Interstellar-530/PolyTouch-FPGA-Synth/docs/hardware/wiring-20261023-v0.1-assets/user-dock-back.jpg

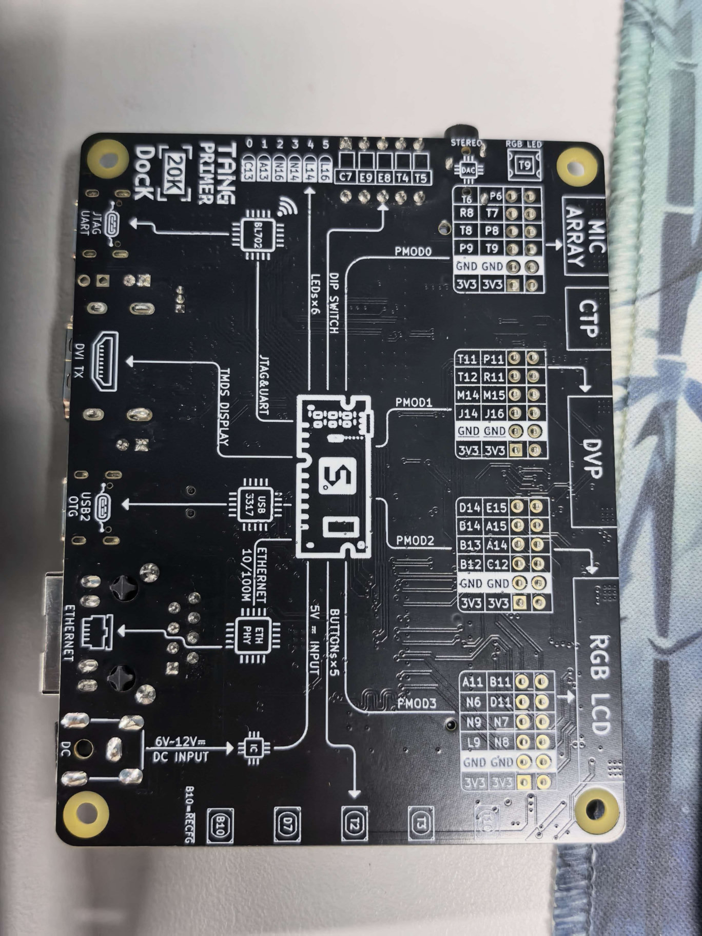
docs/hardware/wiring-20261023-v0.1-assets/user-dock-back.jpg
