Interstellar-530/PolyTouch-FPGA-Synth/docs/references/README.md

# 参考资料

`boards/` 保存原 board_docs 中的板卡规格、原理图和工具指南；`handoff-20261008/` 保留旧交接包附带的原始参考资料；`research/` 保存研究记录。PDF 成品另外放在 `docs/exports/pdf/`。

本轮只归类文件，没有重新解释原理图或核定数值。历史包中的重复原件保留，以免破坏原包可追溯性；各路径及文件校验可在迁移清单中核对。外部资料沿用原版权和许可，不因本仓库归档而改变。
