Interstellar-530/PolyTouch-FPGA-Synth/docs/hardware/FPGA-硬件连接与演奏操作-20261013-v0.1.md

# FPGA 硬件连接与演奏操作（2026-10-13 v0.1）

本方案用于 Tang Primer 20K Dock **3714**，器件 GW2A-LV18PG256C8/I7、版本 C。现在可以用电脑键盘控制四声部和板载 PT8211；外部 GPIO 琴键、MCP3208、PCM5102A 和 12.288 MHz 时钟的输入/输出驱动尚待实现。本文件给出已经核对图纸的连接提案，不能把“按图接好”当作当前固件已支持这些外设。

## 1. 手动模式实际怎样操作

`D0` 进入手动模式并清理演示音符，此时没有输入音符就安静。PuTTY 里要用 `N69` + Enter 按下 A4，用 `O69` + Enter 松开；普通字母原本没有映射。为满足按住电脑键发音、松开释音的操作，本轮增加 `tools/serial_keyboard/open-keyboard.cmd`。先关闭占用 COM13 的 PuTTY，再双击它，窗口会连接 COM13，发送 D0、M1，然后等待琴键。

| 电脑键 | A | W | S | E | D | F | T | G | Y | H | U | J | K |
| --- | --- | --- | --- | --- | --- | --- | --- | --- | --- | --- | --- | --- | --- |
| 音符 | C4 | C♯4 | D4 | D♯4 | E4 | F4 | F♯4 | G4 | G♯4 | A4 | A♯4 | B4 | C5 |
| MIDI 编号 | 60 | 61 | 62 | 63 | 64 | 65 | 66 | 67 | 68 | 69 | 70 | 71 | 72 |

按住 H 发 A4，松开 H 进入 ADSR 释放；同时按 A、D、G 发 C 大三和弦。当前最多四声部，超过四个音会按现有规则窃取声部。窗口按钮控制手动/演示、静音/有声和全松键，空格也可全松键；手动演奏时切走窗口会全松键。全松键后仍按住的键要先松开再重新按下，避免系统自动重复重新起音。电脑端只发送控制事件，声音由 FPGA 生成。此路径尚未测量实际输入延迟，不能代替最终 GPIO 琴键的比赛延迟证据。

用户已确认按下、松开和和弦正常；底层串口测试收到 D0/M1、三音和弦 N/O 和关闭时 X 的全部 OK。新模式目前保存在 SRAM（User Code 0x5633），断电后仍回到 Flash 前版 0xFCF0，需重新加载模式修复固件。

## 2. 本轮采用的最新外设状态

库存以另一采购对话中 2026-10-12 的用户确认“对勾已购，圈未购”为准；主琴键方向以最新对话《检查能否同时用它取代MPR121》中“按照GPIO按键的方案思考”为准。已购不自动等同于已到货、已焊接或已验收。

| 器件或材料 | 当前依据 | 本方案用途 |
| --- | --- | --- |
| P01 MPR121 | 已购 | 触摸版备选，不再为 GPIO 琴键补购 |
| P03 FSR402、P05 MCP3208 | 已购 | 第二维压力控制 |
| P06 PCM5102A、P07 12.288 MHz 有源晶振 | 已购 | 48 kHz 正式 I2S 音频出口 |
| P08 耳放、P09 B10K 电位器 | 已购 | 耳机驱动与第三维连续控制 |
| P10 面包板、P16 音频线、P17 USB 声卡 | 已购 | 原型连线与录音，声卡线路输入规格仍需实物确认 |
| 12 个独立机械按键及固定面板 | 已选 GPIO 路线，未查到购买确认 | 主琴键，每键两个独立触点 |
| P04 电阻、P11 杜邦线、P12 去耦/串阻 | 未查到已备确认 | 先盘点；GPIO 上拉 12 个，FSR 分压 1 个，另预留 CS 上拉和 XSMT 下拉 |
| P02 铜箔/导电布电极 | 前次确认未购 | GPIO 主方案暂不需要，触摸备选才需要 |

还没有具体 DAC 模块、耳放和晶振封装型号。下面按电气端子名称连接，不能按其他店铺照片推断左右排列、VIN 电压或跳线位置。

若全部采用外接电阻且 XSMT 可控，10 kΩ 需至少 15 只：12 只琴键上拉、1 只 FSR 分压、1 只 ADC CS 上拉、1 只 DAC 静音下拉；模块已有的电阻可抵扣。晶振与三根 I2S 线合计预留 4 只约 33 Ω 串阻，两个模拟控制输入各预留 1 kΩ/10 nF。去耦先查模块实物，按缺少的补齐。

## 3. 排针方向和完整信号分配

已用本地 [3714 原理图](../references/Tang_Primer_20K_Dock_3714_Schematics.pdf)的根页、RGB LCD 页、Things 页，以及[核心板引脚/电源图](../references/Tang_Primer_20K_SOM-3961_Schematic.pdf)进行 PNG 视觉复核；官方入口见 [Sipeed 板卡资料](https://wiki.sipeed.com/hardware/zh/tang/tang-primer-20k/primer-20k.html)。J5、J6、J14 均为 2×6 排针：**1/2 为 +3.3 V，3/4 为 GND，5～12 为信号**。这不是可直接套用通用 PMOD 电源脚序的接口。按实物方焊盘或丝印找 1 脚，并在断电时核对地线；不要按 USB 口朝向猜编号。

```text
从确认过的 1 脚开始，每行一对：
1  2    +3.3 V / +3.3 V
3  4    GND    / GND
5  6    信号   / 信号
7  8    信号   / 信号
9 10    信号   / 信号
11 12   信号   / 信号
```

下表与 `FPGA-pinplan-20261013-v0.1.csv` 一致，覆盖 12 键、4 根 ADC SPI、3 根 I2S、1 根 DAC 静音和 1 根外部时钟。全部选择 3.3 V 电压域。Bank 3 固定 3.3 V；Bank 1/7 按核心板默认 R5/R9 配置为 3.3 V。若板卡曾改过电压配置，要先实测恢复到相应电压。

| 用途 / 拟定端口 | 排针脚 | FPGA 脚 | Bank | 方向及对端 |
| --- | --- | --- | --- | --- |
| K0 / key0_n，C4 | J5-5 | L9 | 3 | 输入，按键到 GND |
| K1 / key1_n，C♯4 | J5-6 | N8 | 3 | 输入，按键到 GND |
| K2 / key2_n，D4 | J14-5 | P9 | 3 | 输入，按键到 GND |
| K3 / key3_n，D♯4 | J5-8 | N7 | 3 | 输入，按键到 GND |
| K4 / key4_n，E4 | J6-8 | A14 | 7 | 输入，按键到 GND |
| K5 / key5_n，F4 | J6-9 | B14 | 7 | 输入，按键到 GND |
| K6 / key6_n，F♯4 | J6-10 | A15 | 7 | 输入，按键到 GND |
| K7 / key7_n，G4 | J6-11 | D14 | 1 | 输入，按键到 GND |
| K8 / key8_n，G♯4 | J6-12 | E15 | 1 | 输入，按键到 GND |
| K9 / key9_n，A4 | J14-7 | T8 | 3 | 输入，按键到 GND |
| K10 / key10_n，A♯4 | J14-8 | P8 | 3 | 输入，按键到 GND |
| K11 / key11_n，B4 | J14-9 | R8 | 3 | 输入，按键到 GND |
| adc_cs_n | J5-9 | N6 | 3 | 输出 → MCP3208 CS/SHDN |
| adc_sck | J5-10 | D11 | 7 | 输出 → MCP3208 CLK |
| adc_mosi | J5-11 | A11 | 7 | 输出 → MCP3208 DIN |
| adc_miso | J5-12 | B11 | 7 | 输入 ← MCP3208 DOUT |
| i2s_bck | J6-5 | B12 | 7 | 输出 → PCM5102A BCK/BCLK |
| i2s_lrck | J6-6 | C12 | 7 | 输出 → PCM5102A LRCK/LCK/WS |
| i2s_din | J6-7 | B13 | 7 | 输出 → PCM5102A DIN/DATA |
| dac_xsmt | J14-12 | P6 | 3 | 输出 → PCM5102A XSMT（可引出时） |
| clk_12m288 | J14-10 | T7 | 3 | 输入 ← 3.3 V CMOS 有源晶振 OUT，GCLKT_3 |

上一对话的候选 K2 是 J5-7/N9。核心图把 N9 标为 D0 复用脚，本轮先把 K2 改用 J14-5/P9，避免尚未完成的工具 GPIO 选项确认。J5-7 暂留空。J14-6/T9 与板载 WS2812 数据并联，本方案也不占用。

J5/J6 的信号同时引到 LCD FPC，J14 的信号同时引到麦克风阵列 FPC。因此这些接口使用本方案时，不能再接会驱动同一网络的 LCD 或麦克风阵列。当前 UART M11/T13、板载音频 N15/P16/P15/R16、LED 和 S1/S2/S3 都保留；候选表与现有 CST 无重号。

2026-10-16 更新：标准 I2S 组的候选引脚已经写入工程，成为独立的一档约束：引脚在 `source/constraints/primer20k_i2s.cst`，时钟在 `primer20k_i2s.sdc`（12.288 MHz、81.38 ns），构建脚本为 `build/build_top_i2s_std.tcl`；调试档仍用 `primer20k_dock3714.cst` + `primer20k.sdc` + `build/build_top_integrated.tcl`。两档共用同一份 RTL，各自通过 `build/isolated/` 下的薄封装只引出本档需要的端口，实测两档均为 0 个未约束端口、0 条 setup/hold 违例，报告见 `evidence/2026/10/top-i2s-20261016/`。

按原理图逐脚核对后的完整对应表见 `FPGA-接线与引脚对应表-20261016-v0.1.md`（机器可读版本 `FPGA-接线表-20261016-v0.1.csv`）：J5/J6/J14 二十四根信号脚的网络名、球号、Bank 与用途，以及晶振、PCM5102A、MCP3208、FSR、电位器和 12 路琴键的接法都在那里，本文不再重复。

两点接线提醒。其一，两档点流互斥：标准档把 B12/C12/B13/P6 给了 I2S 与 XSMT，调试档仍用这 4 个脚做折叠观测，插线不能同时接。其二，J5/J6/J14 每个排针只有 8 个信号脚，本方案已用满，只剩 J5-7(N9) 与 J14-11 两个空脚，装不下 4 位折叠观测口，因此标准档不再引出 `clip_fold`，观测改用仿真与 UART 状态。

## 4. 逐件连接

### 4.1 独立 GPIO 琴键

每个 GPIO 用独立约 10 kΩ 电阻上拉到 3.3 V，按键一端接该 GPIO，另一端接公共地；松开为 1，按下为 0。上拉电阻放在开发板/转接板一侧，按键地线回到同一公共地。四脚轻触按键有两对内部相连的脚，要用万用表确认两个不同触点，不能把同一内部触点的两脚当作开关两端。12 根 GPIO 各自独立，可识别多键，不需要矩阵逐键二极管。

```text
3.3 V ── 10 kΩ ──┬── GPIO 输入
                  └── 按键 ── GND
```

后续 RTL 每路先两级同步，再独立消抖；以按下约 1 ms、松开约 3 ms 为可调起点。不能直接复用板载控制键约 38.8 ms 的消抖参数。按键长线靠近晶振时，先分开布线，再按实际干扰加小电容或串阻，避免为了消抖盲目加入很大的 RC 延迟。

### 4.2 FSR、电位器和 MCP3208

MCP3208 的 VDD、VREF 都用 3.3 V，AGND/DGND 共地，模块旁检查 100 nF 和适量 1～10 µF 去耦。裸 16 脚芯片对应 VDD=16、VREF=15、AGND=14、CLK=13、DOUT=12、DIN=11、CS=10、DGND=9、CH0=1、CH1=2；模块按丝印端子连接。CS 加约 10 kΩ 上拉，四根数字线按上一表接，DIN/DOUT 不要反接。[Microchip 数据手册](https://ww1.microchip.com/downloads/en/DeviceDoc/21298e.pdf)

FSR 一端接 3.3 V，另一端为分压节点；节点经 10 kΩ 到 AGND，并接 CH0。按压力增大时 FSR 阻值下降，节点电压上升：`V = 3.3 × 10k / (R_FSR + 10k)`。可在节点到 CH0 间串约 1 kΩ，在 CH0 对 AGND 放约 10 nF 作起点。FSR 无需按正负极接，不追求绝对牛顿值；用无人按压、轻压、重压做相对标定。

B10K 两端接 3.3 V/AGND，中间滑动端接 CH1，也可经 1 kΩ/10 nF 作输入滤波。没有使用的 CH2～CH7 可以接 AGND，不要让扫描到的空通道浮动。只有传感器电压节点进 ADC，不能把 3.3 V 模拟节点当成 FPGA 模拟输入。

SPI 先用 mode 0，SCK 约 250 kHz。10 kΩ 分压的源阻抗会影响 ADC 采样电容建立时间，先降速再考虑 1 MHz。按 24 个 SCK 一次事务估算，每通道约 96 µs；两个通道的数字传输在约 0.2 ms 内，足够安排 1～2 kHz 控制更新。该值是调度预算，需要波形和数值稳定性验收。

### 4.3 晶振、PCM5102A、耳放和录音

有源晶振确认是 **12.288 MHz、3.3 V CMOS 输出**。VCC 接 3.3 V，GND 接公共地，OUT 在源端串约 33 Ω 后短线接 J14-10/T7；电源脚旁保留 100 nF 和约 1 µF。OE/EN 按型号设置，不能把两脚无源晶体按这个方法直接接入。常见四脚封装的脚位也要按所购型号确认。J14-9/R8 虽与 T7 构成时钟引脚对，本方案使用单端 CMOS 时钟，R8 作为普通按键输入，不能启用差分时钟模式。

PCM5102A 数字端：BCK←B12、LRCK←C12、DIN←B13、GND→公共地；BCK/LRCK/DIN 可各在 FPGA/转接板源端串约 22～33 Ω。正式目标为 LRCK 48 kHz、BCK 3.072 MHz、64 位时隙，标准 I2S 在 LRCK 翻转后延迟一个 BCK 才发送 MSB。当前板载 PT8211 是右对齐接口，不能直接把其 DIN 当作标准 I2S 给 PCM5102A。

按本标准档烧录时，板载耳机路径的三根线在 RTL 里恒为低、`pa_en` 也不引出，所以耳机口不会发声；要听板载耳机就烧调试档。实机验收前先看 `evidence/2026/10/top-i2s-20261016/README.md` 里“已知限制与未做”一节：那时钟档目前只有仿真与综合证据，还没有上板。

| PCM5102A 配置端 | 本方案设置 |
| --- | --- |
| FMT | 低电平，标准 I2S |
| DEMP | 低电平，48 kHz 不启用 44.1 kHz 去加重 |
| FLT | 高电平低延迟；普通滤波也可作为对照 |
| SCK | 三线 I2S/内部 PLL 方案按数据手册接地，不另接 SPI 时钟 |
| XSMT | 低静音、高有声；能解除固定绑带时才由 P6 控制 |

如果模块 XSMT 已硬连 3.3 V，必须先按模块说明解除绑带才能接 FPGA，避免输出低电平时短接电源。若暂时无法引出，P6 保留不用，先由 I2S 零样本静音。可控 XSMT 使用约 10 kΩ 下拉，让未配置时保持静音；不能同时保留同阻值上拉造成分压。芯片模拟供电是 3.3 V，模块 VIN 是否可用 5 V 取决于板载稳压；当前没有确切模块型号，不把所有标 VIN 的端子统一接 5 V。[TI 数据手册](https://www.ti.com/lit/ds/symlink/pcm5102a.pdf)

PCM5102A OUTL/OUTR 是线路输出，接耳放 INL/INR，模拟地接耳放输入地，耳机插耳放输出。耳放供电按具体型号，不能因为 Dock 有 12 V 电源插座就把未知耳放接 12 V。若模块实际是 BTL 扬声器功放，也不能把负输出当耳机公共地。录音从 DAC 线路输出接已购声卡的真正 Line In；耳放输出和麦克风输入的电平未确认前不直接相连。电平过高先降低数字增益，必要时再用经过计算的衰减网络。

### 4.4 MPR121 作为备选

若以后做触摸版，可将 GPIO 输入适配器替换为 MPR121 适配器：VCC→3.3 V、GND→公共地，SCL→J5-5/L9、SDA→J5-6/N8、IRQ→J5-8/N7。这三个针位与 GPIO 的 K0/K1/K3 **互斥**，不能同时按两套接法装配。确认模块上拉接到 3.3 V；已经有上拉时不重复叠加。常用 7 位地址 0x5A，但实际以 ADDR 接法为准；电极 ELE0～ELE11 各接独立铜箔，铜箔不接 VCC 或 GND。[MPR121 模块接线说明](https://learn.adafruit.com/adafruit-mpr121-12-key-capacitive-touch-sensor-breakout-tutorial/wiring)

## 5. 接线、软件接入与验收顺序

先断电按 1 脚核对排针，再只接单个 GPIO 按键，确认松开约 3.3 V、按下接近 0 V；完成 GPIO 驱动后再扩成 12 键。第二步接 ADC、FSR 和电位器，用 UART/GAO 检查原始值和滤波值。第三步接晶振，只测频率、电平和连通；正式时钟构建验证后才接 DAC 数字线。第四步核对 DAC 供电和跳线，先输出零样本、后释放静音，再接耳放，最后接录音接口。

地线统一连接，按键/ADC、DAC、耳放分别回到供电公共节点，耳放大电流回路不要沿 ADC 参考或晶振地线绕行。I2S/晶振线短且伴随地线，远离耳放输入和 FSR 节点；面包板电源长条可能中间断开，要测通。当前静音后噪声仍基本不变，后续需对比供电、接地和独立 DAC/耳放链路，不能承诺换算法就消掉模拟底噪。

后续 GPIO 输入适配器应把同时变化的位图保留为待处理掩码，先逐个提交 Note Off 再提交 Note On，并接受下游 ready。不能把连续 GPIO 突发直接接到当前为稀疏 UART 命令设计的脉冲入口：模式切换保留的首事件可能与下一拍事件相撞。需给手动来源增加队列或明确握手，同时定义进入手动时的物理按键状态重建、Panic 后必须松开再按和断线默认参数。

12.288 MHz 正式构建要一起修改 UART 分频、DDS 频率字、曲目时值和 ADSR 步进；建议主音频/控制逻辑用单一音频时钟域。标准 I2S、GPIO 消抖和 ADC 各补自检台；每帧截止时间、队列背压、满声部混音和饱和都要检查。最后以真实按键电信号与 DAC 模拟输出测量端到端延迟，并录制四个独立基频。没有驱动、接线和实测前，不标记外设功能已完成。

本轮交付为可用的电脑演奏窗口与图纸级连接方案。源代码/脚本、图纸和器件引脚视觉证据、串口与用户验收记录归档到 `archive/FPGA-20261013-v0.2/`，正式 FPGA 引脚约束仍待后续接入任务更新。
