Interstellar-530/PolyTouch-FPGA-Synth/docs/hardware/FPGA-硬件采买与搭建准备-20261022-v0.2.md

# PolyTouch FPGA 硬件采买与搭建准备

日期：2026-10-22，版本 v0.2。适用 Tang Primer 20K Dock 3714，GW2A-LV18PG256C8/I7，版本 C。

本版核准 881a11c 的采购记录和路线说明，与[搭建指导 v0.2](FPGA-硬件搭建指导-20261022-v0.2.md)配套。保留原采购信息，主输入统一为 CH9350L USB 键盘；12 机械键和 MPR121 为历史替代。远端订单记录来自另一工作副本 `D:\NanjingUniversity\FPGA\PolyTouch-FPGA-Synth`，本机没有独立复核原始订单、到货和铭牌，不将采购成功写成硬件验收。

## 1. 装配主路线

普通 USB 键盘接 CH9350L 下位机，由 3.3V TTL UART 向 FPGA 发送报告；FSR402 与 10kΩ 线性电位器接 MCP3208 CH0/CH1；FPGA 经标准 I2S 到 PCM5102A，再接有源音箱。先采用 `standard27`：板载 27MHz、8 声部、46.875kHz、BCK 3.000MHz，外部 T7 不接。DAC 实际锁定仍待测量。

两枚新购 12.288MHz 有源晶振保留用于已规划的 48kHz/PLL 后续方向。现有 `standard` 档是 GPIO 输入，不能直接作为 USB 键盘的 48kHz 替代档；32 声部原型也未完成整机板级集成。灯屏为增强，不阻塞基本输入、压力与正式音频链路。

## 2. 已有与待确认物料

| 物料 | 已有记录 | 本次用途/待办 |
|---|---|---|
| Tang Primer 20K＋Dock 3714 | 已有；板载串口和耳机曾用于试听 | 保存已知版本及恢复方式；当前整机外设未验收 |
| 普通有线 USB 键盘 | 优先复用 | 支持 Boot 键盘报告，实测和弦组合；报告只有 6 个普通键槽位 |
| CH9350L 下位机成品板 | 10/20 用户确认已到货 | 确认 Host 口、SEL/S0/S1 配置、TXD 3.3V 与 Host VBUS 5V；单向模式 RXD 接地、N8 留空 |
| FSR402 | 10/20 用户确认已到货 | 压力分压、刚性背板、软垫、尾线应力释放 |
| MCP3208-CI/SL | 已购，10/20 仍待焊接 | SOIC-16 转接板、代焊/焊台及逐脚通断检查 |
| WX112(050) 10kΩ 线性电位器/B10K | 历史已购记录 | 实物盘点是否同一件；滑臂接 CH1，缺件时用等阻分压给中位 |
| CJMCU-5102/PCM5102A | 10/20 用户确认已到货 | 查 LDO、输入输出网络、控制孔和焊桥后决定电源 |
| 有源音箱、P15W 或耳放 | 旧记录型号和输入未定；10/20 用户称有源音箱可用 | 以实际 AUX/LINE IN 与额定电源为准；新 R18T 为候选 |
| 12 个机械键、MPR121 | 旧采购记录 | 收存作替代，不按主路线安装；避免与 USB/灯屏共用脚冲突 |
| 830 孔面包板、音频线、USB 声卡 | 历史记录，数量与接口待盘点 | 电源轨通断、立体声线、实际 Line In 条件分别核对 |

MPR121 是项目原始最低实现的输入方案，当前 USB 替代依据用户明确选择。是否满足比赛具体条文仍需按正式规则核对，不因本采购文档更新而宣称合规验收完成。

## 3. 10/22 远端新增订单记录

以下为原采购文档转录口径，保留金额、数量推断和不确定性。没有重查价格、到货或卖家承诺。

| 物品 | 订单记录 | 用途和到货核对 |
|---|---|---|
| 12.288MHz 有源晶振 | 2 枚，实付 ¥9.60；用户补充额定 3.3V | 后续 48kHz 方向；仍须查完整型号、CMOS 输出、OE、封装和四脚转接方式 |
| 12V/3A 电源适配器 | 1 个，实付 ¥39.98，订单称 3C | Dock/降压输入候选；测极性、电压及带载能力 |
| DC 一分二 | 5.5×2.5mm，一母二公、30cm、0.75mm²，1 根，¥8.80 | 与 J13 实物匹配；图纸型号本身不足以断定 J13 是 5.5×2.1mm |
| DC-DC 降压模块 | 商品含“5A”；用户称 12V→5V、约 3A；实付 ¥23.14，按单价 ¥11.57 推断 2 件 | 数量与持续电流均待实物确认；不能保证 3A 连续输出；先测 5V 再接外设 |
| 漫步者 R18T | 黑色 2.0 音箱，1 套，¥99.00 | 核对准确型号、AUX 输入、原配电源、额定电流和配套线材 |
| 40P 杜邦线 | 2.54mm、10cm，公母/公公/母母各一组；订单实付 ¥33.00 | 商品小计与实付存在差额，按原记录保留，不推断根数或付款原因；盘点实际线材 |
| 16 脚贴片转接板 | SOP16/SSOP16/TSSOP16 类，1 件，¥6.00 | 核对是否适配 MCP3208 SOIC-16 窄体及 1 脚；不是四脚晶振转接板 |

按所记录实付金额合计 ¥219.52，仅对应上述订单，不是全项目历史采购额。原订单文字和规格有歧义时以实物与原始订单核对，不能按金额推断结果直接安排接线。

## 4. 主链路缺口与视觉增强

主链路需要盘点 10kΩ 分压/中位/片选等电阻、100nF 与约 1µF 去耦、可选 33Ω 串阻、接线端子、热缩管、绝缘底板、固定柱和标签。USB 主路线无需为 12 个机械键另备 12 只上拉；机械键备选时才补齐。

最低测量工具是万用表；借用逻辑分析仪检查 UART/SPI/I2S，示波器检查晶振和电源纹波。万用表读数不能证明晶振起振；低采样率逻辑分析仪也不能证明时钟模拟幅度和边沿合格。保留现有软件运行环境，不作为一次性工具清除。

| 增强元件 | 推荐规格 | 记录状态 |
|---|---|---|
| RGB 灯 | 16 颗 WS2812B，5V、RGB、800kHz，已焊线 | 10/20 方案，未确认本轮已购或驱动完成 |
| 电平转换 | SN74AHCT125 成品板或匹配封装 | 3.3V→5V 单向灯带信号；不要换成 74HC125 |
| 彩屏 | ST7735S，1.8 英寸，128×160，四线 SPI，明确 3.3V 逻辑 | 沿用微雪 SKU 13892 接口参考，实际型号和驱动初始化需核对 |
| 配套 | 330Ω、100nF、约 1000µF/≥6.3V、线束与固定件 | 灯带独立回电源，不走小信号排针大电流 |

视觉约 100 元为之前接受的规划额度，不是本轮报价或实购物料证明；早前另一记录中总新增预算约 500 元与此不同口径。未到货或软件未完成时先保留声音和压力主链路，不扩大采购。

## 5. 电源与接入准备

先沿用已工作的 Dock 供电，外设电源单独确认。12V 适配器可作为 J13 和降压模块的输入候选；J13 图纸中心正极、型号 DC-036A-2.5A-2.0，接口尺寸待核。降压输出先确认 5V，带载测量后再接 CH9350L 指定输入、灯带或 DAC 指定 VIN。R18T 优先使用原配供电，不能猜测为 5V 设备。

Dock 3V3 供 ADC、FSR、电位器等小信号；DAC、屏和晶振是否可加入，要核对模块电源与剩余负载。若改用独立 3.3V 稳压支路，只共地，不并联稳压输出。各支路均保留极性标识，12V、5V 不进入 3V3 排针或 FPGA IO。

12V/3A 标称总功率 36W；不能将两个降压模块的标称电流相加当成实际可用功率。按 5V×3A、效率 85% 的假设预算，输入电流约 1.47A，还需计入 Dock 和其他负载；实际效率与电流必须测量。大电流回路与模拟参考地分开布线后在电源处汇接。

收货后依次核对数量、丝印、接口、极性与转接板焊接，记录空载/带载电压；然后逐个接 DAC、键盘、ADC 和传感器。单模块通过后再合成整机，保持同一张 profile/接线表。通电前的具体信号表和操作以搭建指导 v0.2 为准。

## 6. 软件与硬件准备状态

CH9350L 长按策略修复在另一分支 `codex/optimization07-watchdog-20261022`，本次只修正文档，没有合入功能。32 声部有原型时序报告，缺完整板级顶层。灯屏有配件与拟用引脚规划，缺生产驱动/引脚实现。三者不能仅凭更新采购文件就升级为已完成。

装配前应将长按修复定向合流并做对应回归；真正烧录前执行完整 RTL 仿真门禁、确认构建收据和位流 SHA256。实体验收保留按键按下/松开/长按/拔出帧、ADC 原始码、I2S 解码、模拟录音和实际冷启动记录。不安排无关的长时间重复老化。

待确认集中在：MCP3208 焊接、DAC 电源及焊桥、Host VBUS 与模块 TXD、电源接口尺寸、降压持续电流、R18T 铭牌、晶振输出及转接板、视觉元件库存和线束固定。没有这些实物记录，当前状态仍是“具备装配方案”，不是“整机已验收”。
