Interstellar-530/PolyTouch-FPGA-Synth/docs/hardware/FPGA-逐根接线核对单-20261018-v0.1.md

# 逐根接线核对单（2026-10-18，v0.1）

**今天使用 debug 和板载 27MHz/PT8211：只执行标为今天的行。**

后续 standard 行本次不接。方框供现场填写，不表示已经接线或测量通过。

**晶振暂无转接 PCB；DAC 已有正面照片，电源路径及焊桥仍待核对；P15W 暂不用。**

| 已接 | 复核 | 编号 | 线的一端 | 线的另一端 | 备注 |
|---|---|---|---|---|---|
| [ ] | [ ] | W001 | J5-5 / L9 | K0 信号节点 S | 今天 debug；input，Bank3，3.3V |
| [ ] | [ ] | W002 | J5-6 / N8 | K1 信号节点 S | 今天 debug；input，Bank3，3.3V |
| [ ] | [ ] | W003 | J14-5 / P9 | K2 信号节点 S | 今天 debug；input，Bank3，3.3V |
| [ ] | [ ] | W004 | J5-8 / N7 | K3 信号节点 S | 今天 debug；input，Bank3，3.3V |
| [ ] | [ ] | W005 | J6-8 / A14 | K4 信号节点 S | 今天 debug；input，Bank7，3.3V |
| [ ] | [ ] | W006 | J6-9 / B14 | K5 信号节点 S | 今天 debug；input，Bank7，3.3V |
| [ ] | [ ] | W007 | J6-10 / A15 | K6 信号节点 S | 今天 debug；input，Bank7，3.3V |
| [ ] | [ ] | W008 | J6-11 / D14 | K7 信号节点 S | 今天 debug；input，Bank1，3.3V |
| [ ] | [ ] | W009 | J6-12 / E15 | K8 信号节点 S | 今天 debug；input，Bank1，3.3V |
| [ ] | [ ] | W010 | J14-7 / T8 | K9 信号节点 S | 今天 debug；input，Bank3，3.3V |
| [ ] | [ ] | W011 | J14-8 / P8 | K10 信号节点 S | 今天 debug；input，Bank3，3.3V |
| [ ] | [ ] | W012 | J14-9 / R8 | K11 信号节点 S | 今天 debug；input，Bank3，3.3V |
| [ ] | [ ] | W013 | J5-9 / N6 | MCP3208 10/CS | 今天 debug；output，Bank3，3.3V |
| [ ] | [ ] | W014 | J5-10 / D11 | MCP3208 13/CLK | 今天 debug；output，Bank7，3.3V |
| [ ] | [ ] | W015 | J5-11 / A11 | MCP3208 11/DIN | 今天 debug；output，Bank7，3.3V |
| [ ] | [ ] | W016 | J5-12 / B11 | MCP3208 12/DOUT | 今天 debug；input，Bank7，3.3V |
| [ ] | [ ] | W017 | J6-5 / B12 | DAC BCK | 后续 standard，本次不接；output，Bank7，3.3V |
| [ ] | [ ] | W018 | J6-6 / C12 | DAC LCK/LRCK | 后续 standard，本次不接；output，Bank7，3.3V |
| [ ] | [ ] | W019 | J6-7 / B13 | DAC DIN | 后续 standard，本次不接；output，Bank7，3.3V |
| [ ] | [ ] | W020 | J14-12 / P6 | DAC XSMT（先查焊桥） | 后续 standard，本次不接；output，Bank3，3.3V |
| [ ] | [ ] | W021 | J14-10 / T7 | 33Ω 电阻靠板端（另一端接晶振 OUT） | 后续 standard，本次不接；input，Bank3，3.3V |
| [ ] | [ ] | W022 | J5-1 | 面包板 3V3 轨 | 今天 debug；红线 |
| [ ] | [ ] | W023 | J5-3 | 面包板 GND 轨 | 今天 debug；黑线 |
| [ ] | [ ] | W024 | 3V3 轨 | MCP3208 16/VDD | 今天 debug； |
| [ ] | [ ] | W025 | 3V3 轨 | MCP3208 15/VREF | 今天 debug； |
| [ ] | [ ] | W026 | GND 轨 | MCP3208 14/AGND | 今天 debug； |
| [ ] | [ ] | W027 | MCP3208 14/AGND | MCP3208 9/DGND | 今天 debug；就近短接 |
| [ ] | [ ] | W028 | J14-1 | 晶振 VCC | 后续 standard，本次不接；型号和 3.3V 电压确认后接 |
| [ ] | [ ] | W029 | J14-3 | 晶振 GND | 后续 standard，本次不接；确认实物脚序后接 |
| [ ] | [ ] | W030 | 晶振 OUT | 33Ω 电阻源端 | 后续 standard，本次不接；确认输出电平，电阻靠近晶振 |
| [ ] | [ ] | W031 | 晶振 OE/EN | 按完整型号资料使能 | 后续 standard，本次不接；NC 不乱接；尚待确认 |
| [ ] | [ ] | W032 | J6-3 | DAC GND | 后续 standard，本次不接； |
| [ ] | [ ] | W033 | 已核实的模块电源 | DAC 已核实电源输入 | 后续 standard，本次不接；VIN/3V3 不预设、不同时接 |
| [ ] | [ ] | W034 | MCP3208 3/CH2 | ADC AGND | 今天 debug；本次未用通道 |
| [ ] | [ ] | W035 | MCP3208 4/CH3 | ADC AGND | 今天 debug；本次未用通道 |
| [ ] | [ ] | W036 | MCP3208 5/CH4 | ADC AGND | 今天 debug；本次未用通道 |
| [ ] | [ ] | W037 | MCP3208 6/CH5 | ADC AGND | 今天 debug；本次未用通道 |
| [ ] | [ ] | W038 | MCP3208 7/CH6 | ADC AGND | 今天 debug；本次未用通道 |
| [ ] | [ ] | W039 | MCP3208 8/CH7 | ADC AGND | 今天 debug；本次未用通道 |
| [ ] | [ ] | W040 | C1 100nF 一端 | ADC 16/VDD | 今天 debug；电容并在电源与地间 |
| [ ] | [ ] | W041 | C1 100nF 另一端 | ADC 14/AGND | 今天 debug；有极性时该端为负 |
| [ ] | [ ] | W042 | C2 100nF 一端 | ADC 15/VREF | 今天 debug；电容并在电源与地间 |
| [ ] | [ ] | W043 | C2 100nF 另一端 | ADC 14/AGND | 今天 debug；有极性时该端为负 |
| [ ] | [ ] | W044 | C3 约1µF 一端 | ADC 16/VDD | 今天 debug；电容并在电源与地间 |
| [ ] | [ ] | W045 | C3 约1µF 另一端 | ADC 14/AGND | 今天 debug；有极性时该端为负 |
| [ ] | [ ] | W046 | C4 100nF 一端 | 晶振 VCC | 后续 standard，本次不接；电容并在电源与地间 |
| [ ] | [ ] | W047 | C4 100nF 另一端 | 晶振 GND | 后续 standard，本次不接；有极性时该端为负 |
| [ ] | [ ] | W048 | C5 约1µF 一端 | 晶振 VCC | 后续 standard，本次不接；电容并在电源与地间 |
| [ ] | [ ] | W049 | C5 约1µF 另一端 | 晶振 GND | 后续 standard，本次不接；有极性时该端为负 |
| [ ] | [ ] | W050 | 3V3 | FSR-A | 今天 debug； |
| [ ] | [ ] | W051 | FSR-B | 节点 F | 今天 debug； |
| [ ] | [ ] | W052 | 节点 F | ADC 1/CH0 | 今天 debug； |
| [ ] | [ ] | W053 | 节点 F | FSR 10kΩ 一端 | 今天 debug； |
| [ ] | [ ] | W054 | FSR 10kΩ 另一端 | ADC AGND | 今天 debug； |
| [ ] | [ ] | W055 | 电位器固定端 A | 3V3 | 今天 debug；先用万用表识别固定端 |
| [ ] | [ ] | W056 | 电位器固定端 B | ADC AGND | 今天 debug； |
| [ ] | [ ] | W057 | 电位器滑动端 W | ADC 2/CH1 | 今天 debug；先调到 VREF/2 |
| [ ] | [ ] | W058 | K0 开关信号侧 | K0 节点 S | 今天 debug；与本键底板信号相通 |
| [ ] | [ ] | W059 | K0 开关地侧 | GND | 今天 debug；选按下才导通的两组触点 |
| [ ] | [ ] | W060 | K0 节点 S | K0 10kΩ 上拉一端 | 今天 debug；每键独立 |
| [ ] | [ ] | W061 | K0 10kΩ 上拉另一端 | 3V3 | 今天 debug；不能省略 |
| [ ] | [ ] | W062 | K1 开关信号侧 | K1 节点 S | 今天 debug；与本键底板信号相通 |
| [ ] | [ ] | W063 | K1 开关地侧 | GND | 今天 debug；选按下才导通的两组触点 |
| [ ] | [ ] | W064 | K1 节点 S | K1 10kΩ 上拉一端 | 今天 debug；每键独立 |
| [ ] | [ ] | W065 | K1 10kΩ 上拉另一端 | 3V3 | 今天 debug；不能省略 |
| [ ] | [ ] | W066 | K2 开关信号侧 | K2 节点 S | 今天 debug；与本键底板信号相通 |
| [ ] | [ ] | W067 | K2 开关地侧 | GND | 今天 debug；选按下才导通的两组触点 |
| [ ] | [ ] | W068 | K2 节点 S | K2 10kΩ 上拉一端 | 今天 debug；每键独立 |
| [ ] | [ ] | W069 | K2 10kΩ 上拉另一端 | 3V3 | 今天 debug；不能省略 |
| [ ] | [ ] | W070 | K3 开关信号侧 | K3 节点 S | 今天 debug；与本键底板信号相通 |
| [ ] | [ ] | W071 | K3 开关地侧 | GND | 今天 debug；选按下才导通的两组触点 |
| [ ] | [ ] | W072 | K3 节点 S | K3 10kΩ 上拉一端 | 今天 debug；每键独立 |
| [ ] | [ ] | W073 | K3 10kΩ 上拉另一端 | 3V3 | 今天 debug；不能省略 |
| [ ] | [ ] | W074 | K4 开关信号侧 | K4 节点 S | 今天 debug；与本键底板信号相通 |
| [ ] | [ ] | W075 | K4 开关地侧 | GND | 今天 debug；选按下才导通的两组触点 |
| [ ] | [ ] | W076 | K4 节点 S | K4 10kΩ 上拉一端 | 今天 debug；每键独立 |
| [ ] | [ ] | W077 | K4 10kΩ 上拉另一端 | 3V3 | 今天 debug；不能省略 |
| [ ] | [ ] | W078 | K5 开关信号侧 | K5 节点 S | 今天 debug；与本键底板信号相通 |
| [ ] | [ ] | W079 | K5 开关地侧 | GND | 今天 debug；选按下才导通的两组触点 |
| [ ] | [ ] | W080 | K5 节点 S | K5 10kΩ 上拉一端 | 今天 debug；每键独立 |
| [ ] | [ ] | W081 | K5 10kΩ 上拉另一端 | 3V3 | 今天 debug；不能省略 |
| [ ] | [ ] | W082 | K6 开关信号侧 | K6 节点 S | 今天 debug；与本键底板信号相通 |
| [ ] | [ ] | W083 | K6 开关地侧 | GND | 今天 debug；选按下才导通的两组触点 |
| [ ] | [ ] | W084 | K6 节点 S | K6 10kΩ 上拉一端 | 今天 debug；每键独立 |
| [ ] | [ ] | W085 | K6 10kΩ 上拉另一端 | 3V3 | 今天 debug；不能省略 |
| [ ] | [ ] | W086 | K7 开关信号侧 | K7 节点 S | 今天 debug；与本键底板信号相通 |
| [ ] | [ ] | W087 | K7 开关地侧 | GND | 今天 debug；选按下才导通的两组触点 |
| [ ] | [ ] | W088 | K7 节点 S | K7 10kΩ 上拉一端 | 今天 debug；每键独立 |
| [ ] | [ ] | W089 | K7 10kΩ 上拉另一端 | 3V3 | 今天 debug；不能省略 |
| [ ] | [ ] | W090 | K8 开关信号侧 | K8 节点 S | 今天 debug；与本键底板信号相通 |
| [ ] | [ ] | W091 | K8 开关地侧 | GND | 今天 debug；选按下才导通的两组触点 |
| [ ] | [ ] | W092 | K8 节点 S | K8 10kΩ 上拉一端 | 今天 debug；每键独立 |
| [ ] | [ ] | W093 | K8 10kΩ 上拉另一端 | 3V3 | 今天 debug；不能省略 |
| [ ] | [ ] | W094 | K9 开关信号侧 | K9 节点 S | 今天 debug；与本键底板信号相通 |
| [ ] | [ ] | W095 | K9 开关地侧 | GND | 今天 debug；选按下才导通的两组触点 |
| [ ] | [ ] | W096 | K9 节点 S | K9 10kΩ 上拉一端 | 今天 debug；每键独立 |
| [ ] | [ ] | W097 | K9 10kΩ 上拉另一端 | 3V3 | 今天 debug；不能省略 |
| [ ] | [ ] | W098 | K10 开关信号侧 | K10 节点 S | 今天 debug；与本键底板信号相通 |
| [ ] | [ ] | W099 | K10 开关地侧 | GND | 今天 debug；选按下才导通的两组触点 |
| [ ] | [ ] | W100 | K10 节点 S | K10 10kΩ 上拉一端 | 今天 debug；每键独立 |
| [ ] | [ ] | W101 | K10 10kΩ 上拉另一端 | 3V3 | 今天 debug；不能省略 |
| [ ] | [ ] | W102 | K11 开关信号侧 | K11 节点 S | 今天 debug；与本键底板信号相通 |
| [ ] | [ ] | W103 | K11 开关地侧 | GND | 今天 debug；选按下才导通的两组触点 |
| [ ] | [ ] | W104 | K11 节点 S | K11 10kΩ 上拉一端 | 今天 debug；每键独立 |
| [ ] | [ ] | W105 | K11 10kΩ 上拉另一端 | 3V3 | 今天 debug；不能省略 |
| [ ] | [ ] | W106 | DAC SCK/MCLK | DAC GND | 后续 standard，本次不接；先核对模块是否已有正确焊桥；不重复改焊 |
| [ ] | [ ] | W107 | DAC FMT | DAC GND | 后续 standard，本次不接；先核对模块是否已有正确焊桥；不重复改焊 |
| [ ] | [ ] | W108 | DAC DEMP | DAC GND | 后续 standard，本次不接；先核对模块是否已有正确焊桥；不重复改焊 |
| [ ] | [ ] | W109 | DAC FLT | DAC GND | 后续 standard，本次不接；先核对模块是否已有正确焊桥；不重复改焊 |
| [ ] | [ ] | W110 | DAC OUTL | 有源音箱 LINE IN L | 后续 standard，本次不接；或接已确认有线输入功放；P15W 输入待确认 |
| [ ] | [ ] | W111 | DAC OUTR | 有源音箱 LINE IN R | 后续 standard，本次不接；或接已确认有线输入功放；P15W 输入待确认 |
| [ ] | [ ] | W112 | DAC GND | 有源音箱 LINE IN GND | 后续 standard，本次不接；或接已确认有线输入功放；P15W 输入待确认 |

J5-7、J14-6、J14-11 留空；RGB LCD、麦克风 FPC 留空。

功放高压电源和喇叭线不列为本轮已批准上电线束：须先确认有线输入、适配器及负载。

debug 回退时，断电拔下 J6-5/6/7 与 J14-12 的外部 DAC 线，板载耳机口出声；
该档使用板载 27MHz，FSR 不控制音量。正式路线仍选 standard。
