Interstellar-530/PolyTouch-FPGA-Synth/docs/hardware/FPGA-27MHz与器件核查-20261019-v0.1.md

# 27 MHz 单时钟方案与器件核查

日期：2026-10-19，版本 v0.1（对应方案 v0.3 的时钟选择修订：**不使用外部 12.288 MHz，直接用核心板 27 MHz**）。

## 1. 结论

| 项目 | 结论 |
|---|---|
| 27 MHz 来源 | 核心板有源晶振 U10，经 R20 22 Ω 到 **H11（GCLKT_0，Bank 0，3.3 V）**；不是 FPGA 内部 RC 振荡器 |
| 能否得到精确 48 kHz | **不能**。49.152/27 = 2048/1125，rPLL 的 IDIV/FBDIV 只能取 1..64 的整数，1125 不可实现 |
| 采用的音频格式 | **标准 I2S，BCK = 27e6/9 = 3.000 MHz，LRCK = 3.000e6/64 = 46.875 kHz，64 BCK/帧，24 位槽** |
| 为什么不用 48 MHz PLL | 27×16/9 = 48 MHz 可做到，但 48 MHz / 3.072 MHz = 15.625 拍/BCK，BCK 必须抖动；拒绝 |
| 音高是否受影响 | 不受影响。DDS 相位增量、UART 分频、ADC 节拍、曲目时值全部由 `AUDIO_CLK_HZ/AUDIO_FS_HZ` 推导 |
| PCM5102A 是否支持 | 支持。三线模式（SCK 接地）由 BCK 内部 PLL 生成时钟；BCK/LRCK = 64、Fs 46.875 kHz 在 8 k–192 k 范围内 |
| 综合/布局结果 | **Fmax 57.353 MHz**（约束 27 MHz，2.12× 余量），Setup/Hold 违规 **0**，Logic 6668/20736 (33%)，Register 2471 (16%)，BSRAM 37/46 (81%)，MULT18X18 1，**无 PLL** |
| 结论 | 27 MHz 单时钟可以承担完整生产链路；不需要购买 12.288 MHz 成品晶振，T7 留空 |

## 2. 时钟推导

```text
H11 27.000 MHz
  └─ /9  → BCK  3.000 MHz（高 4 拍、低 5 拍）
       └─ /64 → LRCK 46.875 kHz（每帧 576 个 27 MHz 拍）
```

- 27e6 / 9 / 64 = 46875，三步都是整数，无累加器抖动。
- 44.1 kHz 同样不可整除（27e6/44100 = 612.24），不在本轮选择内。
- 24 位数据 + 32 位槽：位置 0 为 0，位置 1..24 为数据，位置 25..31 补零，与现有 `i2s_tx` 一致。
- UART 115200：27e6/115200 = 234.375，取 234 拍/位，实际 115 384 baud，误差 0.16%；CH9350L 的 115200 8N1 可共用该分频。
- 2 kHz 控制节拍：27e6/2000 = 13 500 拍；ADC 组间隔 27 拍（1 µs）。

## 3. 代码落点

| 文件 | 改动 |
|---|---|
| `rtl/top.v` | 新增 `AUDIO_IF=2`：27 MHz + 标准 I2S + 46.875 kHz + 24 位；`AUDIO_CLK_HZ/AUDIO_FS_HZ/SONG_UNIT_SAMPLES/PRESSURE_ENABLE` 改为只在 `AUDIO_IF==1` 时选 48 kHz 档 |
| `build/isolated/top_std27_build.v` | 新构建入口，只引出 27 MHz 档端口 |
| `constraints/primer20k_i2s_27m.cst` | 新引脚约束，`clk_27m` = H11，无 T7 |
| `constraints/primer20k_i2s_27m.sdc` | `create_clock clk_27m -period 37.037` |
| `build/profiles.tsv`、`build/build.ps1` | 新增 `standard27` 档 |
| `sim/tb_top_i2s_27m.v` | 新定向验收：节拍 576、BCK 9 拍（高 4 低 5）、LRCK 576、24 位对齐、A4 相位增量、M0/M1、无 X |
| `rtl/audio/gowin_prom_*.v`、`tools/gen_*.py` | 修 pROM `DO` 32 位/16 位连接告警（门禁在 PowerShell 5.1 下会把该告警当致命错误） |

`AUDIO_IF=0`（板载 PT8211）与 `AUDIO_IF=1`（12.288 MHz/48 kHz）保持原行为；27 MHz 档是新增路径。

构建与烧录：

```powershell
.\source\build\build.ps1 -Profile standard27
.\source\build\program_sram.ps1 -Profile standard27   # 默认先跑完整仿真门禁
```

`program_sram.ps1` 的 `ValidateSet` 已加入 `standard27`；烧录前仍会先跑 `run_simulation.ps1`，任一测试失败即拒绝烧录。

## 4. 定向验证证据（2026-10-19）

| 测试 | 结果 |
|---|---|
| `tb_top_i2s_27m`（AUDIO_IF=2） | PASS：8271 帧解码，8272 个采样节拍；A4 过零周期 105.75 采样；A4 `inc=40315424`，理想 440·2³²/46875 = 40315427，差 3 LSB（0.07 ppm）；M0/M1、PT8211 三线恒低、XSMT 恒高均通过 |
| `tb_top_i2s`（AUDIO_IF=1，48 kHz） | PASS：与改动前同一组期望值（A4 108.54 采样，四音 `inc` 差 6/13/35/35 LSB），证明 12.288 MHz 档未回归 |
| `tb_tick_rate`（AUDIO_IF=0，PT8211） | PASS：186 个周期全部 576 拍 = 46.875 kHz，证明调试档未回归 |
| Gowin `standard27` 全流程 | 成功生成 `instrument.fs`；Fmax 57.353 MHz，Setup/Hold 违规 0 |

同源对照（同一 RTL，仅换时钟档）：

| 档 | Logic | Register | BSRAM | MULT | Fmax / 约束 |
|---|---:|---:|---:|---:|---|
| `standard`（12.288 MHz / 48 kHz） | 6771 | 2459 | 37 | 1 | 44.682 / 12.288 MHz |
| `standard27`（27 MHz / 46.875 kHz） | 6668 | 2471 | 37 | 1 | 57.353 / 27 MHz |

27 MHz 档比 12.288 MHz 档少 103 个 Logic、多 12 个 Register，BSRAM 与乘法器相同；没有因为改用板载晶振而增加存储或 DSP。Fmax 绝对余量从 3.64× 降到 2.12×，但仍远高于 27 MHz 且无违规。

按用户要求，本轮未跑完整 `run_simulation.ps1`（耗时门禁），只跑与改动直接相关的三个测试台。烧录前仍须补跑完整门禁。

## 5. 器件可用性核查

| 器件 | 可用性 | 依据与条件 |
|---|---|---|
| Tang Primer 20K + Dock 3714（GW2A-LV18PG256C8/I7 C） | 可用 | 本轮综合/布局已跑通；27 MHz 在 H11 |
| CH9350L USB Host 成品板 | **可用，且可单模块独立工作** | 只买“下位机/发送端”（SEL=1）即可；把 S1/S0 拨到 **state 2**，串口输出固定帧 `57 AB 01` + 8 字节 Boot 键盘报告（mod、00、k0..k5），无握手、无校验，每次按键重复 3–4 帧，FPGA 按“与上一帧比较”去重。3.3 V TTL、115200 8N1。state 2 还会发 `57 AB 02`（鼠标，5 字节），解析器按命令字跳过长度的表处理即可 |
| MCP3208 成品 ADC 板 | 可用 | 2.7–5.5 V 供电，VREF ≤ VDD；3.3 V 供电/参考时 LSB = 0.806 mV；SPI mode 0,0，250 kHz 远低于上限。裸片需 SOIC-16 转接板，优先买已焊模块 |
| FSR402 + 10 kΩ | 可用 | 3V3 → FSR → 节点 → 10 kΩ → GND，节点进 CH0；轻按源阻抗约 10 kΩ，250 kHz SPI 下建立时间足够，节点加 100 nF 可降噪；需要刚性背板和压力分散垫 |
| CJMCU-5102（PCM5102A） | 可用，但**电源路径必须先测** | 三线 I2S 已由 TI 数据手册确认（SCK 低 16 个 LRCK 周期后内部 PLL 从 BCK 生成时钟）。板上若有一枚 SOT-23-5 LDO，VCC 是 5 V 输入、3.3 V 是 LDO 输出，**只能接一个**；若没有 LDO，则 3.3 V 直供。用万用表测 VCC–3.3V 二极管/电阻判断后再上电 |
| 12.288 MHz 成品晶振 | **本轮取消采购** | 27 MHz 档已覆盖；T7 留空 |
| 12 V 适配器 + DC 一分二 | 可用 | J13 原理图为 `DC-036A-2.5A-2.0`，即 5.5 mm 外径、2.0/2.1 mm 内针、中心正极 +12 V（原理图第 9 页 DC-IN JACK）。买 5.5×2.1 中心正极的 12 V 适配器；Dock 自带 EUP3458 12 V→5 V，不需要外部 5 V 灌入 GPIO |
| P15W 有源音箱 | 仍不可用 | AUX 输入未确认，不能把 DAC 线路输出接扬声器输出端 |

## 6. 淘宝采购入口

淘宝商品 ID 与登录态/地区绑定，无法在本环境核验成固定链接；以下是**按精确规格的淘宝检索入口**，下单时必须核对规格选项与实物图。已核验的规格页另列。

| 目标 | 淘宝检索入口 | 下单规格 |
|---|---|---|
| CH9350L 下位机模块 | https://s.taobao.com/search?q=CH9350L | 下位机/发送端（SEL=1），带 SEL/S1/S0 拨码或排针，3.3 V TTL 排针，USB-A 母座；不要 CH9329、不要 RS232 |
| MCP3208 模块 | https://s.taobao.com/search?q=MCP3208%20%E6%A8%A1%E5%9D%97 | 已焊 SOIC-16 转 DIP/排针，3.3 V 供电，VREF 引出 |
| PCM5102A / CJMCU-5102 | https://s.taobao.com/search?q=CJMCU-5102 | 已焊，I2S 三线 + FMT/DMP/FLT/XSMT 焊盘 |
| FSR402 | https://s.taobao.com/search?q=FSR402 | 原装 FSR402，带尾线 |
| 12 V 适配器 | https://s.taobao.com/search?q=12V%E7%94%B5%E6%BA%90%E9%80%82%E9%85%8D%E5%99%A8%205.5*2.1 | 12 V ≥3 A，5.5×2.1 中心正极 |
| DC 一分二线 | https://s.taobao.com/search?q=DC%E4%B8%80%E5%88%86%E4%BA%8C%E7%BA%BF | 一母转二公，5.5×2.1，中心正极 |
| 12 V→5 V 双 USB 降压 | https://s.taobao.com/search?q=12V%E8%BD%AC5V%20%E5%8F%8CUSB%20%E9%99%8D%E5%8E%8B%E6%A8%A1%E5%9D%97 | DC 母座输入 12 V，固定 5 V，≥2 个 USB-A，连续 ≥3 A |
| 耳机功放 | https://s.taobao.com/search?q=PAM8403%20%E5%8A%9F%E6%94%BE%E6%A8%A1%E5%9D%97 | 3.3/5 V 供电，LINE IN，接普通耳机 |

已核验的规格/器件页（非淘宝，用于核对型号与资料）：

- CH9350L 芯片与资料：https://www.jlc-smt.com/lcsc/detail/C109472.html
- CH9350L 协议实测文档（state 2 固定帧、SEL/S0/S1 定义）：https://github.com/sjmf/kvm-serial/blob/master/docs/CH9350L_PROTO.md
- 立创开源 CH9350L 验证板 C596308：https://oshwhub.com/li-chuang-zhi-neng-ying-jian-bu/c109472_ch9350l-fang-an-yan-zheng
- PCM5102A 产品页：https://www.ti.com/product/PCM5102A ；数据手册（三线模式）：https://www.ti.com/lit/ds/symlink/pcm5102a.pdf
- MCP3208 数据手册：https://ww1.microchip.com/downloads/en/DeviceDoc/21046b.pdf
- 12.288 MHz 有源晶振（本轮不买，留作备选）：https://item.szlcsc.com/44436267.html
- CJMCU-5102 模块资料：https://github.com/dwhinham/mt32-pi/wiki/CJMCU-5102-DAC-module

## 7. 音响选型（CJMCU-5102 LINE OUT）

PCM5102A 是 **2.1 Vrms 线路输出**，只能接有源音箱的 AUX/LINE IN，或接耳机功放后再接耳机；不能直接接被动音箱、耳机、MIC IN、PHONO 或功放的扬声器输出。选型的第一硬条件是 **模拟 AUX/RCA 输入、无蓝牙、无 DSP 重采样**——蓝牙音箱的 100–200 ms 延迟会直接破坏 ≤10 ms 验收。

| 档位 | 推荐 | 参考价 | 接口/供电 | 说明 |
|---|---|---|---|---|
| 首选 | 漫步者 MR4 有源监听 | 约 400–500 元 | RCA 非平衡 + 6.35 mm TRS，AC 供电 | 频响较平、屏蔽较好、无蓝牙；用 3.5 mm 转双 RCA 线接 LINE OUT。体积较大 |
| 经济 | 漫步者 R1000TCN | 约 300–400 元 | RCA，AC 供电 | 经典 2.0，桌面占位小；老款底噪略高，验收时以实测为准 |
| 用现有耳机 | TPA6132A2 耳机放大模块 | 约 15–30 元 | 3.3/5 V，3.5 mm 进/出 | LINE OUT → 耳放 → 耳机；不要用 PAM8403 推耳机（D 类喇叭功放，底噪大） |
| 最低成本 | PAM8403 + 4 Ω 3 W 全频喇叭 | 约 30 元 | 5 V | 能响，但开关噪声/EMI 大，只适合临时调试，不作为音质验收 |

配件：3.5 mm 公对公屏蔽短线（0.5 m）或 3.5 mm 转双 RCA；若音箱与 FPGA 共用 12 V 电源出现嗡嗡声，加一个 **3.5 mm 共地隔离器**（约 20–40 元）。音量优先用音箱旋钮定在舒适位，演奏表情用 FPGA 的 M0/压力 VCA，不要用音箱音量做演奏控制。

淘宝检索入口：[漫步者 MR4](https://s.taobao.com/search?q=%E6%BC%AB%E6%AD%A5%E8%80%85%20MR4)、[漫步者 R1000TCN](https://s.taobao.com/search?q=%E6%BC%AB%E6%AD%A5%E8%80%85%20R1000TCN)、[3.5 mm 转双 RCA](https://s.taobao.com/search?q=3.5mm%E8%BD%AC%E5%8F%8CRCA)、[TPA6132A2 耳放模块](https://s.taobao.com/search?q=TPA6132A2%20%E8%80%B3%E6%9C%BA%E6%94%BE%E5%A4%A7%E6%A8%A1%E5%9D%97)、[3.5 mm 共地隔离器](https://s.taobao.com/search?q=3.5mm%20%E5%85%B1%E5%9C%B0%E9%9A%94%E7%A6%BB%E5%99%A8)、[PAM8403](https://s.taobao.com/search?q=PAM8403%20%E5%8A%9F%E6%94%BE%E6%A8%A1%E5%9D%97)。

CJMCU-5102 接线（照片已确认丝印）：`XMT→3.3V`（解除静音）、`FMT→GND`（标准 I2S）、`DMP→GND`（关闭去加重）、`FLT→GND`（常规滤波；接 3.3V 为低延迟滤波）、`SCL→GND`（三线模式，注意它是 SCK 不是 I2C）、`BCK→B12`、`DIN→B13`、`LCK→C12`、`GND→GND`。电源：若板背有 AMS1117/662K 一类 LDO，`VCC` 接 5 V、`3.3V` 悬空；若没有 LDO，`VCC` 与 `3.3V` 为同一网络，只接 3.3 V。上电前用万用表二极管档测 VCC→3.3V，有 0.6 V 左右压降说明有 LDO，**两个脚不能同时接电源**。

## 8. 仍需确认 / 未执行

1. **P0 选表语义修复未执行**：非钢琴音色（T0–T249）当前仍从 72 张钢琴表取 bank 0..4。按方案应恢复 6 级通用明亮表，代价是 +3 块 BSRAM（37→40/46），并会改变 T0–T249 的音色与 `tb_bandlimit_engine` 的黄金向量。需要确认是否接受该代价与重做基线。
2. **HID 键盘接口未接顶层**：协议已明确（state 2），但 L9/N8 要从 12 路 GPIO 键改为 Host UART，属于公共引脚变更；方案要求先评审接线表。本轮未改。
3. **实物验证未做**：PCM5102A 在 46.875 kHz 三线模式的 PLL 锁定/静音、CJMCU 电源路径、FSR 源阻抗、CH9350L 实际帧重复次数，都需要到货后用逻辑分析仪和万用表确认。
4. 完整仿真门禁按用户要求本轮未跑；烧录前必须补跑。
