Interstellar-530/PolyTouch-FPGA-Synth/evidence/2026/10/s4-s6-integration-20261015/reports/timing_summary_instrument_shared_engine.txt

整合顶层（共享引擎 + 全局混合）时序摘要，2026-10-15
源: impl/pnr/instrument_tr_content.html (Gowin V1.9.11.03 Education, GW2A-18 C)

Created Time
Thu Oct 15 18:55:16 2026
Legal Announcement
Copyright (C)2014-2025 Gowin Semiconductor Corporation. All rights reserved.
Timing Summaries
STA Tool Run Summary:
Setup Delay Model
Slow 0.95V 85C C8/I7
Hold Delay Model
Fast 1.05V 0C C8/I7
Numbers of Paths Analyzed
4187
Numbers of Endpoints Analyzed
4005
Numbers of Falling Endpoints
0
Numbers of Setup Violated Endpoints
0
Numbers of Hold Violated Endpoints
0
Clock Summary:
NO.
Clock Name
Type
Period
Frequency(MHz)
Rise
Fall
Source
Master
Objects
1
clk_27m
Base
37.037
27.000
0.000
18.518
clk_27m
Max Frequency Summary:
NO.
Clock Name
Constraint
Actual Fmax
Logic Level
Entity
1
clk_27m
27.000(MHz)
46.368(MHz)
18
