Interstellar-530/PolyTouch-FPGA-Synth/evidence/2026/10/top-i2s-20261016/reports/timing_summary_top_dbg.txt

debug profile (clk_27m) 时序摘要
源: impl/pnr/instrument_tr_content.html（Gowin V1.9.11.03 Education, GW2A-18 C）

STA Tool Run Summary:
Setup Delay Model
Slow 0.95V 85C C8/I7
Hold Delay Model
Fast 1.05V 0C C8/I7
Numbers of Paths Analyzed
4192
Numbers of Endpoints Analyzed
4010
Numbers of Falling Endpoints
0
Numbers of Setup Violated Endpoints
0
Numbers of Hold Violated Endpoints
0
Clock Summary:
NO.
Clock Name
Type
Period
Frequency(MHz)
Rise
Fall
Source
Master
Objects
1
clk_27m
Base
37.037
27.000
0.000
18.518
clk_27m
Max Frequency Summary:
NO.
Clock Name
Constraint
Actual Fmax
Logic Level
Entity
1
clk_27m
27.000(MHz)
44.633(MHz)
16
TOP
Total Negative Slack Summary:
Clock Name
Analysis Type
Endpoints TNS
Number of Endpoints
clk_27m
Setup
