Interstellar-530/PolyTouch-FPGA-Synth/evidence/2026/10/top-i2s-20261016/reports/timing_summary_top_std.txt

standard I2S profile (clk_12m288) 时序摘要
源: impl/pnr/instrument_tr_content.html（Gowin V1.9.11.03 Education, GW2A-18 C）

STA Tool Run Summary:
Setup Delay Model
Slow 0.95V 85C C8/I7
Hold Delay Model
Fast 1.05V 0C C8/I7
Numbers of Paths Analyzed
4082
Numbers of Endpoints Analyzed
3879
Numbers of Falling Endpoints
0
Numbers of Setup Violated Endpoints
0
Numbers of Hold Violated Endpoints
0
Clock Summary:
NO.
Clock Name
Type
Period
Frequency(MHz)
Rise
Fall
Source
Master
Objects
1
clk_12m288
Base
81.380
12.288
0.000
40.690
clk_12m288
Max Frequency Summary:
NO.
Clock Name
Constraint
Actual Fmax
Logic Level
Entity
1
clk_12m288
12.288(MHz)
45.046(MHz)
20
TOP
Total Negative Slack Summary:
Clock Name
Analysis Type
Endpoints TNS
Number of Endpoints
clk_12m288
Setup
