Interstellar-530/PolyTouch-FPGA-Synth/docs/planning/FPGA-缺件期间仿真与算法任务-20261013-v0.1.md

# 缺件期间可先开展的仿真与算法工程（2026-10-14 v0.2）

原规划审查基线为 8109049。2026-10-14 的生产发布为 `b559237`（v1.01），音频逻辑沿用 v1.0.0。S0、S1 已完成；用户另行授权实施并复核 S2，现已通过十二台 RTL 门禁、PCM/WAV/FFT 回归和 Gowin 综合/PnR，在表中划去。S2 交付位于 `codex/s2-gpio-keyboard`，测试输入由 SHA256 绑定，本地归档为 `archive/FPGA-20261014-v0.4`。[S2 复核记录](../../evidence/2026/10/FPGA-S2-复核-20261014-v0.1.md)。S3 原实现由 DeepSeek 完成，本轮独立复核修正隔离综合位宽未生效、模型停 BCK 复位和测试探针/填充/tick 缺口。十三台正向门禁、六个参数负例、三种检查器故障注入、原音频回归及真实16/24位隔离综合/PnR全部通过。交付分支为 `codex/s3-i2s-tx`，复核归档 `archive/FPGA-20261014-v0.7`。[S3复核记录](../../evidence/2026/10/FPGA-S3-review-20261014-v0.1.md)。S4–S6继续待办，T04实机集成未验收。

已烧录状态仍是四声部、单 512 点正弦表、27 MHz/46.875 kHz PT8211 路径。今天已将原 `0x5633` 位流写入外部 Flash，经 GAO-Bridge 完整校验、从 Flash 重载和用户断电验收，可上电自启动。[Flash 与 S1 记录](../../evidence/2026/10/FPGA-S1-音频验收-20261014-v0.1.md)。S2 工作分支增加了 12 路 GPIO 与手动 FIFO，候选位流没有烧录，实体 GPIO 接线和 Bank 电压仍待实测。

硬件未到齐时，队友可以先交付数字逻辑与模型，由用户在器件到货后逐件接入。10/28 制作 DDL 和 10/29-11/04 材料周继续执行，但到货前的日期任务先按下面的数字交付完成，实机部分保持待验收。模型完成不能把原计划的实体二维输入/标准 I2S/总延迟门槛标为通过。

## 先建立验证链，再增加算法

S0–S3 已完成数字交付，后续从 S4 开始。S3 经本轮独立复核修正，原有标准 I2S 模块验收补足；正式时钟/顶层/DAC 实机集成、SPI 器件模型、压力/弯音与双音色继续安排。工时为原规划估计开发加测试人时，属于原计划 T02-T05/T07 的内部拆分，不与原预算叠加。

| 顺序 | 任务与具体交付 | 无外设时的自检完成标准 | 工时估计 |
| --- | --- | --- | ---: |
| ~~S0~~ 已完成 | ~~仿真环境、九台基线和复现记录~~ | 10/14 烧录前重新编译全部九台并通过；工具路径/版本、提交和日志齐全，退出码 0 | 1-2 h |
| ~~S1~~ 已完成 | ~~真实音频捕获：tb_audio_capture、序列化样本解码、PCM/WAV/FFT 分析~~ | 真实节拍捕获 58880 帧；A4 约 439.999975 Hz，误差 ≤1 Hz；四个不同基频逐个松键消失；全部释放和 M0 输出零；PCM/WAV 格式及数量正确；十台门禁、分析和八个负面样例自检通过 | 4-6 h |
| ~~S2~~ 数字验收完成 | ~~gpio_keyboard、手动来源 FIFO/仲裁、GPIO 和顶层模式测试~~ | 12 路同步/消抖和四/十二键同拍；单键满队列、手动 FIFO 16+4 项背压不丢事件；消抖期间 Panic 不补发起音；无阻塞时响应 27002/27005 拍；十二台门禁与音频回归退出 0，PnR 通过；实物待验收 | 6-8 h |
| ~~S3~~ 数字复核完成 | ~~i2s_tx、独立引脚接收模型、统一时钟/采样率参数~~ | 两档×16/24位四组合通过：标准256拍/帧、BCK高低2/2；调试576拍/帧、4/5；有效位与零填充正确、tick与边界一一对应、帧内不撕裂；三种位置硬复位均恢复双路非零探针，停BCK模型复位通过；十三台正向、六个参数负例、三种故障注入和58,880帧原音频回归通过；真实16/24位综合/PnR setup/hold违例0。未接顶层、未上板 | 5-7 h |
| S4 | mcp3208_spi、器件引脚行为模型、两通道测试 | 独立解析 Start/单端/CH0/CH1/null/12 位数据；0/1/2047/2048/4095 和固定种子随机值无错位串值；CS 中断/复位可恢复；完整事务后才提交，ADC 不阻塞 I2S | 5-7 h |
| S5 | 压力滤波/映射、持续弯音，Python 定点参考与 HDL 对照 | 0-4095、阶跃/斜坡/单点尖峰：逐值对照，无回绕且有界；记录 90% 阶跃响应；压力不改音高，电位器改变持音频率不重起包络；初始 ±2 半音/中位回正；压力关闭仍可演奏 | 5-7 h |
| S6 | 两张 512 点表、Gowin ROM 包装/同步模型、混音和 clip 计数 | 两表各 512 点；同步读延迟、相位环绕/插值与参考一致；切换/混合可控；四路同相正负极值正确饱和不回绕；clip 统计准确；FIR 旁路/启用延迟和频响有记录 | 6-8 h |

S4–S6 保留为**后续待办**。S2 顶层已接入 GPIO 数字逻辑，实体按键尚未验收；S3 的 `i2s_tx` 作为可复用模块单独验收，尚未接入顶层、未改 CST/SDC、未切系统时钟；MCP3208、压力、双音色和运行时弯音仍待后续开发。同一天约定一人集成顶层/CST，避免接口冲突。本次复核止于 S3 数字模块。S3划去不代表T04完成：12.288MHz晶振/Bank/GCLK、唯一tick、DDS/UART/去抖/ADSR/曲目参数迁移、DAC跳线和引脚波形、整机延迟继续待测。10/25停止新增、10/28制作冻结和材料周不变。

## 现有测试边界与新自检要求

tb_mode_uart 使用 `force dut.sample_tick = 1'b1` 加快状态机，它证明模式和事件处理，不证明真实采样 PCM、频谱或数字延迟。新增 S1 必须使用实际时钟和单周期采样使能，不能把这个加速测试输出当音频证据。优先解码序列化输出得到实际发送的数字样本，另对照内部稳定样本寄存器，以覆盖输出路径。

现有 tb_pt8211_tx 只生成 VCD 后 finish，无自检断言，仍只作 GTKWave 环境展示。S1 新增 tb_audio_capture 以真实时钟运行，独立解码 PT8211 引脚，明确断言 sample_tick 高电平一周期、每帧 576 时钟、每声道 16 位及左右/内部稳定样本一致，已作为第十台加入门禁。tb_tick_rate 的真实频率为 27,000,000/576=46,875 Hz，v1.0.0 已修正旧打印公式。新增功能台继续使用超时保护和 `$fatal(1,...)`，本次捕获为确定性命令序列，不使用随机种子。

四音频谱建议用 C4、D#4、F#4、A4 等可区分组合，同时核对独立声部状态和逐个 Note Off 的衰减。C4 与 C5 的基频/谐波可能重叠，四峰图不能单独证明四个独立声部。频率误差验收须记录样本长度、FFT 分辨率和估计方法；短记录的粗频谱不足以支持 1 Hz 精度判断。Python 只用于参考/离线分析，FPGA 实际音频不由 Python 或 CPU 生成。

## 算法实现的边界

压力滤波先评估三点中值和 IIR `y += (x-y) >> 1`，用 2 kHz 控制采样模型测阶跃/尖峰响应、定点取整、边界和初始化，再选择参数。这里是 Python 参考写法；HDL 对有符号差值使用算术右移 `>>>`，保持符号扩展，不让负差值当无符号右移。FSR 是相对表情，不按牛顿精度验收；ADC 读到零或满量程不能单独证明断线。

初始 SPI 可按约 250 kHz、每通道 1-2 kHz 调度，低速事务跨音频帧独立运行；48 kHz 合成只读取已提交控制值。正式时钟迁移同步改 UART CLK_HZ、DDS 频率字、曲目样本数和 ADSR 的时间换算；保留 27 MHz 调试目标时也应明确各自参数，不能混用频率 ROM。

先生成正弦和限制谐波的亮音色单周期表，当前 C4-C5 可从最多 16 次谐波起步；扩展音域时重新核对 Nyquist。离线生成 hex 并校验长度/有符号范围/峰值/校验值；运行硬件用 Gowin BSRAM IP/原语。抽象同步 ROM 可以先验证算法，未接厂商模型时标记“厂商原语验证未完成”，异步数组不能代替真实 BSRAM 延迟验证。单周期函数表是实时合成数据，不存整曲/预录 PCM。

现有 mixer 四路求和后除以二仍可能削波。S6 测试最大同相/反相输入、最小负数、增益边界及饱和反馈；定义 clip 计数的统计点，旁路 FIR 时保留明确帧延迟。FIR 高频衰减、插值误差与模拟静音底噪是不同问题，不能用增加 DSP 算法宣称已解决电源/模拟链路噪声。

## 靠后进行的共享引擎与效果

基础数字链和四声部回归通过后，才安排八/三十二声部共享调度和短延迟。现声部约三只 18×18 乘法器：直接复制八路已达 24 只保守预算，32 路需 96 只，超过器件物理 48 只。46 块 BSRAM、24 只保守乘法器和每帧 256 周期必须同时满足，宏 DSP 与乘法器实例另记。

先用周期模型验证独立相位/包络上下文的保存恢复、同步 ROM/DSP valid、最坏帧截止，再上共享 RTL。四流水线×八上下文、每声部 16 周期，加控制/混音预留约 208/256 是已有预算，不是结果；波表先按八块保守预算，再计状态、频率表与效果缓存。扩声部/效果超过窗口就回退四声部，不挤占 10/29-11/04 材料周。暂不展开 FPGA FFT 显示、复杂混响、蓝牙/App 和另一套 MPR121 主键盘。

## 可复用来源与远程交付

可借鉴 [nishadsuresh/fpga-verilog-synth](https://github.com/nishadsuresh/fpga-verilog-synth) 的串行输入→RTL 样本→PCM/WAV/FFT 组织方式。该仓库的实时顶层与独立四声部混音测试范围不同，不能直接当本机四声部板卡固件。当前为 MIT，依赖 Icarus/GTKWave 和 Python 数值库；若复制源码，固定提交并保留许可。这里只规划验证思路，没有导入代码。

[XLS32](https://github.com/kazunori279/xls32-fpga-synth) 的状态/运算分离和握手可参考，其 Apache-2.0 许可和板级外壳需逐项适配；原 Basys 配置约 768 周期/帧不符合本项目 256 周期。SPI 模型依据 [Microchip MCP3208](https://www.microchip.com/en-us/product/MCP3208)，I2S 接收模型依据 [TI PCM5102A](https://www.ti.com/product/PCM5102A)。外部项目作为参考，不重复部署整套不匹配工具链。

每个数字交付包包含提交 ID、RTL/测试、固定随机种子、全部门禁日志、模型说明、ROM 校验值、构建/复现命令和限制。队友没有 Gowin 时先交 RTL 自检与算法数据；本机具备工具后由用户统一综合/PnR。用户拿到外设后测原始波形和供电/负载，队友据此分析。

仿真能验证事件、协议、定点范围与帧截止；实际电压/接地、晶振品质、ADC 实物噪声、FSR 机械安装、DAC 模拟延迟/底噪和完整物理响应仍须逐件到货验收。仿真 PASS、综合/PnR PASS、实机 PASS 三种状态分别记录。[逐件到货流程](../hardware/FPGA-外设到货接入与验收流程-20261013-v0.1.md)；[队友配置提示词](../handoff/FPGA-队友仿真环境配置提示词-20261013-v0.1.md)
