Interstellar-530/PolyTouch-FPGA-Synth/docs/reviews/FPGA-构建绑定优化效果审核-20261021-v0.1.md

# 第二项优化效果审核

2026-10-21。审核结论：**构建内容绑定与可复现生成的核心效果通过，第二项可以标记为功能完成。** 本轮没有修改被审构建脚本、生成算法、RTL、约束或硬件。

输入身份已从大小和时间戳切换为路径与 SHA256。构建前后、自动选择位流的烧录入口都调用内容比较；位流也有独立 SHA256 校验。现有自检的 11 项输入检查和 16 项构建入口检查覆盖等长且保留时间戳的源码修改、仅更新时间戳、构建期间输入变化，以及失败构建不留下成功凭据。审核对照了这些测试的实现、日志和当前代码，没有重复运行整套检查。

| 效果 | 审核结果 |
|---|---|
| 输入内容绑定 | 当前成功凭据的 222 个输入均与实际文件 SHA256 相同，输入集合与当前构建清单对应 |
| 汇总摘要 | 凭据包含 InputsDigest；整组输入以路径和内容形成摘要，时间戳不参与 |
| 位流与工具来源 | 当前位流 SHA256 匹配；工具版本 V1.9.11.03 Education 与 PnR 报告一致 |
| 同大小、同时间戳改动 | 11/16 项已有检查覆盖源码端检测及构建期间拒绝，代码路径与预期一致 |
| 再制表路径 | 三个生成脚本已改为基于脚本位置或显式 --repo-root、--wav/--samples、--out-dir 定位；生成算法未改 |
| 再制表数据 | 已有重建证据为电钢琴 39/39、吉他采样 39/39 文件逐字节一致；legacy 吉他脚本正常生成 9 个文件 |
| 硬件结果 | 本项不改 RTL/约束/ROM；已有前后 PnR 指标一致，本轮没有重复综合 |

审核中发现的两处说明已直接更正。构建 README 已明确工具版本用于追溯，当前没有工具版本不一致时拒绝烧录的检查。优化说明已区分普通构建与再制表：普通构建使用入库 ROM/HEX，无需重新下载素材；电钢琴与采样吉他重新制表仍需要原 WAV 或 Samples，可以通过新参数指定来源。以上更正不改变实现或本项通过结论。

原始证据之外只尝试补查等长位流修改。该探针在环境准备时因当前子 PowerShell 无法加载 Get-FileHash 停止，没有进入功能路径，未计为通过；按用户避免无效重复测试的要求，不继续追查该审核环境。当前位流的内容哈希匹配则由独立只读核对完成。没有完整 RTL 门禁、额外 PnR 或真实烧录。

审核证据在 `evidence/2026/10/FPGA-优化02审核-20261021-v0.1`；原实现证据在 `evidence/2026/10/FPGA-优化02-构建绑定-20261021`。本轮隔离目录在保留记录后清理，原文件、既有构建和工具依赖保留。可以按优化路线推进第三项 HID 控制仿真。
