Interstellar-530/PolyTouch-FPGA-Synth/docs/planning/FPGA淘宝采购链接-20261012-v0.1.md

# 淘宝采购链接清单（20261012-v0.1）

本清单为 Tang Primer 20K Dock 3714 电子乐器项目的外设采购链接。淘宝商品页在未登录状态下会被反爬拦截，也无法被搜索引擎收录，因此每行给的是按精确关键词生成的淘宝搜索页链接，点开后即为当前在售商品，价格和店铺随行就市。

状态一列中，已购表示你已经在到货的清单上打勾；需补购是当前还缺的；其余按备注处理。

## 1. 当前需要补购

| 编号 | 元件 | 数量 | 关键词 | 链接 |
| --- | --- | --- | --- | --- |
| P02 | 触摸电极与细导线 | 12 套 | 铜箔胶带 导电 自粘 | [淘宝搜索](https://s.taobao.com/search?q=%E9%93%9C%E7%AE%94%E8%83%B6%E5%B8%A6%20%E5%AF%BC%E7%94%B5%20%E8%87%AA%E7%B2%98) |
| P02-2 | 电极引线（细电子线） | 1 套 | 电子线 单芯 0.5mm 多色 导线 | [淘宝搜索](https://s.taobao.com/search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) |
| P02-3 | 导电布电极（可选替代） | 1 卷 | 导电布 胶带 电磁屏蔽 | [淘宝搜索](https://s.taobao.com/search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) |
| P04 | 10kΩ 分压电阻 | 10 个 | 金属膜电阻 10K 1/4W 100只 | [淘宝搜索](https://s.taobao.com/search?q=%E9%87%91%E5%B1%9E%E8%86%9C%E7%94%B5%E9%98%BB%2010K%201%2F4W%20100%E5%8F%AA) |
| P11 | 杜邦线综合套装 | 1 套 | 杜邦线 套装 公对母 母对母 公对公 | [淘宝搜索](https://s.taobao.com/search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) |
| P12 | 去耦电容与串阻套装 | 1 套 | 独石电容包 100nF 1uF 30种 | [淘宝搜索](https://s.taobao.com/search?q=%E7%8B%AC%E7%9F%B3%E7%94%B5%E5%AE%B9%E5%8C%85%20100nF%201uF%2030%E7%A7%8D) |

按清单里的预算单价，这组补购件合计约 74 元：触摸电极 36 元、10kΩ 电阻 3 元、杜邦线 20 元、去耦电容与串阻 15 元。电极引线和导电布按现有库存决定是否加买。

## 2. 全部条目

| 编号 | 类别 | 元件 | 数量 | 状态 | 淘宝关键词 | 链接 | 选型要点 |
| --- | --- | --- | --- | --- | --- | --- | --- |
| P01 | 演奏输入 | MPR121 12路电容触摸模块 | 1 块 | 已购 | MPR121 电容触摸模块 12路 I2C | [搜索](https://s.taobao.com/search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) | 确认模块自带 I2C 上拉、ADDR 跳线位置；3.3V 供电 |
| P02 | 演奏输入 | 触摸电极与细导线 | 12 套 | 需补购 | 铜箔胶带 导电 自粘 | [搜索](https://s.taobao.com/search?q=%E9%93%9C%E7%AE%94%E8%83%B6%E5%B8%A6%20%E5%AF%BC%E7%94%B5%20%E8%87%AA%E7%B2%98) | 12 路电极可用铜箔胶带或导电布；引线越短越好，避开 I2C/SPI 走线 |
| P02-2 | 演奏输入 | 电极引线（细电子线） | 1 套 | 需补购 | 电子线 单芯 0.5mm 多色 导线 | [搜索](https://s.taobao.com/search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) | MPR121 模块只带排针，电极到模块的引线要细、要短，单根不超过 200mm |
| P02-3 | 演奏输入 | 导电布电极（可选替代） | 1 卷 | 需补购 | 导电布 胶带 电磁屏蔽 | [搜索](https://s.taobao.com/search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) | 和铜箔二选一，电极面积大些更灵敏 |
| P03 | 演奏输入 | FSR402 压力传感器 | 1 个 | 已购 | FSR402 压力传感器 薄膜 | [搜索](https://s.taobao.com/search?q=FSR402%20%E5%8E%8B%E5%8A%9B%E4%BC%A0%E6%84%9F%E5%99%A8%20%E8%96%84%E8%86%9C) | 响应非线性，只作相对力度标定 |
| P04 | 演奏输入 | 10kΩ 分压电阻 | 10 个 | 需补购 | 金属膜电阻 10K 1/4W 100只 | [搜索](https://s.taobao.com/search?q=%E9%87%91%E5%B1%9E%E8%86%9C%E7%94%B5%E9%98%BB%2010K%201%2F4W%20100%E5%8F%AA) | 与 FSR 组成分压；也可直接买常用阻值电阻包 |
| P05 | 演奏输入 | MCP3208 12位 SPI ADC | 1 块 | 已购 | MCP3208 ADC 模块 12位 SPI | [搜索](https://s.taobao.com/search?q=MCP3208%20ADC%20%E6%A8%A1%E5%9D%97%2012%E4%BD%8D%20SPI) | VDD/VREF 都接 3.3V；SPI 先跑 1MHz |
| P06 | 正式音频 | PCM5102A I2S DAC 模块 | 1 块 | 已购 | PCM5102A I2S DAC 模块 | [搜索](https://s.taobao.com/search?q=PCM5102A%20I2S%20DAC%20%E6%A8%A1%E5%9D%97) | FMT 跳线选标准 I2S；线路输出接有源音箱或耳放 |
| P07 | 正式音频 | 12.288MHz 有源晶振及转接 | 1 套 | 已购 | 12.288MHz 有源晶振 3.3V 贴片 | [搜索](https://s.taobao.com/search?q=12.288MHz%20%E6%9C%89%E6%BA%90%E6%99%B6%E6%8C%AF%203.3V%20%E8%B4%B4%E7%89%87) | 配套买贴片转 DIP 转接板；输出串 22~100Ω |
| P08 | 正式音频 | 耳机功放模块 | 1 块 | 已购 | 耳机功放模块 3.5mm 立体声 | [搜索](https://s.taobao.com/search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) | PCM5102A 是线路输出，接无源耳机必须经功放 |
| P09 | 第三维控制 | B10K 线性电位器及旋钮 | 1 套 | 已购 | B10K 电位器 单联 线性 旋钮 | [搜索](https://s.taobao.com/search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) | 接 MCP3208 通道 1，做连续控制量 |
| P10 | 连接供电 | 830 孔面包板 | 1 块 | 已购 | 面包板 830孔 免焊 | [搜索](https://s.taobao.com/search?q=%E9%9D%A2%E5%8C%85%E6%9D%BF%20830%E5%AD%94%20%E5%85%8D%E7%84%8A) | 电极引线和 FSR 分压先在面包板上验证 |
| P11 | 连接供电 | 杜邦线综合套装 | 1 套 | 需补购 | 杜邦线 套装 公对母 母对母 公对公 | [搜索](https://s.taobao.com/search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) | 三种接头都要；母对母用于接开发板排针 |
| P12 | 连接供电 | 去耦电容与串阻套装 | 1 套 | 需补购 | 独石电容包 100nF 1uF 30种 | [搜索](https://s.taobao.com/search?q=%E7%8B%AC%E7%9F%B3%E7%94%B5%E5%AE%B9%E5%8C%85%20100nF%201uF%2030%E7%A7%8D) | 另需 22~100Ω 串阻和 4.7kΩ 上拉；可买常用阻值包补齐 |
| P13 | 连接供电 | 5V/2A USB 电源或充电宝 | 1 个 | 自有或借用 | USB充电器 5V 2A | [搜索](https://s.taobao.com/search?q=USB%E5%85%85%E7%94%B5%E5%99%A8%205V%202A) | 断开与电脑共地时用，做底噪对照 |
| P14 | 调试证据 | 数字万用表 | 1 台 | 实验室借用 | 数字万用表 自动量程 | [搜索](https://s.taobao.com/search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) | 确认 3.3V/1.5V 电源域和分压比 |
| P15 | 调试证据 | 8 通道 USB 逻辑分析仪 | 1 台 | 实验室借用 | 逻辑分析仪 8通道 24M USB | [搜索](https://s.taobao.com/search?q=%E9%80%BB%E8%BE%91%E5%88%86%E6%9E%90%E4%BB%AA%208%E9%80%9A%E9%81%93%2024M%20USB) | 抓 I2C/SPI/I2S 波形；板内 GAO 只能看数字状态 |
| P16 | 调试证据 | 3.5mm 立体声音频线 | 1 根 | 已购 | 3.5mm 音频线 双公头 立体声 | [搜索](https://s.taobao.com/search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) | 接电脑声卡输入看频谱 |
| P17 | 调试证据 | USB 声卡（真正线路输入） | 1 个 | 已购 | USB声卡 线路输入 | [搜索](https://s.taobao.com/search?q=USB%E5%A3%B0%E5%8D%A1%20%E7%BA%BF%E8%B7%AF%E8%BE%93%E5%85%A5) | 录音关闭 AGC 再测谐波和底噪 |
| P18 | 调试证据 | 线路输入衰减连接组件 | 1 套 | 条件采购 | 音频衰减器 3.5mm 无源 | [搜索](https://s.taobao.com/search?q=%E9%9F%B3%E9%A2%91%E8%A1%B0%E5%87%8F%E5%99%A8%203.5mm%20%E6%97%A0%E6%BA%90) | 线路输入实测削波时再加 |
| P19 | 调试证据 | ≥50MHz 示波器 | 1 台 | 实验室借用 | 示波器 50MHz 双通道 | [搜索](https://s.taobao.com/search?q=%E7%A4%BA%E6%B3%A2%E5%99%A8%2050MHz%20%E5%8F%8C%E9%80%9A%E9%81%93) | 看模拟噪声、输出边沿和总延迟 |
| P20 | 调试证据 | 焊台与焊接耗材 | 1 套 | 实验室借用 | 焊台 恒温 电烙铁 套装 | [搜索](https://s.taobao.com/search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) | 焊接晶振转接板、排针和固定接线 |
| P21 | 结构固定 | 洞洞板、底板及紧固件 | 1 套 | 后续需要 | 洞洞板 万用板 5x7 | [搜索](https://s.taobao.com/search?q=%E6%B4%9E%E6%B4%9E%E6%9D%BF%20%E4%B8%87%E7%94%A8%E6%9D%BF%205x7) | 另配 M3 铜柱螺丝套装固定电极和压力垫 |
| P22 | 备用件 | 12.288MHz 晶振备用套装 | 1 套 | 暂缓 | 12.288MHz 有源晶振 3.3V 贴片 | [搜索](https://s.taobao.com/search?q=12.288MHz%20%E6%9C%89%E6%BA%90%E6%99%B6%E6%8C%AF%203.3V%20%E8%B4%B4%E7%89%87) | 随 P07 一起决定是否备件 |
| P23 | 可选扩展 | EC11 旋转编码器 | 2 个 | 暂缓 | EC11 旋转编码器 带旋钮 20位 | [搜索](https://s.taobao.com/search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) | 先用板载按键和串口调参 |
| P24 | 可选扩展 | 0.96 寸 SPI OLED | 1 块 | 暂缓 | 0.96寸 OLED SPI 模块 7针 | [搜索](https://s.taobao.com/search?q=0.96%E5%AF%B8%20OLED%20SPI%20%E6%A8%A1%E5%9D%97%207%E9%92%88) | 板载 6 个 LED 加 WS2812B 已够状态反馈 |
| P25 | 可选扩展 | 12 灯 WS2812 灯带 | 1 条 | 暂缓 | WS2812B 灯带 12灯 5V | [搜索](https://s.taobao.com/search?q=WS2812B%20%E7%81%AF%E5%B8%A6%2012%E7%81%AF%205V) | 逐键灯效才需要 |
| P26 | 可选扩展 | 74AHCT 电平转换小板 | 1 块 | 暂缓 | 74AHCT125 电平转换 模块 | [搜索](https://s.taobao.com/search?q=74AHCT125%20%E7%94%B5%E5%B9%B3%E8%BD%AC%E6%8D%A2%20%E6%A8%A1%E5%9D%97) | 仅外接 5V 灯带时评估 |
| P27 | 可选扩展 | DIN MIDI 输入及 6N138 组件 | 1 套 | 暂缓 | MIDI 插座 5针 DIN 180度 | [搜索](https://s.taobao.com/search?q=MIDI%20%E6%8F%92%E5%BA%A7%205%E9%92%88%20DIN%20180%E5%BA%A6) | 另配 6N138 光耦和限流电阻 |
| P28 | 可选扩展 | 第二片 MPR121 模块 | 1 块 | 暂缓 | MPR121 电容触摸模块 12路 I2C | [搜索](https://s.taobao.com/search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) | 扩到 24 键时再买，注意 I2C 地址跳线 |
| P29 | 可选供电 | 12V 直流适配器 | 1 个 | 自有或借用 | 12V 2A 电源适配器 5.5*2.1 | [搜索](https://s.taobao.com/search?q=12V%202A%20%E7%94%B5%E6%BA%90%E9%80%82%E9%85%8D%E5%99%A8%205.5%2A2.1) | 只接底板 J13，插头极性和尺寸实物核对 |
| P30 | 可选声音 | 有源音箱 | 1 套 | 自有或借用 | 有源音箱 3.5mm 桌面 | [搜索](https://s.taobao.com/search?q=%E6%9C%89%E6%BA%90%E9%9F%B3%E7%AE%B1%203.5mm%20%E6%A1%8C%E9%9D%A2) | 可替代 P08 耳机功放，不重复计采购 |

## 3. 采购提示

淘宝搜索页支持按销量排序，模块类商品优先选销量高、带原理图或资料链接的店铺。MPR121 和 PCM5102A 这类模块，下单前向客服确认芯片型号、供电电压和跳线默认状态，到手后再按硬件控制信号文档逐项核对。

关键词里带具体型号的条目，如果搜出来结果太杂，可以把关键词再缩短到型号本身，例如只搜 MPR121 或 PCM5102A。

生成方式：`python tools/make_purchase_links.py --outdir docs/planning`。
