Interstellar-530/PolyTouch-FPGA-Synth/docs/planning/零外设可实施功能与设计-20261010.md

# 零外设条件下的可实施功能与设计

> 2026-10-12 更新：本文保留 10 月 10 日的历史规划。四声部 RTL、COM13 实测和 ADSR 缺陷复查后的当前任务，请以[零外设可执行任务（2026-10-12）](../reviews/FPGA-20261012-v0.1/零外设可执行任务-20261012.md)为准。

日期：2026-10-10

前提：手头只有 Tang Primer 20K 核心板、Dock 3714 底板和一根 3.5 mm 耳机线，没有触摸模块、压力传感器、外接 DAC、外部仪器、面包板和额外按键。

## 结论

Dock 3714 底板上已经集成了完整的回放通路，PT8211 DAC、LPA4809MSF 耳机功放和 3.5 mm 耳机座都是板载的，所以"FPGA 实时算出声音、在耳机里听结果"这条链路不需要任何外接件。合成算法本身的开发和听感验证现在就可以全部开展，不必等外设到货。

真正被物料卡住的只有三块：演奏界面（12 路触摸和 FSR 力度）、赛题正式要求的 I2S 到 PCM5102A 音频出口，以及需要外部仪器的板级测量。前两块对应同目录的《可自行购买外设与耗材清单-20261010.md》，第三块对应《需外部仪器的调试任务清单-20261010.md》。

这里有两个假设需要写明。第一，仍然能够更新码流，也就是电脑可以经 USB 数据线接到底板 USB-JTAG 口做 JTAG 烧录。第二，串口上位机控制在底板 USB-JTAG 口成功枚举到电脑之前不保证可用，所以现阶段的功能都要设计成不依赖串口也能跑起来。

## 一、现在就能听到和看到的

| 功能 | 状态 | 零外设下的验证方式 |
| --- | --- | --- |
| 单声部 DDS 正弦合成，默认 A4 440 Hz | 已实现 | 插耳机直接听 |
| ADSR 包络，起音后停在延音电平持续发声 | 已实现 | 听感，无 0.25 秒通断 |
| 512 点波表线性插值，带内误差低于 -90 dBFS | 已实现 | 听感 + 综合报告 |
| (1,4,6,4,1)/16 平滑滤波与约 -12 dB 数字音量 | 已实现 | 听感 |
| S1 切 C4 261.63 Hz、S2 切 C5 523.25 Hz | 已实现 | 按板载按键 |
| S3 同步复位，按键复位不关功放、不产生爆音 | 已实现 | 按 S3 听 |
| N16 运行指示 LED，1 Hz 闪烁，静音时熄灭 | 已实现 | 目视 |
| 115200 UART 频率控制（`F<数字>`、`M0`/`M1`） | 引脚已更正为 M11/T13 | 需要底板 USB-JTAG 口枚举成功后可用 |
| 设计已写入外部 SPI Flash，掉电与按 S4 重配置后自动加载 | 已实现 | 断电再上电应自动发声 |

上一版遗留的"虫鸣样底噪"已经用 S3 保持复位做过对照实验，确认它不来自 FPGA 产生的数字信号，属于供电、地环路或板级耦合方向，需要外部电源和示波器才能进一步定位。

## 二、零外设即可实施的 RTL 功能

排序原则是先满足评分公式里的"声部数乘采样率"，再做演奏表现，最后才是音色和效果的锦上添花。下面每一项都只用板载资源，改动集中在 `source/rtl/`。

### P0 四声部复音与混音

把当前单声部链路复制为四个独立声部，每个声部保留自己的 32 位相位累加器、插值查表和 ADSR，四路在 48 kHz 采样点上并行求和后做饱和裁剪。这是评分公式里权重最高的一项，也是赛题最低实现的硬门槛（≥4 声部、每声部独立相位与包络）。

实施要点是波表复用：四个声部共用同一块正弦表即可满足最低实现，音色区分放到后面。资源估算约 4 到 8 个 18×18 乘法器、1 到 2 块 BSRAM，远低于 GW2A-18 的 48 个乘法器和 46 块 BSRAM。验收方式是耳机里能同时听到四个音，频谱上能看到四个独立峰。

### P0 内置演示与测试模式

板载只有三个可用按键，不足以手动弹奏和弦，所以需要一段自动测试模式：上电或按键进入后，内部自动产生固定音高的多个声部和弦、琶音或扫频。它的价值有两层：一是答辩要求的现场证据（多频独立峰、实时生成而非回放），二是让没有触摸模块的现在就能演示复音效果。

实现上用一个小的状态机产生音符事件，接到声部分配器，与外部输入共用同一套事件接口，将来接上 MPR121 时不需要重写。

### P1 音色切换，两种以上波表

在 BSRAM 中再放一到两张单周期波表，例如方波、锯齿或三角，用按键或 UART 切换。单张 512 点 16 位表占一块 18 Kbit BSRAM，加到两到三张也在预算内。项目规则明确要求波表走 Gowin BSRAM ROM IP 或原语，不能用大 `case` 写成 LUT ROM。

### P1 每声部独立 ADSR

现在只有一个包络。复音之后每个声部各自持有起音、衰减、延音、释放参数，按键松开走释放段，这是赛题要求的"每声部独立包络"，同时给后面的演奏表现留出接口。

### P2 简单效果器

延迟和合唱用 BSRAM 环形缓冲就能做，性价比最高；混响代价偏大，放在最后。效果量可以用按键或 UART 控制，验收标准是能开能关、听感差异明显。

### P2 UART 控制接口扩展

把现有的 `F<频率>`、`M0`/`M1` 扩展成音符开关、声部数、音色、效果开关等命令。串口不通时这部分不影响主功能，通了就是方便的调试和演示手段。

### P3 TDM 32 声部引擎

32 声部不能按每声部两块 1024 点波表并行实现，那样需要 64 块 BSRAM，超过 GW2A-18 的 46 块上限。正确做法是时分复用：27 MHz 主时钟下，每声部每个采样点有 27 M ÷ 采样率 ÷ 32 个时钟周期可用，一个共享乘法器加一个调度器足够，波表也只放一份用多周期读。这一项在四声部验证通过、架构定型之后再动。

### 板载按键与 LED 当临时演奏界面

在触摸模块到货前，S1、S2、S3 三个按键可以作为临时输入：S1/S2 选音，S3 复位或作为切换键。S4 接的是 B10 的 RECONFIG_N，按下会触发 FPGA 重新配置，任何情况下都不能当普通按键。六个用户 LED（C13、A13、N16、N14、L14、L16）可以作为声部活动指示，让复音在视觉上也能看到。

## 三、实施前的资源预算

每次增加声部、波表或效果之前都要重算 BSRAM 和 18×18 乘法器数量，这张表是决策依据。

| 配置 | 波表 BSRAM | 18×18 乘法器 | 结论 |
| --- | --- | --- | --- |
| 单声部（当前） | 1 | 3 + 1 PADD18 | 实测 1259 LUT、429 寄存器，无时序违规 |
| 4 声部并行、共享一块波表 | 1～2 | 约 4～8 | 推荐的最低实现路径 |
| 8 声部并行 | 2～8 | 约 8～16 | 有余量，可作为中期目标 |
| 32 声部 TDM | 4 | 约 4～6 | 唯一可行的高声部方案 |
| 32 声部并行 | 64 | 远超上限 | 禁止，BSRAM 超过 46 块上限 |

## 四、现在做不了的部分

这些功能都依赖外接硬件，现阶段不安排编码，只做接口预留。

| 功能 | 缺什么 | 对应清单 |
| --- | --- | --- |
| 12 路电容触摸演奏 | MPR121 模块与触摸电极 | 可自购清单 A 组 |
| 力度与持续表情 | FSR 402 与 MCP3208 | 可自购清单 A 组 |
| 标准 I2S 到外接 DAC | PCM5102A 模块与 12.288 MHz 有源晶振 | 可自购清单 A 组 |
| 端到端延迟实测 | 双通道示波器或逻辑分析仪 | 需仪器清单 D-07 |
| 底噪的电源侧定位 | 独立可调电源与示波器 | 需仪器清单 D-01 |
| 引脚级时序与建立保持裕量 | 示波器或高速逻辑分析仪 | 需仪器清单 D-03 |

## 五、建议实施顺序与版本对应

| 顺序 | 内容 | 对应版本 | 零外设可完成 |
| --- | --- | --- | --- |
| 1 | 四声部复音与混音 | v0.5 | 是 |
| 2 | 内置演示与测试模式 | v0.5 附加 | 是 |
| 3 | 多音色切换与每声部 ADSR | v0.8 前半 | 是 |
| 4 | 简单效果器 | v0.8 后半 | 是 |
| 5 | UART 控制接口扩展 | v0.5 起随时 | 是（串口通了更好） |
| 6 | 触摸、力度、标准 I2S | v0.6、v0.7、v0.9 | 否，等外设 |
| 7 | TDM 32 声部引擎 | v1.0 前 | 是 |

顺序上不要把触摸插到复音前面。多声部决定整个架构，触摸只是往架构里送事件；先做触摸再改复音会把触摸逻辑推翻重写。

## 六、零成本的验证手段

没有仪器并不等于不能验证。板内 GAO 是 Gowin IDE 自带的逻辑分析仪，占用 FPGA 内部资源，通过 JTAG 就能抓 `sample_tick`、包络、各声部样本和 PT8211 的 BCK/WS/DIN 等内部信号，足以支撑数字侧的大部分调试，不需要外接逻辑分析仪。

听感验证直接用耳机插 3.5 mm 座。频谱证据可以把耳机输出接到电脑声卡的输入，用免费软件看多音峰，这需要一根 3.5 mm 双公头音频线；如果暂时没有，用手机录音再导入免费频谱 App 也能出图。综合与时序报告用 Gowin 的 `instrument.rpt.txt` 和资源报告，每次构建后归档对应哈希。

## 七、本次规划涉及的文件

三份清单都在 `docs/planning/` 下，文件名分别是本文件、《需外部仪器的调试任务清单-20261010.md》和《可自行购买外设与耗材清单-20261010.md》。已有的采购表格 `外设采购清单-20261010.xlsx` 保留不动，本文件与另外两份 md 是它的文字化补充和排序说明。
