Interstellar-530/PolyTouch-FPGA-Synth/evidence/2026/10/FPGA-S2-GPIO琴键与手动仲裁-20261014-v0.1.md

# FPGA：S2 GPIO 琴键与手动事件仲裁

本文件是 `8d0fa2f` 的首交付记录。随后复核发现 Gowin 源文件清单遗漏、`pop` 声明不兼容以及消抖期间 Panic 的起音边界问题，均已修补；最终状态和新增的满手动 FIFO 验证以 [S2 复核记录](FPGA-S2-复核-20261014-v0.1.md) 为准。以下原始门禁结果对应首交付版本。

2026-10-14 按《缺件期间仿真与算法任务》顺序执行第二项。S0、S1 已完成，本轮做 S2：新增 gpio_keyboard、手动来源 FIFO 与顶层模式仲裁，并补两台自检台。生产代码基线为 `b559237`（v1.01，原生音频验收与 Flash 基线），本轮改动在该提交之上，工作分支 `codex/s2-gpio-keyboard`，尚未合并回 main，也尚未烧录。代码中所有本轮新增段落都带 `[S2-AI]` 标记，便于其他智能体复查、审核和修补。

## 交付内容

新增 `source/rtl/audio/gpio_keyboard.v`：12 路独立输入的同步、消抖与音符事件生成。每路两级同步后独立消抖，默认按下 1 ms、松开 3 ms（27 MHz）；边沿只在消抖后的稳定值真正翻转时产生，因此按住不放不会重复起音。每路带一个 2 深度事件队列，同一个提交轮次内先送 Note Off 再送 Note On；下游未 ready 时事件留在队列里不丢。`flush` 用于 Panic 和模式切换，清空未发送事件并重新武装，已经按住的键必须松开再按才会重新起音。

新增 `source/sim/tb_gpio_keyboard.v` 与 `source/sim/tb_gpio_top.v`，并在 `sim/run_simulation.ps1` 中注册，门禁从十台增至十二台。既有三台顶层台（tb_poly、tb_mode_uart、tb_audio_capture）只补了新增端口 `gpio_key_n` 的连线，断言未改。

顶层把 GPIO 事件接到一个独立的 16 项手动 FIFO（复用既有的 `event_fifo`），再与 UART、演示曲事件汇合到同一仲裁器。仲裁优先级为：清理（Panic / 模式切换）> 首事件暂存 > UART > GPIO 手动 FIFO > 演示 FIFO。弹出条件与优先级一致，清理那一拍不消费事件，所以由 GPIO 触发的那次"退出演示"不会把触发它的事件一起丢掉。

## 验收结果

下表对照任务清单 S2 的自检标准，全部来自本轮门禁输出。

| 验收项 | 结果 |
| --- | --- |
| 12 路同步与消抖，短抖动不触发 | 8 次比按下门限短 2000 拍的抖动共 0 个事件；全部松开 20 万拍无事件 |
| 每次按/松只一事件 | 一次按下 1 个 Note On，按住 20 万拍仍为 1；一次松开 1 个 Note Off，之后不再重复 |
| 12 键同拍不丢事件 | 12 键同时按下得到 12 个 Note On、同时松开得到 12 个 Note Off，逐键核对无遗漏 |
| 背压突发不丢事件 | 下游停 81000 拍期间 4 键松开加 4 键按下全部保留，放行后先 4 个 Off 再 4 个 On；这一原测试没有把队列填满，满队列验收由复核新增测试补充 |
| Panic、模式切换优先 | X 命令按住键时清空全部声部且不重触发；D1 切回演示并清空手动声部；按住键只保持安静不重新起音 |
| 按住键不误重触发 | 手动模式、Panic 后、切回演示后三种情况下按住 10 万拍都没有新增 Note On |
| 数字响应有上界 | 单元台：引脚拉低到事件被接受 27002 拍，上界 27060；顶层台：引脚拉低到声部 gate 打开 27005 拍，上界 29000 |
| 既有功能不回归 | 十二台门禁全部通过，退出码 0；其中 tb_mode_uart 的 UART 优先级/演示重启/Panic/非法命令和 tb_poly 的复位/档位/按键显示断言未改且通过 |

## 接口改动记录

依据：S2 任务要求把 GPIO 琴键接入顶层并做顶层模式测试，硬件接线与引脚表已在 `docs/hardware/FPGA-硬件连接与演奏操作-20261013-v0.1.md` 第 4.1 节和 `docs/hardware/FPGA-pinplan-20261013-v0.1.csv` 中定稿。

影响范围：`top` 增加一个输入端口 `gpio_key_n[11:0]`，三个既有顶层测试台必须同步补连线才能编译；CST 增加 12 条引脚约束。音频数据通路（dds_osc、adsr、poly_voice、mixer、pt8211_tx、uart_ctrl）和曲目播放器没有改动。

设计取舍：顶层原先只有 UART 一个手动来源，靠一拍暂存处理"退出演示的第一个事件"。GPIO 是连续突发来源，直接复用那条单拍通路会撞车，所以改为给手动来源配独立 FIFO 并保留 ready 握手。演示模式下只接收按键（Note On）事件：进入演示时已经清空声部，此时的松键没有可关闭的音符，如果把它排进队列反而会挡住后面真正的按键事件，所以按设计丢弃，并已由顶层回归覆盖。

验证方式：十二台 Icarus Verilog 门禁（`source/sim/run_simulation.ps1`），退出码 0；再加 S1 的离线 PCM/FFT 分析确认音频无回归（见下一节）。

回退方式：本轮改动全部在工作分支上，且没有烧录。`git checkout main` 即可回到 v1.01 基线；CST 中的 12 条约束单独成段，删除该段即可回到不接 GPIO 的引脚状态。

## 未验证事项

仿真通过不等于实物验收。12 路按键的触点上拉、共地、长线串扰和实际去抖时间需要板子到货后按硬件文档实测；CST 新增引脚尚未做 Gowin 综合与布局布线复核，Bank 电压和引脚冲突要等 PnR 报告确认；本轮没有重新统计 BSRAM 与 18×18 乘法器占用，新增的是一个 16×16 事件 FIFO 和 12 路消抖计数器，预计主要落在寄存器和分布式 RAM，具体数字以 PnR 报告为准。弯音、压力、标准 I2S、双音色仍属后续任务，本轮没有触碰。

## 复现

```powershell
cd "E:\Working Space\FPGA\output\handoff_milestone2_20261008\source\sim"
powershell -NoProfile -ExecutionPolicy Bypass -File .\run_simulation.ps1
```

音频回归：

```powershell
cd "E:\Working Space\FPGA"
powershell -NoProfile -ExecutionPolicy Bypass -File .\tools\run_audio_verification.ps1 -OutputDir tmp\s2_audio_verify
```

注意：本机 Codex 的 Windows 沙箱（mxc 后端）会让 Icarus 的编译阶段以 `0xC0000005` 退出；即使留下可运行的 `.vvp`，也不能据此认定编译成功，门禁应继续拒绝非零退出码。相关排查见 `docs/logs/FPGA_DEBUG_LOG_20261014_SANDBOX_IVERILOG.md`，本机门禁在沙箱外执行。
