Interstellar-530/PolyTouch-FPGA-Synth/evidence/2026/10/FPGA-S2-复核-20261014-v0.1.md

# S2 复核记录（2026-10-14）

S2 数字验收通过：最终十二台 RTL 门禁、PCM/WAV/FFT 分析和 Gowin 综合/PnR 均退出 0。首交付基线为 `8d0fa2f`，复核修补在工作分支 `codex/s2-gpio-keyboard` 上，测试记录的 33 个输入文件 SHA256 与最终工作区逐项一致。生产 Flash 仍保持 v1.01；本次没有烧录。

首交付的不足集中在可构建性和 Panic 边界。Gowin 工程没有收录 `gpio_keyboard.v`，且该文件用连续赋值驱动 `reg pop`，综合会拒绝；已补齐新建和已有工程的源文件清单，并把 `pop` 改为 `wire`。各 always 过程的循环变量已分开。消抖完成前收到 flush 时，原代码会在之后持续按住期间补发 Note On；新增断言复现了这一失败，`suppress_on` 修补后通过，键松开再按可重新起音。上述修改保持现有模块端口和事件格式。

满队列验收补了两层：单键的 2 项队列满载后送达 1 个 Off 和 1 个 On，丢弃计数为零；顶层人为延长高优先级 UART 来源的占用，使手动 FIFO 装满 12 个 On 和 4 个 Off，再让 GPIO 暂存另外 4 个 Off。恢复仲裁后，20 个事件逐音高核对全部送达，满队列同拍读写得到覆盖。缓冲容量按键分配，同一键超过 2 个未发送边沿仍会丢弃；不能把合计 24 项容量当成任意事件分布都可使用的共享队列。

| 验收范围 | 已核对的证据 |
| --- | --- |
| 12 路同步、消抖、每次按松一个事件、短抖动过滤 | `tb_gpio_keyboard` 自检；默认 27000/81000 拍门限 |
| 四键和十二键同拍、背压及满队列 | 单元台十二键逐键检查、顶层四声部检查；新增单键满载和顶层 16+4 项测试 |
| Panic、模式切换、按住不重触发 | 原顶层 X/D1 回归，加消抖期间 flush 的失败/修复自检 |
| 数字响应 | 无背压且无高优先级来源阻塞时，单元 27002 拍、顶层 27005 拍；不宣称无限背压条件下仍有此上界 |
| 综合、布局布线 | Gowin V1.9.11.03 Education 退出 0；27 MHz 下 setup/hold 违例端点均为 0，Fmax 42.160 MHz |
| 资源 | BSRAM 4/46，DSP 6/24，MULT18X18 12，Logic 5202/20736，Register 1051/16173 |
| 完整门禁与音频 | 十二台门禁退出 0；真实捕获 58880 帧，PCM/WAV/FFT 分析退出 0；八个负面样例全部被拒绝 |

A4 以 32768 点真实串行样本估计为 439.9999746619 Hz，误差约 0.00002534 Hz。方法为 Hann FFT 主峰定位后对原样本作正弦/余弦/DC 最小二乘细化；原 FFT 频点间隔仍为 1.430511 Hz。四个不同基频在逐个松键后消失，全部释放及 M0 数字样本为零；频谱和释音图已视觉复核，原始捕获 SHA256 与 S2 首交付一致。这是模型中的数字频率验证，不测量实物晶振或模拟输出。

本机沙箱核对仍不通过：相同 `tb_adsr` 在默认沙箱中编译退出 `-1073741819`（`0xC0000005`），沙箱外编译退出 0，两次 `vvp` 自检均退出 0。当前配置为 `prefer_mxc = true`、`windows.sandbox = "elevated"`；[OpenAI 官方配置说明](https://learn.chatgpt.com/docs/config-file/config-basic)将这组设置定义为优先 MXC、保留 legacy elevated 回退。编译留下的文件可以运行并不足以证明异常编译成功，门禁保留非零退出码拒绝规则，本机使用沙箱外执行完成验证。全局配置没有修改。

证据目录为 [FPGA-S2-复核-20261014-v0.1](FPGA-S2-复核-20261014-v0.1/)，其中包括最终完整门禁、分析结果/反例自检、输入哈希、图表、定向顶层日志、沙箱内外对照、Gowin 构建、PnR 与时序报告。引脚表、CST、PnR 的 12 路 GPIO 逐项匹配，渲染 PNG 已视觉复核。暂停记录和主动中断的日志保留为历史检查点，不能用作最终门禁通过证据。

本地完整交付归档为 `archive/FPGA-20261014-v0.4`，包含源文件、复现说明、变更说明、原始捕获/PCM/WAV、未烧录候选位流、MANIFEST 和 SHA256；v0.3 保留首交付快照。源码和便于复查的证据进入 Git，原始捕获及大型候选位流按仓库既有规则保存在本地归档。

复现完整门禁与音频分析：

```powershell
cd "E:\Working Space\FPGA"
powershell -NoProfile -ExecutionPolicy Bypass -File .\tools\run_audio_verification.ps1 -OutputDir tmp\s2_review_reproduce
```

Gowin 构建：

```powershell
powershell -NoProfile -ExecutionPolicy Bypass -File .\output\handoff_milestone2_20261008\source\build\build.ps1 -GwSh "E:\Gowin\Gowin_V1.9.11.03_Education_x64\IDE\bin\gw_sh.exe"
```

软件通过仅覆盖数字逻辑和工具约束。实体按键接线、上拉、共地、长线串扰、实际去抖时间及板上 Bank 电压仍待实测；生成的 S2 位流属于未烧录的候选产物。回退可撤销本轮复核提交，再按需要切回 `main` 的 v1.01 基线。
