Interstellar-530/PolyTouch-FPGA-Synth/docs/README.md

# 文档目录

| 类别 | 内容 |
|---|---|
| [planning](planning/) | 项目规划、赛题和阶段任务 |
| [design/minimum_design](design/minimum_design/) | 最低设计、时钟、信号处理和模块接口 |
| [hardware](hardware/) | 采购、引脚、接线和搭建 |
| [guides](guides/README.md) | 当前构建、仿真、烧录与演奏入口 |
| [references](references/README.md) | 板卡资料、厂商手册和研究参考 |
| [reviews](reviews/) | 审核、资源分析和问题复盘 |
| [history](history/VERSIONS.md) | 日期版本、发布说明、日志与旧路径映射 |
| [exports/pdf](exports/pdf/) | 已导出的 PDF 成品 |

旧文档里的“当前”“本轮”以文档自身日期为准。当前工程与最近交付状态以根目录 README 为入口，验证结果以原始证据为准。
