Interstellar-530/PolyTouch-FPGA-Synth/evidence/README.md

# 验证证据

按年/月归类，目录或文件名保留原日期与主题。仿真、构建、烧录收据、原始日志、指标和关键截图保持原字节；内部旧绝对路径不重写，使用[路径映射](../docs/history/PATHS.md)追溯。

2026-11-01 整理记录位于 [FPGA-20261101-reorganization-v0.1](2026/11/FPGA-20261101-reorganization-v0.1/README.md)。历史失败、未运行和待现场确认的内容沿用原结论。本次分类不新增历史功能验收结果。
