Interstellar-530/PolyTouch-FPGA-Synth/media/README.md

# 媒体与试听

`previews/20261008` 保留旧交接包已入库的试听文件。`previews/undated` 保存原本未入库的过程试听、曲谱截图及捕获数据，文件名中的版本后缀保持不变。未确认产出日期的资料不根据文件修改时间补造日期。

这些素材用于研究、试听和演示，不能替代 RTL 或板级验证证据。曲谱、采样与参考音频沿用原来源及许可；发布或对外分发前仍需核对对应权利。
