Interstellar-530/PolyTouch-FPGA-Synth/evidence/2026/10/FPGA-接线复核-20261018-v0.1/README.md

# 接线复核证据

基线 ff2c7d6；未修改 RTL，未连接仪器，未烧录。标准档21路及调试档16路与当前约束对应。
PDF 12页，17项关键内容检查、文本边界检查通过；已逐页视觉检查。
源图已按项目流程先转换为Markdown，再检查保留的PNG。
用户最终确认有DAC；正面照片确认为PCM5102A、左列十一孔。D-56-05-08属于所述DAC标注。
今天使用板载27MHz与PT8211的debug接线；压力仅验证采样，默认不调音量。
未确认项为晶振完整参数/转接PCB、DAC电源/背面焊桥、P15W模拟输入与实际负载。
所有检查均为图纸、源码、照片和文档检查，不代表物理电压/连通/音频验收。
