Interstellar-530/PolyTouch-FPGA-Synth/evidence/2026/10/teammate-simulation/README.md

# Teammate simulation evidence

Generated 2026-10-13 Asia/Shanghai from GitHub `main@55528a1b7999ee5e0c7a21b04ebd2d3a1fdda62b`.

The original checkout at `D:\NanjingUniversity\FPGA\PolyTouch-FPGA-Synth` was clean and was not overwritten. This simulation copy started from local `fix/m2-build-issues@3a31eb2` and overlaid the remote `output/handoff_milestone2_20261008/source/rtl` and `source/sim` files needed by the gate.

Icarus Verilog was installed from the official MSYS2 UCRT64 package `mingw-w64-ucrt-x86_64-iverilog 1~13.0-2`, with VVP from the same installation. The gate was run by Windows PowerShell 5.1 with explicit `-Iverilog` and `-Vvp` paths.

`baseline-gate-20261013.log` records all nine tests. `baseline-exit-code.txt` records exit code 0. Generated `.vvp` files were removed after the run.
