Interstellar-530/PolyTouch-FPGA-Synth/releases/2026/10/FPGA-20261014-v0.3/README.md

# 20261014 / origin/codex/s3-i2s-tx

来源、范围和校验见 [归档说明](catalog/README.md)。源码快照位于 source/original-tree；原交付包若存在则保存在 original-delivery 中。
