Interstellar-530/PolyTouch-FPGA-Synth/releases/2026/10/FPGA-20261030-v0.1/README.md

# 20261030 / final-20261030

来源、范围和校验见 [归档说明](catalog/README.md)。源码快照位于 source/original-tree；原交付包若存在则保存在 original-delivery 中。
