Interstellar-530/PolyTouch-FPGA-Synth/evidence/2026/10/FPGA-keyboard-pause-20261026-v0.1/README.md

# F8 暂停/播放轻量检查

按用户要求跳过复杂门禁，只运行 tb_top_host_pause，一项通过，17.52 秒。check/gate-result.json 保存输入 SHA256、真实退出码与测试结果；snapshot.json 记录 93072c1 基线和本次六文件覆盖。未运行 Quick/Full，未重建或烧录。

测试使用真实 27MHz/115200、standard27 音频路径；只缩短测试曲节拍，检查暂停进度不变、重复上报不重切、I2S 时钟连续、数字静音和恢复音频，以及 F7/手动模式兼容。模拟输出与实物键盘操作未验收。
