Interstellar-530/PolyTouch-FPGA-Synth/evidence/2026/10/FPGA-standard27-board-20261024-v0.1/README.md

# 2026-10-24：串口演奏、FSR/弯音、外接 PCM5102A

用户确认 CH9350L 尚未到货，保留原电脑串口控制；FSR、电位器与 MCP3208 已按接线方案连接。本次未改 RTL、接口或外设映射，使用当前源码构建 `standard27 / IdleOnly`，只写 SRAM，不改外部 Flash。板载 27MHz，8 声部，24bit I2S、32bit 声道时隙、每帧 64 BCK；目标 BCK 3MHz、LRCK 46.875kHz，尚无仪器实测这些引脚。

## 板上版本与构建

烧录前 JTAG 读到 GW2A-18C，ID `0x0000081B`、User Code `0x00003F62`。该标识与 10/20 `debug8` 构建产物一致，其 SHA256 为 `2F8DB574A2ECABE2E71A8B6A8DA32CDAF2EF993F9198AB120CAA15B35DFC8606`。短 User Code 不是完整位流读回校验。

新位流由 Gowin V1.9.11.03 Education 构建，User Code `0x0000BF87`，SHA256 `8f70f54bb4cb95b68aeb41ca8180283ebaa33b21b282d88165867af2239723af`。资源 Logic 11499/20736、Register 3691/16173、BSRAM 27/46，DSP 为 1×MULT18X18、1×MULT9X9、1×MULTALU36X18。27MHz 约束下 Fmax 36.231MHz，建立/保持违例端点均为零。编译存在既有位宽截断及根作用域声明警告，未宣称零警告。

## 验证与烧录

Quick 12 个正向测试和 6 个非法参数负例共 18 项通过；烧录脚本又独立运行同一 Quick，全部通过后才调用烧录器。曲目时序与背压两个专项通过。首次沙箱内 Icarus 编译失败，保留原始失败证据；沙箱外重跑通过，未使用 SkipSimulation。

2026-10-24 14:48（Asia/Shanghai），`program_sram.ps1 -Profile standard27 -HostTimeoutPolicy IdleOnly` 执行操作 2，烧录器进度 100%、打印 Finished、退出 0。独立 JTAG 再读到 User Code `0x0000BF87`。这是配置标识核对，未执行已知不兼容的操作 4 SRAM Verify。

14:49 经 COM13、115200/8N1 顺序发送 16 条命令，全部回复 OK：`M0 D0 X V50 I0 N60 O60 N64 O64 I1 N67 O67 X I0 D1 M1`。COM13 已关闭释放给原电脑演奏界面。当时状态为 I0 分支、V50、演示 D1、解除静音 M1；这些应答证明协议控制可用，不代表模拟输出已测得。源码中 I0 只选择非吉他分支，采样钢琴还要求 T250..T255；默认 T64 为通用波表混合音色。

## 现场操作与边界

音频出口改为 B12→DAC BCK、C12→LCK、B13→DIN，Dock 板载 PT8211 耳机口不输出本档音频。T7 留空；按接线方案确认模块 XMT 高、FMT/SCL 低及共地。CJMCU 3.5mm 是 LINE OUT，需用线路输入/耳放或高阻仪器验收。

原串口演奏接口保留，无需 CH9350L。MCP3208 CH0 是 FSR，手动演奏时调全局增益；默认参数的最低压力增益约为满增益四分之一，不应当用松开 FSR 代替静音。CH1 是弯音，中心 ADC 码 2048，范围约 ±2 半音。演示曲绕过压力增益，但弯音仍进入音高计算。要检查 FSR，打开原串口演奏界面并持键；若手工发命令，可逐条发 `D0`、`M1`、`V50`、`I0`、`N60`，测试后 `O60`，恢复演示用 `D1`。旋钮中位需实物校准。

默认上电演示采用当前源码的《晚夜微雨问海棠》测试曲；发送 N/O/X 或 D0 转入手动，D1 重启演示。S1 短按切伴奏、长按切音色，S2 切速度，S3 复位演奏逻辑。S3 会恢复默认主音量 100；它不是 SRAM 重配置。断电或按 S4 会恢复旧 Flash 配置，需重新下载本次 SRAM 位流。

尚未实测 DAC 模拟输出、I2S 电气波形、ADC 实际码值、FSR/旋钮的响应与听感；CH9350L 未接。未宣称外设整机验收通过。

## 归档与复现

归档为 `archive/FPGA-20261024-v0.2`，包括精确源码、位流、原始日志、构建收据、报告、复现脚本与 SHA256。独立核对了归档的 192 个构建输入与本次收据一致。证据入口为 `docs/evidence/FPGA-standard27-board-20261024-v0.1`。`reproduce.ps1` 默认只仿真和构建，加 `-Program` 才写 SRAM；`verify_uart.ps1` 会发送控制命令并最终恢复 V50/D1/M1。

本次仿真临时目录与复制进归档的 Python 缓存按明确路径清理，目标记录在证据中的 `cleanup-targets.txt`。当前成功生产构建目录保留，因为构建收据直接引用其中位流与生成包装器；Gowin、Icarus 和项目工具环境属于运行时依赖，保留。

## 14:52 后续：用户仍只听到低频电噪声

用户反馈无音频，仍用耳机直接接 CJMCU LINE OUT。用户说明 VCC 未接、3.3V 及其他控制线已按方案连接，未处理背面焊桥，没有可用测量仪器或线路输入音箱/耳放。供电网络和模式脚的实际电压仍未核实，不能直接判定硬件损坏或把 VCC 改接 5V。

再次 JTAG 读到 `0x0000BF87`。14:52 经 COM13 发送 `M0 D0 X I0 T0 V50 N69 M1`，8 条命令全部 OK。**这覆盖此前的最终演示状态：现在是手动持续正弦单音，主音量 50，目标音符 A4；实际音高受电位器弯音影响，实际增益受 FSR 影响。** 关闭串口后命令状态保留；O69 或 X 松键，D1 恢复演示，I0 加 T250 可恢复采样钢琴设置。未再次烧录。

新增独立自检台 `archive/FPGA-20261024-v0.2/validation/tb_standard27_serial_audio.v`，生产 RTL 未改。直接实例化实际 `top_std27_build`，CH9350L 输入固定空闲高电平，以真实 115200 串口时序和 MCP3208 器件模型，重新解码 I2S 引脚。2346 帧通过：BCK 每 9 主时钟、LRCK 每 576 主时钟、左右声道一致、无 X、XSMT 高；V50 单音的 24bit 峰值为 185472，压力低时为 39110；旋钮弯音和 M0 精确静音/M1 恢复断言通过。峰值取不同时间窗且带包络变化，只说明该模型下存在非零数据与压力响应，不是实物电压或固定增益比测量。

下一步需要用户提供当前模块正反面清晰照片及排针连接，辨认稳压器型号、3.3V/VCC 网络和控制脚焊桥；尚未定位实物无声原因。后续确认电源与模式脚后，应使用线路输入负载或仪器继续验收。单凭目前的耳机电噪声不能分辨负载、供电、接触、DAC 模式与实际 I2S 电气信号问题。
