Interstellar-530/PolyTouch-FPGA-Synth/evidence/2026/10/FPGA-优化01审核-20261021-v0.1/README.md

# 力度边界优化审核证据

本轮确认效果后即停止扩测。没有修改生产代码、原测试、约束、配置或硬件。结论见 `docs/reviews/FPGA-力度边界优化效果审核-20261021-v0.1.md`。

`review_results.json` 记录审阅引擎 SHA256、命令退出码、旧版预期失败、已知旧失败以及构建内容匹配。`independent_equivalence.log` 是独立新旧引擎对照：768 帧、2304 组有符号分量和，检查四/八声部、不同精度和乘法器配置、音色模式及帧内输入变化。`source/` 保存该测试及由基线原样改模块名得到的参考引擎；参考引擎输入使用已知合法力度，不由待测输出反推结果。

`before_bounds.log` 的退出码 1 是旧缺陷的预期复现。三个旧测试的 before/after 退出码 1 同样只用于确认失败在本次修改之前已存在，不应解读为完整回归通过。有效正向结果来自边界台、键控增益台、帧力度台和独立对照台。

`commands/review_velocity.py` 是本轮可复现脚本，Icarus 位于 `C:\iverilog\bin`；需要完整项目和 Git 基线 `2d3db6c`，只使用 Python 标准库。Windows 当前沙箱会使 Icarus 编译崩溃，本轮在已授权的沙箱外执行。完整门禁和硬件验证均未运行，PnR 数字来自本地已完成且输入内容匹配的构建，未重复构建。
