Interstellar-530/PolyTouch-FPGA-Synth/releases/2026/10/FPGA-20261010-v0.7/catalog/README.md

# 20261010 / v0.5.5-20261010

归档编号：FPGA-20261010-v0.7。原版本名：`v0.5.5-20261010`。

来源提交：`b9a52e44c48c8e1445c25ec928798f5c8adce21e`；提交时间：2026-10-10T17:56:13+08:00（按北京时间归类）。

`source/original-tree/` 为标签提交中原生产源码的逐字节快照，保持原目录内部结构。既有交付文件保留原字节；旧绝对路径通过仓库路径映射追溯。

本次只验证保存完整性，不新增历史仿真、构建或硬件通过结论。
