Interstellar-530/PolyTouch-FPGA-Synth/releases/2026/10/FPGA-20261010-v0.7/evidence/README.md

# 验证依据

见 [证据说明](../catalog/evidence.md)。本次保存检查不代表重新验证该历史版本。原交付包的原始证据位于 original-delivery 内（若存在）。
