Interstellar-530/PolyTouch-FPGA-Synth/releases/2026/10/FPGA-20261013-v0.1/target/README.md

# 目标产物

原位流保存在本目录或 original-delivery，来源与校验以原交付清单为准。
