Interstellar-530/PolyTouch-FPGA-Synth/releases/2026/10/FPGA-20261014-v0.3/catalog/README.md

# 20261014 / 阶段快照

来源 `origin/codex/s3-i2s-tx`，提交 `17aff2da4a0b9d912bb24dccea8e4b98efe3fb09`，时间 2026-10-14T20:45:00+08:00。此阶段已在最终基线的历史中，按日期独立保存供查阅，不表示新增正式发布或硬件验收。
