Interstellar-530/PolyTouch-FPGA-Synth/releases/2026/10/FPGA-20261016-v0.1/catalog/README.md

# 20261016 / 阶段快照

来源 `origin/codex/s4-s6-integration`，提交 `40ef0128dadffdcbae221b79e7ee1bac11cf9ef0`，时间 2026-10-16T00:29:54+08:00。此阶段已在最终基线的历史中，按日期独立保存供查阅，不表示新增正式发布或硬件验收。
