Interstellar-530/PolyTouch-FPGA-Synth/releases/2026/10/FPGA-20261021-v0.3/catalog/README.md

# 20261021 / 阶段快照

来源 `origin/codex/v2-gate-fix-20261021`，提交 `f7052fbe951e56d9839e179d14682c28ce714b05`，时间 2026-10-21T20:31:29+08:00。此阶段已在最终基线的历史中，按日期独立保存供查阅，不表示新增正式发布或硬件验收。
