Interstellar-530/PolyTouch-FPGA-Synth/releases/2026/10/FPGA-20261027-v0.1/catalog/README.md

# 20261027 / 阶段快照

来源 `origin/codex/hdmi-dashboard-20261025`，提交 `a234c70c9a809f3d12cd00fc9cfb6b304224df33`，时间 2026-10-27T23:08:10+08:00。此阶段已在最终基线的历史中，按日期独立保存供查阅，不表示新增正式发布或硬件验收。
