Interstellar-530/PolyTouch-FPGA-Synth/releases/2026/10/FPGA-20261029-v0.1/catalog/README.md

# 20261029 / v1.0-final-20261029

归档编号：FPGA-20261029-v0.1。原版本名：`v1.0-final-20261029`。

来源提交：`e8450a5b4db3095fec2a6ee0a5cb739e4ce0c43a`；提交时间：2026-10-29T20:21:10+08:00（按北京时间归类）。

`source/original-tree/` 为标签提交中原生产源码的逐字节快照，保持原目录内部结构。既有交付文件保留原字节；旧绝对路径通过仓库路径映射追溯。

本次只验证保存完整性，不新增历史仿真、构建或硬件通过结论。
