Interstellar-530/PolyTouch-FPGA-Synth/releases/2026/10/FPGA-20261030-v0.1/catalog/README.md

# 20261030 / final-20261030

归档编号：FPGA-20261030-v0.1。原版本名：`final-20261030`。

来源提交：`efd76ea14bab93521604819756410898eb0bc8af`；提交时间：2026-10-30T17:35:39+08:00（按北京时间归类）。

`source/original-tree/` 为标签提交中原生产源码的逐字节快照，保持原目录内部结构。既有交付文件保留原字节；旧绝对路径通过仓库路径映射追溯。

本次只验证保存完整性，不新增历史仿真、构建或硬件通过结论。
