Interstellar-530/PolyTouch-FPGA-Synth/docs/design/minimum_design/02_信号生成与处理.md

# 信号生成与处理

## 1. 模块目标

在 48 kHz 采样率下实现 4 个独立声部的实时波表合成，每个声部包含独立 32 位相位累加器、12 位半音频率控制、16 位 ADSR 包络和 16×16 幅度乘法。支持两种单周期音色切换，支持实时变调和按键触发，不播放任何预录 PCM。

## 2. 算法逻辑

音高使用 DDS 相位累加器：`phase[n+1] = phase[n] + phase_inc`，`phase_inc = round(f_note × 2^32 / 48000)`。A4 = 440 Hz 时约为 39,370,533。音名到频率字不建立 128 项大表，而是保存 12 个半音的 32 位频率字，再根据八度选择左移或右移，减少 LUT 和 BSRAM 消耗。

波表采用每个声部一个 1K×18 BSRAM 块，里面装两个 512×16 单周期表：表 A 为正弦/长笛类，表 B 为风琴/弦乐类。相位高 9 位选择 512 点地址，最高位选择音色。一个块刚好容纳两张表，4 个声部占用 4 块 BSRAM。波形必须是数学生成的单周期数据，不能用歌曲、采样或整段录音。

ADSR 用 16 位幅度寄存器和 IDLE、ATTACK、DECAY、SUSTAIN、RELEASE 五态机。每个 48 kHz 样本更新一次包络，攻击、衰减、释放步进从 8～16 个预设值中选择，实时路径不做除法。最低实现建议默认值为 Attack 10 ms、Decay 120 ms、Sustain 70%、Release 250 ms；NOTE_ON 时压力值决定包络峰值，持续压力通过总增益或音色混合影响表情。

4 个声部的 16 位波形乘以 16 位 Q0.16 增益，得到 32 位有符号乘积。4 路相加使用 34 位累加器，按活跃声部数做 2 的幂归一化：1 声部不移，2 声部右移 1 位，4 声部右移 2 位，再加上 Q0.16 的 16 位小数移位，最后做饱和裁剪。测试模式绕过传感器，自动开启 4 个固定频率声部，用于频谱和 RTL 验证。

## 3. 例程参考

Sipeed 官方 `PT8211/src/top.v` 给出单声部 DDS、ROM 查表和 DAC 驱动的完整参考；`rom_wave_sine.v` 可作为 ROM 初始化和查表接口的起点；`pt8211_drive.v` 可作为逐样本串行输出和 `req` 请求信号的参考。高云 SUG284 说明 IP Core Generator 中 ROM 的生成方式，UG285 说明 BSRAM 的 18 Kbit 块和读写模式，SUG949 说明 HDL 编码风格。PCM5102A 数据手册用于确认 16/24/32 位数据和采样率范围。

## 4. 函数解释

建议综合函数包括：`note_phase_inc(semitone, octave)` 返回 32 位频率字；`sat16(x)` 把 32 位有符号结果裁到 16 位；`mix_add(a,b)` 做扩展位宽相加；`env_next(env, step, up, sustain)` 做包络饱和步进；`mix_shift(active_voices)` 返回 0～2 的归一化移位数；`i2s_slot(sample24)` 生成 32 位 I2S 槽数据。模块上建议分为 `voice`、`wavetable_rom`、`adsr`、`mixer`、`master_gain` 和 `i2s_tx`。波表 ROM 用 Gowin IP Core Generator 生成，提交生成的 `.v`、`.ipc` 和 `.mi`，不要用 Verilog `case` 写成大 LUT。

## 5. 后续优化方向

把 `VOICE_COUNT` 从 4 改成 8 只需要增加 4 个波表块和 4 个乘法器，是最自然的第一步升级。32 声部版本必须限制为每声部一个 BSRAM 块、一个 18×18 乘法器、两个 512 点表，不做线性插值和逐声部滤波；否则 32 个 1024 点双音色表需要 64 块 BSRAM，超过 GW2A-18 的 46 块。更进一步可以改成 4 个共享 BSRAM bank 的 TDM 波表读取，把 32 声部的波表块压到 4 块，用 4～8 个乘法器分时完成幅度运算。双操作 FM 可以作为另一条扩展路线，16 声部 × 2 操作 = 32 个振荡器，正好用满约 32 个乘法器。共享延迟/合唱放在混音总线后，1～4 块 BSRAM、1～2 个乘法器；逐声部混响和并行 FFT 不进入最低实现。

## 6. 最小验收

测试模式下 4 个不同频率同时发声，频谱能观察到 4 个独立基频峰；A4 实测误差在 ±1 Hz 内；ADSR 起音和释音可听；最大 4 声部满幅时无回绕失真；RTL 中每个声部都有独立相位累加器、频率寄存器和包络状态，可以从代码层面证明没有播放预录 PCM。

## 7. 合规性与资源预算

波表只保存一个周期的数学采样值，例如 `sin(2πn/512)` 或有限谐波叠加；ROM 中不存歌曲、整段录音或长时间 PCM。音高完全由每个声部的相位步进实时决定，起音、释音、混音和 I2S 输出都是逐样本计算。现场测试模式同时开启 4 个固定频率声部，频谱出现 4 个独立基频峰，即可作为“多振荡器并发”的证据。

4 声部最低实现中，频率表 12×32 bit = 384 bit，ADSR 速率表 16×16 bit = 256 bit，这两张表用 LUT/分布式 RAM 即可，不占 BSRAM。4 个波表块使用 1K×18 模式，每块装两个 512×16 表；若 Gowin IP 生成器要求每个 512 点表单独占一块，则 4 声部用 8 块，仍然远低于 46 块上限。4 个声部乘法器加 1 个总增益乘法器共 5 个，剩余 43 个乘法器留作后续效果器和 32 声部扩展。
