Interstellar-530/PolyTouch-FPGA-Synth/docs/design/minimum_design/05_第二轮复查与补充.md

# 第二轮复查与补充

## 1. 复查方法

第一轮文档完成后，按“项目负责人 + FPGA 实现者 + 硬件联调者”三种角色重新审阅，重点检查四件事：最低实现是否真的满足赛题硬指标；每个模块是否都包含算法逻辑、例程参考、函数解释和后续优化；所有算法是否能在 GW2A-18 的 LUT、FF、BSRAM、DSP、GCLK 和 I/O Bank 约束下落板；3714 版本的引脚和电源是否有未确认项。

## 2. 发现的遗漏

| 遗漏项 | 风险 | 补充位置 |
| --- | --- | --- |
| 4 声部没有明确的 LUT/FF/BSRAM/DSP 预算表 | 无法判断最低实现是否有余量 | `00_总览与最小实现边界.md` 第 7 节 |
| 没有逐环节端到端延迟表 | 无法证明 ≤10 ms | `00_总览与最小实现边界.md` 第 7 节 |
| 3714 PMOD 是否引出 GCLK 脚没有落地核查步骤 | 外部 12.288 MHz 可能接不进 FPGA | `01_时钟配置.md` 第 7 节 |
| 没有说明 Gowin IP 生成器可能按每表一块 BSRAM 处理 | 4 声部资源估算可能偏乐观 | `02_信号生成与处理.md` 第 7 节 |
| 没有说明 12×32 频率表和 16×16 包络表不占 BSRAM | 资源估算不完整 | `02_信号生成与处理.md` 第 7 节 |
| 没有给出禁止预录 PCM 的证明方式 | 现场验证可能被质疑 | `02_信号生成与处理.md` 第 7 节 |
| 没有列出最少 testbench 清单 | 初学者容易直接上板硬调 | `03_模块间信息传递.md` 第 7 节 |
| 没有给出 IRQ 到 I2S 的实测方法 | 延迟只能停留在估算 | `03_模块间信息传递.md` 第 7 节 |
| PCM5102A 模块 FMT/FLT/DEMP/XSMT 和电源没有配置说明 | 可能不发声或上电爆音 | `04_硬件控制信号.md` 第 7 节 |
| 12.288 MHz 晶振的串联电阻和去耦没有说明 | 时钟过冲或抖动 | `04_硬件控制信号.md` 第 7 节 |
| 没有明确 RTL、PC 脚本、Gowin、BL702 的边界 | 容易把 MCU 放进音频路径 | `00_总览与最小实现边界.md` 第 6 节 |

## 3. 算法逻辑复查结论

最低实现的算法链已经收敛为 4 声部 DDS 波表 + 16 位 ADSR + 4 路饱和混音 + 标准 I2S。4 个声部用 4 个 1K×18 BSRAM 块，每块装两个 512×16 单周期表；如果 IP 生成器按每表一块，则用 8 块，仍然只占 GW2A-18 的 46 块中的一小部分。4 个声部乘法器加 1 个总增益乘法器共 5 个，远低于 48 个上限。逐声部滤波、逐声部插值、逐声部混响和并行 FFT 全部排除在最低实现之外，避免出现“代码结构漂亮但资源超限”的方案。

## 4. 例程参考复查结论

主参考仍是 Sipeed `TangPrimer-20K-example` 的 `PT8211`、`UART`、`Lite-bottom_test_project` 和 Dock 引脚约束；高云官方文档覆盖时钟、BSRAM、IP 生成、CST、SDC、HDL 风格和云源软件；器件资料覆盖 PCM5102A、PT8211、MPR121 和 MCP3208。Dock 3714 的原理图页面和 3714 版本说明作为板级依据；3709 点位图只作为参考，不能替代 3714 实物核对。

## 5. 函数解释复查结论

所有建议函数都保持纯组合、无浮点、无除法、无大循环：`sat16/sat24` 做饱和，`mix_add` 做扩展位宽相加，`note_phase_inc` 用 12 个半音频率字加八度移位，`env_next` 做包络饱和步进，`iir_update` 做压力平滑，`clk_ce` 做采样使能，`sync2/edge_det` 做异步输入同步和边沿检测，`voice_alloc` 做声部选择，`i2s_slot` 做 24 位槽数据。波表 ROM 必须用 Gowin IP Core Generator 或 BSRAM 原语生成，不能用大 `case` 写成 LUT ROM。

## 6. 后续优化复查结论

优化顺序固定为：4 声部最低实现 → 8 声部 → 共享 4 bank 的 32 声部 TDM → 共享延迟/合唱 → 双操作 FM/MIDI/可视化。32 声部如果按每声部两个 1024 点波表并行实现，需要 64 块 BSRAM，超过 46 块上限；32 声部必须使用每声部一个 1K×18 块装两个 512 点表，或改用共享 BSRAM 的 TDM。逐声部效果器和并行 FFT 在 32 声部配置下不进入优化路线，除非显著降低声部数或引入 DDR3 控制器。

## 7. 仍未闭合的板级事项

第一，必须用 3714 实物加原理图确认 4 个 PMOD 是否引出空闲的 3.3 V GCLK 脚；这决定外部 12.288 MHz 能否直接进入 FPGA。第二，必须确认 MPR121 模块是否已经带 I2C 上拉，避免重复上拉。第三，必须确认 PCM5102A 模块的 FMT/FLT/DEMP/XSMT 跳线和逻辑电平。第四，必须确认板卡 1 号拨码使能状态和 3714 的 SW0/KEY4 交换不会影响上电模式。上述四项在实物到手后按 `04_硬件控制信号.md` 的验收清单逐项打勾，第二版设计即作为完整产物冻结。

第二版包含第一轮全部内容以及本文件列出的补充，后续如无新的板级实测数据，不再改动最低实现边界；8 声部和 32 声部只作为参数化升级路线保留。
