Interstellar-530/PolyTouch-FPGA-Synth/docs/handoff/FPGA-无硬件优化-A音频线提示词-20261024-v0.1.md

# A 音频线执行提示词

你负责本项目无硬件优化的 A 线。先阅读 `docs/planning/FPGA-无硬件双人并行优化清单-20261024-v0.1.md` 和适用 AGENTS。当前只能使用电脑，没有电表、示波器或实体音频/显示验证条件。不要安排烧录、立体声或可视化作为验收前置。

先确认共同基线包含 2026-10-23 v0.8 核心修复。当前 HEAD 67a9aaf 本身不包含全部未提交修复，禁止忽略 dirty 内容直接开旧基线开发。与队友先冻结现有 cfg 接口、bank 编码、时钟和控制语义，然后执行 A1 定点与混音、A2 波表与高音质量、A3 去爆音。完整计划中的 A4 由你收口。

你拥有 `instrument_ram_wavetable_engine.v`、`instrument_ram_audio_compute.v`、`instrument_rom_banks.v`、`wide_master.v`、波表 HEX、厂商 ROM 初始化、元数据及生成器。队友拥有 `voice_sched32.v`、`ram32_control_front.v`、`pressure_bend.v`、`bend_ratio_pipeline.v` 和新增 control_ext 模块；这些文件对你只读。用稳定的配置事务驱动器开发，不等待队友新版本。新增测试与脚本分别放 `S/sim/opt_a/`、`tools/offline_opt/a/`，证据放 `evidence/2026/10/offline-opt/A/`，临时内容放 `tmp/offline-opt-a/`。

修改前说明依据、范围、验证和回退。先分析现有算术，不重复已完成的流水优化；等价改动逐样本一致，有意改变数值先定义误差界。A2 保持 12/30 物理表的当前 bank 编号，表值、HEX、厂商初始化和元数据同时交付。禁止未经协商改变公共接口/布局。无硬件时不宣称 FSR 标定、模拟音质或整机延迟通过。

沿用 73.728MHz/48kHz、1536 拍/帧和 32 声部。不增加声部、DDR3 音频或软核。新增资源先计算 BSRAM/18×18 等效乘法器，再以 Gowin 映射复核。基线已有帧尾617、BSRAM26/46和Fmax75.564MHz的归档证据，当前工作须为新组合另留记录。

交付每项代码、独立参考、带 `$fatal` 的短自检、一个复现命令和真实结果。你独占顶层、build、constraints、公共测试注册表的修改权；合入队友模块后统一登记，再执行 Quick、Ram32 和变化专项。暂不实施立体声/显示。结尾说明完成内容、证据、清理和待验证项，按项目规则归档及生成 SHA256。
