Interstellar-530/PolyTouch-FPGA-Synth/docs/planning/FPGA-S3-标准I2S与统一时钟参数方案-20261014-v0.2.md

# S3 实施任务书：标准 I2S、独立接收模型与时钟参数

2026-10-14，评审修订 v0.2。评审角色：FPGA 音频接口与验证工程师。结论是方案可实施，按本文修订后的边界编码，预计 5–7 人时。本文完成了资料、参数和实施边界复核，尚未实现 S3 RTL，也没有 S3 仿真、综合或实机通过结论。桌面原文件名中的 v0.1 保留，正文以本版 v0.2 为准。

核实的工作基线为 `codex/s2-gpio-keyboard`、提交 `dd43257`；生产发布基线为 `b559237`（v1.01）。S2 归档为 `archive/FPGA-20261014-v0.4`。本次方案评审归档为 `archive/FPGA-20261014-v0.5`，这个目录已经用于文档评审，后续 S3 实现应选当日下一个未占用版本，不覆盖它。原文中的“待确认”是旧方案状态；本文件是可交给 DeepSeek 的编码任务书，不表示当前评审已经执行其中的代码、烧录或系统迁移任务。

## 1. 目标、排期与交付边界

本轮交付可复用的 `i2s_tx`、仅从外部引脚解码的接收模型、两档时钟参数、16/24 位自检和门禁接入。保持现有 PT8211 顶层音频路径。正式接入 12.288 MHz、修改顶层/CST/SDC、迁移合成链采样率与上板验收，属于后续 T04 集成工作，需要单独授权。

排期采用 `docs/planning/FPGA-缺件期间仿真与算法任务-20261013-v0.1.md` 和 `docs/reviews/FPGA-20261013-v0.6/FPGA-竞赛差距与执行计划-20261013-v0.2.md`，优先于主规划的早期周表。建议在 10/15 前交 S3 数字模块与日志，10/17 前具备组装所需候选和回退包，10/18 共同组装；10/25 停止新增功能，10/28 制作验收与冻结，10/29–11/04 留给材料。S3 的 5–7 人时计入 T04 的 12 人时预算，余量用于正式时钟迁移、引脚核对与 DAC 联调，不另加一份开发预算。缺件时先完成数字交付，实机项保持待测。[官方竞赛页](https://www.gowinsemi.com.cn/university/match2026)当前给出的提交截止为 2026-11-04 18:00。

赛题要求 I2S 至 DAC、纯 HDL 逐样本合成、至少四声部和总延迟 ≤10 ms；48 kHz 与最终 24 位有效数据是本项目的设计目标，不能写成赛题额外规定。S3 模块通过只证明数字接口正确，不能替代实体输入、四声部频谱或控制到模拟输出的整机验收。本轮默认输入仍为 16 位，同时验证 24 位序列化能力；16 位输入补零扩成 24 位不会增加音频有效精度。

| 项目 | 本轮约定 |
| --- | --- |
| 实际源码根 | `source/`，下文 `rtl/`、`sim/`、`build/` 均相对该目录 |
| RTL | 新增 `rtl/audio/clk_params.vh`、`rtl/audio/i2s_tx.v` |
| 仿真 | 新增 `sim/i2s_rx_model.v`、`sim/tb_i2s_tx.v`，必要的参数负例驱动与运行脚本 |
| 现有文件修改 | 门禁脚本、Gowin 源文件登记和 `rtl/README.md`；不改既有 RTL 行为 |
| 本轮不执行 | 系统时钟切换、顶层接线、CST/生产 SDC、声部/波表/效果扩展、SRAM/Flash 烧录 |
| 放行证据 | 十二台原门禁全部通过，加 S3 正向自检、预期失败的负例、独立综合记录；硬件待测单独列出 |

## 2. 资料复核与原方案修正

依据 [TI PCM5102A 官方手册 SLAS859C](https://www.ti.com/lit/ds/symlink/pcm5102a.pdf) §9.3.2 和图 14，DIN 在 BCK 上升沿采样，FMT 低选择标准 I2S，LRCK 低为左、高为右，新声道 MSB 比 LRCK 切换晚一个 BCK。16/24 位数据均可使用 64 BCK/帧。三线模式见 §9.3.5.3、表 11：48 kHz 对应 3.072 MHz BCK，SCK 应保持低电平，启动检测要求连续 16 个 LRCK 周期；不能把“不提供 MCLK”写成 SCK 任意悬空。实物芯片是否带 A 后缀仍须核对，具体跳线以模块实物为准。

本次已阅读先前转换的 Markdown，并视觉复核手册第 15、16、25 页。图 14 的 32 位波形明确显示上一声道 LSB 跨到 LRCK 切换后的第一个采样位置。因此“32 槽容不下 32 位加一位延迟”不是标准 I2S 的限制。本轮只支持 16/24 位，是缩小实现范围的选择；以后支持 32 位，需要修改边界处理和模型，不能只放宽位宽检查。不要把 SCK 的 50 MHz 限制当作单独给出的 BCK 建立/保持时间指标。

`docs/design/minimum_design/01_时钟配置.md` 当前原文是“每 2 个系统时钟翻转 BCK”，旧方案转述为“三个”有误。当前生产 `pt8211_tx.rst` 接 `por`；模块在复位时将时钟置零，正常运行中的软复位只将样本置零。旧方案同时写“同步复位清所有状态”和“复位期间 BCK/LRCK 持续翻转”，应按第 4 节统一。

已重新检索相似开源实现。[Sipeed 官方示例](https://github.com/sipeed/TangPrimer-20K-example)包含 PT8211 示例，现有本地模块已参考其右对齐通路，不能直接当标准 I2S 发送器。[ultraembedded/core_audio](https://github.com/ultraembedded/core_audio)提供 I2S，但其接口是 AXI4-Lite，并含 2048 项缓冲，采用 GPL-2.0；旧文的“APB”不准确。当前范围不引入这些源码或运行依赖，按器件时序实现小模块更便于适配现有门禁。没有证据支持“所有开源项目都无法复用”的绝对结论，也不按星标数量判断时序可靠性。以后复制外部代码须另行固定提交、保留对应许可并说明依赖和适配。

## 3. 两档参数与分频实现

这两个档案都能使用整数长度的 BCK 周期，采用一个 BCK 周期计数器和一个 64 槽计数器即可。省去原方案的运行时相位累加器，也不需要独立自由运行的帧计数器。BCK、LRCK、DIN 均由 `posedge clk` 中的寄存器更新，内部用使能判断发送时刻；RTL 不用 `posedge bck`、`negedge bck` 或 `lrck` 建立新时钟域。

固定两声道、每声道 32 槽。编译期派生 `FRAME_CYC = CLK_HZ / SAMPLE_RATE_HZ`、`BCK_CYC = FRAME_CYC / 64`、`BCK_HIGH_CYC = BCK_CYC / 2`、`BCK_LOW_CYC = BCK_CYC - BCK_HIGH_CYC`。每次 BCK 下降沿推进一个槽，连续 32 槽后切换声道，连续 64 槽形成一帧。奇数分频时固定高电平短一拍、低电平长一拍，完整 BCK 周期仍恒定。

| 档案 | `CLK_HZ` | `SAMPLE_RATE_HZ` | 帧 / 半帧系统拍 | BCK 周期 / 高 / 低系统拍 | BCK 频率 | 使用范围 |
| --- | ---: | ---: | ---: | ---: | ---: | --- |
| 标准 | 12,288,000 | 48,000 | 256 / 128 | 4 / 2 / 2 | 3.072 MHz | S3 正式数字验收目标 |
| 调试 | 27,000,000 | 46,875 | 576 / 288 | 9 / 4 / 5 | 3.000 MHz | 参数化仿真对照，不作为 48 kHz 证据 |

标准档一个 LRCK 完整周期是 256 拍，LRCK 每次跳变相隔 128 拍；调试档分别为 576 和 288 拍。两档每半帧均有 32 个 BCK 上升沿、每完整帧 64 个。原方案调试档“BCK 周期平均 4.5 拍、4/5 交替”少算一倍；4/5 是两个半周期，完整周期为 9 拍。修订后的调试档没有逐周期长度抖动，存在 4:5 的占空比。是否被实物 DAC 接受，仍需实机证据。

`clk_params.vh` 使用包含保护和项目专用宏名前缀，例如 `FPGA_AUDIO_STD_CLK_HZ`、`FPGA_AUDIO_STD_FS_HZ`、`FPGA_AUDIO_DBG_CLK_HZ`、`FPGA_AUDIO_DBG_FS_HZ`。模块参数保留 `CLK_HZ`、`SAMPLE_RATE_HZ`、`DATA_BITS`，默认标准档、16 位。档案由实例参数或构建时选择，不做运行时切钟。头文件只接入本轮新模块与测试，不将既有顶层的默认 27 MHz/46,875 Hz 改成 48 kHz。

合法条件为 `CLK_HZ > 0`、`SAMPLE_RATE_HZ > 0`、时钟可整除采样率、`FRAME_CYC` 可整除 64、`BCK_CYC >= 2`、`DATA_BITS` 为 16 或 24。各计数器位宽至少为 1，防止 `$clog2(1)` 形成零宽寄存器。非法参数须在仿真中 `$fatal(1, ...)`，输出明确的 `S3_PARAM_INVALID` 及原因。涉及除法的 localparam 用安全占位值保护零分母，使非法配置能进入诊断而非直接产生无法辨识的展开错误。

若检查放在 `` `ifdef SIMULATION `` 下，门禁编译必须实际加入 `-DSIMULATION`。目前脚本只有 `-g2012 -I .`，没有这个宏；不能只新增保护块后声称参数检查已执行。综合时排除仿真系统任务，并记录同一参数的综合配置。协议常量 2、32、64 可以明确命名，频率与时长不散落为裸常数。

## 4. 发送接口、复位与样本时序

| 端口 | 方向 | 唯一语义 |
| --- | --- | --- |
| `clk` | in | 单一系统时钟；采样率正确性依赖参数与真实输入时钟一致 |
| `rst` | in | 高有效同步硬复位，清分频/槽状态、样本保持寄存器和 tick，输出三线为 0 |
| `sample_l`、`sample_r` | in | 同域、有符号二进制补码，宽度 `DATA_BITS`；左右同时锁存 |
| `bck`、`lrck`、`din` | out | 寄存器输出，标准 I2S；稳态 DIN/LRCK 只在 BCK 下降沿改变 |
| `sample_tick` | out | LRCK 从高到低的帧边界产生、恰好一个 `clk` 周期的寄存器脉冲 |

硬复位期间允许时钟停止，DAC 可能重新锁定；这是明确的启动/恢复行为。未来顶层把 `rst` 接上电复位，演奏软复位/Panic/数字静音通过将左右输入样本置零实现，不拉高串行器 `rst`。软静音必须保持 BCK、LRCK 和 tick 连续，不用组合逻辑把 DIN 强行改零。静音生效遵守帧锁存：命令后下一个锁存边界接受零样本，当前已发出的完整帧保留原数据。

以下“无 X”从至少一个有效同步复位上升沿之后检查；不承诺同步复位尚未采样时的 t=0 输出。硬复位可在任意槽发生，允许中断正在发送的帧；接收模型丢弃不完整帧并重新对齐，不能把残帧当作错误完整帧比较。

将复位释放后第一次真实的 LRCK 高→低且 BCK 下降沿定义为 `E0`。启动残段只发零，`E0` 后的第一个完整左右帧仍强制为零，即使输入预先非零；`E0` 发第一个 tick。`E1` 为下一次同类边界，从 `E1` 起正常同时锁存左右输入。`E0` 应在释放后不超过 `FRAME_CYC + BCK_CYC` 拍出现。此后 `En` 的间隔严格为 `FRAME_CYC`，不能用无限跳过首帧掩盖启动错误。

对每个正常边界 `E[n]`，发送器锁存的是该边沿之前稳定的 `sample_l/sample_r`，两路用于紧随其后的完整左右帧。`sample_tick` 在该边界后经非阻塞赋值变高；上游同步模块在一个系统时钟后才看到它，并开始下一样本的计算。该次计算结果在下一帧边界 `E[n+1]` 锁存，必须在边界前稳定。旧混音链有 DDS、包络和 FIR 的额外延迟，本轮不推定整机只延迟一帧；后续集成须测完整流水线。

每声道以 LRCK 切换后的第一个 BCK 上升沿为位置 0：位置 0 是本轮约定的零延迟位；位置 1 是当前声道 MSB，位置 `DATA_BITS` 是 LSB，其后到位置 31 都发 0。下降沿先设置这些位，随后上升沿采样。16 位时布局为“0、16 位数据、15 位零”，24 位为“0、24 位数据、7 位零”。零填充放在有效数据之后，不在 MSB 前额外添零，不对填充位置做符号扩展。这是本轮 16/24 位发送格式，不推广为所有 I2S 字宽的边界规则。

同一帧左右样本只锁存一次；右声道开始时不得重新读取输入。测试在左声道中途、左右边界、右声道中途改变输入，均应保持当前左右帧一致，下一正常帧等于锁存边界前最后稳定的两路值。测试输入在 `negedge clk` 改变，避免与 DUT 的锁存边沿竞争。

## 5. 独立接收模型与自检

`i2s_rx_model.v` 是仅供仿真的行为模型，输入为 `rst/bck/lrck/din`，输出为解码左右字和完整帧有效指示。它在 BCK 上升沿采样，从实际 LRCK 变化恢复声道与 32 槽位置，丢弃位置 0，接收位置 1 到 `DATA_BITS`。先得到完整左槽组，再得到完整右槽组后报告一对左右字；`frame_valid` 最多一个 BCK 周期。复位或尚未对齐时丢弃残段。模型不模拟模拟 DAC、PLL 锁定、XSMT 斜坡或滤波延迟。

模型和测试不得读取 DUT 的内部位计数器、相位或保持寄存器，也不导入 DUT 的串行移位函数。期望队列由测试激励在实际帧边界之前的稳定输入建立，不能从解码结果反过来产生期望值。先用测试台人工构造的已知 I2S 位串检查接收模型，再用该模型检查发送器；参考位串至少包含零、最小负数、左右不同值。时序监视器另行测系统拍、引脚边沿与填充位，避免只凭“发送器和接收器相互一致”放行。

一个 `tb_i2s_tx` 可以分阶段或分实例运行下表四种组合，分别统计，不需要扩展成四套重复测试代码。标准/调试时钟在测试台中各自生成，报告按整数系统拍计数；时间精度设为 1 ps，并记录模拟时钟周期的取整误差，不以小数显示值严格等于 48,000.000000 Hz 为断言。每种组合至少覆盖 256 个正常完整帧，并配置有界超时。

| 配置 | 帧周期 / LRCK 跳变间隔 | BCK 周期 / 高 / 低 | 数据检查 |
| --- | --- | --- | --- |
| 标准、16 位 | 256 / 128 拍 | 4 / 2 / 2 拍 | 16 位原始字逐位相等 |
| 标准、24 位 | 256 / 128 拍 | 4 / 2 / 2 拍 | 24 位原始字逐位相等 |
| 调试、16 位 | 576 / 288 拍 | 9 / 4 / 5 拍 | 16 位原始字逐位相等 |
| 调试、24 位 | 576 / 288 拍 | 9 / 4 / 5 拍 | 24 位原始字逐位相等 |

16 位定向向量为 `0000/0001/7FFF/8000/FFFF/5555/AAAA/8001`，24 位为 `000000/000001/7FFFFF/800000/FFFFFF/555555/AAAAAA/800001`。左右采用独立、不相等的序列；可含左正右负，但不要全部依赖 `R = -L`，因为最小负数取反会超出同宽有符号范围。伪随机序列固定种子 `32'h53A32026`，记录生成方法和实际向量数量。

| 断言 | 必须检查的行为 |
| --- | --- |
| 时钟与帧 | 完整周期、高低脉宽、LRCK 半帧/整帧、32/64 个 BCK 上升沿；LRCK 只在 BCK 下降沿切换 |
| I2S 格式 | 左低右高、位置 0 为零、下一位置为 MSB、所有有效位/填充位正确；稳态 DIN 只在下降沿改变 |
| 样本使能 | 每帧仅一个 tick，脉宽一系统拍，边界同拍；帧中无多余 tick |
| 锁存关系 | 左/右半帧中改变输入，本帧不撕裂，下帧符合边界前稳定值；tick 后更新的样本不得被提前发送 |
| 复位 | 先满足同步复位条件再查无 X；输入预置非零时首个完整帧仍为零；在左数据、右数据和填充槽中途复位后均恢复 |
| 数字静音 | 正常运行时两路输入改零，按锁存边界进入全零完整帧；保持至少 8 帧，时钟/tick 连续，随后恢复非零 |
| 检查器能力 | 对已知位串正确解码；错误位偏移、声道互换或单比特翻转会产生预期不一致 |

边沿测量要处理 Verilog 非阻塞赋值更新顺序：引脚事件监视器读实际引脚变化；系统拍监视器在寄存器更新后采样，例如延迟一个仿真精度单位。不要同一 `posedge clk` 未经调度处理就把新 tick 当旧 tick，也不要用 `force sample_tick` 生成 S3 的时序证据。复位豁免仅覆盖复位/残帧，不能关闭稳态断言。

负面控制保留两层。协议层将捕获的 32 槽按左对齐、右对齐错误偏移重解码，要求在指定非对称向量上至少各出现一次不一致；零向量等允许偶然相等。另对参考位串做左右互换和有效位翻转，确认比较器检测到差异。PCM5102A 的 FMT 高只代表左对齐，右对齐是验证用错误假设，不是该引脚的另一个硬件模式。无需把接收模型扩成三种完整协议实现。

参数层单独启动非法配置仿真，至少覆盖零采样率、`27 MHz/48 kHz` 不整除、`12.336 MHz/48 kHz` 得到 257 拍而不能整除 64、`3.072 MHz/48 kHz` 的 BCK 周期只有一拍，以及 `DATA_BITS=32`。负例的预期结果是非零退出且包含匹配原因的 `S3_PARAM_INVALID`；不能把语法错误、工具崩溃或任意非零都算通过。缺少失败或原因不匹配则整体门禁失败。所有普通断言和 watchdog 用 `$fatal(1,...)`，正向运行只有全部自检通过才 `$finish`。

## 6. 门禁、综合、资源与统一参数清单

把 S3 正向台登记到 `sim/run_simulation.ps1`，编译源包含发送器和接收模型，实际启用参数检查宏；参数负例由脚本顺序执行并区分预期失败。保留十二台原门禁，增加一个主台后正向台数应为十三；“十三台”本身不是验收证据，还须核对四组合、负例和各台退出码。门禁全局使用超时或各新台 watchdog，编译失败不可继续运行旧 `.vvp`。

已有 `docs/history/logs/2026/10/FPGA_DEBUG_LOG_20261014_SANDBOX_IVERILOG.md` 记录 Icarus 在当时默认沙箱中编译返回 `0xC0000005`、相同源码在外部执行正常。本次评审未重现此问题，不把它写成当前环境必然故障。若编码时复现，记录完整命令和退出码，通过环境允许的方式在外部运行同一门禁；不要更改全局 Codex 配置，不删除退出码检查，不把留下的 `.vvp` 当成编译成功。跨会话审批是否仍有效由实际环境决定。

门禁通过后跑一次既有 `tools/run_audio_verification.ps1` 回归，确认原 PT8211 音频证据没有变化，并绑定同一源码提交和 SHA256。S3 不需要重做整机 FFT 或新增长时间模拟音频捕获，只保留足以检查 I2S 位流的紧凑日志与失败波形。

Gowin 生产构建脚本应在新建工程和打开旧工程两条路径中幂等登记 `i2s_tx.v`，包含路径沿用从源码根运行的方式。未被顶层实例化的模块会被优化掉，不能用现有 `top` 综合通过证明新模块可综合。新增可复现的隔离综合入口，以 `i2s_tx` 或简单包装模块为综合顶层，器件固定 GW2A-LV18PG256C8/I7、版本 C，至少验证标准档默认 16 位，有条件同时验证 24 位。构建目录放到明确的工作区 `tmp/` 子目录，源脚本和报告保留。

本机能运行 Gowin 时完成独立综合，记录工具版本、配置、警告和资源；无法运行则交可复现脚本，并将综合状态列为待验证。独立 PnR/引脚时序测量可以留给后续集成，不能凭低频或模块短小直接宣称时序收敛。标准档系统周期约 81.380208 ns，下降到上升沿的名义窗口约 162.760417 ns，属于设计计算，实际引脚建立/保持和板级偏斜要实测。当前结构不需要 ROM、BSRAM 或 18×18 乘法器，目标增量均为 0，最终以独立综合报告核对，不提前填写虚构 LUT/FF 数字。

“统一参数”在 S3 的验收含义是新发送器、测试、指标使用同一档案；既有合成链迁移形成下表待办。后续修改系统时钟时逐项清点实际代码和脚本常数，不能只改头文件。

| 迁移项 | 后续集成时必须复核的内容 |
| --- | --- |
| 顶层、POR、同步和去抖 | 唯一采样 tick 来源；复位/消抖计数从 27 MHz 改按实际时钟推导；GPIO 既有 27002/27005 拍响应记录重测 |
| UART 与串口控制 | `uart_ctrl.CLK_HZ`、波特率、串口命令到帧样本的延迟 |
| DDS / 音符频率字 | `note_phase_inc.v` 当前 46,875 Hz 常数改按 48,000 Hz 重生成；在线 Hz 转频率字的主机脚本同步检查 |
| 曲目、ADSR、FIR | 每拍样本数、包络时间、控制平滑和 FIR 频响/延迟；明确哪些按采样更新、哪些按系统拍更新 |
| PT8211 调试口 | 旧 18 拍 BCK 分频在 12.288 MHz 下不能原样保留；若与正式输出同时运行，确定两接口共享采样相位 |
| SDC / CST / 时钟输入 | 12.288 MHz 约束与 GCLK 路由、IO Bank 电压；本轮不应用已有候选引脚 |
| 全部测试与音频分析 | `tb_tick_rate`、S1 捕获、`analyze_audio_capture.py`、复现 JSON/WAV 采样率和相关主机工具；不得混用旧频率 ROM |

集成时只允许一个权威 `sample_tick` 驱动合成链，不能并联两个发送器的 tick，也不能直接把 27 MHz 样本跨域接到 12.288 MHz。按主规划采用单一音频域时统一迁移；如果选择双域，CDC/FIFO 属于架构变更，先重新确认。

## 7. 实施顺序、交付和回退

| 顺序 | 实施与验收 | 预算人时 |
| --- | --- | ---: |
| 1 | 核对 Git 基线/本地改动、端口约定、参数头和发送器 | 1.5–2 |
| 2 | 人工参考位串、接收模型、四组合自检、复位/静音与负例 | 2.5–3 |
| 3 | 门禁接入，原十二台加 S3、参数负例及一次原音频回归 | 0.5–0.75 |
| 4 | 独立综合、源码登记、指标、文档与归档清理 | 0.5–1.25 |
| **合计** | **数字交付，包含测试与记录** | **5–7** |

先按边界写参数和接口，再实现发送器与独立模型，新增台自检通过后接入总门禁，最后综合和留证。前两步跑针对性自检，完整门禁在模块集成后与最终源码冻结后按实际变化运行，不要求没有新改动时反复全量测试。若接收模型、框架或工具问题导致超预算，先保持核心时序与全部强制断言，省去可选 PnR 和大波形导出；不能删复位、帧不撕裂、负例来凑 PASS。

交付源码、接收模型、测试、负例驱动、门禁与独立综合脚本，关键新增逻辑写 `[S3-AI]` 标记和必要中文注释。证据目录至少包含源提交/工作区差异、输入校验值、工具路径/版本、逐台日志、四组合测量 JSON、向量种子/数量、参数负例的预期与实际退出码、独立综合报告和硬件待测项。JSON 至少区分 `simulation`、`synthesis`、`hardware` 状态，记录真实档案采样率；本轮 `hardware` 为 `not_tested`。只有全部相应检查实际通过才写 PASS，文件存在不等于功能完成。

归档 `archive/FPGA-日期-下一个未占用版本/`，包含 source、目标产物/报告、REPRODUCE、CHANGES、MANIFEST 和 `checksums.sha256`。方案评审包 v0.5 中的参数核算脚本只验证本文算术，不是发送器 RTL。后续编码证据须另建，不能沿用方案包的计算结果冒充 RTL 测量值。

常规新增和门禁改动在这份任务范围内实施；顶层/公共接口/时钟架构/生产引脚及烧录保持另行确认。回退按本轮明确变更清单撤销文件和脚本差异，或恢复编码前留存的文件副本；不要用 `git reset --hard dd43257`、宽泛 `git clean` 或覆盖未提交文件。基线若已变化，先核对差异，不能无条件把工作区退回旧提交。

清理先列出本轮生成的明确路径，再验证绝对路径位于工作区 `tmp/` 或指定构建目录后删除。保留可复现源码/脚本、原始关键日志、失败后用于解释问题的最小波形、报告和校验记录；一次性 `.vvp`、临时探测和多余 VCD 清理。不要清理他人遗留内容，也不要删除 `tools/.venv-docconvert`、工具源码、OCR 数据等运行依赖。将使用的手册/复核 PNG 从 `tmp/` 复制到证据归档后再引用，避免证据链继续依赖临时路径。

后续上板依据 `docs/hardware/FPGA-外设到货接入与验收流程-20261013-v0.1.md`：先确认 DAC 丝印、FMT/SCK/XSMT 跳线、晶振额定电压和频率，再确认 GCLK/Bank 电压与 PnR，然后仿真门禁、SRAM 候选、波形/发声和整机延迟。7050 是封装名，不能据此推定所购晶振电压。候选 I2S 引脚表是待落地提案，本轮不据其更新 CST。只有这一步完成才可写“标准 I2S 实机通过”。

## 8. 可直接复制给 DeepSeek 的指令

```text
请在 E:\Working Space\FPGA 实现 S3，依据本任务书 v0.2，按 FPGA 音频 RTL/验证工程师的职责完成编码和自检。先读取项目 AGENTS.md、最新 S3 任务书、缺件期间 S0–S6 计划、现有发送器/门禁/构建脚本；核对当前 Git 提交与未提交文件，保留用户改动。源码根是 source，不要另建一套平行生产工程。

本次只授权可复用 i2s_tx、clk_params.vh、独立 i2s_rx_model、tb_i2s_tx、参数负例、门禁与独立综合脚本、必要源文件登记和交付说明。保持现有顶层/PT8211 行为，不切系统时钟，不改生产 CST/SDC，不烧录，不加声部或效果。

按文档实现整数 BCK 周期：12.288 MHz/48 kHz 为 256 拍每帧、4 拍每 BCK；27 MHz/46,875 Hz 为 576 拍每帧、9 拍每 BCK，高4/低5。两档均为64 BCK/帧。RTL只用系统clk与时钟使能，在BCK下降沿更新DIN/LRCK，下一上升沿采样；不要引入相位累加分频或派生内部时钟域。

支持16/24位并分别自检。遵守首个完整帧为零、同步硬复位、软静音只置样本零、左右同帧锁存、tick单周期和文档给出的逐拍关系。接收模型只观察外部引脚，先用人工参考位串校验；再覆盖四组合、符号/极值/随机、帧内变化、复位恢复、静音及错误对齐/声道/位的负面控制。普通失败必须$fatal，非法参数必须有明确原因且非零退出；门禁实际启用SIMULATION宏。

运行全部原十二台加S3自检、参数负例和一次原PT8211音频回归。若本机有Gowin，至少以新模块为顶层独立综合标准16位，保存报告；未实例化的新模块不能用旧top的综合结果代替。工具不可用或检查失败如实记录，不能跳过退出码或宣称通过。无权更改全局工具/沙箱配置；需要用户处理的阻塞给出具体日志，其余授权工作继续完成。

交付可复现代码、日志、四组合指标JSON、源提交与SHA256、综合状态、硬件待测清单及归档。本次评审已占用archive/FPGA-20261014-v0.5，编码交付选择下一个未占用版本。清理仅限本轮明确临时路径，不删除用户文件和运行依赖。结束时说明完成内容、验证证据、已清理内容、风险/后续实机步骤；不把仿真和综合通过写成DAC实机验收。
```

## 9. 本次评审证据

本次归档 `archive/FPGA-20261014-v0.5/` 保留原桌面 v0.1、修订目标 v0.2、可重跑的参数核算脚本 `source/check_clock_plan.py`、核算 JSON、资料复核记录、TI 手册及已复核页、来源文件哈希、变更说明和校验表。复核覆盖项目排期、S3 验收条目、十二台门禁配置、Git 基线、现有 PT8211/POR/tick 约定及新分频算术。未编写或运行 S3 RTL，未做独立综合，也未连接硬件。

主要本地依据为最新 S0–S6 计划、竞赛差距计划 v0.2、主规划第 4.7 节、最低设计时钟说明、竞赛要求摘要、`source/rtl/audio/pt8211_tx.v`、`source/rtl/top.v`、`source/rtl/audio/mixer.v`、`source/sim/run_simulation.ps1` 和 `source/build/build_instrument.tcl`。外部依据及核查日期在归档 `evidence/REVIEW.md`。本轮发现的旧资料错误只在本任务书中说明，未批量改写历史规划。
