Interstellar-530/PolyTouch-FPGA-Synth/docs/planning/FPGA-持续优化进度.md

# FPGA 持续优化进度

用户已授权逐项修复、持续推进并及时同步 GitHub。每项完成后报告，不再等待“继续”才能执行下一项；新架构及公共接口仍按项目规则确认。工作区为 `E:/Working Space/FPGA`，分支 `codex/s4-s6-pressure`，远端同名分支，用户历史未提交文档保持原样。

**2026-10-17 晚间最新指令：用户取消定时需求，并明确“取消额度限制，我会自己观察”。后续不再创建自动续接、不再因15%阈值暂停，也不再反复询问额度；由用户自行观察。下文上午的额度保护与自动化故障仅为历史记录，不再构成当前任务阻塞。**

用户已于 2026-10-17 明确批准后续 32/64 声部采用内部 PLL、两条共享计算通路（预算 2–4 个乘法器、最多 16 块 BSRAM），并提高内部及 I2S 有效精度；不增加外部硬件，逐阶段验证。此批准在后续续接中持续有效，不要重复询问同一架构授权。

## 当前续接点

**最新收尾指令：用户要求立刻总结和推送，本阶段停止新增实现。PLL64音测试封装已完成厂商原语组合606帧及真实布局布线，49.152MHz目标下setup/hold违反端点均0，最差setup余量5.980ns、Fmax69.611MHz，2733Logic/1364FF/10BSRAM/4MULT/1PLL。精确CDC约束保留总线setup，16相位桥测试通过。生产仍为四声部；64路事件、ADSR/过渡及弯音缓存未实现。详见`docs/reviews/FPGA-阶段优化量化总结-20261017-v0.1.md`。后续需用户继续指令再推进。**

2026-10-17：第一项压力采样与滤波已完成并推送至 `e672dfa`：每个 2 kHz 控制周期连续完成 CH1/CH0，整组完成后只推进一次滤波，片选间保留至少1微秒。证据见 `evidence/2026/10/FPGA-新采样滤波-20261017-v0.1`，单笔毛刺峰值0，两种配置8相位内部VCA响应均低于2.9 ms；最终六项自检通过，标准综合4348 Logic/1744FF/2BSRAM/1MULT18X18。

帧力度一致性也已修复并推送至 `029073df3aff3f3bfdca0e5f192438a9ab8aff16`：sample_tick快照四路力度，避免混用两个事件版本。修复前探针退出1，修复后76个事件偏移/152帧通过，四项数值回归及真实顶层音色测试通过；证据在 `evidence/2026/10/FPGA-帧力度一致性-20261017-v0.1`。最终标准综合4348 Logic/1772FF/2BSRAM/1MULT18X18。各项生产修改均经验证后单独提交推送，远端引用已经核对。

晚间已完成静音过渡并推送 `074a1a2`：复用原VCA，最大128帧到零，受控阶跃5–20kHz能量降低40.73dB；标准综合4402Logic/1772FF/2BSRAM/1MULT18X18。

重按/窃声过渡已验证并推送 `aae3862`：新 `voice_transition` 保留旧渲染音高及力度，在最多64帧内将旧包络淡出，再原子提交新参数与相位重启。独立状态测试、真实UART第五键窃声/取消测试、16条件16384帧音频捕获，以及五项顶层回归和13项工程检查通过。受控音频高频能量合计降低32.02dB，单组16.65–36.56dB；标准综合4999Logic/1997FF/2BSRAM/1MULT18X18，仍81拍。证据在 `evidence/2026/10/FPGA-声部过渡-20261017-v0.1`。

UART与GPIO同音来源也已修复并接入生产：独立 `note_ownership` 通过2060事件参考检查，真实顶层五种混合输入/Panic情形、声部过渡整机回归、模式回归及两个工程展开通过。事件格式保持16位，只有最后一个来源松开才转发NoteOff；清理随panic/模式切换进行。标准综合5226Logic/2137FF/2BSRAM/1MULT18X18，资源报告和证据在 `evidence/2026/10/FPGA-同音来源-20261017-v0.1`。

高音带限已完成：16/8/4/2/1五级512点波表，原16谐波表逐值不变，其余表保持相同基波；按实际弯音增量连续混合，生产启用，独立模块默认兼容。42370帧独立数值对照、2560地址、五项旧数值回归及顶层113拍/42乘积验证通过，高音三组残余降低70.89/78.79/85.73dB（数字RTL受控测试）。标准综合5558Logic/2200FF/4BSRAM/1MULT18X18。证据与报告在20261017高音带限目录。前三项晚间修复已归档archive/FPGA-20261017-v0.4，截止9d8260c；后续带限应另行归档。

宽精度阶段完成：生产内部保留两位小数，新路径包络/力度/主增益就近舍入，VCA直接量化至24位输出，旧默认公式逐值兼容。65536帧八种低电平条件中，含DC/增益误差的满幅时域SNR从76.66升至92.39dB；弱压力/尾音提升至多30.08dB。42370帧引擎整数模型、8192组全范围主混合、8721串行I2S帧、压力/声部过渡及旧数值回归通过。最终综合5809Logic/2242FF/4BSRAM/1MULT18X18，113拍/42乘积。详见宽精度报告与resources-rounded，before-rounding仅为中间方案证据。

弯音系数三段流水已通过10195次独立参考输出，保持所有比例数值和0.032741193音分误差界。标准综合5748Logic/2320FF/4BSRAM/1MULT18X18；同一默认约束的最差综合到达由22.028降至19.958ns，瓶颈转移到全局音色混合权重，仍未PnR。证据见弯音流水目录。

主混合输入流水也已通过8192组全范围整数与帧中参数反转检查、真实压力/I2S及音色114拍/42乘积回归。最终5796Logic/2363FF/4BSRAM/1MULT18X18，综合最差到达19.295ns，新瓶颈为过渡包络到频率快照。该路径应在后续状态RAM调度中分拍，当前未PnR或接PLL。

宽乘法基础单元已验证：split_audio_multiplier支持19–35位×18位精确拆积，24/33/35三种宽度各32768事件在便携和Gowin厂商模型下通过。显式MULT18X18确定每路两个物理乘法器；推断版本意外占一个MULT18加一个MULTADDALU、等效3个18乘法位置，已放弃并留证。孤立综合两种宽度均2MULT/0BSRAM，尚未接生产音频链，生产资源仍为5796Logic/2363FF/4BSRAM/1MULT。

状态RAM基础单元已通过便携与厂商模型：512×32、8192随机周期、6166次读结果、两次512拍完整清空。实际孤立综合56Logic/11FF/1BSRAM/0DSP。注意SDP32写地址低4位是字节写使能，必须1111，不能补0。初始化ready之前忽略外部写，同址读写由后续调度仲裁。尚未接生产音频。

RAM波表原型已验证：8路216/256拍，32及双路64为864/1024拍；8/32各512帧、64共8768帧独立24位参考逐值通过，厂商ROM/RAM/DSP组合64帧通过。64路8192点频谱中64个独立频点幅度正确，非预期总功率-98.5496dB。双路核心孤立综合1994Logic/1053FF/10BSRAM/4MULT18X18；不含事件、ADSR/过渡、主混合、PLL/I2S，生产仍四声部。

空声部门控完成：包络或力度为0时关闭DSP和波表ROM使能，并保持乘法器输入；相位RAM继续推进。8/32/64各512帧、厂商64帧及每帧活动统计通过，512帧随机序列乘法请求减少31.59/32.71/39.39%。最终64核心2109Logic/1053FF/10BSRAM/4MULT。不是实测瓦数，满载公式保持57bfdb1数值。

宽主混合与I2S原型已验证：wide_master复用第0路双乘法器，8/32/64各719帧主混合和24位串行字正确，64路厂商原语组合也通过；全32位主混合8192帧便携/厂商模型含ready停顿与饱和均正确。8路222/256拍，32/64为870/1024拍，64孤立综合2602Logic/1353FF/10BSRAM/4MULT，含主混合/I2S，不含事件/ADSR/PLL。辅助DSP接口只在核心IDLE/CFG状态授权，保持4DSP上限。仿真门禁改显式-s根，避免库原型误作附加顶层；已定向复核，无完整门禁运行。

下一步先PLL和真实49.152MHz时序约束，再接RAM事件/ADSR/过渡控制与背景弯音缓存，不把当前外部配置包络原型当作完整乐器。每路状态1块、每路双银行频率缓存1块，总预算波表8+状态2+缓存2=12BSRAM，余4块可用于端口/事件调度。DP真双口最大16位，SDP简单双口支持32位。生产四声部基线保持可回退。

上午历史检查点：2026-10-17 11:07左右曾按额度保护保存至 `archive/FPGA-20261017-v0.3`。晚间用户已取消额度及定时限制并要求继续，因此不再按该历史检查点暂停。不要重跑已经通过的整套测试。

待处理顺序：压力新样本调度；重按/窃声与静音过渡；帧参数快照及多来源同音；高音区带限；宽精度；参数化及 8/32/64 声部方案。详细问题和自定验收目标见 `docs/reviews/FPGA-整体潜力审查-20261017-v0.1.md`。不要把计划写成已实现；完成某项需保存源码、原始日志、复现命令和独立提交，推送 GitHub 后核对远端引用。

## 额度与自动续接

任一可用额度窗口剩余低于 15%，或明显不足以安全收尾下一步时，先保存工作、测试状态、待执行命令和额度重置时间，再停止高耗时工作。最近本机会话日志显示五小时窗口重置时间为 **2026-10-17 15:30:53 +08:00**；每次恢复必须重读额度，不能沿用旧值。周窗口也可能成为限制。

额度工具 `get_usage_limits` 当前返回 Invalid app tool request，可从当前会话 JSONL 中最近的 `event_msg/token_count.rate_limits` 读取时间戳、used_percent 和 resets_at。此会话日志路径为 `C:/Users/ROG/.codex/sessions/2026/10/16/rollout-2026-10-16T18-24-06-01a1443d-8bf8-70e2-89cf-4d92d0445142.jsonl`。新会话应找到自己的最新日志。

自动续接尚未建立：`automation_update` 的 heartbeat create、suggested_create以及显式targetThreadId创建均返回 MCP -32602 Invalid app tool request，`~/.codex/automations` 没有已建立的任务。不能据此承诺届时会自动唤醒；不自行创建操作系统定时任务或手写自动化配置。工具恢复后，优先建立当前聊天的 heartbeat，在额度重置前保持安静，重置后检查额度并续接；全部验收结束后停用。可审阅任务内容已保存在 `docs/planning/FPGA-自动续接提示词.md`。若应用工具未恢复，必须由用户从应用端启用定时续接或在重置后恢复本聊天；这是一项未完成的外部依赖。

本轮不运行完整门禁、不烧录、不推送未验证的生产改动；正式烧录之前仍须完整 RTL 门禁。临时目录只删除明确属于本轮的路径，先列出、解析工作区边界，再删除。运行依赖及已有 source/impl 保留。
