Interstellar-530/PolyTouch-FPGA-Synth/docs/reviews/FPGA-RAM波表核心验证-20261017-v0.1.md

# RAM波表计算核心原型

新增 `ram_wavetable_engine`，把每声部相位、增量和外部包络/力度参数放入单块512×32状态RAM，以共享控制器顺序处理8或32个振荡器，两路32组成64。每路固定4块波表BSRAM、1块状态BSRAM、2个18×18乘法器。状态读四拍，替代原来四拍的逐帧弯音拆积；增量由配置接口直接提供，后续再接背景弯音缓存。

单声部输出为24位，16位波表经9位相位分数插值后保留8个小数位；包络、力度及带间混合用宽乘法器精确拆积并就近舍入，分量累计32位。保留上一项五级连续带限。配置握手在引擎空闲窗口原子写入参数和增量，重触发标志只消费一次，相位每帧写回RAM。帧末留出配置事务窗口，实际采样tick必须遵守FRAME_CYCLES。

| 原型 | 拍数/帧 | 帧预算 | Logic | FF | BSRAM | 物理18×18 |
|---|---:|---:|---:|---:|---:|---:|
| 单路8 | 216 | 256 | 972 | 525 | 5 | 2 |
| 单路32 | 864 | 1024 | 969 | 527 | 5 | 2 |
| 双路64 | 864 | 1024 | 1994 | 1053 | 10 | 4 |

这组综合只包括计算核心及配置/结果外壳，尚未加入事件分配、ADSR、去爆音控制、压力主混合、PLL及实际I2S，不能作为整机资源。8路和32路各512帧与独立Python整数模型逐值相同；双路64路8768帧同样逐值相同，包含逐声部不同频率、随机包络/力度、增量变化及重触发。高云厂商pROM、SDP、DSP模型组合的双路64路64帧也通过。两个生产工程建立/展开通过，当前生产仍是原四声部版本。

双路64路另捕获8192帧正弦分量。各声部配置不同相干频率，FFT中64个预期频点全部具有正确幅度，偏差范围-0.000127至+0.000019dB；按64归一化后，非预期频点功率相对64个基波总功率为-98.5496dB。这证明计算原型输出含64个同时非零独立频率，不能当作真实DAC听感或已经通过竞赛整机指标。测试台时钟按48kHz与指定帧预算产生，尚未使用FPGA PLL。

综合最差到达估计约11.6ns，仍为布线前、默认10ns关系；实际49.152MHz时序将在接PLL和真实引脚后检查。下一项降低空声部DSP/ROM活动，再接共享主混合、内部时钟和完整状态控制。当前固定864拍中空声部仍执行乘法，尚有功耗优化空间。没有完整门禁、PnR或烧录。

```powershell
python tools/verify_ram_engine.py --generate-smoke
python tools/verify_ram_engine.py --voices 8
python tools/verify_ram_engine.py --voices 32
python tools/verify_ram_engine.py --voices 64 --spectrum
python tools/verify_ram_engine.py --voices 64 --smoke --vendor
python tools/measure_ram_engine.py
```

证据在 `evidence/2026/10/FPGA-RAM波表核心-20261017-v0.1`。本项未改变生产顶层接线，可独立移除。宽乘法与状态RAM各自的厂商模型验证见前两项报告。
