Interstellar-530/PolyTouch-FPGA-Synth/docs/reviews/FPGA-发布前集成补审-20261021-v0.1.md

# 发布前新增集成补审（2026-10-21）

补审完成，修正后可随 v2.1.0 发布。新增内容是在独立 32 声部原型接入现有钢琴 12 表、吉他 30 表，并支持音色/钢琴力度档控制。生产顶层仍是 8 声部；本次没有烧录。实际计算时钟由后续到位的晶振提供，不以晶振未到位阻止本次源码发布。

发现并修复了四项已审核调度修正被覆盖的问题：扫描读取排队音符、窃声年龄回绕、配置背压/负载竞态和力度 128 截为静音。四个旧错误均先复现失败，修正后通过。新增 ROM 封装在 CE=0 时错误切回通用表，已改为保持已选 ROM；全部 24576 个地址与 240 次停读保持检查通过。

音色选择改为按音符划分频段，避免 48kHz 下套用 46.875kHz 相位增量阈值而误分 C4 等边界。恢复吉他低音段中低力度使用 variant2 的原规则，钢琴高音组从 MIDI78 开始；切换钢琴档位时对阶段做钳位，避免下溢。bank、weight、包络、力度和相位增量统一快照并保持到接收，音色变更在帧边界锁存。新用例覆盖低音力度、C4、高音组和档位切换下溢。

新增配置字段及八字状态布局隔离到 `rtl/prototypes/instrument_ram_*`，原 `rtl/audio/ram_*` 端口和布局恢复。旧音频路径数值/静音/24 位 I2S 回归通过，解码 721 帧，699 帧低八位非零。生产少表构建的全部 192 个输入及位流 SHA256 仍匹配第五项审核凭据。

32 声部完整路径通过分配、独立音高、窃声、重按、释放、音色选表及 I2S 检查，解码 151 帧。实测最后活动第 992/1024 拍，最多每帧完成 32 个配置。配置采用轮询选择，避免 32 路优先编码器与音高查表串成过长路径；稀疏更新在一轮可用扫描槽内访问，满刷新仍维持每四拍一笔。对应测试等待界限按 32 路扫描更新，未放宽音频帧预算。

第一次实现暴露 Fmax 47.533MHz、setup −0.693ns；修改选择路径后重新实现，Logic 5262、Register 2341、BSRAM 26/46、2×MULT18X18（1 DSP），Fmax 49.302MHz。在 49.152MHz 约束下 setup +0.062ns、hold +0.216ns，负裕量端点为零。21 个输入与原型位流绑定。内部时序余量较小，今后增加功能需重新核算；本次不再追加反复实现。首次未通过报告保存在 `timing_before/`。

没有修改已接受的少表音频数据，第五项音质审核结论继续适用：吉他复用逐位相同，钢琴小幅近似；这不等于完成了 32 声部实机盲听。原型没有板级引脚约束，晶振和实物音频验收留待外设到位后完成。正式烧录前仍执行完整仿真门禁。本轮仅做必要定向验证，未宣称完整门禁通过。

证据见 [补审目录](../../evidence/2026/10/FPGA-发布前补审-20261021-v0.1/README.md)。回退依据为 `before/` 和 `audit_changes.patch`，或恢复 v2.0.0 后重新仿真与构建。
