Interstellar-530/PolyTouch-FPGA-Synth/docs/reviews/FPGA-宽主混合验证-20261017-v0.1.md

#24位共享主混合与串行I2S原型

新增 `wide_master`，对32位分量和做全局音色混合、固定声部余量、压力VCA、24位舍入/饱和及削波统计。主混合通过第0路RAM引擎的辅助请求接口复用已有双18×18乘法器，不增加物理DSP。辅助端口只在引擎空闲/配置写入状态授予，音频计算期间不允许抢占。两路32个声部完成时必须同拍，随后进行两次主混合乘积；I2S直接输出完整24位结果。

音色仍按每采样一步变化，压力/静音按Q12每帧32步变化，保持四声部生产版的控制口径。固定余量取声部数的log2：8路除8、32路除32、64路除64；声音在宽24位路径中归一化，不在16位整数样本上提前截断。输入由外部配置的包络、力度和实际弯音增量提供，事件分配、ADSR/去爆音状态、背景弯音缓存及PLL仍待接入；当前不是整机64声部乐器。

主混合单元在便携和高云厂商双乘法器模型下，各通过8192帧全32位正负输入参考，包含后端ready随机停顿、帧中输入反转、压力/静音/音色步进及3589次预期饱和。所有数值与独立64位整数计算相同，每帧恰好握手两次乘积。

| 计算/主混合/I2S原型 | 计算拍数 | 帧预算 | Logic | FF | BSRAM | 18×18 |
|---|---:|---:|---:|---:|---:|---:|
| 8路 | 222 | 256 | 1580 | 821 | 5 | 2 |
| 32路 | 870 | 1024 | 1575 | 827 | 5 | 2 |
| 64路 | 870 | 1024 | 2602 | 1353 | 10 | 4 |

实际串行I2S测试由三根引脚独立解码。8、32、64路分别完成719帧独立主混合计算核对，解码721/719/719个帧，检查左右一致、24位逐字正确、低位非零、固定计算期限、压力/音色扫动、静音归零和恢复，无削波。64路再以高云pROM/SDP/DSP厂商模型组合运行同一测试通过。时钟由测试台提供相应12.288/49.152MHz，Fs名义48kHz，尚未接硬件PLL或测量模拟DAC。

资源来自真实孤立综合，包含核心、主混合及I2S，不含后续事件/ADSR/PLL。64路仍只有4MULT18X18、无额外DSP算术宏，帧余量154拍。最差综合到达估计11.809ns，尚未布局布线。标准/调试生产工程建立/展开通过，原生产四声部顶层未替换。

未来完整门禁的新原型测试已登记。门禁编译改为按测试文件显式指定顶层，避免把库中未实例化原型当作附加仿真根、意外要求无关原语模型；两个纯模块测试按新根选择定向复核通过。本轮没有执行完整门禁或烧录。

```powershell
python tools/verify_wide_datapath.py --master --out evidence/2026/10/FPGA-宽主混合-20261017-v0.1/unit
python tools/verify_ram_audio.py
python tools/verify_ram_audio.py --voices 64 --vendor --out evidence/2026/10/FPGA-宽主混合-20261017-v0.1/vendor-audio
python tools/measure_ram_engine.py --audio --out evidence/2026/10/FPGA-宽主混合-20261017-v0.1/resources
python tools/verify_build_profiles.py --setup-only --out evidence/2026/10/FPGA-宽主混合-20261017-v0.1/build
```

原始证据在 `evidence/2026/10/FPGA-宽主混合-20261017-v0.1`。回退可独立移除wide_master、ram_audio_datapath及RAM引擎辅助接口；上一提交a7070af保留纯计算核心。下一阶段先验证PLL和实际49.152MHz约束，再接RAM声部控制、事件和弯音缓存。
