Interstellar-530/PolyTouch-FPGA-Synth/docs/reviews/FPGA-帧力度一致性修复-20261017-v0.1.md

# 帧力度一致性修复

基线为 `e672dfa`。共享引擎此前在帧开始快照音高、弯音和重触发信息，却在计算各声部时读取实时力度。帧内收到事件时，旧帧会混用新力度。定向自检在偏移0复现失败：参考分量2707/23624，实际2278/20207，进程退出1。

当前在sample_tick同时快照四路力度，整个计算帧使用同一版本。接口、数值公式和引擎调度不变；ADSR仍在采样边界更新，未直接快照旧包络，避免推迟包络重触发。新增32位状态寄存器，无新的算术或波表运算。

验证覆盖帧内76个事件偏移，共152帧：当前帧保持旧力度，下一帧使用新力度。另有2048帧普通引擎等价、2048帧共享弯音等价、4096个ADC码和全局交叉混合回归。真实顶层音色测试通过，仍为81拍、34次乘法请求，核对1184个音频帧。未执行完整门禁或烧录。

证据分别保存在 `evidence/2026/10/FPGA-帧力度一致性-20261017-v0.1/before`、`after`、`top`，修复前失败属于预期缺陷重现，修复后六项相关自检均通过。

实际标准配置综合仍为4348 Logic、2块BSRAM和1个MULT18X18；FF从1744变为1772，增加28个。声明的32位快照经工具优化后不必恰好对应32个新增物理寄存器。资源证据在同目录resources中。

```powershell
python tools/verify_architecture.py --out evidence/2026/10/FPGA-帧力度一致性-20261017-v0.1/after
python tools/verify_timbre.py --out evidence/2026/10/FPGA-帧力度一致性-20261017-v0.1/top tb_timbre_top
```

本项可独立撤销。接下来的重点为重按/窃声和静音过渡；新的32/64声部及精度架构已经获得用户批准，后续不重复征询同一授权。
