Interstellar-530/PolyTouch-FPGA-Synth/docs/reviews/FPGA-空声部门控优化-20261017-v0.1.md

# 空声部计算活动优化

RAM共享引擎在包络为0或力度为0时关闭本声部的DSP使能及波表ROM读取，并保持乘法器操作数寄存器，避免只关输出寄存器却继续切换乘法输入。最终分量显式累加0。相位RAM仍正常读写、相位继续自由推进，重新增大包络/力度且不重触发时与原连续相位一致。固定帧调度和最坏864拍期限不变。

独立整数参考新增频繁包络/力度归零及恢复。8、32和双路64各512帧数值逐值通过；每帧检查乘法请求数为8×有效声部数、波表读取使能数为9×有效声部数，并检查空声部乘法输入保持。双路64的厂商pROM/SDP/DSP组合模型64帧也通过。全空闲帧两类使能均为0；状态RAM和时钟树仍工作，不能据此宣称整芯片零动态功耗。

| 512帧测试配置 | 实际乘法请求 | 避免的请求 | 减少比例 |
|---|---:|---:|---:|
| 8路 | 22416 | 10352 | 31.59% |
| 32路 | 88192 | 42880 | 32.71% |
| 64路 | 158880 | 103264 | 39.39% |

这些是相同参考序列中的数字活动统计，不是板上功率测量。每个逻辑乘积使用两个18×18，未发声声部的两块DSP同时关闭使能。满载64个声部时门控条件恒为真，计算公式与上一提交57bfdb1相同，因此不重复捕获上一项8192帧满载频谱；本项重点验证静音期间及恢复后的数值和活动。

最终孤立综合8路1029Logic/525FF/5BSRAM/2MULT，32路1018Logic/527FF/5BSRAM/2MULT，双路64为2109Logic/1053FF/10BSRAM/4MULT。64路相对前项增加115Logic，FF、DSP、BSRAM不增加。最终证据以operand-hold、resources-held为准，其余目录保存首次仅CE门控的中间检查。生产顶层仍四声部；没有完整门禁、PnR或烧录。

```powershell
python tools/verify_ram_engine.py --generate-smoke
python tools/verify_ram_engine.py --voices 8 --out evidence/2026/10/FPGA-空声部门控-20261017-v0.1/operand-hold
python tools/verify_ram_engine.py --voices 32 --out evidence/2026/10/FPGA-空声部门控-20261017-v0.1/operand-hold
python tools/verify_ram_engine.py --voices 64 --out evidence/2026/10/FPGA-空声部门控-20261017-v0.1/operand-hold
python tools/verify_ram_engine.py --voices 64 --smoke --vendor --out evidence/2026/10/FPGA-空声部门控-20261017-v0.1/operand-hold
python tools/measure_ram_engine.py --out evidence/2026/10/FPGA-空声部门控-20261017-v0.1/resources-held
```

原始证据在 `evidence/2026/10/FPGA-空声部门控-20261017-v0.1`。回退可独立撤销本项提交。下一项让主混合复用第0路现有双乘法器，保持64路总共四个物理乘法器。
