Interstellar-530/PolyTouch-FPGA-Synth/docs/reviews/FPGA-队友版本合流评审-20261022-v0.1.md

# 队友版本与 v2.1.0 合流评审

2026-10-22。已获取 GitHub 全部分支与标签。队友最新分支为 `codex/v2-gate-fix-20261021`，提交 `f7052fbe951e56d9839e179d14682c28ce714b05`；我们的发布为 v2.1.0，提交 `6751f6dc65c5a301af3aab8187ec3d4aaeb7d219`。共同祖先是 v2.0.0 的 `2d3db6c1700e6628341965af5bdee70d8134c526`，双方各有一个独立提交。队友提交时间为 10/21 20:31，晚于我们的 20:20，但其内容从 v2.0.0 分出，尚未包含 v2.1.0 的六项优化。GitHub main 仍指向 v2.1.0。

队友修改四个测试台，共 23 行新增、20 行删除，没有生产 RTL、波表、约束或位流变更。合流以 v2.1.0 为功能基线，吸收队友测试修正；本地分支为 `codex/v2.1.1-integration-20261022`，作为 v2.1.1 后续开发基础。本轮不推送或打正式版本标签。

| 内容 | 双方关系与最终选择 |
|---|---|
| 生产功能及音质 | 保留 v2.1.0 的六项优化、钢琴 12 表/吉他 30 表、24 位音频、构建绑定、HID 修正和 32 声部原型；队友没有改动这些实现 |
| 钢琴/包络定向输入 | 吸收队友将 guitar_enable/guitar_mode 显式接 0 的修正，避免悬空输入影响钢琴测试 |
| 通用明亮表比较 | 吸收队友释放持续 retrigger、推进相位的修正，避免两个音色都只读相位零；保留 ROM 选择与非零/差异断言 |
| 计算预算 | 采用实际 120 拍/44 次乘积：旧 108/40 加当前每声部 3 拍键控增益、一次乘积，四声部得到 120/44；仍严格相等检查，没有移除截止时间断言 |
| 力度覆盖 | 音色对比测试使用标准力度 127；继续运行已有 0..255 边界回归，确保 128..255 饱和行为没有失去覆盖 |
| 钢琴表编号冲突 | 队友 36 表布局中的 18/22 不适用当前 12 表，保留本方 C4 body=0、hammer=4；观察限定在复位结束、声部 0 实际读取阶段，避免初始 bank=0 假通过 |

两个冲突文件是 `tb_piano_engine.v`、`tb_piano_morph.v`，均按上表处理；另外两个文件正常合入。新增内容只改变测试及说明，生产硬件结构、公开接口与波表数据保持 v2.1.0 原样，资源数继续引用已有实现报告，无需重做 PnR。

合流前原样运行四个测试：`tb_generic_bright` 失败，实测 120/44 而断言 108/40；`tb_piano_envelope` 失败，held piano 未按预期衰减到零。其余两个钢琴台通过。合流后这四个台全部通过，另外 `tb_velocity_bounds` 全量边界回归通过。通用/钢琴输出分别为 191404、204992，没有 ROM mux mismatch。生产 192 个构建输入及发布位流 SHA256、原型 21 个输入全部保持匹配。

证据及可复现脚本见 [合流证据](../../evidence/2026/10/FPGA-版本合流-20261022-v0.1/README.md)。本轮没有完整长门禁、综合、烧录或实机听感验收；保留项目烧录前完整仿真的原规则。后续沿此合流分支开发，优先处理无需外设的功能和内部时序余量；晶振与板级音频在硬件到位后集成。回退可使用 v2.1.0；合流保留双方父提交，不改写历史。
