Interstellar-530/PolyTouch-FPGA-Synth/docs/reviews/FPGA-高音带限优化-20261017-v0.1.md

# 高音区多带波表优化

原bright波表固定包含16次谐波，在48kHz下从MIDI91起出现越过Nyquist的谐波；正向两半音弯音会把风险提前到MIDI89。生产引擎现按弯音后的实际相位增量选择16/8/4/2/1次谐波的五级512点波表，并在相邻级间连续混合。每一级的丰富波表在其最高谐波到达Nyquist之前逐步退出，切换边界相邻两侧收敛到同一张表。相位、包络、力度和外部接口不变。

原16谐波表逐值保留，其余表从原表DFT截去高次频率后重建，保持同一基波幅度，不逐表归一化。生成脚本为 `tools/gen_bandlimited_prom.py`，没有导入第三方代码。三个1024×16 Gowin pROM装入五张bright表，另用一块sine ROM，综合确认为4BSRAM、1MULT18X18；当前5558 Logic、2200FF，相比上版增加332 Logic、63FF及2BSRAM。单路4BSRAM，未来双路波表8BSRAM，仍需为状态存储单独核算。五级峰值分别32767、31187、28456、24204、18632。

共享乘法器增加每声部一次第二波表插值和一次带间混合。四声部引擎108拍/40次乘积，加全局混合后113拍/42次乘积，48kHz配置每帧256拍，余量143拍。整机1183个I2S帧、四键音色扫动及1047次相位连续检查通过。两个真实工程建立/展开、五项旧数值兼容回归、声部重按/窃声与混合输入整机回归通过。独立模块默认关闭带限，旧数值接口继续逐值一致。

波表原语通过2560个交错地址读取、CE保持及同步复位检查。两个引擎配置分别使用本地和外部共享乘法器，42370帧均与独立Python整数模型逐值相同，覆盖随机参数、频带边界、127个MIDI音高及负/零/正弯音。

以下频谱来自真实RTL输出，8192点相干采样，以应保留谐波之外的FFT功率相对基波计量。它包含表量化及插值镜像等残余，不能当作模拟DAC的THD+N或硬件实测。

| MIDI附近音高 | 测试频率Hz | 原残余dBc | 带限后dBc | 降低dB |
|---|---:|---:|---:|---:|
| 60 | 263.671875 | -72.976 | -72.976 | 0；逐值不变 |
| 84 | 1048.828125 | -72.976 | -76.296 | 3.321 |
| 96 | 2091.796875 | -12.462 | -83.355 | 70.893 |
| 108 | 4183.593750 | -7.947 | -86.738 | 78.791 |
| 127 | 12544.921875 | -2.336 | -88.069 | 85.733 |

方法参考HISE官方多带波表说明：https://docs.hise.audio/hise-modules/sound-generators/list/wavetablesynth.html 。这里只复用方法，全部硬件实现与生成脚本保留在本项目。低音区相位增量小于2^26时逐值保留原bright，进入较高频带后音色会按设计减少高次谐波。未进行完整门禁、PnR或烧录。

```powershell
python tools/gen_bandlimited_prom.py
python tools/verify_bandlimit.py --generate-smoke
python tools/verify_bandlimit.py --out evidence/2026/10/FPGA-高音带限-20261017-v0.1/full
python tools/verify_timbre.py --out evidence/2026/10/FPGA-高音带限-20261017-v0.1/top tb_timbre_top
python tools/verify_transients.py --out evidence/2026/10/FPGA-高音带限-20261017-v0.1/integration tb_voice_transition_top tb_note_ownership_top
python tools/verify_architecture.py --out evidence/2026/10/FPGA-高音带限-20261017-v0.1/compatibility
python tools/verify_build_profiles.py --setup-only --out evidence/2026/10/FPGA-高音带限-20261017-v0.1/build
python tools/measure_architecture.py --out evidence/2026/10/FPGA-高音带限-20261017-v0.1/resources --baseline-ref 9d8260c
```

证据目录 `evidence/2026/10/FPGA-高音带限-20261017-v0.1`。回退可独立撤销本项提交，生产顶层关闭BANDLIMIT_ENABLE即可恢复旧波表路径。下一步提升低电平有效精度，再推进已批准的PLL/双通路多声部。
