Interstellar-530/PolyTouch-FPGA-Synth/docs/planning/FPGA-极致低延迟优化方案-20261026-v0.1.md

# 极致低延迟优化方案

建议采用两条输入路径：保留完整 USB 键盘作为通用演奏输入，优先优化 CH9350L 串口及 DAC；另设直接接入 FPGA 的光电或霍尔演奏键，用于追求更低且可控的延迟。当前 32 声部计算已经足够快，主要优化收益在输入和转换环节。本文件是方案，没有修改 RTL、拨码、DAC 跳线或烧录。

## 已测基线与验收口径

现有 32 声部原型在 12.288 MHz 参考、73.728 MHz 计算、48 kHz 输出下，音符请求至首个非零 I2S 样本为 67.668..83.293 µs；包含 115200 UART 键盘帧接收为 1020.710 µs。617/1536 个计算周期是本次观测的最大帧尾。它支持继续做 32 声部集成，不代表尚未实现的 27→54 MHz 板级版本已经通过。原始结果见 ../reviews/FPGA-32声部延迟仿真-20261026-v0.1.md。

整机应分别测物理动作至首个数字非零样本、物理动作至模拟输出相对固定参考响度门限的起音，以及包络达到 10%/90% 的时刻。数字非零不等于人耳可闻，包络 90% 也不能替代起音延迟。对按键输入记录最大值和分布，并覆盖满 32 声部、反复重按、事件突发、不同事件相位；不只给平均值。

目标是完整键盘路径整机低于 3 ms、直接演奏键路径约 0.5..1.2 ms。这些是待验证的工程目标。现有仿真没有测到键盘扫描、USB 轮询、CH9350L 内部排队、DAC 模拟及听音阈值。普通键盘若自身耗时数毫秒，FPGA 合成优化无法补回这部分。

## 优先修改：利用现有硬件

首先评估 CH9350L 300000 波特率。已核对 WCH V2.3 手册第 6 页表 7-2，BAUD0、BAUD1 均为低电平时为 300000，默认均高为 115200。项目旧手册将双低配置标为不推荐，因此先确认实物版本及实测稳定性，不能直接假定现有模块支持。支持后需同时修改 FPGA 的接收配置；当前 host_kbd_input 有 BAUD 参数，但 top 没有把可选择的键盘波特率贯通到生产构建入口，需要补参数传递。27 MHz / 300000 恰为 90；12.288 MHz 原型用整数分频会有小量误差，需要检查允许的双方时钟误差。

11 字节、8N1 报告的理论时间从 110/115200=0.954861 ms 缩为 110/300000=0.366667 ms，单份节省 0.588194 ms。重复报告还可能占据串口带宽，连续换键时应实测积压；不能据单份帧计算宣称整个键盘延迟固定。现有报告去重应保留，不能等待几份重复报告再确认，也不提前使用未收完的报告推测松键。

其次核对 PCM5102A 的 FLT。TI SLAS859C 第 4、5 页明确：FLT 为低选择正常滤波，为高选择低延迟滤波；48 kHz 下典型数字滤波延迟从 20/Fs=0.416667 ms 降为 3.5/Fs=0.072917 ms，节省 0.343750 ms。46.875 kHz 下对应 0.426667、0.074667 ms，节省 0.352000 ms。这是数字滤波段的典型值，不能当作整个 DAC 模拟输出总延迟。模块 FLT 的焊盘、上拉和现状尚未核对；如果已经为高，则没有这项额外收益。修改前核对模块电路，不能给已硬接地的焊盘直接接高电平。

正常演奏期间持续输出 BCK/LRCK，并保持 DAC 已初始化、解除硬静音。不要在每次 Note On 时才启用时钟、启动 PLL 或重新拉动 XSMT；断流唤醒和软静音恢复会引入额外等待。压力静音、暂停和尾音依然在样本域使用已有平滑控制。

串口提速和正常滤波改为低延迟滤波两项理论合计节省约 0.932 ms（48 kHz）；前提是实物均支持且当前确实没有采用这些配置。不能将它从 1.021 ms 仿真结果中直接全部扣除，因为原仿真未包含 DAC 延迟。
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
