Interstellar-530/PolyTouch-FPGA-Synth/docs/references/handoff-20261008/board_docs/dock3714_key_silkscreen.png

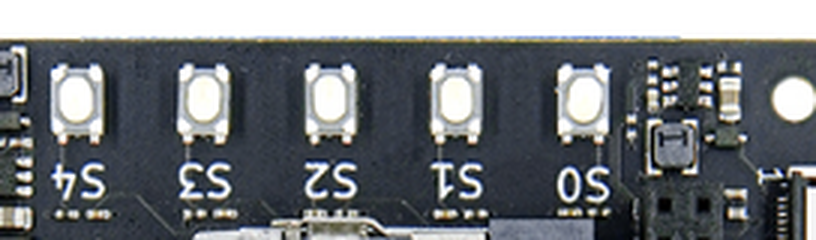
docs/references/handoff-20261008/board_docs/dock3714_key_silkscreen.png
