Interstellar-530/PolyTouch-FPGA-Synth/docs/references/handoff-20261008/board_docs/dock3714_usb_ports.png

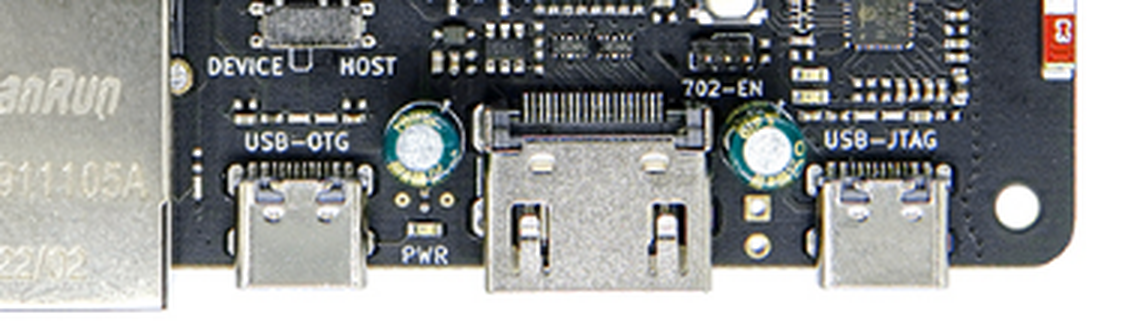
docs/references/handoff-20261008/board_docs/dock3714_usb_ports.png
