Interstellar-530/PolyTouch-FPGA-Synth/evidence/2026/10/FPGA-ch9350-port-label-20261028-v0.1/front-connector-shell.png

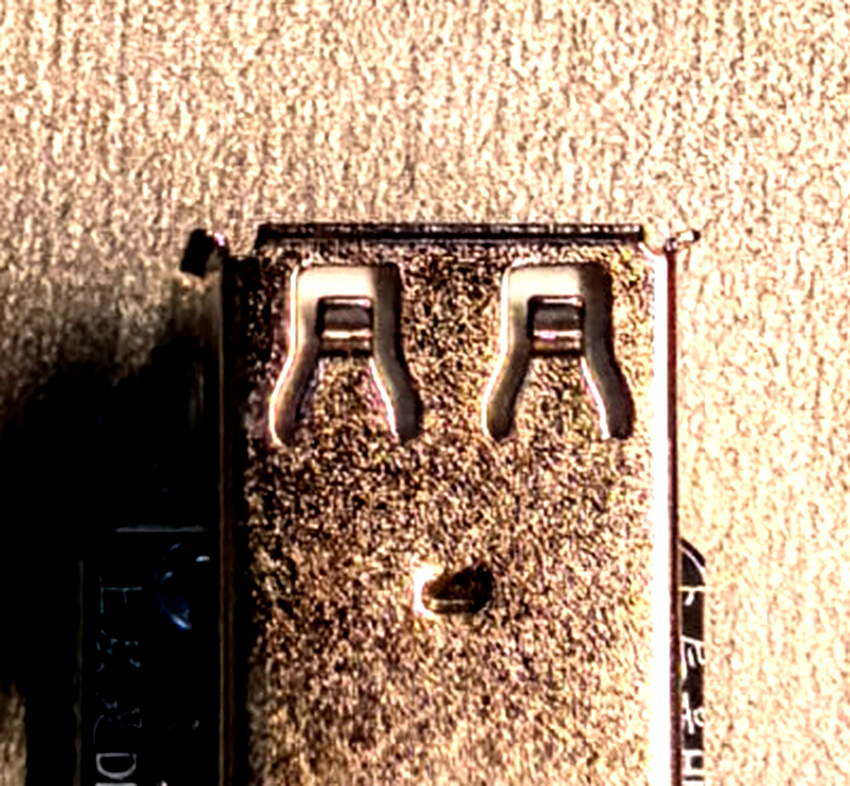
evidence/2026/10/FPGA-ch9350-port-label-20261028-v0.1/front-connector-shell.png
