Interstellar-530/PolyTouch-FPGA-Synth/evidence/2026/10/FPGA-S2-复核-20261014-v0.1/release_tail.png

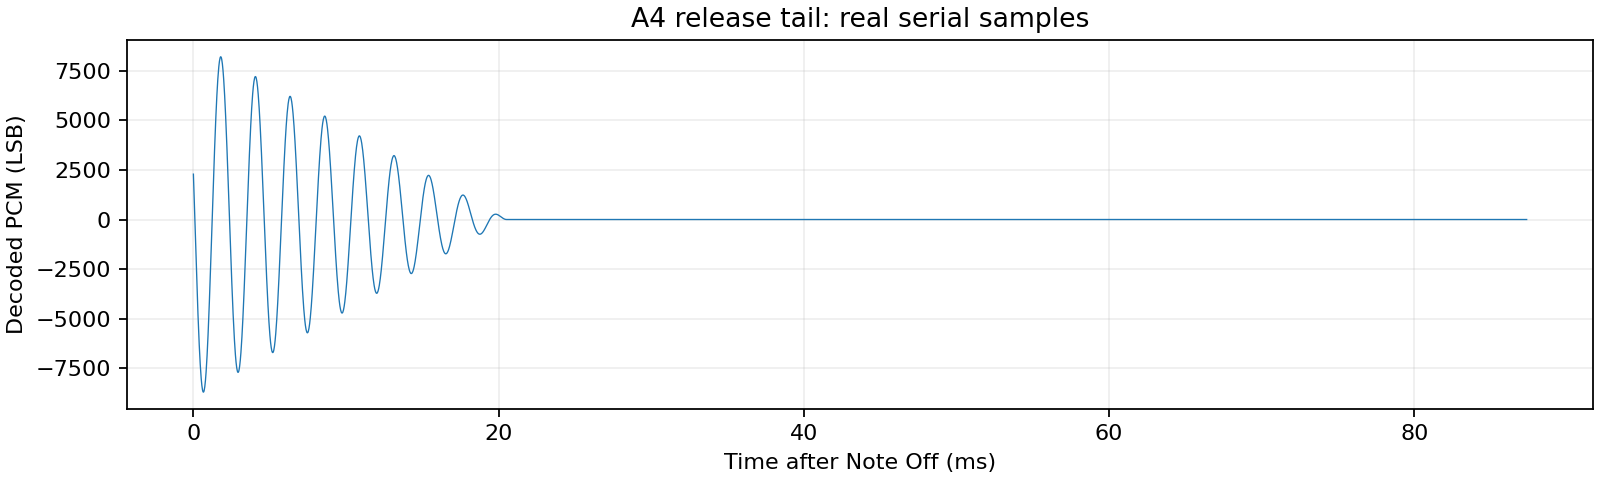
evidence/2026/10/FPGA-S2-复核-20261014-v0.1/release_tail.png
