Interstellar-530/PolyTouch-FPGA-Synth/evidence/2026/10/FPGA-S3-i2s-tx-20261014-v0.1/reference/pcm5102a-page15-左对齐.png

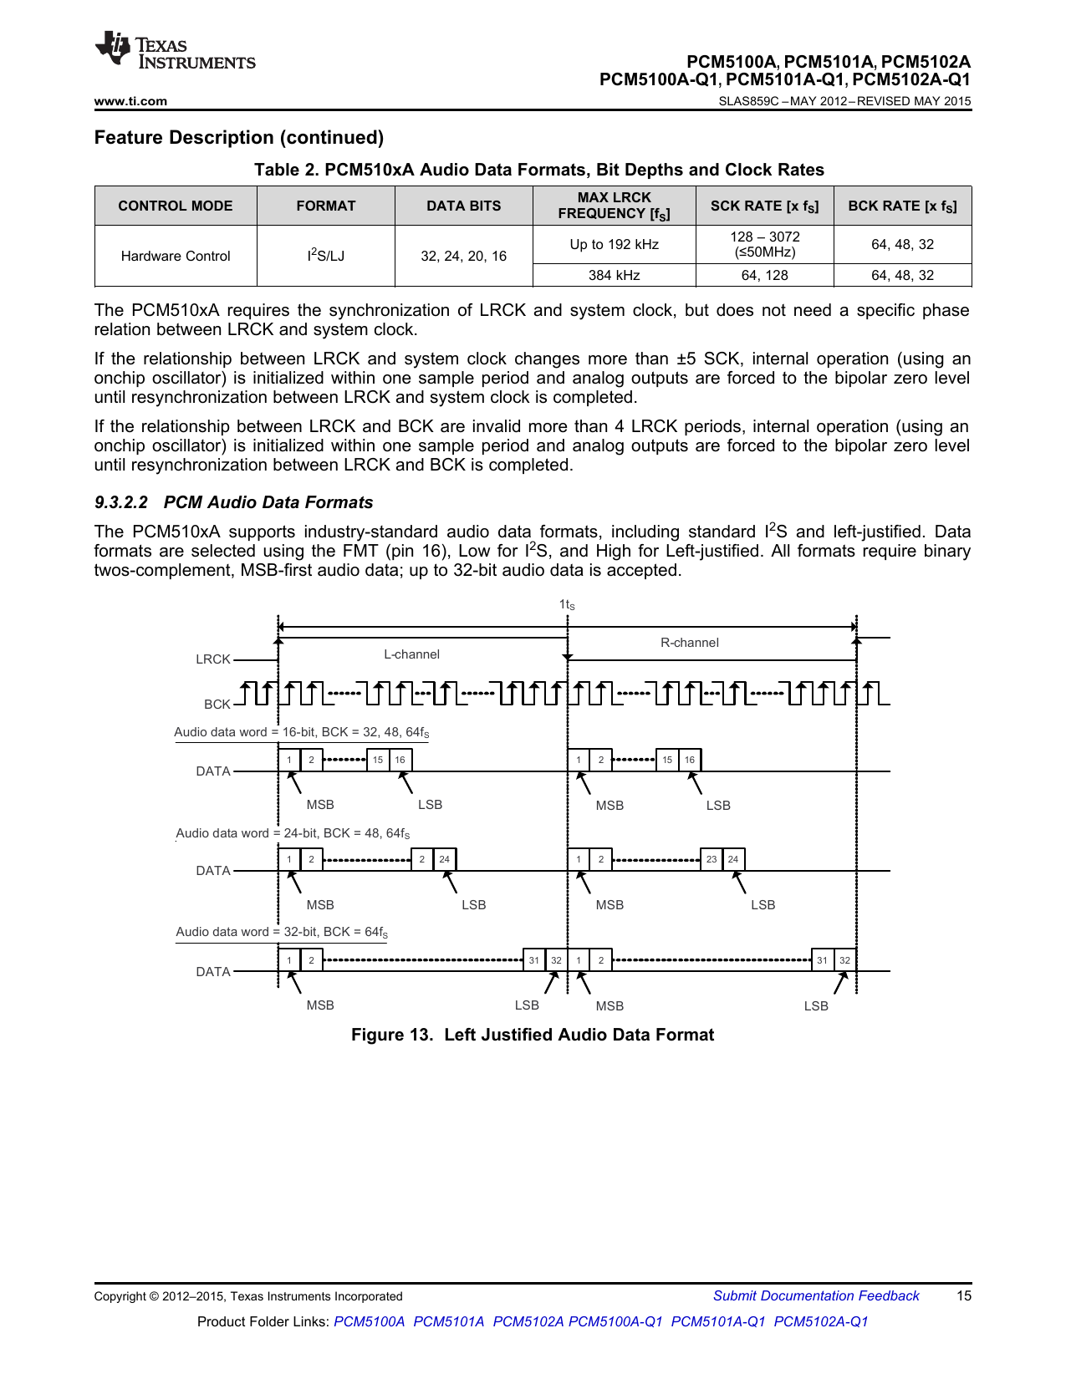
evidence/2026/10/FPGA-S3-i2s-tx-20261014-v0.1/reference/pcm5102a-page15-左对齐.png
