Interstellar-530/PolyTouch-FPGA-Synth/evidence/2026/10/FPGA-吉他音色预览-20261020-v0.1/guitar_timbre_comparison.png

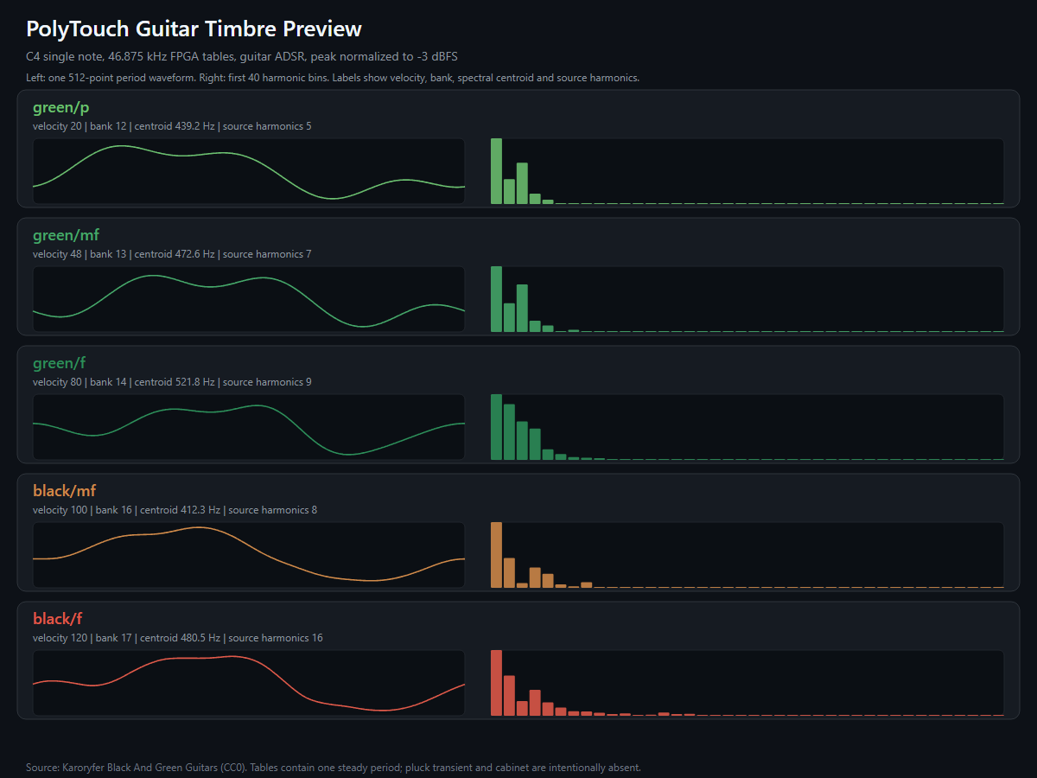
evidence/2026/10/FPGA-吉他音色预览-20261020-v0.1/guitar_timbre_comparison.png
