Interstellar-530/PolyTouch-FPGA-Synth/evidence/2026/10/FPGA-接线复核-20261018-v0.1/dock-p4.png

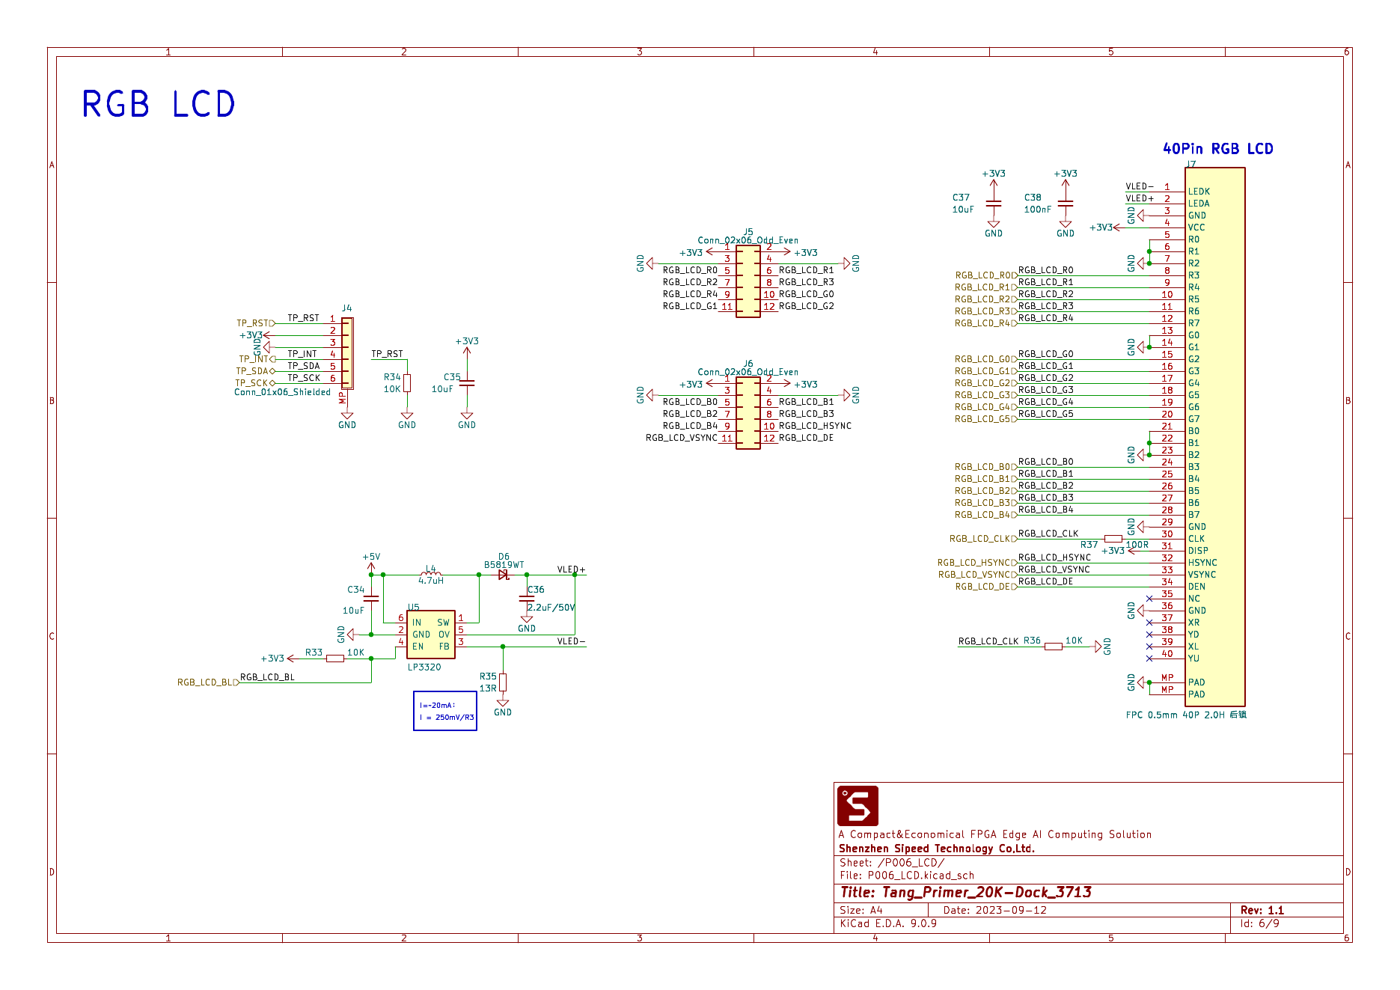
evidence/2026/10/FPGA-接线复核-20261018-v0.1/dock-p4.png
