Interstellar-530/PolyTouch-FPGA-Synth/evidence/2026/10/FPGA-钢琴音色-20261018-v0.1/keyboard-piano.png

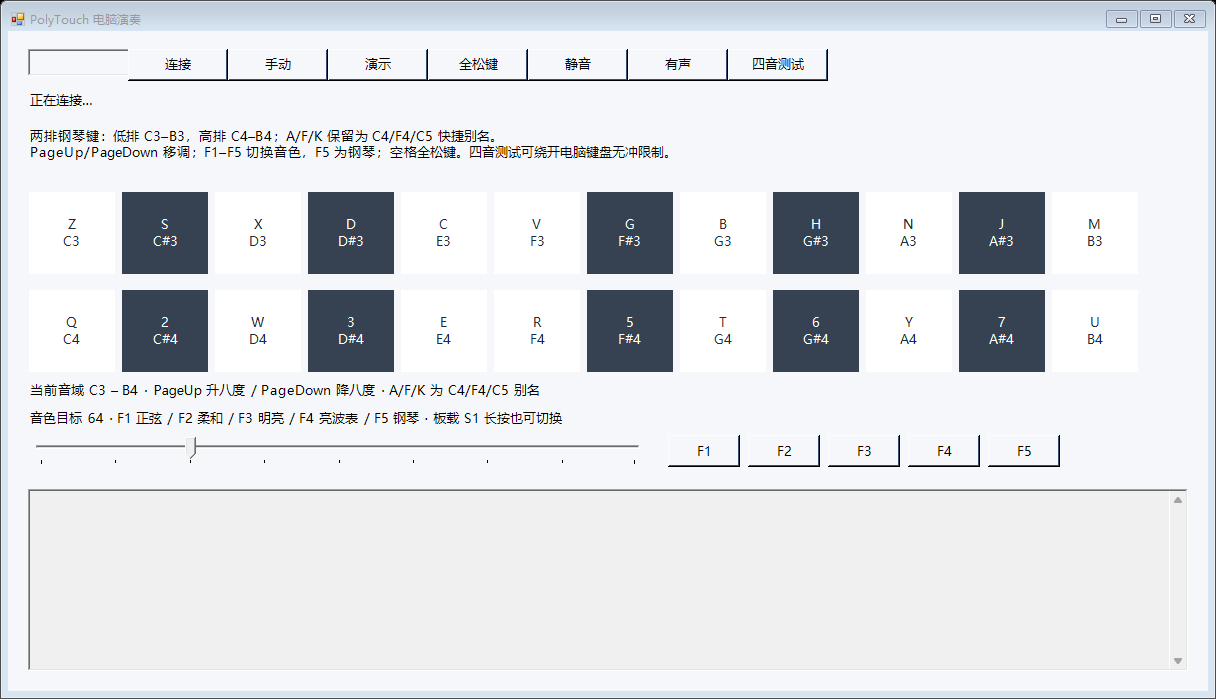
evidence/2026/10/FPGA-钢琴音色-20261018-v0.1/keyboard-piano.png
