Interstellar-530/PolyTouch-FPGA-Synth/evidence/2026/10/FPGA-音色控制-20261016-v0.1/keyboard-preview.png

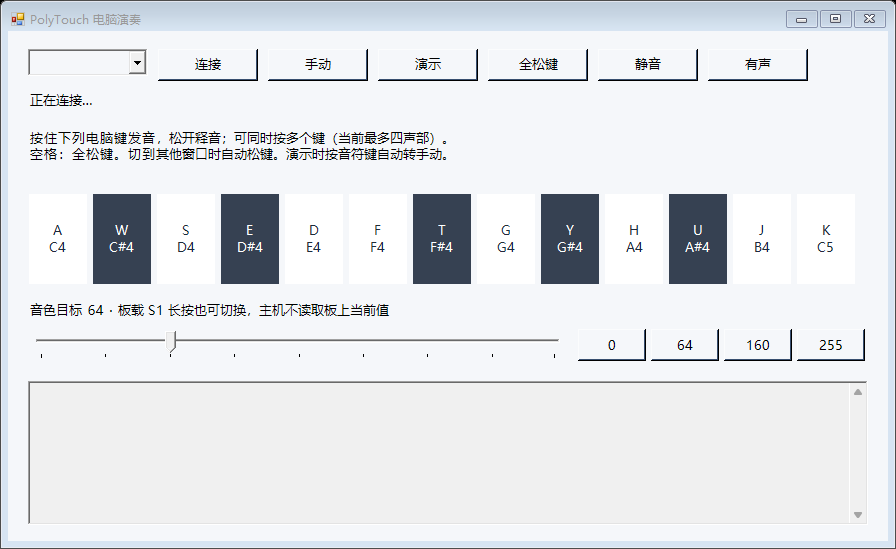
evidence/2026/10/FPGA-音色控制-20261016-v0.1/keyboard-preview.png
