Interstellar-530/PolyTouch-FPGA-Synth/evidence/2026/10/s4-review-20261015/mcp3208-frame-20261015.png

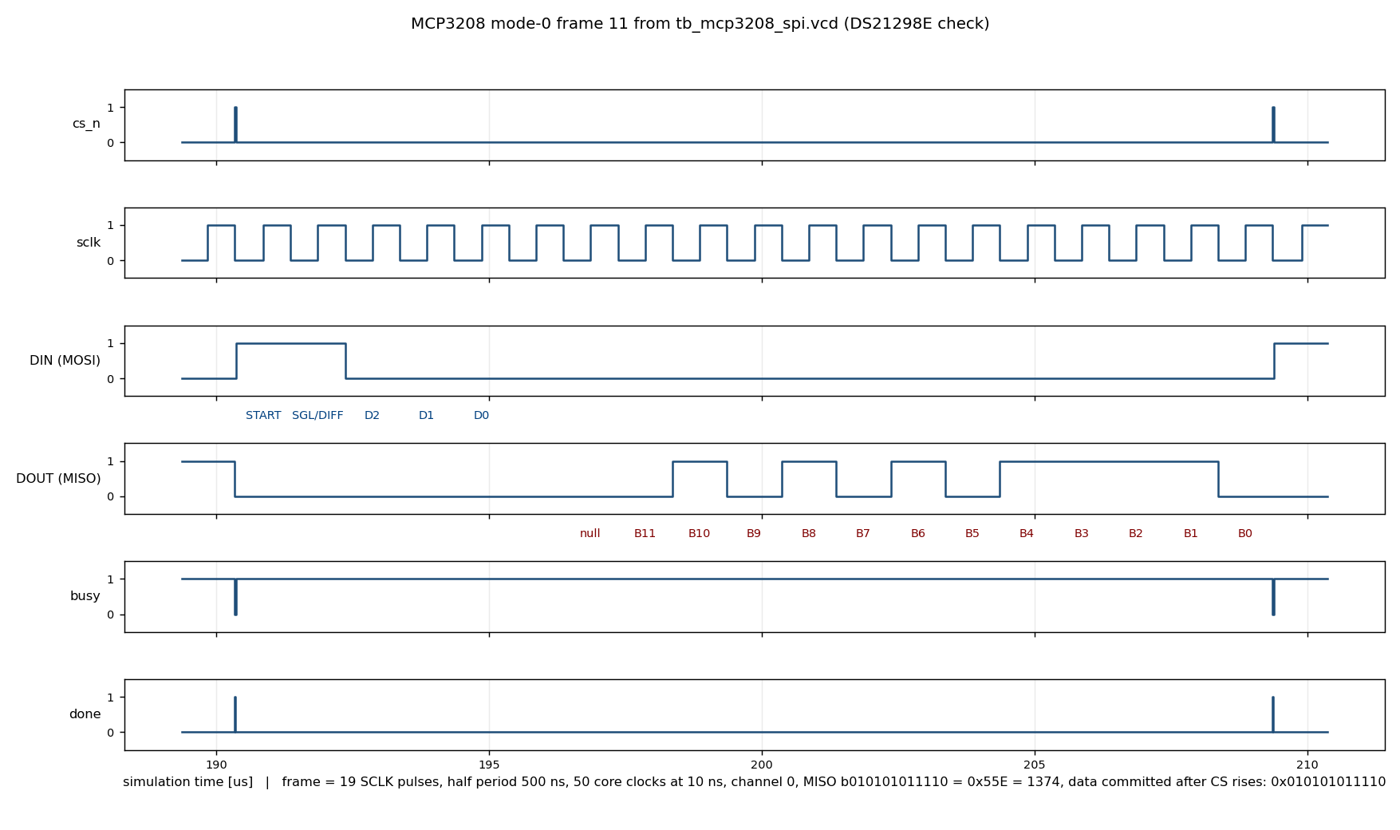
evidence/2026/10/s4-review-20261015/mcp3208-frame-20261015.png
