Interstellar-530/PolyTouch-FPGA-Synth/releases/2026/10/FPGA-20261030-v0.1/original-delivery/target/01-overview-light.png

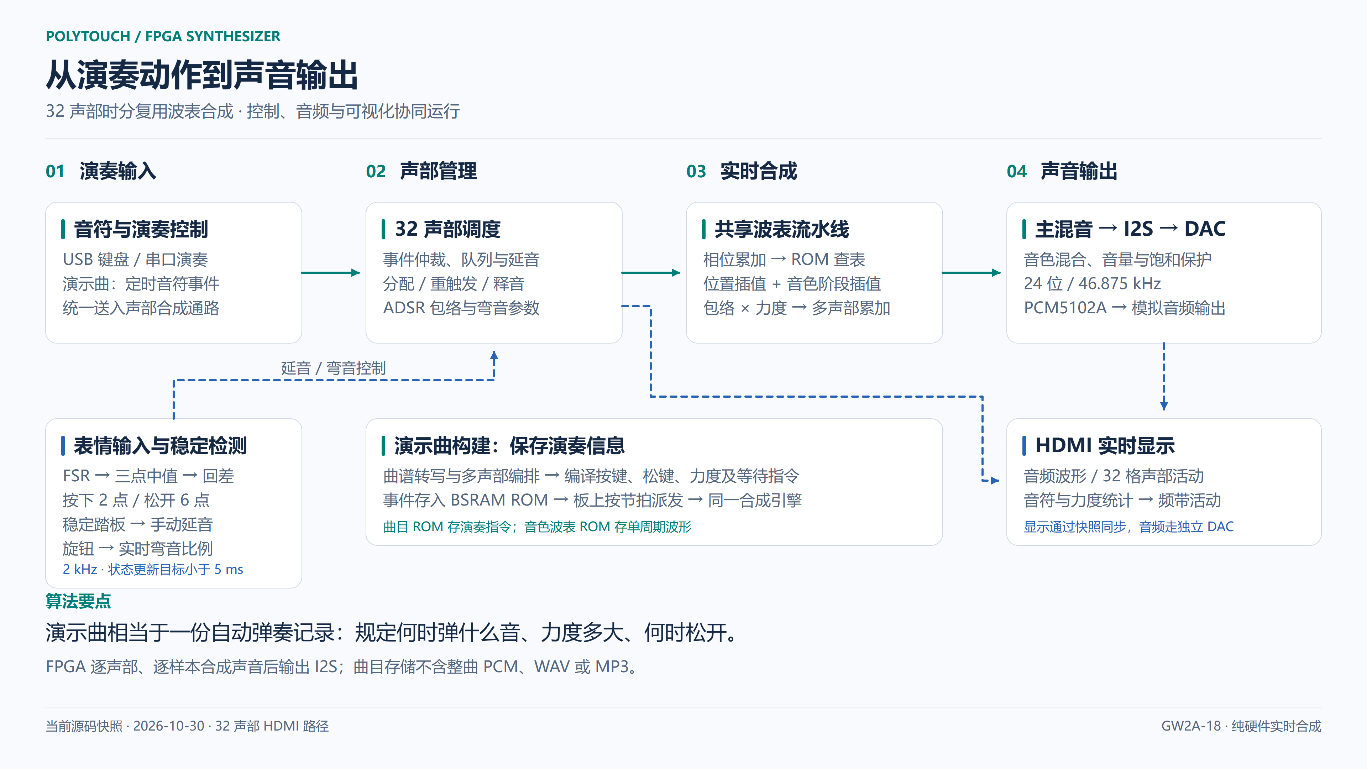
releases/2026/10/FPGA-20261030-v0.1/original-delivery/target/01-overview-light.png
