Interstellar-530/PolyTouch-FPGA-Synth/releases/2026/10/FPGA-20261030-v0.1/original-delivery/target/02-signal-flow-detail.png

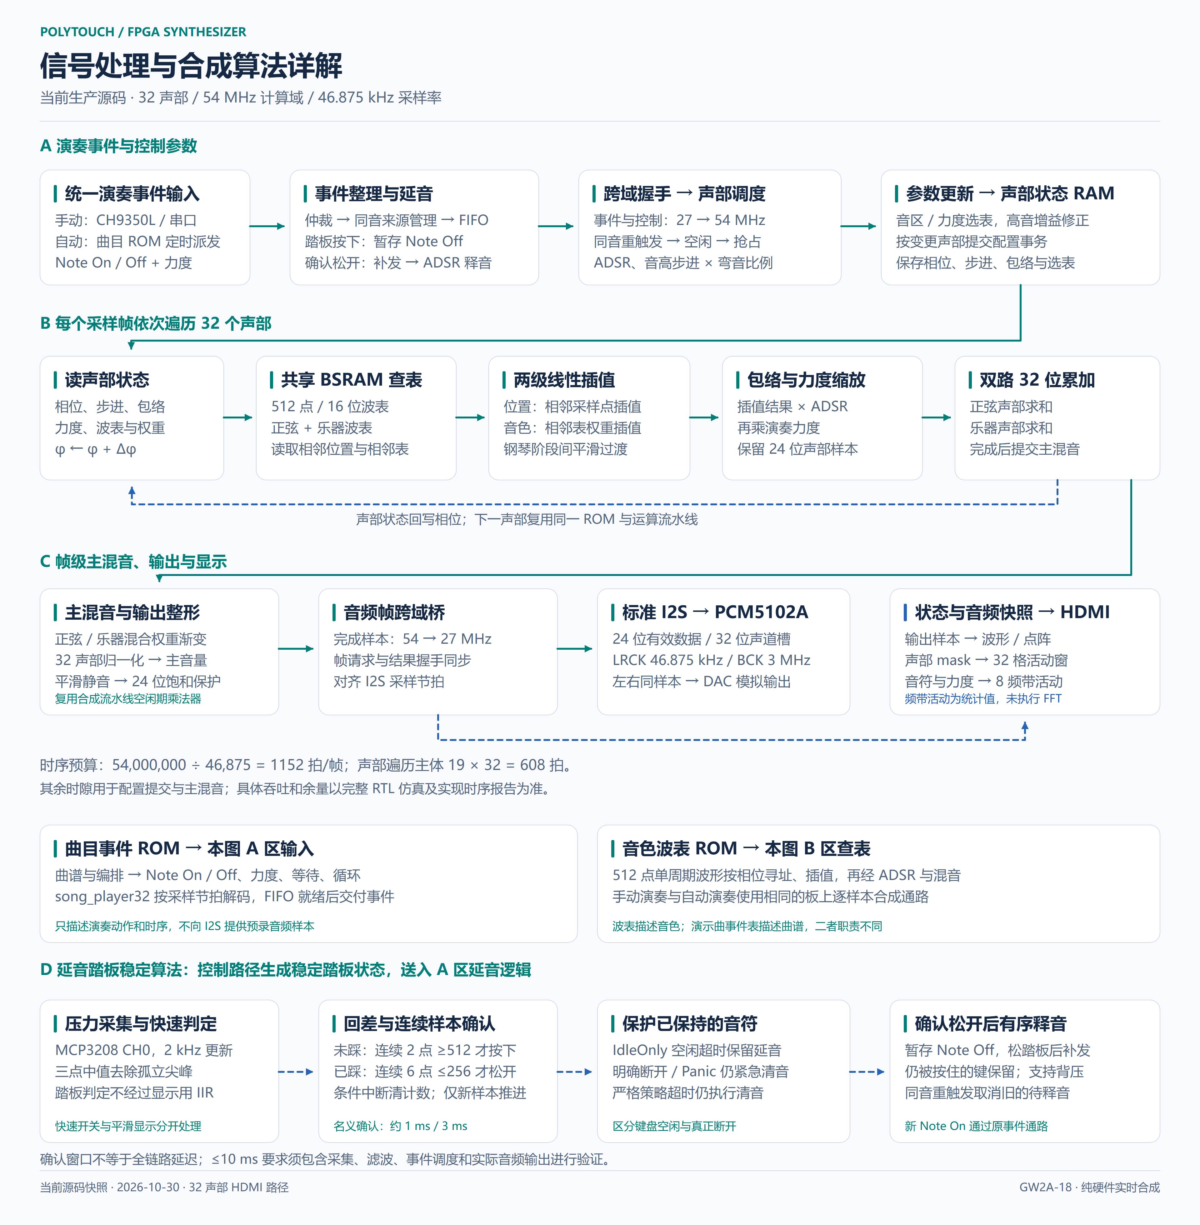
releases/2026/10/FPGA-20261030-v0.1/original-delivery/target/02-signal-flow-detail.png
