Interstellar-530/PolyTouch-FPGA-Synth/releases/2026/10/FPGA-20261030-v0.1/original-delivery/target/04-sustain-stability.png

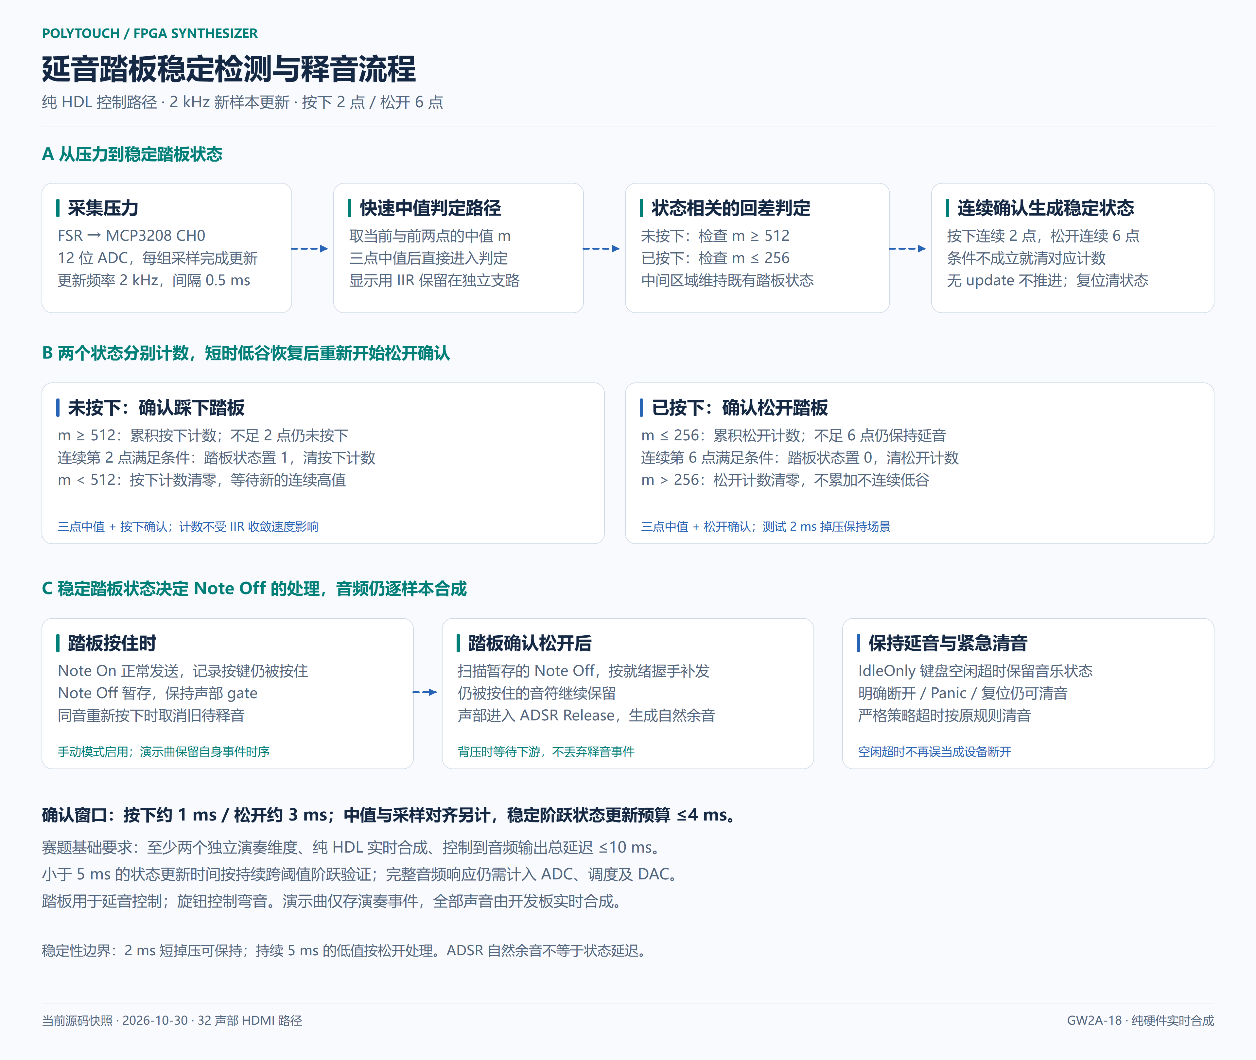
releases/2026/10/FPGA-20261030-v0.1/original-delivery/target/04-sustain-stability.png
