Interstellar-530/PolyTouch-FPGA-Synth/docs/planning/可自行购买外设与耗材清单-20261010.md

# 可自行购买外设与耗材清单

日期：2026-10-10

说明：本清单列需要外设但可以自己采购的部分，按"最低实现必需、连接与供电、可自购的调试仪表、增强项、备用件"分组。价格为 2026 年国内电商的大致量级，仅供估算。已有表格 `外设采购清单-20261010.xlsx` 列出了更细的型号与单价，这里补充的是分组、优先级和采购注意点。

## A 组 赛题最低实现必需

| 物品 | 数量 | 用途 | 参考价格 | 优先级 | 采购注意 |
| --- | --- | --- | --- | --- | --- |
| MPR121 电容触摸模块 | 1 | 12 路触摸键，第一演奏维度 | 15～30 元 | 最高 | I2C 3.3 V，模块通常自带 4.7 kΩ 上拉，买前确认，避免和板端重复上拉 |
| 触摸电极与引线 | 12 套 | 接 MPR121 的 12 个通道 | 20～50 元 | 最高 | 铜箔胶带、导电布或弹簧片都行，电极面积越大越灵敏 |
| MCP3208 ADC 模块 | 1 | 读 FSR 压力，第二演奏维度 | 10～20 元 | 高 | SPI mode 0，12 位，8 通道，只用到通道 0 |
| FSR 402 压力传感器 | 1～2 | 力度或持续音量 | 15～40 元 | 高 | 需要配一个 10 kΩ 分压电阻，响应非线性，要标定 |
| PCM5102A I2S DAC 模块 | 1 | 赛题要求的正式音频出口 | 25～60 元 | 高 | FMT 跳线选标准 I2S，模块最好自带 3.3 V 稳压 |
| 12.288 MHz 有源晶振 | 1 | 产生标准 48 kHz 采样率和 I2S 时钟 | 5～15 元 | 高 | 3.3 V CMOS 输出，表贴款要配转接板 |

## B 组 连接、供电与基础耗材

| 物品 | 数量 | 用途 | 参考价格 | 采购注意 |
| --- | --- | --- | --- | --- |
| 面包板 | 1～2 块 | 搭外设电路 | 10～30 元 | 830 孔规格够用，时钟线尽量短 |
| 杜邦线、跳线 | 各一包 | 连线 | 15～30 元 | 公对母、母对母、公对公各一包 |
| PMOD 转接板 | 1 | 把 Dock 的扩展口引到面包板并分配 3.3 V 与地 | 10～25 元 | Dock 是 2.54 mm 排针，成品 PMOD 转杜邦也可 |
| 3.5 mm 双公头音频线 | 1 | 把耳机口接进电脑声卡做频谱 | 10～20 元 | 没有它也可用手机录音替代 |
| 5 V/2 A 独立电源或充电宝 | 1 | 断开与电脑的地环路，做底噪对照 | 30～80 元 | 对照实验的关键件，优先买 |
| 12 V DC 电源适配器 | 1 | 用底板 DC-IN 座 J13 供电 | 20～40 元 | 插头 5.5×2.1 mm、中心正极，与板上 J13 匹配 |
| 电阻电容包 | 各一套 | 时钟串阻、电源去耦、分压 | 20～40 元 | 需要 22～100 Ω、10 kΩ、100 nF、1 µF |
| 数字万用表 | 1 | 确认 Bank 电压、共地、分压电阻 | 30～80 元 | 最基础的测量工具 |
| 焊接工具（电烙铁、焊锡、助焊剂） | 1 套 | 焊接排针、晶振转接板 | 50～150 元 | 若实验室已有可跳过 |

## C 组 可自购的调试仪表

这一组用来替代实验室里的大设备，覆盖数字总线解码和音频输入，成本低但很实用。

| 物品 | 数量 | 用途 | 参考价格 | 覆盖的仪器任务 |
| --- | --- | --- | --- | --- |
| 24 MHz 八通道 USB 逻辑分析仪 | 1 | 抓 I2C、SPI、I2S、UART，验证触摸和 ADC 是否真的通了 | 30～60 元 | D-03、D-04、D-05、D-06 |
| USB 声卡或声卡输入线 | 1 | 把耳机口接进电脑，用免费软件看频谱和失真 | 30～100 元 | D-08 |

## D 组 增强项

有余力再买，不影响最低实现。

| 物品 | 用途 | 参考价格 |
| --- | --- | --- |
| 第二块 MPR121 | 扩到 24 键或双排键盘 | 15～30 元 |
| 旋转编码器 | 调总音量、音色、效果量，比按键顺手 | 5～15 元 |
| SPI OLED 或 0.96 寸 LCD | 显示当前音高、声部数、延迟 | 15～40 元 |
| WS2812 灯带 | 硬件可视化反馈，对应赛题扩展项 | 15～40 元 |
| MIDI DIN 插座或 USB-MIDI 模块 | 用标准 MIDI 键盘当输入，答辩观感好 | 20～60 元 |

## E 组 备用件

12.288 MHz 有源晶振和它的转接板建议各多备一份，焊接失败时可以直接替换，避免整块板子等件。MPR121 触摸电极的耗材也建议多备，铜箔胶带和导电布容易在调试中损耗。

## 采购顺序建议

先买 A 组和 B 组，把演奏界面和正式音频出口搭起来，这是赛题最低实现的最后两块拼图。C 组在需要验证总线时再买，逻辑分析仪越早到手越好，因为它能覆盖四项仪器任务。D 组和 E 组按进度和预算灵活处理。A 组到货前，可以先按《零外设可实施功能与设计-20261010.md》把四声部复音、测试模式、多音色和效果器做完，等外设到货只需接线和调试。
