Interstellar-530/PolyTouch-FPGA-Synth/docs/reviews/FPGA-20261012-v0.1/FPGA外设复查清单-20261012-v0.1.xlsx

Sheet: 采购清单
PolyTouch FPGA Synth 外设复查清单
2026-10-12｜预算沿用10月10日清单；新增件为占位价，未实时询价。库存与借用待确认。
 | 自行购买预算（含P2） |  |  |  |  | ¥508.00 | 空单价表示未询价，借用及自有项不计采购总额。
 | 其中P0预算 |  |  |  |  | ¥241.00 | 先落实P0，再做P1；P2按验收进度取舍。
编号 | 分组 | 物料 | 建议数量 | 单位 | 预算单价(元) | 预算小计(元) | 优先级 | 库存状态 | 获取计划 | 接口与采购核对 | 依据
P01 | 演奏输入 | MPR121 12路触摸模块 | 1 | 块 | 12.00 | 12.00 | P0 | 待核对 | 自行购买 | 3.3V I2C；确认上拉及芯片型号 | S1/S3
P02 | 演奏输入 | 触摸电极与细导线 | 12 | 套 | 3.00 | 36.00 | P0 | 待核对 | 自行购买 | 铜箔或导电布；按最终面板标定 | S1
P03 | 演奏输入 | FSR402压力传感器 | 1 | 个 | 20.00 | 20.00 | P0 | 待核对 | 自行购买 | 与电阻分压；只作相对力度标定 | S1
P04 | 演奏输入 | 10kΩ分压电阻 | 10 | 个 | 0.30 | 3.00 | P0 | 待核对 | 自行购买 | FSR分压；阻值按有效范围调整 | S1
P05 | 演奏输入 | MCP3208 12位SPI ADC | 1 | 块 | 20.00 | 20.00 | P0 | 待核对 | 自行购买 | VDD/VREF=3.3V；先用≤1MHz SPI | S1/S4
P06 | 正式音频 | PCM5102A I2S DAC模块 | 1 | 块 | 35.00 | 35.00 | P0 | 待核对 | 自行购买 | FMT低选I2S；线电平输出需负载适配 | S1/S5
P07 | 正式音频 | 12.288MHz有源晶振及转接 | 1 | 套 | 15.00 | 15.00 | P0 | 待核对 | 自行购买 | 3.3V CMOS；J14-10/T7候选，需实测 | S1/S2
P08 | 正式音频 | 耳机功放模块 | 1 | 块 | 25.00 | 25.00 | P0 | 待核对 | 自行购买 | 配合现有耳机；有源音箱可替代 | S5/S7
P09 | 第三维控制 | B10k线性电位器及旋钮 | 1 | 套 | 5.00 | 5.00 | P1 | 待核对 | 自行购买 | 接ADC CH1；连续弯音，独立于力度 | S7
P10 | 连接供电 | 830孔面包板 | 2 | 块 | 20.00 | 40.00 | P0 | 待核对 | 自行购买 | 联调使用；最终时钟线短且固定 | S1
P11 | 连接供电 | 杜邦线综合套装 | 1 | 套 | 20.00 | 20.00 | P0 | 待核对 | 自行购买 | 含公母、公公、母母；固定并标线 | S1
P12 | 连接供电 | 去耦电容与串阻套装 | 1 | 套 | 15.00 | 15.00 | P0 | 待核对 | 自行购买 | 100nF/1µF、22–100Ω、4.7kΩ | S1
P13 | 连接供电 | 5V/2A USB电源或充电宝 | 1 | 个 |  |  | P0 | 待核对 | 自有或借用 | USB供电；与PC接线时仍可能共地 | S2/S6
P14 | 调试证据 | 数字万用表 | 1 | 台 |  |  | P0 | 待核对 | 实验室借用 | 确认3.3V/1.5V电源域及分压 | S1/S2
P15 | 调试证据 | 8通道USB逻辑分析仪 | 1 | 台 | 50.00 | 50.00 | P1 | 待核对 | 自行购买 | ≥24MS/s；抓I2C/SPI/I2S/UART | S1
P16 | 调试证据 | 3.5mm立体声音频线 | 1 | 根 | 10.00 | 10.00 | P1 | 待核对 | 自行购买 | 匹配DAC、功放与声卡接口 | S1
P17 | 调试证据 | USB声卡（真正线路输入） | 1 | 个 | 80.00 | 80.00 | P1 | 待核对 | 自行购买 | ≥48kHz录音；关闭AGC；确认输入幅度 | S6/S7
P18 | 调试证据 | 线路输入衰减连接组件 | 1 | 套 | 10.00 | 10.00 | P1 | 待核对 | 自行购买 | 按声卡满量程配衰减，避免录音削波 | S5/S7
P19 | 调试证据 | ≥50MHz示波器 | 1 | 台 |  |  | P1 | 待核对 | 实验室借用 | 模拟噪声、总延迟及输出边沿 | S1
P20 | 调试证据 | 焊台与焊接耗材 | 1 | 套 |  |  | P1 | 待核对 | 实验室借用 | 焊接晶振、排针及固定接线 | S1
P21 | 结构固定 | 洞洞板、底板及紧固件 | 1 | 套 | 30.00 | 30.00 | P1 | 待核对 | 自行购买 | 冻结前固定电极、压力垫与地线 | S7
P22 | 备用件 | 12.288MHz晶振备用套装 | 1 | 套 | 15.00 | 15.00 | P1 | 待核对 | 自行购买 | 型号及供电与主件一致 | S1
P23 | 可选扩展 | EC11旋转编码器 | 2 | 个 | 5.00 | 10.00 | P2 | 待核对 | 自行购买 | 菜单与参数控制；演奏第三维用电位器 | S1
P24 | 可选扩展 | 0.96寸SPI OLED | 1 | 块 | 15.00 | 15.00 | P2 | 待核对 | 自行购买 | 确认是真SPI及驱动型号，3.3V逻辑 | S1
P25 | 可选扩展 | 12灯WS2812灯带 | 1 | 条 | 15.00 | 15.00 | P2 | 待核对 | 自行购买 | 先用板载灯；外接灯考虑电平转换 | S1/S2
P26 | 可选扩展 | 74AHCT电平转换小板 | 1 | 块 | 5.00 | 5.00 | P2 | 待核对 | 自行购买 | 外部5V灯带数据电平适配 | S7
P27 | 可选扩展 | DIN MIDI输入及6N138组件 | 1 | 套 | 10.00 | 10.00 | P2 | 待核对 | 自行购买 | 光耦输入；FPGA侧上拉到3.3V | S1
P28 | 可选扩展 | 第二片MPR121模块 | 1 | 块 | 12.00 | 12.00 | P2 | 待核对 | 自行购买 | 扩24键需不同地址；增加总线与延迟预算 | S1/S3
P29 | 可选供电 | 12V直流适配器 | 1 | 个 |  |  | P2 | 待核对 | 自有或借用 | 只接J13；插头尺寸和极性实物核对 | S2
P30 | 可选声音 | 有源音箱 | 1 | 套 |  |  | P2 | 待核对 | 自有或借用 | 可替代P08耳机功放；不重复计采购 | S5/S7
可替代件：有源音箱可替代P08；板载RGB灯可先替代P25/P26。P2全部为可选。详细复查与来源见第二页。

Sheet: 板载资源与复查
板载资源与采购复查
项目 | 数量与规格 | 当前状态或用途 | 复查结论 | 依据
主控 | GW2A-LV18PG256C8/I7，版本C | 已有核心板 | 使用Gowin V1.9.11.03 Education | S2/S8
逻辑与寄存器 | 20736 LUT4；15552逻辑FF | 重建：4573逻辑单元、789总寄存器 | 资源报告总寄存器口径含621个I/O寄存器 | S2/S8
BSRAM | 46块，每块18Kbit | 重建：4块pROM | 可为共享波表、效果缓冲继续分配 | S2/S8
乘法资源 | 48个18×18；24个DSP宏块 | 重建：12个MULT18X18、6个DSP | 不能把24个DSP写成24个18×18乘法器 | S2/S8
DDR3 | 1Gbit，128MiB | 板载H5TQ1G63系列，64Meg×16 | 旧清单64MB应修正；不用于逐样本波表 | S2
配置存储 | 32Mbit SPI NOR Flash | 板载，已有可发声测试程序 | 本次没有改写Flash或SRAM | S2/S8
时钟 | 27MHz板载；4个PLL | 当前46.875kHz调试采样率 | 27MHz整数分频无法得到精确48kHz | S2/S8
外部音频时钟入口 | J14第10脚→MIC_DAT3→T7/GCLKT_3 | 图纸已核对，Bank3默认3.3V | 未接麦克风时可作为候选，先实测连通及电压 | S2
PT8211与耳机口 | PT8211-S及LPA4809功放 | 已有，当前可听到声音 | 右对齐调试接口；正式方案用标准I2S | S2/S8
调试USB | Dock USB-JTAG Type-C | COM13，115200 8N1，收到ERR | 当前串口往返正常；不用另购USB-UART | S2/S8
UART引脚 | TX=M11，RX=T13，Bank2 3.3V | 与当前CST及3714原理图一致 | 旧文档N6/N7是LCD引脚，不能照接 | S2/S8
用户LED | 6个橙色LED及1个RGB灯 | 已有；先用于状态与节奏指引 | 不必为基础可视化额外购买灯带 | S2
按键与拨码 | 5用户键、5位拨码、BL702升级键 | 3714的SW0与KEY4引脚互换 | SW0为C7用户输入；KEY4为B10重配置 | S2
BL702设置 | SW1为升级Boot键；J16关断跳线 | 正常调试不按Boot键、不短J16的2–3 | 这些设置会影响桥接；当前串口正常 | S2
I/O电压 | Bank2=3.3V；按键域含1.5V | 扩展口先按具体引脚核对 | 外部3.3V传感器不接T2/T3/D7等1.5V域 | S2/S8
扩展排针 | 4个2.54mm PMOD口 | 已有，无需另买PMOD转接板 | 直连可用；机械固定适配板为可选 | S2
以太网 | RTL8201F，10/100Mbps | 已有，目前未使用 | 旧清单千兆以太网应修正 | S2/S9
显示与摄像接口 | RGB LCD、DVP、麦克风阵列、TP | 已有连接器，未确认有配套模块 | 连接器不代表屏幕或传感器已随板提供 | S2
PCM5102A输出 | 约2.1Vrms线路输出，支持三线I2S | 需新模块及适配负载 | 耳机需功放；FMT低、XSMT及供电核对 | S5
触摸供货 | NXP MPR121官方页面标记Archived | 现货模块仍需核对真实型号 | 本任务未查询实时库存，不保证供货 | S3
预算口径 | 旧预算及新增规划占位价 | 借用、自有项空价不计采购总额 | 不是实时报价；借不到设备须另计费用 | S1/S6/S7
来源编号 | 来源 | 口径 | 定位或链接
S1 | 2026-10-10原外设Excel | 历史预算；P08/P09/P18/P21/P26为新增规划占位价 | 外设采购清单-20261010.xlsx
S2 | Sipeed原理图与规格书 | Dock3714、SOM3961及规格书已转Markdown并视觉核对 | https://wiki.sipeed.com/hardware/en/tang/tang-primer-20k/primer-20k.html
S3 | NXP MPR121 | 芯片资料、滤波及Archived状态 | https://www.nxp.com/products/MPR121
S4 | Microchip MCP3208 | 12位ADC，供电和SPI速度须按电压降额 | https://www.microchip.com/en-us/product/mcp3208
S5 | TI PCM5102A | I2S、内部PLL及线路输出负载 | https://www.ti.com/product/PCM5102A
S6 | 2026-10-10外设与耗材Markdown | 声卡、电源和耗材范围为历史估计 | 可自行购买外设与耗材清单-20261010.md
S7 | 2026-10-12审查建议 | 新增器件的单价只是可编辑预算占位，需自行询价 | FPGA项目进展与月底方案-20261012-v0.1.md
S8 | 2026-10-12本机复验 | GitHub主分支、RTL、综合时序与串口往返证据 | https://github.com/Interstellar-530/PolyTouch-FPGA-Synth
S9 | Sipeed官方接口说明 | Dock RTL8201F为10/100Mbps以太网 | https://github.com/sipeed/TangPrimer-20K-example
