Interstellar-530/PolyTouch-FPGA-Synth/docs/planning/FPGA-无硬件双人并行优化清单-20261024-v0.1.md

# 无硬件条件下的双人并行优化清单

日期：2026-10-24，v0.1。适用于两人目前只能使用电脑、不能核验实体立体声和可视化、没有测量设备的阶段。本轮交付为规划、分工提示词和依据记录，不实施 RTL 修改。

建议你负责音频数据通路、波表和最终集成，队友负责事件调度、表情控制和演奏事件功能。双方沿现有配置接口开发，用各自的测试台代替另一侧，最后合入同一个版本。立体声、彩屏、硬件 FFT、灯光驱动移出本阶段主线，评测使用 Icarus 自检和 Python 数值对照即可。

## 1. 起点与交付目标

正式源码根目录记为 S：`E:/Working Space/FPGA/source`。当前分支是 `codex/v2.1.1-integration-20261022`，HEAD 为 `67a9aaf7a98a51e991be760badc0b3177f40fd7f`。工作区存在未提交修改，**不能只从这个 HEAD 创建两份开发副本，就假定已经包含最新修复**。先完成 G0 的共同基线，再分工。

2026-10-23 的 `archive/FPGA-20261023-v0.8` 保存了后续核心修复。本轮核对了三组门禁记录各自的 328 个归档输入哈希，并抽查九个当前关键文件与归档一致；没有重新运行 RTL 仿真或 PnR。以下性能属于该归档的既有证据，完整结果见本任务归档的 `evidence/baseline-audit.json`。

| 已有结果 | 证据与使用边界 |
|---|---|
| 完整 32 声部核心、压力/弯音/音量与整束控制跨域 | 已实现，不重新分配为开发任务；正式输入链的整合仍有工作 |
| 73.728MHz 计算、48kHz/24bit I2S | 每帧 1536 拍；不再使用旧路线中的 49.152MHz/1024 拍作为当前基线 |
| 最大已测帧尾 617/1536 拍 | 来自 2135 帧完整引擎测试；不代表所有尚未实现功能的最坏情况 |
| BSRAM 26/46，Fmax 75.564MHz | 既有核心 PnR，setup +0.330ns、hold +0.337ns，违例均为零；完整新组合须重测 |
| 3×MULT18X18、1×MULTALU36X18 | 厂商报告另记 DSP 2.5/24；与 18×18 等效数量分栏记录 |
| Ram32 5 项、Quick 18 项、兼容专项 4 项通过 | 归档记录通过，Full 未执行；本轮仅核对证据及输入指纹 |

主目标固定为 32 个完整独立声部，48kHz/24bit 输出，两类音色和可解释的音色细节，可靠的压力/弯音/力度控制，以及一套纯 HDL 的自动演奏测试模式。扩展第三维表情、单声道延迟和琶音器时，先保证主目标合流，不增加声部数量。

[高云官方赛题](https://www.gowinsemi.com.cn/university/match2026)要求基础复音至少 4、纯 HDL 实时合成、实时变调/ADSR/混音、至少二维交互、I2S 和总延迟不超过 10ms；拓展方向包括 32 复音、三维表情、多音色、效果器、低延迟和视觉反馈。吞吐量按同时可闻独立振荡器数乘实际输出采样率计算。32×48000=1,536,000 振荡器样本/秒是本阶段配置目标，须证明每个声部独立参与输出。

这些软件工作能覆盖和加强其中的数字部分。真实传感器交互、模拟音质、上电稳定性及物理动作到声音的总延迟，当前都保留待验证状态。

## 2. 先冻结边界，保证两人互不阻塞

G0 由你牵头，两人约用 1—2 小时完成：核对现有未提交内容的归属，保存本轮需要的源码和证据，以一次明确的基线提交或双方一致的带 SHA256 源码包分发。不要直接提交整个 dirty 工作区，也不要覆盖其他任务文件。建议分支名为 `codex/offline-audio-20261024`、`codex/offline-control-20261024`；本轮只建议名称，未创建分支。

| 所有权 | 可修改的范围，路径相对 S | 另一人的使用方式 |
|---|---|---|
| 你：A 音频线 | `rtl/prototypes/instrument_ram_wavetable_engine.v`、`instrument_ram_audio_compute.v`、`instrument_rom_banks.v`；`rtl/audio/wide_master.v`、波表 HEX、Gowin ROM 包装和元数据；相关波表生成器 | 队友将这些文件视为只读，用带背压的配置接收模型开发 |
| 队友：B 控制线 | `rtl/prototypes/voice_sched32.v`、`ram32_control_front.v`；`rtl/audio/pressure_bend.v`、`bend_ratio_pipeline.v`；新增 `rtl/control_ext/` | 你将这些文件视为只读，用固定配置事务驱动音频核心 |
| 你：集成职责 | `rtl/top.v`、`rtl/prototypes/ram32_clocked_top.v`、`ram32_clocked_wrap.v`、新增 `rtl/integration32/`；全部 `build/`、`constraints/`、`sim/run_simulation.ps1`、根 README 与发布路标 | 队友提供需接入的文件清单和测试命令，不修改这些公共入口 |
| 双方各自的验证 | 你新增 `sim/opt_a/`、`tools/offline_opt/a/`；队友新增 `sim/opt_b/`、`tools/offline_opt/b/` | 原有共享测试台先只读；发现需修改时，交由你统一处理 |
| 各自的证据和输出 | `evidence/2026/10/offline-opt/A/` 与 `B/`；临时文件分属 `tmp/offline-opt-a/` 与 `b/` | 禁止共用同一个构建、捕获或指标输出目录 |

工作量不均时，可以把一项完整任务及其全部文件移交给另一人；不要两人同时修改同一个文件。

启动实现前，把下面的约定写入双方共同基线。本文件是待采用的实现约定，没有实际改变公共接口或数据格式。

| 边界 | 本阶段约定 |
|---|---|
| 事件输入 | 沿用 `ev_valid/ev_ready/ev_on/ev_note[6:0]/ev_vel[7:0]`。接受条件为同拍 valid 且 ready；等待时整包保持稳定。8 位事件力度到 7 位引擎力度的换算沿用当前口径并记录 |
| 调度器到引擎 | 保留现有 `cfg_valid/cfg_ready`、`cfg_voice[5:0]`、32 位增量、16 位包络、7 位力度、retrigger、24 位 param、3 位 mask 的宽度和语义。底层单 lane 的 5 位索引属于现有内部截取，不能误当全链接口 |
| param/波表布局 | 冻结当前 bank 与 weight 编码、bank 编号和 ROM 同步读延迟。A 可优化表值，B 不重新解释表编号；扩 bank、改布局或新增字段须先协商，再一起修订边界 |
| 时钟与采样 | 参考域 12.288MHz，计算域 73.728MHz，48kHz、1536 拍/帧，24 位有符号样本；采样使能必须恰为单拍 |
| 控制更新 | 保留整束快照跨域；持续弯音/压力不得重触发 ADSR。现有全局音色变更作用于持音的行为先保留，改成起音锁存属于另一个行为变更 |
| 延迟与完成 | 引擎每帧只提交一次样本；测试按 valid 和帧号核对，不把内部当前 19 拍/声部写成不可改变的接口要求 |
| 向后兼容 | 默认选项先保留既有行为；优化或新增模式应能单独关闭。不能靠删旧断言、缩窄支持音域、降低实际采样率使结果变好 |

## 3. 可直接领取的优化清单

P0 是本阶段必须合并的内容，P1 在 P0 稳定后选择，P2 暂缓。工时是开发与验证的人时估计，不是两人的日历承诺。

| 任务 | 负责人/优先级 | 具体优化与交付 | 无硬件验收 | 估计 |
|---|---|---|---|---|
| A1 定点与混音整理 | 你/P0 | 各级位宽、符号、舍入和饱和表；消除确有证据的冗余截位/组合长路径；保留共享流水 | 独立 64 位参考核对极值、负数、低力度和满 32 声部；零输入、零力度、静音精确零；饱和不回绕 | 6—10h |
| A2 波表与高音质量 | 你/P0 | 对现有 12 张钢琴、30 张吉他物理表做带限、相位和音量一致性优化；生成器、HEX、ROM 初始化和元数据同包 | 表长/范围/相位环绕/校验正确；固定音域和弯音上界下的谐波分析；相同响度的模型对照与短 RTL 对照 | 8—12h |
| A3 去爆音与过渡 | 你/P0 | 用现有 weight/增益路径处理表阶段与控制过渡，减少不必要的阶跃；不为每声部复制双套引擎 | 重按、换表、压力/音量阶跃和静音的短片段参考；关闭优化可对照；正常波形高频斜率不算爆音 | 6—10h |
| B1 调度和事件确定性 | 队友/P0 | 满声部窃声规则、重按/释放顺序、配置背压、脏参数更新；先修正确性，再减少无变化配置写入 | 32 起音、32 释放、重按、同拍控制、持续背压与复位；声部无卡死、无事件丢失；持音包络持续推进 | 8—12h |
| B2 表情控制数值优化 | 队友/P0 | 压力滤波、弯音映射、死区/迟滞及斜坡参数化；如需滑音/颤音，优先在现有相位增量配置路径实现 | ADC 0—4095 全范围及阶跃/尖峰/斜坡模型；单调有界、中心回正；持音变调不重起包络；报告响应样本数 | 6—10h |
| B3 脱机事件演奏与测试模式 | 队友/P0 | 新增纯 HDL 事件发生器：4 音/32 音测试、逐声部释放、两类音色对照和自动清音；输出既有事件接口 | 固定种子的事件序列和自检；产生独立声部并实际改变合成结果；只存音符/控制事件，不存整段音频 | 5—8h |
| B4 一键数字核查 | 队友/P0，贯穿开发 | 复用现有仿真与分析脚本，输出 `metrics.json`、简短报告和可选 WAV；A 的预期值由独立参考算法计算 | 主动注入错符号、丢样、双拍 tick、错 ROM 四种缺陷，检查器必须拒绝；不需要接串口或音频设备 | 4—6h |
| A4 合流与完整数字路径 | 你/P0，收口时 | 将 B 的交付接回完整 32 声部候选；用行为模型注入 UART/ADC，再经真实 I2S 序列化与独立接收模型解码 | Quick、Ram32、变更专项与一个完整演奏场景；新组合资源/PnR 报告；单一配置输出所有指标 | 6—10h |
| X1 第三维表情与单声道效果 | 一次只选一人/P1 | 独立亮度控制或一个短延迟；先在 Python 模型选择方案，再做独立 RTL 模块 | 亮度与压力/弯音可分别操控；延迟用冲激响应核对延时、反馈和衰减，全部可软件测量 | 另估 5—10h |
| X2 琶音器/事件循环 | 队友/P1 | 用分数节拍累加器实现 30—240BPM，支持暂停清音、变速和确定性回放 | 长时累计拍数用数学对照，短 RTL 验证边界；不等待实体 LED 或屏幕 | 另估 5—8h |

A0/G0 之后双方即可同时工作：A1—A3 用配置事务驱动器，B1—B3 用引擎接收模型与固定 ROM 元数据。B4 的框架也可以先对基线运行；A4 接入时才需要另一人的最终模块。核心工作约 A 26—42 人时、B 23—36 人时，另留共同基线和合流余量；不要求一天内完成全部项目。

### A 线的算法要求

A1 先建立算术约定，再决定是否改运算。例如 16 位有符号表的两个极值相减需要 17 位；32 路 24 位有符号样本求和至少需要 29 位，现有 32 位累加器应先证明有余量。乘法保留足够中间位宽，明确每次右移的舍入和负数行为。把可证明等价的窄加法/寄存拆分作为首选，不默认用更高阶插值、更宽数据或额外乘法器换取难以测出的收益。

A2 的频率约束按实际最大频率计算，包括弯音和新增调制的上界。512 点周期表的谐波数不超过 255；采用保守带限时可用 `H <= min(255, floor(0.45*Fs/f_max))` 作为生成上限，明确这是本项目的设计余量。先优化已有音区对应的表，保留 bank 编号。若确实需要增加音区/表数，单独提交存储预算和接口变更方案。仅在输出后加低通，不能证明已经消除查表产生的混叠。

先保留两类乐器，并精调四个确实不同的配置，再考虑八预设。当前 `start_stage=(tone>=3)?4:3` 只有两种起始阶段行为，不能把五个键位直接写成五种已验证音色。预设差异要落在实际包络、阶段或表混合参数上，保持既有全局换音色语义；持音是否切换不偷偷改变。

A3 分开检查换表、增益突变和重按，不给所有相邻样本统一设一个“越小越好”的差值阈值。高音正常波形本来就可能有大斜率。用连续参考及切换瞬间的额外残差比较过渡噪声，保护起音瞬态；如果更长的淡入只是把响应拖慢，就不应视为优化成功。A3 只修改数据通路的过渡处理；包络和表阶段定时仍由 B 维护，需要调整配置序列时交给 B，避免两侧重复平滑。

### B 线的算法要求

B1 在满声部时按明确的确定性顺序选择声部，例如空闲优先、释放中较弱者优先，再按固定优先级窃声；实际策略以基线约定为准。优化配置流量时，不能漏掉包络推进、表阶段变化和整帧弯音刷新。ready 拉低时，已提交事务保持稳定，更新保留在待处理状态；不要覆盖等待中的 Note Off。队列深度先根据最坏突发计算，再决定是否扩容。

B2 已有三点中值加一阶 IIR，不从零重写。用输入序列比较响应速度、静止抖动、中心偏置和低位舍入停滞，再决定是否增加内部小数位、迟滞或调整更新频率。全部 ADC 码可以在 Python 中扫完，RTL 只取边界和关键序列。无真实 FSR 数据时把阈值、ADC 中心和滤波参数做成可调项，不把人造噪声模型的最佳参数当成实物标定值。

弯音应比较“目标音分→频率比例→实际 DDS 增量”的误差，滑音与颤音复用配置路径，控制更新与逐样本发声分层。三维表情是 P1 的扩展目标：当前压力、弯音和独立新增亮度可以在模型中分别测试；一个压力值同时改变三个参数只能算一个输入维度，自动 LFO 也不能代替第三个独立演奏输入。物理第三维映射留待硬件阶段。

B3 同时解决现场展示的可重复输入问题。CH9350L 当前键盘帧只有六个普通键码槽，不能用“实体键盘同时按 32 键”作为 32 复音的验收前提。测试模式应直接通过既有事件握手产生 32 个独立音符，让各声部拥有自己的相位、频率和包络；再逐个 Note Off 检查对应贡献消失。这证明数字能力，最终还需实机演示。

## 4. 没有设备时，怎样判断做得对

不需要电表、示波器、声卡或外部音箱。最低环境为已有 `C:/iverilog/bin/iverilog.exe`、`vvp.exe` 和 Python；数值分析需要 NumPy，已有脚本使用的依赖沿用现有环境。Gowin 只由你在本机做资源与静态时序实现。队友没有 Gowin 也能独立交 RTL、自检和数值结果。电脑试听 WAV 是可选补充。

| 检查项 | 在电脑上的做法 | 可以得出的结论 |
|---|---|---|
| 音高 | 根据实际 `phase_increment*Fs/2^32` 计算，再与目标频率比较音分；短 RTL 核对增量和相位推进 | DDS 数字音高正确；无需靠短 FFT 猜 1Hz 精度 |
| 包络与控制 | Python 独立参考和 RTL 逐值/逐帧比对 | 攻击/衰减/释放时长、范围和更新逻辑符合约定 |
| 波表质量 | 对周期表做频域分析；相同频率、相同响度渲染定点参考；关键片段与 RTL 对照 | 带限、量化和指定音色变化有依据；没有证明模拟底噪或真实听感 |
| 32 声部 | 独立状态与参考求和，逐个静音/释放检查结果；需要时追加一次较长 I2S 数字捕获 | 每声部独立参与数字输出；频谱图片本身不能替代声部状态与因果检查 |
| I2S/丢样 | 接收模型从 BCK/LRCK/DIN 独立解码，核对位序、位数、帧号与内部提交值 | 标准数字协议、每帧提交与输出一致 |
| 数字延迟 | 测试台对“接受事件→配置完成→样本完成→对应 I2S 样本”分别计时 | 指定数字接口之间的响应；没有测到 USB 扫描、物理动作或 DAC 模拟延迟 |
| 资源与速度 | 在完整候选配置上做一次 Gowin 综合/PnR，核对报告而非只看退出码 | 资源和约束下静态时序；没有证明晶振、接线或供电稳定 |

每个任务只保留三类最小证据：一条可复现命令、一份自检/指标结果、一个能说明变化的数值或样本片段。无需先搭复杂评测平台。B4 复用 `S/tools/pressure_bend_ref.py`，以及仓库根目录下 `tools/s6_reference.py`、`tools/analyze_audio_capture.py`、`tools/verify_audio_quality.py`、`tools/verify_ram_audio.py` 中适合的部分；先核对脚本支持的输入格式，不能把模型 WAV 当成 RTL 捕获。

建议在 `metrics.json` 记录提交/输入哈希、参考算法版本、随机种子、测试名、退出码、实际 Fs、采样数、最大数值误差、帧尾、数字延迟与覆盖边界。Python 长渲染用于音色比较，RTL 主要跑短片段与极值。长 FFT、长音符和完整历史回归按变更需要执行，避免每次改动都等待长仿真。

### 建议验收线

| 指标 | P0 验收线 | 进一步优化目标 |
|---|---|---|
| 独立复音与采样 | 32 路独立相位/增量/包络，实际输出 48kHz，每帧恰提交一次 | 固定声部规模，提升控制与音质 |
| 等价优化 | 与位精确参考逐样本一致 | 实际减少周期、资源或组合路径之一 |
| 有意改变数值的优化 | 改前约定误差界和比较方法；简单增益路径可从 ≤1 LSB/级评估 | 有听感意义的路径同时给模型指标与 RTL 片段；不把全链误差一律设为 1 LSB |
| 音高 | 支持音域内静态 DDS 误差目标 ≤1 音分；报告弯音全范围最差误差 | 弯音映射误差目标 ≤2 音分；若基线已满足则保持 |
| 音质 | 无新增回绕、直流异常、周期缝与切换额外阶跃；既有音色无未说明退化 | 对事先选定的高音案例，混叠残差较基线改善 ≥6dB；匹配响度并记录分析方法，未达标如实说明 |
| 事件 | 不丢事件、不粘音、背压期间数据稳定；32 事件突发全部处理 | 核心接受到对应 I2S 样本目标 ≤4 帧，突发全部响应 ≤1ms；快速起音参数单独注明 |
| 完整数字输入 | 独立记录 UART 首位/末位、ADC 事务完成、事件接受与 I2S 输出时间 | 在明确输入假设下争取 ≤5ms；不得写成实物总延迟已通过 |
| 总帧预算 | 所有 P0 同时启用、最坏已定义突发下帧尾 ≤1152/1536，至少留 25% | 与同功能基线比较，干声争取保持 ≤800 拍；旧基线 617 拍不是全功能承诺 |
| 静态时序 | 73.728MHz 与相关真实约束下 setup/hold 违例均为 0 | 最差 setup 争取 ≥0.5ns；Fmax 本身不单独算音频收益 |

默认 Attack=140/帧，完整上升约需 `ceil(65535/140)/48000=9.77ms`。因此测数字调度延迟用快速起音，测正常演奏响应则单独报告预设与输出检测阈值；不把两种数据混用。当前 CH9350L 11 字节键盘帧在 115200、8N1 下的线缆传输约 0.955ms，也要与模块内部延迟分开。USB 上游时延仍未知。

## 5. 资源使用与合并顺序

本阶段先不争取更高 Fmax、64 声部、96kHz 或内部过采样。已有 617/1536 拍的记录说明可以先完成有价值的算法和控制，不必为追求更短代码重新设计整套流水。代码的清晰度体现在明确算术、固定边界、一次锁存、有限状态和可复现结果。

| 资源 | 主线分配建议 | 约束 |
|---|---|---|
| BSRAM | 基线 26；A/B 各预留最多 2 块增量；合流保守上界 30/46 | 小状态先计算是否适合寄存器；不要为了用 RAM 而搬运所有状态 |
| P1 单声道延迟 | 例如 4096×16 按 1024×18 组织约 4 块，48kHz 下约 85.33ms | 端口模式、反馈位宽和初始化另算；必须用厂商映射确认，不只做 bit 数相除 |
| 乘法器 | 基线保守按约 5 个 18×18 等效记账；A/B 各建议增量不超过 4 个 | 规划上界约 13 个等效；最终同时记录原语与厂商 DSP 宏口径，不把 24 宏当作 24 个 18×18 |
| 帧周期 | A 音频/主处理预留 800 拍，B 调度配置预留 288 拍，提交交接 64 拍，共 1152 | 这是保守预约，不把现有重叠计算重复当收益；最终测完整配置的最坏路径 |

每次增加表、状态、效果或队列前更新块数和周期预算。BSRAM ROM 继续使用 Gowin IP/原语；不改成大 case，不用 DDR3 做逐样本查表，也不引入软核 CPU 或 BL702 执行音频算法。

合并按 G0→A1/B1→A2/B2→A3/B3→A4 顺序分小批推进，B4 贯穿全程。每项提交同时包含 RTL、自己的测试台、参考变化和证据，避免把全部工作压成一个难以拆分的提交。ROM 表值、厂商初始化、元数据与生成脚本必须同批合入。

由你先合并 B 的独立模块和测试，再统一登记构建源与测试列表；不能只拷贝 `.v` 而漏掉 HEX、头文件或参数。原有 `run_simulation.ps1 -Tests` 只认识已登记名称，新增测试在登记前用各自目录内的独立 runner，未知名称应继续失败。两人不并行改公共测试注册表。

可立即使用的现有检查命令如下，均从仓库根运行，不接硬件：

```powershell
$gate = (Resolve-Path -LiteralPath '.\source\sim\run_simulation.ps1').Path
& $gate -Suite Quick
& $gate -Suite Ram32
& $gate -Tests @('tb_voice_sched32_review','tb_ram32_controls')
& $gate -Tests @('tb_wide_master_pair','tb_instrument_rom_banks')
# 完整历史回归先列清单，再按改动范围决定是否运行：
& $gate -Suite Full -ListTests
```

日常执行改动专项，合流执行 Quick、Ram32 和对应的音频/控制专项；不把 Quick 称为完整回归。新增断言失败必须 `$fatal`，编译失败、超时、空测试或缺失输入都不能通过。任何后续 Verilog 烧录都必须先通过规定仿真门禁，本阶段不烧录。

若采用时间安排，可按 10/24—25 做 G0、A1/B1，10/26—27 做 A2/B2，10/28—29 做 A3/B3 与合流。先完成 P0 再选择 P1；预计超出容量时取消 P1，不压缩合流验证。官网目前给出的提交截止为 11/4 18:00，建议 11/2 冻结提交候选，为报告、复现和之后可能恢复的硬件验证留时间。硬件迟迟不可用时，材料中如实保留未验项。

回退按任务提交逐项撤回，先保留优化关闭的基线模式。共享 dirty 工作区禁止整树恢复或清空；回退只作用于该任务所有的文件。归档到 `archive/FPGA-日期-版本/`，保留源码、日志、数值结果、复现命令、限制、MANIFEST 和 SHA256。临时目录先列出解析后的绝对路径，确认位于各自 tmp 子目录，再删除；不得清理对方任务或运行环境。

## 6. 开源复用与当前交付边界

已先检索同类开源实现。本项目已具备可用的 32 声部核心，直接更换完整引擎会引入板级与控制适配工作，当前优先复用现有工程和外部验证方法。

| 来源 | 许可、依赖与本机使用建议 |
|---|---|
| [fpga-verilog-synth](https://github.com/nishadsuresh/fpga-verilog-synth) | MIT；Icarus/GTKWave/Python。可借鉴 HDL→数字音频→WAV 的验证组织，沿用本机 Icarus；其顶层与独立多声部测试范围有区别，不当作本项目完整固件 |
| [XLS32](https://github.com/kazunori279/xls32-fpga-synth) | Apache-2.0；XLS/DSLX 与其他板级工具链。可参考状态/运算分离和预设组织，本阶段不引入新的 HLS 构建链 |
| [Noaidi](https://github.com/Thorwegian/noaidi-fpga-synth) | CERN-OHL-S-2.0；其 ESP32 固件与控制处理器方案不符合本项目当前音频路径约束。仅作为同类架构参考，不直接部署其系统 |

外部源码如确需复制，先固定提交、核对所用文件许可证、保留归属，并说明依赖和 Gowin 适配。本轮没有导入外部实现或安装新环境。

本清单的直接交付是两条可以同时启动的工作线、冻结的边界建议、逐项无硬件验收和合流顺序。依据来自当前源码、归档报告、输入哈希与官方赛题，不是新的性能测试。立体声、可视化、模拟电气和实体延迟均不设为本阶段完成条件；能够证明的数字结果先做扎实，恢复硬件条件后再补实物证据。
