Interstellar-530/PolyTouch-FPGA-Synth/source/build/README.md

# 构建与 SRAM 烧录

## standard27 键盘超时策略

`standard27` 与 `debug8usb` 现在由构建入口显式选择 CH9350L 长按超时策略。默认 `IdleOnly` 只在接收状态机空闲时恢复卡死链路，适合正常演奏；`Strict` 保留旧的全状态超时行为，供兼容性复核。两种策略分别写入 `receipts/standard27.json` 和 `receipts/standard27.strict.json`，不会互相覆盖。构建脚本会生成本次专用顶层包装器并记录其 SHA256，烧录脚本同时核对策略、包装器、全部输入和位流哈希。

```powershell
.\build.ps1 -Profile standard27 -HostTimeoutPolicy IdleOnly
.\build.ps1 -Profile standard27 -HostTimeoutPolicy Strict

.\program_sram.ps1 -Profile standard27 -HostTimeoutPolicy IdleOnly
# 只有需要旧行为时才选 Strict：
.\program_sram.ps1 -Profile standard27 -HostTimeoutPolicy Strict
```

顶层参数属于包装模块，不能用 `-Ptop.HOST_KBD_TIMEOUT_POLICY=...` 改写子实例。仿真可对实际根模块使用 `-Ptop_std27_build.HOST_KBD_TIMEOUT_POLICY=...`；生产构建应使用上面的 PowerShell 参数。烧录仍默认先执行 Quick 门禁，完整回归显式使用 `-SimulationSuite Full`。

## 通用入口

在本目录运行脚本。各档由 profiles.tsv 绑定封装、约束与输出目录，共用 sources.list。当前板载入口为 `debug8`/`debug8usb`，实体外设入口为 27MHz 的 `standard27`；旧 `debug`/`standard` 名称仅用于历史版本。

```powershell
.\build.ps1 -Profile debug8
.\build.ps1 -Profile debug8usb
.\build.ps1 -Profile standard27
```

工具自动从 C/D/E 盘顶层 Gowin 目录查找，也可指定 -GwSh、-Programmer 或设置 GOWIN_GW_SH、GOWIN_PROGRAMMER。

每次构建新建工程，避免旧 GPRJ 漏掉源文件。两档输出分别为 gowin_top_integrated/runs/<本次编号>/instrument/impl/pnr/instrument.fs 和 gowin_top_i2s_std/runs/<本次编号>/instrument/impl/pnr/instrument.fs。报告也保留在本次工程目录。成功后写入 receipts/debug.json 或 receipts/standard.json，按内容绑定本次构建：位流路径与 SHA256、Gowin 工具版本（取自 PnR 报告的 `<Tool Version>`）、每个输入文件的 SHA256、以及整组输入的汇总摘要 InputsDigest。失败会清除该档的成功记录。工程目录属于保留的构建产物，不会自动删除。

硬件接线核查后，构建和烧录必须选择相同档位：

```powershell
.\program_sram.ps1 -Profile standard
# 板载 PT8211 调试使用：
.\program_sram.ps1 -Profile debug
```

烧录默认先执行 Quick 短门禁（12 项正向检查和 6 个参数负例），完整回归用 -SimulationSuite Full。专项选择、日志和覆盖边界见 ../sim/README.md。通过后，只读取所选档位的成功记录；输入文件的 SHA256 或位流 SHA256 对不上时要求重建，大小和时间不再作为判定依据。工具版本记录用于追溯本次构建，当前不把工具版本变化作为烧录拒绝条件。不会自动选旧 source/impl/pnr/instrument.fs 或交接包 artifacts/instrument.fs。等长且保留时间戳的源码改动同样会被识别为不同输入，构建期间输入被改动则本次构建直接作废、不写成功记录。

需要有意使用历史版本时，显式传入 -FsFile，并核对其接线档位；该用法仍执行仿真门禁：

```powershell
.\scan_jtag.ps1
.\program_sram.ps1 -FsFile '<明确选择的位流路径>' -Cable '<当前扫描的线缆名称>'
```

器件默认 GW2A-18C，操作码 2 表示 SRAM Program，断电失效。-SkipSimulation 只用于仿真器不可用的极端情况，并须在调试日志说明原因。

旧 Tcl 入口 build_instrument.tcl、build_top_integrated.tcl、build_top_i2s_std.tcl 已转发到共用逻辑。直接调用 Tcl 不生成 PowerShell 成功记录；自动选择位流时请使用 build.ps1。

本项验证在仓库根目录运行 tools/verify_build_profiles.py。它实际调用 Gowin 创建工程、加入源文件并设置封装，只替换 run 以停止在综合前，再用 Icarus 编译两档。构建与烧录选择测试使用隔离目录和模拟工具，不接触 JTAG；其中包含“等长且保留时间戳的改动必须被拒绝”“只改时间戳不能作废构建”“构建期间输入变更必须中止”三项。证据见 evidence/2026/10/FPGA-构建入口-20261016-v0.1 与 evidence/2026/10/FPGA-优化02-构建绑定-20261021。

输入指纹本身可在本目录单独自检，不调用 Gowin、不接触硬件：

```powershell
.\test_build_inputs.ps1
```

旧格式凭据（只记录大小和修改时间、没有 SHA256）不再能通过内容校验，按“输入不一致”处理，需要重建一次；这是有意的收紧，不做兼容回退。

2026-10-16 实际综合修正：Gowin 将 impl 输出写到当前工作目录。公共 Tcl 现在先进入本次工程目录，并复制所需的 Verilog 头文件，再执行构建。已通过真实综合确认输出落在本次工程的 impl/gwsynthesis 下；本轮未执行 PnR。该修正包含在第三项音色控制提交中。
