Interstellar-530/PolyTouch-FPGA-Synth/evidence/2026/10/FPGA-S4-S6-本机审查-20261016-v0.1/wiring-layout.tex

\usepackage{needspace}
\usepackage{fancyhdr}
\usepackage{etoolbox}
\usepackage{xcolor}
\definecolor{wireblue}{HTML}{244660}
\setlength{\emergencystretch}{3em}
\setlength{\tabcolsep}{4pt}
\renewcommand{\arraystretch}{1.08}
\AtBeginEnvironment{longtable}{\small}
\pretocmd{\section}{\Needspace{5\baselineskip}}{}{}
\pretocmd{\subsection}{\Needspace{4\baselineskip}}{}{}
\setlength{\headheight}{15pt}
\pagestyle{fancy}
\fancyhf{}
\fancyhead[L]{\small\color{wireblue} PolyTouch FPGA / 完整接线方案}
\fancyhead[R]{\small 2026-10-16 / v0.1}
\fancyfoot[C]{\small\thepage}
\renewcommand{\headrulewidth}{0.3pt}
