Interstellar-530/PolyTouch-FPGA-Synth/docs/hardware/wiring-20261023-v0.1-assets/07-sensors.pdf

FSR 压力 → CH0 | 10kΩ 电位器 → CH1

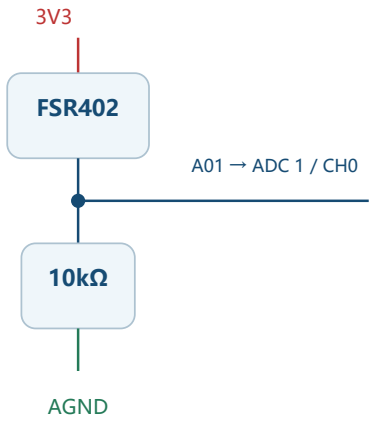
[picture p56: figure]
FSR402; A01 → ADC 1 / CH0; AGND

| 3V3

10kΩ

固定端
到固定端

AGND

滑臂

A02 → ADC 2

CH1
