Interstellar-530/PolyTouch-FPGA-Synth/docs/hardware/wiring-20261023-v0.1-assets/08-dac.pdf

### CJMCU-5102 正面

LINE OUT插座在上方

LINE OUT ¹ | VCC | 供电入口待核
2 | 3.3V | 可能为稳压输出
3 | GND | P03 / PMOD2 GND
4 | FLT | 固定低
5 | DMP | 固定低
6 | SCL | 固定低：不是BCK
7 | BCK | W07 / PMOD2 B12
8 | DIN | W09 / PMOD2 B13
9 | LCK | W08 / PMOD2 C12
10 | FMT | 固定低：I2S
11 | XMT | 固定3.3V；P6留空

左侧1至11仅为本图孔位序号，不能当作PCM5102A芯片脚号。
