Interstellar-530/PolyTouch-FPGA-Synth/docs/hardware/wiring-20261023-v0.1-assets/11-oscillator.pdf

底视图：引脚朝向眼睛

顶视图：定位圆点在左下

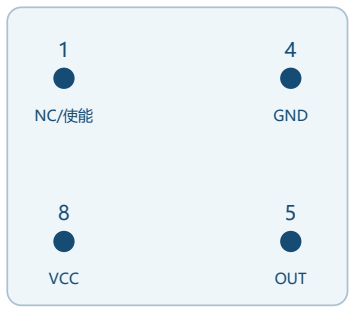
[picture p57: figure]
GND; VCC; OUT
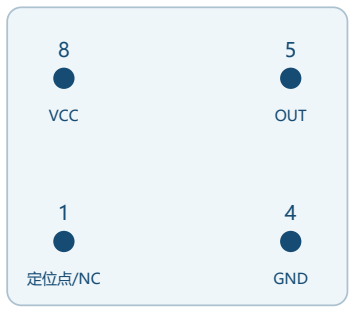
[picture p58: figure]
VCC; OUT; 定位点/NC; GND

8脚 → 3.3V
4脚 → GND
5脚 → 独立测频/幅度
1脚 → NC或使能待核
8-4脚并100nF

standard27：T7不接

后续确认12.288MHz与匹配板级档：5脚OUT → 约33Ω → PMOD0 / T7

翻面按定位点重新认脚；不能将四根脚重编号为1、2、3、4。
