Interstellar-530/PolyTouch-FPGA-Synth/docs/hardware/wiring-20261023-v0.1-assets/source-pcm-pins.pdf

PW 20-Pin Package
(Top View)

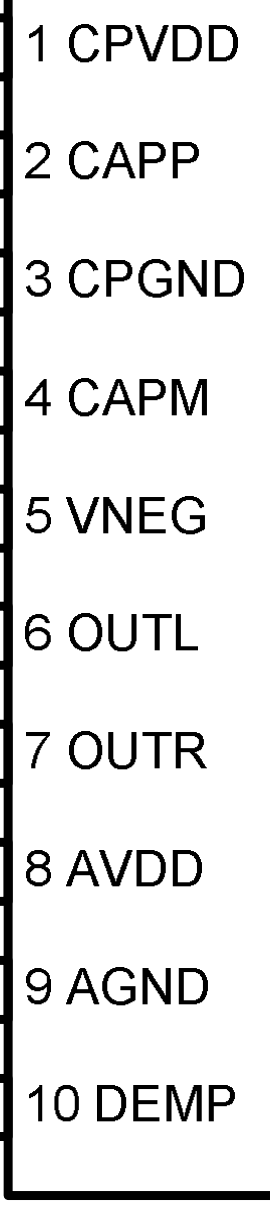
[picture p59: figure]
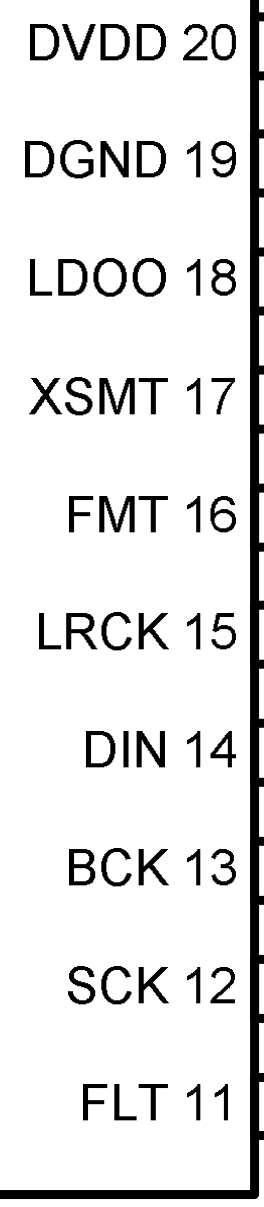
[picture p60: figure]

Pin Functions
