Interstellar-530/PolyTouch-FPGA-Synth/experiments/2026/10/FPGA-20261008-m2-build-issues-v0.1/README.md

# 20261008 / m2-build-issues

来源 `origin/fix/m2-build-issues`，提交 `3a31eb288ae400830a18fdcde96350ac03c1bb07`。相对最终基线有 1 个独有提交；属于历史分支候选，未按日期机械合入当前工程。

完整版本可运行 `git worktree add --detach <独立目录> 3a31eb288ae400830a18fdcde96350ac03c1bb07`。`source.zip` 保留该提交的源码快照（含原路径）。`changes.patch` 仅展示独有提交相对最终基线的共同祖先以来差异。
