Interstellar-530/PolyTouch-FPGA-Synth/evidence/2026/10/FPGA-优化01-力度边界-20261021/build_reports/instrument_tr_content.html

# Timing Messages

Report Title | Timing Analysis Report
Design File | E:\Working Space\FPGA\output\handoff_milestone2_20261008\source\build\gowin_top_dbg8usb\runs\20261021T104438218-e4287137\instrument\impl\gwsynthesis\instrument.vg
Physical Constraints File | E:\Working Space\FPGA\output\handoff_milestone2_20261008\source\constraints\primer20k_dock3714_usb.cst
Timing Constraint File | E:\Working Space\FPGA\output\handoff_milestone2_20261008\source\constraints\primer20k.sdc
Tool Version | V1.9.11.03 Education
Part Number | GW2A-LV18PG256C8/I7
Device | GW2A-18
Device Version | C
Created Time | Wed Oct 21 10:46:28 2026
Legal Announcement | Copyright (C)2014-2025 Gowin Semiconductor Corporation. All rights reserved.

# Timing Summaries

## STA Tool Run Summary:

Setup Delay Model | Slow 0.95V 85C C8/I7
Hold Delay Model | Fast 1.05V 0C C8/I7
Numbers of Paths Analyzed | 11484
Numbers of Endpoints Analyzed | 11123
Numbers of Falling Endpoints | 0
Numbers of Setup Violated Endpoints | 0
Numbers of Hold Violated Endpoints | 0

## Clock Summary:

NO. | Clock Name | Type | Period | Frequency(MHz) | Rise | Fall | Source | Master | Objects
1 | clk_27m | Base | 37.037 | 27.000 | 0.000 | 18.518 | | | clk_27m

## Max Frequency Summary:

NO. | Clock Name | Constraint | Actual Fmax | Logic Level | Entity
1 | clk_27m | 27.000(MHz) | 31.039(MHz) | 21 | TOP

## Total Negative Slack Summary:

Clock Name | Analysis Type | Endpoints TNS | Number of Endpoints
clk_27m | Setup | 0.000 | 0
clk_27m | Hold | 0.000 | 0

# Timing Details

## Path Slacks Table:

### Setup Paths Table

#### Report Command:report_timing -setup -max_paths 25 -max_common_paths 1

Path Number | Path Slack | From Node | To Node | From Clock | To Clock | Relation | Clock Skew | Data Delay
1 | 4.820 | u_top/u_manual/rd_ptr_0_s0/Q | u_top/u_alloc/v_note_0_s0/CE | clk_27m:[R] | clk_27m:[R] | 37.037 | 0.000 | 32.182
2 | 4.820 | u_top/u_manual/rd_ptr_0_s0/Q | u_top/u_alloc/v_note_1_s0/CE | clk_27m:[R] | clk_27m:[R] | 37.037 | 0.000 | 32.182
3 | 4.820 | u_top/u_manual/rd_ptr_0_s0/Q | u_top/u_alloc/v_note_2_s0/CE | clk_27m:[R] | clk_27m:[R] | 37.037 | 0.000 | 32.182
4 | 4.820 | u_top/u_manual/rd_ptr_0_s0/Q | u_top/u_alloc/v_note_3_s0/CE | clk_27m:[R] | clk_27m:[R] | 37.037 | 0.000 | 32.182
5 | 5.199 | u_top/u_manual/rd_ptr_0_s0/Q | u_top/u_alloc/v_note_6_s0/CE | clk_27m:[R] | clk_27m:[R] | 37.037 | 0.000 | 31.803
6 | 5.313 | u_top/u_manual/rd_ptr_0_s0/Q | u_top/u_alloc/v_note_28_s0/CE | clk_27m:[R] | clk_27m:[R] | 37.037 | 0.000 | 31.689
7 | 5.313 | u_top/u_manual/rd_ptr_0_s0/Q | u_top/u_alloc/v_note_30_s0/CE | clk_27m:[R] | clk_27m:[R] | 37.037 | 0.000 | 31.689
8 | 5.313 | u_top/u_manual/rd_ptr_0_s0/Q | u_top/u_alloc/v_note_31_s0/CE | clk_27m:[R] | clk_27m:[R] | 37.037 | 0.000 | 31.689
9 | 5.313 | u_top/u_manual/rd_ptr_0_s0/Q | u_top/u_alloc/v_note_32_s0/CE | clk_27m:[R] | clk_27m:[R] | 37.037 | 0.000 | 31.689
10 | 5.313 | u_top/u_manual/rd_ptr_0_s0/Q | u_top/u_alloc/v_note_33_s0/CE | clk_27m:[R] | clk_27m:[R] | 37.037 | 0.000 | 31.689
11 | 5.313 | u_top/u_manual/rd_ptr_0_s0/Q | u_top/u_alloc/v_note_34_s0/CE | clk_27m:[R] | clk_27m:[R] | 37.037 | 0.000 | 31.689
12 | 5.376 | u_top/u_manual/rd_ptr_0_s0/Q | u_top/u_alloc/v_note_4_s0/CE | clk_27m:[R] | clk_27m:[R] | 37.037 | 0.000 | 31.626
13 | 5.376 | u_top/u_manual/rd_ptr_0_s0/Q | u_top/u_alloc/v_note_5_s0/CE | clk_27m:[R] | clk_27m:[R] | 37.037 | 0.000 | 31.626
14 | 5.532 | u_top/u_manual/rd_ptr_0_s0/Q | u_top/u_alloc/v_note_29_s0/CE | clk_27m:[R] | clk_27m:[R] | 37.037 | 0.000 | 31.470
15 | 5.613 | u_top/u_manual/rd_ptr_0_s0/Q | u_top/u_alloc/v_note_12_s0/CE | clk_27m:[R] | clk_27m:[R] | 37.037 | 0.000 | 31.389
16 | 5.613 | u_top/u_manual/rd_ptr_0_s0/Q | u_top/u_alloc/v_note_13_s0/CE | clk_27m:[R] | clk_27m:[R] | 37.037 | 0.000 | 31.389
17 | 5.620 | u_top/u_manual/rd_ptr_0_s0/Q | u_top/u_alloc/v_note_7_s0/CE | clk_27m:[R] | clk_27m:[R] | 37.037 | 0.000 | 31.382
18 | 5.620 | u_top/u_manual/rd_ptr_0_s0/Q | u_top/u_alloc/v_note_8_s0/CE | clk_27m:[R] | clk_27m:[R] | 37.037 | 0.000 | 31.382
19 | 5.641 | u_top/u_manual/rd_ptr_0_s0/Q | u_top/u_alloc/v_note_18_s0/CE | clk_27m:[R] | clk_27m:[R] | 37.037 | 0.000 | 31.361
20 | 5.797 | u_top/u_manual/rd_ptr_0_s0/Q | u_top/u_alloc/v_note_9_s0/CE | clk_27m:[R] | clk_27m:[R] | 37.037 | 0.000 | 31.205
21 | 5.797 | u_top/u_manual/rd_ptr_0_s0/Q | u_top/u_alloc/v_note_10_s0/CE | clk_27m:[R] | clk_27m:[R] | 37.037 | 0.000 | 31.205
22 | 5.797 | u_top/u_manual/rd_ptr_0_s0/Q | u_top/u_alloc/v_note_11_s0/CE | clk_27m:[R] | clk_27m:[R] | 37.037 | 0.000 | 31.205
23 | 5.819 | u_top/u_manual/rd_ptr_0_s0/Q | u_top/u_alloc/v_note_14_s0/CE | clk_27m:[R] | clk_27m:[R] | 37.037 | 0.000 | 31.183
24 | 5.819 | u_top/u_manual/rd_ptr_0_s0/Q | u_top/u_alloc/v_note_15_s0/CE | clk_27m:[R] | clk_27m:[R] | 37.037 | 0.000 | 31.183
25 | 5.819 | u_top/u_manual/rd_ptr_0_s0/Q | u_top/u_alloc/v_note_16_s0/CE | clk_27m:[R] | clk_27m:[R] | 37.037 | 0.000 | 31.183

### Hold Paths Table

#### Report Command:report_timing -hold -max_paths 25 -max_common_paths 1

Path Number | Path Slack | From Node | To Node | From Clock | To Clock | Relation | Clock Skew | Data Delay
1 | 0.214 | u_top/u_engine/rom_addr_1_s0/Q | u_top/u_engine/g_banked.g_generic.g_guitar.u_guitar_rom/gg4/AD[5] | clk_27m:[R] | clk_27m:[R] | 0.000 | 0.000 | 0.332
2 | 0.319 | u_top/u_engine/vsel_0_s0/Q | u_top/u_engine/phase_v[0]_phase_v[0]_0_2_s/AD[0] | clk_27m:[R] | clk_27m:[R] | 0.000 | 0.000 | 0.329
3 | 0.327 | u_top/u_engine/sums_valid_s0/Q | u_top/u_xf/saved_bright_14_s0/CE | clk_27m:[R] | clk_27m:[R] | 0.000 | 0.000 | 0.338
4 | 0.327 | u_top/u_engine/sums_valid_s0/Q | u_top/u_xf/saved_sine_16_s0/CE | clk_27m:[R] | clk_27m:[R] | 0.000 | 0.000 | 0.338
5 | 0.327 | u_top/u_engine/sums_valid_s0/Q | u_top/u_xf/saved_sine_17_s0/CE | clk_27m:[R] | clk_27m:[R] | 0.000 | 0.000 | 0.338
6 | 0.332 | u_top/u_engine/rom_addr_6_s0/Q | u_top/u_engine/g_banked.g_generic.u_bright_rom/u_bank0/AD[10] | clk_27m:[R] | clk_27m:[R] | 0.000 | 0.000 | 0.450
7 | 0.347 | u_top/u_engine/rom_addr_0_s0/Q | u_top/u_engine/g_banked.g_generic.g_guitar.u_guitar_rom/gg4/AD[4] | clk_27m:[R] | clk_27m:[R] | 0.000 | 0.000 | 0.465
8 | 0.347 | u_top/u_engine/rom_addr_3_s0/Q | u_top/u_engine/g_banked.g_generic.u_bright_rom/u_bank0/AD[7] | clk_27m:[R] | clk_27m:[R] | 0.000 | 0.000 | 0.465
9 | 0.348 | u_top/u_engine/rom_addr_4_s0/Q | u_top/u_engine/g_banked.g_generic.u_bright_rom/u_bank0/AD[8] | clk_27m:[R] | clk_27m:[R] | 0.000 | 0.000 | 0.466
10 | 0.349 | u_top/u_engine/rom_addr_2_s0/Q | u_top/u_engine/g_banked.g_generic.u_bright_rom/u_bank0/AD[6] | clk_27m:[R] | clk_27m:[R] | 0.000 | 0.000 | 0.467
11 | 0.350 | u_top/u_engine/rom_addr_5_s0/Q | u_top/u_engine/g_banked.g_generic.u_bright_rom/u_bank0/AD[9] | clk_27m:[R] | clk_27m:[R] | 0.000 | 0.000 | 0.468
12 | 0.352 | u_top/u_engine/rom_bank_0_s0/Q | u_top/u_engine/g_banked.g_generic.g_guitar.u_guitar_rom/gg8/AD[13] | clk_27m:[R] | clk_27m:[R] | 0.000 | 0.000 | 0.470
13 | 0.353 | u_top/u_engine/rom_addr_7_s0/Q | u_top/u_engine/g_banked.g_generic.u_bright_rom/u_bank0/AD[11] | clk_27m:[R] | clk_27m:[R] | 0.000 | 0.000 | 0.471
14 | 0.353 | u_top/u_engine/rom_addr_8_s0/Q | u_top/u_engine/g_banked.g_generic.g_guitar.u_guitar_rom/gg4/AD[12] | clk_27m:[R] | clk_27m:[R] | 0.000 | 0.000 | 0.471
15 | 0.358 | u_top/u_engine/rom_addr_8_s0/Q | u_top/u_engine/g_banked.g_generic.u_bright_rom/u_bank2/AD[12] | clk_27m:[R] | clk_27m:[R] | 0.000 | 0.000 | 0.476
16 | 0.425 | u_top/g_pt8211.u_pt8211/div_cnt_0_s0/Q | u_top/g_pt8211.u_pt8211/div_cnt_0_s0/D | clk_27m:[R] | clk_27m:[R] | 0.000 | 0.000 | 0.436
17 | 0.425 | u_top/u_xf/clip_count_0_s0/Q | u_top/u_xf/clip_count_0_s0/D | clk_27m:[R] | clk_27m:[R] | 0.000 | 0.000 | 0.436
18 | 0.425 | u_top/u_xf/clip_count_2_s0/Q | u_top/u_xf/clip_count_2_s0/D | clk_27m:[R] | clk_27m:[R] | 0.000 | 0.000 | 0.436
19 | 0.425 | u_top/u_xf/clip_count_6_s0/Q | u_top/u_xf/clip_count_6_s0/D | clk_27m:[R] | clk_27m:[R] | 0.000 | 0.000 | 0.436
20 | 0.425 | u_top/u_xf/clip_count_12_s0/Q | u_top/u_xf/clip_count_12_s0/D | clk_27m:[R] | clk_27m:[R] | 0.000 | 0.000 | 0.436
21 | 0.425 | u_top/u_xf/clip_count_18_s0/Q | u_top/u_xf/clip_count_18_s0/D | clk_27m:[R] | clk_27m:[R] | 0.000 | 0.000 | 0.436
22 | 0.425 | u_top/u_xf/clip_count_24_s0/Q | u_top/u_xf/clip_count_24_s0/D | clk_27m:[R] | clk_27m:[R] | 0.000 | 0.000 | 0.436
23 | 0.425 | u_top/u_xf/clip_count_26_s0/Q | u_top/u_xf/clip_count_26_s0/D | clk_27m:[R] | clk_27m:[R] | 0.000 | 0.000 | 0.436
24 | 0.425 | u_top/u_xf/clip_count_30_s0/Q | u_top/u_xf/clip_count_30_s0/D | clk_27m:[R] | clk_27m:[R] | 0.000 | 0.000 | 0.436
25 | 0.425 | u_top/u_engine/stage_q_stage_q_RAMREG_6_G[2]_s0/Q | u_top/u_engine/stage_q_stage_q_RAMREG_6_G[2]_s0/D | clk_27m:[R] | clk_27m:[R] | 0.000 | 0.000 | 0.436

### Recovery Paths Table

#### Report Command:report_timing -recovery -max_paths 25 -max_common_paths 1

#### Nothing to report!

### Removal Paths Table

#### Report Command:report_timing -removal -max_paths 25 -max_common_paths 1

#### Nothing to report!

## Minimum Pulse Width Table:

Number | Slack | Actual Width | Required Width | Type | Clock | Objects

#### Report Command:report_min_pulse_width -nworst 10 -detail

1 | 15.833 | 16.833 | 1.000 | Low Pulse Width | clk_27m | u_top/reset_cnt_14_s0
2 | 15.833 | 16.833 | 1.000 | Low Pulse Width | clk_27m | u_top/reset_cnt_12_s0
3 | 15.833 | 16.833 | 1.000 | Low Pulse Width | clk_27m | u_top/reset_cnt_8_s0
4 | 15.833 | 16.833 | 1.000 | Low Pulse Width | clk_27m | u_top/reset_cnt_0_s0
5 | 15.833 | 16.833 | 1.000 | Low Pulse Width | clk_27m | u_top/pending_word_6_s0
6 | 15.833 | 16.833 | 1.000 | Low Pulse Width | clk_27m | u_top/ctrl_div_1_s0
7 | 15.833 | 16.833 | 1.000 | Low Pulse Width | clk_27m | u_top/mix_lp_y_15_s0
8 | 15.833 | 16.833 | 1.000 | Low Pulse Width | clk_27m | u_top/g_host_kbd.u_host_kbd/u_uart/cnt_11_s1
9 | 15.833 | 16.833 | 1.000 | Low Pulse Width | clk_27m | u_top/g_host_kbd.u_host_kbd/u_map/cur_key_cur_key_RAMREG_0_G[7]_s0
10 | 15.833 | 16.833 | 1.000 | Low Pulse Width | clk_27m | u_top/u_uart/tx_cnt_9_s3

## Timing Report By Analysis Type:

### Setup Analysis Report

#### Report Command:report_timing -setup -max_paths 25 -max_common_paths 1

### Path1

Path Summary:

Slack | 4.820
Data Arrival Time | 36.542
Data Required Time | 41.361
From | u_top/u_manual/rd_ptr_0_s0
To | u_top/u_alloc/v_note_0_s0
Launch Clk | clk_27m:[R]
Latch Clk | clk_27m:[R]

Data Arrival Path:

AT | DELAY | TYPE | RF | FANOUT | LOC | NODE
0.000 | 0.000 | | | | | active clock edge time
0.000 | 0.000 | | | | | clk_27m
0.000 | 0.000 | tCL | RR | 1 | IOT27[A] | clk_27m_ibuf/I
2.088 | 2.088 | tINS | RR | 3747 | IOT27[A] | clk_27m_ibuf/O
4.359 | 2.271 | tNET | RR | 1 | R16C49[0][A] | u_top/u_manual/rd_ptr_0_s0/CLK
4.591 | 0.232 | tC2Q | RF | 7 | R16C49[0][A] | u_top/u_manual/rd_ptr_0_s0/Q
6.030 | 1.439 | tNET | FF | 2 | R13C47[0][A] | u_top/u_manual/n4_s0/I1
6.600 | 0.570 | tINS | FR | 1 | R13C47[0][A] | u_top/u_manual/n4_s0/COUT
6.600 | 0.000 | tNET | RR | 2 | R13C47[0][B] | u_top/u_manual/n5_s0/CIN
6.635 | 0.035 | tINS | RF | 1 | R13C47[0][B] | u_top/u_manual/n5_s0/COUT
6.635 | 0.000 | tNET | FF | 2 | R13C47[1][A] | u_top/u_manual/n6_s0/CIN
6.670 | 0.035 | tINS | FF | 1 | R13C47[1][A] | u_top/u_manual/n6_s0/COUT
6.670 | 0.000 | tNET | FF | 2 | R13C47[1][B] | u_top/u_manual/n7_s0/CIN
6.706 | 0.035 | tINS | FF | 1 | R13C47[1][B] | u_top/u_manual/n7_s0/COUT
6.706 | 0.000 | tNET | FF | 2 | R13C47[2][A] | u_top/u_manual/n8_s0/CIN
6.741 | 0.035 | tINS | FF | 17 | R13C47[2][A] | u_top/u_manual/n8_s0/COUT
7.811 | 1.070 | tNET | FF | 1 | R14C48[3][B] | u_top/ev_word_13_s2/I2
8.366 | 0.555 | tINS | FF | 1 | R14C48[3][B] | u_top/ev_word_13_s2/F
9.277 | 0.911 | tNET | FF | 1 | R12C38[3][A] | u_top/ev_word_13_s1/I1
9.648 | 0.371 | tINS | FF | 3 | R12C38[3][A] | u_top/ev_word_13_s1/F
10.070 | 0.422 | tNET | FF | 1 | R9C38[3][A] | u_top/ev_word_13_s0/I0
10.523 | 0.453 | tINS | FF | 55 | R9C38[3][A] | u_top/ev_word_13_s0/F
14.971 | 4.448 | tNET | FF | 2 | R39C20[2][B] | u_top/u_alloc/n80_s0/I1
15.541 | 0.570 | tINS | FR | 1 | R39C20[2][B] | u_top/u_alloc/n80_s0/COUT
15.541 | 0.000 | tNET | RR | 2 | R39C21[0][A] | u_top/u_alloc/n81_s0/CIN
15.576 | 0.035 | tINS | RF | 2 | R39C21[0][A] | u_top/u_alloc/n81_s0/COUT
16.692 | 1.115 | tNET | FF | 1 | R43C21[2][A] | u_top/u_alloc/v_gate_3_s3/I0
17.209 | 0.517 | tINS | FF | 3 | R43C21[2][A] | u_top/u_alloc/v_gate_3_s3/F
17.879 | 0.671 | tNET | FF | 1 | R45C20[1][B] | u_top/u_alloc/pick_2_s146/I2
18.396 | 0.517 | tINS | FF | 3 | R45C20[1][B] | u_top/u_alloc/pick_2_s146/F
18.896 | 0.500 | tNET | FF | 1 | R47C18[0][A] | u_top/u_alloc/pick_0_s9/I2
19.451 | 0.555 | tINS | FF | 5 | R47C18[0][A] | u_top/u_alloc/pick_0_s9/F
20.195 | 0.744 | tNET | FF | 1 | R44C19[1][A] | u_top/u_alloc/pick_0_s3/I1
20.750 | 0.555 | tINS | FF | 8 | R44C19[1][A] | u_top/u_alloc/pick_0_s3/F
21.579 | 0.828 | tNET | FF | 1 | R42C17[3][A] | u_top/u_alloc/pick_2_s64/I0
21.950 | 0.371 | tINS | FF | 3 | R42C17[3][A] | u_top/u_alloc/pick_2_s64/F
23.469 | 1.519 | tNET | FF | 1 | R47C14[3][B] | u_top/u_alloc/pick_2_s52/I1
23.840 | 0.371 | tINS | FF | 1 | R47C14[3][B] | u_top/u_alloc/pick_2_s52/F
23.844 | 0.004 | tNET | FF | 1 | R47C14[3][A] | u_top/u_alloc/pick_2_s21/I3
24.361 | 0.517 | tINS | FF | 2 | R47C14[3][A] | u_top/u_alloc/pick_2_s21/F
25.051 | 0.690 | tNET | FF | 1 | R45C18[0][B] | u_top/u_alloc/pick_2_s6/I3
25.422 | 0.371 | tINS | FF | 4 | R45C18[0][B] | u_top/u_alloc/pick_2_s6/F
25.435 | 0.013 | tNET | FF | 1 | R45C18[2][B] | u_top/u_alloc/pick_2_s1/I1
25.990 | 0.555 | tINS | FF | 4 | R45C18[2][B] | u_top/u_alloc/pick_2_s1/F
27.213 | 1.222 | tNET | FF | 1 | R47C15[3][B] | u_top/u_alloc/pick_0_s2/I1
27.768 | 0.555 | tINS | FF | 9 | R47C15[3][B] | u_top/u_alloc/pick_0_s2/F
28.461 | 0.693 | tNET | FF | 1 | R42C16[3][B] | u_top/u_alloc/pick_0_s49/I3
28.978 | 0.517 | tINS | FF | 26 | R42C16[3][B] | u_top/u_alloc/pick_0_s49/F
30.318 | 1.340 | tNET | FF | 18 | DSP_R37[2][A] | u_top/u_alloc/n453_s1/B[0]
33.958 | 3.640 | tINS | FF | 8 | DSP_R37[2][A] | u_top/u_alloc/n453_s1/DOUT[6]
35.264 | 1.306 | tNET | FF | 1 | R38C16[3][A] | u_top/u_alloc/n3490_s2/I0
35.834 | 0.570 | tINS | FR | 7 | R38C16[3][A] | u_top/u_alloc/n3490_s2/F
36.542 | 0.708 | tNET | RR | 1 | R35C17[0][A] | u_top/u_alloc/v_note_0_s0/CE

Data Required Path:

AT | DELAY | TYPE | RF | FANOUT | LOC | NODE
37.037 | 37.037 | | | | | active clock edge time
37.037 | 0.000 | | | | | clk_27m
37.037 | 0.000 | tCL | RR | 1 | IOT27[A] | clk_27m_ibuf/I
39.125 | 2.088 | tINS | RR | 3747 | IOT27[A] | clk_27m_ibuf/O
41.396 | 2.271 | tNET | RR | 1 | R35C17[0][A] | u_top/u_alloc/v_note_0_s0/CLK
41.361 | -0.035 | tSu | | 1 | R35C17[0][A] | u_top/u_alloc/v_note_0_s0

Path Statistics:

Clock Skew | 0.000
Setup Relationship | 37.037
Logic Level | 21
Arrival Clock Path Delay | cell: 2.088, 47.897%; route: 2.271, 52.103%
Arrival Data Path Delay | cell: 12.306, 38.238%; route: 19.644, 61.041%; tC2Q: 0.232, 0.721%
Required Clock Path Delay | cell: 2.088, 47.897%; route: 2.271, 52.103%

### Path2

Path Summary:

Slack | 4.820
Data Arrival Time | 36.542
Data Required Time | 41.361
From | u_top/u_manual/rd_ptr_0_s0
To | u_top/u_alloc/v_note_1_s0
Launch Clk | clk_27m:[R]
Latch Clk | clk_27m:[R]

Data Arrival Path:

AT | DELAY | TYPE | RF | FANOUT | LOC | NODE
0.000 | 0.000 | | | | | active clock edge time
0.000 | 0.000 | | | | | clk_27m
0.000 | 0.000 | tCL | RR | 1 | IOT27[A] | clk_27m_ibuf/I
2.088 | 2.088 | tINS | RR | 3747 | IOT27[A] | clk_27m_ibuf/O
4.359 | 2.271 | tNET | RR | 1 | R16C49[0][A] | u_top/u_manual/rd_ptr_0_s0/CLK
4.591 | 0.232 | tC2Q | RF | 7 | R16C49[0][A] | u_top/u_manual/rd_ptr_0_s0/Q
6.030 | 1.439 | tNET | FF | 2 | R13C47[0][A] | u_top/u_manual/n4_s0/I1
6.600 | 0.570 | tINS | FR | 1 | R13C47[0][A] | u_top/u_manual/n4_s0/COUT
6.600 | 0.000 | tNET | RR | 2 | R13C47[0][B] | u_top/u_manual/n5_s0/CIN
6.635 | 0.035 | tINS | RF | 1 | R13C47[0][B] | u_top/u_manual/n5_s0/COUT
6.635 | 0.000 | tNET | FF | 2 | R13C47[1][A] | u_top/u_manual/n6_s0/CIN
6.670 | 0.035 | tINS | FF | 1 | R13C47[1][A] | u_top/u_manual/n6_s0/COUT
6.670 | 0.000 | tNET | FF | 2 | R13C47[1][B] | u_top/u_manual/n7_s0/CIN
6.706 | 0.035 | tINS | FF | 1 | R13C47[1][B] | u_top/u_manual/n7_s0/COUT
6.706 | 0.000 | tNET | FF | 2 | R13C47[2][A] | u_top/u_manual/n8_s0/CIN
6.741 | 0.035 | tINS | FF | 17 | R13C47[2][A] | u_top/u_manual/n8_s0/COUT
7.811 | 1.070 | tNET | FF | 1 | R14C48[3][B] | u_top/ev_word_13_s2/I2
8.366 | 0.555 | tINS | FF | 1 | R14C48[3][B] | u_top/ev_word_13_s2/F
9.277 | 0.911 | tNET | FF | 1 | R12C38[3][A] | u_top/ev_word_13_s1/I1
9.648 | 0.371 | tINS | FF | 3 | R12C38[3][A] | u_top/ev_word_13_s1/F
10.070 | 0.422 | tNET | FF | 1 | R9C38[3][A] | u_top/ev_word_13_s0/I0
10.523 | 0.453 | tINS | FF | 55 | R9C38[3][A] | u_top/ev_word_13_s0/F
14.971 | 4.448 | tNET | FF | 2 | R39C20[2][B] | u_top/u_alloc/n80_s0/I1
15.541 | 0.570 | tINS | FR | 1 | R39C20[2][B] | u_top/u_alloc/n80_s0/COUT
15.541 | 0.000 | tNET | RR | 2 | R39C21[0][A] | u_top/u_alloc/n81_s0/CIN
15.576 | 0.035 | tINS | RF | 2 | R39C21[0][A] | u_top/u_alloc/n81_s0/COUT
16.692 | 1.115 | tNET | FF | 1 | R43C21[2][A] | u_top/u_alloc/v_gate_3_s3/I0
17.209 | 0.517 | tINS | FF | 3 | R43C21[2][A] | u_top/u_alloc/v_gate_3_s3/F
17.879 | 0.671 | tNET | FF | 1 | R45C20[1][B] | u_top/u_alloc/pick_2_s146/I2
18.396 | 0.517 | tINS | FF | 3 | R45C20[1][B] | u_top/u_alloc/pick_2_s146/F
18.896 | 0.500 | tNET | FF | 1 | R47C18[0][A] | u_top/u_alloc/pick_0_s9/I2
19.451 | 0.555 | tINS | FF | 5 | R47C18[0][A] | u_top/u_alloc/pick_0_s9/F
20.195 | 0.744 | tNET | FF | 1 | R44C19[1][A] | u_top/u_alloc/pick_0_s3/I1
20.750 | 0.555 | tINS | FF | 8 | R44C19[1][A] | u_top/u_alloc/pick_0_s3/F
21.579 | 0.828 | tNET | FF | 1 | R42C17[3][A] | u_top/u_alloc/pick_2_s64/I0
21.950 | 0.371 | tINS | FF | 3 | R42C17[3][A] | u_top/u_alloc/pick_2_s64/F
23.469 | 1.519 | tNET | FF | 1 | R47C14[3][B] | u_top/u_alloc/pick_2_s52/I1
23.840 | 0.371 | tINS | FF | 1 | R47C14[3][B] | u_top/u_alloc/pick_2_s52/F
23.844 | 0.004 | tNET | FF | 1 | R47C14[3][A] | u_top/u_alloc/pick_2_s21/I3
24.361 | 0.517 | tINS | FF | 2 | R47C14[3][A] | u_top/u_alloc/pick_2_s21/F
25.051 | 0.690 | tNET | FF | 1 | R45C18[0][B] | u_top/u_alloc/pick_2_s6/I3
25.422 | 0.371 | tINS | FF | 4 | R45C18[0][B] | u_top/u_alloc/pick_2_s6/F
25.435 | 0.013 | tNET | FF | 1 | R45C18[2][B] | u_top/u_alloc/pick_2_s1/I1
25.990 | 0.555 | tINS | FF | 4 | R45C18[2][B] | u_top/u_alloc/pick_2_s1/F
27.213 | 1.222 | tNET | FF | 1 | R47C15[3][B] | u_top/u_alloc/pick_0_s2/I1
27.768 | 0.555 | tINS | FF | 9 | R47C15[3][B] | u_top/u_alloc/pick_0_s2/F
28.461 | 0.693 | tNET | FF | 1 | R42C16[3][B] | u_top/u_alloc/pick_0_s49/I3
28.978 | 0.517 | tINS | FF | 26 | R42C16[3][B] | u_top/u_alloc/pick_0_s49/F
30.318 | 1.340 | tNET | FF | 18 | DSP_R37[2][A] | u_top/u_alloc/n453_s1/B[0]
33.958 | 3.640 | tINS | FF | 8 | DSP_R37[2][A] | u_top/u_alloc/n453_s1/DOUT[6]
35.264 | 1.306 | tNET | FF | 1 | R38C16[3][A] | u_top/u_alloc/n3490_s2/I0
35.834 | 0.570 | tINS | FR | 7 | R38C16[3][A] | u_top/u_alloc/n3490_s2/F
36.542 | 0.708 | tNET | RR | 1 | R35C17[1][A] | u_top/u_alloc/v_note_1_s0/CE

Data Required Path:

AT | DELAY | TYPE | RF | FANOUT | LOC | NODE
37.037 | 37.037 | | | | | active clock edge time
37.037 | 0.000 | | | | | clk_27m
37.037 | 0.000 | tCL | RR | 1 | IOT27[A] | clk_27m_ibuf/I
39.125 | 2.088 | tINS | RR | 3747 | IOT27[A] | clk_27m_ibuf/O
41.396 | 2.271 | tNET | RR | 1 | R35C17[1][A] | u_top/u_alloc/v_note_1_s0/CLK
41.361 | -0.035 | tSu | | 1 | R35C17[1][A] | u_top/u_alloc/v_note_1_s0

Path Statistics:

Clock Skew | 0.000
Setup Relationship | 37.037
Logic Level | 21
Arrival Clock Path Delay | cell: 2.088, 47.897%; route: 2.271, 52.103%
Arrival Data Path Delay | cell: 12.306, 38.238%; route: 19.644, 61.041%; tC2Q: 0.232, 0.721%
Required Clock Path Delay | cell: 2.088, 47.897%; route: 2.271, 52.103%

### Path3

Path Summary:

Slack | 4.820
Data Arrival Time | 36.542
Data Required Time | 41.361
From | u_top/u_manual/rd_ptr_0_s0
To | u_top/u_alloc/v_note_2_s0
Launch Clk | clk_27m:[R]
Latch Clk | clk_27m:[R]

Data Arrival Path:

AT | DELAY | TYPE | RF | FANOUT | LOC | NODE
0.000 | 0.000 | | | | | active clock edge time
0.000 | 0.000 | | | | | clk_27m
0.000 | 0.000 | tCL | RR | 1 | IOT27[A] | clk_27m_ibuf/I
2.088 | 2.088 | tINS | RR | 3747 | IOT27[A] | clk_27m_ibuf/O
4.359 | 2.271 | tNET | RR | 1 | R16C49[0][A] | u_top/u_manual/rd_ptr_0_s0/CLK
4.591 | 0.232 | tC2Q | RF | 7 | R16C49[0][A] | u_top/u_manual/rd_ptr_0_s0/Q
6.030 | 1.439 | tNET | FF | 2 | R13C47[0][A] | u_top/u_manual/n4_s0/I1
6.600 | 0.570 | tINS | FR | 1 | R13C47[0][A] | u_top/u_manual/n4_s0/COUT
6.600 | 0.000 | tNET | RR | 2 | R13C47[0][B] | u_top/u_manual/n5_s0/CIN
6.635 | 0.035 | tINS | RF | 1 | R13C47[0][B] | u_top/u_manual/n5_s0/COUT
6.635 | 0.000 | tNET | FF | 2 | R13C47[1][A] | u_top/u_manual/n6_s0/CIN
6.670 | 0.035 | tINS | FF | 1 | R13C47[1][A] | u_top/u_manual/n6_s0/COUT
6.670 | 0.000 | tNET | FF | 2 | R13C47[1][B] | u_top/u_manual/n7_s0/CIN
6.706 | 0.035 | tINS | FF | 1 | R13C47[1][B] | u_top/u_manual/n7_s0/COUT
6.706 | 0.000 | tNET | FF | 2 | R13C47[2][A] | u_top/u_manual/n8_s0/CIN
6.741 | 0.035 | tINS | FF | 17 | R13C47[2][A] | u_top/u_manual/n8_s0/COUT
7.811 | 1.070 | tNET | FF | 1 | R14C48[3][B] | u_top/ev_word_13_s2/I2
8.366 | 0.555 | tINS | FF | 1 | R14C48[3][B] | u_top/ev_word_13_s2/F
9.277 | 0.911 | tNET | FF | 1 | R12C38[3][A] | u_top/ev_word_13_s1/I1
9.648 | 0.371 | tINS | FF | 3 | R12C38[3][A] | u_top/ev_word_13_s1/F
10.070 | 0.422 | tNET | FF | 1 | R9C38[3][A] | u_top/ev_word_13_s0/I0
10.523 | 0.453 | tINS | FF | 55 | R9C38[3][A] | u_top/ev_word_13_s0/F
14.971 | 4.448 | tNET | FF | 2 | R39C20[2][B] | u_top/u_alloc/n80_s0/I1
15.541 | 0.570 | tINS | FR | 1 | R39C20[2][B] | u_top/u_alloc/n80_s0/COUT
15.541 | 0.000 | tNET | RR | 2 | R39C21[0][A] | u_top/u_alloc/n81_s0/CIN
15.576 | 0.035 | tINS | RF | 2 | R39C21[0][A] | u_top/u_alloc/n81_s0/COUT
16.692 | 1.115 | tNET | FF | 1 | R43C21[2][A] | u_top/u_alloc/v_gate_3_s3/I0
17.209 | 0.517 | tINS | FF | 3 | R43C21[2][A] | u_top/u_alloc/v_gate_3_s3/F
17.879 | 0.671 | tNET | FF | 1 | R45C20[1][B] | u_top/u_alloc/pick_2_s146/I2
18.396 | 0.517 | tINS | FF | 3 | R45C20[1][B] | u_top/u_alloc/pick_2_s146/F
18.896 | 0.500 | tNET | FF | 1 | R47C18[0][A] | u_top/u_alloc/pick_0_s9/I2
19.451 | 0.555 | tINS | FF | 5 | R47C18[0][A] | u_top/u_alloc/pick_0_s9/F
20.195 | 0.744 | tNET | FF | 1 | R44C19[1][A] | u_top/u_alloc/pick_0_s3/I1
20.750 | 0.555 | tINS | FF | 8 | R44C19[1][A] | u_top/u_alloc/pick_0_s3/F
21.579 | 0.828 | tNET | FF | 1 | R42C17[3][A] | u_top/u_alloc/pick_2_s64/I0
21.950 | 0.371 | tINS | FF | 3 | R42C17[3][A] | u_top/u_alloc/pick_2_s64/F
23.469 | 1.519 | tNET | FF | 1 | R47C14[3][B] | u_top/u_alloc/pick_2_s52/I1
23.840 | 0.371 | tINS | FF | 1 | R47C14[3][B] | u_top/u_alloc/pick_2_s52/F
23.844 | 0.004 | tNET | FF | 1 | R47C14[3][A] | u_top/u_alloc/pick_2_s21/I3
24.361 | 0.517 | tINS | FF | 2 | R47C14[3][A] | u_top/u_alloc/pick_2_s21/F
25.051 | 0.690 | tNET | FF | 1 | R45C18[0][B] | u_top/u_alloc/pick_2_s6/I3
25.422 | 0.371 | tINS | FF | 4 | R45C18[0][B] | u_top/u_alloc/pick_2_s6/F
25.435 | 0.013 | tNET | FF | 1 | R45C18[2][B] | u_top/u_alloc/pick_2_s1/I1
25.990 | 0.555 | tINS | FF | 4 | R45C18[2][B] | u_top/u_alloc/pick_2_s1/F
27.213 | 1.222 | tNET | FF | 1 | R47C15[3][B] | u_top/u_alloc/pick_0_s2/I1
27.768 | 0.555 | tINS | FF | 9 | R47C15[3][B] | u_top/u_alloc/pick_0_s2/F
28.461 | 0.693 | tNET | FF | 1 | R42C16[3][B] | u_top/u_alloc/pick_0_s49/I3
28.978 | 0.517 | tINS | FF | 26 | R42C16[3][B] | u_top/u_alloc/pick_0_s49/F
30.318 | 1.340 | tNET | FF | 18 | DSP_R37[2][A] | u_top/u_alloc/n453_s1/B[0]
33.958 | 3.640 | tINS | FF | 8 | DSP_R37[2][A] | u_top/u_alloc/n453_s1/DOUT[6]
35.264 | 1.306 | tNET | FF | 1 | R38C16[3][A] | u_top/u_alloc/n3490_s2/I0
35.834 | 0.570 | tINS | FR | 7 | R38C16[3][A] | u_top/u_alloc/n3490_s2/F
36.542 | 0.708 | tNET | RR | 1 | R35C17[2][A] | u_top/u_alloc/v_note_2_s0/CE

Data Required Path:

AT | DELAY | TYPE | RF | FANOUT | LOC | NODE
37.037 | 37.037 | | | | | active clock edge time
37.037 | 0.000 | | | | | clk_27m
37.037 | 0.000 | tCL | RR | 1 | IOT27[A] | clk_27m_ibuf/I
39.125 | 2.088 | tINS | RR | 3747 | IOT27[A] | clk_27m_ibuf/O
41.396 | 2.271 | tNET | RR | 1 | R35C17[2][A] | u_top/u_alloc/v_note_2_s0/CLK
41.361 | -0.035 | tSu | | 1 | R35C17[2][A] | u_top/u_alloc/v_note_2_s0

Path Statistics:

Clock Skew | 0.000
Setup Relationship | 37.037
Logic Level | 21
Arrival Clock Path Delay | cell: 2.088, 47.897%; route: 2.271, 52.103%
Arrival Data Path Delay | cell: 12.306, 38.238%; route: 19.644, 61.041%; tC2Q: 0.232, 0.721%
Required Clock Path Delay | cell: 2.088, 47.897%; route: 2.271, 52.103%

### Path4

Path Summary:

Slack | 4.820
Data Arrival Time | 36.542
Data Required Time | 41.361
From | u_top/u_manual/rd_ptr_0_s0
To | u_top/u_alloc/v_note_3_s0
Launch Clk | clk_27m:[R]
Latch Clk | clk_27m:[R]

Data Arrival Path:

AT | DELAY | TYPE | RF | FANOUT | LOC | NODE
0.000 | 0.000 | | | | | active clock edge time
0.000 | 0.000 | | | | | clk_27m
0.000 | 0.000 | tCL | RR | 1 | IOT27[A] | clk_27m_ibuf/I
2.088 | 2.088 | tINS | RR | 3747 | IOT27[A] | clk_27m_ibuf/O
4.359 | 2.271 | tNET | RR | 1 | R16C49[0][A] | u_top/u_manual/rd_ptr_0_s0/CLK
4.591 | 0.232 | tC2Q | RF | 7 | R16C49[0][A] | u_top/u_manual/rd_ptr_0_s0/Q
6.030 | 1.439 | tNET | FF | 2 | R13C47[0][A] | u_top/u_manual/n4_s0/I1
6.600 | 0.570 | tINS | FR | 1 | R13C47[0][A] | u_top/u_manual/n4_s0/COUT
6.600 | 0.000 | tNET | RR | 2 | R13C47[0][B] | u_top/u_manual/n5_s0/CIN
6.635 | 0.035 | tINS | RF | 1 | R13C47[0][B] | u_top/u_manual/n5_s0/COUT
6.635 | 0.000 | tNET | FF | 2 | R13C47[1][A] | u_top/u_manual/n6_s0/CIN
6.670 | 0.035 | tINS | FF | 1 | R13C47[1][A] | u_top/u_manual/n6_s0/COUT
6.670 | 0.000 | tNET | FF | 2 | R13C47[1][B] | u_top/u_manual/n7_s0/CIN
6.706 | 0.035 | tINS | FF | 1 | R13C47[1][B] | u_top/u_manual/n7_s0/COUT
6.706 | 0.000 | tNET | FF | 2 | R13C47[2][A] | u_top/u_manual/n8_s0/CIN
6.741 | 0.035 | tINS | FF | 17 | R13C47[2][A] | u_top/u_manual/n8_s0/COUT
7.811 | 1.070 | tNET | FF | 1 | R14C48[3][B] | u_top/ev_word_13_s2/I2
8.366 | 0.555 | tINS | FF | 1 | R14C48[3][B] | u_top/ev_word_13_s2/F
9.277 | 0.911 | tNET | FF | 1 | R12C38[3][A] | u_top/ev_word_13_s1/I1
9.648 | 0.371 | tINS | FF | 3 | R12C38[3][A] | u_top/ev_word_13_s1/F
10.070 | 0.422 | tNET | FF | 1 | R9C38[3][A] | u_top/ev_word_13_s0/I0
10.523 | 0.453 | tINS | FF | 55 | R9C38[3][A] | u_top/ev_word_13_s0/F
14.971 | 4.448 | tNET | FF | 2 | R39C20[2][B] | u_top/u_alloc/n80_s0/I1
15.541 | 0.570 | tINS | FR | 1 | R39C20[2][B] | u_top/u_alloc/n80_s0/COUT
15.541 | 0.000 | tNET | RR | 2 | R39C21[0][A] | u_top/u_alloc/n81_s0/CIN
15.576 | 0.035 | tINS | RF | 2 | R39C21[0][A] | u_top/u_alloc/n81_s0/COUT
16.692 | 1.115 | tNET | FF | 1 | R43C21[2][A] | u_top/u_alloc/v_gate_3_s3/I0
17.209 | 0.517 | tINS | FF | 3 | R43C21[2][A] | u_top/u_alloc/v_gate_3_s3/F
17.879 | 0.671 | tNET | FF | 1 | R45C20[1][B] | u_top/u_alloc/pick_2_s146/I2
18.396 | 0.517 | tINS | FF | 3 | R45C20[1][B] | u_top/u_alloc/pick_2_s146/F
18.896 | 0.500 | tNET | FF | 1 | R47C18[0][A] | u_top/u_alloc/pick_0_s9/I2
19.451 | 0.555 | tINS | FF | 5 | R47C18[0][A] | u_top/u_alloc/pick_0_s9/F
20.195 | 0.744 | tNET | FF | 1 | R44C19[1][A] | u_top/u_alloc/pick_0_s3/I1
20.750 | 0.555 | tINS | FF | 8 | R44C19[1][A] | u_top/u_alloc/pick_0_s3/F
21.579 | 0.828 | tNET | FF | 1 | R42C17[3][A] | u_top/u_alloc/pick_2_s64/I0
21.950 | 0.371 | tINS | FF | 3 | R42C17[3][A] | u_top/u_alloc/pick_2_s64/F
23.469 | 1.519 | tNET | FF | 1 | R47C14[3][B] | u_top/u_alloc/pick_2_s52/I1
23.840 | 0.371 | tINS | FF | 1 | R47C14[3][B] | u_top/u_alloc/pick_2_s52/F
23.844 | 0.004 | tNET | FF | 1 | R47C14[3][A] | u_top/u_alloc/pick_2_s21/I3
24.361 | 0.517 | tINS | FF | 2 | R47C14[3][A] | u_top/u_alloc/pick_2_s21/F
25.051 | 0.690 | tNET | FF | 1 | R45C18[0][B] | u_top/u_alloc/pick_2_s6/I3
25.422 | 0.371 | tINS | FF | 4 | R45C18[0][B] | u_top/u_alloc/pick_2_s6/F
25.435 | 0.013 | tNET | FF | 1 | R45C18[2][B] | u_top/u_alloc/pick_2_s1/I1
25.990 | 0.555 | tINS | FF | 4 | R45C18[2][B] | u_top/u_alloc/pick_2_s1/F
27.213 | 1.222 | tNET | FF | 1 | R47C15[3][B] | u_top/u_alloc/pick_0_s2/I1
27.768 | 0.555 | tINS | FF | 9 | R47C15[3][B] | u_top/u_alloc/pick_0_s2/F
28.461 | 0.693 | tNET | FF | 1 | R42C16[3][B] | u_top/u_alloc/pick_0_s49/I3
28.978 | 0.517 | tINS | FF | 26 | R42C16[3][B] | u_top/u_alloc/pick_0_s49/F
30.318 | 1.340 | tNET | FF | 18 | DSP_R37[2][A] | u_top/u_alloc/n453_s1/B[0]
33.958 | 3.640 | tINS | FF | 8 | DSP_R37[2][A] | u_top/u_alloc/n453_s1/DOUT[6]
35.264 | 1.306 | tNET | FF | 1 | R38C16[3][A] | u_top/u_alloc/n3490_s2/I0
35.834 | 0.570 | tINS | FR | 7 | R38C16[3][A] | u_top/u_alloc/n3490_s2/F
36.542 | 0.708 | tNET | RR | 1 | R35C17[0][B] | u_top/u_alloc/v_note_3_s0/CE

Data Required Path:

AT | DELAY | TYPE | RF | FANOUT | LOC | NODE
37.037 | 37.037 | | | | | active clock edge time
37.037 | 0.000 | | | | | clk_27m
37.037 | 0.000 | tCL | RR | 1 | IOT27[A] | clk_27m_ibuf/I
39.125 | 2.088 | tINS | RR | 3747 | IOT27[A] | clk_27m_ibuf/O
41.396 | 2.271 | tNET | RR | 1 | R35C17[0][B] | u_top/u_alloc/v_note_3_s0/CLK
41.361 | -0.035 | tSu | | 1 | R35C17[0][B] | u_top/u_alloc/v_note_3_s0

Path Statistics:

Clock Skew | 0.000
Setup Relationship | 37.037
Logic Level | 21
Arrival Clock Path Delay | cell: 2.088, 47.897%; route: 2.271, 52.103%
Arrival Data Path Delay | cell: 12.306, 38.238%; route: 19.644, 61.041%; tC2Q: 0.232, 0.721%
Required Clock Path Delay | cell: 2.088, 47.897%; route: 2.271, 52.103%

### Path5

Path Summary:

Slack | 5.199
Data Arrival Time | 36.163
Data Required Time | 41.361
From | u_top/u_manual/rd_ptr_0_s0
To | u_top/u_alloc/v_note_6_s0
Launch Clk | clk_27m:[R]
Latch Clk | clk_27m:[R]

Data Arrival Path:

AT | DELAY | TYPE | RF | FANOUT | LOC | NODE
0.000 | 0.000 | | | | | active clock edge time
0.000 | 0.000 | | | | | clk_27m
0.000 | 0.000 | tCL | RR | 1 | IOT27[A] | clk_27m_ibuf/I
2.088 | 2.088 | tINS | RR | 3747 | IOT27[A] | clk_27m_ibuf/O
4.359 | 2.271 | tNET | RR | 1 | R16C49[0][A] | u_top/u_manual/rd_ptr_0_s0/CLK
4.591 | 0.232 | tC2Q | RF | 7 | R16C49[0][A] | u_top/u_manual/rd_ptr_0_s0/Q
6.030 | 1.439 | tNET | FF | 2 | R13C47[0][A] | u_top/u_manual/n4_s0/I1
6.600 | 0.570 | tINS | FR | 1 | R13C47[0][A] | u_top/u_manual/n4_s0/COUT
6.600 | 0.000 | tNET | RR | 2 | R13C47[0][B] | u_top/u_manual/n5_s0/CIN
6.635 | 0.035 | tINS | RF | 1 | R13C47[0][B] | u_top/u_manual/n5_s0/COUT
6.635 | 0.000 | tNET | FF | 2 | R13C47[1][A] | u_top/u_manual/n6_s0/CIN
6.670 | 0.035 | tINS | FF | 1 | R13C47[1][A] | u_top/u_manual/n6_s0/COUT
6.670 | 0.000 | tNET | FF | 2 | R13C47[1][B] | u_top/u_manual/n7_s0/CIN
6.706 | 0.035 | tINS | FF | 1 | R13C47[1][B] | u_top/u_manual/n7_s0/COUT
6.706 | 0.000 | tNET | FF | 2 | R13C47[2][A] | u_top/u_manual/n8_s0/CIN
6.741 | 0.035 | tINS | FF | 17 | R13C47[2][A] | u_top/u_manual/n8_s0/COUT
7.811 | 1.070 | tNET | FF | 1 | R14C48[3][B] | u_top/ev_word_13_s2/I2
8.366 | 0.555 | tINS | FF | 1 | R14C48[3][B] | u_top/ev_word_13_s2/F
9.277 | 0.911 | tNET | FF | 1 | R12C38[3][A] | u_top/ev_word_13_s1/I1
9.648 | 0.371 | tINS | FF | 3 | R12C38[3][A] | u_top/ev_word_13_s1/F
10.070 | 0.422 | tNET | FF | 1 | R9C38[3][A] | u_top/ev_word_13_s0/I0
10.523 | 0.453 | tINS | FF | 55 | R9C38[3][A] | u_top/ev_word_13_s0/F
14.971 | 4.448 | tNET | FF | 2 | R39C20[2][B] | u_top/u_alloc/n80_s0/I1
15.541 | 0.570 | tINS | FR | 1 | R39C20[2][B] | u_top/u_alloc/n80_s0/COUT
15.541 | 0.000 | tNET | RR | 2 | R39C21[0][A] | u_top/u_alloc/n81_s0/CIN
15.576 | 0.035 | tINS | RF | 2 | R39C21[0][A] | u_top/u_alloc/n81_s0/COUT
16.692 | 1.115 | tNET | FF | 1 | R43C21[2][A] | u_top/u_alloc/v_gate_3_s3/I0
17.209 | 0.517 | tINS | FF | 3 | R43C21[2][A] | u_top/u_alloc/v_gate_3_s3/F
17.879 | 0.671 | tNET | FF | 1 | R45C20[1][B] | u_top/u_alloc/pick_2_s146/I2
18.396 | 0.517 | tINS | FF | 3 | R45C20[1][B] | u_top/u_alloc/pick_2_s146/F
18.896 | 0.500 | tNET | FF | 1 | R47C18[0][A] | u_top/u_alloc/pick_0_s9/I2
19.451 | 0.555 | tINS | FF | 5 | R47C18[0][A] | u_top/u_alloc/pick_0_s9/F
20.195 | 0.744 | tNET | FF | 1 | R44C19[1][A] | u_top/u_alloc/pick_0_s3/I1
20.750 | 0.555 | tINS | FF | 8 | R44C19[1][A] | u_top/u_alloc/pick_0_s3/F
21.579 | 0.828 | tNET | FF | 1 | R42C17[3][A] | u_top/u_alloc/pick_2_s64/I0
21.950 | 0.371 | tINS | FF | 3 | R42C17[3][A] | u_top/u_alloc/pick_2_s64/F
23.469 | 1.519 | tNET | FF | 1 | R47C14[3][B] | u_top/u_alloc/pick_2_s52/I1
23.840 | 0.371 | tINS | FF | 1 | R47C14[3][B] | u_top/u_alloc/pick_2_s52/F
23.844 | 0.004 | tNET | FF | 1 | R47C14[3][A] | u_top/u_alloc/pick_2_s21/I3
24.361 | 0.517 | tINS | FF | 2 | R47C14[3][A] | u_top/u_alloc/pick_2_s21/F
25.051 | 0.690 | tNET | FF | 1 | R45C18[0][B] | u_top/u_alloc/pick_2_s6/I3
25.422 | 0.371 | tINS | FF | 4 | R45C18[0][B] | u_top/u_alloc/pick_2_s6/F
25.435 | 0.013 | tNET | FF | 1 | R45C18[2][B] | u_top/u_alloc/pick_2_s1/I1
25.990 | 0.555 | tINS | FF | 4 | R45C18[2][B] | u_top/u_alloc/pick_2_s1/F
27.213 | 1.222 | tNET | FF | 1 | R47C15[3][B] | u_top/u_alloc/pick_0_s2/I1
27.768 | 0.555 | tINS | FF | 9 | R47C15[3][B] | u_top/u_alloc/pick_0_s2/F
28.461 | 0.693 | tNET | FF | 1 | R42C16[3][B] | u_top/u_alloc/pick_0_s49/I3
28.978 | 0.517 | tINS | FF | 26 | R42C16[3][B] | u_top/u_alloc/pick_0_s49/F
30.318 | 1.340 | tNET | FF | 18 | DSP_R37[2][A] | u_top/u_alloc/n453_s1/B[0]
33.958 | 3.640 | tINS | FF | 8 | DSP_R37[2][A] | u_top/u_alloc/n453_s1/DOUT[6]
35.264 | 1.306 | tNET | FF | 1 | R38C16[3][A] | u_top/u_alloc/n3490_s2/I0
35.834 | 0.570 | tINS | FR | 7 | R38C16[3][A] | u_top/u_alloc/n3490_s2/F
36.163 | 0.329 | tNET | RR | 1 | R38C18[1][A] | u_top/u_alloc/v_note_6_s0/CE

Data Required Path:

AT | DELAY | TYPE | RF | FANOUT | LOC | NODE
37.037 | 37.037 | | | | | active clock edge time
37.037 | 0.000 | | | | | clk_27m
37.037 | 0.000 | tCL | RR | 1 | IOT27[A] | clk_27m_ibuf/I
39.125 | 2.088 | tINS | RR | 3747 | IOT27[A] | clk_27m_ibuf/O
41.396 | 2.271 | tNET | RR | 1 | R38C18[1][A] | u_top/u_alloc/v_note_6_s0/CLK
41.361 | -0.035 | tSu | | 1 | R38C18[1][A] | u_top/u_alloc/v_note_6_s0

Path Statistics:

Clock Skew | 0.000
Setup Relationship | 37.037
Logic Level | 21
Arrival Clock Path Delay | cell: 2.088, 47.897%; route: 2.271, 52.103%
Arrival Data Path Delay | cell: 12.306, 38.694%; route: 19.265, 60.577%; tC2Q: 0.232, 0.729%
Required Clock Path Delay | cell: 2.088, 47.897%; route: 2.271, 52.103%

### Path6

Path Summary:

Slack | 5.313
Data Arrival Time | 36.048
Data Required Time | 41.361
From | u_top/u_manual/rd_ptr_0_s0
To | u_top/u_alloc/v_note_28_s0
Launch Clk | clk_27m:[R]
Latch Clk | clk_27m:[R]

Data Arrival Path:

AT | DELAY | TYPE | RF | FANOUT | LOC | NODE
0.000 | 0.000 | | | | | active clock edge time
0.000 | 0.000 | | | | | clk_27m
0.000 | 0.000 | tCL | RR | 1 | IOT27[A] | clk_27m_ibuf/I
2.088 | 2.088 | tINS | RR | 3747 | IOT27[A] | clk_27m_ibuf/O
4.359 | 2.271 | tNET | RR | 1 | R16C49[0][A] | u_top/u_manual/rd_ptr_0_s0/CLK
4.591 | 0.232 | tC2Q | RF | 7 | R16C49[0][A] | u_top/u_manual/rd_ptr_0_s0/Q
6.030 | 1.439 | tNET | FF | 2 | R13C47[0][A] | u_top/u_manual/n4_s0/I1
6.600 | 0.570 | tINS | FR | 1 | R13C47[0][A] | u_top/u_manual/n4_s0/COUT
6.600 | 0.000 | tNET | RR | 2 | R13C47[0][B] | u_top/u_manual/n5_s0/CIN
6.635 | 0.035 | tINS | RF | 1 | R13C47[0][B] | u_top/u_manual/n5_s0/COUT
6.635 | 0.000 | tNET | FF | 2 | R13C47[1][A] | u_top/u_manual/n6_s0/CIN
6.670 | 0.035 | tINS | FF | 1 | R13C47[1][A] | u_top/u_manual/n6_s0/COUT
6.670 | 0.000 | tNET | FF | 2 | R13C47[1][B] | u_top/u_manual/n7_s0/CIN
6.706 | 0.035 | tINS | FF | 1 | R13C47[1][B] | u_top/u_manual/n7_s0/COUT
6.706 | 0.000 | tNET | FF | 2 | R13C47[2][A] | u_top/u_manual/n8_s0/CIN
6.741 | 0.035 | tINS | FF | 17 | R13C47[2][A] | u_top/u_manual/n8_s0/COUT
7.811 | 1.070 | tNET | FF | 1 | R14C48[3][B] | u_top/ev_word_13_s2/I2
8.366 | 0.555 | tINS | FF | 1 | R14C48[3][B] | u_top/ev_word_13_s2/F
9.277 | 0.911 | tNET | FF | 1 | R12C38[3][A] | u_top/ev_word_13_s1/I1
9.648 | 0.371 | tINS | FF | 3 | R12C38[3][A] | u_top/ev_word_13_s1/F
10.070 | 0.422 | tNET | FF | 1 | R9C38[3][A] | u_top/ev_word_13_s0/I0
10.523 | 0.453 | tINS | FF | 55 | R9C38[3][A] | u_top/ev_word_13_s0/F
14.971 | 4.448 | tNET | FF | 2 | R39C20[2][B] | u_top/u_alloc/n80_s0/I1
15.541 | 0.570 | tINS | FR | 1 | R39C20[2][B] | u_top/u_alloc/n80_s0/COUT
15.541 | 0.000 | tNET | RR | 2 | R39C21[0][A] | u_top/u_alloc/n81_s0/CIN
15.576 | 0.035 | tINS | RF | 2 | R39C21[0][A] | u_top/u_alloc/n81_s0/COUT
16.692 | 1.115 | tNET | FF | 1 | R43C21[2][A] | u_top/u_alloc/v_gate_3_s3/I0
17.209 | 0.517 | tINS | FF | 3 | R43C21[2][A] | u_top/u_alloc/v_gate_3_s3/F
17.879 | 0.671 | tNET | FF | 1 | R45C20[1][B] | u_top/u_alloc/pick_2_s146/I2
18.396 | 0.517 | tINS | FF | 3 | R45C20[1][B] | u_top/u_alloc/pick_2_s146/F
18.896 | 0.500 | tNET | FF | 1 | R47C18[0][A] | u_top/u_alloc/pick_0_s9/I2
19.451 | 0.555 | tINS | FF | 5 | R47C18[0][A] | u_top/u_alloc/pick_0_s9/F
20.195 | 0.744 | tNET | FF | 1 | R44C19[1][A] | u_top/u_alloc/pick_0_s3/I1
20.750 | 0.555 | tINS | FF | 8 | R44C19[1][A] | u_top/u_alloc/pick_0_s3/F
21.579 | 0.828 | tNET | FF | 1 | R42C17[3][A] | u_top/u_alloc/pick_2_s64/I0
21.950 | 0.371 | tINS | FF | 3 | R42C17[3][A] | u_top/u_alloc/pick_2_s64/F
23.469 | 1.519 | tNET | FF | 1 | R47C14[3][B] | u_top/u_alloc/pick_2_s52/I1
23.840 | 0.371 | tINS | FF | 1 | R47C14[3][B] | u_top/u_alloc/pick_2_s52/F
23.844 | 0.004 | tNET | FF | 1 | R47C14[3][A] | u_top/u_alloc/pick_2_s21/I3
24.361 | 0.517 | tINS | FF | 2 | R47C14[3][A] | u_top/u_alloc/pick_2_s21/F
25.051 | 0.690 | tNET | FF | 1 | R45C18[0][B] | u_top/u_alloc/pick_2_s6/I3
25.422 | 0.371 | tINS | FF | 4 | R45C18[0][B] | u_top/u_alloc/pick_2_s6/F
25.435 | 0.013 | tNET | FF | 1 | R45C18[2][B] | u_top/u_alloc/pick_2_s1/I1
25.990 | 0.555 | tINS | FF | 4 | R45C18[2][B] | u_top/u_alloc/pick_2_s1/F
27.213 | 1.222 | tNET | FF | 1 | R47C15[3][B] | u_top/u_alloc/pick_0_s2/I1
27.768 | 0.555 | tINS | FF | 9 | R47C15[3][B] | u_top/u_alloc/pick_0_s2/F
28.461 | 0.693 | tNET | FF | 1 | R42C16[3][B] | u_top/u_alloc/pick_0_s49/I3
28.978 | 0.517 | tINS | FF | 26 | R42C16[3][B] | u_top/u_alloc/pick_0_s49/F
30.318 | 1.340 | tNET | FF | 18 | DSP_R37[2][A] | u_top/u_alloc/n453_s1/B[0]
33.958 | 3.640 | tINS | FF | 8 | DSP_R37[2][A] | u_top/u_alloc/n453_s1/DOUT[6]
35.114 | 1.156 | tNET | FF | 1 | R40C17[2][B] | u_top/u_alloc/n3434_s1/I0
35.684 | 0.570 | tINS | FR | 7 | R40C17[2][B] | u_top/u_alloc/n3434_s1/F
36.048 | 0.365 | tNET | RR | 1 | R40C18[0][A] | u_top/u_alloc/v_note_28_s0/CE

Data Required Path:

AT | DELAY | TYPE | RF | FANOUT | LOC | NODE
37.037 | 37.037 | | | | | active clock edge time
37.037 | 0.000 | | | | | clk_27m
37.037 | 0.000 | tCL | RR | 1 | IOT27[A] | clk_27m_ibuf/I
39.125 | 2.088 | tINS | RR | 3747 | IOT27[A] | clk_27m_ibuf/O
41.396 | 2.271 | tNET | RR | 1 | R40C18[0][A] | u_top/u_alloc/v_note_28_s0/CLK
41.361 | -0.035 | tSu | | 1 | R40C18[0][A] | u_top/u_alloc/v_note_28_s0

Path Statistics:

Clock Skew | 0.000
Setup Relationship | 37.037
Logic Level | 21
Arrival Clock Path Delay | cell: 2.088, 47.897%; route: 2.271, 52.103%
Arrival Data Path Delay | cell: 12.306, 38.833%; route: 19.151, 60.434%; tC2Q: 0.232, 0.732%
Required Clock Path Delay | cell: 2.088, 47.897%; route: 2.271, 52.103%

### Path7

Path Summary:

Slack | 5.313
Data Arrival Time | 36.048
Data Required Time | 41.361
From | u_top/u_manual/rd_ptr_0_s0
To | u_top/u_alloc/v_note_30_s0
Launch Clk | clk_27m:[R]
Latch Clk | clk_27m:[R]

Data Arrival Path:

AT | DELAY | TYPE | RF | FANOUT | LOC | NODE
0.000 | 0.000 | | | | | active clock edge time
0.000 | 0.000 | | | | | clk_27m
0.000 | 0.000 | tCL | RR | 1 | IOT27[A] | clk_27m_ibuf/I
2.088 | 2.088 | tINS | RR | 3747 | IOT27[A] | clk_27m_ibuf/O
4.359 | 2.271 | tNET | RR | 1 | R16C49[0][A] | u_top/u_manual/rd_ptr_0_s0/CLK
4.591 | 0.232 | tC2Q | RF | 7 | R16C49[0][A] | u_top/u_manual/rd_ptr_0_s0/Q
6.030 | 1.439 | tNET | FF | 2 | R13C47[0][A] | u_top/u_manual/n4_s0/I1
6.600 | 0.570 | tINS | FR | 1 | R13C47[0][A] | u_top/u_manual/n4_s0/COUT
6.600 | 0.000 | tNET | RR | 2 | R13C47[0][B] | u_top/u_manual/n5_s0/CIN
6.635 | 0.035 | tINS | RF | 1 | R13C47[0][B] | u_top/u_manual/n5_s0/COUT
6.635 | 0.000 | tNET | FF | 2 | R13C47[1][A] | u_top/u_manual/n6_s0/CIN
6.670 | 0.035 | tINS | FF | 1 | R13C47[1][A] | u_top/u_manual/n6_s0/COUT
6.670 | 0.000 | tNET | FF | 2 | R13C47[1][B] | u_top/u_manual/n7_s0/CIN
6.706 | 0.035 | tINS | FF | 1 | R13C47[1][B] | u_top/u_manual/n7_s0/COUT
6.706 | 0.000 | tNET | FF | 2 | R13C47[2][A] | u_top/u_manual/n8_s0/CIN
6.741 | 0.035 | tINS | FF | 17 | R13C47[2][A] | u_top/u_manual/n8_s0/COUT
7.811 | 1.070 | tNET | FF | 1 | R14C48[3][B] | u_top/ev_word_13_s2/I2
8.366 | 0.555 | tINS | FF | 1 | R14C48[3][B] | u_top/ev_word_13_s2/F
9.277 | 0.911 | tNET | FF | 1 | R12C38[3][A] | u_top/ev_word_13_s1/I1
9.648 | 0.371 | tINS | FF | 3 | R12C38[3][A] | u_top/ev_word_13_s1/F
10.070 | 0.422 | tNET | FF | 1 | R9C38[3][A] | u_top/ev_word_13_s0/I0
10.523 | 0.453 | tINS | FF | 55 | R9C38[3][A] | u_top/ev_word_13_s0/F
14.971 | 4.448 | tNET | FF | 2 | R39C20[2][B] | u_top/u_alloc/n80_s0/I1
15.541 | 0.570 | tINS | FR | 1 | R39C20[2][B] | u_top/u_alloc/n80_s0/COUT
15.541 | 0.000 | tNET | RR | 2 | R39C21[0][A] | u_top/u_alloc/n81_s0/CIN
15.576 | 0.035 | tINS | RF | 2 | R39C21[0][A] | u_top/u_alloc/n81_s0/COUT
16.692 | 1.115 | tNET | FF | 1 | R43C21[2][A] | u_top/u_alloc/v_gate_3_s3/I0
17.209 | 0.517 | tINS | FF | 3 | R43C21[2][A] | u_top/u_alloc/v_gate_3_s3/F
17.879 | 0.671 | tNET | FF | 1 | R45C20[1][B] | u_top/u_alloc/pick_2_s146/I2
18.396 | 0.517 | tINS | FF | 3 | R45C20[1][B] | u_top/u_alloc/pick_2_s146/F
18.896 | 0.500 | tNET | FF | 1 | R47C18[0][A] | u_top/u_alloc/pick_0_s9/I2
19.451 | 0.555 | tINS | FF | 5 | R47C18[0][A] | u_top/u_alloc/pick_0_s9/F
20.195 | 0.744 | tNET | FF | 1 | R44C19[1][A] | u_top/u_alloc/pick_0_s3/I1
20.750 | 0.555 | tINS | FF | 8 | R44C19[1][A] | u_top/u_alloc/pick_0_s3/F
21.579 | 0.828 | tNET | FF | 1 | R42C17[3][A] | u_top/u_alloc/pick_2_s64/I0
21.950 | 0.371 | tINS | FF | 3 | R42C17[3][A] | u_top/u_alloc/pick_2_s64/F
23.469 | 1.519 | tNET | FF | 1 | R47C14[3][B] | u_top/u_alloc/pick_2_s52/I1
23.840 | 0.371 | tINS | FF | 1 | R47C14[3][B] | u_top/u_alloc/pick_2_s52/F
23.844 | 0.004 | tNET | FF | 1 | R47C14[3][A] | u_top/u_alloc/pick_2_s21/I3
24.361 | 0.517 | tINS | FF | 2 | R47C14[3][A] | u_top/u_alloc/pick_2_s21/F
25.051 | 0.690 | tNET | FF | 1 | R45C18[0][B] | u_top/u_alloc/pick_2_s6/I3
25.422 | 0.371 | tINS | FF | 4 | R45C18[0][B] | u_top/u_alloc/pick_2_s6/F
25.435 | 0.013 | tNET | FF | 1 | R45C18[2][B] | u_top/u_alloc/pick_2_s1/I1
25.990 | 0.555 | tINS | FF | 4 | R45C18[2][B] | u_top/u_alloc/pick_2_s1/F
27.213 | 1.222 | tNET | FF | 1 | R47C15[3][B] | u_top/u_alloc/pick_0_s2/I1
27.768 | 0.555 | tINS | FF | 9 | R47C15[3][B] | u_top/u_alloc/pick_0_s2/F
28.461 | 0.693 | tNET | FF | 1 | R42C16[3][B] | u_top/u_alloc/pick_0_s49/I3
28.978 | 0.517 | tINS | FF | 26 | R42C16[3][B] | u_top/u_alloc/pick_0_s49/F
30.318 | 1.340 | tNET | FF | 18 | DSP_R37[2][A] | u_top/u_alloc/n453_s1/B[0]
33.958 | 3.640 | tINS | FF | 8 | DSP_R37[2][A] | u_top/u_alloc/n453_s1/DOUT[6]
35.114 | 1.156 | tNET | FF | 1 | R40C17[2][B] | u_top/u_alloc/n3434_s1/I0
35.684 | 0.570 | tINS | FR | 7 | R40C17[2][B] | u_top/u_alloc/n3434_s1/F
36.048 | 0.365 | tNET | RR | 1 | R40C18[1][A] | u_top/u_alloc/v_note_30_s0/CE

Data Required Path:

AT | DELAY | TYPE | RF | FANOUT | LOC | NODE
37.037 | 37.037 | | | | | active clock edge time
37.037 | 0.000 | | | | | clk_27m
37.037 | 0.000 | tCL | RR | 1 | IOT27[A] | clk_27m_ibuf/I
39.125 | 2.088 | tINS | RR | 3747 | IOT27[A] | clk_27m_ibuf/O
41.396 | 2.271 | tNET | RR | 1 | R40C18[1][A] | u_top/u_alloc/v_note_30_s0/CLK
41.361 | -0.035 | tSu | | 1 | R40C18[1][A] | u_top/u_alloc/v_note_30_s0

Path Statistics:

Clock Skew | 0.000
Setup Relationship | 37.037
Logic Level | 21
Arrival Clock Path Delay | cell: 2.088, 47.897%; route: 2.271, 52.103%
Arrival Data Path Delay | cell: 12.306, 38.833%; route: 19.151, 60.434%; tC2Q: 0.232, 0.732%
Required Clock Path Delay | cell: 2.088, 47.897%; route: 2.271, 52.103%

### Path8

Path Summary:

Slack | 5.313
Data Arrival Time | 36.048
Data Required Time | 41.361
From | u_top/u_manual/rd_ptr_0_s0
To | u_top/u_alloc/v_note_31_s0
Launch Clk | clk_27m:[R]
Latch Clk | clk_27m:[R]

Data Arrival Path:

AT | DELAY | TYPE | RF | FANOUT | LOC | NODE
0.000 | 0.000 | | | | | active clock edge time
0.000 | 0.000 | | | | | clk_27m
0.000 | 0.000 | tCL | RR | 1 | IOT27[A] | clk_27m_ibuf/I
2.088 | 2.088 | tINS | RR | 3747 | IOT27[A] | clk_27m_ibuf/O
4.359 | 2.271 | tNET | RR | 1 | R16C49[0][A] | u_top/u_manual/rd_ptr_0_s0/CLK
4.591 | 0.232 | tC2Q | RF | 7 | R16C49[0][A] | u_top/u_manual/rd_ptr_0_s0/Q
6.030 | 1.439 | tNET | FF | 2 | R13C47[0][A] | u_top/u_manual/n4_s0/I1
6.600 | 0.570 | tINS | FR | 1 | R13C47[0][A] | u_top/u_manual/n4_s0/COUT
6.600 | 0.000 | tNET | RR | 2 | R13C47[0][B] | u_top/u_manual/n5_s0/CIN
6.635 | 0.035 | tINS | RF | 1 | R13C47[0][B] | u_top/u_manual/n5_s0/COUT
6.635 | 0.000 | tNET | FF | 2 | R13C47[1][A] | u_top/u_manual/n6_s0/CIN
6.670 | 0.035 | tINS | FF | 1 | R13C47[1][A] | u_top/u_manual/n6_s0/COUT
6.670 | 0.000 | tNET | FF | 2 | R13C47[1][B] | u_top/u_manual/n7_s0/CIN
6.706 | 0.035 | tINS | FF | 1 | R13C47[1][B] | u_top/u_manual/n7_s0/COUT
6.706 | 0.000 | tNET | FF | 2 | R13C47[2][A] | u_top/u_manual/n8_s0/CIN
6.741 | 0.035 | tINS | FF | 17 | R13C47[2][A] | u_top/u_manual/n8_s0/COUT
7.811 | 1.070 | tNET | FF | 1 | R14C48[3][B] | u_top/ev_word_13_s2/I2
8.366 | 0.555 | tINS | FF | 1 | R14C48[3][B] | u_top/ev_word_13_s2/F
9.277 | 0.911 | tNET | FF | 1 | R12C38[3][A] | u_top/ev_word_13_s1/I1
9.648 | 0.371 | tINS | FF | 3 | R12C38[3][A] | u_top/ev_word_13_s1/F
10.070 | 0.422 | tNET | FF | 1 | R9C38[3][A] | u_top/ev_word_13_s0/I0
10.523 | 0.453 | tINS | FF | 55 | R9C38[3][A] | u_top/ev_word_13_s0/F
14.971 | 4.448 | tNET | FF | 2 | R39C20[2][B] | u_top/u_alloc/n80_s0/I1
15.541 | 0.570 | tINS | FR | 1 | R39C20[2][B] | u_top/u_alloc/n80_s0/COUT
15.541 | 0.000 | tNET | RR | 2 | R39C21[0][A] | u_top/u_alloc/n81_s0/CIN
15.576 | 0.035 | tINS | RF | 2 | R39C21[0][A] | u_top/u_alloc/n81_s0/COUT
16.692 | 1.115 | tNET | FF | 1 | R43C21[2][A] | u_top/u_alloc/v_gate_3_s3/I0
17.209 | 0.517 | tINS | FF | 3 | R43C21[2][A] | u_top/u_alloc/v_gate_3_s3/F
17.879 | 0.671 | tNET | FF | 1 | R45C20[1][B] | u_top/u_alloc/pick_2_s146/I2
18.396 | 0.517 | tINS | FF | 3 | R45C20[1][B] | u_top/u_alloc/pick_2_s146/F
18.896 | 0.500 | tNET | FF | 1 | R47C18[0][A] | u_top/u_alloc/pick_0_s9/I2
19.451 | 0.555 | tINS | FF | 5 | R47C18[0][A] | u_top/u_alloc/pick_0_s9/F
20.195 | 0.744 | tNET | FF | 1 | R44C19[1][A] | u_top/u_alloc/pick_0_s3/I1
20.750 | 0.555 | tINS | FF | 8 | R44C19[1][A] | u_top/u_alloc/pick_0_s3/F
21.579 | 0.828 | tNET | FF | 1 | R42C17[3][A] | u_top/u_alloc/pick_2_s64/I0
21.950 | 0.371 | tINS | FF | 3 | R42C17[3][A] | u_top/u_alloc/pick_2_s64/F
23.469 | 1.519 | tNET | FF | 1 | R47C14[3][B] | u_top/u_alloc/pick_2_s52/I1
23.840 | 0.371 | tINS | FF | 1 | R47C14[3][B] | u_top/u_alloc/pick_2_s52/F
23.844 | 0.004 | tNET | FF | 1 | R47C14[3][A] | u_top/u_alloc/pick_2_s21/I3
24.361 | 0.517 | tINS | FF | 2 | R47C14[3][A] | u_top/u_alloc/pick_2_s21/F
25.051 | 0.690 | tNET | FF | 1 | R45C18[0][B] | u_top/u_alloc/pick_2_s6/I3
25.422 | 0.371 | tINS | FF | 4 | R45C18[0][B] | u_top/u_alloc/pick_2_s6/F
25.435 | 0.013 | tNET | FF | 1 | R45C18[2][B] | u_top/u_alloc/pick_2_s1/I1
25.990 | 0.555 | tINS | FF | 4 | R45C18[2][B] | u_top/u_alloc/pick_2_s1/F
27.213 | 1.222 | tNET | FF | 1 | R47C15[3][B] | u_top/u_alloc/pick_0_s2/I1
27.768 | 0.555 | tINS | FF | 9 | R47C15[3][B] | u_top/u_alloc/pick_0_s2/F
28.461 | 0.693 | tNET | FF | 1 | R42C16[3][B] | u_top/u_alloc/pick_0_s49/I3
28.978 | 0.517 | tINS | FF | 26 | R42C16[3][B] | u_top/u_alloc/pick_0_s49/F
30.318 | 1.340 | tNET | FF | 18 | DSP_R37[2][A] | u_top/u_alloc/n453_s1/B[0]
33.958 | 3.640 | tINS | FF | 8 | DSP_R37[2][A] | u_top/u_alloc/n453_s1/DOUT[6]
35.114 | 1.156 | tNET | FF | 1 | R40C17[2][B] | u_top/u_alloc/n3434_s1/I0
35.684 | 0.570 | tINS | FR | 7 | R40C17[2][B] | u_top/u_alloc/n3434_s1/F
36.048 | 0.365 | tNET | RR | 1 | R40C18[1][B] | u_top/u_alloc/v_note_31_s0/CE

Data Required Path:

AT | DELAY | TYPE | RF | FANOUT | LOC | NODE
37.037 | 37.037 | | | | | active clock edge time
37.037 | 0.000 | | | | | clk_27m
37.037 | 0.000 | tCL | RR | 1 | IOT27[A] | clk_27m_ibuf/I
39.125 | 2.088 | tINS | RR | 3747 | IOT27[A] | clk_27m_ibuf/O
41.396 | 2.271 | tNET | RR | 1 | R40C18[1][B] | u_top/u_alloc/v_note_31_s0/CLK
41.361 | -0.035 | tSu | | 1 | R40C18[1][B] | u_top/u_alloc/v_note_31_s0

Path Statistics:

Clock Skew | 0.000
Setup Relationship | 37.037
Logic Level | 21
Arrival Clock Path Delay | cell: 2.088, 47.897%; route: 2.271, 52.103%
Arrival Data Path Delay | cell: 12.306, 38.833%; route: 19.151, 60.434%; tC2Q: 0.232, 0.732%
Required Clock Path Delay | cell: 2.088, 47.897%; route: 2.271, 52.103%

### Path9

Path Summary:

Slack | 5.313
Data Arrival Time | 36.048
Data Required Time | 41.361
From | u_top/u_manual/rd_ptr_0_s0
To | u_top/u_alloc/v_note_32_s0
Launch Clk | clk_27m:[R]
Latch Clk | clk_27m:[R]

Data Arrival Path:

AT | DELAY | TYPE | RF | FANOUT | LOC | NODE
0.000 | 0.000 | | | | | active clock edge time
0.000 | 0.000 | | | | | clk_27m
0.000 | 0.000 | tCL | RR | 1 | IOT27[A] | clk_27m_ibuf/I
2.088 | 2.088 | tINS | RR | 3747 | IOT27[A] | clk_27m_ibuf/O
4.359 | 2.271 | tNET | RR | 1 | R16C49[0][A] | u_top/u_manual/rd_ptr_0_s0/CLK
4.591 | 0.232 | tC2Q | RF | 7 | R16C49[0][A] | u_top/u_manual/rd_ptr_0_s0/Q
6.030 | 1.439 | tNET | FF | 2 | R13C47[0][A] | u_top/u_manual/n4_s0/I1
6.600 | 0.570 | tINS | FR | 1 | R13C47[0][A] | u_top/u_manual/n4_s0/COUT
6.600 | 0.000 | tNET | RR | 2 | R13C47[0][B] | u_top/u_manual/n5_s0/CIN
6.635 | 0.035 | tINS | RF | 1 | R13C47[0][B] | u_top/u_manual/n5_s0/COUT
6.635 | 0.000 | tNET | FF | 2 | R13C47[1][A] | u_top/u_manual/n6_s0/CIN
6.670 | 0.035 | tINS | FF | 1 | R13C47[1][A] | u_top/u_manual/n6_s0/COUT
6.670 | 0.000 | tNET | FF | 2 | R13C47[1][B] | u_top/u_manual/n7_s0/CIN
6.706 | 0.035 | tINS | FF | 1 | R13C47[1][B] | u_top/u_manual/n7_s0/COUT
6.706 | 0.000 | tNET | FF | 2 | R13C47[2][A] | u_top/u_manual/n8_s0/CIN
6.741 | 0.035 | tINS | FF | 17 | R13C47[2][A] | u_top/u_manual/n8_s0/COUT
7.811 | 1.070 | tNET | FF | 1 | R14C48[3][B] | u_top/ev_word_13_s2/I2
8.366 | 0.555 | tINS | FF | 1 | R14C48[3][B] | u_top/ev_word_13_s2/F
9.277 | 0.911 | tNET | FF | 1 | R12C38[3][A] | u_top/ev_word_13_s1/I1
9.648 | 0.371 | tINS | FF | 3 | R12C38[3][A] | u_top/ev_word_13_s1/F
10.070 | 0.422 | tNET | FF | 1 | R9C38[3][A] | u_top/ev_word_13_s0/I0
10.523 | 0.453 | tINS | FF | 55 | R9C38[3][A] | u_top/ev_word_13_s0/F
14.971 | 4.448 | tNET | FF | 2 | R39C20[2][B] | u_top/u_alloc/n80_s0/I1
15.541 | 0.570 | tINS | FR | 1 | R39C20[2][B] | u_top/u_alloc/n80_s0/COUT
15.541 | 0.000 | tNET | RR | 2 | R39C21[0][A] | u_top/u_alloc/n81_s0/CIN
15.576 | 0.035 | tINS | RF | 2 | R39C21[0][A] | u_top/u_alloc/n81_s0/COUT
16.692 | 1.115 | tNET | FF | 1 | R43C21[2][A] | u_top/u_alloc/v_gate_3_s3/I0
17.209 | 0.517 | tINS | FF | 3 | R43C21[2][A] | u_top/u_alloc/v_gate_3_s3/F
17.879 | 0.671 | tNET | FF | 1 | R45C20[1][B] | u_top/u_alloc/pick_2_s146/I2
18.396 | 0.517 | tINS | FF | 3 | R45C20[1][B] | u_top/u_alloc/pick_2_s146/F
18.896 | 0.500 | tNET | FF | 1 | R47C18[0][A] | u_top/u_alloc/pick_0_s9/I2
19.451 | 0.555 | tINS | FF | 5 | R47C18[0][A] | u_top/u_alloc/pick_0_s9/F
20.195 | 0.744 | tNET | FF | 1 | R44C19[1][A] | u_top/u_alloc/pick_0_s3/I1
20.750 | 0.555 | tINS | FF | 8 | R44C19[1][A] | u_top/u_alloc/pick_0_s3/F
21.579 | 0.828 | tNET | FF | 1 | R42C17[3][A] | u_top/u_alloc/pick_2_s64/I0
21.950 | 0.371 | tINS | FF | 3 | R42C17[3][A] | u_top/u_alloc/pick_2_s64/F
23.469 | 1.519 | tNET | FF | 1 | R47C14[3][B] | u_top/u_alloc/pick_2_s52/I1
23.840 | 0.371 | tINS | FF | 1 | R47C14[3][B] | u_top/u_alloc/pick_2_s52/F
23.844 | 0.004 | tNET | FF | 1 | R47C14[3][A] | u_top/u_alloc/pick_2_s21/I3
24.361 | 0.517 | tINS | FF | 2 | R47C14[3][A] | u_top/u_alloc/pick_2_s21/F
25.051 | 0.690 | tNET | FF | 1 | R45C18[0][B] | u_top/u_alloc/pick_2_s6/I3
25.422 | 0.371 | tINS | FF | 4 | R45C18[0][B] | u_top/u_alloc/pick_2_s6/F
25.435 | 0.013 | tNET | FF | 1 | R45C18[2][B] | u_top/u_alloc/pick_2_s1/I1
25.990 | 0.555 | tINS | FF | 4 | R45C18[2][B] | u_top/u_alloc/pick_2_s1/F
27.213 | 1.222 | tNET | FF | 1 | R47C15[3][B] | u_top/u_alloc/pick_0_s2/I1
27.768 | 0.555 | tINS | FF | 9 | R47C15[3][B] | u_top/u_alloc/pick_0_s2/F
28.461 | 0.693 | tNET | FF | 1 | R42C16[3][B] | u_top/u_alloc/pick_0_s49/I3
28.978 | 0.517 | tINS | FF | 26 | R42C16[3][B] | u_top/u_alloc/pick_0_s49/F
30.318 | 1.340 | tNET | FF | 18 | DSP_R37[2][A] | u_top/u_alloc/n453_s1/B[0]
33.958 | 3.640 | tINS | FF | 8 | DSP_R37[2][A] | u_top/u_alloc/n453_s1/DOUT[6]
35.114 | 1.156 | tNET | FF | 1 | R40C17[2][B] | u_top/u_alloc/n3434_s1/I0
35.684 | 0.570 | tINS | FR | 7 | R40C17[2][B] | u_top/u_alloc/n3434_s1/F
36.048 | 0.365 | tNET | RR | 1 | R40C18[2][A] | u_top/u_alloc/v_note_32_s0/CE

Data Required Path:

AT | DELAY | TYPE | RF | FANOUT | LOC | NODE
37.037 | 37.037 | | | | | active clock edge time
37.037 | 0.000 | | | | | clk_27m
37.037 | 0.000 | tCL | RR | 1 | IOT27[A] | clk_27m_ibuf/I
39.125 | 2.088 | tINS | RR | 3747 | IOT27[A] | clk_27m_ibuf/O
41.396 | 2.271 | tNET | RR | 1 | R40C18[2][A] | u_top/u_alloc/v_note_32_s0/CLK
41.361 | -0.035 | tSu | | 1 | R40C18[2][A] | u_top/u_alloc/v_note_32_s0

Path Statistics:

Clock Skew | 0.000
Setup Relationship | 37.037
Logic Level | 21
Arrival Clock Path Delay | cell: 2.088, 47.897%; route: 2.271, 52.103%
Arrival Data Path Delay | cell: 12.306, 38.833%; route: 19.151, 60.434%; tC2Q: 0.232, 0.732%
Required Clock Path Delay | cell: 2.088, 47.897%; route: 2.271, 52.103%

### Path10

Path Summary:

Slack | 5.313
Data Arrival Time | 36.048
Data Required Time | 41.361
From | u_top/u_manual/rd_ptr_0_s0
To | u_top/u_alloc/v_note_33_s0
Launch Clk | clk_27m:[R]
Latch Clk | clk_27m:[R]

Data Arrival Path:

AT | DELAY | TYPE | RF | FANOUT | LOC | NODE
0.000 | 0.000 | | | | | active clock edge time
0.000 | 0.000 | | | | | clk_27m
0.000 | 0.000 | tCL | RR | 1 | IOT27[A] | clk_27m_ibuf/I
2.088 | 2.088 | tINS | RR | 3747 | IOT27[A] | clk_27m_ibuf/O
4.359 | 2.271 | tNET | RR | 1 | R16C49[0][A] | u_top/u_manual/rd_ptr_0_s0/CLK
4.591 | 0.232 | tC2Q | RF | 7 | R16C49[0][A] | u_top/u_manual/rd_ptr_0_s0/Q
6.030 | 1.439 | tNET | FF | 2 | R13C47[0][A] | u_top/u_manual/n4_s0/I1
6.600 | 0.570 | tINS | FR | 1 | R13C47[0][A] | u_top/u_manual/n4_s0/COUT
6.600 | 0.000 | tNET | RR | 2 | R13C47[0][B] | u_top/u_manual/n5_s0/CIN
6.635 | 0.035 | tINS | RF | 1 | R13C47[0][B] | u_top/u_manual/n5_s0/COUT
6.635 | 0.000 | tNET | FF | 2 | R13C47[1][A] | u_top/u_manual/n6_s0/CIN
6.670 | 0.035 | tINS | FF | 1 | R13C47[1][A] | u_top/u_manual/n6_s0/COUT
6.670 | 0.000 | tNET | FF | 2 | R13C47[1][B] | u_top/u_manual/n7_s0/CIN
6.706 | 0.035 | tINS | FF | 1 | R13C47[1][B] | u_top/u_manual/n7_s0/COUT
6.706 | 0.000 | tNET | FF | 2 | R13C47[2][A] | u_top/u_manual/n8_s0/CIN
6.741 | 0.035 | tINS | FF | 17 | R13C47[2][A] | u_top/u_manual/n8_s0/COUT
7.811 | 1.070 | tNET | FF | 1 | R14C48[3][B] | u_top/ev_word_13_s2/I2
8.366 | 0.555 | tINS | FF | 1 | R14C48[3][B] | u_top/ev_word_13_s2/F
9.277 | 0.911 | tNET | FF | 1 | R12C38[3][A] | u_top/ev_word_13_s1/I1
9.648 | 0.371 | tINS | FF | 3 | R12C38[3][A] | u_top/ev_word_13_s1/F
10.070 | 0.422 | tNET | FF | 1 | R9C38[3][A] | u_top/ev_word_13_s0/I0
10.523 | 0.453 | tINS | FF | 55 | R9C38[3][A] | u_top/ev_word_13_s0/F
14.971 | 4.448 | tNET | FF | 2 | R39C20[2][B] | u_top/u_alloc/n80_s0/I1
15.541 | 0.570 | tINS | FR | 1 | R39C20[2][B] | u_top/u_alloc/n80_s0/COUT
15.541 | 0.000 | tNET | RR | 2 | R39C21[0][A] | u_top/u_alloc/n81_s0/CIN
15.576 | 0.035 | tINS | RF | 2 | R39C21[0][A] | u_top/u_alloc/n81_s0/COUT
16.692 | 1.115 | tNET | FF | 1 | R43C21[2][A] | u_top/u_alloc/v_gate_3_s3/I0
17.209 | 0.517 | tINS | FF | 3 | R43C21[2][A] | u_top/u_alloc/v_gate_3_s3/F
17.879 | 0.671 | tNET | FF | 1 | R45C20[1][B] | u_top/u_alloc/pick_2_s146/I2
18.396 | 0.517 | tINS | FF | 3 | R45C20[1][B] | u_top/u_alloc/pick_2_s146/F
18.896 | 0.500 | tNET | FF | 1 | R47C18[0][A] | u_top/u_alloc/pick_0_s9/I2
19.451 | 0.555 | tINS | FF | 5 | R47C18[0][A] | u_top/u_alloc/pick_0_s9/F
20.195 | 0.744 | tNET | FF | 1 | R44C19[1][A] | u_top/u_alloc/pick_0_s3/I1
20.750 | 0.555 | tINS | FF | 8 | R44C19[1][A] | u_top/u_alloc/pick_0_s3/F
21.579 | 0.828 | tNET | FF | 1 | R42C17[3][A] | u_top/u_alloc/pick_2_s64/I0
21.950 | 0.371 | tINS | FF | 3 | R42C17[3][A] | u_top/u_alloc/pick_2_s64/F
23.469 | 1.519 | tNET | FF | 1 | R47C14[3][B] | u_top/u_alloc/pick_2_s52/I1
23.840 | 0.371 | tINS | FF | 1 | R47C14[3][B] | u_top/u_alloc/pick_2_s52/F
23.844 | 0.004 | tNET | FF | 1 | R47C14[3][A] | u_top/u_alloc/pick_2_s21/I3
24.361 | 0.517 | tINS | FF | 2 | R47C14[3][A] | u_top/u_alloc/pick_2_s21/F
25.051 | 0.690 | tNET | FF | 1 | R45C18[0][B] | u_top/u_alloc/pick_2_s6/I3
25.422 | 0.371 | tINS | FF | 4 | R45C18[0][B] | u_top/u_alloc/pick_2_s6/F
25.435 | 0.013 | tNET | FF | 1 | R45C18[2][B] | u_top/u_alloc/pick_2_s1/I1
25.990 | 0.555 | tINS | FF | 4 | R45C18[2][B] | u_top/u_alloc/pick_2_s1/F
27.213 | 1.222 | tNET | FF | 1 | R47C15[3][B] | u_top/u_alloc/pick_0_s2/I1
27.768 | 0.555 | tINS | FF | 9 | R47C15[3][B] | u_top/u_alloc/pick_0_s2/F
28.461 | 0.693 | tNET | FF | 1 | R42C16[3][B] | u_top/u_alloc/pick_0_s49/I3
28.978 | 0.517 | tINS | FF | 26 | R42C16[3][B] | u_top/u_alloc/pick_0_s49/F
30.318 | 1.340 | tNET | FF | 18 | DSP_R37[2][A] | u_top/u_alloc/n453_s1/B[0]
33.958 | 3.640 | tINS | FF | 8 | DSP_R37[2][A] | u_top/u_alloc/n453_s1/DOUT[6]
35.114 | 1.156 | tNET | FF | 1 | R40C17[2][B] | u_top/u_alloc/n3434_s1/I0
35.684 | 0.570 | tINS | FR | 7 | R40C17[2][B] | u_top/u_alloc/n3434_s1/F
36.048 | 0.365 | tNET | RR | 1 | R40C18[2][B] | u_top/u_alloc/v_note_33_s0/CE

Data Required Path:

AT | DELAY | TYPE | RF | FANOUT | LOC | NODE
37.037 | 37.037 | | | | | active clock edge time
37.037 | 0.000 | | | | | clk_27m
37.037 | 0.000 | tCL | RR | 1 | IOT27[A] | clk_27m_ibuf/I
39.125 | 2.088 | tINS | RR | 3747 | IOT27[A] | clk_27m_ibuf/O
41.396 | 2.271 | tNET | RR | 1 | R40C18[2][B] | u_top/u_alloc/v_note_33_s0/CLK
41.361 | -0.035 | tSu | | 1 | R40C18[2][B] | u_top/u_alloc/v_note_33_s0

Path Statistics:

Clock Skew | 0.000
Setup Relationship | 37.037
Logic Level | 21
Arrival Clock Path Delay | cell: 2.088, 47.897%; route: 2.271, 52.103%
Arrival Data Path Delay | cell: 12.306, 38.833%; route: 19.151, 60.434%; tC2Q: 0.232, 0.732%
Required Clock Path Delay | cell: 2.088, 47.897%; route: 2.271, 52.103%

### Path11

Path Summary:

Slack | 5.313
Data Arrival Time | 36.048
Data Required Time | 41.361
From | u_top/u_manual/rd_ptr_0_s0
To | u_top/u_alloc/v_note_34_s0
Launch Clk | clk_27m:[R]
Latch Clk | clk_27m:[R]

Data Arrival Path:

AT | DELAY | TYPE | RF | FANOUT | LOC | NODE
0.000 | 0.000 | | | | | active clock edge time
0.000 | 0.000 | | | | | clk_27m
0.000 | 0.000 | tCL | RR | 1 | IOT27[A] | clk_27m_ibuf/I
2.088 | 2.088 | tINS | RR | 3747 | IOT27[A] | clk_27m_ibuf/O
4.359 | 2.271 | tNET | RR | 1 | R16C49[0][A] | u_top/u_manual/rd_ptr_0_s0/CLK
4.591 | 0.232 | tC2Q | RF | 7 | R16C49[0][A] | u_top/u_manual/rd_ptr_0_s0/Q
6.030 | 1.439 | tNET | FF | 2 | R13C47[0][A] | u_top/u_manual/n4_s0/I1
6.600 | 0.570 | tINS | FR | 1 | R13C47[0][A] | u_top/u_manual/n4_s0/COUT
6.600 | 0.000 | tNET | RR | 2 | R13C47[0][B] | u_top/u_manual/n5_s0/CIN
6.635 | 0.035 | tINS | RF | 1 | R13C47[0][B] | u_top/u_manual/n5_s0/COUT
6.635 | 0.000 | tNET | FF | 2 | R13C47[1][A] | u_top/u_manual/n6_s0/CIN
6.670 | 0.035 | tINS | FF | 1 | R13C47[1][A] | u_top/u_manual/n6_s0/COUT
6.670 | 0.000 | tNET | FF | 2 | R13C47[1][B] | u_top/u_manual/n7_s0/CIN
6.706 | 0.035 | tINS | FF | 1 | R13C47[1][B] | u_top/u_manual/n7_s0/COUT
6.706 | 0.000 | tNET | FF | 2 | R13C47[2][A] | u_top/u_manual/n8_s0/CIN
6.741 | 0.035 | tINS | FF | 17 | R13C47[2][A] | u_top/u_manual/n8_s0/COUT
7.811 | 1.070 | tNET | FF | 1 | R14C48[3][B] | u_top/ev_word_13_s2/I2
8.366 | 0.555 | tINS | FF | 1 | R14C48[3][B] | u_top/ev_word_13_s2/F
9.277 | 0.911 | tNET | FF | 1 | R12C38[3][A] | u_top/ev_word_13_s1/I1
9.648 | 0.371 | tINS | FF | 3 | R12C38[3][A] | u_top/ev_word_13_s1/F
10.070 | 0.422 | tNET | FF | 1 | R9C38[3][A] | u_top/ev_word_13_s0/I0
10.523 | 0.453 | tINS | FF | 55 | R9C38[3][A] | u_top/ev_word_13_s0/F
14.971 | 4.448 | tNET | FF | 2 | R39C20[2][B] | u_top/u_alloc/n80_s0/I1
15.541 | 0.570 | tINS | FR | 1 | R39C20[2][B] | u_top/u_alloc/n80_s0/COUT
15.541 | 0.000 | tNET | RR | 2 | R39C21[0][A] | u_top/u_alloc/n81_s0/CIN
15.576 | 0.035 | tINS | RF | 2 | R39C21[0][A] | u_top/u_alloc/n81_s0/COUT
16.692 | 1.115 | tNET | FF | 1 | R43C21[2][A] | u_top/u_alloc/v_gate_3_s3/I0
17.209 | 0.517 | tINS | FF | 3 | R43C21[2][A] | u_top/u_alloc/v_gate_3_s3/F
17.879 | 0.671 | tNET | FF | 1 | R45C20[1][B] | u_top/u_alloc/pick_2_s146/I2
18.396 | 0.517 | tINS | FF | 3 | R45C20[1][B] | u_top/u_alloc/pick_2_s146/F
18.896 | 0.500 | tNET | FF | 1 | R47C18[0][A] | u_top/u_alloc/pick_0_s9/I2
19.451 | 0.555 | tINS | FF | 5 | R47C18[0][A] | u_top/u_alloc/pick_0_s9/F
20.195 | 0.744 | tNET | FF | 1 | R44C19[1][A] | u_top/u_alloc/pick_0_s3/I1
20.750 | 0.555 | tINS | FF | 8 | R44C19[1][A] | u_top/u_alloc/pick_0_s3/F
21.579 | 0.828 | tNET | FF | 1 | R42C17[3][A] | u_top/u_alloc/pick_2_s64/I0
21.950 | 0.371 | tINS | FF | 3 | R42C17[3][A] | u_top/u_alloc/pick_2_s64/F
23.469 | 1.519 | tNET | FF | 1 | R47C14[3][B] | u_top/u_alloc/pick_2_s52/I1
23.840 | 0.371 | tINS | FF | 1 | R47C14[3][B] | u_top/u_alloc/pick_2_s52/F
23.844 | 0.004 | tNET | FF | 1 | R47C14[3][A] | u_top/u_alloc/pick_2_s21/I3
24.361 | 0.517 | tINS | FF | 2 | R47C14[3][A] | u_top/u_alloc/pick_2_s21/F
25.051 | 0.690 | tNET | FF | 1 | R45C18[0][B] | u_top/u_alloc/pick_2_s6/I3
25.422 | 0.371 | tINS | FF | 4 | R45C18[0][B] | u_top/u_alloc/pick_2_s6/F
25.435 | 0.013 | tNET | FF | 1 | R45C18[2][B] | u_top/u_alloc/pick_2_s1/I1
25.990 | 0.555 | tINS | FF | 4 | R45C18[2][B] | u_top/u_alloc/pick_2_s1/F
27.213 | 1.222 | tNET | FF | 1 | R47C15[3][B] | u_top/u_alloc/pick_0_s2/I1
27.768 | 0.555 | tINS | FF | 9 | R47C15[3][B] | u_top/u_alloc/pick_0_s2/F
28.461 | 0.693 | tNET | FF | 1 | R42C16[3][B] | u_top/u_alloc/pick_0_s49/I3
28.978 | 0.517 | tINS | FF | 26 | R42C16[3][B] | u_top/u_alloc/pick_0_s49/F
30.318 | 1.340 | tNET | FF | 18 | DSP_R37[2][A] | u_top/u_alloc/n453_s1/B[0]
33.958 | 3.640 | tINS | FF | 8 | DSP_R37[2][A] | u_top/u_alloc/n453_s1/DOUT[6]
35.114 | 1.156 | tNET | FF | 1 | R40C17[2][B] | u_top/u_alloc/n3434_s1/I0
35.684 | 0.570 | tINS | FR | 7 | R40C17[2][B] | u_top/u_alloc/n3434_s1/F
36.048 | 0.365 | tNET | RR | 1 | R40C18[0][B] | u_top/u_alloc/v_note_34_s0/CE

Data Required Path:

AT | DELAY | TYPE | RF | FANOUT | LOC | NODE
37.037 | 37.037 | | | | | active clock edge time
37.037 | 0.000 | | | | | clk_27m
37.037 | 0.000 | tCL | RR | 1 | IOT27[A] | clk_27m_ibuf/I
39.125 | 2.088 | tINS | RR | 3747 | IOT27[A] | clk_27m_ibuf/O
41.396 | 2.271 | tNET | RR | 1 | R40C18[0][B] | u_top/u_alloc/v_note_34_s0/CLK
41.361 | -0.035 | tSu | | 1 | R40C18[0][B] | u_top/u_alloc/v_note_34_s0

Path Statistics:

Clock Skew | 0.000
Setup Relationship | 37.037
Logic Level | 21
Arrival Clock Path Delay | cell: 2.088, 47.897%; route: 2.271, 52.103%
Arrival Data Path Delay | cell: 12.306, 38.833%; route: 19.151, 60.434%; tC2Q: 0.232, 0.732%
Required Clock Path Delay | cell: 2.088, 47.897%; route: 2.271, 52.103%

### Path12

Path Summary:

Slack | 5.376
Data Arrival Time | 35.985
Data Required Time | 41.361
From | u_top/u_manual/rd_ptr_0_s0
To | u_top/u_alloc/v_note_4_s0
Launch Clk | clk_27m:[R]
Latch Clk | clk_27m:[R]

Data Arrival Path:

AT | DELAY | TYPE | RF | FANOUT | LOC | NODE
0.000 | 0.000 | | | | | active clock edge time
0.000 | 0.000 | | | | | clk_27m
0.000 | 0.000 | tCL | RR | 1 | IOT27[A] | clk_27m_ibuf/I
2.088 | 2.088 | tINS | RR | 3747 | IOT27[A] | clk_27m_ibuf/O
4.359 | 2.271 | tNET | RR | 1 | R16C49[0][A] | u_top/u_manual/rd_ptr_0_s0/CLK
4.591 | 0.232 | tC2Q | RF | 7 | R16C49[0][A] | u_top/u_manual/rd_ptr_0_s0/Q
6.030 | 1.439 | tNET | FF | 2 | R13C47[0][A] | u_top/u_manual/n4_s0/I1
6.600 | 0.570 | tINS | FR | 1 | R13C47[0][A] | u_top/u_manual/n4_s0/COUT
6.600 | 0.000 | tNET | RR | 2 | R13C47[0][B] | u_top/u_manual/n5_s0/CIN
6.635 | 0.035 | tINS | RF | 1 | R13C47[0][B] | u_top/u_manual/n5_s0/COUT
6.635 | 0.000 | tNET | FF | 2 | R13C47[1][A] | u_top/u_manual/n6_s0/CIN
6.670 | 0.035 | tINS | FF | 1 | R13C47[1][A] | u_top/u_manual/n6_s0/COUT
6.670 | 0.000 | tNET | FF | 2 | R13C47[1][B] | u_top/u_manual/n7_s0/CIN
6.706 | 0.035 | tINS | FF | 1 | R13C47[1][B] | u_top/u_manual/n7_s0/COUT
6.706 | 0.000 | tNET | FF | 2 | R13C47[2][A] | u_top/u_manual/n8_s0/CIN
6.741 | 0.035 | tINS | FF | 17 | R13C47[2][A] | u_top/u_manual/n8_s0/COUT
7.811 | 1.070 | tNET | FF | 1 | R14C48[3][B] | u_top/ev_word_13_s2/I2
8.366 | 0.555 | tINS | FF | 1 | R14C48[3][B] | u_top/ev_word_13_s2/F
9.277 | 0.911 | tNET | FF | 1 | R12C38[3][A] | u_top/ev_word_13_s1/I1
9.648 | 0.371 | tINS | FF | 3 | R12C38[3][A] | u_top/ev_word_13_s1/F
10.070 | 0.422 | tNET | FF | 1 | R9C38[3][A] | u_top/ev_word_13_s0/I0
10.523 | 0.453 | tINS | FF | 55 | R9C38[3][A] | u_top/ev_word_13_s0/F
14.971 | 4.448 | tNET | FF | 2 | R39C20[2][B] | u_top/u_alloc/n80_s0/I1
15.541 | 0.570 | tINS | FR | 1 | R39C20[2][B] | u_top/u_alloc/n80_s0/COUT
15.541 | 0.000 | tNET | RR | 2 | R39C21[0][A] | u_top/u_alloc/n81_s0/CIN
15.576 | 0.035 | tINS | RF | 2 | R39C21[0][A] | u_top/u_alloc/n81_s0/COUT
16.692 | 1.115 | tNET | FF | 1 | R43C21[2][A] | u_top/u_alloc/v_gate_3_s3/I0
17.209 | 0.517 | tINS | FF | 3 | R43C21[2][A] | u_top/u_alloc/v_gate_3_s3/F
17.879 | 0.671 | tNET | FF | 1 | R45C20[1][B] | u_top/u_alloc/pick_2_s146/I2
18.396 | 0.517 | tINS | FF | 3 | R45C20[1][B] | u_top/u_alloc/pick_2_s146/F
18.896 | 0.500 | tNET | FF | 1 | R47C18[0][A] | u_top/u_alloc/pick_0_s9/I2
19.451 | 0.555 | tINS | FF | 5 | R47C18[0][A] | u_top/u_alloc/pick_0_s9/F
20.195 | 0.744 | tNET | FF | 1 | R44C19[1][A] | u_top/u_alloc/pick_0_s3/I1
20.750 | 0.555 | tINS | FF | 8 | R44C19[1][A] | u_top/u_alloc/pick_0_s3/F
21.579 | 0.828 | tNET | FF | 1 | R42C17[3][A] | u_top/u_alloc/pick_2_s64/I0
21.950 | 0.371 | tINS | FF | 3 | R42C17[3][A] | u_top/u_alloc/pick_2_s64/F
23.469 | 1.519 | tNET | FF | 1 | R47C14[3][B] | u_top/u_alloc/pick_2_s52/I1
23.840 | 0.371 | tINS | FF | 1 | R47C14[3][B] | u_top/u_alloc/pick_2_s52/F
23.844 | 0.004 | tNET | FF | 1 | R47C14[3][A] | u_top/u_alloc/pick_2_s21/I3
24.361 | 0.517 | tINS | FF | 2 | R47C14[3][A] | u_top/u_alloc/pick_2_s21/F
25.051 | 0.690 | tNET | FF | 1 | R45C18[0][B] | u_top/u_alloc/pick_2_s6/I3
25.422 | 0.371 | tINS | FF | 4 | R45C18[0][B] | u_top/u_alloc/pick_2_s6/F
25.435 | 0.013 | tNET | FF | 1 | R45C18[2][B] | u_top/u_alloc/pick_2_s1/I1
25.990 | 0.555 | tINS | FF | 4 | R45C18[2][B] | u_top/u_alloc/pick_2_s1/F
27.213 | 1.222 | tNET | FF | 1 | R47C15[3][B] | u_top/u_alloc/pick_0_s2/I1
27.768 | 0.555 | tINS | FF | 9 | R47C15[3][B] | u_top/u_alloc/pick_0_s2/F
28.461 | 0.693 | tNET | FF | 1 | R42C16[3][B] | u_top/u_alloc/pick_0_s49/I3
28.978 | 0.517 | tINS | FF | 26 | R42C16[3][B] | u_top/u_alloc/pick_0_s49/F
30.318 | 1.340 | tNET | FF | 18 | DSP_R37[2][A] | u_top/u_alloc/n453_s1/B[0]
33.958 | 3.640 | tINS | FF | 8 | DSP_R37[2][A] | u_top/u_alloc/n453_s1/DOUT[6]
35.264 | 1.306 | tNET | FF | 1 | R38C16[3][A] | u_top/u_alloc/n3490_s2/I0
35.834 | 0.570 | tINS | FR | 7 | R38C16[3][A] | u_top/u_alloc/n3490_s2/F
35.985 | 0.151 | tNET | RR | 1 | R38C16[1][A] | u_top/u_alloc/v_note_4_s0/CE

Data Required Path:

AT | DELAY | TYPE | RF | FANOUT | LOC | NODE
37.037 | 37.037 | | | | | active clock edge time
37.037 | 0.000 | | | | | clk_27m
37.037 | 0.000 | tCL | RR | 1 | IOT27[A] | clk_27m_ibuf/I
39.125 | 2.088 | tINS | RR | 3747 | IOT27[A] | clk_27m_ibuf/O
41.396 | 2.271 | tNET | RR | 1 | R38C16[1][A] | u_top/u_alloc/v_note_4_s0/CLK
41.361 | -0.035 | tSu | | 1 | R38C16[1][A] | u_top/u_alloc/v_note_4_s0

Path Statistics:

Clock Skew | 0.000
Setup Relationship | 37.037
Logic Level | 21
Arrival Clock Path Delay | cell: 2.088, 47.897%; route: 2.271, 52.103%
Arrival Data Path Delay | cell: 12.306, 38.912%; route: 19.088, 60.355%; tC2Q: 0.232, 0.734%
Required Clock Path Delay | cell: 2.088, 47.897%; route: 2.271, 52.103%

### Path13

Path Summary:

Slack | 5.376
Data Arrival Time | 35.985
Data Required Time | 41.361
From | u_top/u_manual/rd_ptr_0_s0
To | u_top/u_alloc/v_note_5_s0
Launch Clk | clk_27m:[R]
Latch Clk | clk_27m:[R]

Data Arrival Path:

AT | DELAY | TYPE | RF | FANOUT | LOC | NODE
0.000 | 0.000 | | | | | active clock edge time
0.000 | 0.000 | | | | | clk_27m
0.000 | 0.000 | tCL | RR | 1 | IOT27[A] | clk_27m_ibuf/I
2.088 | 2.088 | tINS | RR | 3747 | IOT27[A] | clk_27m_ibuf/O
4.359 | 2.271 | tNET | RR | 1 | R16C49[0][A] | u_top/u_manual/rd_ptr_0_s0/CLK
4.591 | 0.232 | tC2Q | RF | 7 | R16C49[0][A] | u_top/u_manual/rd_ptr_0_s0/Q
6.030 | 1.439 | tNET | FF | 2 | R13C47[0][A] | u_top/u_manual/n4_s0/I1
6.600 | 0.570 | tINS | FR | 1 | R13C47[0][A] | u_top/u_manual/n4_s0/COUT
6.600 | 0.000 | tNET | RR | 2 | R13C47[0][B] | u_top/u_manual/n5_s0/CIN
6.635 | 0.035 | tINS | RF | 1 | R13C47[0][B] | u_top/u_manual/n5_s0/COUT
6.635 | 0.000 | tNET | FF | 2 | R13C47[1][A] | u_top/u_manual/n6_s0/CIN
6.670 | 0.035 | tINS | FF | 1 | R13C47[1][A] | u_top/u_manual/n6_s0/COUT
6.670 | 0.000 | tNET | FF | 2 | R13C47[1][B] | u_top/u_manual/n7_s0/CIN
6.706 | 0.035 | tINS | FF | 1 | R13C47[1][B] | u_top/u_manual/n7_s0/COUT
6.706 | 0.000 | tNET | FF | 2 | R13C47[2][A] | u_top/u_manual/n8_s0/CIN
6.741 | 0.035 | tINS | FF | 17 | R13C47[2][A] | u_top/u_manual/n8_s0/COUT
7.811 | 1.070 | tNET | FF | 1 | R14C48[3][B] | u_top/ev_word_13_s2/I2
8.366 | 0.555 | tINS | FF | 1 | R14C48[3][B] | u_top/ev_word_13_s2/F
9.277 | 0.911 | tNET | FF | 1 | R12C38[3][A] | u_top/ev_word_13_s1/I1
9.648 | 0.371 | tINS | FF | 3 | R12C38[3][A] | u_top/ev_word_13_s1/F
10.070 | 0.422 | tNET | FF | 1 | R9C38[3][A] | u_top/ev_word_13_s0/I0
10.523 | 0.453 | tINS | FF | 55 | R9C38[3][A] | u_top/ev_word_13_s0/F
14.971 | 4.448 | tNET | FF | 2 | R39C20[2][B] | u_top/u_alloc/n80_s0/I1
15.541 | 0.570 | tINS | FR | 1 | R39C20[2][B] | u_top/u_alloc/n80_s0/COUT
15.541 | 0.000 | tNET | RR | 2 | R39C21[0][A] | u_top/u_alloc/n81_s0/CIN
15.576 | 0.035 | tINS | RF | 2 | R39C21[0][A] | u_top/u_alloc/n81_s0/COUT
16.692 | 1.115 | tNET | FF | 1 | R43C21[2][A] | u_top/u_alloc/v_gate_3_s3/I0
17.209 | 0.517 | tINS | FF | 3 | R43C21[2][A] | u_top/u_alloc/v_gate_3_s3/F
17.879 | 0.671 | tNET | FF | 1 | R45C20[1][B] | u_top/u_alloc/pick_2_s146/I2
18.396 | 0.517 | tINS | FF | 3 | R45C20[1][B] | u_top/u_alloc/pick_2_s146/F
18.896 | 0.500 | tNET | FF | 1 | R47C18[0][A] | u_top/u_alloc/pick_0_s9/I2
19.451 | 0.555 | tINS | FF | 5 | R47C18[0][A] | u_top/u_alloc/pick_0_s9/F
20.195 | 0.744 | tNET | FF | 1 | R44C19[1][A] | u_top/u_alloc/pick_0_s3/I1
20.750 | 0.555 | tINS | FF | 8 | R44C19[1][A] | u_top/u_alloc/pick_0_s3/F
21.579 | 0.828 | tNET | FF | 1 | R42C17[3][A] | u_top/u_alloc/pick_2_s64/I0
21.950 | 0.371 | tINS | FF | 3 | R42C17[3][A] | u_top/u_alloc/pick_2_s64/F
23.469 | 1.519 | tNET | FF | 1 | R47C14[3][B] | u_top/u_alloc/pick_2_s52/I1
23.840 | 0.371 | tINS | FF | 1 | R47C14[3][B] | u_top/u_alloc/pick_2_s52/F
23.844 | 0.004 | tNET | FF | 1 | R47C14[3][A] | u_top/u_alloc/pick_2_s21/I3
24.361 | 0.517 | tINS | FF | 2 | R47C14[3][A] | u_top/u_alloc/pick_2_s21/F
25.051 | 0.690 | tNET | FF | 1 | R45C18[0][B] | u_top/u_alloc/pick_2_s6/I3
25.422 | 0.371 | tINS | FF | 4 | R45C18[0][B] | u_top/u_alloc/pick_2_s6/F
25.435 | 0.013 | tNET | FF | 1 | R45C18[2][B] | u_top/u_alloc/pick_2_s1/I1
25.990 | 0.555 | tINS | FF | 4 | R45C18[2][B] | u_top/u_alloc/pick_2_s1/F
27.213 | 1.222 | tNET | FF | 1 | R47C15[3][B] | u_top/u_alloc/pick_0_s2/I1
27.768 | 0.555 | tINS | FF | 9 | R47C15[3][B] | u_top/u_alloc/pick_0_s2/F
28.461 | 0.693 | tNET | FF | 1 | R42C16[3][B] | u_top/u_alloc/pick_0_s49/I3
28.978 | 0.517 | tINS | FF | 26 | R42C16[3][B] | u_top/u_alloc/pick_0_s49/F
30.318 | 1.340 | tNET | FF | 18 | DSP_R37[2][A] | u_top/u_alloc/n453_s1/B[0]
33.958 | 3.640 | tINS | FF | 8 | DSP_R37[2][A] | u_top/u_alloc/n453_s1/DOUT[6]
35.264 | 1.306 | tNET | FF | 1 | R38C16[3][A] | u_top/u_alloc/n3490_s2/I0
35.834 | 0.570 | tINS | FR | 7 | R38C16[3][A] | u_top/u_alloc/n3490_s2/F
35.985 | 0.151 | tNET | RR | 1 | R38C16[0][B] | u_top/u_alloc/v_note_5_s0/CE

Data Required Path:

AT | DELAY | TYPE | RF | FANOUT | LOC | NODE
37.037 | 37.037 | | | | | active clock edge time
37.037 | 0.000 | | | | | clk_27m
37.037 | 0.000 | tCL | RR | 1 | IOT27[A] | clk_27m_ibuf/I
39.125 | 2.088 | tINS | RR | 3747 | IOT27[A] | clk_27m_ibuf/O
41.396 | 2.271 | tNET | RR | 1 | R38C16[0][B] | u_top/u_alloc/v_note_5_s0/CLK
41.361 | -0.035 | tSu | | 1 | R38C16[0][B] | u_top/u_alloc/v_note_5_s0

Path Statistics:

Clock Skew | 0.000
Setup Relationship | 37.037
Logic Level | 21
Arrival Clock Path Delay | cell: 2.088, 47.897%; route: 2.271, 52.103%
Arrival Data Path Delay | cell: 12.306, 38.912%; route: 19.088, 60.355%; tC2Q: 0.232, 0.734%
Required Clock Path Delay | cell: 2.088, 47.897%; route: 2.271, 52.103%

### Path14

Path Summary:

Slack | 5.532
Data Arrival Time | 35.829
Data Required Time | 41.361
From | u_top/u_manual/rd_ptr_0_s0
To | u_top/u_alloc/v_note_29_s0
Launch Clk | clk_27m:[R]
Latch Clk | clk_27m:[R]

Data Arrival Path:

AT | DELAY | TYPE | RF | FANOUT | LOC | NODE
0.000 | 0.000 | | | | | active clock edge time
0.000 | 0.000 | | | | | clk_27m
0.000 | 0.000 | tCL | RR | 1 | IOT27[A] | clk_27m_ibuf/I
2.088 | 2.088 | tINS | RR | 3747 | IOT27[A] | clk_27m_ibuf/O
4.359 | 2.271 | tNET | RR | 1 | R16C49[0][A] | u_top/u_manual/rd_ptr_0_s0/CLK
4.591 | 0.232 | tC2Q | RF | 7 | R16C49[0][A] | u_top/u_manual/rd_ptr_0_s0/Q
6.030 | 1.439 | tNET | FF | 2 | R13C47[0][A] | u_top/u_manual/n4_s0/I1
6.600 | 0.570 | tINS | FR | 1 | R13C47[0][A] | u_top/u_manual/n4_s0/COUT
6.600 | 0.000 | tNET | RR | 2 | R13C47[0][B] | u_top/u_manual/n5_s0/CIN
6.635 | 0.035 | tINS | RF | 1 | R13C47[0][B] | u_top/u_manual/n5_s0/COUT
6.635 | 0.000 | tNET | FF | 2 | R13C47[1][A] | u_top/u_manual/n6_s0/CIN
6.670 | 0.035 | tINS | FF | 1 | R13C47[1][A] | u_top/u_manual/n6_s0/COUT
6.670 | 0.000 | tNET | FF | 2 | R13C47[1][B] | u_top/u_manual/n7_s0/CIN
6.706 | 0.035 | tINS | FF | 1 | R13C47[1][B] | u_top/u_manual/n7_s0/COUT
6.706 | 0.000 | tNET | FF | 2 | R13C47[2][A] | u_top/u_manual/n8_s0/CIN
6.741 | 0.035 | tINS | FF | 17 | R13C47[2][A] | u_top/u_manual/n8_s0/COUT
7.811 | 1.070 | tNET | FF | 1 | R14C48[3][B] | u_top/ev_word_13_s2/I2
8.366 | 0.555 | tINS | FF | 1 | R14C48[3][B] | u_top/ev_word_13_s2/F
9.277 | 0.911 | tNET | FF | 1 | R12C38[3][A] | u_top/ev_word_13_s1/I1
9.648 | 0.371 | tINS | FF | 3 | R12C38[3][A] | u_top/ev_word_13_s1/F
10.070 | 0.422 | tNET | FF | 1 | R9C38[3][A] | u_top/ev_word_13_s0/I0
10.523 | 0.453 | tINS | FF | 55 | R9C38[3][A] | u_top/ev_word_13_s0/F
14.971 | 4.448 | tNET | FF | 2 | R39C20[2][B] | u_top/u_alloc/n80_s0/I1
15.541 | 0.570 | tINS | FR | 1 | R39C20[2][B] | u_top/u_alloc/n80_s0/COUT
15.541 | 0.000 | tNET | RR | 2 | R39C21[0][A] | u_top/u_alloc/n81_s0/CIN
15.576 | 0.035 | tINS | RF | 2 | R39C21[0][A] | u_top/u_alloc/n81_s0/COUT
16.692 | 1.115 | tNET | FF | 1 | R43C21[2][A] | u_top/u_alloc/v_gate_3_s3/I0
17.209 | 0.517 | tINS | FF | 3 | R43C21[2][A] | u_top/u_alloc/v_gate_3_s3/F
17.879 | 0.671 | tNET | FF | 1 | R45C20[1][B] | u_top/u_alloc/pick_2_s146/I2
18.396 | 0.517 | tINS | FF | 3 | R45C20[1][B] | u_top/u_alloc/pick_2_s146/F
18.896 | 0.500 | tNET | FF | 1 | R47C18[0][A] | u_top/u_alloc/pick_0_s9/I2
19.451 | 0.555 | tINS | FF | 5 | R47C18[0][A] | u_top/u_alloc/pick_0_s9/F
20.195 | 0.744 | tNET | FF | 1 | R44C19[1][A] | u_top/u_alloc/pick_0_s3/I1
20.750 | 0.555 | tINS | FF | 8 | R44C19[1][A] | u_top/u_alloc/pick_0_s3/F
21.579 | 0.828 | tNET | FF | 1 | R42C17[3][A] | u_top/u_alloc/pick_2_s64/I0
21.950 | 0.371 | tINS | FF | 3 | R42C17[3][A] | u_top/u_alloc/pick_2_s64/F
23.469 | 1.519 | tNET | FF | 1 | R47C14[3][B] | u_top/u_alloc/pick_2_s52/I1
23.840 | 0.371 | tINS | FF | 1 | R47C14[3][B] | u_top/u_alloc/pick_2_s52/F
23.844 | 0.004 | tNET | FF | 1 | R47C14[3][A] | u_top/u_alloc/pick_2_s21/I3
24.361 | 0.517 | tINS | FF | 2 | R47C14[3][A] | u_top/u_alloc/pick_2_s21/F
25.051 | 0.690 | tNET | FF | 1 | R45C18[0][B] | u_top/u_alloc/pick_2_s6/I3
25.422 | 0.371 | tINS | FF | 4 | R45C18[0][B] | u_top/u_alloc/pick_2_s6/F
25.435 | 0.013 | tNET | FF | 1 | R45C18[2][B] | u_top/u_alloc/pick_2_s1/I1
25.990 | 0.555 | tINS | FF | 4 | R45C18[2][B] | u_top/u_alloc/pick_2_s1/F
27.213 | 1.222 | tNET | FF | 1 | R47C15[3][B] | u_top/u_alloc/pick_0_s2/I1
27.768 | 0.555 | tINS | FF | 9 | R47C15[3][B] | u_top/u_alloc/pick_0_s2/F
28.461 | 0.693 | tNET | FF | 1 | R42C16[3][B] | u_top/u_alloc/pick_0_s49/I3
28.978 | 0.517 | tINS | FF | 26 | R42C16[3][B] | u_top/u_alloc/pick_0_s49/F
30.318 | 1.340 | tNET | FF | 18 | DSP_R37[2][A] | u_top/u_alloc/n453_s1/B[0]
33.958 | 3.640 | tINS | FF | 8 | DSP_R37[2][A] | u_top/u_alloc/n453_s1/DOUT[6]
35.114 | 1.156 | tNET | FF | 1 | R40C17[2][B] | u_top/u_alloc/n3434_s1/I0
35.684 | 0.570 | tINS | FR | 7 | R40C17[2][B] | u_top/u_alloc/n3434_s1/F
35.829 | 0.146 | tNET | RR | 1 | R40C17[0][A] | u_top/u_alloc/v_note_29_s0/CE

Data Required Path:

AT | DELAY | TYPE | RF | FANOUT | LOC | NODE
37.037 | 37.037 | | | | | active clock edge time
37.037 | 0.000 | | | | | clk_27m
37.037 | 0.000 | tCL | RR | 1 | IOT27[A] | clk_27m_ibuf/I
39.125 | 2.088 | tINS | RR | 3747 | IOT27[A] | clk_27m_ibuf/O
41.396 | 2.271 | tNET | RR | 1 | R40C17[0][A] | u_top/u_alloc/v_note_29_s0/CLK
41.361 | -0.035 | tSu | | 1 | R40C17[0][A] | u_top/u_alloc/v_note_29_s0

Path Statistics:

Clock Skew | 0.000
Setup Relationship | 37.037
Logic Level | 21
Arrival Clock Path Delay | cell: 2.088, 47.897%; route: 2.271, 52.103%
Arrival Data Path Delay | cell: 12.306, 39.104%; route: 18.932, 60.159%; tC2Q: 0.232, 0.737%
Required Clock Path Delay | cell: 2.088, 47.897%; route: 2.271, 52.103%

### Path15

Path Summary:

Slack | 5.613
Data Arrival Time | 35.748
Data Required Time | 41.361
From | u_top/u_manual/rd_ptr_0_s0
To | u_top/u_alloc/v_note_12_s0
Launch Clk | clk_27m:[R]
Latch Clk | clk_27m:[R]

Data Arrival Path:

AT | DELAY | TYPE | RF | FANOUT | LOC | NODE
0.000 | 0.000 | | | | | active clock edge time
0.000 | 0.000 | | | | | clk_27m
0.000 | 0.000 | tCL | RR | 1 | IOT27[A] | clk_27m_ibuf/I
2.088 | 2.088 | tINS | RR | 3747 | IOT27[A] | clk_27m_ibuf/O
4.359 | 2.271 | tNET | RR | 1 | R16C49[0][A] | u_top/u_manual/rd_ptr_0_s0/CLK
4.591 | 0.232 | tC2Q | RF | 7 | R16C49[0][A] | u_top/u_manual/rd_ptr_0_s0/Q
6.030 | 1.439 | tNET | FF | 2 | R13C47[0][A] | u_top/u_manual/n4_s0/I1
6.600 | 0.570 | tINS | FR | 1 | R13C47[0][A] | u_top/u_manual/n4_s0/COUT
6.600 | 0.000 | tNET | RR | 2 | R13C47[0][B] | u_top/u_manual/n5_s0/CIN
6.635 | 0.035 | tINS | RF | 1 | R13C47[0][B] | u_top/u_manual/n5_s0/COUT
6.635 | 0.000 | tNET | FF | 2 | R13C47[1][A] | u_top/u_manual/n6_s0/CIN
6.670 | 0.035 | tINS | FF | 1 | R13C47[1][A] | u_top/u_manual/n6_s0/COUT
6.670 | 0.000 | tNET | FF | 2 | R13C47[1][B] | u_top/u_manual/n7_s0/CIN
6.706 | 0.035 | tINS | FF | 1 | R13C47[1][B] | u_top/u_manual/n7_s0/COUT
6.706 | 0.000 | tNET | FF | 2 | R13C47[2][A] | u_top/u_manual/n8_s0/CIN
6.741 | 0.035 | tINS | FF | 17 | R13C47[2][A] | u_top/u_manual/n8_s0/COUT
7.811 | 1.070 | tNET | FF | 1 | R14C48[3][B] | u_top/ev_word_13_s2/I2
8.366 | 0.555 | tINS | FF | 1 | R14C48[3][B] | u_top/ev_word_13_s2/F
9.277 | 0.911 | tNET | FF | 1 | R12C38[3][A] | u_top/ev_word_13_s1/I1
9.648 | 0.371 | tINS | FF | 3 | R12C38[3][A] | u_top/ev_word_13_s1/F
10.070 | 0.422 | tNET | FF | 1 | R9C38[3][A] | u_top/ev_word_13_s0/I0
10.523 | 0.453 | tINS | FF | 55 | R9C38[3][A] | u_top/ev_word_13_s0/F
14.971 | 4.448 | tNET | FF | 2 | R39C20[2][B] | u_top/u_alloc/n80_s0/I1
15.541 | 0.570 | tINS | FR | 1 | R39C20[2][B] | u_top/u_alloc/n80_s0/COUT
15.541 | 0.000 | tNET | RR | 2 | R39C21[0][A] | u_top/u_alloc/n81_s0/CIN
15.576 | 0.035 | tINS | RF | 2 | R39C21[0][A] | u_top/u_alloc/n81_s0/COUT
16.692 | 1.115 | tNET | FF | 1 | R43C21[2][A] | u_top/u_alloc/v_gate_3_s3/I0
17.209 | 0.517 | tINS | FF | 3 | R43C21[2][A] | u_top/u_alloc/v_gate_3_s3/F
17.879 | 0.671 | tNET | FF | 1 | R45C20[1][B] | u_top/u_alloc/pick_2_s146/I2
18.396 | 0.517 | tINS | FF | 3 | R45C20[1][B] | u_top/u_alloc/pick_2_s146/F
18.896 | 0.500 | tNET | FF | 1 | R47C18[0][A] | u_top/u_alloc/pick_0_s9/I2
19.451 | 0.555 | tINS | FF | 5 | R47C18[0][A] | u_top/u_alloc/pick_0_s9/F
20.195 | 0.744 | tNET | FF | 1 | R44C19[1][A] | u_top/u_alloc/pick_0_s3/I1
20.750 | 0.555 | tINS | FF | 8 | R44C19[1][A] | u_top/u_alloc/pick_0_s3/F
21.579 | 0.828 | tNET | FF | 1 | R42C17[3][A] | u_top/u_alloc/pick_2_s64/I0
21.950 | 0.371 | tINS | FF | 3 | R42C17[3][A] | u_top/u_alloc/pick_2_s64/F
23.469 | 1.519 | tNET | FF | 1 | R47C14[3][B] | u_top/u_alloc/pick_2_s52/I1
23.840 | 0.371 | tINS | FF | 1 | R47C14[3][B] | u_top/u_alloc/pick_2_s52/F
23.844 | 0.004 | tNET | FF | 1 | R47C14[3][A] | u_top/u_alloc/pick_2_s21/I3
24.361 | 0.517 | tINS | FF | 2 | R47C14[3][A] | u_top/u_alloc/pick_2_s21/F
25.051 | 0.690 | tNET | FF | 1 | R45C18[0][B] | u_top/u_alloc/pick_2_s6/I3
25.422 | 0.371 | tINS | FF | 4 | R45C18[0][B] | u_top/u_alloc/pick_2_s6/F
25.435 | 0.013 | tNET | FF | 1 | R45C18[2][B] | u_top/u_alloc/pick_2_s1/I1
25.990 | 0.555 | tINS | FF | 4 | R45C18[2][B] | u_top/u_alloc/pick_2_s1/F
27.213 | 1.222 | tNET | FF | 1 | R47C15[3][B] | u_top/u_alloc/pick_0_s2/I1
27.768 | 0.555 | tINS | FF | 9 | R47C15[3][B] | u_top/u_alloc/pick_0_s2/F
28.461 | 0.693 | tNET | FF | 1 | R42C16[3][B] | u_top/u_alloc/pick_0_s49/I3
28.978 | 0.517 | tINS | FF | 26 | R42C16[3][B] | u_top/u_alloc/pick_0_s49/F
30.318 | 1.340 | tNET | FF | 18 | DSP_R37[2][A] | u_top/u_alloc/n453_s1/B[0]
33.958 | 3.640 | tINS | FF | 8 | DSP_R37[2][A] | u_top/u_alloc/n453_s1/DOUT[6]
34.871 | 0.913 | tNET | FF | 1 | R36C17[3][A] | u_top/u_alloc/n3476_s2/I0
35.198 | 0.327 | tINS | FR | 7 | R36C17[3][A] | u_top/u_alloc/n3476_s2/F
35.748 | 0.550 | tNET | RR | 1 | R34C19[1][B] | u_top/u_alloc/v_note_12_s0/CE

Data Required Path:

AT | DELAY | TYPE | RF | FANOUT | LOC | NODE
37.037 | 37.037 | | | | | active clock edge time
37.037 | 0.000 | | | | | clk_27m
37.037 | 0.000 | tCL | RR | 1 | IOT27[A] | clk_27m_ibuf/I
39.125 | 2.088 | tINS | RR | 3747 | IOT27[A] | clk_27m_ibuf/O
41.396 | 2.271 | tNET | RR | 1 | R34C19[1][B] | u_top/u_alloc/v_note_12_s0/CLK
41.361 | -0.035 | tSu | | 1 | R34C19[1][B] | u_top/u_alloc/v_note_12_s0

Path Statistics:

Clock Skew | 0.000
Setup Relationship | 37.037
Logic Level | 21
Arrival Clock Path Delay | cell: 2.088, 47.897%; route: 2.271, 52.103%
Arrival Data Path Delay | cell: 12.063, 38.431%; route: 19.094, 60.830%; tC2Q: 0.232, 0.739%
Required Clock Path Delay | cell: 2.088, 47.897%; route: 2.271, 52.103%

### Path16

Path Summary:

Slack | 5.613
Data Arrival Time | 35.748
Data Required Time | 41.361
From | u_top/u_manual/rd_ptr_0_s0
To | u_top/u_alloc/v_note_13_s0
Launch Clk | clk_27m:[R]
Latch Clk | clk_27m:[R]

Data Arrival Path:

AT | DELAY | TYPE | RF | FANOUT | LOC | NODE
0.000 | 0.000 | | | | | active clock edge time
0.000 | 0.000 | | | | | clk_27m
0.000 | 0.000 | tCL | RR | 1 | IOT27[A] | clk_27m_ibuf/I
2.088 | 2.088 | tINS | RR | 3747 | IOT27[A] | clk_27m_ibuf/O
4.359 | 2.271 | tNET | RR | 1 | R16C49[0][A] | u_top/u_manual/rd_ptr_0_s0/CLK
4.591 | 0.232 | tC2Q | RF | 7 | R16C49[0][A] | u_top/u_manual/rd_ptr_0_s0/Q
6.030 | 1.439 | tNET | FF | 2 | R13C47[0][A] | u_top/u_manual/n4_s0/I1
6.600 | 0.570 | tINS | FR | 1 | R13C47[0][A] | u_top/u_manual/n4_s0/COUT
6.600 | 0.000 | tNET | RR | 2 | R13C47[0][B] | u_top/u_manual/n5_s0/CIN
6.635 | 0.035 | tINS | RF | 1 | R13C47[0][B] | u_top/u_manual/n5_s0/COUT
6.635 | 0.000 | tNET | FF | 2 | R13C47[1][A] | u_top/u_manual/n6_s0/CIN
6.670 | 0.035 | tINS | FF | 1 | R13C47[1][A] | u_top/u_manual/n6_s0/COUT
6.670 | 0.000 | tNET | FF | 2 | R13C47[1][B] | u_top/u_manual/n7_s0/CIN
6.706 | 0.035 | tINS | FF | 1 | R13C47[1][B] | u_top/u_manual/n7_s0/COUT
6.706 | 0.000 | tNET | FF | 2 | R13C47[2][A] | u_top/u_manual/n8_s0/CIN
6.741 | 0.035 | tINS | FF | 17 | R13C47[2][A] | u_top/u_manual/n8_s0/COUT
7.811 | 1.070 | tNET | FF | 1 | R14C48[3][B] | u_top/ev_word_13_s2/I2
8.366 | 0.555 | tINS | FF | 1 | R14C48[3][B] | u_top/ev_word_13_s2/F
9.277 | 0.911 | tNET | FF | 1 | R12C38[3][A] | u_top/ev_word_13_s1/I1
9.648 | 0.371 | tINS | FF | 3 | R12C38[3][A] | u_top/ev_word_13_s1/F
10.070 | 0.422 | tNET | FF | 1 | R9C38[3][A] | u_top/ev_word_13_s0/I0
10.523 | 0.453 | tINS | FF | 55 | R9C38[3][A] | u_top/ev_word_13_s0/F
14.971 | 4.448 | tNET | FF | 2 | R39C20[2][B] | u_top/u_alloc/n80_s0/I1
15.541 | 0.570 | tINS | FR | 1 | R39C20[2][B] | u_top/u_alloc/n80_s0/COUT
15.541 | 0.000 | tNET | RR | 2 | R39C21[0][A] | u_top/u_alloc/n81_s0/CIN
15.576 | 0.035 | tINS | RF | 2 | R39C21[0][A] | u_top/u_alloc/n81_s0/COUT
16.692 | 1.115 | tNET | FF | 1 | R43C21[2][A] | u_top/u_alloc/v_gate_3_s3/I0
17.209 | 0.517 | tINS | FF | 3 | R43C21[2][A] | u_top/u_alloc/v_gate_3_s3/F
17.879 | 0.671 | tNET | FF | 1 | R45C20[1][B] | u_top/u_alloc/pick_2_s146/I2
18.396 | 0.517 | tINS | FF | 3 | R45C20[1][B] | u_top/u_alloc/pick_2_s146/F
18.896 | 0.500 | tNET | FF | 1 | R47C18[0][A] | u_top/u_alloc/pick_0_s9/I2
19.451 | 0.555 | tINS | FF | 5 | R47C18[0][A] | u_top/u_alloc/pick_0_s9/F
20.195 | 0.744 | tNET | FF | 1 | R44C19[1][A] | u_top/u_alloc/pick_0_s3/I1
20.750 | 0.555 | tINS | FF | 8 | R44C19[1][A] | u_top/u_alloc/pick_0_s3/F
21.579 | 0.828 | tNET | FF | 1 | R42C17[3][A] | u_top/u_alloc/pick_2_s64/I0
21.950 | 0.371 | tINS | FF | 3 | R42C17[3][A] | u_top/u_alloc/pick_2_s64/F
23.469 | 1.519 | tNET | FF | 1 | R47C14[3][B] | u_top/u_alloc/pick_2_s52/I1
23.840 | 0.371 | tINS | FF | 1 | R47C14[3][B] | u_top/u_alloc/pick_2_s52/F
23.844 | 0.004 | tNET | FF | 1 | R47C14[3][A] | u_top/u_alloc/pick_2_s21/I3
24.361 | 0.517 | tINS | FF | 2 | R47C14[3][A] | u_top/u_alloc/pick_2_s21/F
25.051 | 0.690 | tNET | FF | 1 | R45C18[0][B] | u_top/u_alloc/pick_2_s6/I3
25.422 | 0.371 | tINS | FF | 4 | R45C18[0][B] | u_top/u_alloc/pick_2_s6/F
25.435 | 0.013 | tNET | FF | 1 | R45C18[2][B] | u_top/u_alloc/pick_2_s1/I1
25.990 | 0.555 | tINS | FF | 4 | R45C18[2][B] | u_top/u_alloc/pick_2_s1/F
27.213 | 1.222 | tNET | FF | 1 | R47C15[3][B] | u_top/u_alloc/pick_0_s2/I1
27.768 | 0.555 | tINS | FF | 9 | R47C15[3][B] | u_top/u_alloc/pick_0_s2/F
28.461 | 0.693 | tNET | FF | 1 | R42C16[3][B] | u_top/u_alloc/pick_0_s49/I3
28.978 | 0.517 | tINS | FF | 26 | R42C16[3][B] | u_top/u_alloc/pick_0_s49/F
30.318 | 1.340 | tNET | FF | 18 | DSP_R37[2][A] | u_top/u_alloc/n453_s1/B[0]
33.958 | 3.640 | tINS | FF | 8 | DSP_R37[2][A] | u_top/u_alloc/n453_s1/DOUT[6]
34.871 | 0.913 | tNET | FF | 1 | R36C17[3][A] | u_top/u_alloc/n3476_s2/I0
35.198 | 0.327 | tINS | FR | 7 | R36C17[3][A] | u_top/u_alloc/n3476_s2/F
35.748 | 0.550 | tNET | RR | 1 | R34C19[1][A] | u_top/u_alloc/v_note_13_s0/CE

Data Required Path:

AT | DELAY | TYPE | RF | FANOUT | LOC | NODE
37.037 | 37.037 | | | | | active clock edge time
37.037 | 0.000 | | | | | clk_27m
37.037 | 0.000 | tCL | RR | 1 | IOT27[A] | clk_27m_ibuf/I
39.125 | 2.088 | tINS | RR | 3747 | IOT27[A] | clk_27m_ibuf/O
41.396 | 2.271 | tNET | RR | 1 | R34C19[1][A] | u_top/u_alloc/v_note_13_s0/CLK
41.361 | -0.035 | tSu | | 1 | R34C19[1][A] | u_top/u_alloc/v_note_13_s0

Path Statistics:

Clock Skew | 0.000
Setup Relationship | 37.037
Logic Level | 21
Arrival Clock Path Delay | cell: 2.088, 47.897%; route: 2.271, 52.103%
Arrival Data Path Delay | cell: 12.063, 38.431%; route: 19.094, 60.830%; tC2Q: 0.232, 0.739%
Required Clock Path Delay | cell: 2.088, 47.897%; route: 2.271, 52.103%

### Path17

Path Summary:

Slack | 5.620
Data Arrival Time | 35.741
Data Required Time | 41.361
From | u_top/u_manual/rd_ptr_0_s0
To | u_top/u_alloc/v_note_7_s0
Launch Clk | clk_27m:[R]
Latch Clk | clk_27m:[R]

Data Arrival Path:

AT | DELAY | TYPE | RF | FANOUT | LOC | NODE
0.000 | 0.000 | | | | | active clock edge time
0.000 | 0.000 | | | | | clk_27m
0.000 | 0.000 | tCL | RR | 1 | IOT27[A] | clk_27m_ibuf/I
2.088 | 2.088 | tINS | RR | 3747 | IOT27[A] | clk_27m_ibuf/O
4.359 | 2.271 | tNET | RR | 1 | R16C49[0][A] | u_top/u_manual/rd_ptr_0_s0/CLK
4.591 | 0.232 | tC2Q | RF | 7 | R16C49[0][A] | u_top/u_manual/rd_ptr_0_s0/Q
6.030 | 1.439 | tNET | FF | 2 | R13C47[0][A] | u_top/u_manual/n4_s0/I1
6.600 | 0.570 | tINS | FR | 1 | R13C47[0][A] | u_top/u_manual/n4_s0/COUT
6.600 | 0.000 | tNET | RR | 2 | R13C47[0][B] | u_top/u_manual/n5_s0/CIN
6.635 | 0.035 | tINS | RF | 1 | R13C47[0][B] | u_top/u_manual/n5_s0/COUT
6.635 | 0.000 | tNET | FF | 2 | R13C47[1][A] | u_top/u_manual/n6_s0/CIN
6.670 | 0.035 | tINS | FF | 1 | R13C47[1][A] | u_top/u_manual/n6_s0/COUT
6.670 | 0.000 | tNET | FF | 2 | R13C47[1][B] | u_top/u_manual/n7_s0/CIN
6.706 | 0.035 | tINS | FF | 1 | R13C47[1][B] | u_top/u_manual/n7_s0/COUT
6.706 | 0.000 | tNET | FF | 2 | R13C47[2][A] | u_top/u_manual/n8_s0/CIN
6.741 | 0.035 | tINS | FF | 17 | R13C47[2][A] | u_top/u_manual/n8_s0/COUT
7.811 | 1.070 | tNET | FF | 1 | R14C48[3][B] | u_top/ev_word_13_s2/I2
8.366 | 0.555 | tINS | FF | 1 | R14C48[3][B] | u_top/ev_word_13_s2/F
9.277 | 0.911 | tNET | FF | 1 | R12C38[3][A] | u_top/ev_word_13_s1/I1
9.648 | 0.371 | tINS | FF | 3 | R12C38[3][A] | u_top/ev_word_13_s1/F
10.070 | 0.422 | tNET | FF | 1 | R9C38[3][A] | u_top/ev_word_13_s0/I0
10.523 | 0.453 | tINS | FF | 55 | R9C38[3][A] | u_top/ev_word_13_s0/F
14.971 | 4.448 | tNET | FF | 2 | R39C20[2][B] | u_top/u_alloc/n80_s0/I1
15.541 | 0.570 | tINS | FR | 1 | R39C20[2][B] | u_top/u_alloc/n80_s0/COUT
15.541 | 0.000 | tNET | RR | 2 | R39C21[0][A] | u_top/u_alloc/n81_s0/CIN
15.576 | 0.035 | tINS | RF | 2 | R39C21[0][A] | u_top/u_alloc/n81_s0/COUT
16.692 | 1.115 | tNET | FF | 1 | R43C21[2][A] | u_top/u_alloc/v_gate_3_s3/I0
17.209 | 0.517 | tINS | FF | 3 | R43C21[2][A] | u_top/u_alloc/v_gate_3_s3/F
17.879 | 0.671 | tNET | FF | 1 | R45C20[1][B] | u_top/u_alloc/pick_2_s146/I2
18.396 | 0.517 | tINS | FF | 3 | R45C20[1][B] | u_top/u_alloc/pick_2_s146/F
18.896 | 0.500 | tNET | FF | 1 | R47C18[0][A] | u_top/u_alloc/pick_0_s9/I2
19.451 | 0.555 | tINS | FF | 5 | R47C18[0][A] | u_top/u_alloc/pick_0_s9/F
20.195 | 0.744 | tNET | FF | 1 | R44C19[1][A] | u_top/u_alloc/pick_0_s3/I1
20.750 | 0.555 | tINS | FF | 8 | R44C19[1][A] | u_top/u_alloc/pick_0_s3/F
21.579 | 0.828 | tNET | FF | 1 | R42C17[3][A] | u_top/u_alloc/pick_2_s64/I0
21.950 | 0.371 | tINS | FF | 3 | R42C17[3][A] | u_top/u_alloc/pick_2_s64/F
23.469 | 1.519 | tNET | FF | 1 | R47C14[3][B] | u_top/u_alloc/pick_2_s52/I1
23.840 | 0.371 | tINS | FF | 1 | R47C14[3][B] | u_top/u_alloc/pick_2_s52/F
23.844 | 0.004 | tNET | FF | 1 | R47C14[3][A] | u_top/u_alloc/pick_2_s21/I3
24.361 | 0.517 | tINS | FF | 2 | R47C14[3][A] | u_top/u_alloc/pick_2_s21/F
25.051 | 0.690 | tNET | FF | 1 | R45C18[0][B] | u_top/u_alloc/pick_2_s6/I3
25.422 | 0.371 | tINS | FF | 4 | R45C18[0][B] | u_top/u_alloc/pick_2_s6/F
25.435 | 0.013 | tNET | FF | 1 | R45C18[2][B] | u_top/u_alloc/pick_2_s1/I1
25.990 | 0.555 | tINS | FF | 4 | R45C18[2][B] | u_top/u_alloc/pick_2_s1/F
27.213 | 1.222 | tNET | FF | 1 | R47C15[3][B] | u_top/u_alloc/pick_0_s2/I1
27.768 | 0.555 | tINS | FF | 9 | R47C15[3][B] | u_top/u_alloc/pick_0_s2/F
28.461 | 0.693 | tNET | FF | 1 | R42C16[3][B] | u_top/u_alloc/pick_0_s49/I3
28.978 | 0.517 | tINS | FF | 26 | R42C16[3][B] | u_top/u_alloc/pick_0_s49/F
30.318 | 1.340 | tNET | FF | 18 | DSP_R37[2][A] | u_top/u_alloc/n453_s1/B[0]
33.958 | 3.640 | tINS | FF | 8 | DSP_R37[2][A] | u_top/u_alloc/n453_s1/DOUT[6]
34.871 | 0.913 | tNET | FF | 1 | R36C17[3][A] | u_top/u_alloc/n3476_s2/I0
35.198 | 0.327 | tINS | FR | 7 | R36C17[3][A] | u_top/u_alloc/n3476_s2/F
35.741 | 0.543 | tNET | RR | 1 | R32C17[0][B] | u_top/u_alloc/v_note_7_s0/CE

Data Required Path:

AT | DELAY | TYPE | RF | FANOUT | LOC | NODE
37.037 | 37.037 | | | | | active clock edge time
37.037 | 0.000 | | | | | clk_27m
37.037 | 0.000 | tCL | RR | 1 | IOT27[A] | clk_27m_ibuf/I
39.125 | 2.088 | tINS | RR | 3747 | IOT27[A] | clk_27m_ibuf/O
41.396 | 2.271 | tNET | RR | 1 | R32C17[0][B] | u_top/u_alloc/v_note_7_s0/CLK
41.361 | -0.035 | tSu | | 1 | R32C17[0][B] | u_top/u_alloc/v_note_7_s0

Path Statistics:

Clock Skew | 0.000
Setup Relationship | 37.037
Logic Level | 21
Arrival Clock Path Delay | cell: 2.088, 47.897%; route: 2.271, 52.103%
Arrival Data Path Delay | cell: 12.063, 38.440%; route: 19.087, 60.821%; tC2Q: 0.232, 0.739%
Required Clock Path Delay | cell: 2.088, 47.897%; route: 2.271, 52.103%

### Path18

Path Summary:

Slack | 5.620
Data Arrival Time | 35.741
Data Required Time | 41.361
From | u_top/u_manual/rd_ptr_0_s0
To | u_top/u_alloc/v_note_8_s0
Launch Clk | clk_27m:[R]
Latch Clk | clk_27m:[R]

Data Arrival Path:

AT | DELAY | TYPE | RF | FANOUT | LOC | NODE
0.000 | 0.000 | | | | | active clock edge time
0.000 | 0.000 | | | | | clk_27m
0.000 | 0.000 | tCL | RR | 1 | IOT27[A] | clk_27m_ibuf/I
2.088 | 2.088 | tINS | RR | 3747 | IOT27[A] | clk_27m_ibuf/O
4.359 | 2.271 | tNET | RR | 1 | R16C49[0][A] | u_top/u_manual/rd_ptr_0_s0/CLK
4.591 | 0.232 | tC2Q | RF | 7 | R16C49[0][A] | u_top/u_manual/rd_ptr_0_s0/Q
6.030 | 1.439 | tNET | FF | 2 | R13C47[0][A] | u_top/u_manual/n4_s0/I1
6.600 | 0.570 | tINS | FR | 1 | R13C47[0][A] | u_top/u_manual/n4_s0/COUT
6.600 | 0.000 | tNET | RR | 2 | R13C47[0][B] | u_top/u_manual/n5_s0/CIN
6.635 | 0.035 | tINS | RF | 1 | R13C47[0][B] | u_top/u_manual/n5_s0/COUT
6.635 | 0.000 | tNET | FF | 2 | R13C47[1][A] | u_top/u_manual/n6_s0/CIN
6.670 | 0.035 | tINS | FF | 1 | R13C47[1][A] | u_top/u_manual/n6_s0/COUT
6.670 | 0.000 | tNET | FF | 2 | R13C47[1][B] | u_top/u_manual/n7_s0/CIN
6.706 | 0.035 | tINS | FF | 1 | R13C47[1][B] | u_top/u_manual/n7_s0/COUT
6.706 | 0.000 | tNET | FF | 2 | R13C47[2][A] | u_top/u_manual/n8_s0/CIN
6.741 | 0.035 | tINS | FF | 17 | R13C47[2][A] | u_top/u_manual/n8_s0/COUT
7.811 | 1.070 | tNET | FF | 1 | R14C48[3][B] | u_top/ev_word_13_s2/I2
8.366 | 0.555 | tINS | FF | 1 | R14C48[3][B] | u_top/ev_word_13_s2/F
9.277 | 0.911 | tNET | FF | 1 | R12C38[3][A] | u_top/ev_word_13_s1/I1
9.648 | 0.371 | tINS | FF | 3 | R12C38[3][A] | u_top/ev_word_13_s1/F
10.070 | 0.422 | tNET | FF | 1 | R9C38[3][A] | u_top/ev_word_13_s0/I0
10.523 | 0.453 | tINS | FF | 55 | R9C38[3][A] | u_top/ev_word_13_s0/F
14.971 | 4.448 | tNET | FF | 2 | R39C20[2][B] | u_top/u_alloc/n80_s0/I1
15.541 | 0.570 | tINS | FR | 1 | R39C20[2][B] | u_top/u_alloc/n80_s0/COUT
15.541 | 0.000 | tNET | RR | 2 | R39C21[0][A] | u_top/u_alloc/n81_s0/CIN
15.576 | 0.035 | tINS | RF | 2 | R39C21[0][A] | u_top/u_alloc/n81_s0/COUT
16.692 | 1.115 | tNET | FF | 1 | R43C21[2][A] | u_top/u_alloc/v_gate_3_s3/I0
17.209 | 0.517 | tINS | FF | 3 | R43C21[2][A] | u_top/u_alloc/v_gate_3_s3/F
17.879 | 0.671 | tNET | FF | 1 | R45C20[1][B] | u_top/u_alloc/pick_2_s146/I2
18.396 | 0.517 | tINS | FF | 3 | R45C20[1][B] | u_top/u_alloc/pick_2_s146/F
18.896 | 0.500 | tNET | FF | 1 | R47C18[0][A] | u_top/u_alloc/pick_0_s9/I2
19.451 | 0.555 | tINS | FF | 5 | R47C18[0][A] | u_top/u_alloc/pick_0_s9/F
20.195 | 0.744 | tNET | FF | 1 | R44C19[1][A] | u_top/u_alloc/pick_0_s3/I1
20.750 | 0.555 | tINS | FF | 8 | R44C19[1][A] | u_top/u_alloc/pick_0_s3/F
21.579 | 0.828 | tNET | FF | 1 | R42C17[3][A] | u_top/u_alloc/pick_2_s64/I0
21.950 | 0.371 | tINS | FF | 3 | R42C17[3][A] | u_top/u_alloc/pick_2_s64/F
23.469 | 1.519 | tNET | FF | 1 | R47C14[3][B] | u_top/u_alloc/pick_2_s52/I1
23.840 | 0.371 | tINS | FF | 1 | R47C14[3][B] | u_top/u_alloc/pick_2_s52/F
23.844 | 0.004 | tNET | FF | 1 | R47C14[3][A] | u_top/u_alloc/pick_2_s21/I3
24.361 | 0.517 | tINS | FF | 2 | R47C14[3][A] | u_top/u_alloc/pick_2_s21/F
25.051 | 0.690 | tNET | FF | 1 | R45C18[0][B] | u_top/u_alloc/pick_2_s6/I3
25.422 | 0.371 | tINS | FF | 4 | R45C18[0][B] | u_top/u_alloc/pick_2_s6/F
25.435 | 0.013 | tNET | FF | 1 | R45C18[2][B] | u_top/u_alloc/pick_2_s1/I1
25.990 | 0.555 | tINS | FF | 4 | R45C18[2][B] | u_top/u_alloc/pick_2_s1/F
27.213 | 1.222 | tNET | FF | 1 | R47C15[3][B] | u_top/u_alloc/pick_0_s2/I1
27.768 | 0.555 | tINS | FF | 9 | R47C15[3][B] | u_top/u_alloc/pick_0_s2/F
28.461 | 0.693 | tNET | FF | 1 | R42C16[3][B] | u_top/u_alloc/pick_0_s49/I3
28.978 | 0.517 | tINS | FF | 26 | R42C16[3][B] | u_top/u_alloc/pick_0_s49/F
30.318 | 1.340 | tNET | FF | 18 | DSP_R37[2][A] | u_top/u_alloc/n453_s1/B[0]
33.958 | 3.640 | tINS | FF | 8 | DSP_R37[2][A] | u_top/u_alloc/n453_s1/DOUT[6]
34.871 | 0.913 | tNET | FF | 1 | R36C17[3][A] | u_top/u_alloc/n3476_s2/I0
35.198 | 0.327 | tINS | FR | 7 | R36C17[3][A] | u_top/u_alloc/n3476_s2/F
35.741 | 0.543 | tNET | RR | 1 | R32C17[0][A] | u_top/u_alloc/v_note_8_s0/CE

Data Required Path:

AT | DELAY | TYPE | RF | FANOUT | LOC | NODE
37.037 | 37.037 | | | | | active clock edge time
37.037 | 0.000 | | | | | clk_27m
37.037 | 0.000 | tCL | RR | 1 | IOT27[A] | clk_27m_ibuf/I
39.125 | 2.088 | tINS | RR | 3747 | IOT27[A] | clk_27m_ibuf/O
41.396 | 2.271 | tNET | RR | 1 | R32C17[0][A] | u_top/u_alloc/v_note_8_s0/CLK
41.361 | -0.035 | tSu | | 1 | R32C17[0][A] | u_top/u_alloc/v_note_8_s0

Path Statistics:

Clock Skew | 0.000
Setup Relationship | 37.037
Logic Level | 21
Arrival Clock Path Delay | cell: 2.088, 47.897%; route: 2.271, 52.103%
Arrival Data Path Delay | cell: 12.063, 38.440%; route: 19.087, 60.821%; tC2Q: 0.232, 0.739%
Required Clock Path Delay | cell: 2.088, 47.897%; route: 2.271, 52.103%

### Path19

Path Summary:

Slack | 5.641
Data Arrival Time | 35.720
Data Required Time | 41.361
From | u_top/u_manual/rd_ptr_0_s0
To | u_top/u_alloc/v_note_18_s0
Launch Clk | clk_27m:[R]
Latch Clk | clk_27m:[R]

Data Arrival Path:

AT | DELAY | TYPE | RF | FANOUT | LOC | NODE
0.000 | 0.000 | | | | | active clock edge time
0.000 | 0.000 | | | | | clk_27m
0.000 | 0.000 | tCL | RR | 1 | IOT27[A] | clk_27m_ibuf/I
2.088 | 2.088 | tINS | RR | 3747 | IOT27[A] | clk_27m_ibuf/O
4.359 | 2.271 | tNET | RR | 1 | R16C49[0][A] | u_top/u_manual/rd_ptr_0_s0/CLK
4.591 | 0.232 | tC2Q | RF | 7 | R16C49[0][A] | u_top/u_manual/rd_ptr_0_s0/Q
6.030 | 1.439 | tNET | FF | 2 | R13C47[0][A] | u_top/u_manual/n4_s0/I1
6.600 | 0.570 | tINS | FR | 1 | R13C47[0][A] | u_top/u_manual/n4_s0/COUT
6.600 | 0.000 | tNET | RR | 2 | R13C47[0][B] | u_top/u_manual/n5_s0/CIN
6.635 | 0.035 | tINS | RF | 1 | R13C47[0][B] | u_top/u_manual/n5_s0/COUT
6.635 | 0.000 | tNET | FF | 2 | R13C47[1][A] | u_top/u_manual/n6_s0/CIN
6.670 | 0.035 | tINS | FF | 1 | R13C47[1][A] | u_top/u_manual/n6_s0/COUT
6.670 | 0.000 | tNET | FF | 2 | R13C47[1][B] | u_top/u_manual/n7_s0/CIN
6.706 | 0.035 | tINS | FF | 1 | R13C47[1][B] | u_top/u_manual/n7_s0/COUT
6.706 | 0.000 | tNET | FF | 2 | R13C47[2][A] | u_top/u_manual/n8_s0/CIN
6.741 | 0.035 | tINS | FF | 17 | R13C47[2][A] | u_top/u_manual/n8_s0/COUT
7.811 | 1.070 | tNET | FF | 1 | R14C48[3][B] | u_top/ev_word_13_s2/I2
8.366 | 0.555 | tINS | FF | 1 | R14C48[3][B] | u_top/ev_word_13_s2/F
9.277 | 0.911 | tNET | FF | 1 | R12C38[3][A] | u_top/ev_word_13_s1/I1
9.648 | 0.371 | tINS | FF | 3 | R12C38[3][A] | u_top/ev_word_13_s1/F
10.070 | 0.422 | tNET | FF | 1 | R9C38[3][A] | u_top/ev_word_13_s0/I0
10.523 | 0.453 | tINS | FF | 55 | R9C38[3][A] | u_top/ev_word_13_s0/F
14.971 | 4.448 | tNET | FF | 2 | R39C20[2][B] | u_top/u_alloc/n80_s0/I1
15.541 | 0.570 | tINS | FR | 1 | R39C20[2][B] | u_top/u_alloc/n80_s0/COUT
15.541 | 0.000 | tNET | RR | 2 | R39C21[0][A] | u_top/u_alloc/n81_s0/CIN
15.576 | 0.035 | tINS | RF | 2 | R39C21[0][A] | u_top/u_alloc/n81_s0/COUT
16.692 | 1.115 | tNET | FF | 1 | R43C21[2][A] | u_top/u_alloc/v_gate_3_s3/I0
17.209 | 0.517 | tINS | FF | 3 | R43C21[2][A] | u_top/u_alloc/v_gate_3_s3/F
17.879 | 0.671 | tNET | FF | 1 | R45C20[1][B] | u_top/u_alloc/pick_2_s146/I2
18.396 | 0.517 | tINS | FF | 3 | R45C20[1][B] | u_top/u_alloc/pick_2_s146/F
18.896 | 0.500 | tNET | FF | 1 | R47C18[0][A] | u_top/u_alloc/pick_0_s9/I2
19.451 | 0.555 | tINS | FF | 5 | R47C18[0][A] | u_top/u_alloc/pick_0_s9/F
20.195 | 0.744 | tNET | FF | 1 | R44C19[1][A] | u_top/u_alloc/pick_0_s3/I1
20.750 | 0.555 | tINS | FF | 8 | R44C19[1][A] | u_top/u_alloc/pick_0_s3/F
21.579 | 0.828 | tNET | FF | 1 | R42C17[3][A] | u_top/u_alloc/pick_2_s64/I0
21.950 | 0.371 | tINS | FF | 3 | R42C17[3][A] | u_top/u_alloc/pick_2_s64/F
23.469 | 1.519 | tNET | FF | 1 | R47C14[3][B] | u_top/u_alloc/pick_2_s52/I1
23.840 | 0.371 | tINS | FF | 1 | R47C14[3][B] | u_top/u_alloc/pick_2_s52/F
23.844 | 0.004 | tNET | FF | 1 | R47C14[3][A] | u_top/u_alloc/pick_2_s21/I3
24.361 | 0.517 | tINS | FF | 2 | R47C14[3][A] | u_top/u_alloc/pick_2_s21/F
25.051 | 0.690 | tNET | FF | 1 | R45C18[0][B] | u_top/u_alloc/pick_2_s6/I3
25.422 | 0.371 | tINS | FF | 4 | R45C18[0][B] | u_top/u_alloc/pick_2_s6/F
25.435 | 0.013 | tNET | FF | 1 | R45C18[2][B] | u_top/u_alloc/pick_2_s1/I1
25.990 | 0.555 | tINS | FF | 4 | R45C18[2][B] | u_top/u_alloc/pick_2_s1/F
27.213 | 1.222 | tNET | FF | 1 | R47C15[3][B] | u_top/u_alloc/pick_0_s2/I1
27.768 | 0.555 | tINS | FF | 9 | R47C15[3][B] | u_top/u_alloc/pick_0_s2/F
28.461 | 0.693 | tNET | FF | 1 | R42C16[3][B] | u_top/u_alloc/pick_0_s49/I3
28.978 | 0.517 | tINS | FF | 26 | R42C16[3][B] | u_top/u_alloc/pick_0_s49/F
30.318 | 1.340 | tNET | FF | 18 | DSP_R37[2][A] | u_top/u_alloc/n453_s1/B[0]
33.958 | 3.640 | tINS | FF | 8 | DSP_R37[2][A] | u_top/u_alloc/n453_s1/DOUT[6]
34.877 | 0.919 | tNET | FF | 1 | R41C21[3][A] | u_top/u_alloc/n3462_s2/I0
35.204 | 0.327 | tINS | FR | 7 | R41C21[3][A] | u_top/u_alloc/n3462_s2/F
35.720 | 0.517 | tNET | RR | 1 | R40C22[1][A] | u_top/u_alloc/v_note_18_s0/CE

Data Required Path:

AT | DELAY | TYPE | RF | FANOUT | LOC | NODE
37.037 | 37.037 | | | | | active clock edge time
37.037 | 0.000 | | | | | clk_27m
37.037 | 0.000 | tCL | RR | 1 | IOT27[A] | clk_27m_ibuf/I
39.125 | 2.088 | tINS | RR | 3747 | IOT27[A] | clk_27m_ibuf/O
41.396 | 2.271 | tNET | RR | 1 | R40C22[1][A] | u_top/u_alloc/v_note_18_s0/CLK
41.361 | -0.035 | tSu | | 1 | R40C22[1][A] | u_top/u_alloc/v_note_18_s0

Path Statistics:

Clock Skew | 0.000
Setup Relationship | 37.037
Logic Level | 21
Arrival Clock Path Delay | cell: 2.088, 47.897%; route: 2.271, 52.103%
Arrival Data Path Delay | cell: 12.063, 38.465%; route: 19.066, 60.795%; tC2Q: 0.232, 0.740%
Required Clock Path Delay | cell: 2.088, 47.897%; route: 2.271, 52.103%

### Path20

Path Summary:

Slack | 5.797
Data Arrival Time | 35.565
Data Required Time | 41.361
From | u_top/u_manual/rd_ptr_0_s0
To | u_top/u_alloc/v_note_9_s0
Launch Clk | clk_27m:[R]
Latch Clk | clk_27m:[R]

Data Arrival Path:

AT | DELAY | TYPE | RF | FANOUT | LOC | NODE
0.000 | 0.000 | | | | | active clock edge time
0.000 | 0.000 | | | | | clk_27m
0.000 | 0.000 | tCL | RR | 1 | IOT27[A] | clk_27m_ibuf/I
2.088 | 2.088 | tINS | RR | 3747 | IOT27[A] | clk_27m_ibuf/O
4.359 | 2.271 | tNET | RR | 1 | R16C49[0][A] | u_top/u_manual/rd_ptr_0_s0/CLK
4.591 | 0.232 | tC2Q | RF | 7 | R16C49[0][A] | u_top/u_manual/rd_ptr_0_s0/Q
6.030 | 1.439 | tNET | FF | 2 | R13C47[0][A] | u_top/u_manual/n4_s0/I1
6.600 | 0.570 | tINS | FR | 1 | R13C47[0][A] | u_top/u_manual/n4_s0/COUT
6.600 | 0.000 | tNET | RR | 2 | R13C47[0][B] | u_top/u_manual/n5_s0/CIN
6.635 | 0.035 | tINS | RF | 1 | R13C47[0][B] | u_top/u_manual/n5_s0/COUT
6.635 | 0.000 | tNET | FF | 2 | R13C47[1][A] | u_top/u_manual/n6_s0/CIN
6.670 | 0.035 | tINS | FF | 1 | R13C47[1][A] | u_top/u_manual/n6_s0/COUT
6.670 | 0.000 | tNET | FF | 2 | R13C47[1][B] | u_top/u_manual/n7_s0/CIN
6.706 | 0.035 | tINS | FF | 1 | R13C47[1][B] | u_top/u_manual/n7_s0/COUT
6.706 | 0.000 | tNET | FF | 2 | R13C47[2][A] | u_top/u_manual/n8_s0/CIN
6.741 | 0.035 | tINS | FF | 17 | R13C47[2][A] | u_top/u_manual/n8_s0/COUT
7.811 | 1.070 | tNET | FF | 1 | R14C48[3][B] | u_top/ev_word_13_s2/I2
8.366 | 0.555 | tINS | FF | 1 | R14C48[3][B] | u_top/ev_word_13_s2/F
9.277 | 0.911 | tNET | FF | 1 | R12C38[3][A] | u_top/ev_word_13_s1/I1
9.648 | 0.371 | tINS | FF | 3 | R12C38[3][A] | u_top/ev_word_13_s1/F
10.070 | 0.422 | tNET | FF | 1 | R9C38[3][A] | u_top/ev_word_13_s0/I0
10.523 | 0.453 | tINS | FF | 55 | R9C38[3][A] | u_top/ev_word_13_s0/F
14.971 | 4.448 | tNET | FF | 2 | R39C20[2][B] | u_top/u_alloc/n80_s0/I1
15.541 | 0.570 | tINS | FR | 1 | R39C20[2][B] | u_top/u_alloc/n80_s0/COUT
15.541 | 0.000 | tNET | RR | 2 | R39C21[0][A] | u_top/u_alloc/n81_s0/CIN
15.576 | 0.035 | tINS | RF | 2 | R39C21[0][A] | u_top/u_alloc/n81_s0/COUT
16.692 | 1.115 | tNET | FF | 1 | R43C21[2][A] | u_top/u_alloc/v_gate_3_s3/I0
17.209 | 0.517 | tINS | FF | 3 | R43C21[2][A] | u_top/u_alloc/v_gate_3_s3/F
17.879 | 0.671 | tNET | FF | 1 | R45C20[1][B] | u_top/u_alloc/pick_2_s146/I2
18.396 | 0.517 | tINS | FF | 3 | R45C20[1][B] | u_top/u_alloc/pick_2_s146/F
18.896 | 0.500 | tNET | FF | 1 | R47C18[0][A] | u_top/u_alloc/pick_0_s9/I2
19.451 | 0.555 | tINS | FF | 5 | R47C18[0][A] | u_top/u_alloc/pick_0_s9/F
20.195 | 0.744 | tNET | FF | 1 | R44C19[1][A] | u_top/u_alloc/pick_0_s3/I1
20.750 | 0.555 | tINS | FF | 8 | R44C19[1][A] | u_top/u_alloc/pick_0_s3/F
21.579 | 0.828 | tNET | FF | 1 | R42C17[3][A] | u_top/u_alloc/pick_2_s64/I0
21.950 | 0.371 | tINS | FF | 3 | R42C17[3][A] | u_top/u_alloc/pick_2_s64/F
23.469 | 1.519 | tNET | FF | 1 | R47C14[3][B] | u_top/u_alloc/pick_2_s52/I1
23.840 | 0.371 | tINS | FF | 1 | R47C14[3][B] | u_top/u_alloc/pick_2_s52/F
23.844 | 0.004 | tNET | FF | 1 | R47C14[3][A] | u_top/u_alloc/pick_2_s21/I3
24.361 | 0.517 | tINS | FF | 2 | R47C14[3][A] | u_top/u_alloc/pick_2_s21/F
25.051 | 0.690 | tNET | FF | 1 | R45C18[0][B] | u_top/u_alloc/pick_2_s6/I3
25.422 | 0.371 | tINS | FF | 4 | R45C18[0][B] | u_top/u_alloc/pick_2_s6/F
25.435 | 0.013 | tNET | FF | 1 | R45C18[2][B] | u_top/u_alloc/pick_2_s1/I1
25.990 | 0.555 | tINS | FF | 4 | R45C18[2][B] | u_top/u_alloc/pick_2_s1/F
27.213 | 1.222 | tNET | FF | 1 | R47C15[3][B] | u_top/u_alloc/pick_0_s2/I1
27.768 | 0.555 | tINS | FF | 9 | R47C15[3][B] | u_top/u_alloc/pick_0_s2/F
28.461 | 0.693 | tNET | FF | 1 | R42C16[3][B] | u_top/u_alloc/pick_0_s49/I3
28.978 | 0.517 | tINS | FF | 26 | R42C16[3][B] | u_top/u_alloc/pick_0_s49/F
30.318 | 1.340 | tNET | FF | 18 | DSP_R37[2][A] | u_top/u_alloc/n453_s1/B[0]
33.958 | 3.640 | tINS | FF | 8 | DSP_R37[2][A] | u_top/u_alloc/n453_s1/DOUT[6]
34.871 | 0.913 | tNET | FF | 1 | R36C17[3][A] | u_top/u_alloc/n3476_s2/I0
35.198 | 0.327 | tINS | FR | 7 | R36C17[3][A] | u_top/u_alloc/n3476_s2/F
35.565 | 0.367 | tNET | RR | 1 | R35C19[0][A] | u_top/u_alloc/v_note_9_s0/CE

Data Required Path:

AT | DELAY | TYPE | RF | FANOUT | LOC | NODE
37.037 | 37.037 | | | | | active clock edge time
37.037 | 0.000 | | | | | clk_27m
37.037 | 0.000 | tCL | RR | 1 | IOT27[A] | clk_27m_ibuf/I
39.125 | 2.088 | tINS | RR | 3747 | IOT27[A] | clk_27m_ibuf/O
41.396 | 2.271 | tNET | RR | 1 | R35C19[0][A] | u_top/u_alloc/v_note_9_s0/CLK
41.361 | -0.035 | tSu | | 1 | R35C19[0][A] | u_top/u_alloc/v_note_9_s0

Path Statistics:

Clock Skew | 0.000
Setup Relationship | 37.037
Logic Level | 21
Arrival Clock Path Delay | cell: 2.088, 47.897%; route: 2.271, 52.103%
Arrival Data Path Delay | cell: 12.063, 38.657%; route: 18.910, 60.600%; tC2Q: 0.232, 0.743%
Required Clock Path Delay | cell: 2.088, 47.897%; route: 2.271, 52.103%

### Path21

Path Summary:

Slack | 5.797
Data Arrival Time | 35.565
Data Required Time | 41.361
From | u_top/u_manual/rd_ptr_0_s0
To | u_top/u_alloc/v_note_10_s0
Launch Clk | clk_27m:[R]
Latch Clk | clk_27m:[R]

Data Arrival Path:

AT | DELAY | TYPE | RF | FANOUT | LOC | NODE
0.000 | 0.000 | | | | | active clock edge time
0.000 | 0.000 | | | | | clk_27m
0.000 | 0.000 | tCL | RR | 1 | IOT27[A] | clk_27m_ibuf/I
2.088 | 2.088 | tINS | RR | 3747 | IOT27[A] | clk_27m_ibuf/O
4.359 | 2.271 | tNET | RR | 1 | R16C49[0][A] | u_top/u_manual/rd_ptr_0_s0/CLK
4.591 | 0.232 | tC2Q | RF | 7 | R16C49[0][A] | u_top/u_manual/rd_ptr_0_s0/Q
6.030 | 1.439 | tNET | FF | 2 | R13C47[0][A] | u_top/u_manual/n4_s0/I1
6.600 | 0.570 | tINS | FR | 1 | R13C47[0][A] | u_top/u_manual/n4_s0/COUT
6.600 | 0.000 | tNET | RR | 2 | R13C47[0][B] | u_top/u_manual/n5_s0/CIN
6.635 | 0.035 | tINS | RF | 1 | R13C47[0][B] | u_top/u_manual/n5_s0/COUT
6.635 | 0.000 | tNET | FF | 2 | R13C47[1][A] | u_top/u_manual/n6_s0/CIN
6.670 | 0.035 | tINS | FF | 1 | R13C47[1][A] | u_top/u_manual/n6_s0/COUT
6.670 | 0.000 | tNET | FF | 2 | R13C47[1][B] | u_top/u_manual/n7_s0/CIN
6.706 | 0.035 | tINS | FF | 1 | R13C47[1][B] | u_top/u_manual/n7_s0/COUT
6.706 | 0.000 | tNET | FF | 2 | R13C47[2][A] | u_top/u_manual/n8_s0/CIN
6.741 | 0.035 | tINS | FF | 17 | R13C47[2][A] | u_top/u_manual/n8_s0/COUT
7.811 | 1.070 | tNET | FF | 1 | R14C48[3][B] | u_top/ev_word_13_s2/I2
8.366 | 0.555 | tINS | FF | 1 | R14C48[3][B] | u_top/ev_word_13_s2/F
9.277 | 0.911 | tNET | FF | 1 | R12C38[3][A] | u_top/ev_word_13_s1/I1
9.648 | 0.371 | tINS | FF | 3 | R12C38[3][A] | u_top/ev_word_13_s1/F
10.070 | 0.422 | tNET | FF | 1 | R9C38[3][A] | u_top/ev_word_13_s0/I0
10.523 | 0.453 | tINS | FF | 55 | R9C38[3][A] | u_top/ev_word_13_s0/F
14.971 | 4.448 | tNET | FF | 2 | R39C20[2][B] | u_top/u_alloc/n80_s0/I1
15.541 | 0.570 | tINS | FR | 1 | R39C20[2][B] | u_top/u_alloc/n80_s0/COUT
15.541 | 0.000 | tNET | RR | 2 | R39C21[0][A] | u_top/u_alloc/n81_s0/CIN
15.576 | 0.035 | tINS | RF | 2 | R39C21[0][A] | u_top/u_alloc/n81_s0/COUT
16.692 | 1.115 | tNET | FF | 1 | R43C21[2][A] | u_top/u_alloc/v_gate_3_s3/I0
17.209 | 0.517 | tINS | FF | 3 | R43C21[2][A] | u_top/u_alloc/v_gate_3_s3/F
17.879 | 0.671 | tNET | FF | 1 | R45C20[1][B] | u_top/u_alloc/pick_2_s146/I2
18.396 | 0.517 | tINS | FF | 3 | R45C20[1][B] | u_top/u_alloc/pick_2_s146/F
18.896 | 0.500 | tNET | FF | 1 | R47C18[0][A] | u_top/u_alloc/pick_0_s9/I2
19.451 | 0.555 | tINS | FF | 5 | R47C18[0][A] | u_top/u_alloc/pick_0_s9/F
20.195 | 0.744 | tNET | FF | 1 | R44C19[1][A] | u_top/u_alloc/pick_0_s3/I1
20.750 | 0.555 | tINS | FF | 8 | R44C19[1][A] | u_top/u_alloc/pick_0_s3/F
21.579 | 0.828 | tNET | FF | 1 | R42C17[3][A] | u_top/u_alloc/pick_2_s64/I0
21.950 | 0.371 | tINS | FF | 3 | R42C17[3][A] | u_top/u_alloc/pick_2_s64/F
23.469 | 1.519 | tNET | FF | 1 | R47C14[3][B] | u_top/u_alloc/pick_2_s52/I1
23.840 | 0.371 | tINS | FF | 1 | R47C14[3][B] | u_top/u_alloc/pick_2_s52/F
23.844 | 0.004 | tNET | FF | 1 | R47C14[3][A] | u_top/u_alloc/pick_2_s21/I3
24.361 | 0.517 | tINS | FF | 2 | R47C14[3][A] | u_top/u_alloc/pick_2_s21/F
25.051 | 0.690 | tNET | FF | 1 | R45C18[0][B] | u_top/u_alloc/pick_2_s6/I3
25.422 | 0.371 | tINS | FF | 4 | R45C18[0][B] | u_top/u_alloc/pick_2_s6/F
25.435 | 0.013 | tNET | FF | 1 | R45C18[2][B] | u_top/u_alloc/pick_2_s1/I1
25.990 | 0.555 | tINS | FF | 4 | R45C18[2][B] | u_top/u_alloc/pick_2_s1/F
27.213 | 1.222 | tNET | FF | 1 | R47C15[3][B] | u_top/u_alloc/pick_0_s2/I1
27.768 | 0.555 | tINS | FF | 9 | R47C15[3][B] | u_top/u_alloc/pick_0_s2/F
28.461 | 0.693 | tNET | FF | 1 | R42C16[3][B] | u_top/u_alloc/pick_0_s49/I3
28.978 | 0.517 | tINS | FF | 26 | R42C16[3][B] | u_top/u_alloc/pick_0_s49/F
30.318 | 1.340 | tNET | FF | 18 | DSP_R37[2][A] | u_top/u_alloc/n453_s1/B[0]
33.958 | 3.640 | tINS | FF | 8 | DSP_R37[2][A] | u_top/u_alloc/n453_s1/DOUT[6]
34.871 | 0.913 | tNET | FF | 1 | R36C17[3][A] | u_top/u_alloc/n3476_s2/I0
35.198 | 0.327 | tINS | FR | 7 | R36C17[3][A] | u_top/u_alloc/n3476_s2/F
35.565 | 0.367 | tNET | RR | 1 | R35C19[2][A] | u_top/u_alloc/v_note_10_s0/CE

Data Required Path:

AT | DELAY | TYPE | RF | FANOUT | LOC | NODE
37.037 | 37.037 | | | | | active clock edge time
37.037 | 0.000 | | | | | clk_27m
37.037 | 0.000 | tCL | RR | 1 | IOT27[A] | clk_27m_ibuf/I
39.125 | 2.088 | tINS | RR | 3747 | IOT27[A] | clk_27m_ibuf/O
41.396 | 2.271 | tNET | RR | 1 | R35C19[2][A] | u_top/u_alloc/v_note_10_s0/CLK
41.361 | -0.035 | tSu | | 1 | R35C19[2][A] | u_top/u_alloc/v_note_10_s0

Path Statistics:

Clock Skew | 0.000
Setup Relationship | 37.037
Logic Level | 21
Arrival Clock Path Delay | cell: 2.088, 47.897%; route: 2.271, 52.103%
Arrival Data Path Delay | cell: 12.063, 38.657%; route: 18.910, 60.600%; tC2Q: 0.232, 0.743%
Required Clock Path Delay | cell: 2.088, 47.897%; route: 2.271, 52.103%

### Path22

Path Summary:

Slack | 5.797
Data Arrival Time | 35.565
Data Required Time | 41.361
From | u_top/u_manual/rd_ptr_0_s0
To | u_top/u_alloc/v_note_11_s0
Launch Clk | clk_27m:[R]
Latch Clk | clk_27m:[R]

Data Arrival Path:

AT | DELAY | TYPE | RF | FANOUT | LOC | NODE
0.000 | 0.000 | | | | | active clock edge time
0.000 | 0.000 | | | | | clk_27m
0.000 | 0.000 | tCL | RR | 1 | IOT27[A] | clk_27m_ibuf/I
2.088 | 2.088 | tINS | RR | 3747 | IOT27[A] | clk_27m_ibuf/O
4.359 | 2.271 | tNET | RR | 1 | R16C49[0][A] | u_top/u_manual/rd_ptr_0_s0/CLK
4.591 | 0.232 | tC2Q | RF | 7 | R16C49[0][A] | u_top/u_manual/rd_ptr_0_s0/Q
6.030 | 1.439 | tNET | FF | 2 | R13C47[0][A] | u_top/u_manual/n4_s0/I1
6.600 | 0.570 | tINS | FR | 1 | R13C47[0][A] | u_top/u_manual/n4_s0/COUT
6.600 | 0.000 | tNET | RR | 2 | R13C47[0][B] | u_top/u_manual/n5_s0/CIN
6.635 | 0.035 | tINS | RF | 1 | R13C47[0][B] | u_top/u_manual/n5_s0/COUT
6.635 | 0.000 | tNET | FF | 2 | R13C47[1][A] | u_top/u_manual/n6_s0/CIN
6.670 | 0.035 | tINS | FF | 1 | R13C47[1][A] | u_top/u_manual/n6_s0/COUT
6.670 | 0.000 | tNET | FF | 2 | R13C47[1][B] | u_top/u_manual/n7_s0/CIN
6.706 | 0.035 | tINS | FF | 1 | R13C47[1][B] | u_top/u_manual/n7_s0/COUT
6.706 | 0.000 | tNET | FF | 2 | R13C47[2][A] | u_top/u_manual/n8_s0/CIN
6.741 | 0.035 | tINS | FF | 17 | R13C47[2][A] | u_top/u_manual/n8_s0/COUT
7.811 | 1.070 | tNET | FF | 1 | R14C48[3][B] | u_top/ev_word_13_s2/I2
8.366 | 0.555 | tINS | FF | 1 | R14C48[3][B] | u_top/ev_word_13_s2/F
9.277 | 0.911 | tNET | FF | 1 | R12C38[3][A] | u_top/ev_word_13_s1/I1
9.648 | 0.371 | tINS | FF | 3 | R12C38[3][A] | u_top/ev_word_13_s1/F
10.070 | 0.422 | tNET | FF | 1 | R9C38[3][A] | u_top/ev_word_13_s0/I0
10.523 | 0.453 | tINS | FF | 55 | R9C38[3][A] | u_top/ev_word_13_s0/F
14.971 | 4.448 | tNET | FF | 2 | R39C20[2][B] | u_top/u_alloc/n80_s0/I1
15.541 | 0.570 | tINS | FR | 1 | R39C20[2][B] | u_top/u_alloc/n80_s0/COUT
15.541 | 0.000 | tNET | RR | 2 | R39C21[0][A] | u_top/u_alloc/n81_s0/CIN
15.576 | 0.035 | tINS | RF | 2 | R39C21[0][A] | u_top/u_alloc/n81_s0/COUT
16.692 | 1.115 | tNET | FF | 1 | R43C21[2][A] | u_top/u_alloc/v_gate_3_s3/I0
17.209 | 0.517 | tINS | FF | 3 | R43C21[2][A] | u_top/u_alloc/v_gate_3_s3/F
17.879 | 0.671 | tNET | FF | 1 | R45C20[1][B] | u_top/u_alloc/pick_2_s146/I2
18.396 | 0.517 | tINS | FF | 3 | R45C20[1][B] | u_top/u_alloc/pick_2_s146/F
18.896 | 0.500 | tNET | FF | 1 | R47C18[0][A] | u_top/u_alloc/pick_0_s9/I2
19.451 | 0.555 | tINS | FF | 5 | R47C18[0][A] | u_top/u_alloc/pick_0_s9/F
20.195 | 0.744 | tNET | FF | 1 | R44C19[1][A] | u_top/u_alloc/pick_0_s3/I1
20.750 | 0.555 | tINS | FF | 8 | R44C19[1][A] | u_top/u_alloc/pick_0_s3/F
21.579 | 0.828 | tNET | FF | 1 | R42C17[3][A] | u_top/u_alloc/pick_2_s64/I0
21.950 | 0.371 | tINS | FF | 3 | R42C17[3][A] | u_top/u_alloc/pick_2_s64/F
23.469 | 1.519 | tNET | FF | 1 | R47C14[3][B] | u_top/u_alloc/pick_2_s52/I1
23.840 | 0.371 | tINS | FF | 1 | R47C14[3][B] | u_top/u_alloc/pick_2_s52/F
23.844 | 0.004 | tNET | FF | 1 | R47C14[3][A] | u_top/u_alloc/pick_2_s21/I3
24.361 | 0.517 | tINS | FF | 2 | R47C14[3][A] | u_top/u_alloc/pick_2_s21/F
25.051 | 0.690 | tNET | FF | 1 | R45C18[0][B] | u_top/u_alloc/pick_2_s6/I3
25.422 | 0.371 | tINS | FF | 4 | R45C18[0][B] | u_top/u_alloc/pick_2_s6/F
25.435 | 0.013 | tNET | FF | 1 | R45C18[2][B] | u_top/u_alloc/pick_2_s1/I1
25.990 | 0.555 | tINS | FF | 4 | R45C18[2][B] | u_top/u_alloc/pick_2_s1/F
27.213 | 1.222 | tNET | FF | 1 | R47C15[3][B] | u_top/u_alloc/pick_0_s2/I1
27.768 | 0.555 | tINS | FF | 9 | R47C15[3][B] | u_top/u_alloc/pick_0_s2/F
28.461 | 0.693 | tNET | FF | 1 | R42C16[3][B] | u_top/u_alloc/pick_0_s49/I3
28.978 | 0.517 | tINS | FF | 26 | R42C16[3][B] | u_top/u_alloc/pick_0_s49/F
30.318 | 1.340 | tNET | FF | 18 | DSP_R37[2][A] | u_top/u_alloc/n453_s1/B[0]
33.958 | 3.640 | tINS | FF | 8 | DSP_R37[2][A] | u_top/u_alloc/n453_s1/DOUT[6]
34.871 | 0.913 | tNET | FF | 1 | R36C17[3][A] | u_top/u_alloc/n3476_s2/I0
35.198 | 0.327 | tINS | FR | 7 | R36C17[3][A] | u_top/u_alloc/n3476_s2/F
35.565 | 0.367 | tNET | RR | 1 | R35C19[0][B] | u_top/u_alloc/v_note_11_s0/CE

Data Required Path:

AT | DELAY | TYPE | RF | FANOUT | LOC | NODE
37.037 | 37.037 | | | | | active clock edge time
37.037 | 0.000 | | | | | clk_27m
37.037 | 0.000 | tCL | RR | 1 | IOT27[A] | clk_27m_ibuf/I
39.125 | 2.088 | tINS | RR | 3747 | IOT27[A] | clk_27m_ibuf/O
41.396 | 2.271 | tNET | RR | 1 | R35C19[0][B] | u_top/u_alloc/v_note_11_s0/CLK
41.361 | -0.035 | tSu | | 1 | R35C19[0][B] | u_top/u_alloc/v_note_11_s0

Path Statistics:

Clock Skew | 0.000
Setup Relationship | 37.037
Logic Level | 21
Arrival Clock Path Delay | cell: 2.088, 47.897%; route: 2.271, 52.103%
Arrival Data Path Delay | cell: 12.063, 38.657%; route: 18.910, 60.600%; tC2Q: 0.232, 0.743%
Required Clock Path Delay | cell: 2.088, 47.897%; route: 2.271, 52.103%

### Path23

Path Summary:

Slack | 5.819
Data Arrival Time | 35.542
Data Required Time | 41.361
From | u_top/u_manual/rd_ptr_0_s0
To | u_top/u_alloc/v_note_14_s0
Launch Clk | clk_27m:[R]
Latch Clk | clk_27m:[R]

Data Arrival Path:

AT | DELAY | TYPE | RF | FANOUT | LOC | NODE
0.000 | 0.000 | | | | | active clock edge time
0.000 | 0.000 | | | | | clk_27m
0.000 | 0.000 | tCL | RR | 1 | IOT27[A] | clk_27m_ibuf/I
2.088 | 2.088 | tINS | RR | 3747 | IOT27[A] | clk_27m_ibuf/O
4.359 | 2.271 | tNET | RR | 1 | R16C49[0][A] | u_top/u_manual/rd_ptr_0_s0/CLK
4.591 | 0.232 | tC2Q | RF | 7 | R16C49[0][A] | u_top/u_manual/rd_ptr_0_s0/Q
6.030 | 1.439 | tNET | FF | 2 | R13C47[0][A] | u_top/u_manual/n4_s0/I1
6.600 | 0.570 | tINS | FR | 1 | R13C47[0][A] | u_top/u_manual/n4_s0/COUT
6.600 | 0.000 | tNET | RR | 2 | R13C47[0][B] | u_top/u_manual/n5_s0/CIN
6.635 | 0.035 | tINS | RF | 1 | R13C47[0][B] | u_top/u_manual/n5_s0/COUT
6.635 | 0.000 | tNET | FF | 2 | R13C47[1][A] | u_top/u_manual/n6_s0/CIN
6.670 | 0.035 | tINS | FF | 1 | R13C47[1][A] | u_top/u_manual/n6_s0/COUT
6.670 | 0.000 | tNET | FF | 2 | R13C47[1][B] | u_top/u_manual/n7_s0/CIN
6.706 | 0.035 | tINS | FF | 1 | R13C47[1][B] | u_top/u_manual/n7_s0/COUT
6.706 | 0.000 | tNET | FF | 2 | R13C47[2][A] | u_top/u_manual/n8_s0/CIN
6.741 | 0.035 | tINS | FF | 17 | R13C47[2][A] | u_top/u_manual/n8_s0/COUT
7.811 | 1.070 | tNET | FF | 1 | R14C48[3][B] | u_top/ev_word_13_s2/I2
8.366 | 0.555 | tINS | FF | 1 | R14C48[3][B] | u_top/ev_word_13_s2/F
9.277 | 0.911 | tNET | FF | 1 | R12C38[3][A] | u_top/ev_word_13_s1/I1
9.648 | 0.371 | tINS | FF | 3 | R12C38[3][A] | u_top/ev_word_13_s1/F
10.070 | 0.422 | tNET | FF | 1 | R9C38[3][A] | u_top/ev_word_13_s0/I0
10.523 | 0.453 | tINS | FF | 55 | R9C38[3][A] | u_top/ev_word_13_s0/F
14.971 | 4.448 | tNET | FF | 2 | R39C20[2][B] | u_top/u_alloc/n80_s0/I1
15.541 | 0.570 | tINS | FR | 1 | R39C20[2][B] | u_top/u_alloc/n80_s0/COUT
15.541 | 0.000 | tNET | RR | 2 | R39C21[0][A] | u_top/u_alloc/n81_s0/CIN
15.576 | 0.035 | tINS | RF | 2 | R39C21[0][A] | u_top/u_alloc/n81_s0/COUT
16.692 | 1.115 | tNET | FF | 1 | R43C21[2][A] | u_top/u_alloc/v_gate_3_s3/I0
17.209 | 0.517 | tINS | FF | 3 | R43C21[2][A] | u_top/u_alloc/v_gate_3_s3/F
17.879 | 0.671 | tNET | FF | 1 | R45C20[1][B] | u_top/u_alloc/pick_2_s146/I2
18.396 | 0.517 | tINS | FF | 3 | R45C20[1][B] | u_top/u_alloc/pick_2_s146/F
18.896 | 0.500 | tNET | FF | 1 | R47C18[0][A] | u_top/u_alloc/pick_0_s9/I2
19.451 | 0.555 | tINS | FF | 5 | R47C18[0][A] | u_top/u_alloc/pick_0_s9/F
20.195 | 0.744 | tNET | FF | 1 | R44C19[1][A] | u_top/u_alloc/pick_0_s3/I1
20.750 | 0.555 | tINS | FF | 8 | R44C19[1][A] | u_top/u_alloc/pick_0_s3/F
21.579 | 0.828 | tNET | FF | 1 | R42C17[3][A] | u_top/u_alloc/pick_2_s64/I0
21.950 | 0.371 | tINS | FF | 3 | R42C17[3][A] | u_top/u_alloc/pick_2_s64/F
23.469 | 1.519 | tNET | FF | 1 | R47C14[3][B] | u_top/u_alloc/pick_2_s52/I1
23.840 | 0.371 | tINS | FF | 1 | R47C14[3][B] | u_top/u_alloc/pick_2_s52/F
23.844 | 0.004 | tNET | FF | 1 | R47C14[3][A] | u_top/u_alloc/pick_2_s21/I3
24.361 | 0.517 | tINS | FF | 2 | R47C14[3][A] | u_top/u_alloc/pick_2_s21/F
25.051 | 0.690 | tNET | FF | 1 | R45C18[0][B] | u_top/u_alloc/pick_2_s6/I3
25.422 | 0.371 | tINS | FF | 4 | R45C18[0][B] | u_top/u_alloc/pick_2_s6/F
25.435 | 0.013 | tNET | FF | 1 | R45C18[2][B] | u_top/u_alloc/pick_2_s1/I1
25.990 | 0.555 | tINS | FF | 4 | R45C18[2][B] | u_top/u_alloc/pick_2_s1/F
27.213 | 1.222 | tNET | FF | 1 | R47C15[3][B] | u_top/u_alloc/pick_0_s2/I1
27.768 | 0.555 | tINS | FF | 9 | R47C15[3][B] | u_top/u_alloc/pick_0_s2/F
28.461 | 0.693 | tNET | FF | 1 | R42C16[3][B] | u_top/u_alloc/pick_0_s49/I3
28.978 | 0.517 | tINS | FF | 26 | R42C16[3][B] | u_top/u_alloc/pick_0_s49/F
30.318 | 1.340 | tNET | FF | 18 | DSP_R37[2][A] | u_top/u_alloc/n453_s1/B[0]
33.958 | 3.640 | tINS | FF | 8 | DSP_R37[2][A] | u_top/u_alloc/n453_s1/DOUT[6]
34.877 | 0.919 | tNET | FF | 1 | R41C21[3][A] | u_top/u_alloc/n3462_s2/I0
35.204 | 0.327 | tINS | FR | 7 | R41C21[3][A] | u_top/u_alloc/n3462_s2/F
35.542 | 0.339 | tNET | RR | 1 | R41C22[0][B] | u_top/u_alloc/v_note_14_s0/CE

Data Required Path:

AT | DELAY | TYPE | RF | FANOUT | LOC | NODE
37.037 | 37.037 | | | | | active clock edge time
37.037 | 0.000 | | | | | clk_27m
37.037 | 0.000 | tCL | RR | 1 | IOT27[A] | clk_27m_ibuf/I
39.125 | 2.088 | tINS | RR | 3747 | IOT27[A] | clk_27m_ibuf/O
41.396 | 2.271 | tNET | RR | 1 | R41C22[0][B] | u_top/u_alloc/v_note_14_s0/CLK
41.361 | -0.035 | tSu | | 1 | R41C22[0][B] | u_top/u_alloc/v_note_14_s0

Path Statistics:

Clock Skew | 0.000
Setup Relationship | 37.037
Logic Level | 21
Arrival Clock Path Delay | cell: 2.088, 47.897%; route: 2.271, 52.103%
Arrival Data Path Delay | cell: 12.063, 38.684%; route: 18.888, 60.572%; tC2Q: 0.232, 0.744%
Required Clock Path Delay | cell: 2.088, 47.897%; route: 2.271, 52.103%

### Path24

Path Summary:

Slack | 5.819
Data Arrival Time | 35.542
Data Required Time | 41.361
From | u_top/u_manual/rd_ptr_0_s0
To | u_top/u_alloc/v_note_15_s0
Launch Clk | clk_27m:[R]
Latch Clk | clk_27m:[R]

Data Arrival Path:

AT | DELAY | TYPE | RF | FANOUT | LOC | NODE
0.000 | 0.000 | | | | | active clock edge time
0.000 | 0.000 | | | | | clk_27m
0.000 | 0.000 | tCL | RR | 1 | IOT27[A] | clk_27m_ibuf/I
2.088 | 2.088 | tINS | RR | 3747 | IOT27[A] | clk_27m_ibuf/O
4.359 | 2.271 | tNET | RR | 1 | R16C49[0][A] | u_top/u_manual/rd_ptr_0_s0/CLK
4.591 | 0.232 | tC2Q | RF | 7 | R16C49[0][A] | u_top/u_manual/rd_ptr_0_s0/Q
6.030 | 1.439 | tNET | FF | 2 | R13C47[0][A] | u_top/u_manual/n4_s0/I1
6.600 | 0.570 | tINS | FR | 1 | R13C47[0][A] | u_top/u_manual/n4_s0/COUT
6.600 | 0.000 | tNET | RR | 2 | R13C47[0][B] | u_top/u_manual/n5_s0/CIN
6.635 | 0.035 | tINS | RF | 1 | R13C47[0][B] | u_top/u_manual/n5_s0/COUT
6.635 | 0.000 | tNET | FF | 2 | R13C47[1][A] | u_top/u_manual/n6_s0/CIN
6.670 | 0.035 | tINS | FF | 1 | R13C47[1][A] | u_top/u_manual/n6_s0/COUT
6.670 | 0.000 | tNET | FF | 2 | R13C47[1][B] | u_top/u_manual/n7_s0/CIN
6.706 | 0.035 | tINS | FF | 1 | R13C47[1][B] | u_top/u_manual/n7_s0/COUT
6.706 | 0.000 | tNET | FF | 2 | R13C47[2][A] | u_top/u_manual/n8_s0/CIN
6.741 | 0.035 | tINS | FF | 17 | R13C47[2][A] | u_top/u_manual/n8_s0/COUT
7.811 | 1.070 | tNET | FF | 1 | R14C48[3][B] | u_top/ev_word_13_s2/I2
8.366 | 0.555 | tINS | FF | 1 | R14C48[3][B] | u_top/ev_word_13_s2/F
9.277 | 0.911 | tNET | FF | 1 | R12C38[3][A] | u_top/ev_word_13_s1/I1
9.648 | 0.371 | tINS | FF | 3 | R12C38[3][A] | u_top/ev_word_13_s1/F
10.070 | 0.422 | tNET | FF | 1 | R9C38[3][A] | u_top/ev_word_13_s0/I0
10.523 | 0.453 | tINS | FF | 55 | R9C38[3][A] | u_top/ev_word_13_s0/F
14.971 | 4.448 | tNET | FF | 2 | R39C20[2][B] | u_top/u_alloc/n80_s0/I1
15.541 | 0.570 | tINS | FR | 1 | R39C20[2][B] | u_top/u_alloc/n80_s0/COUT
15.541 | 0.000 | tNET | RR | 2 | R39C21[0][A] | u_top/u_alloc/n81_s0/CIN
15.576 | 0.035 | tINS | RF | 2 | R39C21[0][A] | u_top/u_alloc/n81_s0/COUT
16.692 | 1.115 | tNET | FF | 1 | R43C21[2][A] | u_top/u_alloc/v_gate_3_s3/I0
17.209 | 0.517 | tINS | FF | 3 | R43C21[2][A] | u_top/u_alloc/v_gate_3_s3/F
17.879 | 0.671 | tNET | FF | 1 | R45C20[1][B] | u_top/u_alloc/pick_2_s146/I2
18.396 | 0.517 | tINS | FF | 3 | R45C20[1][B] | u_top/u_alloc/pick_2_s146/F
18.896 | 0.500 | tNET | FF | 1 | R47C18[0][A] | u_top/u_alloc/pick_0_s9/I2
19.451 | 0.555 | tINS | FF | 5 | R47C18[0][A] | u_top/u_alloc/pick_0_s9/F
20.195 | 0.744 | tNET | FF | 1 | R44C19[1][A] | u_top/u_alloc/pick_0_s3/I1
20.750 | 0.555 | tINS | FF | 8 | R44C19[1][A] | u_top/u_alloc/pick_0_s3/F
21.579 | 0.828 | tNET | FF | 1 | R42C17[3][A] | u_top/u_alloc/pick_2_s64/I0
21.950 | 0.371 | tINS | FF | 3 | R42C17[3][A] | u_top/u_alloc/pick_2_s64/F
23.469 | 1.519 | tNET | FF | 1 | R47C14[3][B] | u_top/u_alloc/pick_2_s52/I1
23.840 | 0.371 | tINS | FF | 1 | R47C14[3][B] | u_top/u_alloc/pick_2_s52/F
23.844 | 0.004 | tNET | FF | 1 | R47C14[3][A] | u_top/u_alloc/pick_2_s21/I3
24.361 | 0.517 | tINS | FF | 2 | R47C14[3][A] | u_top/u_alloc/pick_2_s21/F
25.051 | 0.690 | tNET | FF | 1 | R45C18[0][B] | u_top/u_alloc/pick_2_s6/I3
25.422 | 0.371 | tINS | FF | 4 | R45C18[0][B] | u_top/u_alloc/pick_2_s6/F
25.435 | 0.013 | tNET | FF | 1 | R45C18[2][B] | u_top/u_alloc/pick_2_s1/I1
25.990 | 0.555 | tINS | FF | 4 | R45C18[2][B] | u_top/u_alloc/pick_2_s1/F
27.213 | 1.222 | tNET | FF | 1 | R47C15[3][B] | u_top/u_alloc/pick_0_s2/I1
27.768 | 0.555 | tINS | FF | 9 | R47C15[3][B] | u_top/u_alloc/pick_0_s2/F
28.461 | 0.693 | tNET | FF | 1 | R42C16[3][B] | u_top/u_alloc/pick_0_s49/I3
28.978 | 0.517 | tINS | FF | 26 | R42C16[3][B] | u_top/u_alloc/pick_0_s49/F
30.318 | 1.340 | tNET | FF | 18 | DSP_R37[2][A] | u_top/u_alloc/n453_s1/B[0]
33.958 | 3.640 | tINS | FF | 8 | DSP_R37[2][A] | u_top/u_alloc/n453_s1/DOUT[6]
34.877 | 0.919 | tNET | FF | 1 | R41C21[3][A] | u_top/u_alloc/n3462_s2/I0
35.204 | 0.327 | tINS | FR | 7 | R41C21[3][A] | u_top/u_alloc/n3462_s2/F
35.542 | 0.339 | tNET | RR | 1 | R41C22[1][A] | u_top/u_alloc/v_note_15_s0/CE

Data Required Path:

AT | DELAY | TYPE | RF | FANOUT | LOC | NODE
37.037 | 37.037 | | | | | active clock edge time
37.037 | 0.000 | | | | | clk_27m
37.037 | 0.000 | tCL | RR | 1 | IOT27[A] | clk_27m_ibuf/I
39.125 | 2.088 | tINS | RR | 3747 | IOT27[A] | clk_27m_ibuf/O
41.396 | 2.271 | tNET | RR | 1 | R41C22[1][A] | u_top/u_alloc/v_note_15_s0/CLK
41.361 | -0.035 | tSu | | 1 | R41C22[1][A] | u_top/u_alloc/v_note_15_s0

Path Statistics:

Clock Skew | 0.000
Setup Relationship | 37.037
Logic Level | 21
Arrival Clock Path Delay | cell: 2.088, 47.897%; route: 2.271, 52.103%
Arrival Data Path Delay | cell: 12.063, 38.684%; route: 18.888, 60.572%; tC2Q: 0.232, 0.744%
Required Clock Path Delay | cell: 2.088, 47.897%; route: 2.271, 52.103%

### Path25

Path Summary:

Slack | 5.819
Data Arrival Time | 35.542
Data Required Time | 41.361
From | u_top/u_manual/rd_ptr_0_s0
To | u_top/u_alloc/v_note_16_s0
Launch Clk | clk_27m:[R]
Latch Clk | clk_27m:[R]

Data Arrival Path:

AT | DELAY | TYPE | RF | FANOUT | LOC | NODE
0.000 | 0.000 | | | | | active clock edge time
0.000 | 0.000 | | | | | clk_27m
0.000 | 0.000 | tCL | RR | 1 | IOT27[A] | clk_27m_ibuf/I
2.088 | 2.088 | tINS | RR | 3747 | IOT27[A] | clk_27m_ibuf/O
4.359 | 2.271 | tNET | RR | 1 | R16C49[0][A] | u_top/u_manual/rd_ptr_0_s0/CLK
4.591 | 0.232 | tC2Q | RF | 7 | R16C49[0][A] | u_top/u_manual/rd_ptr_0_s0/Q
6.030 | 1.439 | tNET | FF | 2 | R13C47[0][A] | u_top/u_manual/n4_s0/I1
6.600 | 0.570 | tINS | FR | 1 | R13C47[0][A] | u_top/u_manual/n4_s0/COUT
6.600 | 0.000 | tNET | RR | 2 | R13C47[0][B] | u_top/u_manual/n5_s0/CIN
6.635 | 0.035 | tINS | RF | 1 | R13C47[0][B] | u_top/u_manual/n5_s0/COUT
6.635 | 0.000 | tNET | FF | 2 | R13C47[1][A] | u_top/u_manual/n6_s0/CIN
6.670 | 0.035 | tINS | FF | 1 | R13C47[1][A] | u_top/u_manual/n6_s0/COUT
6.670 | 0.000 | tNET | FF | 2 | R13C47[1][B] | u_top/u_manual/n7_s0/CIN
6.706 | 0.035 | tINS | FF | 1 | R13C47[1][B] | u_top/u_manual/n7_s0/COUT
6.706 | 0.000 | tNET | FF | 2 | R13C47[2][A] | u_top/u_manual/n8_s0/CIN
6.741 | 0.035 | tINS | FF | 17 | R13C47[2][A] | u_top/u_manual/n8_s0/COUT
7.811 | 1.070 | tNET | FF | 1 | R14C48[3][B] | u_top/ev_word_13_s2/I2
8.366 | 0.555 | tINS | FF | 1 | R14C48[3][B] | u_top/ev_word_13_s2/F
9.277 | 0.911 | tNET | FF | 1 | R12C38[3][A] | u_top/ev_word_13_s1/I1
9.648 | 0.371 | tINS | FF | 3 | R12C38[3][A] | u_top/ev_word_13_s1/F
10.070 | 0.422 | tNET | FF | 1 | R9C38[3][A] | u_top/ev_word_13_s0/I0
10.523 | 0.453 | tINS | FF | 55 | R9C38[3][A] | u_top/ev_word_13_s0/F
14.971 | 4.448 | tNET | FF | 2 | R39C20[2][B] | u_top/u_alloc/n80_s0/I1
15.541 | 0.570 | tINS | FR | 1 | R39C20[2][B] | u_top/u_alloc/n80_s0/COUT
15.541 | 0.000 | tNET | RR | 2 | R39C21[0][A] | u_top/u_alloc/n81_s0/CIN
15.576 | 0.035 | tINS | RF | 2 | R39C21[0][A] | u_top/u_alloc/n81_s0/COUT
16.692 | 1.115 | tNET | FF | 1 | R43C21[2][A] | u_top/u_alloc/v_gate_3_s3/I0
17.209 | 0.517 | tINS | FF | 3 | R43C21[2][A] | u_top/u_alloc/v_gate_3_s3/F
17.879 | 0.671 | tNET | FF | 1 | R45C20[1][B] | u_top/u_alloc/pick_2_s146/I2
18.396 | 0.517 | tINS | FF | 3 | R45C20[1][B] | u_top/u_alloc/pick_2_s146/F
18.896 | 0.500 | tNET | FF | 1 | R47C18[0][A] | u_top/u_alloc/pick_0_s9/I2
19.451 | 0.555 | tINS | FF | 5 | R47C18[0][A] | u_top/u_alloc/pick_0_s9/F
20.195 | 0.744 | tNET | FF | 1 | R44C19[1][A] | u_top/u_alloc/pick_0_s3/I1
20.750 | 0.555 | tINS | FF | 8 | R44C19[1][A] | u_top/u_alloc/pick_0_s3/F
21.579 | 0.828 | tNET | FF | 1 | R42C17[3][A] | u_top/u_alloc/pick_2_s64/I0
21.950 | 0.371 | tINS | FF | 3 | R42C17[3][A] | u_top/u_alloc/pick_2_s64/F
23.469 | 1.519 | tNET | FF | 1 | R47C14[3][B] | u_top/u_alloc/pick_2_s52/I1
23.840 | 0.371 | tINS | FF | 1 | R47C14[3][B] | u_top/u_alloc/pick_2_s52/F
23.844 | 0.004 | tNET | FF | 1 | R47C14[3][A] | u_top/u_alloc/pick_2_s21/I3
24.361 | 0.517 | tINS | FF | 2 | R47C14[3][A] | u_top/u_alloc/pick_2_s21/F
25.051 | 0.690 | tNET | FF | 1 | R45C18[0][B] | u_top/u_alloc/pick_2_s6/I3
25.422 | 0.371 | tINS | FF | 4 | R45C18[0][B] | u_top/u_alloc/pick_2_s6/F
25.435 | 0.013 | tNET | FF | 1 | R45C18[2][B] | u_top/u_alloc/pick_2_s1/I1
25.990 | 0.555 | tINS | FF | 4 | R45C18[2][B] | u_top/u_alloc/pick_2_s1/F
27.213 | 1.222 | tNET | FF | 1 | R47C15[3][B] | u_top/u_alloc/pick_0_s2/I1
27.768 | 0.555 | tINS | FF | 9 | R47C15[3][B] | u_top/u_alloc/pick_0_s2/F
28.461 | 0.693 | tNET | FF | 1 | R42C16[3][B] | u_top/u_alloc/pick_0_s49/I3
28.978 | 0.517 | tINS | FF | 26 | R42C16[3][B] | u_top/u_alloc/pick_0_s49/F
30.318 | 1.340 | tNET | FF | 18 | DSP_R37[2][A] | u_top/u_alloc/n453_s1/B[0]
33.958 | 3.640 | tINS | FF | 8 | DSP_R37[2][A] | u_top/u_alloc/n453_s1/DOUT[6]
34.877 | 0.919 | tNET | FF | 1 | R41C21[3][A] | u_top/u_alloc/n3462_s2/I0
35.204 | 0.327 | tINS | FR | 7 | R41C21[3][A] | u_top/u_alloc/n3462_s2/F
35.542 | 0.339 | tNET | RR | 1 | R41C22[0][A] | u_top/u_alloc/v_note_16_s0/CE

Data Required Path:

AT | DELAY | TYPE | RF | FANOUT | LOC | NODE
37.037 | 37.037 | | | | | active clock edge time
37.037 | 0.000 | | | | | clk_27m
37.037 | 0.000 | tCL | RR | 1 | IOT27[A] | clk_27m_ibuf/I
39.125 | 2.088 | tINS | RR | 3747 | IOT27[A] | clk_27m_ibuf/O
41.396 | 2.271 | tNET | RR | 1 | R41C22[0][A] | u_top/u_alloc/v_note_16_s0/CLK
41.361 | -0.035 | tSu | | 1 | R41C22[0][A] | u_top/u_alloc/v_note_16_s0

Path Statistics:

Clock Skew | 0.000
Setup Relationship | 37.037
Logic Level | 21
Arrival Clock Path Delay | cell: 2.088, 47.897%; route: 2.271, 52.103%
Arrival Data Path Delay | cell: 12.063, 38.684%; route: 18.888, 60.572%; tC2Q: 0.232, 0.744%
Required Clock Path Delay | cell: 2.088, 47.897%; route: 2.271, 52.103%

### Hold Analysis Report

#### Report Command:report_timing -hold -max_paths 25 -max_common_paths 1

### Path1

Path Summary:

Slack | 0.214
Data Arrival Time | 3.235
Data Required Time | 3.021
From | u_top/u_engine/rom_addr_1_s0
To | u_top/u_engine/g_banked.g_generic.g_guitar.u_guitar_rom/gg4
Launch Clk | clk_27m:[R]
Latch Clk | clk_27m:[R]

Data Arrival Path:

AT | DELAY | TYPE | RF | FANOUT | LOC | NODE
0.000 | 0.000 | | | | | active clock edge time
0.000 | 0.000 | | | | | clk_27m
0.000 | 0.000 | tCL | RR | 1 | IOT27[A] | clk_27m_ibuf/I
1.392 | 1.392 | tINS | RR | 3747 | IOT27[A] | clk_27m_ibuf/O
2.903 | 1.511 | tNET | RR | 1 | R29C12[0][B] | u_top/u_engine/rom_addr_1_s0/CLK
3.104 | 0.201 | tC2Q | RF | 40 | R29C12[0][B] | u_top/u_engine/rom_addr_1_s0/Q
3.235 | 0.131 | tNET | FF | 1 | BSRAM_R28[3] | u_top/u_engine/g_banked.g_generic.g_guitar.u_guitar_rom/gg4/AD[5]

Data Required Path:

AT | DELAY | TYPE | RF | FANOUT | LOC | NODE
0.000 | 0.000 | | | | | active clock edge time
0.000 | 0.000 | | | | | clk_27m
0.000 | 0.000 | tCL | RR | 1 | IOT27[A] | clk_27m_ibuf/I
1.392 | 1.392 | tINS | RR | 3747 | IOT27[A] | clk_27m_ibuf/O
2.903 | 1.511 | tNET | RR | 1 | BSRAM_R28[3] | u_top/u_engine/g_banked.g_generic.g_guitar.u_guitar_rom/gg4/CLK
3.021 | 0.118 | tHld | | 1 | BSRAM_R28[3] | u_top/u_engine/g_banked.g_generic.g_guitar.u_guitar_rom/gg4

Path Statistics:

Clock Skew | 0.000
Hold Relationship | 0.000
Logic Level | 1
Arrival Clock Path Delay | cell: 1.392, 47.946%; route: 1.511, 52.054%
Arrival Data Path Delay | cell: 0.000, 0.000%; route: 0.131, 39.420%; tC2Q: 0.201, 60.580%
Required Clock Path Delay | cell: 1.392, 47.946%; route: 1.511, 52.054%

### Path2

Path Summary:

Slack | 0.319
Data Arrival Time | 3.233
Data Required Time | 2.913
From | u_top/u_engine/vsel_0_s0
To | u_top/u_engine/phase_v[0]_phase_v[0]_0_2_s
Launch Clk | clk_27m:[R]
Latch Clk | clk_27m:[R]

Data Arrival Path:

AT | DELAY | TYPE | RF | FANOUT | LOC | NODE
0.000 | 0.000 | | | | | active clock edge time
0.000 | 0.000 | | | | | clk_27m
0.000 | 0.000 | tCL | RR | 1 | IOT27[A] | clk_27m_ibuf/I
1.392 | 1.392 | tINS | RR | 3747 | IOT27[A] | clk_27m_ibuf/O
2.903 | 1.511 | tNET | RR | 1 | R34C10[1][B] | u_top/u_engine/vsel_0_s0/CLK
3.104 | 0.201 | tC2Q | RF | 222 | R34C10[1][B] | u_top/u_engine/vsel_0_s0/Q
3.233 | 0.128 | tNET | FF | 1 | R33C10 | u_top/u_engine/phase_v[0]_phase_v[0]_0_2_s/AD[0]

Data Required Path:

AT | DELAY | TYPE | RF | FANOUT | LOC | NODE
0.000 | 0.000 | | | | | active clock edge time
0.000 | 0.000 | | | | | clk_27m
0.000 | 0.000 | tCL | RR | 1 | IOT27[A] | clk_27m_ibuf/I
1.392 | 1.392 | tINS | RR | 3747 | IOT27[A] | clk_27m_ibuf/O
2.903 | 1.511 | tNET | RR | 1 | R33C10 | u_top/u_engine/phase_v[0]_phase_v[0]_0_2_s/CLK
2.913 | 0.010 | tHld | | 1 | R33C10 | u_top/u_engine/phase_v[0]_phase_v[0]_0_2_s

Path Statistics:

Clock Skew | 0.000
Hold Relationship | 0.000
Logic Level | 1
Arrival Clock Path Delay | cell: 1.392, 47.946%; route: 1.511, 52.054%
Arrival Data Path Delay | cell: 0.000, 0.000%; route: 0.128, 38.990%; tC2Q: 0.201, 61.010%
Required Clock Path Delay | cell: 1.392, 47.946%; route: 1.511, 52.054%

### Path3

Path Summary:

Slack | 0.327
Data Arrival Time | 3.241
Data Required Time | 2.914
From | u_top/u_engine/sums_valid_s0
To | u_top/u_xf/saved_bright_14_s0
Launch Clk | clk_27m:[R]
Latch Clk | clk_27m:[R]

Data Arrival Path:

AT | DELAY | TYPE | RF | FANOUT | LOC | NODE
0.000 | 0.000 | | | | | active clock edge time
0.000 | 0.000 | | | | | clk_27m
0.000 | 0.000 | tCL | RR | 1 | IOT27[A] | clk_27m_ibuf/I
1.392 | 1.392 | tINS | RR | 3747 | IOT27[A] | clk_27m_ibuf/O
2.903 | 1.511 | tNET | RR | 1 | R8C21[1][A] | u_top/u_engine/sums_valid_s0/CLK
3.105 | 0.202 | tC2Q | RR | 59 | R8C21[1][A] | u_top/u_engine/sums_valid_s0/Q
3.241 | 0.136 | tNET | RR | 1 | R8C21[2][B] | u_top/u_xf/saved_bright_14_s0/CE

Data Required Path:

AT | DELAY | TYPE | RF | FANOUT | LOC | NODE
0.000 | 0.000 | | | | | active clock edge time
0.000 | 0.000 | | | | | clk_27m
0.000 | 0.000 | tCL | RR | 1 | IOT27[A] | clk_27m_ibuf/I
1.392 | 1.392 | tINS | RR | 3747 | IOT27[A] | clk_27m_ibuf/O
2.903 | 1.511 | tNET | RR | 1 | R8C21[2][B] | u_top/u_xf/saved_bright_14_s0/CLK
2.914 | 0.011 | tHld | | 1 | R8C21[2][B] | u_top/u_xf/saved_bright_14_s0

Path Statistics:

Clock Skew | 0.000
Hold Relationship | 0.000
Logic Level | 1
Arrival Clock Path Delay | cell: 1.392, 47.946%; route: 1.511, 52.054%
Arrival Data Path Delay | cell: 0.000, 0.000%; route: 0.136, 40.206%; tC2Q: 0.202, 59.794%
Required Clock Path Delay | cell: 1.392, 47.946%; route: 1.511, 52.054%

### Path4

Path Summary:

Slack | 0.327
Data Arrival Time | 3.241
Data Required Time | 2.914
From | u_top/u_engine/sums_valid_s0
To | u_top/u_xf/saved_sine_16_s0
Launch Clk | clk_27m:[R]
Latch Clk | clk_27m:[R]

Data Arrival Path:

AT | DELAY | TYPE | RF | FANOUT | LOC | NODE
0.000 | 0.000 | | | | | active clock edge time
0.000 | 0.000 | | | | | clk_27m
0.000 | 0.000 | tCL | RR | 1 | IOT27[A] | clk_27m_ibuf/I
1.392 | 1.392 | tINS | RR | 3747 | IOT27[A] | clk_27m_ibuf/O
2.903 | 1.511 | tNET | RR | 1 | R8C21[1][A] | u_top/u_engine/sums_valid_s0/CLK
3.105 | 0.202 | tC2Q | RR | 59 | R8C21[1][A] | u_top/u_engine/sums_valid_s0/Q
3.241 | 0.136 | tNET | RR | 1 | R8C21[0][A] | u_top/u_xf/saved_sine_16_s0/CE

Data Required Path:

AT | DELAY | TYPE | RF | FANOUT | LOC | NODE
0.000 | 0.000 | | | | | active clock edge time
0.000 | 0.000 | | | | | clk_27m
0.000 | 0.000 | tCL | RR | 1 | IOT27[A] | clk_27m_ibuf/I
1.392 | 1.392 | tINS | RR | 3747 | IOT27[A] | clk_27m_ibuf/O
2.903 | 1.511 | tNET | RR | 1 | R8C21[0][A] | u_top/u_xf/saved_sine_16_s0/CLK
2.914 | 0.011 | tHld | | 1 | R8C21[0][A] | u_top/u_xf/saved_sine_16_s0

Path Statistics:

Clock Skew | 0.000
Hold Relationship | 0.000
Logic Level | 1
Arrival Clock Path Delay | cell: 1.392, 47.946%; route: 1.511, 52.054%
Arrival Data Path Delay | cell: 0.000, 0.000%; route: 0.136, 40.206%; tC2Q: 0.202, 59.794%
Required Clock Path Delay | cell: 1.392, 47.946%; route: 1.511, 52.054%

### Path5

Path Summary:

Slack | 0.327
Data Arrival Time | 3.241
Data Required Time | 2.914
From | u_top/u_engine/sums_valid_s0
To | u_top/u_xf/saved_sine_17_s0
Launch Clk | clk_27m:[R]
Latch Clk | clk_27m:[R]

Data Arrival Path:

AT | DELAY | TYPE | RF | FANOUT | LOC | NODE
0.000 | 0.000 | | | | | active clock edge time
0.000 | 0.000 | | | | | clk_27m
0.000 | 0.000 | tCL | RR | 1 | IOT27[A] | clk_27m_ibuf/I
1.392 | 1.392 | tINS | RR | 3747 | IOT27[A] | clk_27m_ibuf/O
2.903 | 1.511 | tNET | RR | 1 | R8C21[1][A] | u_top/u_engine/sums_valid_s0/CLK
3.105 | 0.202 | tC2Q | RR | 59 | R8C21[1][A] | u_top/u_engine/sums_valid_s0/Q
3.241 | 0.136 | tNET | RR | 1 | R8C21[0][B] | u_top/u_xf/saved_sine_17_s0/CE

Data Required Path:

AT | DELAY | TYPE | RF | FANOUT | LOC | NODE
0.000 | 0.000 | | | | | active clock edge time
0.000 | 0.000 | | | | | clk_27m
0.000 | 0.000 | tCL | RR | 1 | IOT27[A] | clk_27m_ibuf/I
1.392 | 1.392 | tINS | RR | 3747 | IOT27[A] | clk_27m_ibuf/O
2.903 | 1.511 | tNET | RR | 1 | R8C21[0][B] | u_top/u_xf/saved_sine_17_s0/CLK
2.914 | 0.011 | tHld | | 1 | R8C21[0][B] | u_top/u_xf/saved_sine_17_s0

Path Statistics:

Clock Skew | 0.000
Hold Relationship | 0.000
Logic Level | 1
Arrival Clock Path Delay | cell: 1.392, 47.946%; route: 1.511, 52.054%
Arrival Data Path Delay | cell: 0.000, 0.000%; route: 0.136, 40.206%; tC2Q: 0.202, 59.794%
Required Clock Path Delay | cell: 1.392, 47.946%; route: 1.511, 52.054%

### Path6

Path Summary:

Slack | 0.332
Data Arrival Time | 3.353
Data Required Time | 3.021
From | u_top/u_engine/rom_addr_6_s0
To | u_top/u_engine/g_banked.g_generic.u_bright_rom/u_bank0
Launch Clk | clk_27m:[R]
Latch Clk | clk_27m:[R]

Data Arrival Path:

AT | DELAY | TYPE | RF | FANOUT | LOC | NODE
0.000 | 0.000 | | | | | active clock edge time
0.000 | 0.000 | | | | | clk_27m
0.000 | 0.000 | tCL | RR | 1 | IOT27[A] | clk_27m_ibuf/I
1.392 | 1.392 | tINS | RR | 3747 | IOT27[A] | clk_27m_ibuf/O
2.903 | 1.511 | tNET | RR | 1 | R29C13[1][B] | u_top/u_engine/rom_addr_6_s0/CLK
3.105 | 0.202 | tC2Q | RR | 40 | R29C13[1][B] | u_top/u_engine/rom_addr_6_s0/Q
3.353 | 0.248 | tNET | RR | 1 | BSRAM_R28[4] | u_top/u_engine/g_banked.g_generic.u_bright_rom/u_bank0/AD[10]

Data Required Path:

AT | DELAY | TYPE | RF | FANOUT | LOC | NODE
0.000 | 0.000 | | | | | active clock edge time
0.000 | 0.000 | | | | | clk_27m
0.000 | 0.000 | tCL | RR | 1 | IOT27[A] | clk_27m_ibuf/I
1.392 | 1.392 | tINS | RR | 3747 | IOT27[A] | clk_27m_ibuf/O
2.903 | 1.511 | tNET | RR | 1 | BSRAM_R28[4] | u_top/u_engine/g_banked.g_generic.u_bright_rom/u_bank0/CLK
3.021 | 0.118 | tHld | | 1 | BSRAM_R28[4] | u_top/u_engine/g_banked.g_generic.u_bright_rom/u_bank0

Path Statistics:

Clock Skew | 0.000
Hold Relationship | 0.000
Logic Level | 1
Arrival Clock Path Delay | cell: 1.392, 47.946%; route: 1.511, 52.054%
Arrival Data Path Delay | cell: 0.000, 0.000%; route: 0.248, 55.133%; tC2Q: 0.202, 44.867%
Required Clock Path Delay | cell: 1.392, 47.946%; route: 1.511, 52.054%

### Path7

Path Summary:

Slack | 0.347
Data Arrival Time | 3.368
Data Required Time | 3.021
From | u_top/u_engine/rom_addr_0_s0
To | u_top/u_engine/g_banked.g_generic.g_guitar.u_guitar_rom/gg4
Launch Clk | clk_27m:[R]
Latch Clk | clk_27m:[R]

Data Arrival Path:

AT | DELAY | TYPE | RF | FANOUT | LOC | NODE
0.000 | 0.000 | | | | | active clock edge time
0.000 | 0.000 | | | | | clk_27m
0.000 | 0.000 | tCL | RR | 1 | IOT27[A] | clk_27m_ibuf/I
1.392 | 1.392 | tINS | RR | 3747 | IOT27[A] | clk_27m_ibuf/O
2.903 | 1.511 | tNET | RR | 1 | R27C13[0][B] | u_top/u_engine/rom_addr_0_s0/CLK
3.105 | 0.202 | tC2Q | RR | 40 | R27C13[0][B] | u_top/u_engine/rom_addr_0_s0/Q
3.368 | 0.263 | tNET | RR | 1 | BSRAM_R28[3] | u_top/u_engine/g_banked.g_generic.g_guitar.u_guitar_rom/gg4/AD[4]

Data Required Path:

AT | DELAY | TYPE | RF | FANOUT | LOC | NODE
0.000 | 0.000 | | | | | active clock edge time
0.000 | 0.000 | | | | | clk_27m
0.000 | 0.000 | tCL | RR | 1 | IOT27[A] | clk_27m_ibuf/I
1.392 | 1.392 | tINS | RR | 3747 | IOT27[A] | clk_27m_ibuf/O
2.903 | 1.511 | tNET | RR | 1 | BSRAM_R28[3] | u_top/u_engine/g_banked.g_generic.g_guitar.u_guitar_rom/gg4/CLK
3.021 | 0.118 | tHld | | 1 | BSRAM_R28[3] | u_top/u_engine/g_banked.g_generic.g_guitar.u_guitar_rom/gg4

Path Statistics:

Clock Skew | 0.000
Hold Relationship | 0.000
Logic Level | 1
Arrival Clock Path Delay | cell: 1.392, 47.946%; route: 1.511, 52.054%
Arrival Data Path Delay | cell: 0.000, 0.000%; route: 0.263, 56.538%; tC2Q: 0.202, 43.462%
Required Clock Path Delay | cell: 1.392, 47.946%; route: 1.511, 52.054%

### Path8

Path Summary:

Slack | 0.347
Data Arrival Time | 3.369
Data Required Time | 3.021
From | u_top/u_engine/rom_addr_3_s0
To | u_top/u_engine/g_banked.g_generic.u_bright_rom/u_bank0
Launch Clk | clk_27m:[R]
Latch Clk | clk_27m:[R]

Data Arrival Path:

AT | DELAY | TYPE | RF | FANOUT | LOC | NODE
0.000 | 0.000 | | | | | active clock edge time
0.000 | 0.000 | | | | | clk_27m
0.000 | 0.000 | tCL | RR | 1 | IOT27[A] | clk_27m_ibuf/I
1.392 | 1.392 | tINS | RR | 3747 | IOT27[A] | clk_27m_ibuf/O
2.903 | 1.511 | tNET | RR | 1 | R29C13[0][B] | u_top/u_engine/rom_addr_3_s0/CLK
3.105 | 0.202 | tC2Q | RR | 40 | R29C13[0][B] | u_top/u_engine/rom_addr_3_s0/Q
3.369 | 0.263 | tNET | RR | 1 | BSRAM_R28[4] | u_top/u_engine/g_banked.g_generic.u_bright_rom/u_bank0/AD[7]

Data Required Path:

AT | DELAY | TYPE | RF | FANOUT | LOC | NODE
0.000 | 0.000 | | | | | active clock edge time
0.000 | 0.000 | | | | | clk_27m
0.000 | 0.000 | tCL | RR | 1 | IOT27[A] | clk_27m_ibuf/I
1.392 | 1.392 | tINS | RR | 3747 | IOT27[A] | clk_27m_ibuf/O
2.903 | 1.511 | tNET | RR | 1 | BSRAM_R28[4] | u_top/u_engine/g_banked.g_generic.u_bright_rom/u_bank0/CLK
3.021 | 0.118 | tHld | | 1 | BSRAM_R28[4] | u_top/u_engine/g_banked.g_generic.u_bright_rom/u_bank0

Path Statistics:

Clock Skew | 0.000
Hold Relationship | 0.000
Logic Level | 1
Arrival Clock Path Delay | cell: 1.392, 47.946%; route: 1.511, 52.054%
Arrival Data Path Delay | cell: 0.000, 0.000%; route: 0.263, 56.595%; tC2Q: 0.202, 43.405%
Required Clock Path Delay | cell: 1.392, 47.946%; route: 1.511, 52.054%

### Path9

Path Summary:

Slack | 0.348
Data Arrival Time | 3.369
Data Required Time | 3.021
From | u_top/u_engine/rom_addr_4_s0
To | u_top/u_engine/g_banked.g_generic.u_bright_rom/u_bank0
Launch Clk | clk_27m:[R]
Latch Clk | clk_27m:[R]

Data Arrival Path:

AT | DELAY | TYPE | RF | FANOUT | LOC | NODE
0.000 | 0.000 | | | | | active clock edge time
0.000 | 0.000 | | | | | clk_27m
0.000 | 0.000 | tCL | RR | 1 | IOT27[A] | clk_27m_ibuf/I
1.392 | 1.392 | tINS | RR | 3747 | IOT27[A] | clk_27m_ibuf/O
2.903 | 1.511 | tNET | RR | 1 | R29C13[0][A] | u_top/u_engine/rom_addr_4_s0/CLK
3.105 | 0.202 | tC2Q | RR | 40 | R29C13[0][A] | u_top/u_engine/rom_addr_4_s0/Q
3.369 | 0.264 | tNET | RR | 1 | BSRAM_R28[4] | u_top/u_engine/g_banked.g_generic.u_bright_rom/u_bank0/AD[8]

Data Required Path:

AT | DELAY | TYPE | RF | FANOUT | LOC | NODE
0.000 | 0.000 | | | | | active clock edge time
0.000 | 0.000 | | | | | clk_27m
0.000 | 0.000 | tCL | RR | 1 | IOT27[A] | clk_27m_ibuf/I
1.392 | 1.392 | tINS | RR | 3747 | IOT27[A] | clk_27m_ibuf/O
2.903 | 1.511 | tNET | RR | 1 | BSRAM_R28[4] | u_top/u_engine/g_banked.g_generic.u_bright_rom/u_bank0/CLK
3.021 | 0.118 | tHld | | 1 | BSRAM_R28[4] | u_top/u_engine/g_banked.g_generic.u_bright_rom/u_bank0

Path Statistics:

Clock Skew | 0.000
Hold Relationship | 0.000
Logic Level | 1
Arrival Clock Path Delay | cell: 1.392, 47.946%; route: 1.511, 52.054%
Arrival Data Path Delay | cell: 0.000, 0.000%; route: 0.264, 56.647%; tC2Q: 0.202, 43.353%
Required Clock Path Delay | cell: 1.392, 47.946%; route: 1.511, 52.054%

### Path10

Path Summary:

Slack | 0.349
Data Arrival Time | 3.370
Data Required Time | 3.021
From | u_top/u_engine/rom_addr_2_s0
To | u_top/u_engine/g_banked.g_generic.u_bright_rom/u_bank0
Launch Clk | clk_27m:[R]
Latch Clk | clk_27m:[R]

Data Arrival Path:

AT | DELAY | TYPE | RF | FANOUT | LOC | NODE
0.000 | 0.000 | | | | | active clock edge time
0.000 | 0.000 | | | | | clk_27m
0.000 | 0.000 | tCL | RR | 1 | IOT27[A] | clk_27m_ibuf/I
1.392 | 1.392 | tINS | RR | 3747 | IOT27[A] | clk_27m_ibuf/O
2.903 | 1.511 | tNET | RR | 1 | R29C13[1][A] | u_top/u_engine/rom_addr_2_s0/CLK
3.105 | 0.202 | tC2Q | RR | 40 | R29C13[1][A] | u_top/u_engine/rom_addr_2_s0/Q
3.370 | 0.265 | tNET | RR | 1 | BSRAM_R28[4] | u_top/u_engine/g_banked.g_generic.u_bright_rom/u_bank0/AD[6]

Data Required Path:

AT | DELAY | TYPE | RF | FANOUT | LOC | NODE
0.000 | 0.000 | | | | | active clock edge time
0.000 | 0.000 | | | | | clk_27m
0.000 | 0.000 | tCL | RR | 1 | IOT27[A] | clk_27m_ibuf/I
1.392 | 1.392 | tINS | RR | 3747 | IOT27[A] | clk_27m_ibuf/O
2.903 | 1.511 | tNET | RR | 1 | BSRAM_R28[4] | u_top/u_engine/g_banked.g_generic.u_bright_rom/u_bank0/CLK
3.021 | 0.118 | tHld | | 1 | BSRAM_R28[4] | u_top/u_engine/g_banked.g_generic.u_bright_rom/u_bank0

Path Statistics:

Clock Skew | 0.000
Hold Relationship | 0.000
Logic Level | 1
Arrival Clock Path Delay | cell: 1.392, 47.946%; route: 1.511, 52.054%
Arrival Data Path Delay | cell: 0.000, 0.000%; route: 0.265, 56.704%; tC2Q: 0.202, 43.296%
Required Clock Path Delay | cell: 1.392, 47.946%; route: 1.511, 52.054%

### Path11

Path Summary:

Slack | 0.350
Data Arrival Time | 3.371
Data Required Time | 3.021
From | u_top/u_engine/rom_addr_5_s0
To | u_top/u_engine/g_banked.g_generic.u_bright_rom/u_bank0
Launch Clk | clk_27m:[R]
Latch Clk | clk_27m:[R]

Data Arrival Path:

AT | DELAY | TYPE | RF | FANOUT | LOC | NODE
0.000 | 0.000 | | | | | active clock edge time
0.000 | 0.000 | | | | | clk_27m
0.000 | 0.000 | tCL | RR | 1 | IOT27[A] | clk_27m_ibuf/I
1.392 | 1.392 | tINS | RR | 3747 | IOT27[A] | clk_27m_ibuf/O
2.903 | 1.511 | tNET | RR | 1 | R30C13[0][B] | u_top/u_engine/rom_addr_5_s0/CLK
3.105 | 0.202 | tC2Q | RR | 40 | R30C13[0][B] | u_top/u_engine/rom_addr_5_s0/Q
3.371 | 0.266 | tNET | RR | 1 | BSRAM_R28[4] | u_top/u_engine/g_banked.g_generic.u_bright_rom/u_bank0/AD[9]

Data Required Path:

AT | DELAY | TYPE | RF | FANOUT | LOC | NODE
0.000 | 0.000 | | | | | active clock edge time
0.000 | 0.000 | | | | | clk_27m
0.000 | 0.000 | tCL | RR | 1 | IOT27[A] | clk_27m_ibuf/I
1.392 | 1.392 | tINS | RR | 3747 | IOT27[A] | clk_27m_ibuf/O
2.903 | 1.511 | tNET | RR | 1 | BSRAM_R28[4] | u_top/u_engine/g_banked.g_generic.u_bright_rom/u_bank0/CLK
3.021 | 0.118 | tHld | | 1 | BSRAM_R28[4] | u_top/u_engine/g_banked.g_generic.u_bright_rom/u_bank0

Path Statistics:

Clock Skew | 0.000
Hold Relationship | 0.000
Logic Level | 1
Arrival Clock Path Delay | cell: 1.392, 47.946%; route: 1.511, 52.054%
Arrival Data Path Delay | cell: 0.000, 0.000%; route: 0.266, 56.817%; tC2Q: 0.202, 43.183%
Required Clock Path Delay | cell: 1.392, 47.946%; route: 1.511, 52.054%

### Path12

Path Summary:

Slack | 0.352
Data Arrival Time | 3.373
Data Required Time | 3.021
From | u_top/u_engine/rom_bank_0_s0
To | u_top/u_engine/g_banked.g_generic.g_guitar.u_guitar_rom/gg8
Launch Clk | clk_27m:[R]
Latch Clk | clk_27m:[R]

Data Arrival Path:

AT | DELAY | TYPE | RF | FANOUT | LOC | NODE
0.000 | 0.000 | | | | | active clock edge time
0.000 | 0.000 | | | | | clk_27m
0.000 | 0.000 | tCL | RR | 1 | IOT27[A] | clk_27m_ibuf/I
1.392 | 1.392 | tINS | RR | 3747 | IOT27[A] | clk_27m_ibuf/O
2.903 | 1.511 | tNET | RR | 1 | R13C18[0][A] | u_top/u_engine/rom_bank_0_s0/CLK
3.105 | 0.202 | tC2Q | RR | 39 | R13C18[0][A] | u_top/u_engine/rom_bank_0_s0/Q
3.373 | 0.268 | tNET | RR | 1 | BSRAM_R10[4] | u_top/u_engine/g_banked.g_generic.g_guitar.u_guitar_rom/gg8/AD[13]

Data Required Path:

AT | DELAY | TYPE | RF | FANOUT | LOC | NODE
0.000 | 0.000 | | | | | active clock edge time
0.000 | 0.000 | | | | | clk_27m
0.000 | 0.000 | tCL | RR | 1 | IOT27[A] | clk_27m_ibuf/I
1.392 | 1.392 | tINS | RR | 3747 | IOT27[A] | clk_27m_ibuf/O
2.903 | 1.511 | tNET | RR | 1 | BSRAM_R10[4] | u_top/u_engine/g_banked.g_generic.g_guitar.u_guitar_rom/gg8/CLK
3.021 | 0.118 | tHld | | 1 | BSRAM_R10[4] | u_top/u_engine/g_banked.g_generic.g_guitar.u_guitar_rom/gg8

Path Statistics:

Clock Skew | 0.000
Hold Relationship | 0.000
Logic Level | 1
Arrival Clock Path Delay | cell: 1.392, 47.946%; route: 1.511, 52.054%
Arrival Data Path Delay | cell: 0.000, 0.000%; route: 0.268, 56.981%; tC2Q: 0.202, 43.019%
Required Clock Path Delay | cell: 1.392, 47.946%; route: 1.511, 52.054%

### Path13

Path Summary:

Slack | 0.353
Data Arrival Time | 3.374
Data Required Time | 3.021
From | u_top/u_engine/rom_addr_7_s0
To | u_top/u_engine/g_banked.g_generic.u_bright_rom/u_bank0
Launch Clk | clk_27m:[R]
Latch Clk | clk_27m:[R]

Data Arrival Path:

AT | DELAY | TYPE | RF | FANOUT | LOC | NODE
0.000 | 0.000 | | | | | active clock edge time
0.000 | 0.000 | | | | | clk_27m
0.000 | 0.000 | tCL | RR | 1 | IOT27[A] | clk_27m_ibuf/I
1.392 | 1.392 | tINS | RR | 3747 | IOT27[A] | clk_27m_ibuf/O
2.903 | 1.511 | tNET | RR | 1 | R30C13[0][A] | u_top/u_engine/rom_addr_7_s0/CLK
3.105 | 0.202 | tC2Q | RR | 40 | R30C13[0][A] | u_top/u_engine/rom_addr_7_s0/Q
3.374 | 0.269 | tNET | RR | 1 | BSRAM_R28[4] | u_top/u_engine/g_banked.g_generic.u_bright_rom/u_bank0/AD[11]

Data Required Path:

AT | DELAY | TYPE | RF | FANOUT | LOC | NODE
0.000 | 0.000 | | | | | active clock edge time
0.000 | 0.000 | | | | | clk_27m
0.000 | 0.000 | tCL | RR | 1 | IOT27[A] | clk_27m_ibuf/I
1.392 | 1.392 | tINS | RR | 3747 | IOT27[A] | clk_27m_ibuf/O
2.903 | 1.511 | tNET | RR | 1 | BSRAM_R28[4] | u_top/u_engine/g_banked.g_generic.u_bright_rom/u_bank0/CLK
3.021 | 0.118 | tHld | | 1 | BSRAM_R28[4] | u_top/u_engine/g_banked.g_generic.u_bright_rom/u_bank0

Path Statistics:

Clock Skew | 0.000
Hold Relationship | 0.000
Logic Level | 1
Arrival Clock Path Delay | cell: 1.392, 47.946%; route: 1.511, 52.054%
Arrival Data Path Delay | cell: 0.000, 0.000%; route: 0.269, 57.087%; tC2Q: 0.202, 42.913%
Required Clock Path Delay | cell: 1.392, 47.946%; route: 1.511, 52.054%

### Path14

Path Summary:

Slack | 0.353
Data Arrival Time | 3.374
Data Required Time | 3.021
From | u_top/u_engine/rom_addr_8_s0
To | u_top/u_engine/g_banked.g_generic.g_guitar.u_guitar_rom/gg4
Launch Clk | clk_27m:[R]
Latch Clk | clk_27m:[R]

Data Arrival Path:

AT | DELAY | TYPE | RF | FANOUT | LOC | NODE
0.000 | 0.000 | | | | | active clock edge time
0.000 | 0.000 | | | | | clk_27m
0.000 | 0.000 | tCL | RR | 1 | IOT27[A] | clk_27m_ibuf/I
1.392 | 1.392 | tINS | RR | 3747 | IOT27[A] | clk_27m_ibuf/O
2.903 | 1.511 | tNET | RR | 1 | R30C13[2][A] | u_top/u_engine/rom_addr_8_s0/CLK
3.105 | 0.202 | tC2Q | RR | 40 | R30C13[2][A] | u_top/u_engine/rom_addr_8_s0/Q
3.374 | 0.269 | tNET | RR | 1 | BSRAM_R28[3] | u_top/u_engine/g_banked.g_generic.g_guitar.u_guitar_rom/gg4/AD[12]

Data Required Path:

AT | DELAY | TYPE | RF | FANOUT | LOC | NODE
0.000 | 0.000 | | | | | active clock edge time
0.000 | 0.000 | | | | | clk_27m
0.000 | 0.000 | tCL | RR | 1 | IOT27[A] | clk_27m_ibuf/I
1.392 | 1.392 | tINS | RR | 3747 | IOT27[A] | clk_27m_ibuf/O
2.903 | 1.511 | tNET | RR | 1 | BSRAM_R28[3] | u_top/u_engine/g_banked.g_generic.g_guitar.u_guitar_rom/gg4/CLK
3.021 | 0.118 | tHld | | 1 | BSRAM_R28[3] | u_top/u_engine/g_banked.g_generic.g_guitar.u_guitar_rom/gg4

Path Statistics:

Clock Skew | 0.000
Hold Relationship | 0.000
Logic Level | 1
Arrival Clock Path Delay | cell: 1.392, 47.946%; route: 1.511, 52.054%
Arrival Data Path Delay | cell: 0.000, 0.000%; route: 0.269, 57.092%; tC2Q: 0.202, 42.908%
Required Clock Path Delay | cell: 1.392, 47.946%; route: 1.511, 52.054%

### Path15

Path Summary:

Slack | 0.358
Data Arrival Time | 3.379
Data Required Time | 3.021
From | u_top/u_engine/rom_addr_8_s0
To | u_top/u_engine/g_banked.g_generic.u_bright_rom/u_bank2
Launch Clk | clk_27m:[R]
Latch Clk | clk_27m:[R]

Data Arrival Path:

AT | DELAY | TYPE | RF | FANOUT | LOC | NODE
0.000 | 0.000 | | | | | active clock edge time
0.000 | 0.000 | | | | | clk_27m
0.000 | 0.000 | tCL | RR | 1 | IOT27[A] | clk_27m_ibuf/I
1.392 | 1.392 | tINS | RR | 3747 | IOT27[A] | clk_27m_ibuf/O
2.903 | 1.511 | tNET | RR | 1 | R30C13[2][A] | u_top/u_engine/rom_addr_8_s0/CLK
3.105 | 0.202 | tC2Q | RR | 40 | R30C13[2][A] | u_top/u_engine/rom_addr_8_s0/Q
3.379 | 0.274 | tNET | RR | 1 | BSRAM_R28[6] | u_top/u_engine/g_banked.g_generic.u_bright_rom/u_bank2/AD[12]

Data Required Path:

AT | DELAY | TYPE | RF | FANOUT | LOC | NODE
0.000 | 0.000 | | | | | active clock edge time
0.000 | 0.000 | | | | | clk_27m
0.000 | 0.000 | tCL | RR | 1 | IOT27[A] | clk_27m_ibuf/I
1.392 | 1.392 | tINS | RR | 3747 | IOT27[A] | clk_27m_ibuf/O
2.903 | 1.511 | tNET | RR | 1 | BSRAM_R28[6] | u_top/u_engine/g_banked.g_generic.u_bright_rom/u_bank2/CLK
3.021 | 0.118 | tHld | | 1 | BSRAM_R28[6] | u_top/u_engine/g_banked.g_generic.u_bright_rom/u_bank2

Path Statistics:

Clock Skew | 0.000
Hold Relationship | 0.000
Logic Level | 1
Arrival Clock Path Delay | cell: 1.392, 47.946%; route: 1.511, 52.054%
Arrival Data Path Delay | cell: 0.000, 0.000%; route: 0.274, 57.536%; tC2Q: 0.202, 42.464%
Required Clock Path Delay | cell: 1.392, 47.946%; route: 1.511, 52.054%

### Path16

Path Summary:

Slack | 0.425
Data Arrival Time | 3.340
Data Required Time | 2.914
From | u_top/g_pt8211.u_pt8211/div_cnt_0_s0
To | u_top/g_pt8211.u_pt8211/div_cnt_0_s0
Launch Clk | clk_27m:[R]
Latch Clk | clk_27m:[R]

Data Arrival Path:

AT | DELAY | TYPE | RF | FANOUT | LOC | NODE
0.000 | 0.000 | | | | | active clock edge time
0.000 | 0.000 | | | | | clk_27m
0.000 | 0.000 | tCL | RR | 1 | IOT27[A] | clk_27m_ibuf/I
1.392 | 1.392 | tINS | RR | 3747 | IOT27[A] | clk_27m_ibuf/O
2.903 | 1.511 | tNET | RR | 1 | R14C51[0][A] | u_top/g_pt8211.u_pt8211/div_cnt_0_s0/CLK
3.105 | 0.202 | tC2Q | RR | 5 | R14C51[0][A] | u_top/g_pt8211.u_pt8211/div_cnt_0_s0/Q
3.108 | 0.002 | tNET | RR | 1 | R14C51[0][A] | u_top/g_pt8211.u_pt8211/n15_s2/I0
3.340 | 0.232 | tINS | RF | 1 | R14C51[0][A] | u_top/g_pt8211.u_pt8211/n15_s2/F
3.340 | 0.000 | tNET | FF | 1 | R14C51[0][A] | u_top/g_pt8211.u_pt8211/div_cnt_0_s0/D

Data Required Path:

AT | DELAY | TYPE | RF | FANOUT | LOC | NODE
0.000 | 0.000 | | | | | active clock edge time
0.000 | 0.000 | | | | | clk_27m
0.000 | 0.000 | tCL | RR | 1 | IOT27[A] | clk_27m_ibuf/I
1.392 | 1.392 | tINS | RR | 3747 | IOT27[A] | clk_27m_ibuf/O
2.903 | 1.511 | tNET | RR | 1 | R14C51[0][A] | u_top/g_pt8211.u_pt8211/div_cnt_0_s0/CLK
2.914 | 0.011 | tHld | | 1 | R14C51[0][A] | u_top/g_pt8211.u_pt8211/div_cnt_0_s0

Path Statistics:

Clock Skew | 0.000
Hold Relationship | 0.000
Logic Level | 2
Arrival Clock Path Delay | cell: 1.392, 47.946%; route: 1.511, 52.054%
Arrival Data Path Delay | cell: 0.232, 53.157%; route: 0.002, 0.560%; tC2Q: 0.202, 46.283%
Required Clock Path Delay | cell: 1.392, 47.946%; route: 1.511, 52.054%

### Path17

Path Summary:

Slack | 0.425
Data Arrival Time | 3.340
Data Required Time | 2.914
From | u_top/u_xf/clip_count_0_s0
To | u_top/u_xf/clip_count_0_s0
Launch Clk | clk_27m:[R]
Latch Clk | clk_27m:[R]

Data Arrival Path:

AT | DELAY | TYPE | RF | FANOUT | LOC | NODE
0.000 | 0.000 | | | | | active clock edge time
0.000 | 0.000 | | | | | clk_27m
0.000 | 0.000 | tCL | RR | 1 | IOT27[A] | clk_27m_ibuf/I
1.392 | 1.392 | tINS | RR | 3747 | IOT27[A] | clk_27m_ibuf/O
2.903 | 1.511 | tNET | RR | 1 | R2C9[0][A] | u_top/u_xf/clip_count_0_s0/CLK
3.105 | 0.202 | tC2Q | RR | 4 | R2C9[0][A] | u_top/u_xf/clip_count_0_s0/Q
3.108 | 0.002 | tNET | RR | 1 | R2C9[0][A] | u_top/u_xf/n2903_s2/I0
3.340 | 0.232 | tINS | RF | 1 | R2C9[0][A] | u_top/u_xf/n2903_s2/F
3.340 | 0.000 | tNET | FF | 1 | R2C9[0][A] | u_top/u_xf/clip_count_0_s0/D

Data Required Path:

AT | DELAY | TYPE | RF | FANOUT | LOC | NODE
0.000 | 0.000 | | | | | active clock edge time
0.000 | 0.000 | | | | | clk_27m
0.000 | 0.000 | tCL | RR | 1 | IOT27[A] | clk_27m_ibuf/I
1.392 | 1.392 | tINS | RR | 3747 | IOT27[A] | clk_27m_ibuf/O
2.903 | 1.511 | tNET | RR | 1 | R2C9[0][A] | u_top/u_xf/clip_count_0_s0/CLK
2.914 | 0.011 | tHld | | 1 | R2C9[0][A] | u_top/u_xf/clip_count_0_s0

Path Statistics:

Clock Skew | 0.000
Hold Relationship | 0.000
Logic Level | 2
Arrival Clock Path Delay | cell: 1.392, 47.946%; route: 1.511, 52.054%
Arrival Data Path Delay | cell: 0.232, 53.157%; route: 0.002, 0.560%; tC2Q: 0.202, 46.283%
Required Clock Path Delay | cell: 1.392, 47.946%; route: 1.511, 52.054%

### Path18

Path Summary:

Slack | 0.425
Data Arrival Time | 3.340
Data Required Time | 2.914
From | u_top/u_xf/clip_count_2_s0
To | u_top/u_xf/clip_count_2_s0
Launch Clk | clk_27m:[R]
Latch Clk | clk_27m:[R]

Data Arrival Path:

AT | DELAY | TYPE | RF | FANOUT | LOC | NODE
0.000 | 0.000 | | | | | active clock edge time
0.000 | 0.000 | | | | | clk_27m
0.000 | 0.000 | tCL | RR | 1 | IOT27[A] | clk_27m_ibuf/I
1.392 | 1.392 | tINS | RR | 3747 | IOT27[A] | clk_27m_ibuf/O
2.903 | 1.511 | tNET | RR | 1 | R2C10[1][A] | u_top/u_xf/clip_count_2_s0/CLK
3.105 | 0.202 | tC2Q | RR | 3 | R2C10[1][A] | u_top/u_xf/clip_count_2_s0/Q
3.108 | 0.002 | tNET | RR | 2 | R2C10[1][A] | u_top/u_xf/n2901_s/I1
3.340 | 0.232 | tINS | RF | 1 | R2C10[1][A] | u_top/u_xf/n2901_s/SUM
3.340 | 0.000 | tNET | FF | 1 | R2C10[1][A] | u_top/u_xf/clip_count_2_s0/D

Data Required Path:

AT | DELAY | TYPE | RF | FANOUT | LOC | NODE
0.000 | 0.000 | | | | | active clock edge time
0.000 | 0.000 | | | | | clk_27m
0.000 | 0.000 | tCL | RR | 1 | IOT27[A] | clk_27m_ibuf/I
1.392 | 1.392 | tINS | RR | 3747 | IOT27[A] | clk_27m_ibuf/O
2.903 | 1.511 | tNET | RR | 1 | R2C10[1][A] | u_top/u_xf/clip_count_2_s0/CLK
2.914 | 0.011 | tHld | | 1 | R2C10[1][A] | u_top/u_xf/clip_count_2_s0

Path Statistics:

Clock Skew | 0.000
Hold Relationship | 0.000
Logic Level | 2
Arrival Clock Path Delay | cell: 1.392, 47.946%; route: 1.511, 52.054%
Arrival Data Path Delay | cell: 0.232, 53.157%; route: 0.002, 0.560%; tC2Q: 0.202, 46.283%
Required Clock Path Delay | cell: 1.392, 47.946%; route: 1.511, 52.054%

### Path19

Path Summary:

Slack | 0.425
Data Arrival Time | 3.340
Data Required Time | 2.914
From | u_top/u_xf/clip_count_6_s0
To | u_top/u_xf/clip_count_6_s0
Launch Clk | clk_27m:[R]
Latch Clk | clk_27m:[R]

Data Arrival Path:

AT | DELAY | TYPE | RF | FANOUT | LOC | NODE
0.000 | 0.000 | | | | | active clock edge time
0.000 | 0.000 | | | | | clk_27m
0.000 | 0.000 | tCL | RR | 1 | IOT27[A] | clk_27m_ibuf/I
1.392 | 1.392 | tINS | RR | 3747 | IOT27[A] | clk_27m_ibuf/O
2.903 | 1.511 | tNET | RR | 1 | R2C11[0][A] | u_top/u_xf/clip_count_6_s0/CLK
3.105 | 0.202 | tC2Q | RR | 3 | R2C11[0][A] | u_top/u_xf/clip_count_6_s0/Q
3.108 | 0.002 | tNET | RR | 2 | R2C11[0][A] | u_top/u_xf/n2897_s/I1
3.340 | 0.232 | tINS | RF | 1 | R2C11[0][A] | u_top/u_xf/n2897_s/SUM
3.340 | 0.000 | tNET | FF | 1 | R2C11[0][A] | u_top/u_xf/clip_count_6_s0/D

Data Required Path:

AT | DELAY | TYPE | RF | FANOUT | LOC | NODE
0.000 | 0.000 | | | | | active clock edge time
0.000 | 0.000 | | | | | clk_27m
0.000 | 0.000 | tCL | RR | 1 | IOT27[A] | clk_27m_ibuf/I
1.392 | 1.392 | tINS | RR | 3747 | IOT27[A] | clk_27m_ibuf/O
2.903 | 1.511 | tNET | RR | 1 | R2C11[0][A] | u_top/u_xf/clip_count_6_s0/CLK
2.914 | 0.011 | tHld | | 1 | R2C11[0][A] | u_top/u_xf/clip_count_6_s0

Path Statistics:

Clock Skew | 0.000
Hold Relationship | 0.000
Logic Level | 2
Arrival Clock Path Delay | cell: 1.392, 47.946%; route: 1.511, 52.054%
Arrival Data Path Delay | cell: 0.232, 53.157%; route: 0.002, 0.560%; tC2Q: 0.202, 46.283%
Required Clock Path Delay | cell: 1.392, 47.946%; route: 1.511, 52.054%

### Path20

Path Summary:

Slack | 0.425
Data Arrival Time | 3.340
Data Required Time | 2.914
From | u_top/u_xf/clip_count_12_s0
To | u_top/u_xf/clip_count_12_s0
Launch Clk | clk_27m:[R]
Latch Clk | clk_27m:[R]

Data Arrival Path:

AT | DELAY | TYPE | RF | FANOUT | LOC | NODE
0.000 | 0.000 | | | | | active clock edge time
0.000 | 0.000 | | | | | clk_27m
0.000 | 0.000 | tCL | RR | 1 | IOT27[A] | clk_27m_ibuf/I
1.392 | 1.392 | tINS | RR | 3747 | IOT27[A] | clk_27m_ibuf/O
2.903 | 1.511 | tNET | RR | 1 | R2C12[0][A] | u_top/u_xf/clip_count_12_s0/CLK
3.105 | 0.202 | tC2Q | RR | 3 | R2C12[0][A] | u_top/u_xf/clip_count_12_s0/Q
3.108 | 0.002 | tNET | RR | 2 | R2C12[0][A] | u_top/u_xf/n2891_s/I1
3.340 | 0.232 | tINS | RF | 1 | R2C12[0][A] | u_top/u_xf/n2891_s/SUM
3.340 | 0.000 | tNET | FF | 1 | R2C12[0][A] | u_top/u_xf/clip_count_12_s0/D

Data Required Path:

AT | DELAY | TYPE | RF | FANOUT | LOC | NODE
0.000 | 0.000 | | | | | active clock edge time
0.000 | 0.000 | | | | | clk_27m
0.000 | 0.000 | tCL | RR | 1 | IOT27[A] | clk_27m_ibuf/I
1.392 | 1.392 | tINS | RR | 3747 | IOT27[A] | clk_27m_ibuf/O
2.903 | 1.511 | tNET | RR | 1 | R2C12[0][A] | u_top/u_xf/clip_count_12_s0/CLK
2.914 | 0.011 | tHld | | 1 | R2C12[0][A] | u_top/u_xf/clip_count_12_s0

Path Statistics:

Clock Skew | 0.000
Hold Relationship | 0.000
Logic Level | 2
Arrival Clock Path Delay | cell: 1.392, 47.946%; route: 1.511, 52.054%
Arrival Data Path Delay | cell: 0.232, 53.157%; route: 0.002, 0.560%; tC2Q: 0.202, 46.283%
Required Clock Path Delay | cell: 1.392, 47.946%; route: 1.511, 52.054%

### Path21

Path Summary:

Slack | 0.425
Data Arrival Time | 3.340
Data Required Time | 2.914
From | u_top/u_xf/clip_count_18_s0
To | u_top/u_xf/clip_count_18_s0
Launch Clk | clk_27m:[R]
Latch Clk | clk_27m:[R]

Data Arrival Path:

AT | DELAY | TYPE | RF | FANOUT | LOC | NODE
0.000 | 0.000 | | | | | active clock edge time
0.000 | 0.000 | | | | | clk_27m
0.000 | 0.000 | tCL | RR | 1 | IOT27[A] | clk_27m_ibuf/I
1.392 | 1.392 | tINS | RR | 3747 | IOT27[A] | clk_27m_ibuf/O
2.903 | 1.511 | tNET | RR | 1 | R2C13[0][A] | u_top/u_xf/clip_count_18_s0/CLK
3.105 | 0.202 | tC2Q | RR | 3 | R2C13[0][A] | u_top/u_xf/clip_count_18_s0/Q
3.108 | 0.002 | tNET | RR | 2 | R2C13[0][A] | u_top/u_xf/n2885_s/I1
3.340 | 0.232 | tINS | RF | 1 | R2C13[0][A] | u_top/u_xf/n2885_s/SUM
3.340 | 0.000 | tNET | FF | 1 | R2C13[0][A] | u_top/u_xf/clip_count_18_s0/D

Data Required Path:

AT | DELAY | TYPE | RF | FANOUT | LOC | NODE
0.000 | 0.000 | | | | | active clock edge time
0.000 | 0.000 | | | | | clk_27m
0.000 | 0.000 | tCL | RR | 1 | IOT27[A] | clk_27m_ibuf/I
1.392 | 1.392 | tINS | RR | 3747 | IOT27[A] | clk_27m_ibuf/O
2.903 | 1.511 | tNET | RR | 1 | R2C13[0][A] | u_top/u_xf/clip_count_18_s0/CLK
2.914 | 0.011 | tHld | | 1 | R2C13[0][A] | u_top/u_xf/clip_count_18_s0

Path Statistics:

Clock Skew | 0.000
Hold Relationship | 0.000
Logic Level | 2
Arrival Clock Path Delay | cell: 1.392, 47.946%; route: 1.511, 52.054%
Arrival Data Path Delay | cell: 0.232, 53.157%; route: 0.002, 0.560%; tC2Q: 0.202, 46.283%
Required Clock Path Delay | cell: 1.392, 47.946%; route: 1.511, 52.054%

### Path22

Path Summary:

Slack | 0.425
Data Arrival Time | 3.340
Data Required Time | 2.914
From | u_top/u_xf/clip_count_24_s0
To | u_top/u_xf/clip_count_24_s0
Launch Clk | clk_27m:[R]
Latch Clk | clk_27m:[R]

Data Arrival Path:

AT | DELAY | TYPE | RF | FANOUT | LOC | NODE
0.000 | 0.000 | | | | | active clock edge time
0.000 | 0.000 | | | | | clk_27m
0.000 | 0.000 | tCL | RR | 1 | IOT27[A] | clk_27m_ibuf/I
1.392 | 1.392 | tINS | RR | 3747 | IOT27[A] | clk_27m_ibuf/O
2.903 | 1.511 | tNET | RR | 1 | R2C14[0][A] | u_top/u_xf/clip_count_24_s0/CLK
3.105 | 0.202 | tC2Q | RR | 3 | R2C14[0][A] | u_top/u_xf/clip_count_24_s0/Q
3.108 | 0.002 | tNET | RR | 2 | R2C14[0][A] | u_top/u_xf/n2879_s/I1
3.340 | 0.232 | tINS | RF | 1 | R2C14[0][A] | u_top/u_xf/n2879_s/SUM
3.340 | 0.000 | tNET | FF | 1 | R2C14[0][A] | u_top/u_xf/clip_count_24_s0/D

Data Required Path:

AT | DELAY | TYPE | RF | FANOUT | LOC | NODE
0.000 | 0.000 | | | | | active clock edge time
0.000 | 0.000 | | | | | clk_27m
0.000 | 0.000 | tCL | RR | 1 | IOT27[A] | clk_27m_ibuf/I
1.392 | 1.392 | tINS | RR | 3747 | IOT27[A] | clk_27m_ibuf/O
2.903 | 1.511 | tNET | RR | 1 | R2C14[0][A] | u_top/u_xf/clip_count_24_s0/CLK
2.914 | 0.011 | tHld | | 1 | R2C14[0][A] | u_top/u_xf/clip_count_24_s0

Path Statistics:

Clock Skew | 0.000
Hold Relationship | 0.000
Logic Level | 2
Arrival Clock Path Delay | cell: 1.392, 47.946%; route: 1.511, 52.054%
Arrival Data Path Delay | cell: 0.232, 53.157%; route: 0.002, 0.560%; tC2Q: 0.202, 46.283%
Required Clock Path Delay | cell: 1.392, 47.946%; route: 1.511, 52.054%

### Path23

Path Summary:

Slack | 0.425
Data Arrival Time | 3.340
Data Required Time | 2.914
From | u_top/u_xf/clip_count_26_s0
To | u_top/u_xf/clip_count_26_s0
Launch Clk | clk_27m:[R]
Latch Clk | clk_27m:[R]

Data Arrival Path:

AT | DELAY | TYPE | RF | FANOUT | LOC | NODE
0.000 | 0.000 | | | | | active clock edge time
0.000 | 0.000 | | | | | clk_27m
0.000 | 0.000 | tCL | RR | 1 | IOT27[A] | clk_27m_ibuf/I
1.392 | 1.392 | tINS | RR | 3747 | IOT27[A] | clk_27m_ibuf/O
2.903 | 1.511 | tNET | RR | 1 | R2C14[1][A] | u_top/u_xf/clip_count_26_s0/CLK
3.105 | 0.202 | tC2Q | RR | 3 | R2C14[1][A] | u_top/u_xf/clip_count_26_s0/Q
3.108 | 0.002 | tNET | RR | 2 | R2C14[1][A] | u_top/u_xf/n2877_s/I1
3.340 | 0.232 | tINS | RF | 1 | R2C14[1][A] | u_top/u_xf/n2877_s/SUM
3.340 | 0.000 | tNET | FF | 1 | R2C14[1][A] | u_top/u_xf/clip_count_26_s0/D

Data Required Path:

AT | DELAY | TYPE | RF | FANOUT | LOC | NODE
0.000 | 0.000 | | | | | active clock edge time
0.000 | 0.000 | | | | | clk_27m
0.000 | 0.000 | tCL | RR | 1 | IOT27[A] | clk_27m_ibuf/I
1.392 | 1.392 | tINS | RR | 3747 | IOT27[A] | clk_27m_ibuf/O
2.903 | 1.511 | tNET | RR | 1 | R2C14[1][A] | u_top/u_xf/clip_count_26_s0/CLK
2.914 | 0.011 | tHld | | 1 | R2C14[1][A] | u_top/u_xf/clip_count_26_s0

Path Statistics:

Clock Skew | 0.000
Hold Relationship | 0.000
Logic Level | 2
Arrival Clock Path Delay | cell: 1.392, 47.946%; route: 1.511, 52.054%
Arrival Data Path Delay | cell: 0.232, 53.157%; route: 0.002, 0.560%; tC2Q: 0.202, 46.283%
Required Clock Path Delay | cell: 1.392, 47.946%; route: 1.511, 52.054%

### Path24

Path Summary:

Slack | 0.425
Data Arrival Time | 3.340
Data Required Time | 2.914
From | u_top/u_xf/clip_count_30_s0
To | u_top/u_xf/clip_count_30_s0
Launch Clk | clk_27m:[R]
Latch Clk | clk_27m:[R]

Data Arrival Path:

AT | DELAY | TYPE | RF | FANOUT | LOC | NODE
0.000 | 0.000 | | | | | active clock edge time
0.000 | 0.000 | | | | | clk_27m
0.000 | 0.000 | tCL | RR | 1 | IOT27[A] | clk_27m_ibuf/I
1.392 | 1.392 | tINS | RR | 3747 | IOT27[A] | clk_27m_ibuf/O
2.903 | 1.511 | tNET | RR | 1 | R2C15[0][A] | u_top/u_xf/clip_count_30_s0/CLK
3.105 | 0.202 | tC2Q | RR | 3 | R2C15[0][A] | u_top/u_xf/clip_count_30_s0/Q
3.108 | 0.002 | tNET | RR | 2 | R2C15[0][A] | u_top/u_xf/n2873_s/I1
3.340 | 0.232 | tINS | RF | 1 | R2C15[0][A] | u_top/u_xf/n2873_s/SUM
3.340 | 0.000 | tNET | FF | 1 | R2C15[0][A] | u_top/u_xf/clip_count_30_s0/D

Data Required Path:

AT | DELAY | TYPE | RF | FANOUT | LOC | NODE
0.000 | 0.000 | | | | | active clock edge time
0.000 | 0.000 | | | | | clk_27m
0.000 | 0.000 | tCL | RR | 1 | IOT27[A] | clk_27m_ibuf/I
1.392 | 1.392 | tINS | RR | 3747 | IOT27[A] | clk_27m_ibuf/O
2.903 | 1.511 | tNET | RR | 1 | R2C15[0][A] | u_top/u_xf/clip_count_30_s0/CLK
2.914 | 0.011 | tHld | | 1 | R2C15[0][A] | u_top/u_xf/clip_count_30_s0

Path Statistics:

Clock Skew | 0.000
Hold Relationship | 0.000
Logic Level | 2
Arrival Clock Path Delay | cell: 1.392, 47.946%; route: 1.511, 52.054%
Arrival Data Path Delay | cell: 0.232, 53.157%; route: 0.002, 0.560%; tC2Q: 0.202, 46.283%
Required Clock Path Delay | cell: 1.392, 47.946%; route: 1.511, 52.054%

### Path25

Path Summary:

Slack | 0.425
Data Arrival Time | 3.340
Data Required Time | 2.914
From | u_top/u_engine/stage_q_stage_q_RAMREG_6_G[2]_s0
To | u_top/u_engine/stage_q_stage_q_RAMREG_6_G[2]_s0
Launch Clk | clk_27m:[R]
Latch Clk | clk_27m:[R]

Data Arrival Path:

AT | DELAY | TYPE | RF | FANOUT | LOC | NODE
0.000 | 0.000 | | | | | active clock edge time
0.000 | 0.000 | | | | | clk_27m
0.000 | 0.000 | tCL | RR | 1 | IOT27[A] | clk_27m_ibuf/I
1.392 | 1.392 | tINS | RR | 3747 | IOT27[A] | clk_27m_ibuf/O
2.903 | 1.511 | tNET | RR | 1 | R24C26[0][A] | u_top/u_engine/stage_q_stage_q_RAMREG_6_G[2]_s0/CLK
3.105 | 0.202 | tC2Q | RR | 3 | R24C26[0][A] | u_top/u_engine/stage_q_stage_q_RAMREG_6_G[2]_s0/Q
3.108 | 0.002 | tNET | RR | 1 | R24C26[0][A] | u_top/u_engine/n1628_s3/I2
3.340 | 0.232 | tINS | RF | 1 | R24C26[0][A] | u_top/u_engine/n1628_s3/F
3.340 | 0.000 | tNET | FF | 1 | R24C26[0][A] | u_top/u_engine/stage_q_stage_q_RAMREG_6_G[2]_s0/D

Data Required Path:

AT | DELAY | TYPE | RF | FANOUT | LOC | NODE
0.000 | 0.000 | | | | | active clock edge time
0.000 | 0.000 | | | | | clk_27m
0.000 | 0.000 | tCL | RR | 1 | IOT27[A] | clk_27m_ibuf/I
1.392 | 1.392 | tINS | RR | 3747 | IOT27[A] | clk_27m_ibuf/O
2.903 | 1.511 | tNET | RR | 1 | R24C26[0][A] | u_top/u_engine/stage_q_stage_q_RAMREG_6_G[2]_s0/CLK
2.914 | 0.011 | tHld | | 1 | R24C26[0][A] | u_top/u_engine/stage_q_stage_q_RAMREG_6_G[2]_s0

Path Statistics:

Clock Skew | 0.000
Hold Relationship | 0.000
Logic Level | 2
Arrival Clock Path Delay | cell: 1.392, 47.946%; route: 1.511, 52.054%
Arrival Data Path Delay | cell: 0.232, 53.157%; route: 0.002, 0.560%; tC2Q: 0.202, 46.283%
Required Clock Path Delay | cell: 1.392, 47.946%; route: 1.511, 52.054%

### Recovery Analysis Report

#### Report Command:report_timing -recovery -max_paths 25 -max_common_paths 1

#### No recovery paths to report!

### Removal Analysis Report

#### Report Command:report_timing -removal -max_paths 25 -max_common_paths 1

#### No removal paths to report!

## Minimum Pulse Width Report:

#### Report Command:report_min_pulse_width -nworst 10 -detail

### MPW1

MPW Summary:

Slack: | 15.833
Actual Width: | 16.833
Required Width: | 1.000
Type: | Low Pulse Width
Clock: | clk_27m
Objects: | u_top/reset_cnt_14_s0

Late clock Path:

AT | DELAY | TYPE | RF | NODE
18.518 | 0.000 | | | active clock edge time
18.518 | 0.000 | | | clk_27m
18.518 | 0.000 | tCL | FF | clk_27m_ibuf/I
20.832 | 2.314 | tINS | FF | clk_27m_ibuf/O
23.107 | 2.274 | tNET | FF | u_top/reset_cnt_14_s0/CLK

Early clock Path:

AT | DELAY | TYPE | RF | NODE
37.037 | 0.000 | | | active clock edge time
37.037 | 0.000 | | | clk_27m
37.037 | 0.000 | tCL | RR | clk_27m_ibuf/I
38.429 | 1.392 | tINS | RR | clk_27m_ibuf/O
39.940 | 1.511 | tNET | RR | u_top/reset_cnt_14_s0/CLK

### MPW2

MPW Summary:

Slack: | 15.833
Actual Width: | 16.833
Required Width: | 1.000
Type: | Low Pulse Width
Clock: | clk_27m
Objects: | u_top/reset_cnt_12_s0

Late clock Path:

AT | DELAY | TYPE | RF | NODE
18.518 | 0.000 | | | active clock edge time
18.518 | 0.000 | | | clk_27m
18.518 | 0.000 | tCL | FF | clk_27m_ibuf/I
20.832 | 2.314 | tINS | FF | clk_27m_ibuf/O
23.107 | 2.274 | tNET | FF | u_top/reset_cnt_12_s0/CLK

Early clock Path:

AT | DELAY | TYPE | RF | NODE
37.037 | 0.000 | | | active clock edge time
37.037 | 0.000 | | | clk_27m
37.037 | 0.000 | tCL | RR | clk_27m_ibuf/I
38.429 | 1.392 | tINS | RR | clk_27m_ibuf/O
39.940 | 1.511 | tNET | RR | u_top/reset_cnt_12_s0/CLK

### MPW3

MPW Summary:

Slack: | 15.833
Actual Width: | 16.833
Required Width: | 1.000
Type: | Low Pulse Width
Clock: | clk_27m
Objects: | u_top/reset_cnt_8_s0

Late clock Path:

AT | DELAY | TYPE | RF | NODE
18.518 | 0.000 | | | active clock edge time
18.518 | 0.000 | | | clk_27m
18.518 | 0.000 | tCL | FF | clk_27m_ibuf/I
20.832 | 2.314 | tINS | FF | clk_27m_ibuf/O
23.107 | 2.274 | tNET | FF | u_top/reset_cnt_8_s0/CLK

Early clock Path:

AT | DELAY | TYPE | RF | NODE
37.037 | 0.000 | | | active clock edge time
37.037 | 0.000 | | | clk_27m
37.037 | 0.000 | tCL | RR | clk_27m_ibuf/I
38.429 | 1.392 | tINS | RR | clk_27m_ibuf/O
39.940 | 1.511 | tNET | RR | u_top/reset_cnt_8_s0/CLK

### MPW4

MPW Summary:

Slack: | 15.833
Actual Width: | 16.833
Required Width: | 1.000
Type: | Low Pulse Width
Clock: | clk_27m
Objects: | u_top/reset_cnt_0_s0

Late clock Path:

AT | DELAY | TYPE | RF | NODE
18.518 | 0.000 | | | active clock edge time
18.518 | 0.000 | | | clk_27m
18.518 | 0.000 | tCL | FF | clk_27m_ibuf/I
20.832 | 2.314 | tINS | FF | clk_27m_ibuf/O
23.107 | 2.274 | tNET | FF | u_top/reset_cnt_0_s0/CLK

Early clock Path:

AT | DELAY | TYPE | RF | NODE
37.037 | 0.000 | | | active clock edge time
37.037 | 0.000 | | | clk_27m
37.037 | 0.000 | tCL | RR | clk_27m_ibuf/I
38.429 | 1.392 | tINS | RR | clk_27m_ibuf/O
39.940 | 1.511 | tNET | RR | u_top/reset_cnt_0_s0/CLK

### MPW5

MPW Summary:

Slack: | 15.833
Actual Width: | 16.833
Required Width: | 1.000
Type: | Low Pulse Width
Clock: | clk_27m
Objects: | u_top/pending_word_6_s0

Late clock Path:

AT | DELAY | TYPE | RF | NODE
18.518 | 0.000 | | | active clock edge time
18.518 | 0.000 | | | clk_27m
18.518 | 0.000 | tCL | FF | clk_27m_ibuf/I
20.832 | 2.314 | tINS | FF | clk_27m_ibuf/O
23.107 | 2.274 | tNET | FF | u_top/pending_word_6_s0/CLK

Early clock Path:

AT | DELAY | TYPE | RF | NODE
37.037 | 0.000 | | | active clock edge time
37.037 | 0.000 | | | clk_27m
37.037 | 0.000 | tCL | RR | clk_27m_ibuf/I
38.429 | 1.392 | tINS | RR | clk_27m_ibuf/O
39.940 | 1.511 | tNET | RR | u_top/pending_word_6_s0/CLK

### MPW6

MPW Summary:

Slack: | 15.833
Actual Width: | 16.833
Required Width: | 1.000
Type: | Low Pulse Width
Clock: | clk_27m
Objects: | u_top/ctrl_div_1_s0

Late clock Path:

AT | DELAY | TYPE | RF | NODE
18.518 | 0.000 | | | active clock edge time
18.518 | 0.000 | | | clk_27m
18.518 | 0.000 | tCL | FF | clk_27m_ibuf/I
20.832 | 2.314 | tINS | FF | clk_27m_ibuf/O
23.107 | 2.274 | tNET | FF | u_top/ctrl_div_1_s0/CLK

Early clock Path:

AT | DELAY | TYPE | RF | NODE
37.037 | 0.000 | | | active clock edge time
37.037 | 0.000 | | | clk_27m
37.037 | 0.000 | tCL | RR | clk_27m_ibuf/I
38.429 | 1.392 | tINS | RR | clk_27m_ibuf/O
39.940 | 1.511 | tNET | RR | u_top/ctrl_div_1_s0/CLK

### MPW7

MPW Summary:

Slack: | 15.833
Actual Width: | 16.833
Required Width: | 1.000
Type: | Low Pulse Width
Clock: | clk_27m
Objects: | u_top/mix_lp_y_15_s0

Late clock Path:

AT | DELAY | TYPE | RF | NODE
18.518 | 0.000 | | | active clock edge time
18.518 | 0.000 | | | clk_27m
18.518 | 0.000 | tCL | FF | clk_27m_ibuf/I
20.832 | 2.314 | tINS | FF | clk_27m_ibuf/O
23.107 | 2.274 | tNET | FF | u_top/mix_lp_y_15_s0/CLK

Early clock Path:

AT | DELAY | TYPE | RF | NODE
37.037 | 0.000 | | | active clock edge time
37.037 | 0.000 | | | clk_27m
37.037 | 0.000 | tCL | RR | clk_27m_ibuf/I
38.429 | 1.392 | tINS | RR | clk_27m_ibuf/O
39.940 | 1.511 | tNET | RR | u_top/mix_lp_y_15_s0/CLK

### MPW8

MPW Summary:

Slack: | 15.833
Actual Width: | 16.833
Required Width: | 1.000
Type: | Low Pulse Width
Clock: | clk_27m
Objects: | u_top/g_host_kbd.u_host_kbd/u_uart/cnt_11_s1

Late clock Path:

AT | DELAY | TYPE | RF | NODE
18.518 | 0.000 | | | active clock edge time
18.518 | 0.000 | | | clk_27m
18.518 | 0.000 | tCL | FF | clk_27m_ibuf/I
20.832 | 2.314 | tINS | FF | clk_27m_ibuf/O
23.107 | 2.274 | tNET | FF | u_top/g_host_kbd.u_host_kbd/u_uart/cnt_11_s1/CLK

Early clock Path:

AT | DELAY | TYPE | RF | NODE
37.037 | 0.000 | | | active clock edge time
37.037 | 0.000 | | | clk_27m
37.037 | 0.000 | tCL | RR | clk_27m_ibuf/I
38.429 | 1.392 | tINS | RR | clk_27m_ibuf/O
39.940 | 1.511 | tNET | RR | u_top/g_host_kbd.u_host_kbd/u_uart/cnt_11_s1/CLK

### MPW9

MPW Summary:

Slack: | 15.833
Actual Width: | 16.833
Required Width: | 1.000
Type: | Low Pulse Width
Clock: | clk_27m
Objects: | u_top/g_host_kbd.u_host_kbd/u_map/cur_key_cur_key_RAMREG_0_G[7]_s0

Late clock Path:

AT | DELAY | TYPE | RF | NODE
18.518 | 0.000 | | | active clock edge time
18.518 | 0.000 | | | clk_27m
18.518 | 0.000 | tCL | FF | clk_27m_ibuf/I
20.832 | 2.314 | tINS | FF | clk_27m_ibuf/O
23.107 | 2.274 | tNET | FF | u_top/g_host_kbd.u_host_kbd/u_map/cur_key_cur_key_RAMREG_0_G[7]_s0/CLK

Early clock Path:

AT | DELAY | TYPE | RF | NODE
37.037 | 0.000 | | | active clock edge time
37.037 | 0.000 | | | clk_27m
37.037 | 0.000 | tCL | RR | clk_27m_ibuf/I
38.429 | 1.392 | tINS | RR | clk_27m_ibuf/O
39.940 | 1.511 | tNET | RR | u_top/g_host_kbd.u_host_kbd/u_map/cur_key_cur_key_RAMREG_0_G[7]_s0/CLK

### MPW10

MPW Summary:

Slack: | 15.833
Actual Width: | 16.833
Required Width: | 1.000
Type: | Low Pulse Width
Clock: | clk_27m
Objects: | u_top/u_uart/tx_cnt_9_s3

Late clock Path:

AT | DELAY | TYPE | RF | NODE
18.518 | 0.000 | | | active clock edge time
18.518 | 0.000 | | | clk_27m
18.518 | 0.000 | tCL | FF | clk_27m_ibuf/I
20.832 | 2.314 | tINS | FF | clk_27m_ibuf/O
23.107 | 2.274 | tNET | FF | u_top/u_uart/tx_cnt_9_s3/CLK

Early clock Path:

AT | DELAY | TYPE | RF | NODE
37.037 | 0.000 | | | active clock edge time
37.037 | 0.000 | | | clk_27m
37.037 | 0.000 | tCL | RR | clk_27m_ibuf/I
38.429 | 1.392 | tINS | RR | clk_27m_ibuf/O
39.940 | 1.511 | tNET | RR | u_top/u_uart/tx_cnt_9_s3/CLK

## High Fanout Nets Report:

#### Report Command:report_high_fanout_nets -max_nets 10

FANOUT | NET NAME | WORST SLACK | MAX DELAY
3747 | clk_27m_d | 4.820 | 2.274
2174 | u_top/rst | 27.485 | 2.120
385 | u_top/u_engine/n5449_13 | 31.112 | 2.036
304 | u_top/u_engine/selected[0] | 24.465 | 3.535
222 | u_top/u_engine/vsel[0] | 22.959 | 2.670
190 | u_top/u_engine/vsel[1] | 23.066 | 3.033
181 | u_top/state_23[1] | 29.126 | 3.301
178 | u_top/u_engine/vsel[2] | 24.259 | 4.399
161 | u_top/state_23[0] | 28.433 | 2.905
158 | u_top/n557_6 | 29.657 | 1.628

## Route Congestions Report:

#### Report Command:report_route_congestion -max_grids 10

GRID LOC | ROUTE CONGESTIONS
R2C7 | 100.00%
R2C8 | 100.00%
R2C9 | 100.00%
R2C38 | 100.00%
R2C40 | 100.00%
R3C49 | 100.00%
R3C50 | 100.00%
R38C47 | 100.00%
R20C2 | 100.00%
R20C4 | 100.00%

## Timing Exceptions Report:

### Setup Analysis Report

#### Report Command:report_exceptions -setup -max_paths 5 -max_common_paths 1

#### No timing exceptions to report!

### Hold Analysis Report

#### Report Command:report_exceptions -hold -max_paths 5 -max_common_paths 1

#### No timing exceptions to report!

### Recovery Analysis Report

#### Report Command:report_exceptions -recovery -max_paths 5 -max_common_paths 1

#### No timing exceptions to report!

### Removal Analysis Report

#### Report Command:report_exceptions -removal -max_paths 5 -max_common_paths 1

#### No timing exceptions to report!

## Timing Constraints Report:

SDC Command Type | State | Detail Command
TC_CLOCK | Actived | create_clock -name clk_27m -period 37.037 [get_ports {clk_27m}]
