Interstellar-530/PolyTouch-FPGA-Synth/evidence/2026/10/FPGA-优化03-HID控制-20261021/build_reports/instrument_tr_content.html

# Timing Messages

Report Title | Timing Analysis Report
Design File | E:\Working Space\FPGA\output\handoff_milestone2_20261008\source\build\gowin_top_dbg8usb\runs\20261021T120204819-54d860e1\instrument\impl\gwsynthesis\instrument.vg
Physical Constraints File | E:\Working Space\FPGA\output\handoff_milestone2_20261008\source\constraints\primer20k_dock3714_usb.cst
Timing Constraint File | E:\Working Space\FPGA\output\handoff_milestone2_20261008\source\constraints\primer20k.sdc
Tool Version | V1.9.11.03 Education
Part Number | GW2A-LV18PG256C8/I7
Device | GW2A-18
Device Version | C
Created Time | Wed Oct 21 12:03:55 2026
Legal Announcement | Copyright (C)2014-2025 Gowin Semiconductor Corporation. All rights reserved.

# Timing Summaries

## STA Tool Run Summary:

Setup Delay Model | Slow 0.95V 85C C8/I7
Hold Delay Model | Fast 1.05V 0C C8/I7
Numbers of Paths Analyzed | 11484
Numbers of Endpoints Analyzed | 11123
Numbers of Falling Endpoints | 0
Numbers of Setup Violated Endpoints | 0
Numbers of Hold Violated Endpoints | 0

## Clock Summary:

NO. | Clock Name | Type | Period | Frequency(MHz) | Rise | Fall | Source | Master | Objects
1 | clk_27m | Base | 37.037 | 27.000 | 0.000 | 18.518 | | | clk_27m

## Max Frequency Summary:

NO. | Clock Name | Constraint | Actual Fmax | Logic Level | Entity
1 | clk_27m | 27.000(MHz) | 30.076(MHz) | 24 | TOP

## Total Negative Slack Summary:

Clock Name | Analysis Type | Endpoints TNS | Number of Endpoints
clk_27m | Setup | 0.000 | 0
clk_27m | Hold | 0.000 | 0

# Timing Details

## Path Slacks Table:

### Setup Paths Table

#### Report Command:report_timing -setup -max_paths 25 -max_common_paths 1

Path Number | Path Slack | From Node | To Node | From Clock | To Clock | Relation | Clock Skew | Data Delay
1 | 3.788 | u_top/u_manual/wr_ptr_0_s0/Q | u_top/u_alloc/v_note_29_s0/CE | clk_27m:[R] | clk_27m:[R] | 37.037 | 0.000 | 33.214
2 | 3.788 | u_top/u_manual/wr_ptr_0_s0/Q | u_top/u_alloc/v_note_30_s0/CE | clk_27m:[R] | clk_27m:[R] | 37.037 | 0.000 | 33.214
3 | 3.788 | u_top/u_manual/wr_ptr_0_s0/Q | u_top/u_alloc/v_note_31_s0/CE | clk_27m:[R] | clk_27m:[R] | 37.037 | 0.000 | 33.214
4 | 3.788 | u_top/u_manual/wr_ptr_0_s0/Q | u_top/u_alloc/v_note_32_s0/CE | clk_27m:[R] | clk_27m:[R] | 37.037 | 0.000 | 33.214
5 | 4.167 | u_top/u_manual/wr_ptr_0_s0/Q | u_top/u_alloc/v_note_33_s0/CE | clk_27m:[R] | clk_27m:[R] | 37.037 | 0.000 | 32.835
6 | 4.167 | u_top/u_manual/wr_ptr_0_s0/Q | u_top/u_alloc/v_note_34_s0/CE | clk_27m:[R] | clk_27m:[R] | 37.037 | 0.000 | 32.835
7 | 4.180 | u_top/u_manual/wr_ptr_0_s0/Q | u_top/u_alloc/v_note_49_s0/CE | clk_27m:[R] | clk_27m:[R] | 37.037 | 0.000 | 32.822
8 | 4.180 | u_top/u_manual/wr_ptr_0_s0/Q | u_top/u_alloc/v_note_50_s0/CE | clk_27m:[R] | clk_27m:[R] | 37.037 | 0.000 | 32.822
9 | 4.180 | u_top/u_manual/wr_ptr_0_s0/Q | u_top/u_alloc/v_note_52_s0/CE | clk_27m:[R] | clk_27m:[R] | 37.037 | 0.000 | 32.822
10 | 4.180 | u_top/u_manual/wr_ptr_0_s0/Q | u_top/u_alloc/v_note_53_s0/CE | clk_27m:[R] | clk_27m:[R] | 37.037 | 0.000 | 32.822
11 | 4.180 | u_top/u_manual/wr_ptr_0_s0/Q | u_top/u_alloc/v_note_54_s0/CE | clk_27m:[R] | clk_27m:[R] | 37.037 | 0.000 | 32.822
12 | 4.180 | u_top/u_manual/wr_ptr_0_s0/Q | u_top/u_alloc/v_note_55_s0/CE | clk_27m:[R] | clk_27m:[R] | 37.037 | 0.000 | 32.822
13 | 4.354 | u_top/u_manual/wr_ptr_0_s0/Q | u_top/u_alloc/v_note_28_s0/CE | clk_27m:[R] | clk_27m:[R] | 37.037 | 0.000 | 32.648
14 | 4.375 | u_top/u_manual/wr_ptr_0_s0/Q | u_top/u_alloc/v_note_51_s0/CE | clk_27m:[R] | clk_27m:[R] | 37.037 | 0.000 | 32.627
15 | 4.439 | u_top/u_manual/wr_ptr_0_s0/Q | u_top/u_alloc/v_note_41_s0/CE | clk_27m:[R] | clk_27m:[R] | 37.037 | 0.000 | 32.563
16 | 4.623 | u_top/u_manual/wr_ptr_0_s0/Q | u_top/u_alloc/v_note_35_s0/CE | clk_27m:[R] | clk_27m:[R] | 37.037 | 0.000 | 32.379
17 | 4.623 | u_top/u_manual/wr_ptr_0_s0/Q | u_top/u_alloc/v_note_36_s0/CE | clk_27m:[R] | clk_27m:[R] | 37.037 | 0.000 | 32.379
18 | 4.623 | u_top/u_manual/wr_ptr_0_s0/Q | u_top/u_alloc/v_note_38_s0/CE | clk_27m:[R] | clk_27m:[R] | 37.037 | 0.000 | 32.379
19 | 4.623 | u_top/u_manual/wr_ptr_0_s0/Q | u_top/u_alloc/v_note_39_s0/CE | clk_27m:[R] | clk_27m:[R] | 37.037 | 0.000 | 32.379
20 | 4.623 | u_top/u_manual/wr_ptr_0_s0/Q | u_top/u_alloc/v_note_40_s0/CE | clk_27m:[R] | clk_27m:[R] | 37.037 | 0.000 | 32.379
21 | 4.846 | u_top/u_manual/wr_ptr_0_s0/Q | u_top/u_alloc/v_note_37_s0/CE | clk_27m:[R] | clk_27m:[R] | 37.037 | 0.000 | 32.156
22 | 4.849 | u_top/u_manual/wr_ptr_0_s0/Q | u_top/u_alloc/v_note_43_s0/CE | clk_27m:[R] | clk_27m:[R] | 37.037 | 0.000 | 32.153
23 | 4.849 | u_top/u_manual/wr_ptr_0_s0/Q | u_top/u_alloc/v_note_44_s0/CE | clk_27m:[R] | clk_27m:[R] | 37.037 | 0.000 | 32.153
24 | 4.849 | u_top/u_manual/wr_ptr_0_s0/Q | u_top/u_alloc/v_note_45_s0/CE | clk_27m:[R] | clk_27m:[R] | 37.037 | 0.000 | 32.153
25 | 4.849 | u_top/u_manual/wr_ptr_0_s0/Q | u_top/u_alloc/v_note_46_s0/CE | clk_27m:[R] | clk_27m:[R] | 37.037 | 0.000 | 32.153

### Hold Paths Table

#### Report Command:report_timing -hold -max_paths 25 -max_common_paths 1

Path Number | Path Slack | From Node | To Node | From Clock | To Clock | Relation | Clock Skew | Data Delay
1 | 0.216 | u_top/u_engine/rom_addr_7_s0/Q | u_top/u_engine/g_banked.u_piano_rom/gp4/AD[11] | clk_27m:[R] | clk_27m:[R] | 0.000 | 0.000 | 0.334
2 | 0.318 | u_top/u_uart/reply_wr_ptr_2_s0/Q | u_top/u_uart/reply_queue_reply_queue_0_0_s/WAD[2] | clk_27m:[R] | clk_27m:[R] | 0.000 | 0.000 | 0.328
3 | 0.318 | u_top/u_uart/reply_wr_ptr_1_s0/Q | u_top/u_uart/reply_queue_reply_queue_0_0_s/WAD[1] | clk_27m:[R] | clk_27m:[R] | 0.000 | 0.000 | 0.328
4 | 0.323 | u_top/u_fifo/wr_ptr_1_s0/Q | u_top/u_fifo/mem_mem_0_1_s/WAD[1] | clk_27m:[R] | clk_27m:[R] | 0.000 | 0.000 | 0.333
5 | 0.328 | u_top/u_fifo/wr_ptr_2_s0/Q | u_top/u_fifo/mem_mem_0_1_s/WAD[2] | clk_27m:[R] | clk_27m:[R] | 0.000 | 0.000 | 0.338
6 | 0.334 | u_top/u_fifo/wr_ptr_3_s0/Q | u_top/u_fifo/mem_mem_0_1_s/WAD[3] | clk_27m:[R] | clk_27m:[R] | 0.000 | 0.000 | 0.344
7 | 0.334 | u_top/u_engine/rom_addr_3_s0/Q | u_top/u_engine/g_banked.u_piano_rom/gp4/AD[7] | clk_27m:[R] | clk_27m:[R] | 0.000 | 0.000 | 0.452
8 | 0.335 | u_top/u_engine/rom_addr_5_s0/Q | u_top/u_engine/g_banked.u_piano_rom/gp2/AD[9] | clk_27m:[R] | clk_27m:[R] | 0.000 | 0.000 | 0.453
9 | 0.336 | u_top/u_engine/rom_addr_6_s0/Q | u_top/u_engine/g_banked.u_piano_rom/gp4/AD[10] | clk_27m:[R] | clk_27m:[R] | 0.000 | 0.000 | 0.454
10 | 0.342 | u_top/u_engine/rom_addr_2_s0/Q | u_top/u_engine/g_banked.u_piano_rom/gp4/AD[6] | clk_27m:[R] | clk_27m:[R] | 0.000 | 0.000 | 0.460
11 | 0.346 | u_top/u_engine/rom_addr_8_s0/Q | u_top/u_engine/g_banked.u_piano_rom/gp2/AD[12] | clk_27m:[R] | clk_27m:[R] | 0.000 | 0.000 | 0.464
12 | 0.347 | u_top/u_engine/rom_addr_0_s0/Q | u_top/u_engine/g_banked.u_piano_rom/gp4/AD[4] | clk_27m:[R] | clk_27m:[R] | 0.000 | 0.000 | 0.465
13 | 0.347 | u_top/u_engine/rom_addr_0_s0/Q | u_top/u_engine/g_banked.u_piano_rom/gp2/AD[4] | clk_27m:[R] | clk_27m:[R] | 0.000 | 0.000 | 0.465
14 | 0.347 | u_top/u_engine/rom_addr_4_s0/Q | u_top/u_engine/g_banked.u_piano_rom/gp4/AD[8] | clk_27m:[R] | clk_27m:[R] | 0.000 | 0.000 | 0.465
15 | 0.349 | u_top/u_engine/rom_addr_1_s0/Q | u_top/u_engine/g_banked.u_piano_rom/gp4/AD[5] | clk_27m:[R] | clk_27m:[R] | 0.000 | 0.000 | 0.467
16 | 0.349 | u_top/u_engine/rom_addr_1_s0/Q | u_top/u_engine/g_banked.u_piano_rom/gp2/AD[5] | clk_27m:[R] | clk_27m:[R] | 0.000 | 0.000 | 0.467
17 | 0.350 | u_top/u_engine/rom_addr_8_s0/Q | u_top/u_engine/g_banked.u_piano_rom/gp4/AD[12] | clk_27m:[R] | clk_27m:[R] | 0.000 | 0.000 | 0.468
18 | 0.350 | u_top/u_engine/rom_addr_5_s0/Q | u_top/u_engine/g_banked.u_piano_rom/gp4/AD[9] | clk_27m:[R] | clk_27m:[R] | 0.000 | 0.000 | 0.468
19 | 0.359 | u_top/u_engine/rom_addr_5_s0/Q | u_top/u_engine/g_banked.u_piano_rom/gp6/AD[9] | clk_27m:[R] | clk_27m:[R] | 0.000 | 0.000 | 0.477
20 | 0.425 | u_top/g_pt8211.u_pt8211/b_cnt_0_s1/Q | u_top/g_pt8211.u_pt8211/b_cnt_0_s1/D | clk_27m:[R] | clk_27m:[R] | 0.000 | 0.000 | 0.436
21 | 0.425 | u_top/g_pt8211.u_pt8211/b_cnt_3_s0/Q | u_top/g_pt8211.u_pt8211/b_cnt_3_s0/D | clk_27m:[R] | clk_27m:[R] | 0.000 | 0.000 | 0.436
22 | 0.425 | u_top/g_pt8211.u_pt8211/div_cnt_0_s0/Q | u_top/g_pt8211.u_pt8211/div_cnt_0_s0/D | clk_27m:[R] | clk_27m:[R] | 0.000 | 0.000 | 0.436
23 | 0.425 | u_top/u_xf/clip_count_0_s0/Q | u_top/u_xf/clip_count_0_s0/D | clk_27m:[R] | clk_27m:[R] | 0.000 | 0.000 | 0.436
24 | 0.425 | u_top/u_xf/clip_count_2_s0/Q | u_top/u_xf/clip_count_2_s0/D | clk_27m:[R] | clk_27m:[R] | 0.000 | 0.000 | 0.436
25 | 0.425 | u_top/u_xf/clip_count_6_s0/Q | u_top/u_xf/clip_count_6_s0/D | clk_27m:[R] | clk_27m:[R] | 0.000 | 0.000 | 0.436

### Recovery Paths Table

#### Report Command:report_timing -recovery -max_paths 25 -max_common_paths 1

#### Nothing to report!

### Removal Paths Table

#### Report Command:report_timing -removal -max_paths 25 -max_common_paths 1

#### Nothing to report!

## Minimum Pulse Width Table:

Number | Slack | Actual Width | Required Width | Type | Clock | Objects

#### Report Command:report_min_pulse_width -nworst 10 -detail

1 | 15.833 | 16.833 | 1.000 | Low Pulse Width | clk_27m | u_top/reset_cnt_14_s0
2 | 15.833 | 16.833 | 1.000 | Low Pulse Width | clk_27m | u_top/reset_cnt_12_s0
3 | 15.833 | 16.833 | 1.000 | Low Pulse Width | clk_27m | u_top/reset_cnt_8_s0
4 | 15.833 | 16.833 | 1.000 | Low Pulse Width | clk_27m | u_top/reset_cnt_0_s0
5 | 15.833 | 16.833 | 1.000 | Low Pulse Width | clk_27m | u_top/mel_idx_d_5_s0
6 | 15.833 | 16.833 | 1.000 | Low Pulse Width | clk_27m | u_top/adc_start_s0
7 | 15.833 | 16.833 | 1.000 | Low Pulse Width | clk_27m | u_top/mix_lp_y_4_s0
8 | 15.833 | 16.833 | 1.000 | Low Pulse Width | clk_27m | u_top/g_host_kbd.u_host_kbd/u_uart/cnt_11_s1
9 | 15.833 | 16.833 | 1.000 | Low Pulse Width | clk_27m | u_top/g_host_kbd.u_host_kbd/u_map/cur_key_cur_key_RAMREG_0_G[2]_s0
10 | 15.833 | 16.833 | 1.000 | Low Pulse Width | clk_27m | u_top/u_uart/reply_count_1_s1

## Timing Report By Analysis Type:

### Setup Analysis Report

#### Report Command:report_timing -setup -max_paths 25 -max_common_paths 1

### Path1

Path Summary:

Slack | 3.788
Data Arrival Time | 37.573
Data Required Time | 41.361
From | u_top/u_manual/wr_ptr_0_s0
To | u_top/u_alloc/v_note_29_s0
Launch Clk | clk_27m:[R]
Latch Clk | clk_27m:[R]

Data Arrival Path:

AT | DELAY | TYPE | RF | FANOUT | LOC | NODE
0.000 | 0.000 | | | | | active clock edge time
0.000 | 0.000 | | | | | clk_27m
0.000 | 0.000 | tCL | RR | 1 | IOT27[A] | clk_27m_ibuf/I
2.088 | 2.088 | tINS | RR | 3750 | IOT27[A] | clk_27m_ibuf/O
4.359 | 2.271 | tNET | RR | 1 | R42C49[1][A] | u_top/u_manual/wr_ptr_0_s0/CLK
4.591 | 0.232 | tC2Q | RF | 7 | R42C49[1][A] | u_top/u_manual/wr_ptr_0_s0/Q
5.021 | 0.430 | tNET | FF | 2 | R42C46[0][B] | u_top/u_manual/n4_s0/I0
5.570 | 0.549 | tINS | FR | 1 | R42C46[0][B] | u_top/u_manual/n4_s0/COUT
5.570 | 0.000 | tNET | RR | 2 | R42C46[1][A] | u_top/u_manual/n5_s0/CIN
5.606 | 0.035 | tINS | RF | 1 | R42C46[1][A] | u_top/u_manual/n5_s0/COUT
5.606 | 0.000 | tNET | FF | 2 | R42C46[1][B] | u_top/u_manual/n6_s0/CIN
5.641 | 0.035 | tINS | FF | 1 | R42C46[1][B] | u_top/u_manual/n6_s0/COUT
5.641 | 0.000 | tNET | FF | 2 | R42C46[2][A] | u_top/u_manual/n7_s0/CIN
5.676 | 0.035 | tINS | FF | 1 | R42C46[2][A] | u_top/u_manual/n7_s0/COUT
5.676 | 0.000 | tNET | FF | 2 | R42C46[2][B] | u_top/u_manual/n8_s0/CIN
5.711 | 0.035 | tINS | FF | 17 | R42C46[2][B] | u_top/u_manual/n8_s0/COUT
7.859 | 2.148 | tNET | FF | 1 | R36C44[1][A] | u_top/ev_word_11_s2/I2
8.376 | 0.517 | tINS | FF | 1 | R36C44[1][A] | u_top/ev_word_11_s2/F
9.032 | 0.656 | tNET | FF | 1 | R36C41[3][A] | u_top/ev_word_11_s1/I1
9.494 | 0.462 | tINS | FR | 1 | R36C41[3][A] | u_top/ev_word_11_s1/F
9.495 | 0.001 | tNET | RR | 1 | R36C41[1][B] | u_top/ev_word_11_s0/I0
9.948 | 0.453 | tINS | RF | 40 | R36C41[1][B] | u_top/ev_word_11_s0/F
15.910 | 5.961 | tNET | FF | 2 | R8C23[1][B] | u_top/u_alloc/n51_s0/I1
16.480 | 0.570 | tINS | FR | 1 | R8C23[1][B] | u_top/u_alloc/n51_s0/COUT
16.480 | 0.000 | tNET | RR | 2 | R8C23[2][A] | u_top/u_alloc/n52_s0/CIN
16.515 | 0.035 | tINS | RF | 1 | R8C23[2][A] | u_top/u_alloc/n52_s0/COUT
16.515 | 0.000 | tNET | FF | 2 | R8C23[2][B] | u_top/u_alloc/n53_s0/CIN
16.550 | 0.035 | tINS | FF | 1 | R8C23[2][B] | u_top/u_alloc/n53_s0/COUT
16.550 | 0.000 | tNET | FF | 2 | R8C24[0][A] | u_top/u_alloc/n54_s0/CIN
16.585 | 0.035 | tINS | FF | 3 | R8C24[0][A] | u_top/u_alloc/n54_s0/COUT
17.555 | 0.970 | tNET | FF | 1 | R12C24[1][B] | u_top/u_alloc/pick_2_s60/I0
18.008 | 0.453 | tINS | FF | 3 | R12C24[1][B] | u_top/u_alloc/pick_2_s60/F
18.197 | 0.189 | tNET | FF | 1 | R12C23[3][A] | u_top/u_alloc/pick_0_s61/I1
18.746 | 0.549 | tINS | FR | 3 | R12C23[3][A] | u_top/u_alloc/pick_0_s61/F
18.750 | 0.004 | tNET | RR | 1 | R12C23[2][A] | u_top/u_alloc/pick_2_s101/I2
19.212 | 0.462 | tINS | RR | 1 | R12C23[2][A] | u_top/u_alloc/pick_2_s101/F
19.384 | 0.172 | tNET | RR | 1 | R12C24[3][B] | u_top/u_alloc/pick_2_s85/I0
19.837 | 0.453 | tINS | RF | 4 | R12C24[3][B] | u_top/u_alloc/pick_2_s85/F
20.764 | 0.927 | tNET | FF | 1 | R13C19[3][A] | u_top/u_alloc/pick_2_s62/I3
21.313 | 0.549 | tINS | FR | 3 | R13C19[3][A] | u_top/u_alloc/pick_2_s62/F
21.317 | 0.004 | tNET | RR | 1 | R13C19[0][B] | u_top/u_alloc/pick_2_s84/I1
21.770 | 0.453 | tINS | RF | 1 | R13C19[0][B] | u_top/u_alloc/pick_2_s84/F
22.183 | 0.413 | tNET | FF | 1 | R14C18[0][A] | u_top/u_alloc/pick_2_s58/I2
22.732 | 0.549 | tINS | FR | 1 | R14C18[0][A] | u_top/u_alloc/pick_2_s58/F
22.905 | 0.172 | tNET | RR | 1 | R14C17[2][A] | u_top/u_alloc/pick_2_s118/I3
23.276 | 0.371 | tINS | RF | 2 | R14C17[2][A] | u_top/u_alloc/pick_2_s118/F
23.689 | 0.413 | tNET | FF | 1 | R13C16[3][A] | u_top/u_alloc/pick_2_s8/I3
24.244 | 0.555 | tINS | FF | 7 | R13C16[3][A] | u_top/u_alloc/pick_2_s8/F
25.319 | 1.075 | tNET | FF | 1 | R12C21[2][B] | u_top/u_alloc/pick_1_s12/I1
25.889 | 0.570 | tINS | FR | 1 | R12C21[2][B] | u_top/u_alloc/pick_1_s12/F
25.890 | 0.001 | tNET | RR | 1 | R12C21[3][A] | u_top/u_alloc/pick_1_s6/I3
26.439 | 0.549 | tINS | RR | 1 | R12C21[3][A] | u_top/u_alloc/pick_1_s6/F
26.611 | 0.172 | tNET | RR | 1 | R12C20[1][B] | u_top/u_alloc/pick_1_s2/I1
27.166 | 0.555 | tINS | RF | 9 | R12C20[1][B] | u_top/u_alloc/pick_1_s2/F
28.325 | 1.159 | tNET | FF | 1 | R7C20[0][A] | u_top/u_alloc/pick_1_s43/I3
28.842 | 0.517 | tINS | FF | 12 | R7C20[0][A] | u_top/u_alloc/pick_1_s43/F
30.057 | 1.215 | tNET | FF | 18 | DSP_R19[1][A] | u_top/u_alloc/n453_s1/B[1]
33.697 | 3.640 | tINS | FF | 8 | DSP_R19[1][A] | u_top/u_alloc/n453_s1/DOUT[6]
36.291 | 2.595 | tNET | FF | 1 | R9C27[1][B] | u_top/u_alloc/n3434_s1/I0
36.861 | 0.570 | tINS | FR | 7 | R9C27[1][B] | u_top/u_alloc/n3434_s1/F
37.573 | 0.712 | tNET | RR | 1 | R8C30[0][B] | u_top/u_alloc/v_note_29_s0/CE

Data Required Path:

AT | DELAY | TYPE | RF | FANOUT | LOC | NODE
37.037 | 37.037 | | | | | active clock edge time
37.037 | 0.000 | | | | | clk_27m
37.037 | 0.000 | tCL | RR | 1 | IOT27[A] | clk_27m_ibuf/I
39.125 | 2.088 | tINS | RR | 3750 | IOT27[A] | clk_27m_ibuf/O
41.396 | 2.271 | tNET | RR | 1 | R8C30[0][B] | u_top/u_alloc/v_note_29_s0/CLK
41.361 | -0.035 | tSu | | 1 | R8C30[0][B] | u_top/u_alloc/v_note_29_s0

Path Statistics:

Clock Skew | 0.000
Setup Relationship | 37.037
Logic Level | 24
Arrival Clock Path Delay | cell: 2.088, 47.897%; route: 2.271, 52.103%
Arrival Data Path Delay | cell: 13.592, 40.924%; route: 19.390, 58.378%; tC2Q: 0.232, 0.699%
Required Clock Path Delay | cell: 2.088, 47.897%; route: 2.271, 52.103%

### Path2

Path Summary:

Slack | 3.788
Data Arrival Time | 37.573
Data Required Time | 41.361
From | u_top/u_manual/wr_ptr_0_s0
To | u_top/u_alloc/v_note_30_s0
Launch Clk | clk_27m:[R]
Latch Clk | clk_27m:[R]

Data Arrival Path:

AT | DELAY | TYPE | RF | FANOUT | LOC | NODE
0.000 | 0.000 | | | | | active clock edge time
0.000 | 0.000 | | | | | clk_27m
0.000 | 0.000 | tCL | RR | 1 | IOT27[A] | clk_27m_ibuf/I
2.088 | 2.088 | tINS | RR | 3750 | IOT27[A] | clk_27m_ibuf/O
4.359 | 2.271 | tNET | RR | 1 | R42C49[1][A] | u_top/u_manual/wr_ptr_0_s0/CLK
4.591 | 0.232 | tC2Q | RF | 7 | R42C49[1][A] | u_top/u_manual/wr_ptr_0_s0/Q
5.021 | 0.430 | tNET | FF | 2 | R42C46[0][B] | u_top/u_manual/n4_s0/I0
5.570 | 0.549 | tINS | FR | 1 | R42C46[0][B] | u_top/u_manual/n4_s0/COUT
5.570 | 0.000 | tNET | RR | 2 | R42C46[1][A] | u_top/u_manual/n5_s0/CIN
5.606 | 0.035 | tINS | RF | 1 | R42C46[1][A] | u_top/u_manual/n5_s0/COUT
5.606 | 0.000 | tNET | FF | 2 | R42C46[1][B] | u_top/u_manual/n6_s0/CIN
5.641 | 0.035 | tINS | FF | 1 | R42C46[1][B] | u_top/u_manual/n6_s0/COUT
5.641 | 0.000 | tNET | FF | 2 | R42C46[2][A] | u_top/u_manual/n7_s0/CIN
5.676 | 0.035 | tINS | FF | 1 | R42C46[2][A] | u_top/u_manual/n7_s0/COUT
5.676 | 0.000 | tNET | FF | 2 | R42C46[2][B] | u_top/u_manual/n8_s0/CIN
5.711 | 0.035 | tINS | FF | 17 | R42C46[2][B] | u_top/u_manual/n8_s0/COUT
7.859 | 2.148 | tNET | FF | 1 | R36C44[1][A] | u_top/ev_word_11_s2/I2
8.376 | 0.517 | tINS | FF | 1 | R36C44[1][A] | u_top/ev_word_11_s2/F
9.032 | 0.656 | tNET | FF | 1 | R36C41[3][A] | u_top/ev_word_11_s1/I1
9.494 | 0.462 | tINS | FR | 1 | R36C41[3][A] | u_top/ev_word_11_s1/F
9.495 | 0.001 | tNET | RR | 1 | R36C41[1][B] | u_top/ev_word_11_s0/I0
9.948 | 0.453 | tINS | RF | 40 | R36C41[1][B] | u_top/ev_word_11_s0/F
15.910 | 5.961 | tNET | FF | 2 | R8C23[1][B] | u_top/u_alloc/n51_s0/I1
16.480 | 0.570 | tINS | FR | 1 | R8C23[1][B] | u_top/u_alloc/n51_s0/COUT
16.480 | 0.000 | tNET | RR | 2 | R8C23[2][A] | u_top/u_alloc/n52_s0/CIN
16.515 | 0.035 | tINS | RF | 1 | R8C23[2][A] | u_top/u_alloc/n52_s0/COUT
16.515 | 0.000 | tNET | FF | 2 | R8C23[2][B] | u_top/u_alloc/n53_s0/CIN
16.550 | 0.035 | tINS | FF | 1 | R8C23[2][B] | u_top/u_alloc/n53_s0/COUT
16.550 | 0.000 | tNET | FF | 2 | R8C24[0][A] | u_top/u_alloc/n54_s0/CIN
16.585 | 0.035 | tINS | FF | 3 | R8C24[0][A] | u_top/u_alloc/n54_s0/COUT
17.555 | 0.970 | tNET | FF | 1 | R12C24[1][B] | u_top/u_alloc/pick_2_s60/I0
18.008 | 0.453 | tINS | FF | 3 | R12C24[1][B] | u_top/u_alloc/pick_2_s60/F
18.197 | 0.189 | tNET | FF | 1 | R12C23[3][A] | u_top/u_alloc/pick_0_s61/I1
18.746 | 0.549 | tINS | FR | 3 | R12C23[3][A] | u_top/u_alloc/pick_0_s61/F
18.750 | 0.004 | tNET | RR | 1 | R12C23[2][A] | u_top/u_alloc/pick_2_s101/I2
19.212 | 0.462 | tINS | RR | 1 | R12C23[2][A] | u_top/u_alloc/pick_2_s101/F
19.384 | 0.172 | tNET | RR | 1 | R12C24[3][B] | u_top/u_alloc/pick_2_s85/I0
19.837 | 0.453 | tINS | RF | 4 | R12C24[3][B] | u_top/u_alloc/pick_2_s85/F
20.764 | 0.927 | tNET | FF | 1 | R13C19[3][A] | u_top/u_alloc/pick_2_s62/I3
21.313 | 0.549 | tINS | FR | 3 | R13C19[3][A] | u_top/u_alloc/pick_2_s62/F
21.317 | 0.004 | tNET | RR | 1 | R13C19[0][B] | u_top/u_alloc/pick_2_s84/I1
21.770 | 0.453 | tINS | RF | 1 | R13C19[0][B] | u_top/u_alloc/pick_2_s84/F
22.183 | 0.413 | tNET | FF | 1 | R14C18[0][A] | u_top/u_alloc/pick_2_s58/I2
22.732 | 0.549 | tINS | FR | 1 | R14C18[0][A] | u_top/u_alloc/pick_2_s58/F
22.905 | 0.172 | tNET | RR | 1 | R14C17[2][A] | u_top/u_alloc/pick_2_s118/I3
23.276 | 0.371 | tINS | RF | 2 | R14C17[2][A] | u_top/u_alloc/pick_2_s118/F
23.689 | 0.413 | tNET | FF | 1 | R13C16[3][A] | u_top/u_alloc/pick_2_s8/I3
24.244 | 0.555 | tINS | FF | 7 | R13C16[3][A] | u_top/u_alloc/pick_2_s8/F
25.319 | 1.075 | tNET | FF | 1 | R12C21[2][B] | u_top/u_alloc/pick_1_s12/I1
25.889 | 0.570 | tINS | FR | 1 | R12C21[2][B] | u_top/u_alloc/pick_1_s12/F
25.890 | 0.001 | tNET | RR | 1 | R12C21[3][A] | u_top/u_alloc/pick_1_s6/I3
26.439 | 0.549 | tINS | RR | 1 | R12C21[3][A] | u_top/u_alloc/pick_1_s6/F
26.611 | 0.172 | tNET | RR | 1 | R12C20[1][B] | u_top/u_alloc/pick_1_s2/I1
27.166 | 0.555 | tINS | RF | 9 | R12C20[1][B] | u_top/u_alloc/pick_1_s2/F
28.325 | 1.159 | tNET | FF | 1 | R7C20[0][A] | u_top/u_alloc/pick_1_s43/I3
28.842 | 0.517 | tINS | FF | 12 | R7C20[0][A] | u_top/u_alloc/pick_1_s43/F
30.057 | 1.215 | tNET | FF | 18 | DSP_R19[1][A] | u_top/u_alloc/n453_s1/B[1]
33.697 | 3.640 | tINS | FF | 8 | DSP_R19[1][A] | u_top/u_alloc/n453_s1/DOUT[6]
36.291 | 2.595 | tNET | FF | 1 | R9C27[1][B] | u_top/u_alloc/n3434_s1/I0
36.861 | 0.570 | tINS | FR | 7 | R9C27[1][B] | u_top/u_alloc/n3434_s1/F
37.573 | 0.712 | tNET | RR | 1 | R8C30[1][A] | u_top/u_alloc/v_note_30_s0/CE

Data Required Path:

AT | DELAY | TYPE | RF | FANOUT | LOC | NODE
37.037 | 37.037 | | | | | active clock edge time
37.037 | 0.000 | | | | | clk_27m
37.037 | 0.000 | tCL | RR | 1 | IOT27[A] | clk_27m_ibuf/I
39.125 | 2.088 | tINS | RR | 3750 | IOT27[A] | clk_27m_ibuf/O
41.396 | 2.271 | tNET | RR | 1 | R8C30[1][A] | u_top/u_alloc/v_note_30_s0/CLK
41.361 | -0.035 | tSu | | 1 | R8C30[1][A] | u_top/u_alloc/v_note_30_s0

Path Statistics:

Clock Skew | 0.000
Setup Relationship | 37.037
Logic Level | 24
Arrival Clock Path Delay | cell: 2.088, 47.897%; route: 2.271, 52.103%
Arrival Data Path Delay | cell: 13.592, 40.924%; route: 19.390, 58.378%; tC2Q: 0.232, 0.699%
Required Clock Path Delay | cell: 2.088, 47.897%; route: 2.271, 52.103%

### Path3

Path Summary:

Slack | 3.788
Data Arrival Time | 37.573
Data Required Time | 41.361
From | u_top/u_manual/wr_ptr_0_s0
To | u_top/u_alloc/v_note_31_s0
Launch Clk | clk_27m:[R]
Latch Clk | clk_27m:[R]

Data Arrival Path:

AT | DELAY | TYPE | RF | FANOUT | LOC | NODE
0.000 | 0.000 | | | | | active clock edge time
0.000 | 0.000 | | | | | clk_27m
0.000 | 0.000 | tCL | RR | 1 | IOT27[A] | clk_27m_ibuf/I
2.088 | 2.088 | tINS | RR | 3750 | IOT27[A] | clk_27m_ibuf/O
4.359 | 2.271 | tNET | RR | 1 | R42C49[1][A] | u_top/u_manual/wr_ptr_0_s0/CLK
4.591 | 0.232 | tC2Q | RF | 7 | R42C49[1][A] | u_top/u_manual/wr_ptr_0_s0/Q
5.021 | 0.430 | tNET | FF | 2 | R42C46[0][B] | u_top/u_manual/n4_s0/I0
5.570 | 0.549 | tINS | FR | 1 | R42C46[0][B] | u_top/u_manual/n4_s0/COUT
5.570 | 0.000 | tNET | RR | 2 | R42C46[1][A] | u_top/u_manual/n5_s0/CIN
5.606 | 0.035 | tINS | RF | 1 | R42C46[1][A] | u_top/u_manual/n5_s0/COUT
5.606 | 0.000 | tNET | FF | 2 | R42C46[1][B] | u_top/u_manual/n6_s0/CIN
5.641 | 0.035 | tINS | FF | 1 | R42C46[1][B] | u_top/u_manual/n6_s0/COUT
5.641 | 0.000 | tNET | FF | 2 | R42C46[2][A] | u_top/u_manual/n7_s0/CIN
5.676 | 0.035 | tINS | FF | 1 | R42C46[2][A] | u_top/u_manual/n7_s0/COUT
5.676 | 0.000 | tNET | FF | 2 | R42C46[2][B] | u_top/u_manual/n8_s0/CIN
5.711 | 0.035 | tINS | FF | 17 | R42C46[2][B] | u_top/u_manual/n8_s0/COUT
7.859 | 2.148 | tNET | FF | 1 | R36C44[1][A] | u_top/ev_word_11_s2/I2
8.376 | 0.517 | tINS | FF | 1 | R36C44[1][A] | u_top/ev_word_11_s2/F
9.032 | 0.656 | tNET | FF | 1 | R36C41[3][A] | u_top/ev_word_11_s1/I1
9.494 | 0.462 | tINS | FR | 1 | R36C41[3][A] | u_top/ev_word_11_s1/F
9.495 | 0.001 | tNET | RR | 1 | R36C41[1][B] | u_top/ev_word_11_s0/I0
9.948 | 0.453 | tINS | RF | 40 | R36C41[1][B] | u_top/ev_word_11_s0/F
15.910 | 5.961 | tNET | FF | 2 | R8C23[1][B] | u_top/u_alloc/n51_s0/I1
16.480 | 0.570 | tINS | FR | 1 | R8C23[1][B] | u_top/u_alloc/n51_s0/COUT
16.480 | 0.000 | tNET | RR | 2 | R8C23[2][A] | u_top/u_alloc/n52_s0/CIN
16.515 | 0.035 | tINS | RF | 1 | R8C23[2][A] | u_top/u_alloc/n52_s0/COUT
16.515 | 0.000 | tNET | FF | 2 | R8C23[2][B] | u_top/u_alloc/n53_s0/CIN
16.550 | 0.035 | tINS | FF | 1 | R8C23[2][B] | u_top/u_alloc/n53_s0/COUT
16.550 | 0.000 | tNET | FF | 2 | R8C24[0][A] | u_top/u_alloc/n54_s0/CIN
16.585 | 0.035 | tINS | FF | 3 | R8C24[0][A] | u_top/u_alloc/n54_s0/COUT
17.555 | 0.970 | tNET | FF | 1 | R12C24[1][B] | u_top/u_alloc/pick_2_s60/I0
18.008 | 0.453 | tINS | FF | 3 | R12C24[1][B] | u_top/u_alloc/pick_2_s60/F
18.197 | 0.189 | tNET | FF | 1 | R12C23[3][A] | u_top/u_alloc/pick_0_s61/I1
18.746 | 0.549 | tINS | FR | 3 | R12C23[3][A] | u_top/u_alloc/pick_0_s61/F
18.750 | 0.004 | tNET | RR | 1 | R12C23[2][A] | u_top/u_alloc/pick_2_s101/I2
19.212 | 0.462 | tINS | RR | 1 | R12C23[2][A] | u_top/u_alloc/pick_2_s101/F
19.384 | 0.172 | tNET | RR | 1 | R12C24[3][B] | u_top/u_alloc/pick_2_s85/I0
19.837 | 0.453 | tINS | RF | 4 | R12C24[3][B] | u_top/u_alloc/pick_2_s85/F
20.764 | 0.927 | tNET | FF | 1 | R13C19[3][A] | u_top/u_alloc/pick_2_s62/I3
21.313 | 0.549 | tINS | FR | 3 | R13C19[3][A] | u_top/u_alloc/pick_2_s62/F
21.317 | 0.004 | tNET | RR | 1 | R13C19[0][B] | u_top/u_alloc/pick_2_s84/I1
21.770 | 0.453 | tINS | RF | 1 | R13C19[0][B] | u_top/u_alloc/pick_2_s84/F
22.183 | 0.413 | tNET | FF | 1 | R14C18[0][A] | u_top/u_alloc/pick_2_s58/I2
22.732 | 0.549 | tINS | FR | 1 | R14C18[0][A] | u_top/u_alloc/pick_2_s58/F
22.905 | 0.172 | tNET | RR | 1 | R14C17[2][A] | u_top/u_alloc/pick_2_s118/I3
23.276 | 0.371 | tINS | RF | 2 | R14C17[2][A] | u_top/u_alloc/pick_2_s118/F
23.689 | 0.413 | tNET | FF | 1 | R13C16[3][A] | u_top/u_alloc/pick_2_s8/I3
24.244 | 0.555 | tINS | FF | 7 | R13C16[3][A] | u_top/u_alloc/pick_2_s8/F
25.319 | 1.075 | tNET | FF | 1 | R12C21[2][B] | u_top/u_alloc/pick_1_s12/I1
25.889 | 0.570 | tINS | FR | 1 | R12C21[2][B] | u_top/u_alloc/pick_1_s12/F
25.890 | 0.001 | tNET | RR | 1 | R12C21[3][A] | u_top/u_alloc/pick_1_s6/I3
26.439 | 0.549 | tINS | RR | 1 | R12C21[3][A] | u_top/u_alloc/pick_1_s6/F
26.611 | 0.172 | tNET | RR | 1 | R12C20[1][B] | u_top/u_alloc/pick_1_s2/I1
27.166 | 0.555 | tINS | RF | 9 | R12C20[1][B] | u_top/u_alloc/pick_1_s2/F
28.325 | 1.159 | tNET | FF | 1 | R7C20[0][A] | u_top/u_alloc/pick_1_s43/I3
28.842 | 0.517 | tINS | FF | 12 | R7C20[0][A] | u_top/u_alloc/pick_1_s43/F
30.057 | 1.215 | tNET | FF | 18 | DSP_R19[1][A] | u_top/u_alloc/n453_s1/B[1]
33.697 | 3.640 | tINS | FF | 8 | DSP_R19[1][A] | u_top/u_alloc/n453_s1/DOUT[6]
36.291 | 2.595 | tNET | FF | 1 | R9C27[1][B] | u_top/u_alloc/n3434_s1/I0
36.861 | 0.570 | tINS | FR | 7 | R9C27[1][B] | u_top/u_alloc/n3434_s1/F
37.573 | 0.712 | tNET | RR | 1 | R8C30[1][B] | u_top/u_alloc/v_note_31_s0/CE

Data Required Path:

AT | DELAY | TYPE | RF | FANOUT | LOC | NODE
37.037 | 37.037 | | | | | active clock edge time
37.037 | 0.000 | | | | | clk_27m
37.037 | 0.000 | tCL | RR | 1 | IOT27[A] | clk_27m_ibuf/I
39.125 | 2.088 | tINS | RR | 3750 | IOT27[A] | clk_27m_ibuf/O
41.396 | 2.271 | tNET | RR | 1 | R8C30[1][B] | u_top/u_alloc/v_note_31_s0/CLK
41.361 | -0.035 | tSu | | 1 | R8C30[1][B] | u_top/u_alloc/v_note_31_s0

Path Statistics:

Clock Skew | 0.000
Setup Relationship | 37.037
Logic Level | 24
Arrival Clock Path Delay | cell: 2.088, 47.897%; route: 2.271, 52.103%
Arrival Data Path Delay | cell: 13.592, 40.924%; route: 19.390, 58.378%; tC2Q: 0.232, 0.699%
Required Clock Path Delay | cell: 2.088, 47.897%; route: 2.271, 52.103%

### Path4

Path Summary:

Slack | 3.788
Data Arrival Time | 37.573
Data Required Time | 41.361
From | u_top/u_manual/wr_ptr_0_s0
To | u_top/u_alloc/v_note_32_s0
Launch Clk | clk_27m:[R]
Latch Clk | clk_27m:[R]

Data Arrival Path:

AT | DELAY | TYPE | RF | FANOUT | LOC | NODE
0.000 | 0.000 | | | | | active clock edge time
0.000 | 0.000 | | | | | clk_27m
0.000 | 0.000 | tCL | RR | 1 | IOT27[A] | clk_27m_ibuf/I
2.088 | 2.088 | tINS | RR | 3750 | IOT27[A] | clk_27m_ibuf/O
4.359 | 2.271 | tNET | RR | 1 | R42C49[1][A] | u_top/u_manual/wr_ptr_0_s0/CLK
4.591 | 0.232 | tC2Q | RF | 7 | R42C49[1][A] | u_top/u_manual/wr_ptr_0_s0/Q
5.021 | 0.430 | tNET | FF | 2 | R42C46[0][B] | u_top/u_manual/n4_s0/I0
5.570 | 0.549 | tINS | FR | 1 | R42C46[0][B] | u_top/u_manual/n4_s0/COUT
5.570 | 0.000 | tNET | RR | 2 | R42C46[1][A] | u_top/u_manual/n5_s0/CIN
5.606 | 0.035 | tINS | RF | 1 | R42C46[1][A] | u_top/u_manual/n5_s0/COUT
5.606 | 0.000 | tNET | FF | 2 | R42C46[1][B] | u_top/u_manual/n6_s0/CIN
5.641 | 0.035 | tINS | FF | 1 | R42C46[1][B] | u_top/u_manual/n6_s0/COUT
5.641 | 0.000 | tNET | FF | 2 | R42C46[2][A] | u_top/u_manual/n7_s0/CIN
5.676 | 0.035 | tINS | FF | 1 | R42C46[2][A] | u_top/u_manual/n7_s0/COUT
5.676 | 0.000 | tNET | FF | 2 | R42C46[2][B] | u_top/u_manual/n8_s0/CIN
5.711 | 0.035 | tINS | FF | 17 | R42C46[2][B] | u_top/u_manual/n8_s0/COUT
7.859 | 2.148 | tNET | FF | 1 | R36C44[1][A] | u_top/ev_word_11_s2/I2
8.376 | 0.517 | tINS | FF | 1 | R36C44[1][A] | u_top/ev_word_11_s2/F
9.032 | 0.656 | tNET | FF | 1 | R36C41[3][A] | u_top/ev_word_11_s1/I1
9.494 | 0.462 | tINS | FR | 1 | R36C41[3][A] | u_top/ev_word_11_s1/F
9.495 | 0.001 | tNET | RR | 1 | R36C41[1][B] | u_top/ev_word_11_s0/I0
9.948 | 0.453 | tINS | RF | 40 | R36C41[1][B] | u_top/ev_word_11_s0/F
15.910 | 5.961 | tNET | FF | 2 | R8C23[1][B] | u_top/u_alloc/n51_s0/I1
16.480 | 0.570 | tINS | FR | 1 | R8C23[1][B] | u_top/u_alloc/n51_s0/COUT
16.480 | 0.000 | tNET | RR | 2 | R8C23[2][A] | u_top/u_alloc/n52_s0/CIN
16.515 | 0.035 | tINS | RF | 1 | R8C23[2][A] | u_top/u_alloc/n52_s0/COUT
16.515 | 0.000 | tNET | FF | 2 | R8C23[2][B] | u_top/u_alloc/n53_s0/CIN
16.550 | 0.035 | tINS | FF | 1 | R8C23[2][B] | u_top/u_alloc/n53_s0/COUT
16.550 | 0.000 | tNET | FF | 2 | R8C24[0][A] | u_top/u_alloc/n54_s0/CIN
16.585 | 0.035 | tINS | FF | 3 | R8C24[0][A] | u_top/u_alloc/n54_s0/COUT
17.555 | 0.970 | tNET | FF | 1 | R12C24[1][B] | u_top/u_alloc/pick_2_s60/I0
18.008 | 0.453 | tINS | FF | 3 | R12C24[1][B] | u_top/u_alloc/pick_2_s60/F
18.197 | 0.189 | tNET | FF | 1 | R12C23[3][A] | u_top/u_alloc/pick_0_s61/I1
18.746 | 0.549 | tINS | FR | 3 | R12C23[3][A] | u_top/u_alloc/pick_0_s61/F
18.750 | 0.004 | tNET | RR | 1 | R12C23[2][A] | u_top/u_alloc/pick_2_s101/I2
19.212 | 0.462 | tINS | RR | 1 | R12C23[2][A] | u_top/u_alloc/pick_2_s101/F
19.384 | 0.172 | tNET | RR | 1 | R12C24[3][B] | u_top/u_alloc/pick_2_s85/I0
19.837 | 0.453 | tINS | RF | 4 | R12C24[3][B] | u_top/u_alloc/pick_2_s85/F
20.764 | 0.927 | tNET | FF | 1 | R13C19[3][A] | u_top/u_alloc/pick_2_s62/I3
21.313 | 0.549 | tINS | FR | 3 | R13C19[3][A] | u_top/u_alloc/pick_2_s62/F
21.317 | 0.004 | tNET | RR | 1 | R13C19[0][B] | u_top/u_alloc/pick_2_s84/I1
21.770 | 0.453 | tINS | RF | 1 | R13C19[0][B] | u_top/u_alloc/pick_2_s84/F
22.183 | 0.413 | tNET | FF | 1 | R14C18[0][A] | u_top/u_alloc/pick_2_s58/I2
22.732 | 0.549 | tINS | FR | 1 | R14C18[0][A] | u_top/u_alloc/pick_2_s58/F
22.905 | 0.172 | tNET | RR | 1 | R14C17[2][A] | u_top/u_alloc/pick_2_s118/I3
23.276 | 0.371 | tINS | RF | 2 | R14C17[2][A] | u_top/u_alloc/pick_2_s118/F
23.689 | 0.413 | tNET | FF | 1 | R13C16[3][A] | u_top/u_alloc/pick_2_s8/I3
24.244 | 0.555 | tINS | FF | 7 | R13C16[3][A] | u_top/u_alloc/pick_2_s8/F
25.319 | 1.075 | tNET | FF | 1 | R12C21[2][B] | u_top/u_alloc/pick_1_s12/I1
25.889 | 0.570 | tINS | FR | 1 | R12C21[2][B] | u_top/u_alloc/pick_1_s12/F
25.890 | 0.001 | tNET | RR | 1 | R12C21[3][A] | u_top/u_alloc/pick_1_s6/I3
26.439 | 0.549 | tINS | RR | 1 | R12C21[3][A] | u_top/u_alloc/pick_1_s6/F
26.611 | 0.172 | tNET | RR | 1 | R12C20[1][B] | u_top/u_alloc/pick_1_s2/I1
27.166 | 0.555 | tINS | RF | 9 | R12C20[1][B] | u_top/u_alloc/pick_1_s2/F
28.325 | 1.159 | tNET | FF | 1 | R7C20[0][A] | u_top/u_alloc/pick_1_s43/I3
28.842 | 0.517 | tINS | FF | 12 | R7C20[0][A] | u_top/u_alloc/pick_1_s43/F
30.057 | 1.215 | tNET | FF | 18 | DSP_R19[1][A] | u_top/u_alloc/n453_s1/B[1]
33.697 | 3.640 | tINS | FF | 8 | DSP_R19[1][A] | u_top/u_alloc/n453_s1/DOUT[6]
36.291 | 2.595 | tNET | FF | 1 | R9C27[1][B] | u_top/u_alloc/n3434_s1/I0
36.861 | 0.570 | tINS | FR | 7 | R9C27[1][B] | u_top/u_alloc/n3434_s1/F
37.573 | 0.712 | tNET | RR | 1 | R8C30[2][A] | u_top/u_alloc/v_note_32_s0/CE

Data Required Path:

AT | DELAY | TYPE | RF | FANOUT | LOC | NODE
37.037 | 37.037 | | | | | active clock edge time
37.037 | 0.000 | | | | | clk_27m
37.037 | 0.000 | tCL | RR | 1 | IOT27[A] | clk_27m_ibuf/I
39.125 | 2.088 | tINS | RR | 3750 | IOT27[A] | clk_27m_ibuf/O
41.396 | 2.271 | tNET | RR | 1 | R8C30[2][A] | u_top/u_alloc/v_note_32_s0/CLK
41.361 | -0.035 | tSu | | 1 | R8C30[2][A] | u_top/u_alloc/v_note_32_s0

Path Statistics:

Clock Skew | 0.000
Setup Relationship | 37.037
Logic Level | 24
Arrival Clock Path Delay | cell: 2.088, 47.897%; route: 2.271, 52.103%
Arrival Data Path Delay | cell: 13.592, 40.924%; route: 19.390, 58.378%; tC2Q: 0.232, 0.699%
Required Clock Path Delay | cell: 2.088, 47.897%; route: 2.271, 52.103%

### Path5

Path Summary:

Slack | 4.167
Data Arrival Time | 37.194
Data Required Time | 41.361
From | u_top/u_manual/wr_ptr_0_s0
To | u_top/u_alloc/v_note_33_s0
Launch Clk | clk_27m:[R]
Latch Clk | clk_27m:[R]

Data Arrival Path:

AT | DELAY | TYPE | RF | FANOUT | LOC | NODE
0.000 | 0.000 | | | | | active clock edge time
0.000 | 0.000 | | | | | clk_27m
0.000 | 0.000 | tCL | RR | 1 | IOT27[A] | clk_27m_ibuf/I
2.088 | 2.088 | tINS | RR | 3750 | IOT27[A] | clk_27m_ibuf/O
4.359 | 2.271 | tNET | RR | 1 | R42C49[1][A] | u_top/u_manual/wr_ptr_0_s0/CLK
4.591 | 0.232 | tC2Q | RF | 7 | R42C49[1][A] | u_top/u_manual/wr_ptr_0_s0/Q
5.021 | 0.430 | tNET | FF | 2 | R42C46[0][B] | u_top/u_manual/n4_s0/I0
5.570 | 0.549 | tINS | FR | 1 | R42C46[0][B] | u_top/u_manual/n4_s0/COUT
5.570 | 0.000 | tNET | RR | 2 | R42C46[1][A] | u_top/u_manual/n5_s0/CIN
5.606 | 0.035 | tINS | RF | 1 | R42C46[1][A] | u_top/u_manual/n5_s0/COUT
5.606 | 0.000 | tNET | FF | 2 | R42C46[1][B] | u_top/u_manual/n6_s0/CIN
5.641 | 0.035 | tINS | FF | 1 | R42C46[1][B] | u_top/u_manual/n6_s0/COUT
5.641 | 0.000 | tNET | FF | 2 | R42C46[2][A] | u_top/u_manual/n7_s0/CIN
5.676 | 0.035 | tINS | FF | 1 | R42C46[2][A] | u_top/u_manual/n7_s0/COUT
5.676 | 0.000 | tNET | FF | 2 | R42C46[2][B] | u_top/u_manual/n8_s0/CIN
5.711 | 0.035 | tINS | FF | 17 | R42C46[2][B] | u_top/u_manual/n8_s0/COUT
7.859 | 2.148 | tNET | FF | 1 | R36C44[1][A] | u_top/ev_word_11_s2/I2
8.376 | 0.517 | tINS | FF | 1 | R36C44[1][A] | u_top/ev_word_11_s2/F
9.032 | 0.656 | tNET | FF | 1 | R36C41[3][A] | u_top/ev_word_11_s1/I1
9.494 | 0.462 | tINS | FR | 1 | R36C41[3][A] | u_top/ev_word_11_s1/F
9.495 | 0.001 | tNET | RR | 1 | R36C41[1][B] | u_top/ev_word_11_s0/I0
9.948 | 0.453 | tINS | RF | 40 | R36C41[1][B] | u_top/ev_word_11_s0/F
15.910 | 5.961 | tNET | FF | 2 | R8C23[1][B] | u_top/u_alloc/n51_s0/I1
16.480 | 0.570 | tINS | FR | 1 | R8C23[1][B] | u_top/u_alloc/n51_s0/COUT
16.480 | 0.000 | tNET | RR | 2 | R8C23[2][A] | u_top/u_alloc/n52_s0/CIN
16.515 | 0.035 | tINS | RF | 1 | R8C23[2][A] | u_top/u_alloc/n52_s0/COUT
16.515 | 0.000 | tNET | FF | 2 | R8C23[2][B] | u_top/u_alloc/n53_s0/CIN
16.550 | 0.035 | tINS | FF | 1 | R8C23[2][B] | u_top/u_alloc/n53_s0/COUT
16.550 | 0.000 | tNET | FF | 2 | R8C24[0][A] | u_top/u_alloc/n54_s0/CIN
16.585 | 0.035 | tINS | FF | 3 | R8C24[0][A] | u_top/u_alloc/n54_s0/COUT
17.555 | 0.970 | tNET | FF | 1 | R12C24[1][B] | u_top/u_alloc/pick_2_s60/I0
18.008 | 0.453 | tINS | FF | 3 | R12C24[1][B] | u_top/u_alloc/pick_2_s60/F
18.197 | 0.189 | tNET | FF | 1 | R12C23[3][A] | u_top/u_alloc/pick_0_s61/I1
18.746 | 0.549 | tINS | FR | 3 | R12C23[3][A] | u_top/u_alloc/pick_0_s61/F
18.750 | 0.004 | tNET | RR | 1 | R12C23[2][A] | u_top/u_alloc/pick_2_s101/I2
19.212 | 0.462 | tINS | RR | 1 | R12C23[2][A] | u_top/u_alloc/pick_2_s101/F
19.384 | 0.172 | tNET | RR | 1 | R12C24[3][B] | u_top/u_alloc/pick_2_s85/I0
19.837 | 0.453 | tINS | RF | 4 | R12C24[3][B] | u_top/u_alloc/pick_2_s85/F
20.764 | 0.927 | tNET | FF | 1 | R13C19[3][A] | u_top/u_alloc/pick_2_s62/I3
21.313 | 0.549 | tINS | FR | 3 | R13C19[3][A] | u_top/u_alloc/pick_2_s62/F
21.317 | 0.004 | tNET | RR | 1 | R13C19[0][B] | u_top/u_alloc/pick_2_s84/I1
21.770 | 0.453 | tINS | RF | 1 | R13C19[0][B] | u_top/u_alloc/pick_2_s84/F
22.183 | 0.413 | tNET | FF | 1 | R14C18[0][A] | u_top/u_alloc/pick_2_s58/I2
22.732 | 0.549 | tINS | FR | 1 | R14C18[0][A] | u_top/u_alloc/pick_2_s58/F
22.905 | 0.172 | tNET | RR | 1 | R14C17[2][A] | u_top/u_alloc/pick_2_s118/I3
23.276 | 0.371 | tINS | RF | 2 | R14C17[2][A] | u_top/u_alloc/pick_2_s118/F
23.689 | 0.413 | tNET | FF | 1 | R13C16[3][A] | u_top/u_alloc/pick_2_s8/I3
24.244 | 0.555 | tINS | FF | 7 | R13C16[3][A] | u_top/u_alloc/pick_2_s8/F
25.319 | 1.075 | tNET | FF | 1 | R12C21[2][B] | u_top/u_alloc/pick_1_s12/I1
25.889 | 0.570 | tINS | FR | 1 | R12C21[2][B] | u_top/u_alloc/pick_1_s12/F
25.890 | 0.001 | tNET | RR | 1 | R12C21[3][A] | u_top/u_alloc/pick_1_s6/I3
26.439 | 0.549 | tINS | RR | 1 | R12C21[3][A] | u_top/u_alloc/pick_1_s6/F
26.611 | 0.172 | tNET | RR | 1 | R12C20[1][B] | u_top/u_alloc/pick_1_s2/I1
27.166 | 0.555 | tINS | RF | 9 | R12C20[1][B] | u_top/u_alloc/pick_1_s2/F
28.325 | 1.159 | tNET | FF | 1 | R7C20[0][A] | u_top/u_alloc/pick_1_s43/I3
28.842 | 0.517 | tINS | FF | 12 | R7C20[0][A] | u_top/u_alloc/pick_1_s43/F
30.057 | 1.215 | tNET | FF | 18 | DSP_R19[1][A] | u_top/u_alloc/n453_s1/B[1]
33.697 | 3.640 | tINS | FF | 8 | DSP_R19[1][A] | u_top/u_alloc/n453_s1/DOUT[6]
36.291 | 2.595 | tNET | FF | 1 | R9C27[1][B] | u_top/u_alloc/n3434_s1/I0
36.861 | 0.570 | tINS | FR | 7 | R9C27[1][B] | u_top/u_alloc/n3434_s1/F
37.194 | 0.333 | tNET | RR | 1 | R9C29[1][A] | u_top/u_alloc/v_note_33_s0/CE

Data Required Path:

AT | DELAY | TYPE | RF | FANOUT | LOC | NODE
37.037 | 37.037 | | | | | active clock edge time
37.037 | 0.000 | | | | | clk_27m
37.037 | 0.000 | tCL | RR | 1 | IOT27[A] | clk_27m_ibuf/I
39.125 | 2.088 | tINS | RR | 3750 | IOT27[A] | clk_27m_ibuf/O
41.396 | 2.271 | tNET | RR | 1 | R9C29[1][A] | u_top/u_alloc/v_note_33_s0/CLK
41.361 | -0.035 | tSu | | 1 | R9C29[1][A] | u_top/u_alloc/v_note_33_s0

Path Statistics:

Clock Skew | 0.000
Setup Relationship | 37.037
Logic Level | 24
Arrival Clock Path Delay | cell: 2.088, 47.897%; route: 2.271, 52.103%
Arrival Data Path Delay | cell: 13.592, 41.396%; route: 19.011, 57.897%; tC2Q: 0.232, 0.707%
Required Clock Path Delay | cell: 2.088, 47.897%; route: 2.271, 52.103%

### Path6

Path Summary:

Slack | 4.167
Data Arrival Time | 37.194
Data Required Time | 41.361
From | u_top/u_manual/wr_ptr_0_s0
To | u_top/u_alloc/v_note_34_s0
Launch Clk | clk_27m:[R]
Latch Clk | clk_27m:[R]

Data Arrival Path:

AT | DELAY | TYPE | RF | FANOUT | LOC | NODE
0.000 | 0.000 | | | | | active clock edge time
0.000 | 0.000 | | | | | clk_27m
0.000 | 0.000 | tCL | RR | 1 | IOT27[A] | clk_27m_ibuf/I
2.088 | 2.088 | tINS | RR | 3750 | IOT27[A] | clk_27m_ibuf/O
4.359 | 2.271 | tNET | RR | 1 | R42C49[1][A] | u_top/u_manual/wr_ptr_0_s0/CLK
4.591 | 0.232 | tC2Q | RF | 7 | R42C49[1][A] | u_top/u_manual/wr_ptr_0_s0/Q
5.021 | 0.430 | tNET | FF | 2 | R42C46[0][B] | u_top/u_manual/n4_s0/I0
5.570 | 0.549 | tINS | FR | 1 | R42C46[0][B] | u_top/u_manual/n4_s0/COUT
5.570 | 0.000 | tNET | RR | 2 | R42C46[1][A] | u_top/u_manual/n5_s0/CIN
5.606 | 0.035 | tINS | RF | 1 | R42C46[1][A] | u_top/u_manual/n5_s0/COUT
5.606 | 0.000 | tNET | FF | 2 | R42C46[1][B] | u_top/u_manual/n6_s0/CIN
5.641 | 0.035 | tINS | FF | 1 | R42C46[1][B] | u_top/u_manual/n6_s0/COUT
5.641 | 0.000 | tNET | FF | 2 | R42C46[2][A] | u_top/u_manual/n7_s0/CIN
5.676 | 0.035 | tINS | FF | 1 | R42C46[2][A] | u_top/u_manual/n7_s0/COUT
5.676 | 0.000 | tNET | FF | 2 | R42C46[2][B] | u_top/u_manual/n8_s0/CIN
5.711 | 0.035 | tINS | FF | 17 | R42C46[2][B] | u_top/u_manual/n8_s0/COUT
7.859 | 2.148 | tNET | FF | 1 | R36C44[1][A] | u_top/ev_word_11_s2/I2
8.376 | 0.517 | tINS | FF | 1 | R36C44[1][A] | u_top/ev_word_11_s2/F
9.032 | 0.656 | tNET | FF | 1 | R36C41[3][A] | u_top/ev_word_11_s1/I1
9.494 | 0.462 | tINS | FR | 1 | R36C41[3][A] | u_top/ev_word_11_s1/F
9.495 | 0.001 | tNET | RR | 1 | R36C41[1][B] | u_top/ev_word_11_s0/I0
9.948 | 0.453 | tINS | RF | 40 | R36C41[1][B] | u_top/ev_word_11_s0/F
15.910 | 5.961 | tNET | FF | 2 | R8C23[1][B] | u_top/u_alloc/n51_s0/I1
16.480 | 0.570 | tINS | FR | 1 | R8C23[1][B] | u_top/u_alloc/n51_s0/COUT
16.480 | 0.000 | tNET | RR | 2 | R8C23[2][A] | u_top/u_alloc/n52_s0/CIN
16.515 | 0.035 | tINS | RF | 1 | R8C23[2][A] | u_top/u_alloc/n52_s0/COUT
16.515 | 0.000 | tNET | FF | 2 | R8C23[2][B] | u_top/u_alloc/n53_s0/CIN
16.550 | 0.035 | tINS | FF | 1 | R8C23[2][B] | u_top/u_alloc/n53_s0/COUT
16.550 | 0.000 | tNET | FF | 2 | R8C24[0][A] | u_top/u_alloc/n54_s0/CIN
16.585 | 0.035 | tINS | FF | 3 | R8C24[0][A] | u_top/u_alloc/n54_s0/COUT
17.555 | 0.970 | tNET | FF | 1 | R12C24[1][B] | u_top/u_alloc/pick_2_s60/I0
18.008 | 0.453 | tINS | FF | 3 | R12C24[1][B] | u_top/u_alloc/pick_2_s60/F
18.197 | 0.189 | tNET | FF | 1 | R12C23[3][A] | u_top/u_alloc/pick_0_s61/I1
18.746 | 0.549 | tINS | FR | 3 | R12C23[3][A] | u_top/u_alloc/pick_0_s61/F
18.750 | 0.004 | tNET | RR | 1 | R12C23[2][A] | u_top/u_alloc/pick_2_s101/I2
19.212 | 0.462 | tINS | RR | 1 | R12C23[2][A] | u_top/u_alloc/pick_2_s101/F
19.384 | 0.172 | tNET | RR | 1 | R12C24[3][B] | u_top/u_alloc/pick_2_s85/I0
19.837 | 0.453 | tINS | RF | 4 | R12C24[3][B] | u_top/u_alloc/pick_2_s85/F
20.764 | 0.927 | tNET | FF | 1 | R13C19[3][A] | u_top/u_alloc/pick_2_s62/I3
21.313 | 0.549 | tINS | FR | 3 | R13C19[3][A] | u_top/u_alloc/pick_2_s62/F
21.317 | 0.004 | tNET | RR | 1 | R13C19[0][B] | u_top/u_alloc/pick_2_s84/I1
21.770 | 0.453 | tINS | RF | 1 | R13C19[0][B] | u_top/u_alloc/pick_2_s84/F
22.183 | 0.413 | tNET | FF | 1 | R14C18[0][A] | u_top/u_alloc/pick_2_s58/I2
22.732 | 0.549 | tINS | FR | 1 | R14C18[0][A] | u_top/u_alloc/pick_2_s58/F
22.905 | 0.172 | tNET | RR | 1 | R14C17[2][A] | u_top/u_alloc/pick_2_s118/I3
23.276 | 0.371 | tINS | RF | 2 | R14C17[2][A] | u_top/u_alloc/pick_2_s118/F
23.689 | 0.413 | tNET | FF | 1 | R13C16[3][A] | u_top/u_alloc/pick_2_s8/I3
24.244 | 0.555 | tINS | FF | 7 | R13C16[3][A] | u_top/u_alloc/pick_2_s8/F
25.319 | 1.075 | tNET | FF | 1 | R12C21[2][B] | u_top/u_alloc/pick_1_s12/I1
25.889 | 0.570 | tINS | FR | 1 | R12C21[2][B] | u_top/u_alloc/pick_1_s12/F
25.890 | 0.001 | tNET | RR | 1 | R12C21[3][A] | u_top/u_alloc/pick_1_s6/I3
26.439 | 0.549 | tINS | RR | 1 | R12C21[3][A] | u_top/u_alloc/pick_1_s6/F
26.611 | 0.172 | tNET | RR | 1 | R12C20[1][B] | u_top/u_alloc/pick_1_s2/I1
27.166 | 0.555 | tINS | RF | 9 | R12C20[1][B] | u_top/u_alloc/pick_1_s2/F
28.325 | 1.159 | tNET | FF | 1 | R7C20[0][A] | u_top/u_alloc/pick_1_s43/I3
28.842 | 0.517 | tINS | FF | 12 | R7C20[0][A] | u_top/u_alloc/pick_1_s43/F
30.057 | 1.215 | tNET | FF | 18 | DSP_R19[1][A] | u_top/u_alloc/n453_s1/B[1]
33.697 | 3.640 | tINS | FF | 8 | DSP_R19[1][A] | u_top/u_alloc/n453_s1/DOUT[6]
36.291 | 2.595 | tNET | FF | 1 | R9C27[1][B] | u_top/u_alloc/n3434_s1/I0
36.861 | 0.570 | tINS | FR | 7 | R9C27[1][B] | u_top/u_alloc/n3434_s1/F
37.194 | 0.333 | tNET | RR | 1 | R9C29[1][B] | u_top/u_alloc/v_note_34_s0/CE

Data Required Path:

AT | DELAY | TYPE | RF | FANOUT | LOC | NODE
37.037 | 37.037 | | | | | active clock edge time
37.037 | 0.000 | | | | | clk_27m
37.037 | 0.000 | tCL | RR | 1 | IOT27[A] | clk_27m_ibuf/I
39.125 | 2.088 | tINS | RR | 3750 | IOT27[A] | clk_27m_ibuf/O
41.396 | 2.271 | tNET | RR | 1 | R9C29[1][B] | u_top/u_alloc/v_note_34_s0/CLK
41.361 | -0.035 | tSu | | 1 | R9C29[1][B] | u_top/u_alloc/v_note_34_s0

Path Statistics:

Clock Skew | 0.000
Setup Relationship | 37.037
Logic Level | 24
Arrival Clock Path Delay | cell: 2.088, 47.897%; route: 2.271, 52.103%
Arrival Data Path Delay | cell: 13.592, 41.396%; route: 19.011, 57.897%; tC2Q: 0.232, 0.707%
Required Clock Path Delay | cell: 2.088, 47.897%; route: 2.271, 52.103%

### Path7

Path Summary:

Slack | 4.180
Data Arrival Time | 37.181
Data Required Time | 41.361
From | u_top/u_manual/wr_ptr_0_s0
To | u_top/u_alloc/v_note_49_s0
Launch Clk | clk_27m:[R]
Latch Clk | clk_27m:[R]

Data Arrival Path:

AT | DELAY | TYPE | RF | FANOUT | LOC | NODE
0.000 | 0.000 | | | | | active clock edge time
0.000 | 0.000 | | | | | clk_27m
0.000 | 0.000 | tCL | RR | 1 | IOT27[A] | clk_27m_ibuf/I
2.088 | 2.088 | tINS | RR | 3750 | IOT27[A] | clk_27m_ibuf/O
4.359 | 2.271 | tNET | RR | 1 | R42C49[1][A] | u_top/u_manual/wr_ptr_0_s0/CLK
4.591 | 0.232 | tC2Q | RF | 7 | R42C49[1][A] | u_top/u_manual/wr_ptr_0_s0/Q
5.021 | 0.430 | tNET | FF | 2 | R42C46[0][B] | u_top/u_manual/n4_s0/I0
5.570 | 0.549 | tINS | FR | 1 | R42C46[0][B] | u_top/u_manual/n4_s0/COUT
5.570 | 0.000 | tNET | RR | 2 | R42C46[1][A] | u_top/u_manual/n5_s0/CIN
5.606 | 0.035 | tINS | RF | 1 | R42C46[1][A] | u_top/u_manual/n5_s0/COUT
5.606 | 0.000 | tNET | FF | 2 | R42C46[1][B] | u_top/u_manual/n6_s0/CIN
5.641 | 0.035 | tINS | FF | 1 | R42C46[1][B] | u_top/u_manual/n6_s0/COUT
5.641 | 0.000 | tNET | FF | 2 | R42C46[2][A] | u_top/u_manual/n7_s0/CIN
5.676 | 0.035 | tINS | FF | 1 | R42C46[2][A] | u_top/u_manual/n7_s0/COUT
5.676 | 0.000 | tNET | FF | 2 | R42C46[2][B] | u_top/u_manual/n8_s0/CIN
5.711 | 0.035 | tINS | FF | 17 | R42C46[2][B] | u_top/u_manual/n8_s0/COUT
7.859 | 2.148 | tNET | FF | 1 | R36C44[1][A] | u_top/ev_word_11_s2/I2
8.376 | 0.517 | tINS | FF | 1 | R36C44[1][A] | u_top/ev_word_11_s2/F
9.032 | 0.656 | tNET | FF | 1 | R36C41[3][A] | u_top/ev_word_11_s1/I1
9.494 | 0.462 | tINS | FR | 1 | R36C41[3][A] | u_top/ev_word_11_s1/F
9.495 | 0.001 | tNET | RR | 1 | R36C41[1][B] | u_top/ev_word_11_s0/I0
9.948 | 0.453 | tINS | RF | 40 | R36C41[1][B] | u_top/ev_word_11_s0/F
15.910 | 5.961 | tNET | FF | 2 | R8C23[1][B] | u_top/u_alloc/n51_s0/I1
16.480 | 0.570 | tINS | FR | 1 | R8C23[1][B] | u_top/u_alloc/n51_s0/COUT
16.480 | 0.000 | tNET | RR | 2 | R8C23[2][A] | u_top/u_alloc/n52_s0/CIN
16.515 | 0.035 | tINS | RF | 1 | R8C23[2][A] | u_top/u_alloc/n52_s0/COUT
16.515 | 0.000 | tNET | FF | 2 | R8C23[2][B] | u_top/u_alloc/n53_s0/CIN
16.550 | 0.035 | tINS | FF | 1 | R8C23[2][B] | u_top/u_alloc/n53_s0/COUT
16.550 | 0.000 | tNET | FF | 2 | R8C24[0][A] | u_top/u_alloc/n54_s0/CIN
16.585 | 0.035 | tINS | FF | 3 | R8C24[0][A] | u_top/u_alloc/n54_s0/COUT
17.555 | 0.970 | tNET | FF | 1 | R12C24[1][B] | u_top/u_alloc/pick_2_s60/I0
18.008 | 0.453 | tINS | FF | 3 | R12C24[1][B] | u_top/u_alloc/pick_2_s60/F
18.197 | 0.189 | tNET | FF | 1 | R12C23[3][A] | u_top/u_alloc/pick_0_s61/I1
18.746 | 0.549 | tINS | FR | 3 | R12C23[3][A] | u_top/u_alloc/pick_0_s61/F
18.750 | 0.004 | tNET | RR | 1 | R12C23[2][A] | u_top/u_alloc/pick_2_s101/I2
19.212 | 0.462 | tINS | RR | 1 | R12C23[2][A] | u_top/u_alloc/pick_2_s101/F
19.384 | 0.172 | tNET | RR | 1 | R12C24[3][B] | u_top/u_alloc/pick_2_s85/I0
19.837 | 0.453 | tINS | RF | 4 | R12C24[3][B] | u_top/u_alloc/pick_2_s85/F
20.764 | 0.927 | tNET | FF | 1 | R13C19[3][A] | u_top/u_alloc/pick_2_s62/I3
21.313 | 0.549 | tINS | FR | 3 | R13C19[3][A] | u_top/u_alloc/pick_2_s62/F
21.317 | 0.004 | tNET | RR | 1 | R13C19[0][B] | u_top/u_alloc/pick_2_s84/I1
21.770 | 0.453 | tINS | RF | 1 | R13C19[0][B] | u_top/u_alloc/pick_2_s84/F
22.183 | 0.413 | tNET | FF | 1 | R14C18[0][A] | u_top/u_alloc/pick_2_s58/I2
22.732 | 0.549 | tINS | FR | 1 | R14C18[0][A] | u_top/u_alloc/pick_2_s58/F
22.905 | 0.172 | tNET | RR | 1 | R14C17[2][A] | u_top/u_alloc/pick_2_s118/I3
23.276 | 0.371 | tINS | RF | 2 | R14C17[2][A] | u_top/u_alloc/pick_2_s118/F
23.689 | 0.413 | tNET | FF | 1 | R13C16[3][A] | u_top/u_alloc/pick_2_s8/I3
24.244 | 0.555 | tINS | FF | 7 | R13C16[3][A] | u_top/u_alloc/pick_2_s8/F
25.319 | 1.075 | tNET | FF | 1 | R12C21[2][B] | u_top/u_alloc/pick_1_s12/I1
25.889 | 0.570 | tINS | FR | 1 | R12C21[2][B] | u_top/u_alloc/pick_1_s12/F
25.890 | 0.001 | tNET | RR | 1 | R12C21[3][A] | u_top/u_alloc/pick_1_s6/I3
26.439 | 0.549 | tINS | RR | 1 | R12C21[3][A] | u_top/u_alloc/pick_1_s6/F
26.611 | 0.172 | tNET | RR | 1 | R12C20[1][B] | u_top/u_alloc/pick_1_s2/I1
27.166 | 0.555 | tINS | RF | 9 | R12C20[1][B] | u_top/u_alloc/pick_1_s2/F
28.325 | 1.159 | tNET | FF | 1 | R7C20[0][A] | u_top/u_alloc/pick_1_s43/I3
28.842 | 0.517 | tINS | FF | 12 | R7C20[0][A] | u_top/u_alloc/pick_1_s43/F
30.057 | 1.215 | tNET | FF | 18 | DSP_R19[1][A] | u_top/u_alloc/n453_s1/B[1]
33.697 | 3.640 | tINS | FF | 8 | DSP_R19[1][A] | u_top/u_alloc/n453_s1/DOUT[6]
36.291 | 2.595 | tNET | FF | 1 | R8C27[3][A] | u_top/u_alloc/n3392_s1/I0
36.840 | 0.549 | tINS | FR | 7 | R8C27[3][A] | u_top/u_alloc/n3392_s1/F
37.181 | 0.341 | tNET | RR | 1 | R8C28[0][A] | u_top/u_alloc/v_note_49_s0/CE

Data Required Path:

AT | DELAY | TYPE | RF | FANOUT | LOC | NODE
37.037 | 37.037 | | | | | active clock edge time
37.037 | 0.000 | | | | | clk_27m
37.037 | 0.000 | tCL | RR | 1 | IOT27[A] | clk_27m_ibuf/I
39.125 | 2.088 | tINS | RR | 3750 | IOT27[A] | clk_27m_ibuf/O
41.396 | 2.271 | tNET | RR | 1 | R8C28[0][A] | u_top/u_alloc/v_note_49_s0/CLK
41.361 | -0.035 | tSu | | 1 | R8C28[0][A] | u_top/u_alloc/v_note_49_s0

Path Statistics:

Clock Skew | 0.000
Setup Relationship | 37.037
Logic Level | 24
Arrival Clock Path Delay | cell: 2.088, 47.897%; route: 2.271, 52.103%
Arrival Data Path Delay | cell: 13.571, 41.348%; route: 19.019, 57.945%; tC2Q: 0.232, 0.707%
Required Clock Path Delay | cell: 2.088, 47.897%; route: 2.271, 52.103%

### Path8

Path Summary:

Slack | 4.180
Data Arrival Time | 37.181
Data Required Time | 41.361
From | u_top/u_manual/wr_ptr_0_s0
To | u_top/u_alloc/v_note_50_s0
Launch Clk | clk_27m:[R]
Latch Clk | clk_27m:[R]

Data Arrival Path:

AT | DELAY | TYPE | RF | FANOUT | LOC | NODE
0.000 | 0.000 | | | | | active clock edge time
0.000 | 0.000 | | | | | clk_27m
0.000 | 0.000 | tCL | RR | 1 | IOT27[A] | clk_27m_ibuf/I
2.088 | 2.088 | tINS | RR | 3750 | IOT27[A] | clk_27m_ibuf/O
4.359 | 2.271 | tNET | RR | 1 | R42C49[1][A] | u_top/u_manual/wr_ptr_0_s0/CLK
4.591 | 0.232 | tC2Q | RF | 7 | R42C49[1][A] | u_top/u_manual/wr_ptr_0_s0/Q
5.021 | 0.430 | tNET | FF | 2 | R42C46[0][B] | u_top/u_manual/n4_s0/I0
5.570 | 0.549 | tINS | FR | 1 | R42C46[0][B] | u_top/u_manual/n4_s0/COUT
5.570 | 0.000 | tNET | RR | 2 | R42C46[1][A] | u_top/u_manual/n5_s0/CIN
5.606 | 0.035 | tINS | RF | 1 | R42C46[1][A] | u_top/u_manual/n5_s0/COUT
5.606 | 0.000 | tNET | FF | 2 | R42C46[1][B] | u_top/u_manual/n6_s0/CIN
5.641 | 0.035 | tINS | FF | 1 | R42C46[1][B] | u_top/u_manual/n6_s0/COUT
5.641 | 0.000 | tNET | FF | 2 | R42C46[2][A] | u_top/u_manual/n7_s0/CIN
5.676 | 0.035 | tINS | FF | 1 | R42C46[2][A] | u_top/u_manual/n7_s0/COUT
5.676 | 0.000 | tNET | FF | 2 | R42C46[2][B] | u_top/u_manual/n8_s0/CIN
5.711 | 0.035 | tINS | FF | 17 | R42C46[2][B] | u_top/u_manual/n8_s0/COUT
7.859 | 2.148 | tNET | FF | 1 | R36C44[1][A] | u_top/ev_word_11_s2/I2
8.376 | 0.517 | tINS | FF | 1 | R36C44[1][A] | u_top/ev_word_11_s2/F
9.032 | 0.656 | tNET | FF | 1 | R36C41[3][A] | u_top/ev_word_11_s1/I1
9.494 | 0.462 | tINS | FR | 1 | R36C41[3][A] | u_top/ev_word_11_s1/F
9.495 | 0.001 | tNET | RR | 1 | R36C41[1][B] | u_top/ev_word_11_s0/I0
9.948 | 0.453 | tINS | RF | 40 | R36C41[1][B] | u_top/ev_word_11_s0/F
15.910 | 5.961 | tNET | FF | 2 | R8C23[1][B] | u_top/u_alloc/n51_s0/I1
16.480 | 0.570 | tINS | FR | 1 | R8C23[1][B] | u_top/u_alloc/n51_s0/COUT
16.480 | 0.000 | tNET | RR | 2 | R8C23[2][A] | u_top/u_alloc/n52_s0/CIN
16.515 | 0.035 | tINS | RF | 1 | R8C23[2][A] | u_top/u_alloc/n52_s0/COUT
16.515 | 0.000 | tNET | FF | 2 | R8C23[2][B] | u_top/u_alloc/n53_s0/CIN
16.550 | 0.035 | tINS | FF | 1 | R8C23[2][B] | u_top/u_alloc/n53_s0/COUT
16.550 | 0.000 | tNET | FF | 2 | R8C24[0][A] | u_top/u_alloc/n54_s0/CIN
16.585 | 0.035 | tINS | FF | 3 | R8C24[0][A] | u_top/u_alloc/n54_s0/COUT
17.555 | 0.970 | tNET | FF | 1 | R12C24[1][B] | u_top/u_alloc/pick_2_s60/I0
18.008 | 0.453 | tINS | FF | 3 | R12C24[1][B] | u_top/u_alloc/pick_2_s60/F
18.197 | 0.189 | tNET | FF | 1 | R12C23[3][A] | u_top/u_alloc/pick_0_s61/I1
18.746 | 0.549 | tINS | FR | 3 | R12C23[3][A] | u_top/u_alloc/pick_0_s61/F
18.750 | 0.004 | tNET | RR | 1 | R12C23[2][A] | u_top/u_alloc/pick_2_s101/I2
19.212 | 0.462 | tINS | RR | 1 | R12C23[2][A] | u_top/u_alloc/pick_2_s101/F
19.384 | 0.172 | tNET | RR | 1 | R12C24[3][B] | u_top/u_alloc/pick_2_s85/I0
19.837 | 0.453 | tINS | RF | 4 | R12C24[3][B] | u_top/u_alloc/pick_2_s85/F
20.764 | 0.927 | tNET | FF | 1 | R13C19[3][A] | u_top/u_alloc/pick_2_s62/I3
21.313 | 0.549 | tINS | FR | 3 | R13C19[3][A] | u_top/u_alloc/pick_2_s62/F
21.317 | 0.004 | tNET | RR | 1 | R13C19[0][B] | u_top/u_alloc/pick_2_s84/I1
21.770 | 0.453 | tINS | RF | 1 | R13C19[0][B] | u_top/u_alloc/pick_2_s84/F
22.183 | 0.413 | tNET | FF | 1 | R14C18[0][A] | u_top/u_alloc/pick_2_s58/I2
22.732 | 0.549 | tINS | FR | 1 | R14C18[0][A] | u_top/u_alloc/pick_2_s58/F
22.905 | 0.172 | tNET | RR | 1 | R14C17[2][A] | u_top/u_alloc/pick_2_s118/I3
23.276 | 0.371 | tINS | RF | 2 | R14C17[2][A] | u_top/u_alloc/pick_2_s118/F
23.689 | 0.413 | tNET | FF | 1 | R13C16[3][A] | u_top/u_alloc/pick_2_s8/I3
24.244 | 0.555 | tINS | FF | 7 | R13C16[3][A] | u_top/u_alloc/pick_2_s8/F
25.319 | 1.075 | tNET | FF | 1 | R12C21[2][B] | u_top/u_alloc/pick_1_s12/I1
25.889 | 0.570 | tINS | FR | 1 | R12C21[2][B] | u_top/u_alloc/pick_1_s12/F
25.890 | 0.001 | tNET | RR | 1 | R12C21[3][A] | u_top/u_alloc/pick_1_s6/I3
26.439 | 0.549 | tINS | RR | 1 | R12C21[3][A] | u_top/u_alloc/pick_1_s6/F
26.611 | 0.172 | tNET | RR | 1 | R12C20[1][B] | u_top/u_alloc/pick_1_s2/I1
27.166 | 0.555 | tINS | RF | 9 | R12C20[1][B] | u_top/u_alloc/pick_1_s2/F
28.325 | 1.159 | tNET | FF | 1 | R7C20[0][A] | u_top/u_alloc/pick_1_s43/I3
28.842 | 0.517 | tINS | FF | 12 | R7C20[0][A] | u_top/u_alloc/pick_1_s43/F
30.057 | 1.215 | tNET | FF | 18 | DSP_R19[1][A] | u_top/u_alloc/n453_s1/B[1]
33.697 | 3.640 | tINS | FF | 8 | DSP_R19[1][A] | u_top/u_alloc/n453_s1/DOUT[6]
36.291 | 2.595 | tNET | FF | 1 | R8C27[3][A] | u_top/u_alloc/n3392_s1/I0
36.840 | 0.549 | tINS | FR | 7 | R8C27[3][A] | u_top/u_alloc/n3392_s1/F
37.181 | 0.341 | tNET | RR | 1 | R8C28[2][B] | u_top/u_alloc/v_note_50_s0/CE

Data Required Path:

AT | DELAY | TYPE | RF | FANOUT | LOC | NODE
37.037 | 37.037 | | | | | active clock edge time
37.037 | 0.000 | | | | | clk_27m
37.037 | 0.000 | tCL | RR | 1 | IOT27[A] | clk_27m_ibuf/I
39.125 | 2.088 | tINS | RR | 3750 | IOT27[A] | clk_27m_ibuf/O
41.396 | 2.271 | tNET | RR | 1 | R8C28[2][B] | u_top/u_alloc/v_note_50_s0/CLK
41.361 | -0.035 | tSu | | 1 | R8C28[2][B] | u_top/u_alloc/v_note_50_s0

Path Statistics:

Clock Skew | 0.000
Setup Relationship | 37.037
Logic Level | 24
Arrival Clock Path Delay | cell: 2.088, 47.897%; route: 2.271, 52.103%
Arrival Data Path Delay | cell: 13.571, 41.348%; route: 19.019, 57.945%; tC2Q: 0.232, 0.707%
Required Clock Path Delay | cell: 2.088, 47.897%; route: 2.271, 52.103%

### Path9

Path Summary:

Slack | 4.180
Data Arrival Time | 37.181
Data Required Time | 41.361
From | u_top/u_manual/wr_ptr_0_s0
To | u_top/u_alloc/v_note_52_s0
Launch Clk | clk_27m:[R]
Latch Clk | clk_27m:[R]

Data Arrival Path:

AT | DELAY | TYPE | RF | FANOUT | LOC | NODE
0.000 | 0.000 | | | | | active clock edge time
0.000 | 0.000 | | | | | clk_27m
0.000 | 0.000 | tCL | RR | 1 | IOT27[A] | clk_27m_ibuf/I
2.088 | 2.088 | tINS | RR | 3750 | IOT27[A] | clk_27m_ibuf/O
4.359 | 2.271 | tNET | RR | 1 | R42C49[1][A] | u_top/u_manual/wr_ptr_0_s0/CLK
4.591 | 0.232 | tC2Q | RF | 7 | R42C49[1][A] | u_top/u_manual/wr_ptr_0_s0/Q
5.021 | 0.430 | tNET | FF | 2 | R42C46[0][B] | u_top/u_manual/n4_s0/I0
5.570 | 0.549 | tINS | FR | 1 | R42C46[0][B] | u_top/u_manual/n4_s0/COUT
5.570 | 0.000 | tNET | RR | 2 | R42C46[1][A] | u_top/u_manual/n5_s0/CIN
5.606 | 0.035 | tINS | RF | 1 | R42C46[1][A] | u_top/u_manual/n5_s0/COUT
5.606 | 0.000 | tNET | FF | 2 | R42C46[1][B] | u_top/u_manual/n6_s0/CIN
5.641 | 0.035 | tINS | FF | 1 | R42C46[1][B] | u_top/u_manual/n6_s0/COUT
5.641 | 0.000 | tNET | FF | 2 | R42C46[2][A] | u_top/u_manual/n7_s0/CIN
5.676 | 0.035 | tINS | FF | 1 | R42C46[2][A] | u_top/u_manual/n7_s0/COUT
5.676 | 0.000 | tNET | FF | 2 | R42C46[2][B] | u_top/u_manual/n8_s0/CIN
5.711 | 0.035 | tINS | FF | 17 | R42C46[2][B] | u_top/u_manual/n8_s0/COUT
7.859 | 2.148 | tNET | FF | 1 | R36C44[1][A] | u_top/ev_word_11_s2/I2
8.376 | 0.517 | tINS | FF | 1 | R36C44[1][A] | u_top/ev_word_11_s2/F
9.032 | 0.656 | tNET | FF | 1 | R36C41[3][A] | u_top/ev_word_11_s1/I1
9.494 | 0.462 | tINS | FR | 1 | R36C41[3][A] | u_top/ev_word_11_s1/F
9.495 | 0.001 | tNET | RR | 1 | R36C41[1][B] | u_top/ev_word_11_s0/I0
9.948 | 0.453 | tINS | RF | 40 | R36C41[1][B] | u_top/ev_word_11_s0/F
15.910 | 5.961 | tNET | FF | 2 | R8C23[1][B] | u_top/u_alloc/n51_s0/I1
16.480 | 0.570 | tINS | FR | 1 | R8C23[1][B] | u_top/u_alloc/n51_s0/COUT
16.480 | 0.000 | tNET | RR | 2 | R8C23[2][A] | u_top/u_alloc/n52_s0/CIN
16.515 | 0.035 | tINS | RF | 1 | R8C23[2][A] | u_top/u_alloc/n52_s0/COUT
16.515 | 0.000 | tNET | FF | 2 | R8C23[2][B] | u_top/u_alloc/n53_s0/CIN
16.550 | 0.035 | tINS | FF | 1 | R8C23[2][B] | u_top/u_alloc/n53_s0/COUT
16.550 | 0.000 | tNET | FF | 2 | R8C24[0][A] | u_top/u_alloc/n54_s0/CIN
16.585 | 0.035 | tINS | FF | 3 | R8C24[0][A] | u_top/u_alloc/n54_s0/COUT
17.555 | 0.970 | tNET | FF | 1 | R12C24[1][B] | u_top/u_alloc/pick_2_s60/I0
18.008 | 0.453 | tINS | FF | 3 | R12C24[1][B] | u_top/u_alloc/pick_2_s60/F
18.197 | 0.189 | tNET | FF | 1 | R12C23[3][A] | u_top/u_alloc/pick_0_s61/I1
18.746 | 0.549 | tINS | FR | 3 | R12C23[3][A] | u_top/u_alloc/pick_0_s61/F
18.750 | 0.004 | tNET | RR | 1 | R12C23[2][A] | u_top/u_alloc/pick_2_s101/I2
19.212 | 0.462 | tINS | RR | 1 | R12C23[2][A] | u_top/u_alloc/pick_2_s101/F
19.384 | 0.172 | tNET | RR | 1 | R12C24[3][B] | u_top/u_alloc/pick_2_s85/I0
19.837 | 0.453 | tINS | RF | 4 | R12C24[3][B] | u_top/u_alloc/pick_2_s85/F
20.764 | 0.927 | tNET | FF | 1 | R13C19[3][A] | u_top/u_alloc/pick_2_s62/I3
21.313 | 0.549 | tINS | FR | 3 | R13C19[3][A] | u_top/u_alloc/pick_2_s62/F
21.317 | 0.004 | tNET | RR | 1 | R13C19[0][B] | u_top/u_alloc/pick_2_s84/I1
21.770 | 0.453 | tINS | RF | 1 | R13C19[0][B] | u_top/u_alloc/pick_2_s84/F
22.183 | 0.413 | tNET | FF | 1 | R14C18[0][A] | u_top/u_alloc/pick_2_s58/I2
22.732 | 0.549 | tINS | FR | 1 | R14C18[0][A] | u_top/u_alloc/pick_2_s58/F
22.905 | 0.172 | tNET | RR | 1 | R14C17[2][A] | u_top/u_alloc/pick_2_s118/I3
23.276 | 0.371 | tINS | RF | 2 | R14C17[2][A] | u_top/u_alloc/pick_2_s118/F
23.689 | 0.413 | tNET | FF | 1 | R13C16[3][A] | u_top/u_alloc/pick_2_s8/I3
24.244 | 0.555 | tINS | FF | 7 | R13C16[3][A] | u_top/u_alloc/pick_2_s8/F
25.319 | 1.075 | tNET | FF | 1 | R12C21[2][B] | u_top/u_alloc/pick_1_s12/I1
25.889 | 0.570 | tINS | FR | 1 | R12C21[2][B] | u_top/u_alloc/pick_1_s12/F
25.890 | 0.001 | tNET | RR | 1 | R12C21[3][A] | u_top/u_alloc/pick_1_s6/I3
26.439 | 0.549 | tINS | RR | 1 | R12C21[3][A] | u_top/u_alloc/pick_1_s6/F
26.611 | 0.172 | tNET | RR | 1 | R12C20[1][B] | u_top/u_alloc/pick_1_s2/I1
27.166 | 0.555 | tINS | RF | 9 | R12C20[1][B] | u_top/u_alloc/pick_1_s2/F
28.325 | 1.159 | tNET | FF | 1 | R7C20[0][A] | u_top/u_alloc/pick_1_s43/I3
28.842 | 0.517 | tINS | FF | 12 | R7C20[0][A] | u_top/u_alloc/pick_1_s43/F
30.057 | 1.215 | tNET | FF | 18 | DSP_R19[1][A] | u_top/u_alloc/n453_s1/B[1]
33.697 | 3.640 | tINS | FF | 8 | DSP_R19[1][A] | u_top/u_alloc/n453_s1/DOUT[6]
36.291 | 2.595 | tNET | FF | 1 | R8C27[3][A] | u_top/u_alloc/n3392_s1/I0
36.840 | 0.549 | tINS | FR | 7 | R8C27[3][A] | u_top/u_alloc/n3392_s1/F
37.181 | 0.341 | tNET | RR | 1 | R8C28[1][A] | u_top/u_alloc/v_note_52_s0/CE

Data Required Path:

AT | DELAY | TYPE | RF | FANOUT | LOC | NODE
37.037 | 37.037 | | | | | active clock edge time
37.037 | 0.000 | | | | | clk_27m
37.037 | 0.000 | tCL | RR | 1 | IOT27[A] | clk_27m_ibuf/I
39.125 | 2.088 | tINS | RR | 3750 | IOT27[A] | clk_27m_ibuf/O
41.396 | 2.271 | tNET | RR | 1 | R8C28[1][A] | u_top/u_alloc/v_note_52_s0/CLK
41.361 | -0.035 | tSu | | 1 | R8C28[1][A] | u_top/u_alloc/v_note_52_s0

Path Statistics:

Clock Skew | 0.000
Setup Relationship | 37.037
Logic Level | 24
Arrival Clock Path Delay | cell: 2.088, 47.897%; route: 2.271, 52.103%
Arrival Data Path Delay | cell: 13.571, 41.348%; route: 19.019, 57.945%; tC2Q: 0.232, 0.707%
Required Clock Path Delay | cell: 2.088, 47.897%; route: 2.271, 52.103%

### Path10

Path Summary:

Slack | 4.180
Data Arrival Time | 37.181
Data Required Time | 41.361
From | u_top/u_manual/wr_ptr_0_s0
To | u_top/u_alloc/v_note_53_s0
Launch Clk | clk_27m:[R]
Latch Clk | clk_27m:[R]

Data Arrival Path:

AT | DELAY | TYPE | RF | FANOUT | LOC | NODE
0.000 | 0.000 | | | | | active clock edge time
0.000 | 0.000 | | | | | clk_27m
0.000 | 0.000 | tCL | RR | 1 | IOT27[A] | clk_27m_ibuf/I
2.088 | 2.088 | tINS | RR | 3750 | IOT27[A] | clk_27m_ibuf/O
4.359 | 2.271 | tNET | RR | 1 | R42C49[1][A] | u_top/u_manual/wr_ptr_0_s0/CLK
4.591 | 0.232 | tC2Q | RF | 7 | R42C49[1][A] | u_top/u_manual/wr_ptr_0_s0/Q
5.021 | 0.430 | tNET | FF | 2 | R42C46[0][B] | u_top/u_manual/n4_s0/I0
5.570 | 0.549 | tINS | FR | 1 | R42C46[0][B] | u_top/u_manual/n4_s0/COUT
5.570 | 0.000 | tNET | RR | 2 | R42C46[1][A] | u_top/u_manual/n5_s0/CIN
5.606 | 0.035 | tINS | RF | 1 | R42C46[1][A] | u_top/u_manual/n5_s0/COUT
5.606 | 0.000 | tNET | FF | 2 | R42C46[1][B] | u_top/u_manual/n6_s0/CIN
5.641 | 0.035 | tINS | FF | 1 | R42C46[1][B] | u_top/u_manual/n6_s0/COUT
5.641 | 0.000 | tNET | FF | 2 | R42C46[2][A] | u_top/u_manual/n7_s0/CIN
5.676 | 0.035 | tINS | FF | 1 | R42C46[2][A] | u_top/u_manual/n7_s0/COUT
5.676 | 0.000 | tNET | FF | 2 | R42C46[2][B] | u_top/u_manual/n8_s0/CIN
5.711 | 0.035 | tINS | FF | 17 | R42C46[2][B] | u_top/u_manual/n8_s0/COUT
7.859 | 2.148 | tNET | FF | 1 | R36C44[1][A] | u_top/ev_word_11_s2/I2
8.376 | 0.517 | tINS | FF | 1 | R36C44[1][A] | u_top/ev_word_11_s2/F
9.032 | 0.656 | tNET | FF | 1 | R36C41[3][A] | u_top/ev_word_11_s1/I1
9.494 | 0.462 | tINS | FR | 1 | R36C41[3][A] | u_top/ev_word_11_s1/F
9.495 | 0.001 | tNET | RR | 1 | R36C41[1][B] | u_top/ev_word_11_s0/I0
9.948 | 0.453 | tINS | RF | 40 | R36C41[1][B] | u_top/ev_word_11_s0/F
15.910 | 5.961 | tNET | FF | 2 | R8C23[1][B] | u_top/u_alloc/n51_s0/I1
16.480 | 0.570 | tINS | FR | 1 | R8C23[1][B] | u_top/u_alloc/n51_s0/COUT
16.480 | 0.000 | tNET | RR | 2 | R8C23[2][A] | u_top/u_alloc/n52_s0/CIN
16.515 | 0.035 | tINS | RF | 1 | R8C23[2][A] | u_top/u_alloc/n52_s0/COUT
16.515 | 0.000 | tNET | FF | 2 | R8C23[2][B] | u_top/u_alloc/n53_s0/CIN
16.550 | 0.035 | tINS | FF | 1 | R8C23[2][B] | u_top/u_alloc/n53_s0/COUT
16.550 | 0.000 | tNET | FF | 2 | R8C24[0][A] | u_top/u_alloc/n54_s0/CIN
16.585 | 0.035 | tINS | FF | 3 | R8C24[0][A] | u_top/u_alloc/n54_s0/COUT
17.555 | 0.970 | tNET | FF | 1 | R12C24[1][B] | u_top/u_alloc/pick_2_s60/I0
18.008 | 0.453 | tINS | FF | 3 | R12C24[1][B] | u_top/u_alloc/pick_2_s60/F
18.197 | 0.189 | tNET | FF | 1 | R12C23[3][A] | u_top/u_alloc/pick_0_s61/I1
18.746 | 0.549 | tINS | FR | 3 | R12C23[3][A] | u_top/u_alloc/pick_0_s61/F
18.750 | 0.004 | tNET | RR | 1 | R12C23[2][A] | u_top/u_alloc/pick_2_s101/I2
19.212 | 0.462 | tINS | RR | 1 | R12C23[2][A] | u_top/u_alloc/pick_2_s101/F
19.384 | 0.172 | tNET | RR | 1 | R12C24[3][B] | u_top/u_alloc/pick_2_s85/I0
19.837 | 0.453 | tINS | RF | 4 | R12C24[3][B] | u_top/u_alloc/pick_2_s85/F
20.764 | 0.927 | tNET | FF | 1 | R13C19[3][A] | u_top/u_alloc/pick_2_s62/I3
21.313 | 0.549 | tINS | FR | 3 | R13C19[3][A] | u_top/u_alloc/pick_2_s62/F
21.317 | 0.004 | tNET | RR | 1 | R13C19[0][B] | u_top/u_alloc/pick_2_s84/I1
21.770 | 0.453 | tINS | RF | 1 | R13C19[0][B] | u_top/u_alloc/pick_2_s84/F
22.183 | 0.413 | tNET | FF | 1 | R14C18[0][A] | u_top/u_alloc/pick_2_s58/I2
22.732 | 0.549 | tINS | FR | 1 | R14C18[0][A] | u_top/u_alloc/pick_2_s58/F
22.905 | 0.172 | tNET | RR | 1 | R14C17[2][A] | u_top/u_alloc/pick_2_s118/I3
23.276 | 0.371 | tINS | RF | 2 | R14C17[2][A] | u_top/u_alloc/pick_2_s118/F
23.689 | 0.413 | tNET | FF | 1 | R13C16[3][A] | u_top/u_alloc/pick_2_s8/I3
24.244 | 0.555 | tINS | FF | 7 | R13C16[3][A] | u_top/u_alloc/pick_2_s8/F
25.319 | 1.075 | tNET | FF | 1 | R12C21[2][B] | u_top/u_alloc/pick_1_s12/I1
25.889 | 0.570 | tINS | FR | 1 | R12C21[2][B] | u_top/u_alloc/pick_1_s12/F
25.890 | 0.001 | tNET | RR | 1 | R12C21[3][A] | u_top/u_alloc/pick_1_s6/I3
26.439 | 0.549 | tINS | RR | 1 | R12C21[3][A] | u_top/u_alloc/pick_1_s6/F
26.611 | 0.172 | tNET | RR | 1 | R12C20[1][B] | u_top/u_alloc/pick_1_s2/I1
27.166 | 0.555 | tINS | RF | 9 | R12C20[1][B] | u_top/u_alloc/pick_1_s2/F
28.325 | 1.159 | tNET | FF | 1 | R7C20[0][A] | u_top/u_alloc/pick_1_s43/I3
28.842 | 0.517 | tINS | FF | 12 | R7C20[0][A] | u_top/u_alloc/pick_1_s43/F
30.057 | 1.215 | tNET | FF | 18 | DSP_R19[1][A] | u_top/u_alloc/n453_s1/B[1]
33.697 | 3.640 | tINS | FF | 8 | DSP_R19[1][A] | u_top/u_alloc/n453_s1/DOUT[6]
36.291 | 2.595 | tNET | FF | 1 | R8C27[3][A] | u_top/u_alloc/n3392_s1/I0
36.840 | 0.549 | tINS | FR | 7 | R8C27[3][A] | u_top/u_alloc/n3392_s1/F
37.181 | 0.341 | tNET | RR | 1 | R8C28[0][B] | u_top/u_alloc/v_note_53_s0/CE

Data Required Path:

AT | DELAY | TYPE | RF | FANOUT | LOC | NODE
37.037 | 37.037 | | | | | active clock edge time
37.037 | 0.000 | | | | | clk_27m
37.037 | 0.000 | tCL | RR | 1 | IOT27[A] | clk_27m_ibuf/I
39.125 | 2.088 | tINS | RR | 3750 | IOT27[A] | clk_27m_ibuf/O
41.396 | 2.271 | tNET | RR | 1 | R8C28[0][B] | u_top/u_alloc/v_note_53_s0/CLK
41.361 | -0.035 | tSu | | 1 | R8C28[0][B] | u_top/u_alloc/v_note_53_s0

Path Statistics:

Clock Skew | 0.000
Setup Relationship | 37.037
Logic Level | 24
Arrival Clock Path Delay | cell: 2.088, 47.897%; route: 2.271, 52.103%
Arrival Data Path Delay | cell: 13.571, 41.348%; route: 19.019, 57.945%; tC2Q: 0.232, 0.707%
Required Clock Path Delay | cell: 2.088, 47.897%; route: 2.271, 52.103%

### Path11

Path Summary:

Slack | 4.180
Data Arrival Time | 37.181
Data Required Time | 41.361
From | u_top/u_manual/wr_ptr_0_s0
To | u_top/u_alloc/v_note_54_s0
Launch Clk | clk_27m:[R]
Latch Clk | clk_27m:[R]

Data Arrival Path:

AT | DELAY | TYPE | RF | FANOUT | LOC | NODE
0.000 | 0.000 | | | | | active clock edge time
0.000 | 0.000 | | | | | clk_27m
0.000 | 0.000 | tCL | RR | 1 | IOT27[A] | clk_27m_ibuf/I
2.088 | 2.088 | tINS | RR | 3750 | IOT27[A] | clk_27m_ibuf/O
4.359 | 2.271 | tNET | RR | 1 | R42C49[1][A] | u_top/u_manual/wr_ptr_0_s0/CLK
4.591 | 0.232 | tC2Q | RF | 7 | R42C49[1][A] | u_top/u_manual/wr_ptr_0_s0/Q
5.021 | 0.430 | tNET | FF | 2 | R42C46[0][B] | u_top/u_manual/n4_s0/I0
5.570 | 0.549 | tINS | FR | 1 | R42C46[0][B] | u_top/u_manual/n4_s0/COUT
5.570 | 0.000 | tNET | RR | 2 | R42C46[1][A] | u_top/u_manual/n5_s0/CIN
5.606 | 0.035 | tINS | RF | 1 | R42C46[1][A] | u_top/u_manual/n5_s0/COUT
5.606 | 0.000 | tNET | FF | 2 | R42C46[1][B] | u_top/u_manual/n6_s0/CIN
5.641 | 0.035 | tINS | FF | 1 | R42C46[1][B] | u_top/u_manual/n6_s0/COUT
5.641 | 0.000 | tNET | FF | 2 | R42C46[2][A] | u_top/u_manual/n7_s0/CIN
5.676 | 0.035 | tINS | FF | 1 | R42C46[2][A] | u_top/u_manual/n7_s0/COUT
5.676 | 0.000 | tNET | FF | 2 | R42C46[2][B] | u_top/u_manual/n8_s0/CIN
5.711 | 0.035 | tINS | FF | 17 | R42C46[2][B] | u_top/u_manual/n8_s0/COUT
7.859 | 2.148 | tNET | FF | 1 | R36C44[1][A] | u_top/ev_word_11_s2/I2
8.376 | 0.517 | tINS | FF | 1 | R36C44[1][A] | u_top/ev_word_11_s2/F
9.032 | 0.656 | tNET | FF | 1 | R36C41[3][A] | u_top/ev_word_11_s1/I1
9.494 | 0.462 | tINS | FR | 1 | R36C41[3][A] | u_top/ev_word_11_s1/F
9.495 | 0.001 | tNET | RR | 1 | R36C41[1][B] | u_top/ev_word_11_s0/I0
9.948 | 0.453 | tINS | RF | 40 | R36C41[1][B] | u_top/ev_word_11_s0/F
15.910 | 5.961 | tNET | FF | 2 | R8C23[1][B] | u_top/u_alloc/n51_s0/I1
16.480 | 0.570 | tINS | FR | 1 | R8C23[1][B] | u_top/u_alloc/n51_s0/COUT
16.480 | 0.000 | tNET | RR | 2 | R8C23[2][A] | u_top/u_alloc/n52_s0/CIN
16.515 | 0.035 | tINS | RF | 1 | R8C23[2][A] | u_top/u_alloc/n52_s0/COUT
16.515 | 0.000 | tNET | FF | 2 | R8C23[2][B] | u_top/u_alloc/n53_s0/CIN
16.550 | 0.035 | tINS | FF | 1 | R8C23[2][B] | u_top/u_alloc/n53_s0/COUT
16.550 | 0.000 | tNET | FF | 2 | R8C24[0][A] | u_top/u_alloc/n54_s0/CIN
16.585 | 0.035 | tINS | FF | 3 | R8C24[0][A] | u_top/u_alloc/n54_s0/COUT
17.555 | 0.970 | tNET | FF | 1 | R12C24[1][B] | u_top/u_alloc/pick_2_s60/I0
18.008 | 0.453 | tINS | FF | 3 | R12C24[1][B] | u_top/u_alloc/pick_2_s60/F
18.197 | 0.189 | tNET | FF | 1 | R12C23[3][A] | u_top/u_alloc/pick_0_s61/I1
18.746 | 0.549 | tINS | FR | 3 | R12C23[3][A] | u_top/u_alloc/pick_0_s61/F
18.750 | 0.004 | tNET | RR | 1 | R12C23[2][A] | u_top/u_alloc/pick_2_s101/I2
19.212 | 0.462 | tINS | RR | 1 | R12C23[2][A] | u_top/u_alloc/pick_2_s101/F
19.384 | 0.172 | tNET | RR | 1 | R12C24[3][B] | u_top/u_alloc/pick_2_s85/I0
19.837 | 0.453 | tINS | RF | 4 | R12C24[3][B] | u_top/u_alloc/pick_2_s85/F
20.764 | 0.927 | tNET | FF | 1 | R13C19[3][A] | u_top/u_alloc/pick_2_s62/I3
21.313 | 0.549 | tINS | FR | 3 | R13C19[3][A] | u_top/u_alloc/pick_2_s62/F
21.317 | 0.004 | tNET | RR | 1 | R13C19[0][B] | u_top/u_alloc/pick_2_s84/I1
21.770 | 0.453 | tINS | RF | 1 | R13C19[0][B] | u_top/u_alloc/pick_2_s84/F
22.183 | 0.413 | tNET | FF | 1 | R14C18[0][A] | u_top/u_alloc/pick_2_s58/I2
22.732 | 0.549 | tINS | FR | 1 | R14C18[0][A] | u_top/u_alloc/pick_2_s58/F
22.905 | 0.172 | tNET | RR | 1 | R14C17[2][A] | u_top/u_alloc/pick_2_s118/I3
23.276 | 0.371 | tINS | RF | 2 | R14C17[2][A] | u_top/u_alloc/pick_2_s118/F
23.689 | 0.413 | tNET | FF | 1 | R13C16[3][A] | u_top/u_alloc/pick_2_s8/I3
24.244 | 0.555 | tINS | FF | 7 | R13C16[3][A] | u_top/u_alloc/pick_2_s8/F
25.319 | 1.075 | tNET | FF | 1 | R12C21[2][B] | u_top/u_alloc/pick_1_s12/I1
25.889 | 0.570 | tINS | FR | 1 | R12C21[2][B] | u_top/u_alloc/pick_1_s12/F
25.890 | 0.001 | tNET | RR | 1 | R12C21[3][A] | u_top/u_alloc/pick_1_s6/I3
26.439 | 0.549 | tINS | RR | 1 | R12C21[3][A] | u_top/u_alloc/pick_1_s6/F
26.611 | 0.172 | tNET | RR | 1 | R12C20[1][B] | u_top/u_alloc/pick_1_s2/I1
27.166 | 0.555 | tINS | RF | 9 | R12C20[1][B] | u_top/u_alloc/pick_1_s2/F
28.325 | 1.159 | tNET | FF | 1 | R7C20[0][A] | u_top/u_alloc/pick_1_s43/I3
28.842 | 0.517 | tINS | FF | 12 | R7C20[0][A] | u_top/u_alloc/pick_1_s43/F
30.057 | 1.215 | tNET | FF | 18 | DSP_R19[1][A] | u_top/u_alloc/n453_s1/B[1]
33.697 | 3.640 | tINS | FF | 8 | DSP_R19[1][A] | u_top/u_alloc/n453_s1/DOUT[6]
36.291 | 2.595 | tNET | FF | 1 | R8C27[3][A] | u_top/u_alloc/n3392_s1/I0
36.840 | 0.549 | tINS | FR | 7 | R8C27[3][A] | u_top/u_alloc/n3392_s1/F
37.181 | 0.341 | tNET | RR | 1 | R8C28[1][B] | u_top/u_alloc/v_note_54_s0/CE

Data Required Path:

AT | DELAY | TYPE | RF | FANOUT | LOC | NODE
37.037 | 37.037 | | | | | active clock edge time
37.037 | 0.000 | | | | | clk_27m
37.037 | 0.000 | tCL | RR | 1 | IOT27[A] | clk_27m_ibuf/I
39.125 | 2.088 | tINS | RR | 3750 | IOT27[A] | clk_27m_ibuf/O
41.396 | 2.271 | tNET | RR | 1 | R8C28[1][B] | u_top/u_alloc/v_note_54_s0/CLK
41.361 | -0.035 | tSu | | 1 | R8C28[1][B] | u_top/u_alloc/v_note_54_s0

Path Statistics:

Clock Skew | 0.000
Setup Relationship | 37.037
Logic Level | 24
Arrival Clock Path Delay | cell: 2.088, 47.897%; route: 2.271, 52.103%
Arrival Data Path Delay | cell: 13.571, 41.348%; route: 19.019, 57.945%; tC2Q: 0.232, 0.707%
Required Clock Path Delay | cell: 2.088, 47.897%; route: 2.271, 52.103%

### Path12

Path Summary:

Slack | 4.180
Data Arrival Time | 37.181
Data Required Time | 41.361
From | u_top/u_manual/wr_ptr_0_s0
To | u_top/u_alloc/v_note_55_s0
Launch Clk | clk_27m:[R]
Latch Clk | clk_27m:[R]

Data Arrival Path:

AT | DELAY | TYPE | RF | FANOUT | LOC | NODE
0.000 | 0.000 | | | | | active clock edge time
0.000 | 0.000 | | | | | clk_27m
0.000 | 0.000 | tCL | RR | 1 | IOT27[A] | clk_27m_ibuf/I
2.088 | 2.088 | tINS | RR | 3750 | IOT27[A] | clk_27m_ibuf/O
4.359 | 2.271 | tNET | RR | 1 | R42C49[1][A] | u_top/u_manual/wr_ptr_0_s0/CLK
4.591 | 0.232 | tC2Q | RF | 7 | R42C49[1][A] | u_top/u_manual/wr_ptr_0_s0/Q
5.021 | 0.430 | tNET | FF | 2 | R42C46[0][B] | u_top/u_manual/n4_s0/I0
5.570 | 0.549 | tINS | FR | 1 | R42C46[0][B] | u_top/u_manual/n4_s0/COUT
5.570 | 0.000 | tNET | RR | 2 | R42C46[1][A] | u_top/u_manual/n5_s0/CIN
5.606 | 0.035 | tINS | RF | 1 | R42C46[1][A] | u_top/u_manual/n5_s0/COUT
5.606 | 0.000 | tNET | FF | 2 | R42C46[1][B] | u_top/u_manual/n6_s0/CIN
5.641 | 0.035 | tINS | FF | 1 | R42C46[1][B] | u_top/u_manual/n6_s0/COUT
5.641 | 0.000 | tNET | FF | 2 | R42C46[2][A] | u_top/u_manual/n7_s0/CIN
5.676 | 0.035 | tINS | FF | 1 | R42C46[2][A] | u_top/u_manual/n7_s0/COUT
5.676 | 0.000 | tNET | FF | 2 | R42C46[2][B] | u_top/u_manual/n8_s0/CIN
5.711 | 0.035 | tINS | FF | 17 | R42C46[2][B] | u_top/u_manual/n8_s0/COUT
7.859 | 2.148 | tNET | FF | 1 | R36C44[1][A] | u_top/ev_word_11_s2/I2
8.376 | 0.517 | tINS | FF | 1 | R36C44[1][A] | u_top/ev_word_11_s2/F
9.032 | 0.656 | tNET | FF | 1 | R36C41[3][A] | u_top/ev_word_11_s1/I1
9.494 | 0.462 | tINS | FR | 1 | R36C41[3][A] | u_top/ev_word_11_s1/F
9.495 | 0.001 | tNET | RR | 1 | R36C41[1][B] | u_top/ev_word_11_s0/I0
9.948 | 0.453 | tINS | RF | 40 | R36C41[1][B] | u_top/ev_word_11_s0/F
15.910 | 5.961 | tNET | FF | 2 | R8C23[1][B] | u_top/u_alloc/n51_s0/I1
16.480 | 0.570 | tINS | FR | 1 | R8C23[1][B] | u_top/u_alloc/n51_s0/COUT
16.480 | 0.000 | tNET | RR | 2 | R8C23[2][A] | u_top/u_alloc/n52_s0/CIN
16.515 | 0.035 | tINS | RF | 1 | R8C23[2][A] | u_top/u_alloc/n52_s0/COUT
16.515 | 0.000 | tNET | FF | 2 | R8C23[2][B] | u_top/u_alloc/n53_s0/CIN
16.550 | 0.035 | tINS | FF | 1 | R8C23[2][B] | u_top/u_alloc/n53_s0/COUT
16.550 | 0.000 | tNET | FF | 2 | R8C24[0][A] | u_top/u_alloc/n54_s0/CIN
16.585 | 0.035 | tINS | FF | 3 | R8C24[0][A] | u_top/u_alloc/n54_s0/COUT
17.555 | 0.970 | tNET | FF | 1 | R12C24[1][B] | u_top/u_alloc/pick_2_s60/I0
18.008 | 0.453 | tINS | FF | 3 | R12C24[1][B] | u_top/u_alloc/pick_2_s60/F
18.197 | 0.189 | tNET | FF | 1 | R12C23[3][A] | u_top/u_alloc/pick_0_s61/I1
18.746 | 0.549 | tINS | FR | 3 | R12C23[3][A] | u_top/u_alloc/pick_0_s61/F
18.750 | 0.004 | tNET | RR | 1 | R12C23[2][A] | u_top/u_alloc/pick_2_s101/I2
19.212 | 0.462 | tINS | RR | 1 | R12C23[2][A] | u_top/u_alloc/pick_2_s101/F
19.384 | 0.172 | tNET | RR | 1 | R12C24[3][B] | u_top/u_alloc/pick_2_s85/I0
19.837 | 0.453 | tINS | RF | 4 | R12C24[3][B] | u_top/u_alloc/pick_2_s85/F
20.764 | 0.927 | tNET | FF | 1 | R13C19[3][A] | u_top/u_alloc/pick_2_s62/I3
21.313 | 0.549 | tINS | FR | 3 | R13C19[3][A] | u_top/u_alloc/pick_2_s62/F
21.317 | 0.004 | tNET | RR | 1 | R13C19[0][B] | u_top/u_alloc/pick_2_s84/I1
21.770 | 0.453 | tINS | RF | 1 | R13C19[0][B] | u_top/u_alloc/pick_2_s84/F
22.183 | 0.413 | tNET | FF | 1 | R14C18[0][A] | u_top/u_alloc/pick_2_s58/I2
22.732 | 0.549 | tINS | FR | 1 | R14C18[0][A] | u_top/u_alloc/pick_2_s58/F
22.905 | 0.172 | tNET | RR | 1 | R14C17[2][A] | u_top/u_alloc/pick_2_s118/I3
23.276 | 0.371 | tINS | RF | 2 | R14C17[2][A] | u_top/u_alloc/pick_2_s118/F
23.689 | 0.413 | tNET | FF | 1 | R13C16[3][A] | u_top/u_alloc/pick_2_s8/I3
24.244 | 0.555 | tINS | FF | 7 | R13C16[3][A] | u_top/u_alloc/pick_2_s8/F
25.319 | 1.075 | tNET | FF | 1 | R12C21[2][B] | u_top/u_alloc/pick_1_s12/I1
25.889 | 0.570 | tINS | FR | 1 | R12C21[2][B] | u_top/u_alloc/pick_1_s12/F
25.890 | 0.001 | tNET | RR | 1 | R12C21[3][A] | u_top/u_alloc/pick_1_s6/I3
26.439 | 0.549 | tINS | RR | 1 | R12C21[3][A] | u_top/u_alloc/pick_1_s6/F
26.611 | 0.172 | tNET | RR | 1 | R12C20[1][B] | u_top/u_alloc/pick_1_s2/I1
27.166 | 0.555 | tINS | RF | 9 | R12C20[1][B] | u_top/u_alloc/pick_1_s2/F
28.325 | 1.159 | tNET | FF | 1 | R7C20[0][A] | u_top/u_alloc/pick_1_s43/I3
28.842 | 0.517 | tINS | FF | 12 | R7C20[0][A] | u_top/u_alloc/pick_1_s43/F
30.057 | 1.215 | tNET | FF | 18 | DSP_R19[1][A] | u_top/u_alloc/n453_s1/B[1]
33.697 | 3.640 | tINS | FF | 8 | DSP_R19[1][A] | u_top/u_alloc/n453_s1/DOUT[6]
36.291 | 2.595 | tNET | FF | 1 | R8C27[3][A] | u_top/u_alloc/n3392_s1/I0
36.840 | 0.549 | tINS | FR | 7 | R8C27[3][A] | u_top/u_alloc/n3392_s1/F
37.181 | 0.341 | tNET | RR | 1 | R8C28[2][A] | u_top/u_alloc/v_note_55_s0/CE

Data Required Path:

AT | DELAY | TYPE | RF | FANOUT | LOC | NODE
37.037 | 37.037 | | | | | active clock edge time
37.037 | 0.000 | | | | | clk_27m
37.037 | 0.000 | tCL | RR | 1 | IOT27[A] | clk_27m_ibuf/I
39.125 | 2.088 | tINS | RR | 3750 | IOT27[A] | clk_27m_ibuf/O
41.396 | 2.271 | tNET | RR | 1 | R8C28[2][A] | u_top/u_alloc/v_note_55_s0/CLK
41.361 | -0.035 | tSu | | 1 | R8C28[2][A] | u_top/u_alloc/v_note_55_s0

Path Statistics:

Clock Skew | 0.000
Setup Relationship | 37.037
Logic Level | 24
Arrival Clock Path Delay | cell: 2.088, 47.897%; route: 2.271, 52.103%
Arrival Data Path Delay | cell: 13.571, 41.348%; route: 19.019, 57.945%; tC2Q: 0.232, 0.707%
Required Clock Path Delay | cell: 2.088, 47.897%; route: 2.271, 52.103%

### Path13

Path Summary:

Slack | 4.354
Data Arrival Time | 37.007
Data Required Time | 41.361
From | u_top/u_manual/wr_ptr_0_s0
To | u_top/u_alloc/v_note_28_s0
Launch Clk | clk_27m:[R]
Latch Clk | clk_27m:[R]

Data Arrival Path:

AT | DELAY | TYPE | RF | FANOUT | LOC | NODE
0.000 | 0.000 | | | | | active clock edge time
0.000 | 0.000 | | | | | clk_27m
0.000 | 0.000 | tCL | RR | 1 | IOT27[A] | clk_27m_ibuf/I
2.088 | 2.088 | tINS | RR | 3750 | IOT27[A] | clk_27m_ibuf/O
4.359 | 2.271 | tNET | RR | 1 | R42C49[1][A] | u_top/u_manual/wr_ptr_0_s0/CLK
4.591 | 0.232 | tC2Q | RF | 7 | R42C49[1][A] | u_top/u_manual/wr_ptr_0_s0/Q
5.021 | 0.430 | tNET | FF | 2 | R42C46[0][B] | u_top/u_manual/n4_s0/I0
5.570 | 0.549 | tINS | FR | 1 | R42C46[0][B] | u_top/u_manual/n4_s0/COUT
5.570 | 0.000 | tNET | RR | 2 | R42C46[1][A] | u_top/u_manual/n5_s0/CIN
5.606 | 0.035 | tINS | RF | 1 | R42C46[1][A] | u_top/u_manual/n5_s0/COUT
5.606 | 0.000 | tNET | FF | 2 | R42C46[1][B] | u_top/u_manual/n6_s0/CIN
5.641 | 0.035 | tINS | FF | 1 | R42C46[1][B] | u_top/u_manual/n6_s0/COUT
5.641 | 0.000 | tNET | FF | 2 | R42C46[2][A] | u_top/u_manual/n7_s0/CIN
5.676 | 0.035 | tINS | FF | 1 | R42C46[2][A] | u_top/u_manual/n7_s0/COUT
5.676 | 0.000 | tNET | FF | 2 | R42C46[2][B] | u_top/u_manual/n8_s0/CIN
5.711 | 0.035 | tINS | FF | 17 | R42C46[2][B] | u_top/u_manual/n8_s0/COUT
7.859 | 2.148 | tNET | FF | 1 | R36C44[1][A] | u_top/ev_word_11_s2/I2
8.376 | 0.517 | tINS | FF | 1 | R36C44[1][A] | u_top/ev_word_11_s2/F
9.032 | 0.656 | tNET | FF | 1 | R36C41[3][A] | u_top/ev_word_11_s1/I1
9.494 | 0.462 | tINS | FR | 1 | R36C41[3][A] | u_top/ev_word_11_s1/F
9.495 | 0.001 | tNET | RR | 1 | R36C41[1][B] | u_top/ev_word_11_s0/I0
9.948 | 0.453 | tINS | RF | 40 | R36C41[1][B] | u_top/ev_word_11_s0/F
15.910 | 5.961 | tNET | FF | 2 | R8C23[1][B] | u_top/u_alloc/n51_s0/I1
16.480 | 0.570 | tINS | FR | 1 | R8C23[1][B] | u_top/u_alloc/n51_s0/COUT
16.480 | 0.000 | tNET | RR | 2 | R8C23[2][A] | u_top/u_alloc/n52_s0/CIN
16.515 | 0.035 | tINS | RF | 1 | R8C23[2][A] | u_top/u_alloc/n52_s0/COUT
16.515 | 0.000 | tNET | FF | 2 | R8C23[2][B] | u_top/u_alloc/n53_s0/CIN
16.550 | 0.035 | tINS | FF | 1 | R8C23[2][B] | u_top/u_alloc/n53_s0/COUT
16.550 | 0.000 | tNET | FF | 2 | R8C24[0][A] | u_top/u_alloc/n54_s0/CIN
16.585 | 0.035 | tINS | FF | 3 | R8C24[0][A] | u_top/u_alloc/n54_s0/COUT
17.555 | 0.970 | tNET | FF | 1 | R12C24[1][B] | u_top/u_alloc/pick_2_s60/I0
18.008 | 0.453 | tINS | FF | 3 | R12C24[1][B] | u_top/u_alloc/pick_2_s60/F
18.197 | 0.189 | tNET | FF | 1 | R12C23[3][A] | u_top/u_alloc/pick_0_s61/I1
18.746 | 0.549 | tINS | FR | 3 | R12C23[3][A] | u_top/u_alloc/pick_0_s61/F
18.750 | 0.004 | tNET | RR | 1 | R12C23[2][A] | u_top/u_alloc/pick_2_s101/I2
19.212 | 0.462 | tINS | RR | 1 | R12C23[2][A] | u_top/u_alloc/pick_2_s101/F
19.384 | 0.172 | tNET | RR | 1 | R12C24[3][B] | u_top/u_alloc/pick_2_s85/I0
19.837 | 0.453 | tINS | RF | 4 | R12C24[3][B] | u_top/u_alloc/pick_2_s85/F
20.764 | 0.927 | tNET | FF | 1 | R13C19[3][A] | u_top/u_alloc/pick_2_s62/I3
21.313 | 0.549 | tINS | FR | 3 | R13C19[3][A] | u_top/u_alloc/pick_2_s62/F
21.317 | 0.004 | tNET | RR | 1 | R13C19[0][B] | u_top/u_alloc/pick_2_s84/I1
21.770 | 0.453 | tINS | RF | 1 | R13C19[0][B] | u_top/u_alloc/pick_2_s84/F
22.183 | 0.413 | tNET | FF | 1 | R14C18[0][A] | u_top/u_alloc/pick_2_s58/I2
22.732 | 0.549 | tINS | FR | 1 | R14C18[0][A] | u_top/u_alloc/pick_2_s58/F
22.905 | 0.172 | tNET | RR | 1 | R14C17[2][A] | u_top/u_alloc/pick_2_s118/I3
23.276 | 0.371 | tINS | RF | 2 | R14C17[2][A] | u_top/u_alloc/pick_2_s118/F
23.689 | 0.413 | tNET | FF | 1 | R13C16[3][A] | u_top/u_alloc/pick_2_s8/I3
24.244 | 0.555 | tINS | FF | 7 | R13C16[3][A] | u_top/u_alloc/pick_2_s8/F
25.319 | 1.075 | tNET | FF | 1 | R12C21[2][B] | u_top/u_alloc/pick_1_s12/I1
25.889 | 0.570 | tINS | FR | 1 | R12C21[2][B] | u_top/u_alloc/pick_1_s12/F
25.890 | 0.001 | tNET | RR | 1 | R12C21[3][A] | u_top/u_alloc/pick_1_s6/I3
26.439 | 0.549 | tINS | RR | 1 | R12C21[3][A] | u_top/u_alloc/pick_1_s6/F
26.611 | 0.172 | tNET | RR | 1 | R12C20[1][B] | u_top/u_alloc/pick_1_s2/I1
27.166 | 0.555 | tINS | RF | 9 | R12C20[1][B] | u_top/u_alloc/pick_1_s2/F
28.325 | 1.159 | tNET | FF | 1 | R7C20[0][A] | u_top/u_alloc/pick_1_s43/I3
28.842 | 0.517 | tINS | FF | 12 | R7C20[0][A] | u_top/u_alloc/pick_1_s43/F
30.057 | 1.215 | tNET | FF | 18 | DSP_R19[1][A] | u_top/u_alloc/n453_s1/B[1]
33.697 | 3.640 | tINS | FF | 8 | DSP_R19[1][A] | u_top/u_alloc/n453_s1/DOUT[6]
36.291 | 2.595 | tNET | FF | 1 | R9C27[1][B] | u_top/u_alloc/n3434_s1/I0
36.861 | 0.570 | tINS | FR | 7 | R9C27[1][B] | u_top/u_alloc/n3434_s1/F
37.007 | 0.146 | tNET | RR | 1 | R9C27[1][A] | u_top/u_alloc/v_note_28_s0/CE

Data Required Path:

AT | DELAY | TYPE | RF | FANOUT | LOC | NODE
37.037 | 37.037 | | | | | active clock edge time
37.037 | 0.000 | | | | | clk_27m
37.037 | 0.000 | tCL | RR | 1 | IOT27[A] | clk_27m_ibuf/I
39.125 | 2.088 | tINS | RR | 3750 | IOT27[A] | clk_27m_ibuf/O
41.396 | 2.271 | tNET | RR | 1 | R9C27[1][A] | u_top/u_alloc/v_note_28_s0/CLK
41.361 | -0.035 | tSu | | 1 | R9C27[1][A] | u_top/u_alloc/v_note_28_s0

Path Statistics:

Clock Skew | 0.000
Setup Relationship | 37.037
Logic Level | 24
Arrival Clock Path Delay | cell: 2.088, 47.897%; route: 2.271, 52.103%
Arrival Data Path Delay | cell: 13.592, 41.634%; route: 18.823, 57.656%; tC2Q: 0.232, 0.711%
Required Clock Path Delay | cell: 2.088, 47.897%; route: 2.271, 52.103%

### Path14

Path Summary:

Slack | 4.375
Data Arrival Time | 36.986
Data Required Time | 41.361
From | u_top/u_manual/wr_ptr_0_s0
To | u_top/u_alloc/v_note_51_s0
Launch Clk | clk_27m:[R]
Latch Clk | clk_27m:[R]

Data Arrival Path:

AT | DELAY | TYPE | RF | FANOUT | LOC | NODE
0.000 | 0.000 | | | | | active clock edge time
0.000 | 0.000 | | | | | clk_27m
0.000 | 0.000 | tCL | RR | 1 | IOT27[A] | clk_27m_ibuf/I
2.088 | 2.088 | tINS | RR | 3750 | IOT27[A] | clk_27m_ibuf/O
4.359 | 2.271 | tNET | RR | 1 | R42C49[1][A] | u_top/u_manual/wr_ptr_0_s0/CLK
4.591 | 0.232 | tC2Q | RF | 7 | R42C49[1][A] | u_top/u_manual/wr_ptr_0_s0/Q
5.021 | 0.430 | tNET | FF | 2 | R42C46[0][B] | u_top/u_manual/n4_s0/I0
5.570 | 0.549 | tINS | FR | 1 | R42C46[0][B] | u_top/u_manual/n4_s0/COUT
5.570 | 0.000 | tNET | RR | 2 | R42C46[1][A] | u_top/u_manual/n5_s0/CIN
5.606 | 0.035 | tINS | RF | 1 | R42C46[1][A] | u_top/u_manual/n5_s0/COUT
5.606 | 0.000 | tNET | FF | 2 | R42C46[1][B] | u_top/u_manual/n6_s0/CIN
5.641 | 0.035 | tINS | FF | 1 | R42C46[1][B] | u_top/u_manual/n6_s0/COUT
5.641 | 0.000 | tNET | FF | 2 | R42C46[2][A] | u_top/u_manual/n7_s0/CIN
5.676 | 0.035 | tINS | FF | 1 | R42C46[2][A] | u_top/u_manual/n7_s0/COUT
5.676 | 0.000 | tNET | FF | 2 | R42C46[2][B] | u_top/u_manual/n8_s0/CIN
5.711 | 0.035 | tINS | FF | 17 | R42C46[2][B] | u_top/u_manual/n8_s0/COUT
7.859 | 2.148 | tNET | FF | 1 | R36C44[1][A] | u_top/ev_word_11_s2/I2
8.376 | 0.517 | tINS | FF | 1 | R36C44[1][A] | u_top/ev_word_11_s2/F
9.032 | 0.656 | tNET | FF | 1 | R36C41[3][A] | u_top/ev_word_11_s1/I1
9.494 | 0.462 | tINS | FR | 1 | R36C41[3][A] | u_top/ev_word_11_s1/F
9.495 | 0.001 | tNET | RR | 1 | R36C41[1][B] | u_top/ev_word_11_s0/I0
9.948 | 0.453 | tINS | RF | 40 | R36C41[1][B] | u_top/ev_word_11_s0/F
15.910 | 5.961 | tNET | FF | 2 | R8C23[1][B] | u_top/u_alloc/n51_s0/I1
16.480 | 0.570 | tINS | FR | 1 | R8C23[1][B] | u_top/u_alloc/n51_s0/COUT
16.480 | 0.000 | tNET | RR | 2 | R8C23[2][A] | u_top/u_alloc/n52_s0/CIN
16.515 | 0.035 | tINS | RF | 1 | R8C23[2][A] | u_top/u_alloc/n52_s0/COUT
16.515 | 0.000 | tNET | FF | 2 | R8C23[2][B] | u_top/u_alloc/n53_s0/CIN
16.550 | 0.035 | tINS | FF | 1 | R8C23[2][B] | u_top/u_alloc/n53_s0/COUT
16.550 | 0.000 | tNET | FF | 2 | R8C24[0][A] | u_top/u_alloc/n54_s0/CIN
16.585 | 0.035 | tINS | FF | 3 | R8C24[0][A] | u_top/u_alloc/n54_s0/COUT
17.555 | 0.970 | tNET | FF | 1 | R12C24[1][B] | u_top/u_alloc/pick_2_s60/I0
18.008 | 0.453 | tINS | FF | 3 | R12C24[1][B] | u_top/u_alloc/pick_2_s60/F
18.197 | 0.189 | tNET | FF | 1 | R12C23[3][A] | u_top/u_alloc/pick_0_s61/I1
18.746 | 0.549 | tINS | FR | 3 | R12C23[3][A] | u_top/u_alloc/pick_0_s61/F
18.750 | 0.004 | tNET | RR | 1 | R12C23[2][A] | u_top/u_alloc/pick_2_s101/I2
19.212 | 0.462 | tINS | RR | 1 | R12C23[2][A] | u_top/u_alloc/pick_2_s101/F
19.384 | 0.172 | tNET | RR | 1 | R12C24[3][B] | u_top/u_alloc/pick_2_s85/I0
19.837 | 0.453 | tINS | RF | 4 | R12C24[3][B] | u_top/u_alloc/pick_2_s85/F
20.764 | 0.927 | tNET | FF | 1 | R13C19[3][A] | u_top/u_alloc/pick_2_s62/I3
21.313 | 0.549 | tINS | FR | 3 | R13C19[3][A] | u_top/u_alloc/pick_2_s62/F
21.317 | 0.004 | tNET | RR | 1 | R13C19[0][B] | u_top/u_alloc/pick_2_s84/I1
21.770 | 0.453 | tINS | RF | 1 | R13C19[0][B] | u_top/u_alloc/pick_2_s84/F
22.183 | 0.413 | tNET | FF | 1 | R14C18[0][A] | u_top/u_alloc/pick_2_s58/I2
22.732 | 0.549 | tINS | FR | 1 | R14C18[0][A] | u_top/u_alloc/pick_2_s58/F
22.905 | 0.172 | tNET | RR | 1 | R14C17[2][A] | u_top/u_alloc/pick_2_s118/I3
23.276 | 0.371 | tINS | RF | 2 | R14C17[2][A] | u_top/u_alloc/pick_2_s118/F
23.689 | 0.413 | tNET | FF | 1 | R13C16[3][A] | u_top/u_alloc/pick_2_s8/I3
24.244 | 0.555 | tINS | FF | 7 | R13C16[3][A] | u_top/u_alloc/pick_2_s8/F
25.319 | 1.075 | tNET | FF | 1 | R12C21[2][B] | u_top/u_alloc/pick_1_s12/I1
25.889 | 0.570 | tINS | FR | 1 | R12C21[2][B] | u_top/u_alloc/pick_1_s12/F
25.890 | 0.001 | tNET | RR | 1 | R12C21[3][A] | u_top/u_alloc/pick_1_s6/I3
26.439 | 0.549 | tINS | RR | 1 | R12C21[3][A] | u_top/u_alloc/pick_1_s6/F
26.611 | 0.172 | tNET | RR | 1 | R12C20[1][B] | u_top/u_alloc/pick_1_s2/I1
27.166 | 0.555 | tINS | RF | 9 | R12C20[1][B] | u_top/u_alloc/pick_1_s2/F
28.325 | 1.159 | tNET | FF | 1 | R7C20[0][A] | u_top/u_alloc/pick_1_s43/I3
28.842 | 0.517 | tINS | FF | 12 | R7C20[0][A] | u_top/u_alloc/pick_1_s43/F
30.057 | 1.215 | tNET | FF | 18 | DSP_R19[1][A] | u_top/u_alloc/n453_s1/B[1]
33.697 | 3.640 | tINS | FF | 8 | DSP_R19[1][A] | u_top/u_alloc/n453_s1/DOUT[6]
36.291 | 2.595 | tNET | FF | 1 | R8C27[3][A] | u_top/u_alloc/n3392_s1/I0
36.840 | 0.549 | tINS | FR | 7 | R8C27[3][A] | u_top/u_alloc/n3392_s1/F
36.986 | 0.146 | tNET | RR | 1 | R8C27[2][A] | u_top/u_alloc/v_note_51_s0/CE

Data Required Path:

AT | DELAY | TYPE | RF | FANOUT | LOC | NODE
37.037 | 37.037 | | | | | active clock edge time
37.037 | 0.000 | | | | | clk_27m
37.037 | 0.000 | tCL | RR | 1 | IOT27[A] | clk_27m_ibuf/I
39.125 | 2.088 | tINS | RR | 3750 | IOT27[A] | clk_27m_ibuf/O
41.396 | 2.271 | tNET | RR | 1 | R8C27[2][A] | u_top/u_alloc/v_note_51_s0/CLK
41.361 | -0.035 | tSu | | 1 | R8C27[2][A] | u_top/u_alloc/v_note_51_s0

Path Statistics:

Clock Skew | 0.000
Setup Relationship | 37.037
Logic Level | 24
Arrival Clock Path Delay | cell: 2.088, 47.897%; route: 2.271, 52.103%
Arrival Data Path Delay | cell: 13.571, 41.596%; route: 18.823, 57.693%; tC2Q: 0.232, 0.711%
Required Clock Path Delay | cell: 2.088, 47.897%; route: 2.271, 52.103%

### Path15

Path Summary:

Slack | 4.439
Data Arrival Time | 36.922
Data Required Time | 41.361
From | u_top/u_manual/wr_ptr_0_s0
To | u_top/u_alloc/v_note_41_s0
Launch Clk | clk_27m:[R]
Latch Clk | clk_27m:[R]

Data Arrival Path:

AT | DELAY | TYPE | RF | FANOUT | LOC | NODE
0.000 | 0.000 | | | | | active clock edge time
0.000 | 0.000 | | | | | clk_27m
0.000 | 0.000 | tCL | RR | 1 | IOT27[A] | clk_27m_ibuf/I
2.088 | 2.088 | tINS | RR | 3750 | IOT27[A] | clk_27m_ibuf/O
4.359 | 2.271 | tNET | RR | 1 | R42C49[1][A] | u_top/u_manual/wr_ptr_0_s0/CLK
4.591 | 0.232 | tC2Q | RF | 7 | R42C49[1][A] | u_top/u_manual/wr_ptr_0_s0/Q
5.021 | 0.430 | tNET | FF | 2 | R42C46[0][B] | u_top/u_manual/n4_s0/I0
5.570 | 0.549 | tINS | FR | 1 | R42C46[0][B] | u_top/u_manual/n4_s0/COUT
5.570 | 0.000 | tNET | RR | 2 | R42C46[1][A] | u_top/u_manual/n5_s0/CIN
5.606 | 0.035 | tINS | RF | 1 | R42C46[1][A] | u_top/u_manual/n5_s0/COUT
5.606 | 0.000 | tNET | FF | 2 | R42C46[1][B] | u_top/u_manual/n6_s0/CIN
5.641 | 0.035 | tINS | FF | 1 | R42C46[1][B] | u_top/u_manual/n6_s0/COUT
5.641 | 0.000 | tNET | FF | 2 | R42C46[2][A] | u_top/u_manual/n7_s0/CIN
5.676 | 0.035 | tINS | FF | 1 | R42C46[2][A] | u_top/u_manual/n7_s0/COUT
5.676 | 0.000 | tNET | FF | 2 | R42C46[2][B] | u_top/u_manual/n8_s0/CIN
5.711 | 0.035 | tINS | FF | 17 | R42C46[2][B] | u_top/u_manual/n8_s0/COUT
7.859 | 2.148 | tNET | FF | 1 | R36C44[1][A] | u_top/ev_word_11_s2/I2
8.376 | 0.517 | tINS | FF | 1 | R36C44[1][A] | u_top/ev_word_11_s2/F
9.032 | 0.656 | tNET | FF | 1 | R36C41[3][A] | u_top/ev_word_11_s1/I1
9.494 | 0.462 | tINS | FR | 1 | R36C41[3][A] | u_top/ev_word_11_s1/F
9.495 | 0.001 | tNET | RR | 1 | R36C41[1][B] | u_top/ev_word_11_s0/I0
9.948 | 0.453 | tINS | RF | 40 | R36C41[1][B] | u_top/ev_word_11_s0/F
15.910 | 5.961 | tNET | FF | 2 | R8C23[1][B] | u_top/u_alloc/n51_s0/I1
16.480 | 0.570 | tINS | FR | 1 | R8C23[1][B] | u_top/u_alloc/n51_s0/COUT
16.480 | 0.000 | tNET | RR | 2 | R8C23[2][A] | u_top/u_alloc/n52_s0/CIN
16.515 | 0.035 | tINS | RF | 1 | R8C23[2][A] | u_top/u_alloc/n52_s0/COUT
16.515 | 0.000 | tNET | FF | 2 | R8C23[2][B] | u_top/u_alloc/n53_s0/CIN
16.550 | 0.035 | tINS | FF | 1 | R8C23[2][B] | u_top/u_alloc/n53_s0/COUT
16.550 | 0.000 | tNET | FF | 2 | R8C24[0][A] | u_top/u_alloc/n54_s0/CIN
16.585 | 0.035 | tINS | FF | 3 | R8C24[0][A] | u_top/u_alloc/n54_s0/COUT
17.555 | 0.970 | tNET | FF | 1 | R12C24[1][B] | u_top/u_alloc/pick_2_s60/I0
18.008 | 0.453 | tINS | FF | 3 | R12C24[1][B] | u_top/u_alloc/pick_2_s60/F
18.197 | 0.189 | tNET | FF | 1 | R12C23[3][A] | u_top/u_alloc/pick_0_s61/I1
18.746 | 0.549 | tINS | FR | 3 | R12C23[3][A] | u_top/u_alloc/pick_0_s61/F
18.750 | 0.004 | tNET | RR | 1 | R12C23[2][A] | u_top/u_alloc/pick_2_s101/I2
19.212 | 0.462 | tINS | RR | 1 | R12C23[2][A] | u_top/u_alloc/pick_2_s101/F
19.384 | 0.172 | tNET | RR | 1 | R12C24[3][B] | u_top/u_alloc/pick_2_s85/I0
19.837 | 0.453 | tINS | RF | 4 | R12C24[3][B] | u_top/u_alloc/pick_2_s85/F
20.764 | 0.927 | tNET | FF | 1 | R13C19[3][A] | u_top/u_alloc/pick_2_s62/I3
21.313 | 0.549 | tINS | FR | 3 | R13C19[3][A] | u_top/u_alloc/pick_2_s62/F
21.317 | 0.004 | tNET | RR | 1 | R13C19[0][B] | u_top/u_alloc/pick_2_s84/I1
21.770 | 0.453 | tINS | RF | 1 | R13C19[0][B] | u_top/u_alloc/pick_2_s84/F
22.183 | 0.413 | tNET | FF | 1 | R14C18[0][A] | u_top/u_alloc/pick_2_s58/I2
22.732 | 0.549 | tINS | FR | 1 | R14C18[0][A] | u_top/u_alloc/pick_2_s58/F
22.905 | 0.172 | tNET | RR | 1 | R14C17[2][A] | u_top/u_alloc/pick_2_s118/I3
23.276 | 0.371 | tINS | RF | 2 | R14C17[2][A] | u_top/u_alloc/pick_2_s118/F
23.689 | 0.413 | tNET | FF | 1 | R13C16[3][A] | u_top/u_alloc/pick_2_s8/I3
24.244 | 0.555 | tINS | FF | 7 | R13C16[3][A] | u_top/u_alloc/pick_2_s8/F
25.319 | 1.075 | tNET | FF | 1 | R12C21[2][B] | u_top/u_alloc/pick_1_s12/I1
25.889 | 0.570 | tINS | FR | 1 | R12C21[2][B] | u_top/u_alloc/pick_1_s12/F
25.890 | 0.001 | tNET | RR | 1 | R12C21[3][A] | u_top/u_alloc/pick_1_s6/I3
26.439 | 0.549 | tINS | RR | 1 | R12C21[3][A] | u_top/u_alloc/pick_1_s6/F
26.611 | 0.172 | tNET | RR | 1 | R12C20[1][B] | u_top/u_alloc/pick_1_s2/I1
27.166 | 0.555 | tINS | RF | 9 | R12C20[1][B] | u_top/u_alloc/pick_1_s2/F
28.325 | 1.159 | tNET | FF | 1 | R7C20[0][A] | u_top/u_alloc/pick_1_s43/I3
28.842 | 0.517 | tINS | FF | 12 | R7C20[0][A] | u_top/u_alloc/pick_1_s43/F
30.057 | 1.215 | tNET | FF | 18 | DSP_R19[1][A] | u_top/u_alloc/n453_s1/B[1]
33.697 | 3.640 | tINS | FF | 8 | DSP_R19[1][A] | u_top/u_alloc/n453_s1/DOUT[6]
35.800 | 2.103 | tNET | FF | 1 | R11C26[0][B] | u_top/u_alloc/n3420_s1/I0
36.370 | 0.570 | tINS | FR | 7 | R11C26[0][B] | u_top/u_alloc/n3420_s1/F
36.922 | 0.552 | tNET | RR | 1 | R7C26[0][A] | u_top/u_alloc/v_note_41_s0/CE

Data Required Path:

AT | DELAY | TYPE | RF | FANOUT | LOC | NODE
37.037 | 37.037 | | | | | active clock edge time
37.037 | 0.000 | | | | | clk_27m
37.037 | 0.000 | tCL | RR | 1 | IOT27[A] | clk_27m_ibuf/I
39.125 | 2.088 | tINS | RR | 3750 | IOT27[A] | clk_27m_ibuf/O
41.396 | 2.271 | tNET | RR | 1 | R7C26[0][A] | u_top/u_alloc/v_note_41_s0/CLK
41.361 | -0.035 | tSu | | 1 | R7C26[0][A] | u_top/u_alloc/v_note_41_s0

Path Statistics:

Clock Skew | 0.000
Setup Relationship | 37.037
Logic Level | 24
Arrival Clock Path Delay | cell: 2.088, 47.897%; route: 2.271, 52.103%
Arrival Data Path Delay | cell: 13.592, 41.742%; route: 18.739, 57.546%; tC2Q: 0.232, 0.712%
Required Clock Path Delay | cell: 2.088, 47.897%; route: 2.271, 52.103%

### Path16

Path Summary:

Slack | 4.623
Data Arrival Time | 36.739
Data Required Time | 41.361
From | u_top/u_manual/wr_ptr_0_s0
To | u_top/u_alloc/v_note_35_s0
Launch Clk | clk_27m:[R]
Latch Clk | clk_27m:[R]

Data Arrival Path:

AT | DELAY | TYPE | RF | FANOUT | LOC | NODE
0.000 | 0.000 | | | | | active clock edge time
0.000 | 0.000 | | | | | clk_27m
0.000 | 0.000 | tCL | RR | 1 | IOT27[A] | clk_27m_ibuf/I
2.088 | 2.088 | tINS | RR | 3750 | IOT27[A] | clk_27m_ibuf/O
4.359 | 2.271 | tNET | RR | 1 | R42C49[1][A] | u_top/u_manual/wr_ptr_0_s0/CLK
4.591 | 0.232 | tC2Q | RF | 7 | R42C49[1][A] | u_top/u_manual/wr_ptr_0_s0/Q
5.021 | 0.430 | tNET | FF | 2 | R42C46[0][B] | u_top/u_manual/n4_s0/I0
5.570 | 0.549 | tINS | FR | 1 | R42C46[0][B] | u_top/u_manual/n4_s0/COUT
5.570 | 0.000 | tNET | RR | 2 | R42C46[1][A] | u_top/u_manual/n5_s0/CIN
5.606 | 0.035 | tINS | RF | 1 | R42C46[1][A] | u_top/u_manual/n5_s0/COUT
5.606 | 0.000 | tNET | FF | 2 | R42C46[1][B] | u_top/u_manual/n6_s0/CIN
5.641 | 0.035 | tINS | FF | 1 | R42C46[1][B] | u_top/u_manual/n6_s0/COUT
5.641 | 0.000 | tNET | FF | 2 | R42C46[2][A] | u_top/u_manual/n7_s0/CIN
5.676 | 0.035 | tINS | FF | 1 | R42C46[2][A] | u_top/u_manual/n7_s0/COUT
5.676 | 0.000 | tNET | FF | 2 | R42C46[2][B] | u_top/u_manual/n8_s0/CIN
5.711 | 0.035 | tINS | FF | 17 | R42C46[2][B] | u_top/u_manual/n8_s0/COUT
7.859 | 2.148 | tNET | FF | 1 | R36C44[1][A] | u_top/ev_word_11_s2/I2
8.376 | 0.517 | tINS | FF | 1 | R36C44[1][A] | u_top/ev_word_11_s2/F
9.032 | 0.656 | tNET | FF | 1 | R36C41[3][A] | u_top/ev_word_11_s1/I1
9.494 | 0.462 | tINS | FR | 1 | R36C41[3][A] | u_top/ev_word_11_s1/F
9.495 | 0.001 | tNET | RR | 1 | R36C41[1][B] | u_top/ev_word_11_s0/I0
9.948 | 0.453 | tINS | RF | 40 | R36C41[1][B] | u_top/ev_word_11_s0/F
15.910 | 5.961 | tNET | FF | 2 | R8C23[1][B] | u_top/u_alloc/n51_s0/I1
16.480 | 0.570 | tINS | FR | 1 | R8C23[1][B] | u_top/u_alloc/n51_s0/COUT
16.480 | 0.000 | tNET | RR | 2 | R8C23[2][A] | u_top/u_alloc/n52_s0/CIN
16.515 | 0.035 | tINS | RF | 1 | R8C23[2][A] | u_top/u_alloc/n52_s0/COUT
16.515 | 0.000 | tNET | FF | 2 | R8C23[2][B] | u_top/u_alloc/n53_s0/CIN
16.550 | 0.035 | tINS | FF | 1 | R8C23[2][B] | u_top/u_alloc/n53_s0/COUT
16.550 | 0.000 | tNET | FF | 2 | R8C24[0][A] | u_top/u_alloc/n54_s0/CIN
16.585 | 0.035 | tINS | FF | 3 | R8C24[0][A] | u_top/u_alloc/n54_s0/COUT
17.555 | 0.970 | tNET | FF | 1 | R12C24[1][B] | u_top/u_alloc/pick_2_s60/I0
18.008 | 0.453 | tINS | FF | 3 | R12C24[1][B] | u_top/u_alloc/pick_2_s60/F
18.197 | 0.189 | tNET | FF | 1 | R12C23[3][A] | u_top/u_alloc/pick_0_s61/I1
18.746 | 0.549 | tINS | FR | 3 | R12C23[3][A] | u_top/u_alloc/pick_0_s61/F
18.750 | 0.004 | tNET | RR | 1 | R12C23[2][A] | u_top/u_alloc/pick_2_s101/I2
19.212 | 0.462 | tINS | RR | 1 | R12C23[2][A] | u_top/u_alloc/pick_2_s101/F
19.384 | 0.172 | tNET | RR | 1 | R12C24[3][B] | u_top/u_alloc/pick_2_s85/I0
19.837 | 0.453 | tINS | RF | 4 | R12C24[3][B] | u_top/u_alloc/pick_2_s85/F
20.764 | 0.927 | tNET | FF | 1 | R13C19[3][A] | u_top/u_alloc/pick_2_s62/I3
21.313 | 0.549 | tINS | FR | 3 | R13C19[3][A] | u_top/u_alloc/pick_2_s62/F
21.317 | 0.004 | tNET | RR | 1 | R13C19[0][B] | u_top/u_alloc/pick_2_s84/I1
21.770 | 0.453 | tINS | RF | 1 | R13C19[0][B] | u_top/u_alloc/pick_2_s84/F
22.183 | 0.413 | tNET | FF | 1 | R14C18[0][A] | u_top/u_alloc/pick_2_s58/I2
22.732 | 0.549 | tINS | FR | 1 | R14C18[0][A] | u_top/u_alloc/pick_2_s58/F
22.905 | 0.172 | tNET | RR | 1 | R14C17[2][A] | u_top/u_alloc/pick_2_s118/I3
23.276 | 0.371 | tINS | RF | 2 | R14C17[2][A] | u_top/u_alloc/pick_2_s118/F
23.689 | 0.413 | tNET | FF | 1 | R13C16[3][A] | u_top/u_alloc/pick_2_s8/I3
24.244 | 0.555 | tINS | FF | 7 | R13C16[3][A] | u_top/u_alloc/pick_2_s8/F
25.319 | 1.075 | tNET | FF | 1 | R12C21[2][B] | u_top/u_alloc/pick_1_s12/I1
25.889 | 0.570 | tINS | FR | 1 | R12C21[2][B] | u_top/u_alloc/pick_1_s12/F
25.890 | 0.001 | tNET | RR | 1 | R12C21[3][A] | u_top/u_alloc/pick_1_s6/I3
26.439 | 0.549 | tINS | RR | 1 | R12C21[3][A] | u_top/u_alloc/pick_1_s6/F
26.611 | 0.172 | tNET | RR | 1 | R12C20[1][B] | u_top/u_alloc/pick_1_s2/I1
27.166 | 0.555 | tINS | RF | 9 | R12C20[1][B] | u_top/u_alloc/pick_1_s2/F
28.325 | 1.159 | tNET | FF | 1 | R7C20[0][A] | u_top/u_alloc/pick_1_s43/I3
28.842 | 0.517 | tINS | FF | 12 | R7C20[0][A] | u_top/u_alloc/pick_1_s43/F
30.057 | 1.215 | tNET | FF | 18 | DSP_R19[1][A] | u_top/u_alloc/n453_s1/B[1]
33.697 | 3.640 | tINS | FF | 8 | DSP_R19[1][A] | u_top/u_alloc/n453_s1/DOUT[6]
35.800 | 2.103 | tNET | FF | 1 | R11C26[0][B] | u_top/u_alloc/n3420_s1/I0
36.370 | 0.570 | tINS | FR | 7 | R11C26[0][B] | u_top/u_alloc/n3420_s1/F
36.739 | 0.368 | tNET | RR | 1 | R8C26[2][B] | u_top/u_alloc/v_note_35_s0/CE

Data Required Path:

AT | DELAY | TYPE | RF | FANOUT | LOC | NODE
37.037 | 37.037 | | | | | active clock edge time
37.037 | 0.000 | | | | | clk_27m
37.037 | 0.000 | tCL | RR | 1 | IOT27[A] | clk_27m_ibuf/I
39.125 | 2.088 | tINS | RR | 3750 | IOT27[A] | clk_27m_ibuf/O
41.396 | 2.271 | tNET | RR | 1 | R8C26[2][B] | u_top/u_alloc/v_note_35_s0/CLK
41.361 | -0.035 | tSu | | 1 | R8C26[2][B] | u_top/u_alloc/v_note_35_s0

Path Statistics:

Clock Skew | 0.000
Setup Relationship | 37.037
Logic Level | 24
Arrival Clock Path Delay | cell: 2.088, 47.897%; route: 2.271, 52.103%
Arrival Data Path Delay | cell: 13.592, 41.979%; route: 18.555, 57.305%; tC2Q: 0.232, 0.717%
Required Clock Path Delay | cell: 2.088, 47.897%; route: 2.271, 52.103%

### Path17

Path Summary:

Slack | 4.623
Data Arrival Time | 36.739
Data Required Time | 41.361
From | u_top/u_manual/wr_ptr_0_s0
To | u_top/u_alloc/v_note_36_s0
Launch Clk | clk_27m:[R]
Latch Clk | clk_27m:[R]

Data Arrival Path:

AT | DELAY | TYPE | RF | FANOUT | LOC | NODE
0.000 | 0.000 | | | | | active clock edge time
0.000 | 0.000 | | | | | clk_27m
0.000 | 0.000 | tCL | RR | 1 | IOT27[A] | clk_27m_ibuf/I
2.088 | 2.088 | tINS | RR | 3750 | IOT27[A] | clk_27m_ibuf/O
4.359 | 2.271 | tNET | RR | 1 | R42C49[1][A] | u_top/u_manual/wr_ptr_0_s0/CLK
4.591 | 0.232 | tC2Q | RF | 7 | R42C49[1][A] | u_top/u_manual/wr_ptr_0_s0/Q
5.021 | 0.430 | tNET | FF | 2 | R42C46[0][B] | u_top/u_manual/n4_s0/I0
5.570 | 0.549 | tINS | FR | 1 | R42C46[0][B] | u_top/u_manual/n4_s0/COUT
5.570 | 0.000 | tNET | RR | 2 | R42C46[1][A] | u_top/u_manual/n5_s0/CIN
5.606 | 0.035 | tINS | RF | 1 | R42C46[1][A] | u_top/u_manual/n5_s0/COUT
5.606 | 0.000 | tNET | FF | 2 | R42C46[1][B] | u_top/u_manual/n6_s0/CIN
5.641 | 0.035 | tINS | FF | 1 | R42C46[1][B] | u_top/u_manual/n6_s0/COUT
5.641 | 0.000 | tNET | FF | 2 | R42C46[2][A] | u_top/u_manual/n7_s0/CIN
5.676 | 0.035 | tINS | FF | 1 | R42C46[2][A] | u_top/u_manual/n7_s0/COUT
5.676 | 0.000 | tNET | FF | 2 | R42C46[2][B] | u_top/u_manual/n8_s0/CIN
5.711 | 0.035 | tINS | FF | 17 | R42C46[2][B] | u_top/u_manual/n8_s0/COUT
7.859 | 2.148 | tNET | FF | 1 | R36C44[1][A] | u_top/ev_word_11_s2/I2
8.376 | 0.517 | tINS | FF | 1 | R36C44[1][A] | u_top/ev_word_11_s2/F
9.032 | 0.656 | tNET | FF | 1 | R36C41[3][A] | u_top/ev_word_11_s1/I1
9.494 | 0.462 | tINS | FR | 1 | R36C41[3][A] | u_top/ev_word_11_s1/F
9.495 | 0.001 | tNET | RR | 1 | R36C41[1][B] | u_top/ev_word_11_s0/I0
9.948 | 0.453 | tINS | RF | 40 | R36C41[1][B] | u_top/ev_word_11_s0/F
15.910 | 5.961 | tNET | FF | 2 | R8C23[1][B] | u_top/u_alloc/n51_s0/I1
16.480 | 0.570 | tINS | FR | 1 | R8C23[1][B] | u_top/u_alloc/n51_s0/COUT
16.480 | 0.000 | tNET | RR | 2 | R8C23[2][A] | u_top/u_alloc/n52_s0/CIN
16.515 | 0.035 | tINS | RF | 1 | R8C23[2][A] | u_top/u_alloc/n52_s0/COUT
16.515 | 0.000 | tNET | FF | 2 | R8C23[2][B] | u_top/u_alloc/n53_s0/CIN
16.550 | 0.035 | tINS | FF | 1 | R8C23[2][B] | u_top/u_alloc/n53_s0/COUT
16.550 | 0.000 | tNET | FF | 2 | R8C24[0][A] | u_top/u_alloc/n54_s0/CIN
16.585 | 0.035 | tINS | FF | 3 | R8C24[0][A] | u_top/u_alloc/n54_s0/COUT
17.555 | 0.970 | tNET | FF | 1 | R12C24[1][B] | u_top/u_alloc/pick_2_s60/I0
18.008 | 0.453 | tINS | FF | 3 | R12C24[1][B] | u_top/u_alloc/pick_2_s60/F
18.197 | 0.189 | tNET | FF | 1 | R12C23[3][A] | u_top/u_alloc/pick_0_s61/I1
18.746 | 0.549 | tINS | FR | 3 | R12C23[3][A] | u_top/u_alloc/pick_0_s61/F
18.750 | 0.004 | tNET | RR | 1 | R12C23[2][A] | u_top/u_alloc/pick_2_s101/I2
19.212 | 0.462 | tINS | RR | 1 | R12C23[2][A] | u_top/u_alloc/pick_2_s101/F
19.384 | 0.172 | tNET | RR | 1 | R12C24[3][B] | u_top/u_alloc/pick_2_s85/I0
19.837 | 0.453 | tINS | RF | 4 | R12C24[3][B] | u_top/u_alloc/pick_2_s85/F
20.764 | 0.927 | tNET | FF | 1 | R13C19[3][A] | u_top/u_alloc/pick_2_s62/I3
21.313 | 0.549 | tINS | FR | 3 | R13C19[3][A] | u_top/u_alloc/pick_2_s62/F
21.317 | 0.004 | tNET | RR | 1 | R13C19[0][B] | u_top/u_alloc/pick_2_s84/I1
21.770 | 0.453 | tINS | RF | 1 | R13C19[0][B] | u_top/u_alloc/pick_2_s84/F
22.183 | 0.413 | tNET | FF | 1 | R14C18[0][A] | u_top/u_alloc/pick_2_s58/I2
22.732 | 0.549 | tINS | FR | 1 | R14C18[0][A] | u_top/u_alloc/pick_2_s58/F
22.905 | 0.172 | tNET | RR | 1 | R14C17[2][A] | u_top/u_alloc/pick_2_s118/I3
23.276 | 0.371 | tINS | RF | 2 | R14C17[2][A] | u_top/u_alloc/pick_2_s118/F
23.689 | 0.413 | tNET | FF | 1 | R13C16[3][A] | u_top/u_alloc/pick_2_s8/I3
24.244 | 0.555 | tINS | FF | 7 | R13C16[3][A] | u_top/u_alloc/pick_2_s8/F
25.319 | 1.075 | tNET | FF | 1 | R12C21[2][B] | u_top/u_alloc/pick_1_s12/I1
25.889 | 0.570 | tINS | FR | 1 | R12C21[2][B] | u_top/u_alloc/pick_1_s12/F
25.890 | 0.001 | tNET | RR | 1 | R12C21[3][A] | u_top/u_alloc/pick_1_s6/I3
26.439 | 0.549 | tINS | RR | 1 | R12C21[3][A] | u_top/u_alloc/pick_1_s6/F
26.611 | 0.172 | tNET | RR | 1 | R12C20[1][B] | u_top/u_alloc/pick_1_s2/I1
27.166 | 0.555 | tINS | RF | 9 | R12C20[1][B] | u_top/u_alloc/pick_1_s2/F
28.325 | 1.159 | tNET | FF | 1 | R7C20[0][A] | u_top/u_alloc/pick_1_s43/I3
28.842 | 0.517 | tINS | FF | 12 | R7C20[0][A] | u_top/u_alloc/pick_1_s43/F
30.057 | 1.215 | tNET | FF | 18 | DSP_R19[1][A] | u_top/u_alloc/n453_s1/B[1]
33.697 | 3.640 | tINS | FF | 8 | DSP_R19[1][A] | u_top/u_alloc/n453_s1/DOUT[6]
35.800 | 2.103 | tNET | FF | 1 | R11C26[0][B] | u_top/u_alloc/n3420_s1/I0
36.370 | 0.570 | tINS | FR | 7 | R11C26[0][B] | u_top/u_alloc/n3420_s1/F
36.739 | 0.368 | tNET | RR | 1 | R8C26[1][B] | u_top/u_alloc/v_note_36_s0/CE

Data Required Path:

AT | DELAY | TYPE | RF | FANOUT | LOC | NODE
37.037 | 37.037 | | | | | active clock edge time
37.037 | 0.000 | | | | | clk_27m
37.037 | 0.000 | tCL | RR | 1 | IOT27[A] | clk_27m_ibuf/I
39.125 | 2.088 | tINS | RR | 3750 | IOT27[A] | clk_27m_ibuf/O
41.396 | 2.271 | tNET | RR | 1 | R8C26[1][B] | u_top/u_alloc/v_note_36_s0/CLK
41.361 | -0.035 | tSu | | 1 | R8C26[1][B] | u_top/u_alloc/v_note_36_s0

Path Statistics:

Clock Skew | 0.000
Setup Relationship | 37.037
Logic Level | 24
Arrival Clock Path Delay | cell: 2.088, 47.897%; route: 2.271, 52.103%
Arrival Data Path Delay | cell: 13.592, 41.979%; route: 18.555, 57.305%; tC2Q: 0.232, 0.717%
Required Clock Path Delay | cell: 2.088, 47.897%; route: 2.271, 52.103%

### Path18

Path Summary:

Slack | 4.623
Data Arrival Time | 36.739
Data Required Time | 41.361
From | u_top/u_manual/wr_ptr_0_s0
To | u_top/u_alloc/v_note_38_s0
Launch Clk | clk_27m:[R]
Latch Clk | clk_27m:[R]

Data Arrival Path:

AT | DELAY | TYPE | RF | FANOUT | LOC | NODE
0.000 | 0.000 | | | | | active clock edge time
0.000 | 0.000 | | | | | clk_27m
0.000 | 0.000 | tCL | RR | 1 | IOT27[A] | clk_27m_ibuf/I
2.088 | 2.088 | tINS | RR | 3750 | IOT27[A] | clk_27m_ibuf/O
4.359 | 2.271 | tNET | RR | 1 | R42C49[1][A] | u_top/u_manual/wr_ptr_0_s0/CLK
4.591 | 0.232 | tC2Q | RF | 7 | R42C49[1][A] | u_top/u_manual/wr_ptr_0_s0/Q
5.021 | 0.430 | tNET | FF | 2 | R42C46[0][B] | u_top/u_manual/n4_s0/I0
5.570 | 0.549 | tINS | FR | 1 | R42C46[0][B] | u_top/u_manual/n4_s0/COUT
5.570 | 0.000 | tNET | RR | 2 | R42C46[1][A] | u_top/u_manual/n5_s0/CIN
5.606 | 0.035 | tINS | RF | 1 | R42C46[1][A] | u_top/u_manual/n5_s0/COUT
5.606 | 0.000 | tNET | FF | 2 | R42C46[1][B] | u_top/u_manual/n6_s0/CIN
5.641 | 0.035 | tINS | FF | 1 | R42C46[1][B] | u_top/u_manual/n6_s0/COUT
5.641 | 0.000 | tNET | FF | 2 | R42C46[2][A] | u_top/u_manual/n7_s0/CIN
5.676 | 0.035 | tINS | FF | 1 | R42C46[2][A] | u_top/u_manual/n7_s0/COUT
5.676 | 0.000 | tNET | FF | 2 | R42C46[2][B] | u_top/u_manual/n8_s0/CIN
5.711 | 0.035 | tINS | FF | 17 | R42C46[2][B] | u_top/u_manual/n8_s0/COUT
7.859 | 2.148 | tNET | FF | 1 | R36C44[1][A] | u_top/ev_word_11_s2/I2
8.376 | 0.517 | tINS | FF | 1 | R36C44[1][A] | u_top/ev_word_11_s2/F
9.032 | 0.656 | tNET | FF | 1 | R36C41[3][A] | u_top/ev_word_11_s1/I1
9.494 | 0.462 | tINS | FR | 1 | R36C41[3][A] | u_top/ev_word_11_s1/F
9.495 | 0.001 | tNET | RR | 1 | R36C41[1][B] | u_top/ev_word_11_s0/I0
9.948 | 0.453 | tINS | RF | 40 | R36C41[1][B] | u_top/ev_word_11_s0/F
15.910 | 5.961 | tNET | FF | 2 | R8C23[1][B] | u_top/u_alloc/n51_s0/I1
16.480 | 0.570 | tINS | FR | 1 | R8C23[1][B] | u_top/u_alloc/n51_s0/COUT
16.480 | 0.000 | tNET | RR | 2 | R8C23[2][A] | u_top/u_alloc/n52_s0/CIN
16.515 | 0.035 | tINS | RF | 1 | R8C23[2][A] | u_top/u_alloc/n52_s0/COUT
16.515 | 0.000 | tNET | FF | 2 | R8C23[2][B] | u_top/u_alloc/n53_s0/CIN
16.550 | 0.035 | tINS | FF | 1 | R8C23[2][B] | u_top/u_alloc/n53_s0/COUT
16.550 | 0.000 | tNET | FF | 2 | R8C24[0][A] | u_top/u_alloc/n54_s0/CIN
16.585 | 0.035 | tINS | FF | 3 | R8C24[0][A] | u_top/u_alloc/n54_s0/COUT
17.555 | 0.970 | tNET | FF | 1 | R12C24[1][B] | u_top/u_alloc/pick_2_s60/I0
18.008 | 0.453 | tINS | FF | 3 | R12C24[1][B] | u_top/u_alloc/pick_2_s60/F
18.197 | 0.189 | tNET | FF | 1 | R12C23[3][A] | u_top/u_alloc/pick_0_s61/I1
18.746 | 0.549 | tINS | FR | 3 | R12C23[3][A] | u_top/u_alloc/pick_0_s61/F
18.750 | 0.004 | tNET | RR | 1 | R12C23[2][A] | u_top/u_alloc/pick_2_s101/I2
19.212 | 0.462 | tINS | RR | 1 | R12C23[2][A] | u_top/u_alloc/pick_2_s101/F
19.384 | 0.172 | tNET | RR | 1 | R12C24[3][B] | u_top/u_alloc/pick_2_s85/I0
19.837 | 0.453 | tINS | RF | 4 | R12C24[3][B] | u_top/u_alloc/pick_2_s85/F
20.764 | 0.927 | tNET | FF | 1 | R13C19[3][A] | u_top/u_alloc/pick_2_s62/I3
21.313 | 0.549 | tINS | FR | 3 | R13C19[3][A] | u_top/u_alloc/pick_2_s62/F
21.317 | 0.004 | tNET | RR | 1 | R13C19[0][B] | u_top/u_alloc/pick_2_s84/I1
21.770 | 0.453 | tINS | RF | 1 | R13C19[0][B] | u_top/u_alloc/pick_2_s84/F
22.183 | 0.413 | tNET | FF | 1 | R14C18[0][A] | u_top/u_alloc/pick_2_s58/I2
22.732 | 0.549 | tINS | FR | 1 | R14C18[0][A] | u_top/u_alloc/pick_2_s58/F
22.905 | 0.172 | tNET | RR | 1 | R14C17[2][A] | u_top/u_alloc/pick_2_s118/I3
23.276 | 0.371 | tINS | RF | 2 | R14C17[2][A] | u_top/u_alloc/pick_2_s118/F
23.689 | 0.413 | tNET | FF | 1 | R13C16[3][A] | u_top/u_alloc/pick_2_s8/I3
24.244 | 0.555 | tINS | FF | 7 | R13C16[3][A] | u_top/u_alloc/pick_2_s8/F
25.319 | 1.075 | tNET | FF | 1 | R12C21[2][B] | u_top/u_alloc/pick_1_s12/I1
25.889 | 0.570 | tINS | FR | 1 | R12C21[2][B] | u_top/u_alloc/pick_1_s12/F
25.890 | 0.001 | tNET | RR | 1 | R12C21[3][A] | u_top/u_alloc/pick_1_s6/I3
26.439 | 0.549 | tINS | RR | 1 | R12C21[3][A] | u_top/u_alloc/pick_1_s6/F
26.611 | 0.172 | tNET | RR | 1 | R12C20[1][B] | u_top/u_alloc/pick_1_s2/I1
27.166 | 0.555 | tINS | RF | 9 | R12C20[1][B] | u_top/u_alloc/pick_1_s2/F
28.325 | 1.159 | tNET | FF | 1 | R7C20[0][A] | u_top/u_alloc/pick_1_s43/I3
28.842 | 0.517 | tINS | FF | 12 | R7C20[0][A] | u_top/u_alloc/pick_1_s43/F
30.057 | 1.215 | tNET | FF | 18 | DSP_R19[1][A] | u_top/u_alloc/n453_s1/B[1]
33.697 | 3.640 | tINS | FF | 8 | DSP_R19[1][A] | u_top/u_alloc/n453_s1/DOUT[6]
35.800 | 2.103 | tNET | FF | 1 | R11C26[0][B] | u_top/u_alloc/n3420_s1/I0
36.370 | 0.570 | tINS | FR | 7 | R11C26[0][B] | u_top/u_alloc/n3420_s1/F
36.739 | 0.368 | tNET | RR | 1 | R8C26[1][A] | u_top/u_alloc/v_note_38_s0/CE

Data Required Path:

AT | DELAY | TYPE | RF | FANOUT | LOC | NODE
37.037 | 37.037 | | | | | active clock edge time
37.037 | 0.000 | | | | | clk_27m
37.037 | 0.000 | tCL | RR | 1 | IOT27[A] | clk_27m_ibuf/I
39.125 | 2.088 | tINS | RR | 3750 | IOT27[A] | clk_27m_ibuf/O
41.396 | 2.271 | tNET | RR | 1 | R8C26[1][A] | u_top/u_alloc/v_note_38_s0/CLK
41.361 | -0.035 | tSu | | 1 | R8C26[1][A] | u_top/u_alloc/v_note_38_s0

Path Statistics:

Clock Skew | 0.000
Setup Relationship | 37.037
Logic Level | 24
Arrival Clock Path Delay | cell: 2.088, 47.897%; route: 2.271, 52.103%
Arrival Data Path Delay | cell: 13.592, 41.979%; route: 18.555, 57.305%; tC2Q: 0.232, 0.717%
Required Clock Path Delay | cell: 2.088, 47.897%; route: 2.271, 52.103%

### Path19

Path Summary:

Slack | 4.623
Data Arrival Time | 36.739
Data Required Time | 41.361
From | u_top/u_manual/wr_ptr_0_s0
To | u_top/u_alloc/v_note_39_s0
Launch Clk | clk_27m:[R]
Latch Clk | clk_27m:[R]

Data Arrival Path:

AT | DELAY | TYPE | RF | FANOUT | LOC | NODE
0.000 | 0.000 | | | | | active clock edge time
0.000 | 0.000 | | | | | clk_27m
0.000 | 0.000 | tCL | RR | 1 | IOT27[A] | clk_27m_ibuf/I
2.088 | 2.088 | tINS | RR | 3750 | IOT27[A] | clk_27m_ibuf/O
4.359 | 2.271 | tNET | RR | 1 | R42C49[1][A] | u_top/u_manual/wr_ptr_0_s0/CLK
4.591 | 0.232 | tC2Q | RF | 7 | R42C49[1][A] | u_top/u_manual/wr_ptr_0_s0/Q
5.021 | 0.430 | tNET | FF | 2 | R42C46[0][B] | u_top/u_manual/n4_s0/I0
5.570 | 0.549 | tINS | FR | 1 | R42C46[0][B] | u_top/u_manual/n4_s0/COUT
5.570 | 0.000 | tNET | RR | 2 | R42C46[1][A] | u_top/u_manual/n5_s0/CIN
5.606 | 0.035 | tINS | RF | 1 | R42C46[1][A] | u_top/u_manual/n5_s0/COUT
5.606 | 0.000 | tNET | FF | 2 | R42C46[1][B] | u_top/u_manual/n6_s0/CIN
5.641 | 0.035 | tINS | FF | 1 | R42C46[1][B] | u_top/u_manual/n6_s0/COUT
5.641 | 0.000 | tNET | FF | 2 | R42C46[2][A] | u_top/u_manual/n7_s0/CIN
5.676 | 0.035 | tINS | FF | 1 | R42C46[2][A] | u_top/u_manual/n7_s0/COUT
5.676 | 0.000 | tNET | FF | 2 | R42C46[2][B] | u_top/u_manual/n8_s0/CIN
5.711 | 0.035 | tINS | FF | 17 | R42C46[2][B] | u_top/u_manual/n8_s0/COUT
7.859 | 2.148 | tNET | FF | 1 | R36C44[1][A] | u_top/ev_word_11_s2/I2
8.376 | 0.517 | tINS | FF | 1 | R36C44[1][A] | u_top/ev_word_11_s2/F
9.032 | 0.656 | tNET | FF | 1 | R36C41[3][A] | u_top/ev_word_11_s1/I1
9.494 | 0.462 | tINS | FR | 1 | R36C41[3][A] | u_top/ev_word_11_s1/F
9.495 | 0.001 | tNET | RR | 1 | R36C41[1][B] | u_top/ev_word_11_s0/I0
9.948 | 0.453 | tINS | RF | 40 | R36C41[1][B] | u_top/ev_word_11_s0/F
15.910 | 5.961 | tNET | FF | 2 | R8C23[1][B] | u_top/u_alloc/n51_s0/I1
16.480 | 0.570 | tINS | FR | 1 | R8C23[1][B] | u_top/u_alloc/n51_s0/COUT
16.480 | 0.000 | tNET | RR | 2 | R8C23[2][A] | u_top/u_alloc/n52_s0/CIN
16.515 | 0.035 | tINS | RF | 1 | R8C23[2][A] | u_top/u_alloc/n52_s0/COUT
16.515 | 0.000 | tNET | FF | 2 | R8C23[2][B] | u_top/u_alloc/n53_s0/CIN
16.550 | 0.035 | tINS | FF | 1 | R8C23[2][B] | u_top/u_alloc/n53_s0/COUT
16.550 | 0.000 | tNET | FF | 2 | R8C24[0][A] | u_top/u_alloc/n54_s0/CIN
16.585 | 0.035 | tINS | FF | 3 | R8C24[0][A] | u_top/u_alloc/n54_s0/COUT
17.555 | 0.970 | tNET | FF | 1 | R12C24[1][B] | u_top/u_alloc/pick_2_s60/I0
18.008 | 0.453 | tINS | FF | 3 | R12C24[1][B] | u_top/u_alloc/pick_2_s60/F
18.197 | 0.189 | tNET | FF | 1 | R12C23[3][A] | u_top/u_alloc/pick_0_s61/I1
18.746 | 0.549 | tINS | FR | 3 | R12C23[3][A] | u_top/u_alloc/pick_0_s61/F
18.750 | 0.004 | tNET | RR | 1 | R12C23[2][A] | u_top/u_alloc/pick_2_s101/I2
19.212 | 0.462 | tINS | RR | 1 | R12C23[2][A] | u_top/u_alloc/pick_2_s101/F
19.384 | 0.172 | tNET | RR | 1 | R12C24[3][B] | u_top/u_alloc/pick_2_s85/I0
19.837 | 0.453 | tINS | RF | 4 | R12C24[3][B] | u_top/u_alloc/pick_2_s85/F
20.764 | 0.927 | tNET | FF | 1 | R13C19[3][A] | u_top/u_alloc/pick_2_s62/I3
21.313 | 0.549 | tINS | FR | 3 | R13C19[3][A] | u_top/u_alloc/pick_2_s62/F
21.317 | 0.004 | tNET | RR | 1 | R13C19[0][B] | u_top/u_alloc/pick_2_s84/I1
21.770 | 0.453 | tINS | RF | 1 | R13C19[0][B] | u_top/u_alloc/pick_2_s84/F
22.183 | 0.413 | tNET | FF | 1 | R14C18[0][A] | u_top/u_alloc/pick_2_s58/I2
22.732 | 0.549 | tINS | FR | 1 | R14C18[0][A] | u_top/u_alloc/pick_2_s58/F
22.905 | 0.172 | tNET | RR | 1 | R14C17[2][A] | u_top/u_alloc/pick_2_s118/I3
23.276 | 0.371 | tINS | RF | 2 | R14C17[2][A] | u_top/u_alloc/pick_2_s118/F
23.689 | 0.413 | tNET | FF | 1 | R13C16[3][A] | u_top/u_alloc/pick_2_s8/I3
24.244 | 0.555 | tINS | FF | 7 | R13C16[3][A] | u_top/u_alloc/pick_2_s8/F
25.319 | 1.075 | tNET | FF | 1 | R12C21[2][B] | u_top/u_alloc/pick_1_s12/I1
25.889 | 0.570 | tINS | FR | 1 | R12C21[2][B] | u_top/u_alloc/pick_1_s12/F
25.890 | 0.001 | tNET | RR | 1 | R12C21[3][A] | u_top/u_alloc/pick_1_s6/I3
26.439 | 0.549 | tINS | RR | 1 | R12C21[3][A] | u_top/u_alloc/pick_1_s6/F
26.611 | 0.172 | tNET | RR | 1 | R12C20[1][B] | u_top/u_alloc/pick_1_s2/I1
27.166 | 0.555 | tINS | RF | 9 | R12C20[1][B] | u_top/u_alloc/pick_1_s2/F
28.325 | 1.159 | tNET | FF | 1 | R7C20[0][A] | u_top/u_alloc/pick_1_s43/I3
28.842 | 0.517 | tINS | FF | 12 | R7C20[0][A] | u_top/u_alloc/pick_1_s43/F
30.057 | 1.215 | tNET | FF | 18 | DSP_R19[1][A] | u_top/u_alloc/n453_s1/B[1]
33.697 | 3.640 | tINS | FF | 8 | DSP_R19[1][A] | u_top/u_alloc/n453_s1/DOUT[6]
35.800 | 2.103 | tNET | FF | 1 | R11C26[0][B] | u_top/u_alloc/n3420_s1/I0
36.370 | 0.570 | tINS | FR | 7 | R11C26[0][B] | u_top/u_alloc/n3420_s1/F
36.739 | 0.368 | tNET | RR | 1 | R8C26[0][B] | u_top/u_alloc/v_note_39_s0/CE

Data Required Path:

AT | DELAY | TYPE | RF | FANOUT | LOC | NODE
37.037 | 37.037 | | | | | active clock edge time
37.037 | 0.000 | | | | | clk_27m
37.037 | 0.000 | tCL | RR | 1 | IOT27[A] | clk_27m_ibuf/I
39.125 | 2.088 | tINS | RR | 3750 | IOT27[A] | clk_27m_ibuf/O
41.396 | 2.271 | tNET | RR | 1 | R8C26[0][B] | u_top/u_alloc/v_note_39_s0/CLK
41.361 | -0.035 | tSu | | 1 | R8C26[0][B] | u_top/u_alloc/v_note_39_s0

Path Statistics:

Clock Skew | 0.000
Setup Relationship | 37.037
Logic Level | 24
Arrival Clock Path Delay | cell: 2.088, 47.897%; route: 2.271, 52.103%
Arrival Data Path Delay | cell: 13.592, 41.979%; route: 18.555, 57.305%; tC2Q: 0.232, 0.717%
Required Clock Path Delay | cell: 2.088, 47.897%; route: 2.271, 52.103%

### Path20

Path Summary:

Slack | 4.623
Data Arrival Time | 36.739
Data Required Time | 41.361
From | u_top/u_manual/wr_ptr_0_s0
To | u_top/u_alloc/v_note_40_s0
Launch Clk | clk_27m:[R]
Latch Clk | clk_27m:[R]

Data Arrival Path:

AT | DELAY | TYPE | RF | FANOUT | LOC | NODE
0.000 | 0.000 | | | | | active clock edge time
0.000 | 0.000 | | | | | clk_27m
0.000 | 0.000 | tCL | RR | 1 | IOT27[A] | clk_27m_ibuf/I
2.088 | 2.088 | tINS | RR | 3750 | IOT27[A] | clk_27m_ibuf/O
4.359 | 2.271 | tNET | RR | 1 | R42C49[1][A] | u_top/u_manual/wr_ptr_0_s0/CLK
4.591 | 0.232 | tC2Q | RF | 7 | R42C49[1][A] | u_top/u_manual/wr_ptr_0_s0/Q
5.021 | 0.430 | tNET | FF | 2 | R42C46[0][B] | u_top/u_manual/n4_s0/I0
5.570 | 0.549 | tINS | FR | 1 | R42C46[0][B] | u_top/u_manual/n4_s0/COUT
5.570 | 0.000 | tNET | RR | 2 | R42C46[1][A] | u_top/u_manual/n5_s0/CIN
5.606 | 0.035 | tINS | RF | 1 | R42C46[1][A] | u_top/u_manual/n5_s0/COUT
5.606 | 0.000 | tNET | FF | 2 | R42C46[1][B] | u_top/u_manual/n6_s0/CIN
5.641 | 0.035 | tINS | FF | 1 | R42C46[1][B] | u_top/u_manual/n6_s0/COUT
5.641 | 0.000 | tNET | FF | 2 | R42C46[2][A] | u_top/u_manual/n7_s0/CIN
5.676 | 0.035 | tINS | FF | 1 | R42C46[2][A] | u_top/u_manual/n7_s0/COUT
5.676 | 0.000 | tNET | FF | 2 | R42C46[2][B] | u_top/u_manual/n8_s0/CIN
5.711 | 0.035 | tINS | FF | 17 | R42C46[2][B] | u_top/u_manual/n8_s0/COUT
7.859 | 2.148 | tNET | FF | 1 | R36C44[1][A] | u_top/ev_word_11_s2/I2
8.376 | 0.517 | tINS | FF | 1 | R36C44[1][A] | u_top/ev_word_11_s2/F
9.032 | 0.656 | tNET | FF | 1 | R36C41[3][A] | u_top/ev_word_11_s1/I1
9.494 | 0.462 | tINS | FR | 1 | R36C41[3][A] | u_top/ev_word_11_s1/F
9.495 | 0.001 | tNET | RR | 1 | R36C41[1][B] | u_top/ev_word_11_s0/I0
9.948 | 0.453 | tINS | RF | 40 | R36C41[1][B] | u_top/ev_word_11_s0/F
15.910 | 5.961 | tNET | FF | 2 | R8C23[1][B] | u_top/u_alloc/n51_s0/I1
16.480 | 0.570 | tINS | FR | 1 | R8C23[1][B] | u_top/u_alloc/n51_s0/COUT
16.480 | 0.000 | tNET | RR | 2 | R8C23[2][A] | u_top/u_alloc/n52_s0/CIN
16.515 | 0.035 | tINS | RF | 1 | R8C23[2][A] | u_top/u_alloc/n52_s0/COUT
16.515 | 0.000 | tNET | FF | 2 | R8C23[2][B] | u_top/u_alloc/n53_s0/CIN
16.550 | 0.035 | tINS | FF | 1 | R8C23[2][B] | u_top/u_alloc/n53_s0/COUT
16.550 | 0.000 | tNET | FF | 2 | R8C24[0][A] | u_top/u_alloc/n54_s0/CIN
16.585 | 0.035 | tINS | FF | 3 | R8C24[0][A] | u_top/u_alloc/n54_s0/COUT
17.555 | 0.970 | tNET | FF | 1 | R12C24[1][B] | u_top/u_alloc/pick_2_s60/I0
18.008 | 0.453 | tINS | FF | 3 | R12C24[1][B] | u_top/u_alloc/pick_2_s60/F
18.197 | 0.189 | tNET | FF | 1 | R12C23[3][A] | u_top/u_alloc/pick_0_s61/I1
18.746 | 0.549 | tINS | FR | 3 | R12C23[3][A] | u_top/u_alloc/pick_0_s61/F
18.750 | 0.004 | tNET | RR | 1 | R12C23[2][A] | u_top/u_alloc/pick_2_s101/I2
19.212 | 0.462 | tINS | RR | 1 | R12C23[2][A] | u_top/u_alloc/pick_2_s101/F
19.384 | 0.172 | tNET | RR | 1 | R12C24[3][B] | u_top/u_alloc/pick_2_s85/I0
19.837 | 0.453 | tINS | RF | 4 | R12C24[3][B] | u_top/u_alloc/pick_2_s85/F
20.764 | 0.927 | tNET | FF | 1 | R13C19[3][A] | u_top/u_alloc/pick_2_s62/I3
21.313 | 0.549 | tINS | FR | 3 | R13C19[3][A] | u_top/u_alloc/pick_2_s62/F
21.317 | 0.004 | tNET | RR | 1 | R13C19[0][B] | u_top/u_alloc/pick_2_s84/I1
21.770 | 0.453 | tINS | RF | 1 | R13C19[0][B] | u_top/u_alloc/pick_2_s84/F
22.183 | 0.413 | tNET | FF | 1 | R14C18[0][A] | u_top/u_alloc/pick_2_s58/I2
22.732 | 0.549 | tINS | FR | 1 | R14C18[0][A] | u_top/u_alloc/pick_2_s58/F
22.905 | 0.172 | tNET | RR | 1 | R14C17[2][A] | u_top/u_alloc/pick_2_s118/I3
23.276 | 0.371 | tINS | RF | 2 | R14C17[2][A] | u_top/u_alloc/pick_2_s118/F
23.689 | 0.413 | tNET | FF | 1 | R13C16[3][A] | u_top/u_alloc/pick_2_s8/I3
24.244 | 0.555 | tINS | FF | 7 | R13C16[3][A] | u_top/u_alloc/pick_2_s8/F
25.319 | 1.075 | tNET | FF | 1 | R12C21[2][B] | u_top/u_alloc/pick_1_s12/I1
25.889 | 0.570 | tINS | FR | 1 | R12C21[2][B] | u_top/u_alloc/pick_1_s12/F
25.890 | 0.001 | tNET | RR | 1 | R12C21[3][A] | u_top/u_alloc/pick_1_s6/I3
26.439 | 0.549 | tINS | RR | 1 | R12C21[3][A] | u_top/u_alloc/pick_1_s6/F
26.611 | 0.172 | tNET | RR | 1 | R12C20[1][B] | u_top/u_alloc/pick_1_s2/I1
27.166 | 0.555 | tINS | RF | 9 | R12C20[1][B] | u_top/u_alloc/pick_1_s2/F
28.325 | 1.159 | tNET | FF | 1 | R7C20[0][A] | u_top/u_alloc/pick_1_s43/I3
28.842 | 0.517 | tINS | FF | 12 | R7C20[0][A] | u_top/u_alloc/pick_1_s43/F
30.057 | 1.215 | tNET | FF | 18 | DSP_R19[1][A] | u_top/u_alloc/n453_s1/B[1]
33.697 | 3.640 | tINS | FF | 8 | DSP_R19[1][A] | u_top/u_alloc/n453_s1/DOUT[6]
35.800 | 2.103 | tNET | FF | 1 | R11C26[0][B] | u_top/u_alloc/n3420_s1/I0
36.370 | 0.570 | tINS | FR | 7 | R11C26[0][B] | u_top/u_alloc/n3420_s1/F
36.739 | 0.368 | tNET | RR | 1 | R8C26[0][A] | u_top/u_alloc/v_note_40_s0/CE

Data Required Path:

AT | DELAY | TYPE | RF | FANOUT | LOC | NODE
37.037 | 37.037 | | | | | active clock edge time
37.037 | 0.000 | | | | | clk_27m
37.037 | 0.000 | tCL | RR | 1 | IOT27[A] | clk_27m_ibuf/I
39.125 | 2.088 | tINS | RR | 3750 | IOT27[A] | clk_27m_ibuf/O
41.396 | 2.271 | tNET | RR | 1 | R8C26[0][A] | u_top/u_alloc/v_note_40_s0/CLK
41.361 | -0.035 | tSu | | 1 | R8C26[0][A] | u_top/u_alloc/v_note_40_s0

Path Statistics:

Clock Skew | 0.000
Setup Relationship | 37.037
Logic Level | 24
Arrival Clock Path Delay | cell: 2.088, 47.897%; route: 2.271, 52.103%
Arrival Data Path Delay | cell: 13.592, 41.979%; route: 18.555, 57.305%; tC2Q: 0.232, 0.717%
Required Clock Path Delay | cell: 2.088, 47.897%; route: 2.271, 52.103%

### Path21

Path Summary:

Slack | 4.846
Data Arrival Time | 36.516
Data Required Time | 41.361
From | u_top/u_manual/wr_ptr_0_s0
To | u_top/u_alloc/v_note_37_s0
Launch Clk | clk_27m:[R]
Latch Clk | clk_27m:[R]

Data Arrival Path:

AT | DELAY | TYPE | RF | FANOUT | LOC | NODE
0.000 | 0.000 | | | | | active clock edge time
0.000 | 0.000 | | | | | clk_27m
0.000 | 0.000 | tCL | RR | 1 | IOT27[A] | clk_27m_ibuf/I
2.088 | 2.088 | tINS | RR | 3750 | IOT27[A] | clk_27m_ibuf/O
4.359 | 2.271 | tNET | RR | 1 | R42C49[1][A] | u_top/u_manual/wr_ptr_0_s0/CLK
4.591 | 0.232 | tC2Q | RF | 7 | R42C49[1][A] | u_top/u_manual/wr_ptr_0_s0/Q
5.021 | 0.430 | tNET | FF | 2 | R42C46[0][B] | u_top/u_manual/n4_s0/I0
5.570 | 0.549 | tINS | FR | 1 | R42C46[0][B] | u_top/u_manual/n4_s0/COUT
5.570 | 0.000 | tNET | RR | 2 | R42C46[1][A] | u_top/u_manual/n5_s0/CIN
5.606 | 0.035 | tINS | RF | 1 | R42C46[1][A] | u_top/u_manual/n5_s0/COUT
5.606 | 0.000 | tNET | FF | 2 | R42C46[1][B] | u_top/u_manual/n6_s0/CIN
5.641 | 0.035 | tINS | FF | 1 | R42C46[1][B] | u_top/u_manual/n6_s0/COUT
5.641 | 0.000 | tNET | FF | 2 | R42C46[2][A] | u_top/u_manual/n7_s0/CIN
5.676 | 0.035 | tINS | FF | 1 | R42C46[2][A] | u_top/u_manual/n7_s0/COUT
5.676 | 0.000 | tNET | FF | 2 | R42C46[2][B] | u_top/u_manual/n8_s0/CIN
5.711 | 0.035 | tINS | FF | 17 | R42C46[2][B] | u_top/u_manual/n8_s0/COUT
7.859 | 2.148 | tNET | FF | 1 | R36C44[1][A] | u_top/ev_word_11_s2/I2
8.376 | 0.517 | tINS | FF | 1 | R36C44[1][A] | u_top/ev_word_11_s2/F
9.032 | 0.656 | tNET | FF | 1 | R36C41[3][A] | u_top/ev_word_11_s1/I1
9.494 | 0.462 | tINS | FR | 1 | R36C41[3][A] | u_top/ev_word_11_s1/F
9.495 | 0.001 | tNET | RR | 1 | R36C41[1][B] | u_top/ev_word_11_s0/I0
9.948 | 0.453 | tINS | RF | 40 | R36C41[1][B] | u_top/ev_word_11_s0/F
15.910 | 5.961 | tNET | FF | 2 | R8C23[1][B] | u_top/u_alloc/n51_s0/I1
16.480 | 0.570 | tINS | FR | 1 | R8C23[1][B] | u_top/u_alloc/n51_s0/COUT
16.480 | 0.000 | tNET | RR | 2 | R8C23[2][A] | u_top/u_alloc/n52_s0/CIN
16.515 | 0.035 | tINS | RF | 1 | R8C23[2][A] | u_top/u_alloc/n52_s0/COUT
16.515 | 0.000 | tNET | FF | 2 | R8C23[2][B] | u_top/u_alloc/n53_s0/CIN
16.550 | 0.035 | tINS | FF | 1 | R8C23[2][B] | u_top/u_alloc/n53_s0/COUT
16.550 | 0.000 | tNET | FF | 2 | R8C24[0][A] | u_top/u_alloc/n54_s0/CIN
16.585 | 0.035 | tINS | FF | 3 | R8C24[0][A] | u_top/u_alloc/n54_s0/COUT
17.555 | 0.970 | tNET | FF | 1 | R12C24[1][B] | u_top/u_alloc/pick_2_s60/I0
18.008 | 0.453 | tINS | FF | 3 | R12C24[1][B] | u_top/u_alloc/pick_2_s60/F
18.197 | 0.189 | tNET | FF | 1 | R12C23[3][A] | u_top/u_alloc/pick_0_s61/I1
18.746 | 0.549 | tINS | FR | 3 | R12C23[3][A] | u_top/u_alloc/pick_0_s61/F
18.750 | 0.004 | tNET | RR | 1 | R12C23[2][A] | u_top/u_alloc/pick_2_s101/I2
19.212 | 0.462 | tINS | RR | 1 | R12C23[2][A] | u_top/u_alloc/pick_2_s101/F
19.384 | 0.172 | tNET | RR | 1 | R12C24[3][B] | u_top/u_alloc/pick_2_s85/I0
19.837 | 0.453 | tINS | RF | 4 | R12C24[3][B] | u_top/u_alloc/pick_2_s85/F
20.764 | 0.927 | tNET | FF | 1 | R13C19[3][A] | u_top/u_alloc/pick_2_s62/I3
21.313 | 0.549 | tINS | FR | 3 | R13C19[3][A] | u_top/u_alloc/pick_2_s62/F
21.317 | 0.004 | tNET | RR | 1 | R13C19[0][B] | u_top/u_alloc/pick_2_s84/I1
21.770 | 0.453 | tINS | RF | 1 | R13C19[0][B] | u_top/u_alloc/pick_2_s84/F
22.183 | 0.413 | tNET | FF | 1 | R14C18[0][A] | u_top/u_alloc/pick_2_s58/I2
22.732 | 0.549 | tINS | FR | 1 | R14C18[0][A] | u_top/u_alloc/pick_2_s58/F
22.905 | 0.172 | tNET | RR | 1 | R14C17[2][A] | u_top/u_alloc/pick_2_s118/I3
23.276 | 0.371 | tINS | RF | 2 | R14C17[2][A] | u_top/u_alloc/pick_2_s118/F
23.689 | 0.413 | tNET | FF | 1 | R13C16[3][A] | u_top/u_alloc/pick_2_s8/I3
24.244 | 0.555 | tINS | FF | 7 | R13C16[3][A] | u_top/u_alloc/pick_2_s8/F
25.319 | 1.075 | tNET | FF | 1 | R12C21[2][B] | u_top/u_alloc/pick_1_s12/I1
25.889 | 0.570 | tINS | FR | 1 | R12C21[2][B] | u_top/u_alloc/pick_1_s12/F
25.890 | 0.001 | tNET | RR | 1 | R12C21[3][A] | u_top/u_alloc/pick_1_s6/I3
26.439 | 0.549 | tINS | RR | 1 | R12C21[3][A] | u_top/u_alloc/pick_1_s6/F
26.611 | 0.172 | tNET | RR | 1 | R12C20[1][B] | u_top/u_alloc/pick_1_s2/I1
27.166 | 0.555 | tINS | RF | 9 | R12C20[1][B] | u_top/u_alloc/pick_1_s2/F
28.325 | 1.159 | tNET | FF | 1 | R7C20[0][A] | u_top/u_alloc/pick_1_s43/I3
28.842 | 0.517 | tINS | FF | 12 | R7C20[0][A] | u_top/u_alloc/pick_1_s43/F
30.057 | 1.215 | tNET | FF | 18 | DSP_R19[1][A] | u_top/u_alloc/n453_s1/B[1]
33.697 | 3.640 | tINS | FF | 8 | DSP_R19[1][A] | u_top/u_alloc/n453_s1/DOUT[6]
35.800 | 2.103 | tNET | FF | 1 | R11C26[0][B] | u_top/u_alloc/n3420_s1/I0
36.370 | 0.570 | tINS | FR | 7 | R11C26[0][B] | u_top/u_alloc/n3420_s1/F
36.516 | 0.146 | tNET | RR | 1 | R11C26[0][A] | u_top/u_alloc/v_note_37_s0/CE

Data Required Path:

AT | DELAY | TYPE | RF | FANOUT | LOC | NODE
37.037 | 37.037 | | | | | active clock edge time
37.037 | 0.000 | | | | | clk_27m
37.037 | 0.000 | tCL | RR | 1 | IOT27[A] | clk_27m_ibuf/I
39.125 | 2.088 | tINS | RR | 3750 | IOT27[A] | clk_27m_ibuf/O
41.396 | 2.271 | tNET | RR | 1 | R11C26[0][A] | u_top/u_alloc/v_note_37_s0/CLK
41.361 | -0.035 | tSu | | 1 | R11C26[0][A] | u_top/u_alloc/v_note_37_s0

Path Statistics:

Clock Skew | 0.000
Setup Relationship | 37.037
Logic Level | 24
Arrival Clock Path Delay | cell: 2.088, 47.897%; route: 2.271, 52.103%
Arrival Data Path Delay | cell: 13.592, 42.270%; route: 18.332, 57.009%; tC2Q: 0.232, 0.721%
Required Clock Path Delay | cell: 2.088, 47.897%; route: 2.271, 52.103%

### Path22

Path Summary:

Slack | 4.849
Data Arrival Time | 36.513
Data Required Time | 41.361
From | u_top/u_manual/wr_ptr_0_s0
To | u_top/u_alloc/v_note_43_s0
Launch Clk | clk_27m:[R]
Latch Clk | clk_27m:[R]

Data Arrival Path:

AT | DELAY | TYPE | RF | FANOUT | LOC | NODE
0.000 | 0.000 | | | | | active clock edge time
0.000 | 0.000 | | | | | clk_27m
0.000 | 0.000 | tCL | RR | 1 | IOT27[A] | clk_27m_ibuf/I
2.088 | 2.088 | tINS | RR | 3750 | IOT27[A] | clk_27m_ibuf/O
4.359 | 2.271 | tNET | RR | 1 | R42C49[1][A] | u_top/u_manual/wr_ptr_0_s0/CLK
4.591 | 0.232 | tC2Q | RF | 7 | R42C49[1][A] | u_top/u_manual/wr_ptr_0_s0/Q
5.021 | 0.430 | tNET | FF | 2 | R42C46[0][B] | u_top/u_manual/n4_s0/I0
5.570 | 0.549 | tINS | FR | 1 | R42C46[0][B] | u_top/u_manual/n4_s0/COUT
5.570 | 0.000 | tNET | RR | 2 | R42C46[1][A] | u_top/u_manual/n5_s0/CIN
5.606 | 0.035 | tINS | RF | 1 | R42C46[1][A] | u_top/u_manual/n5_s0/COUT
5.606 | 0.000 | tNET | FF | 2 | R42C46[1][B] | u_top/u_manual/n6_s0/CIN
5.641 | 0.035 | tINS | FF | 1 | R42C46[1][B] | u_top/u_manual/n6_s0/COUT
5.641 | 0.000 | tNET | FF | 2 | R42C46[2][A] | u_top/u_manual/n7_s0/CIN
5.676 | 0.035 | tINS | FF | 1 | R42C46[2][A] | u_top/u_manual/n7_s0/COUT
5.676 | 0.000 | tNET | FF | 2 | R42C46[2][B] | u_top/u_manual/n8_s0/CIN
5.711 | 0.035 | tINS | FF | 17 | R42C46[2][B] | u_top/u_manual/n8_s0/COUT
7.859 | 2.148 | tNET | FF | 1 | R36C44[1][A] | u_top/ev_word_11_s2/I2
8.376 | 0.517 | tINS | FF | 1 | R36C44[1][A] | u_top/ev_word_11_s2/F
9.032 | 0.656 | tNET | FF | 1 | R36C41[3][A] | u_top/ev_word_11_s1/I1
9.494 | 0.462 | tINS | FR | 1 | R36C41[3][A] | u_top/ev_word_11_s1/F
9.495 | 0.001 | tNET | RR | 1 | R36C41[1][B] | u_top/ev_word_11_s0/I0
9.948 | 0.453 | tINS | RF | 40 | R36C41[1][B] | u_top/ev_word_11_s0/F
15.910 | 5.961 | tNET | FF | 2 | R8C23[1][B] | u_top/u_alloc/n51_s0/I1
16.480 | 0.570 | tINS | FR | 1 | R8C23[1][B] | u_top/u_alloc/n51_s0/COUT
16.480 | 0.000 | tNET | RR | 2 | R8C23[2][A] | u_top/u_alloc/n52_s0/CIN
16.515 | 0.035 | tINS | RF | 1 | R8C23[2][A] | u_top/u_alloc/n52_s0/COUT
16.515 | 0.000 | tNET | FF | 2 | R8C23[2][B] | u_top/u_alloc/n53_s0/CIN
16.550 | 0.035 | tINS | FF | 1 | R8C23[2][B] | u_top/u_alloc/n53_s0/COUT
16.550 | 0.000 | tNET | FF | 2 | R8C24[0][A] | u_top/u_alloc/n54_s0/CIN
16.585 | 0.035 | tINS | FF | 3 | R8C24[0][A] | u_top/u_alloc/n54_s0/COUT
17.555 | 0.970 | tNET | FF | 1 | R12C24[1][B] | u_top/u_alloc/pick_2_s60/I0
18.008 | 0.453 | tINS | FF | 3 | R12C24[1][B] | u_top/u_alloc/pick_2_s60/F
18.197 | 0.189 | tNET | FF | 1 | R12C23[3][A] | u_top/u_alloc/pick_0_s61/I1
18.746 | 0.549 | tINS | FR | 3 | R12C23[3][A] | u_top/u_alloc/pick_0_s61/F
18.750 | 0.004 | tNET | RR | 1 | R12C23[2][A] | u_top/u_alloc/pick_2_s101/I2
19.212 | 0.462 | tINS | RR | 1 | R12C23[2][A] | u_top/u_alloc/pick_2_s101/F
19.384 | 0.172 | tNET | RR | 1 | R12C24[3][B] | u_top/u_alloc/pick_2_s85/I0
19.837 | 0.453 | tINS | RF | 4 | R12C24[3][B] | u_top/u_alloc/pick_2_s85/F
20.764 | 0.927 | tNET | FF | 1 | R13C19[3][A] | u_top/u_alloc/pick_2_s62/I3
21.313 | 0.549 | tINS | FR | 3 | R13C19[3][A] | u_top/u_alloc/pick_2_s62/F
21.317 | 0.004 | tNET | RR | 1 | R13C19[0][B] | u_top/u_alloc/pick_2_s84/I1
21.770 | 0.453 | tINS | RF | 1 | R13C19[0][B] | u_top/u_alloc/pick_2_s84/F
22.183 | 0.413 | tNET | FF | 1 | R14C18[0][A] | u_top/u_alloc/pick_2_s58/I2
22.732 | 0.549 | tINS | FR | 1 | R14C18[0][A] | u_top/u_alloc/pick_2_s58/F
22.905 | 0.172 | tNET | RR | 1 | R14C17[2][A] | u_top/u_alloc/pick_2_s118/I3
23.276 | 0.371 | tINS | RF | 2 | R14C17[2][A] | u_top/u_alloc/pick_2_s118/F
23.689 | 0.413 | tNET | FF | 1 | R13C16[3][A] | u_top/u_alloc/pick_2_s8/I3
24.244 | 0.555 | tINS | FF | 7 | R13C16[3][A] | u_top/u_alloc/pick_2_s8/F
25.319 | 1.075 | tNET | FF | 1 | R12C21[2][B] | u_top/u_alloc/pick_1_s12/I1
25.889 | 0.570 | tINS | FR | 1 | R12C21[2][B] | u_top/u_alloc/pick_1_s12/F
25.890 | 0.001 | tNET | RR | 1 | R12C21[3][A] | u_top/u_alloc/pick_1_s6/I3
26.439 | 0.549 | tINS | RR | 1 | R12C21[3][A] | u_top/u_alloc/pick_1_s6/F
26.611 | 0.172 | tNET | RR | 1 | R12C20[1][B] | u_top/u_alloc/pick_1_s2/I1
27.166 | 0.555 | tINS | RF | 9 | R12C20[1][B] | u_top/u_alloc/pick_1_s2/F
28.325 | 1.159 | tNET | FF | 1 | R7C20[0][A] | u_top/u_alloc/pick_1_s43/I3
28.842 | 0.517 | tINS | FF | 12 | R7C20[0][A] | u_top/u_alloc/pick_1_s43/F
30.057 | 1.215 | tNET | FF | 18 | DSP_R19[1][A] | u_top/u_alloc/n453_s1/B[1]
33.697 | 3.640 | tINS | FF | 8 | DSP_R19[1][A] | u_top/u_alloc/n453_s1/DOUT[6]
35.806 | 2.109 | tNET | FF | 1 | R12C27[3][B] | u_top/u_alloc/n3406_s1/I0
36.133 | 0.327 | tINS | FR | 7 | R12C27[3][B] | u_top/u_alloc/n3406_s1/F
36.513 | 0.380 | tNET | RR | 1 | R12C30[0][A] | u_top/u_alloc/v_note_43_s0/CE

Data Required Path:

AT | DELAY | TYPE | RF | FANOUT | LOC | NODE
37.037 | 37.037 | | | | | active clock edge time
37.037 | 0.000 | | | | | clk_27m
37.037 | 0.000 | tCL | RR | 1 | IOT27[A] | clk_27m_ibuf/I
39.125 | 2.088 | tINS | RR | 3750 | IOT27[A] | clk_27m_ibuf/O
41.396 | 2.271 | tNET | RR | 1 | R12C30[0][A] | u_top/u_alloc/v_note_43_s0/CLK
41.361 | -0.035 | tSu | | 1 | R12C30[0][A] | u_top/u_alloc/v_note_43_s0

Path Statistics:

Clock Skew | 0.000
Setup Relationship | 37.037
Logic Level | 24
Arrival Clock Path Delay | cell: 2.088, 47.897%; route: 2.271, 52.103%
Arrival Data Path Delay | cell: 13.349, 41.518%; route: 18.572, 57.760%; tC2Q: 0.232, 0.722%
Required Clock Path Delay | cell: 2.088, 47.897%; route: 2.271, 52.103%

### Path23

Path Summary:

Slack | 4.849
Data Arrival Time | 36.513
Data Required Time | 41.361
From | u_top/u_manual/wr_ptr_0_s0
To | u_top/u_alloc/v_note_44_s0
Launch Clk | clk_27m:[R]
Latch Clk | clk_27m:[R]

Data Arrival Path:

AT | DELAY | TYPE | RF | FANOUT | LOC | NODE
0.000 | 0.000 | | | | | active clock edge time
0.000 | 0.000 | | | | | clk_27m
0.000 | 0.000 | tCL | RR | 1 | IOT27[A] | clk_27m_ibuf/I
2.088 | 2.088 | tINS | RR | 3750 | IOT27[A] | clk_27m_ibuf/O
4.359 | 2.271 | tNET | RR | 1 | R42C49[1][A] | u_top/u_manual/wr_ptr_0_s0/CLK
4.591 | 0.232 | tC2Q | RF | 7 | R42C49[1][A] | u_top/u_manual/wr_ptr_0_s0/Q
5.021 | 0.430 | tNET | FF | 2 | R42C46[0][B] | u_top/u_manual/n4_s0/I0
5.570 | 0.549 | tINS | FR | 1 | R42C46[0][B] | u_top/u_manual/n4_s0/COUT
5.570 | 0.000 | tNET | RR | 2 | R42C46[1][A] | u_top/u_manual/n5_s0/CIN
5.606 | 0.035 | tINS | RF | 1 | R42C46[1][A] | u_top/u_manual/n5_s0/COUT
5.606 | 0.000 | tNET | FF | 2 | R42C46[1][B] | u_top/u_manual/n6_s0/CIN
5.641 | 0.035 | tINS | FF | 1 | R42C46[1][B] | u_top/u_manual/n6_s0/COUT
5.641 | 0.000 | tNET | FF | 2 | R42C46[2][A] | u_top/u_manual/n7_s0/CIN
5.676 | 0.035 | tINS | FF | 1 | R42C46[2][A] | u_top/u_manual/n7_s0/COUT
5.676 | 0.000 | tNET | FF | 2 | R42C46[2][B] | u_top/u_manual/n8_s0/CIN
5.711 | 0.035 | tINS | FF | 17 | R42C46[2][B] | u_top/u_manual/n8_s0/COUT
7.859 | 2.148 | tNET | FF | 1 | R36C44[1][A] | u_top/ev_word_11_s2/I2
8.376 | 0.517 | tINS | FF | 1 | R36C44[1][A] | u_top/ev_word_11_s2/F
9.032 | 0.656 | tNET | FF | 1 | R36C41[3][A] | u_top/ev_word_11_s1/I1
9.494 | 0.462 | tINS | FR | 1 | R36C41[3][A] | u_top/ev_word_11_s1/F
9.495 | 0.001 | tNET | RR | 1 | R36C41[1][B] | u_top/ev_word_11_s0/I0
9.948 | 0.453 | tINS | RF | 40 | R36C41[1][B] | u_top/ev_word_11_s0/F
15.910 | 5.961 | tNET | FF | 2 | R8C23[1][B] | u_top/u_alloc/n51_s0/I1
16.480 | 0.570 | tINS | FR | 1 | R8C23[1][B] | u_top/u_alloc/n51_s0/COUT
16.480 | 0.000 | tNET | RR | 2 | R8C23[2][A] | u_top/u_alloc/n52_s0/CIN
16.515 | 0.035 | tINS | RF | 1 | R8C23[2][A] | u_top/u_alloc/n52_s0/COUT
16.515 | 0.000 | tNET | FF | 2 | R8C23[2][B] | u_top/u_alloc/n53_s0/CIN
16.550 | 0.035 | tINS | FF | 1 | R8C23[2][B] | u_top/u_alloc/n53_s0/COUT
16.550 | 0.000 | tNET | FF | 2 | R8C24[0][A] | u_top/u_alloc/n54_s0/CIN
16.585 | 0.035 | tINS | FF | 3 | R8C24[0][A] | u_top/u_alloc/n54_s0/COUT
17.555 | 0.970 | tNET | FF | 1 | R12C24[1][B] | u_top/u_alloc/pick_2_s60/I0
18.008 | 0.453 | tINS | FF | 3 | R12C24[1][B] | u_top/u_alloc/pick_2_s60/F
18.197 | 0.189 | tNET | FF | 1 | R12C23[3][A] | u_top/u_alloc/pick_0_s61/I1
18.746 | 0.549 | tINS | FR | 3 | R12C23[3][A] | u_top/u_alloc/pick_0_s61/F
18.750 | 0.004 | tNET | RR | 1 | R12C23[2][A] | u_top/u_alloc/pick_2_s101/I2
19.212 | 0.462 | tINS | RR | 1 | R12C23[2][A] | u_top/u_alloc/pick_2_s101/F
19.384 | 0.172 | tNET | RR | 1 | R12C24[3][B] | u_top/u_alloc/pick_2_s85/I0
19.837 | 0.453 | tINS | RF | 4 | R12C24[3][B] | u_top/u_alloc/pick_2_s85/F
20.764 | 0.927 | tNET | FF | 1 | R13C19[3][A] | u_top/u_alloc/pick_2_s62/I3
21.313 | 0.549 | tINS | FR | 3 | R13C19[3][A] | u_top/u_alloc/pick_2_s62/F
21.317 | 0.004 | tNET | RR | 1 | R13C19[0][B] | u_top/u_alloc/pick_2_s84/I1
21.770 | 0.453 | tINS | RF | 1 | R13C19[0][B] | u_top/u_alloc/pick_2_s84/F
22.183 | 0.413 | tNET | FF | 1 | R14C18[0][A] | u_top/u_alloc/pick_2_s58/I2
22.732 | 0.549 | tINS | FR | 1 | R14C18[0][A] | u_top/u_alloc/pick_2_s58/F
22.905 | 0.172 | tNET | RR | 1 | R14C17[2][A] | u_top/u_alloc/pick_2_s118/I3
23.276 | 0.371 | tINS | RF | 2 | R14C17[2][A] | u_top/u_alloc/pick_2_s118/F
23.689 | 0.413 | tNET | FF | 1 | R13C16[3][A] | u_top/u_alloc/pick_2_s8/I3
24.244 | 0.555 | tINS | FF | 7 | R13C16[3][A] | u_top/u_alloc/pick_2_s8/F
25.319 | 1.075 | tNET | FF | 1 | R12C21[2][B] | u_top/u_alloc/pick_1_s12/I1
25.889 | 0.570 | tINS | FR | 1 | R12C21[2][B] | u_top/u_alloc/pick_1_s12/F
25.890 | 0.001 | tNET | RR | 1 | R12C21[3][A] | u_top/u_alloc/pick_1_s6/I3
26.439 | 0.549 | tINS | RR | 1 | R12C21[3][A] | u_top/u_alloc/pick_1_s6/F
26.611 | 0.172 | tNET | RR | 1 | R12C20[1][B] | u_top/u_alloc/pick_1_s2/I1
27.166 | 0.555 | tINS | RF | 9 | R12C20[1][B] | u_top/u_alloc/pick_1_s2/F
28.325 | 1.159 | tNET | FF | 1 | R7C20[0][A] | u_top/u_alloc/pick_1_s43/I3
28.842 | 0.517 | tINS | FF | 12 | R7C20[0][A] | u_top/u_alloc/pick_1_s43/F
30.057 | 1.215 | tNET | FF | 18 | DSP_R19[1][A] | u_top/u_alloc/n453_s1/B[1]
33.697 | 3.640 | tINS | FF | 8 | DSP_R19[1][A] | u_top/u_alloc/n453_s1/DOUT[6]
35.806 | 2.109 | tNET | FF | 1 | R12C27[3][B] | u_top/u_alloc/n3406_s1/I0
36.133 | 0.327 | tINS | FR | 7 | R12C27[3][B] | u_top/u_alloc/n3406_s1/F
36.513 | 0.380 | tNET | RR | 1 | R12C30[0][B] | u_top/u_alloc/v_note_44_s0/CE

Data Required Path:

AT | DELAY | TYPE | RF | FANOUT | LOC | NODE
37.037 | 37.037 | | | | | active clock edge time
37.037 | 0.000 | | | | | clk_27m
37.037 | 0.000 | tCL | RR | 1 | IOT27[A] | clk_27m_ibuf/I
39.125 | 2.088 | tINS | RR | 3750 | IOT27[A] | clk_27m_ibuf/O
41.396 | 2.271 | tNET | RR | 1 | R12C30[0][B] | u_top/u_alloc/v_note_44_s0/CLK
41.361 | -0.035 | tSu | | 1 | R12C30[0][B] | u_top/u_alloc/v_note_44_s0

Path Statistics:

Clock Skew | 0.000
Setup Relationship | 37.037
Logic Level | 24
Arrival Clock Path Delay | cell: 2.088, 47.897%; route: 2.271, 52.103%
Arrival Data Path Delay | cell: 13.349, 41.518%; route: 18.572, 57.760%; tC2Q: 0.232, 0.722%
Required Clock Path Delay | cell: 2.088, 47.897%; route: 2.271, 52.103%

### Path24

Path Summary:

Slack | 4.849
Data Arrival Time | 36.513
Data Required Time | 41.361
From | u_top/u_manual/wr_ptr_0_s0
To | u_top/u_alloc/v_note_45_s0
Launch Clk | clk_27m:[R]
Latch Clk | clk_27m:[R]

Data Arrival Path:

AT | DELAY | TYPE | RF | FANOUT | LOC | NODE
0.000 | 0.000 | | | | | active clock edge time
0.000 | 0.000 | | | | | clk_27m
0.000 | 0.000 | tCL | RR | 1 | IOT27[A] | clk_27m_ibuf/I
2.088 | 2.088 | tINS | RR | 3750 | IOT27[A] | clk_27m_ibuf/O
4.359 | 2.271 | tNET | RR | 1 | R42C49[1][A] | u_top/u_manual/wr_ptr_0_s0/CLK
4.591 | 0.232 | tC2Q | RF | 7 | R42C49[1][A] | u_top/u_manual/wr_ptr_0_s0/Q
5.021 | 0.430 | tNET | FF | 2 | R42C46[0][B] | u_top/u_manual/n4_s0/I0
5.570 | 0.549 | tINS | FR | 1 | R42C46[0][B] | u_top/u_manual/n4_s0/COUT
5.570 | 0.000 | tNET | RR | 2 | R42C46[1][A] | u_top/u_manual/n5_s0/CIN
5.606 | 0.035 | tINS | RF | 1 | R42C46[1][A] | u_top/u_manual/n5_s0/COUT
5.606 | 0.000 | tNET | FF | 2 | R42C46[1][B] | u_top/u_manual/n6_s0/CIN
5.641 | 0.035 | tINS | FF | 1 | R42C46[1][B] | u_top/u_manual/n6_s0/COUT
5.641 | 0.000 | tNET | FF | 2 | R42C46[2][A] | u_top/u_manual/n7_s0/CIN
5.676 | 0.035 | tINS | FF | 1 | R42C46[2][A] | u_top/u_manual/n7_s0/COUT
5.676 | 0.000 | tNET | FF | 2 | R42C46[2][B] | u_top/u_manual/n8_s0/CIN
5.711 | 0.035 | tINS | FF | 17 | R42C46[2][B] | u_top/u_manual/n8_s0/COUT
7.859 | 2.148 | tNET | FF | 1 | R36C44[1][A] | u_top/ev_word_11_s2/I2
8.376 | 0.517 | tINS | FF | 1 | R36C44[1][A] | u_top/ev_word_11_s2/F
9.032 | 0.656 | tNET | FF | 1 | R36C41[3][A] | u_top/ev_word_11_s1/I1
9.494 | 0.462 | tINS | FR | 1 | R36C41[3][A] | u_top/ev_word_11_s1/F
9.495 | 0.001 | tNET | RR | 1 | R36C41[1][B] | u_top/ev_word_11_s0/I0
9.948 | 0.453 | tINS | RF | 40 | R36C41[1][B] | u_top/ev_word_11_s0/F
15.910 | 5.961 | tNET | FF | 2 | R8C23[1][B] | u_top/u_alloc/n51_s0/I1
16.480 | 0.570 | tINS | FR | 1 | R8C23[1][B] | u_top/u_alloc/n51_s0/COUT
16.480 | 0.000 | tNET | RR | 2 | R8C23[2][A] | u_top/u_alloc/n52_s0/CIN
16.515 | 0.035 | tINS | RF | 1 | R8C23[2][A] | u_top/u_alloc/n52_s0/COUT
16.515 | 0.000 | tNET | FF | 2 | R8C23[2][B] | u_top/u_alloc/n53_s0/CIN
16.550 | 0.035 | tINS | FF | 1 | R8C23[2][B] | u_top/u_alloc/n53_s0/COUT
16.550 | 0.000 | tNET | FF | 2 | R8C24[0][A] | u_top/u_alloc/n54_s0/CIN
16.585 | 0.035 | tINS | FF | 3 | R8C24[0][A] | u_top/u_alloc/n54_s0/COUT
17.555 | 0.970 | tNET | FF | 1 | R12C24[1][B] | u_top/u_alloc/pick_2_s60/I0
18.008 | 0.453 | tINS | FF | 3 | R12C24[1][B] | u_top/u_alloc/pick_2_s60/F
18.197 | 0.189 | tNET | FF | 1 | R12C23[3][A] | u_top/u_alloc/pick_0_s61/I1
18.746 | 0.549 | tINS | FR | 3 | R12C23[3][A] | u_top/u_alloc/pick_0_s61/F
18.750 | 0.004 | tNET | RR | 1 | R12C23[2][A] | u_top/u_alloc/pick_2_s101/I2
19.212 | 0.462 | tINS | RR | 1 | R12C23[2][A] | u_top/u_alloc/pick_2_s101/F
19.384 | 0.172 | tNET | RR | 1 | R12C24[3][B] | u_top/u_alloc/pick_2_s85/I0
19.837 | 0.453 | tINS | RF | 4 | R12C24[3][B] | u_top/u_alloc/pick_2_s85/F
20.764 | 0.927 | tNET | FF | 1 | R13C19[3][A] | u_top/u_alloc/pick_2_s62/I3
21.313 | 0.549 | tINS | FR | 3 | R13C19[3][A] | u_top/u_alloc/pick_2_s62/F
21.317 | 0.004 | tNET | RR | 1 | R13C19[0][B] | u_top/u_alloc/pick_2_s84/I1
21.770 | 0.453 | tINS | RF | 1 | R13C19[0][B] | u_top/u_alloc/pick_2_s84/F
22.183 | 0.413 | tNET | FF | 1 | R14C18[0][A] | u_top/u_alloc/pick_2_s58/I2
22.732 | 0.549 | tINS | FR | 1 | R14C18[0][A] | u_top/u_alloc/pick_2_s58/F
22.905 | 0.172 | tNET | RR | 1 | R14C17[2][A] | u_top/u_alloc/pick_2_s118/I3
23.276 | 0.371 | tINS | RF | 2 | R14C17[2][A] | u_top/u_alloc/pick_2_s118/F
23.689 | 0.413 | tNET | FF | 1 | R13C16[3][A] | u_top/u_alloc/pick_2_s8/I3
24.244 | 0.555 | tINS | FF | 7 | R13C16[3][A] | u_top/u_alloc/pick_2_s8/F
25.319 | 1.075 | tNET | FF | 1 | R12C21[2][B] | u_top/u_alloc/pick_1_s12/I1
25.889 | 0.570 | tINS | FR | 1 | R12C21[2][B] | u_top/u_alloc/pick_1_s12/F
25.890 | 0.001 | tNET | RR | 1 | R12C21[3][A] | u_top/u_alloc/pick_1_s6/I3
26.439 | 0.549 | tINS | RR | 1 | R12C21[3][A] | u_top/u_alloc/pick_1_s6/F
26.611 | 0.172 | tNET | RR | 1 | R12C20[1][B] | u_top/u_alloc/pick_1_s2/I1
27.166 | 0.555 | tINS | RF | 9 | R12C20[1][B] | u_top/u_alloc/pick_1_s2/F
28.325 | 1.159 | tNET | FF | 1 | R7C20[0][A] | u_top/u_alloc/pick_1_s43/I3
28.842 | 0.517 | tINS | FF | 12 | R7C20[0][A] | u_top/u_alloc/pick_1_s43/F
30.057 | 1.215 | tNET | FF | 18 | DSP_R19[1][A] | u_top/u_alloc/n453_s1/B[1]
33.697 | 3.640 | tINS | FF | 8 | DSP_R19[1][A] | u_top/u_alloc/n453_s1/DOUT[6]
35.806 | 2.109 | tNET | FF | 1 | R12C27[3][B] | u_top/u_alloc/n3406_s1/I0
36.133 | 0.327 | tINS | FR | 7 | R12C27[3][B] | u_top/u_alloc/n3406_s1/F
36.513 | 0.380 | tNET | RR | 1 | R12C30[1][A] | u_top/u_alloc/v_note_45_s0/CE

Data Required Path:

AT | DELAY | TYPE | RF | FANOUT | LOC | NODE
37.037 | 37.037 | | | | | active clock edge time
37.037 | 0.000 | | | | | clk_27m
37.037 | 0.000 | tCL | RR | 1 | IOT27[A] | clk_27m_ibuf/I
39.125 | 2.088 | tINS | RR | 3750 | IOT27[A] | clk_27m_ibuf/O
41.396 | 2.271 | tNET | RR | 1 | R12C30[1][A] | u_top/u_alloc/v_note_45_s0/CLK
41.361 | -0.035 | tSu | | 1 | R12C30[1][A] | u_top/u_alloc/v_note_45_s0

Path Statistics:

Clock Skew | 0.000
Setup Relationship | 37.037
Logic Level | 24
Arrival Clock Path Delay | cell: 2.088, 47.897%; route: 2.271, 52.103%
Arrival Data Path Delay | cell: 13.349, 41.518%; route: 18.572, 57.760%; tC2Q: 0.232, 0.722%
Required Clock Path Delay | cell: 2.088, 47.897%; route: 2.271, 52.103%

### Path25

Path Summary:

Slack | 4.849
Data Arrival Time | 36.513
Data Required Time | 41.361
From | u_top/u_manual/wr_ptr_0_s0
To | u_top/u_alloc/v_note_46_s0
Launch Clk | clk_27m:[R]
Latch Clk | clk_27m:[R]

Data Arrival Path:

AT | DELAY | TYPE | RF | FANOUT | LOC | NODE
0.000 | 0.000 | | | | | active clock edge time
0.000 | 0.000 | | | | | clk_27m
0.000 | 0.000 | tCL | RR | 1 | IOT27[A] | clk_27m_ibuf/I
2.088 | 2.088 | tINS | RR | 3750 | IOT27[A] | clk_27m_ibuf/O
4.359 | 2.271 | tNET | RR | 1 | R42C49[1][A] | u_top/u_manual/wr_ptr_0_s0/CLK
4.591 | 0.232 | tC2Q | RF | 7 | R42C49[1][A] | u_top/u_manual/wr_ptr_0_s0/Q
5.021 | 0.430 | tNET | FF | 2 | R42C46[0][B] | u_top/u_manual/n4_s0/I0
5.570 | 0.549 | tINS | FR | 1 | R42C46[0][B] | u_top/u_manual/n4_s0/COUT
5.570 | 0.000 | tNET | RR | 2 | R42C46[1][A] | u_top/u_manual/n5_s0/CIN
5.606 | 0.035 | tINS | RF | 1 | R42C46[1][A] | u_top/u_manual/n5_s0/COUT
5.606 | 0.000 | tNET | FF | 2 | R42C46[1][B] | u_top/u_manual/n6_s0/CIN
5.641 | 0.035 | tINS | FF | 1 | R42C46[1][B] | u_top/u_manual/n6_s0/COUT
5.641 | 0.000 | tNET | FF | 2 | R42C46[2][A] | u_top/u_manual/n7_s0/CIN
5.676 | 0.035 | tINS | FF | 1 | R42C46[2][A] | u_top/u_manual/n7_s0/COUT
5.676 | 0.000 | tNET | FF | 2 | R42C46[2][B] | u_top/u_manual/n8_s0/CIN
5.711 | 0.035 | tINS | FF | 17 | R42C46[2][B] | u_top/u_manual/n8_s0/COUT
7.859 | 2.148 | tNET | FF | 1 | R36C44[1][A] | u_top/ev_word_11_s2/I2
8.376 | 0.517 | tINS | FF | 1 | R36C44[1][A] | u_top/ev_word_11_s2/F
9.032 | 0.656 | tNET | FF | 1 | R36C41[3][A] | u_top/ev_word_11_s1/I1
9.494 | 0.462 | tINS | FR | 1 | R36C41[3][A] | u_top/ev_word_11_s1/F
9.495 | 0.001 | tNET | RR | 1 | R36C41[1][B] | u_top/ev_word_11_s0/I0
9.948 | 0.453 | tINS | RF | 40 | R36C41[1][B] | u_top/ev_word_11_s0/F
15.910 | 5.961 | tNET | FF | 2 | R8C23[1][B] | u_top/u_alloc/n51_s0/I1
16.480 | 0.570 | tINS | FR | 1 | R8C23[1][B] | u_top/u_alloc/n51_s0/COUT
16.480 | 0.000 | tNET | RR | 2 | R8C23[2][A] | u_top/u_alloc/n52_s0/CIN
16.515 | 0.035 | tINS | RF | 1 | R8C23[2][A] | u_top/u_alloc/n52_s0/COUT
16.515 | 0.000 | tNET | FF | 2 | R8C23[2][B] | u_top/u_alloc/n53_s0/CIN
16.550 | 0.035 | tINS | FF | 1 | R8C23[2][B] | u_top/u_alloc/n53_s0/COUT
16.550 | 0.000 | tNET | FF | 2 | R8C24[0][A] | u_top/u_alloc/n54_s0/CIN
16.585 | 0.035 | tINS | FF | 3 | R8C24[0][A] | u_top/u_alloc/n54_s0/COUT
17.555 | 0.970 | tNET | FF | 1 | R12C24[1][B] | u_top/u_alloc/pick_2_s60/I0
18.008 | 0.453 | tINS | FF | 3 | R12C24[1][B] | u_top/u_alloc/pick_2_s60/F
18.197 | 0.189 | tNET | FF | 1 | R12C23[3][A] | u_top/u_alloc/pick_0_s61/I1
18.746 | 0.549 | tINS | FR | 3 | R12C23[3][A] | u_top/u_alloc/pick_0_s61/F
18.750 | 0.004 | tNET | RR | 1 | R12C23[2][A] | u_top/u_alloc/pick_2_s101/I2
19.212 | 0.462 | tINS | RR | 1 | R12C23[2][A] | u_top/u_alloc/pick_2_s101/F
19.384 | 0.172 | tNET | RR | 1 | R12C24[3][B] | u_top/u_alloc/pick_2_s85/I0
19.837 | 0.453 | tINS | RF | 4 | R12C24[3][B] | u_top/u_alloc/pick_2_s85/F
20.764 | 0.927 | tNET | FF | 1 | R13C19[3][A] | u_top/u_alloc/pick_2_s62/I3
21.313 | 0.549 | tINS | FR | 3 | R13C19[3][A] | u_top/u_alloc/pick_2_s62/F
21.317 | 0.004 | tNET | RR | 1 | R13C19[0][B] | u_top/u_alloc/pick_2_s84/I1
21.770 | 0.453 | tINS | RF | 1 | R13C19[0][B] | u_top/u_alloc/pick_2_s84/F
22.183 | 0.413 | tNET | FF | 1 | R14C18[0][A] | u_top/u_alloc/pick_2_s58/I2
22.732 | 0.549 | tINS | FR | 1 | R14C18[0][A] | u_top/u_alloc/pick_2_s58/F
22.905 | 0.172 | tNET | RR | 1 | R14C17[2][A] | u_top/u_alloc/pick_2_s118/I3
23.276 | 0.371 | tINS | RF | 2 | R14C17[2][A] | u_top/u_alloc/pick_2_s118/F
23.689 | 0.413 | tNET | FF | 1 | R13C16[3][A] | u_top/u_alloc/pick_2_s8/I3
24.244 | 0.555 | tINS | FF | 7 | R13C16[3][A] | u_top/u_alloc/pick_2_s8/F
25.319 | 1.075 | tNET | FF | 1 | R12C21[2][B] | u_top/u_alloc/pick_1_s12/I1
25.889 | 0.570 | tINS | FR | 1 | R12C21[2][B] | u_top/u_alloc/pick_1_s12/F
25.890 | 0.001 | tNET | RR | 1 | R12C21[3][A] | u_top/u_alloc/pick_1_s6/I3
26.439 | 0.549 | tINS | RR | 1 | R12C21[3][A] | u_top/u_alloc/pick_1_s6/F
26.611 | 0.172 | tNET | RR | 1 | R12C20[1][B] | u_top/u_alloc/pick_1_s2/I1
27.166 | 0.555 | tINS | RF | 9 | R12C20[1][B] | u_top/u_alloc/pick_1_s2/F
28.325 | 1.159 | tNET | FF | 1 | R7C20[0][A] | u_top/u_alloc/pick_1_s43/I3
28.842 | 0.517 | tINS | FF | 12 | R7C20[0][A] | u_top/u_alloc/pick_1_s43/F
30.057 | 1.215 | tNET | FF | 18 | DSP_R19[1][A] | u_top/u_alloc/n453_s1/B[1]
33.697 | 3.640 | tINS | FF | 8 | DSP_R19[1][A] | u_top/u_alloc/n453_s1/DOUT[6]
35.806 | 2.109 | tNET | FF | 1 | R12C27[3][B] | u_top/u_alloc/n3406_s1/I0
36.133 | 0.327 | tINS | FR | 7 | R12C27[3][B] | u_top/u_alloc/n3406_s1/F
36.513 | 0.380 | tNET | RR | 1 | R12C30[1][B] | u_top/u_alloc/v_note_46_s0/CE

Data Required Path:

AT | DELAY | TYPE | RF | FANOUT | LOC | NODE
37.037 | 37.037 | | | | | active clock edge time
37.037 | 0.000 | | | | | clk_27m
37.037 | 0.000 | tCL | RR | 1 | IOT27[A] | clk_27m_ibuf/I
39.125 | 2.088 | tINS | RR | 3750 | IOT27[A] | clk_27m_ibuf/O
41.396 | 2.271 | tNET | RR | 1 | R12C30[1][B] | u_top/u_alloc/v_note_46_s0/CLK
41.361 | -0.035 | tSu | | 1 | R12C30[1][B] | u_top/u_alloc/v_note_46_s0

Path Statistics:

Clock Skew | 0.000
Setup Relationship | 37.037
Logic Level | 24
Arrival Clock Path Delay | cell: 2.088, 47.897%; route: 2.271, 52.103%
Arrival Data Path Delay | cell: 13.349, 41.518%; route: 18.572, 57.760%; tC2Q: 0.232, 0.722%
Required Clock Path Delay | cell: 2.088, 47.897%; route: 2.271, 52.103%

### Hold Analysis Report

#### Report Command:report_timing -hold -max_paths 25 -max_common_paths 1

### Path1

Path Summary:

Slack | 0.216
Data Arrival Time | 3.237
Data Required Time | 3.021
From | u_top/u_engine/rom_addr_7_s0
To | u_top/u_engine/g_banked.u_piano_rom/gp4
Launch Clk | clk_27m:[R]
Latch Clk | clk_27m:[R]

Data Arrival Path:

AT | DELAY | TYPE | RF | FANOUT | LOC | NODE
0.000 | 0.000 | | | | | active clock edge time
0.000 | 0.000 | | | | | clk_27m
0.000 | 0.000 | tCL | RR | 1 | IOT27[A] | clk_27m_ibuf/I
1.392 | 1.392 | tINS | RR | 3750 | IOT27[A] | clk_27m_ibuf/O
2.903 | 1.511 | tNET | RR | 1 | R48C14[1][B] | u_top/u_engine/rom_addr_7_s0/CLK
3.105 | 0.202 | tC2Q | RR | 40 | R48C14[1][B] | u_top/u_engine/rom_addr_7_s0/Q
3.237 | 0.132 | tNET | RR | 1 | BSRAM_R46[3] | u_top/u_engine/g_banked.u_piano_rom/gp4/AD[11]

Data Required Path:

AT | DELAY | TYPE | RF | FANOUT | LOC | NODE
0.000 | 0.000 | | | | | active clock edge time
0.000 | 0.000 | | | | | clk_27m
0.000 | 0.000 | tCL | RR | 1 | IOT27[A] | clk_27m_ibuf/I
1.392 | 1.392 | tINS | RR | 3750 | IOT27[A] | clk_27m_ibuf/O
2.903 | 1.511 | tNET | RR | 1 | BSRAM_R46[3] | u_top/u_engine/g_banked.u_piano_rom/gp4/CLK
3.021 | 0.118 | tHld | | 1 | BSRAM_R46[3] | u_top/u_engine/g_banked.u_piano_rom/gp4

Path Statistics:

Clock Skew | 0.000
Hold Relationship | 0.000
Logic Level | 1
Arrival Clock Path Delay | cell: 1.392, 47.946%; route: 1.511, 52.054%
Arrival Data Path Delay | cell: 0.000, 0.000%; route: 0.132, 39.561%; tC2Q: 0.202, 60.439%
Required Clock Path Delay | cell: 1.392, 47.946%; route: 1.511, 52.054%

### Path2

Path Summary:

Slack | 0.318
Data Arrival Time | 3.231
Data Required Time | 2.913
From | u_top/u_uart/reply_wr_ptr_2_s0
To | u_top/u_uart/reply_queue_reply_queue_0_0_s
Launch Clk | clk_27m:[R]
Latch Clk | clk_27m:[R]

Data Arrival Path:

AT | DELAY | TYPE | RF | FANOUT | LOC | NODE
0.000 | 0.000 | | | | | active clock edge time
0.000 | 0.000 | | | | | clk_27m
0.000 | 0.000 | tCL | RR | 1 | IOT27[A] | clk_27m_ibuf/I
1.392 | 1.392 | tINS | RR | 3750 | IOT27[A] | clk_27m_ibuf/O
2.903 | 1.511 | tNET | RR | 1 | R41C45[2][A] | u_top/u_uart/reply_wr_ptr_2_s0/CLK
3.105 | 0.202 | tC2Q | RR | 3 | R41C45[2][A] | u_top/u_uart/reply_wr_ptr_2_s0/Q
3.231 | 0.126 | tNET | RR | 1 | R41C43 | u_top/u_uart/reply_queue_reply_queue_0_0_s/WAD[2]

Data Required Path:

AT | DELAY | TYPE | RF | FANOUT | LOC | NODE
0.000 | 0.000 | | | | | active clock edge time
0.000 | 0.000 | | | | | clk_27m
0.000 | 0.000 | tCL | RR | 1 | IOT27[A] | clk_27m_ibuf/I
1.392 | 1.392 | tINS | RR | 3750 | IOT27[A] | clk_27m_ibuf/O
2.903 | 1.511 | tNET | RR | 1 | R41C43 | u_top/u_uart/reply_queue_reply_queue_0_0_s/CLK
2.913 | 0.010 | tHld | | 1 | R41C43 | u_top/u_uart/reply_queue_reply_queue_0_0_s

Path Statistics:

Clock Skew | 0.000
Hold Relationship | 0.000
Logic Level | 1
Arrival Clock Path Delay | cell: 1.392, 47.946%; route: 1.511, 52.054%
Arrival Data Path Delay | cell: 0.000, 0.000%; route: 0.126, 38.352%; tC2Q: 0.202, 61.648%
Required Clock Path Delay | cell: 1.392, 47.946%; route: 1.511, 52.054%

### Path3

Path Summary:

Slack | 0.318
Data Arrival Time | 3.231
Data Required Time | 2.913
From | u_top/u_uart/reply_wr_ptr_1_s0
To | u_top/u_uart/reply_queue_reply_queue_0_0_s
Launch Clk | clk_27m:[R]
Latch Clk | clk_27m:[R]

Data Arrival Path:

AT | DELAY | TYPE | RF | FANOUT | LOC | NODE
0.000 | 0.000 | | | | | active clock edge time
0.000 | 0.000 | | | | | clk_27m
0.000 | 0.000 | tCL | RR | 1 | IOT27[A] | clk_27m_ibuf/I
1.392 | 1.392 | tINS | RR | 3750 | IOT27[A] | clk_27m_ibuf/O
2.903 | 1.511 | tNET | RR | 1 | R41C45[1][B] | u_top/u_uart/reply_wr_ptr_1_s0/CLK
3.105 | 0.202 | tC2Q | RR | 4 | R41C45[1][B] | u_top/u_uart/reply_wr_ptr_1_s0/Q
3.231 | 0.126 | tNET | RR | 1 | R41C43 | u_top/u_uart/reply_queue_reply_queue_0_0_s/WAD[1]

Data Required Path:

AT | DELAY | TYPE | RF | FANOUT | LOC | NODE
0.000 | 0.000 | | | | | active clock edge time
0.000 | 0.000 | | | | | clk_27m
0.000 | 0.000 | tCL | RR | 1 | IOT27[A] | clk_27m_ibuf/I
1.392 | 1.392 | tINS | RR | 3750 | IOT27[A] | clk_27m_ibuf/O
2.903 | 1.511 | tNET | RR | 1 | R41C43 | u_top/u_uart/reply_queue_reply_queue_0_0_s/CLK
2.913 | 0.010 | tHld | | 1 | R41C43 | u_top/u_uart/reply_queue_reply_queue_0_0_s

Path Statistics:

Clock Skew | 0.000
Hold Relationship | 0.000
Logic Level | 1
Arrival Clock Path Delay | cell: 1.392, 47.946%; route: 1.511, 52.054%
Arrival Data Path Delay | cell: 0.000, 0.000%; route: 0.126, 38.352%; tC2Q: 0.202, 61.648%
Required Clock Path Delay | cell: 1.392, 47.946%; route: 1.511, 52.054%

### Path4

Path Summary:

Slack | 0.323
Data Arrival Time | 3.236
Data Required Time | 2.913
From | u_top/u_fifo/wr_ptr_1_s0
To | u_top/u_fifo/mem_mem_0_1_s
Launch Clk | clk_27m:[R]
Latch Clk | clk_27m:[R]

Data Arrival Path:

AT | DELAY | TYPE | RF | FANOUT | LOC | NODE
0.000 | 0.000 | | | | | active clock edge time
0.000 | 0.000 | | | | | clk_27m
0.000 | 0.000 | tCL | RR | 1 | IOT27[A] | clk_27m_ibuf/I
1.392 | 1.392 | tINS | RR | 3750 | IOT27[A] | clk_27m_ibuf/O
2.903 | 1.511 | tNET | RR | 1 | R25C53[0][B] | u_top/u_fifo/wr_ptr_1_s0/CLK
3.104 | 0.201 | tC2Q | RF | 7 | R25C53[0][B] | u_top/u_fifo/wr_ptr_1_s0/Q
3.236 | 0.132 | tNET | FF | 1 | R24C53 | u_top/u_fifo/mem_mem_0_1_s/WAD[1]

Data Required Path:

AT | DELAY | TYPE | RF | FANOUT | LOC | NODE
0.000 | 0.000 | | | | | active clock edge time
0.000 | 0.000 | | | | | clk_27m
0.000 | 0.000 | tCL | RR | 1 | IOT27[A] | clk_27m_ibuf/I
1.392 | 1.392 | tINS | RR | 3750 | IOT27[A] | clk_27m_ibuf/O
2.903 | 1.511 | tNET | RR | 1 | R24C53 | u_top/u_fifo/mem_mem_0_1_s/CLK
2.913 | 0.010 | tHld | | 1 | R24C53 | u_top/u_fifo/mem_mem_0_1_s

Path Statistics:

Clock Skew | 0.000
Hold Relationship | 0.000
Logic Level | 1
Arrival Clock Path Delay | cell: 1.392, 47.946%; route: 1.511, 52.054%
Arrival Data Path Delay | cell: 0.000, 0.000%; route: 0.132, 39.591%; tC2Q: 0.201, 60.409%
Required Clock Path Delay | cell: 1.392, 47.946%; route: 1.511, 52.054%

### Path5

Path Summary:

Slack | 0.328
Data Arrival Time | 3.242
Data Required Time | 2.913
From | u_top/u_fifo/wr_ptr_2_s0
To | u_top/u_fifo/mem_mem_0_1_s
Launch Clk | clk_27m:[R]
Latch Clk | clk_27m:[R]

Data Arrival Path:

AT | DELAY | TYPE | RF | FANOUT | LOC | NODE
0.000 | 0.000 | | | | | active clock edge time
0.000 | 0.000 | | | | | clk_27m
0.000 | 0.000 | tCL | RR | 1 | IOT27[A] | clk_27m_ibuf/I
1.392 | 1.392 | tINS | RR | 3750 | IOT27[A] | clk_27m_ibuf/O
2.903 | 1.511 | tNET | RR | 1 | R25C53[1][A] | u_top/u_fifo/wr_ptr_2_s0/CLK
3.104 | 0.201 | tC2Q | RF | 7 | R25C53[1][A] | u_top/u_fifo/wr_ptr_2_s0/Q
3.242 | 0.137 | tNET | FF | 1 | R24C53 | u_top/u_fifo/mem_mem_0_1_s/WAD[2]

Data Required Path:

AT | DELAY | TYPE | RF | FANOUT | LOC | NODE
0.000 | 0.000 | | | | | active clock edge time
0.000 | 0.000 | | | | | clk_27m
0.000 | 0.000 | tCL | RR | 1 | IOT27[A] | clk_27m_ibuf/I
1.392 | 1.392 | tINS | RR | 3750 | IOT27[A] | clk_27m_ibuf/O
2.903 | 1.511 | tNET | RR | 1 | R24C53 | u_top/u_fifo/mem_mem_0_1_s/CLK
2.913 | 0.010 | tHld | | 1 | R24C53 | u_top/u_fifo/mem_mem_0_1_s

Path Statistics:

Clock Skew | 0.000
Hold Relationship | 0.000
Logic Level | 1
Arrival Clock Path Delay | cell: 1.392, 47.946%; route: 1.511, 52.054%
Arrival Data Path Delay | cell: 0.000, 0.000%; route: 0.137, 40.594%; tC2Q: 0.201, 59.406%
Required Clock Path Delay | cell: 1.392, 47.946%; route: 1.511, 52.054%

### Path6

Path Summary:

Slack | 0.334
Data Arrival Time | 3.247
Data Required Time | 2.913
From | u_top/u_fifo/wr_ptr_3_s0
To | u_top/u_fifo/mem_mem_0_1_s
Launch Clk | clk_27m:[R]
Latch Clk | clk_27m:[R]

Data Arrival Path:

AT | DELAY | TYPE | RF | FANOUT | LOC | NODE
0.000 | 0.000 | | | | | active clock edge time
0.000 | 0.000 | | | | | clk_27m
0.000 | 0.000 | tCL | RR | 1 | IOT27[A] | clk_27m_ibuf/I
1.392 | 1.392 | tINS | RR | 3750 | IOT27[A] | clk_27m_ibuf/O
2.903 | 1.511 | tNET | RR | 1 | R25C53[1][B] | u_top/u_fifo/wr_ptr_3_s0/CLK
3.104 | 0.201 | tC2Q | RF | 7 | R25C53[1][B] | u_top/u_fifo/wr_ptr_3_s0/Q
3.247 | 0.143 | tNET | FF | 1 | R24C53 | u_top/u_fifo/mem_mem_0_1_s/WAD[3]

Data Required Path:

AT | DELAY | TYPE | RF | FANOUT | LOC | NODE
0.000 | 0.000 | | | | | active clock edge time
0.000 | 0.000 | | | | | clk_27m
0.000 | 0.000 | tCL | RR | 1 | IOT27[A] | clk_27m_ibuf/I
1.392 | 1.392 | tINS | RR | 3750 | IOT27[A] | clk_27m_ibuf/O
2.903 | 1.511 | tNET | RR | 1 | R24C53 | u_top/u_fifo/mem_mem_0_1_s/CLK
2.913 | 0.010 | tHld | | 1 | R24C53 | u_top/u_fifo/mem_mem_0_1_s

Path Statistics:

Clock Skew | 0.000
Hold Relationship | 0.000
Logic Level | 1
Arrival Clock Path Delay | cell: 1.392, 47.946%; route: 1.511, 52.054%
Arrival Data Path Delay | cell: 0.000, 0.000%; route: 0.143, 41.564%; tC2Q: 0.201, 58.436%
Required Clock Path Delay | cell: 1.392, 47.946%; route: 1.511, 52.054%

### Path7

Path Summary:

Slack | 0.334
Data Arrival Time | 3.356
Data Required Time | 3.021
From | u_top/u_engine/rom_addr_3_s0
To | u_top/u_engine/g_banked.u_piano_rom/gp4
Launch Clk | clk_27m:[R]
Latch Clk | clk_27m:[R]

Data Arrival Path:

AT | DELAY | TYPE | RF | FANOUT | LOC | NODE
0.000 | 0.000 | | | | | active clock edge time
0.000 | 0.000 | | | | | clk_27m
0.000 | 0.000 | tCL | RR | 1 | IOT27[A] | clk_27m_ibuf/I
1.392 | 1.392 | tINS | RR | 3750 | IOT27[A] | clk_27m_ibuf/O
2.903 | 1.511 | tNET | RR | 1 | R48C14[0][B] | u_top/u_engine/rom_addr_3_s0/CLK
3.105 | 0.202 | tC2Q | RR | 40 | R48C14[0][B] | u_top/u_engine/rom_addr_3_s0/Q
3.356 | 0.250 | tNET | RR | 1 | BSRAM_R46[3] | u_top/u_engine/g_banked.u_piano_rom/gp4/AD[7]

Data Required Path:

AT | DELAY | TYPE | RF | FANOUT | LOC | NODE
0.000 | 0.000 | | | | | active clock edge time
0.000 | 0.000 | | | | | clk_27m
0.000 | 0.000 | tCL | RR | 1 | IOT27[A] | clk_27m_ibuf/I
1.392 | 1.392 | tINS | RR | 3750 | IOT27[A] | clk_27m_ibuf/O
2.903 | 1.511 | tNET | RR | 1 | BSRAM_R46[3] | u_top/u_engine/g_banked.u_piano_rom/gp4/CLK
3.021 | 0.118 | tHld | | 1 | BSRAM_R46[3] | u_top/u_engine/g_banked.u_piano_rom/gp4

Path Statistics:

Clock Skew | 0.000
Hold Relationship | 0.000
Logic Level | 1
Arrival Clock Path Delay | cell: 1.392, 47.946%; route: 1.511, 52.054%
Arrival Data Path Delay | cell: 0.000, 0.000%; route: 0.250, 55.351%; tC2Q: 0.202, 44.649%
Required Clock Path Delay | cell: 1.392, 47.946%; route: 1.511, 52.054%

### Path8

Path Summary:

Slack | 0.335
Data Arrival Time | 3.356
Data Required Time | 3.021
From | u_top/u_engine/rom_addr_5_s0
To | u_top/u_engine/g_banked.u_piano_rom/gp2
Launch Clk | clk_27m:[R]
Latch Clk | clk_27m:[R]

Data Arrival Path:

AT | DELAY | TYPE | RF | FANOUT | LOC | NODE
0.000 | 0.000 | | | | | active clock edge time
0.000 | 0.000 | | | | | clk_27m
0.000 | 0.000 | tCL | RR | 1 | IOT27[A] | clk_27m_ibuf/I
1.392 | 1.392 | tINS | RR | 3750 | IOT27[A] | clk_27m_ibuf/O
2.903 | 1.511 | tNET | RR | 1 | R48C13[2][B] | u_top/u_engine/rom_addr_5_s0/CLK
3.105 | 0.202 | tC2Q | RR | 40 | R48C13[2][B] | u_top/u_engine/rom_addr_5_s0/Q
3.356 | 0.251 | tNET | RR | 1 | BSRAM_R46[2] | u_top/u_engine/g_banked.u_piano_rom/gp2/AD[9]

Data Required Path:

AT | DELAY | TYPE | RF | FANOUT | LOC | NODE
0.000 | 0.000 | | | | | active clock edge time
0.000 | 0.000 | | | | | clk_27m
0.000 | 0.000 | tCL | RR | 1 | IOT27[A] | clk_27m_ibuf/I
1.392 | 1.392 | tINS | RR | 3750 | IOT27[A] | clk_27m_ibuf/O
2.903 | 1.511 | tNET | RR | 1 | BSRAM_R46[2] | u_top/u_engine/g_banked.u_piano_rom/gp2/CLK
3.021 | 0.118 | tHld | | 1 | BSRAM_R46[2] | u_top/u_engine/g_banked.u_piano_rom/gp2

Path Statistics:

Clock Skew | 0.000
Hold Relationship | 0.000
Logic Level | 1
Arrival Clock Path Delay | cell: 1.392, 47.946%; route: 1.511, 52.054%
Arrival Data Path Delay | cell: 0.000, 0.000%; route: 0.251, 55.376%; tC2Q: 0.202, 44.624%
Required Clock Path Delay | cell: 1.392, 47.946%; route: 1.511, 52.054%

### Path9

Path Summary:

Slack | 0.336
Data Arrival Time | 3.357
Data Required Time | 3.021
From | u_top/u_engine/rom_addr_6_s0
To | u_top/u_engine/g_banked.u_piano_rom/gp4
Launch Clk | clk_27m:[R]
Latch Clk | clk_27m:[R]

Data Arrival Path:

AT | DELAY | TYPE | RF | FANOUT | LOC | NODE
0.000 | 0.000 | | | | | active clock edge time
0.000 | 0.000 | | | | | clk_27m
0.000 | 0.000 | tCL | RR | 1 | IOT27[A] | clk_27m_ibuf/I
1.392 | 1.392 | tINS | RR | 3750 | IOT27[A] | clk_27m_ibuf/O
2.903 | 1.511 | tNET | RR | 1 | R48C14[2][A] | u_top/u_engine/rom_addr_6_s0/CLK
3.105 | 0.202 | tC2Q | RR | 40 | R48C14[2][A] | u_top/u_engine/rom_addr_6_s0/Q
3.357 | 0.252 | tNET | RR | 1 | BSRAM_R46[3] | u_top/u_engine/g_banked.u_piano_rom/gp4/AD[10]

Data Required Path:

AT | DELAY | TYPE | RF | FANOUT | LOC | NODE
0.000 | 0.000 | | | | | active clock edge time
0.000 | 0.000 | | | | | clk_27m
0.000 | 0.000 | tCL | RR | 1 | IOT27[A] | clk_27m_ibuf/I
1.392 | 1.392 | tINS | RR | 3750 | IOT27[A] | clk_27m_ibuf/O
2.903 | 1.511 | tNET | RR | 1 | BSRAM_R46[3] | u_top/u_engine/g_banked.u_piano_rom/gp4/CLK
3.021 | 0.118 | tHld | | 1 | BSRAM_R46[3] | u_top/u_engine/g_banked.u_piano_rom/gp4

Path Statistics:

Clock Skew | 0.000
Hold Relationship | 0.000
Logic Level | 1
Arrival Clock Path Delay | cell: 1.392, 47.946%; route: 1.511, 52.054%
Arrival Data Path Delay | cell: 0.000, 0.000%; route: 0.252, 55.525%; tC2Q: 0.202, 44.475%
Required Clock Path Delay | cell: 1.392, 47.946%; route: 1.511, 52.054%

### Path10

Path Summary:

Slack | 0.342
Data Arrival Time | 3.363
Data Required Time | 3.021
From | u_top/u_engine/rom_addr_2_s0
To | u_top/u_engine/g_banked.u_piano_rom/gp4
Launch Clk | clk_27m:[R]
Latch Clk | clk_27m:[R]

Data Arrival Path:

AT | DELAY | TYPE | RF | FANOUT | LOC | NODE
0.000 | 0.000 | | | | | active clock edge time
0.000 | 0.000 | | | | | clk_27m
0.000 | 0.000 | tCL | RR | 1 | IOT27[A] | clk_27m_ibuf/I
1.392 | 1.392 | tINS | RR | 3750 | IOT27[A] | clk_27m_ibuf/O
2.903 | 1.511 | tNET | RR | 1 | R48C14[1][A] | u_top/u_engine/rom_addr_2_s0/CLK
3.105 | 0.202 | tC2Q | RR | 40 | R48C14[1][A] | u_top/u_engine/rom_addr_2_s0/Q
3.363 | 0.258 | tNET | RR | 1 | BSRAM_R46[3] | u_top/u_engine/g_banked.u_piano_rom/gp4/AD[6]

Data Required Path:

AT | DELAY | TYPE | RF | FANOUT | LOC | NODE
0.000 | 0.000 | | | | | active clock edge time
0.000 | 0.000 | | | | | clk_27m
0.000 | 0.000 | tCL | RR | 1 | IOT27[A] | clk_27m_ibuf/I
1.392 | 1.392 | tINS | RR | 3750 | IOT27[A] | clk_27m_ibuf/O
2.903 | 1.511 | tNET | RR | 1 | BSRAM_R46[3] | u_top/u_engine/g_banked.u_piano_rom/gp4/CLK
3.021 | 0.118 | tHld | | 1 | BSRAM_R46[3] | u_top/u_engine/g_banked.u_piano_rom/gp4

Path Statistics:

Clock Skew | 0.000
Hold Relationship | 0.000
Logic Level | 1
Arrival Clock Path Delay | cell: 1.392, 47.946%; route: 1.511, 52.054%
Arrival Data Path Delay | cell: 0.000, 0.000%; route: 0.258, 56.105%; tC2Q: 0.202, 43.895%
Required Clock Path Delay | cell: 1.392, 47.946%; route: 1.511, 52.054%

### Path11

Path Summary:

Slack | 0.346
Data Arrival Time | 3.367
Data Required Time | 3.021
From | u_top/u_engine/rom_addr_8_s0
To | u_top/u_engine/g_banked.u_piano_rom/gp2
Launch Clk | clk_27m:[R]
Latch Clk | clk_27m:[R]

Data Arrival Path:

AT | DELAY | TYPE | RF | FANOUT | LOC | NODE
0.000 | 0.000 | | | | | active clock edge time
0.000 | 0.000 | | | | | clk_27m
0.000 | 0.000 | tCL | RR | 1 | IOT27[A] | clk_27m_ibuf/I
1.392 | 1.392 | tINS | RR | 3750 | IOT27[A] | clk_27m_ibuf/O
2.903 | 1.511 | tNET | RR | 1 | R47C13[0][B] | u_top/u_engine/rom_addr_8_s0/CLK
3.105 | 0.202 | tC2Q | RR | 40 | R47C13[0][B] | u_top/u_engine/rom_addr_8_s0/Q
3.367 | 0.262 | tNET | RR | 1 | BSRAM_R46[2] | u_top/u_engine/g_banked.u_piano_rom/gp2/AD[12]

Data Required Path:

AT | DELAY | TYPE | RF | FANOUT | LOC | NODE
0.000 | 0.000 | | | | | active clock edge time
0.000 | 0.000 | | | | | clk_27m
0.000 | 0.000 | tCL | RR | 1 | IOT27[A] | clk_27m_ibuf/I
1.392 | 1.392 | tINS | RR | 3750 | IOT27[A] | clk_27m_ibuf/O
2.903 | 1.511 | tNET | RR | 1 | BSRAM_R46[2] | u_top/u_engine/g_banked.u_piano_rom/gp2/CLK
3.021 | 0.118 | tHld | | 1 | BSRAM_R46[2] | u_top/u_engine/g_banked.u_piano_rom/gp2

Path Statistics:

Clock Skew | 0.000
Hold Relationship | 0.000
Logic Level | 1
Arrival Clock Path Delay | cell: 1.392, 47.946%; route: 1.511, 52.054%
Arrival Data Path Delay | cell: 0.000, 0.000%; route: 0.262, 56.429%; tC2Q: 0.202, 43.571%
Required Clock Path Delay | cell: 1.392, 47.946%; route: 1.511, 52.054%

### Path12

Path Summary:

Slack | 0.347
Data Arrival Time | 3.368
Data Required Time | 3.021
From | u_top/u_engine/rom_addr_0_s0
To | u_top/u_engine/g_banked.u_piano_rom/gp4
Launch Clk | clk_27m:[R]
Latch Clk | clk_27m:[R]

Data Arrival Path:

AT | DELAY | TYPE | RF | FANOUT | LOC | NODE
0.000 | 0.000 | | | | | active clock edge time
0.000 | 0.000 | | | | | clk_27m
0.000 | 0.000 | tCL | RR | 1 | IOT27[A] | clk_27m_ibuf/I
1.392 | 1.392 | tINS | RR | 3750 | IOT27[A] | clk_27m_ibuf/O
2.903 | 1.511 | tNET | RR | 1 | R45C14[1][B] | u_top/u_engine/rom_addr_0_s0/CLK
3.105 | 0.202 | tC2Q | RR | 40 | R45C14[1][B] | u_top/u_engine/rom_addr_0_s0/Q
3.368 | 0.263 | tNET | RR | 1 | BSRAM_R46[3] | u_top/u_engine/g_banked.u_piano_rom/gp4/AD[4]

Data Required Path:

AT | DELAY | TYPE | RF | FANOUT | LOC | NODE
0.000 | 0.000 | | | | | active clock edge time
0.000 | 0.000 | | | | | clk_27m
0.000 | 0.000 | tCL | RR | 1 | IOT27[A] | clk_27m_ibuf/I
1.392 | 1.392 | tINS | RR | 3750 | IOT27[A] | clk_27m_ibuf/O
2.903 | 1.511 | tNET | RR | 1 | BSRAM_R46[3] | u_top/u_engine/g_banked.u_piano_rom/gp4/CLK
3.021 | 0.118 | tHld | | 1 | BSRAM_R46[3] | u_top/u_engine/g_banked.u_piano_rom/gp4

Path Statistics:

Clock Skew | 0.000
Hold Relationship | 0.000
Logic Level | 1
Arrival Clock Path Delay | cell: 1.392, 47.946%; route: 1.511, 52.054%
Arrival Data Path Delay | cell: 0.000, 0.000%; route: 0.263, 56.533%; tC2Q: 0.202, 43.467%
Required Clock Path Delay | cell: 1.392, 47.946%; route: 1.511, 52.054%

### Path13

Path Summary:

Slack | 0.347
Data Arrival Time | 3.368
Data Required Time | 3.021
From | u_top/u_engine/rom_addr_0_s0
To | u_top/u_engine/g_banked.u_piano_rom/gp2
Launch Clk | clk_27m:[R]
Latch Clk | clk_27m:[R]

Data Arrival Path:

AT | DELAY | TYPE | RF | FANOUT | LOC | NODE
0.000 | 0.000 | | | | | active clock edge time
0.000 | 0.000 | | | | | clk_27m
0.000 | 0.000 | tCL | RR | 1 | IOT27[A] | clk_27m_ibuf/I
1.392 | 1.392 | tINS | RR | 3750 | IOT27[A] | clk_27m_ibuf/O
2.903 | 1.511 | tNET | RR | 1 | R45C14[1][B] | u_top/u_engine/rom_addr_0_s0/CLK
3.105 | 0.202 | tC2Q | RR | 40 | R45C14[1][B] | u_top/u_engine/rom_addr_0_s0/Q
3.368 | 0.263 | tNET | RR | 1 | BSRAM_R46[2] | u_top/u_engine/g_banked.u_piano_rom/gp2/AD[4]

Data Required Path:

AT | DELAY | TYPE | RF | FANOUT | LOC | NODE
0.000 | 0.000 | | | | | active clock edge time
0.000 | 0.000 | | | | | clk_27m
0.000 | 0.000 | tCL | RR | 1 | IOT27[A] | clk_27m_ibuf/I
1.392 | 1.392 | tINS | RR | 3750 | IOT27[A] | clk_27m_ibuf/O
2.903 | 1.511 | tNET | RR | 1 | BSRAM_R46[2] | u_top/u_engine/g_banked.u_piano_rom/gp2/CLK
3.021 | 0.118 | tHld | | 1 | BSRAM_R46[2] | u_top/u_engine/g_banked.u_piano_rom/gp2

Path Statistics:

Clock Skew | 0.000
Hold Relationship | 0.000
Logic Level | 1
Arrival Clock Path Delay | cell: 1.392, 47.946%; route: 1.511, 52.054%
Arrival Data Path Delay | cell: 0.000, 0.000%; route: 0.263, 56.533%; tC2Q: 0.202, 43.467%
Required Clock Path Delay | cell: 1.392, 47.946%; route: 1.511, 52.054%

### Path14

Path Summary:

Slack | 0.347
Data Arrival Time | 3.369
Data Required Time | 3.021
From | u_top/u_engine/rom_addr_4_s0
To | u_top/u_engine/g_banked.u_piano_rom/gp4
Launch Clk | clk_27m:[R]
Latch Clk | clk_27m:[R]

Data Arrival Path:

AT | DELAY | TYPE | RF | FANOUT | LOC | NODE
0.000 | 0.000 | | | | | active clock edge time
0.000 | 0.000 | | | | | clk_27m
0.000 | 0.000 | tCL | RR | 1 | IOT27[A] | clk_27m_ibuf/I
1.392 | 1.392 | tINS | RR | 3750 | IOT27[A] | clk_27m_ibuf/O
2.903 | 1.511 | tNET | RR | 1 | R48C13[0][A] | u_top/u_engine/rom_addr_4_s0/CLK
3.105 | 0.202 | tC2Q | RR | 40 | R48C13[0][A] | u_top/u_engine/rom_addr_4_s0/Q
3.369 | 0.263 | tNET | RR | 1 | BSRAM_R46[3] | u_top/u_engine/g_banked.u_piano_rom/gp4/AD[8]

Data Required Path:

AT | DELAY | TYPE | RF | FANOUT | LOC | NODE
0.000 | 0.000 | | | | | active clock edge time
0.000 | 0.000 | | | | | clk_27m
0.000 | 0.000 | tCL | RR | 1 | IOT27[A] | clk_27m_ibuf/I
1.392 | 1.392 | tINS | RR | 3750 | IOT27[A] | clk_27m_ibuf/O
2.903 | 1.511 | tNET | RR | 1 | BSRAM_R46[3] | u_top/u_engine/g_banked.u_piano_rom/gp4/CLK
3.021 | 0.118 | tHld | | 1 | BSRAM_R46[3] | u_top/u_engine/g_banked.u_piano_rom/gp4

Path Statistics:

Clock Skew | 0.000
Hold Relationship | 0.000
Logic Level | 1
Arrival Clock Path Delay | cell: 1.392, 47.946%; route: 1.511, 52.054%
Arrival Data Path Delay | cell: 0.000, 0.000%; route: 0.263, 56.595%; tC2Q: 0.202, 43.405%
Required Clock Path Delay | cell: 1.392, 47.946%; route: 1.511, 52.054%

### Path15

Path Summary:

Slack | 0.349
Data Arrival Time | 3.370
Data Required Time | 3.021
From | u_top/u_engine/rom_addr_1_s0
To | u_top/u_engine/g_banked.u_piano_rom/gp4
Launch Clk | clk_27m:[R]
Latch Clk | clk_27m:[R]

Data Arrival Path:

AT | DELAY | TYPE | RF | FANOUT | LOC | NODE
0.000 | 0.000 | | | | | active clock edge time
0.000 | 0.000 | | | | | clk_27m
0.000 | 0.000 | tCL | RR | 1 | IOT27[A] | clk_27m_ibuf/I
1.392 | 1.392 | tINS | RR | 3750 | IOT27[A] | clk_27m_ibuf/O
2.903 | 1.511 | tNET | RR | 1 | R47C13[0][A] | u_top/u_engine/rom_addr_1_s0/CLK
3.105 | 0.202 | tC2Q | RR | 40 | R47C13[0][A] | u_top/u_engine/rom_addr_1_s0/Q
3.370 | 0.265 | tNET | RR | 1 | BSRAM_R46[3] | u_top/u_engine/g_banked.u_piano_rom/gp4/AD[5]

Data Required Path:

AT | DELAY | TYPE | RF | FANOUT | LOC | NODE
0.000 | 0.000 | | | | | active clock edge time
0.000 | 0.000 | | | | | clk_27m
0.000 | 0.000 | tCL | RR | 1 | IOT27[A] | clk_27m_ibuf/I
1.392 | 1.392 | tINS | RR | 3750 | IOT27[A] | clk_27m_ibuf/O
2.903 | 1.511 | tNET | RR | 1 | BSRAM_R46[3] | u_top/u_engine/g_banked.u_piano_rom/gp4/CLK
3.021 | 0.118 | tHld | | 1 | BSRAM_R46[3] | u_top/u_engine/g_banked.u_piano_rom/gp4

Path Statistics:

Clock Skew | 0.000
Hold Relationship | 0.000
Logic Level | 1
Arrival Clock Path Delay | cell: 1.392, 47.946%; route: 1.511, 52.054%
Arrival Data Path Delay | cell: 0.000, 0.000%; route: 0.265, 56.709%; tC2Q: 0.202, 43.291%
Required Clock Path Delay | cell: 1.392, 47.946%; route: 1.511, 52.054%

### Path16

Path Summary:

Slack | 0.349
Data Arrival Time | 3.370
Data Required Time | 3.021
From | u_top/u_engine/rom_addr_1_s0
To | u_top/u_engine/g_banked.u_piano_rom/gp2
Launch Clk | clk_27m:[R]
Latch Clk | clk_27m:[R]

Data Arrival Path:

AT | DELAY | TYPE | RF | FANOUT | LOC | NODE
0.000 | 0.000 | | | | | active clock edge time
0.000 | 0.000 | | | | | clk_27m
0.000 | 0.000 | tCL | RR | 1 | IOT27[A] | clk_27m_ibuf/I
1.392 | 1.392 | tINS | RR | 3750 | IOT27[A] | clk_27m_ibuf/O
2.903 | 1.511 | tNET | RR | 1 | R47C13[0][A] | u_top/u_engine/rom_addr_1_s0/CLK
3.105 | 0.202 | tC2Q | RR | 40 | R47C13[0][A] | u_top/u_engine/rom_addr_1_s0/Q
3.370 | 0.265 | tNET | RR | 1 | BSRAM_R46[2] | u_top/u_engine/g_banked.u_piano_rom/gp2/AD[5]

Data Required Path:

AT | DELAY | TYPE | RF | FANOUT | LOC | NODE
0.000 | 0.000 | | | | | active clock edge time
0.000 | 0.000 | | | | | clk_27m
0.000 | 0.000 | tCL | RR | 1 | IOT27[A] | clk_27m_ibuf/I
1.392 | 1.392 | tINS | RR | 3750 | IOT27[A] | clk_27m_ibuf/O
2.903 | 1.511 | tNET | RR | 1 | BSRAM_R46[2] | u_top/u_engine/g_banked.u_piano_rom/gp2/CLK
3.021 | 0.118 | tHld | | 1 | BSRAM_R46[2] | u_top/u_engine/g_banked.u_piano_rom/gp2

Path Statistics:

Clock Skew | 0.000
Hold Relationship | 0.000
Logic Level | 1
Arrival Clock Path Delay | cell: 1.392, 47.946%; route: 1.511, 52.054%
Arrival Data Path Delay | cell: 0.000, 0.000%; route: 0.265, 56.709%; tC2Q: 0.202, 43.291%
Required Clock Path Delay | cell: 1.392, 47.946%; route: 1.511, 52.054%

### Path17

Path Summary:

Slack | 0.350
Data Arrival Time | 3.371
Data Required Time | 3.021
From | u_top/u_engine/rom_addr_8_s0
To | u_top/u_engine/g_banked.u_piano_rom/gp4
Launch Clk | clk_27m:[R]
Latch Clk | clk_27m:[R]

Data Arrival Path:

AT | DELAY | TYPE | RF | FANOUT | LOC | NODE
0.000 | 0.000 | | | | | active clock edge time
0.000 | 0.000 | | | | | clk_27m
0.000 | 0.000 | tCL | RR | 1 | IOT27[A] | clk_27m_ibuf/I
1.392 | 1.392 | tINS | RR | 3750 | IOT27[A] | clk_27m_ibuf/O
2.903 | 1.511 | tNET | RR | 1 | R47C13[0][B] | u_top/u_engine/rom_addr_8_s0/CLK
3.105 | 0.202 | tC2Q | RR | 40 | R47C13[0][B] | u_top/u_engine/rom_addr_8_s0/Q
3.371 | 0.266 | tNET | RR | 1 | BSRAM_R46[3] | u_top/u_engine/g_banked.u_piano_rom/gp4/AD[12]

Data Required Path:

AT | DELAY | TYPE | RF | FANOUT | LOC | NODE
0.000 | 0.000 | | | | | active clock edge time
0.000 | 0.000 | | | | | clk_27m
0.000 | 0.000 | tCL | RR | 1 | IOT27[A] | clk_27m_ibuf/I
1.392 | 1.392 | tINS | RR | 3750 | IOT27[A] | clk_27m_ibuf/O
2.903 | 1.511 | tNET | RR | 1 | BSRAM_R46[3] | u_top/u_engine/g_banked.u_piano_rom/gp4/CLK
3.021 | 0.118 | tHld | | 1 | BSRAM_R46[3] | u_top/u_engine/g_banked.u_piano_rom/gp4

Path Statistics:

Clock Skew | 0.000
Hold Relationship | 0.000
Logic Level | 1
Arrival Clock Path Delay | cell: 1.392, 47.946%; route: 1.511, 52.054%
Arrival Data Path Delay | cell: 0.000, 0.000%; route: 0.266, 56.817%; tC2Q: 0.202, 43.183%
Required Clock Path Delay | cell: 1.392, 47.946%; route: 1.511, 52.054%

### Path18

Path Summary:

Slack | 0.350
Data Arrival Time | 3.371
Data Required Time | 3.021
From | u_top/u_engine/rom_addr_5_s0
To | u_top/u_engine/g_banked.u_piano_rom/gp4
Launch Clk | clk_27m:[R]
Latch Clk | clk_27m:[R]

Data Arrival Path:

AT | DELAY | TYPE | RF | FANOUT | LOC | NODE
0.000 | 0.000 | | | | | active clock edge time
0.000 | 0.000 | | | | | clk_27m
0.000 | 0.000 | tCL | RR | 1 | IOT27[A] | clk_27m_ibuf/I
1.392 | 1.392 | tINS | RR | 3750 | IOT27[A] | clk_27m_ibuf/O
2.903 | 1.511 | tNET | RR | 1 | R48C13[2][B] | u_top/u_engine/rom_addr_5_s0/CLK
3.105 | 0.202 | tC2Q | RR | 40 | R48C13[2][B] | u_top/u_engine/rom_addr_5_s0/Q
3.371 | 0.266 | tNET | RR | 1 | BSRAM_R46[3] | u_top/u_engine/g_banked.u_piano_rom/gp4/AD[9]

Data Required Path:

AT | DELAY | TYPE | RF | FANOUT | LOC | NODE
0.000 | 0.000 | | | | | active clock edge time
0.000 | 0.000 | | | | | clk_27m
0.000 | 0.000 | tCL | RR | 1 | IOT27[A] | clk_27m_ibuf/I
1.392 | 1.392 | tINS | RR | 3750 | IOT27[A] | clk_27m_ibuf/O
2.903 | 1.511 | tNET | RR | 1 | BSRAM_R46[3] | u_top/u_engine/g_banked.u_piano_rom/gp4/CLK
3.021 | 0.118 | tHld | | 1 | BSRAM_R46[3] | u_top/u_engine/g_banked.u_piano_rom/gp4

Path Statistics:

Clock Skew | 0.000
Hold Relationship | 0.000
Logic Level | 1
Arrival Clock Path Delay | cell: 1.392, 47.946%; route: 1.511, 52.054%
Arrival Data Path Delay | cell: 0.000, 0.000%; route: 0.266, 56.822%; tC2Q: 0.202, 43.178%
Required Clock Path Delay | cell: 1.392, 47.946%; route: 1.511, 52.054%

### Path19

Path Summary:

Slack | 0.359
Data Arrival Time | 3.380
Data Required Time | 3.021
From | u_top/u_engine/rom_addr_5_s0
To | u_top/u_engine/g_banked.u_piano_rom/gp6
Launch Clk | clk_27m:[R]
Latch Clk | clk_27m:[R]

Data Arrival Path:

AT | DELAY | TYPE | RF | FANOUT | LOC | NODE
0.000 | 0.000 | | | | | active clock edge time
0.000 | 0.000 | | | | | clk_27m
0.000 | 0.000 | tCL | RR | 1 | IOT27[A] | clk_27m_ibuf/I
1.392 | 1.392 | tINS | RR | 3750 | IOT27[A] | clk_27m_ibuf/O
2.903 | 1.511 | tNET | RR | 1 | R48C13[2][B] | u_top/u_engine/rom_addr_5_s0/CLK
3.105 | 0.202 | tC2Q | RR | 40 | R48C13[2][B] | u_top/u_engine/rom_addr_5_s0/Q
3.380 | 0.275 | tNET | RR | 1 | BSRAM_R46[4] | u_top/u_engine/g_banked.u_piano_rom/gp6/AD[9]

Data Required Path:

AT | DELAY | TYPE | RF | FANOUT | LOC | NODE
0.000 | 0.000 | | | | | active clock edge time
0.000 | 0.000 | | | | | clk_27m
0.000 | 0.000 | tCL | RR | 1 | IOT27[A] | clk_27m_ibuf/I
1.392 | 1.392 | tINS | RR | 3750 | IOT27[A] | clk_27m_ibuf/O
2.903 | 1.511 | tNET | RR | 1 | BSRAM_R46[4] | u_top/u_engine/g_banked.u_piano_rom/gp6/CLK
3.021 | 0.118 | tHld | | 1 | BSRAM_R46[4] | u_top/u_engine/g_banked.u_piano_rom/gp6

Path Statistics:

Clock Skew | 0.000
Hold Relationship | 0.000
Logic Level | 1
Arrival Clock Path Delay | cell: 1.392, 47.946%; route: 1.511, 52.054%
Arrival Data Path Delay | cell: 0.000, 0.000%; route: 0.275, 57.645%; tC2Q: 0.202, 42.355%
Required Clock Path Delay | cell: 1.392, 47.946%; route: 1.511, 52.054%

### Path20

Path Summary:

Slack | 0.425
Data Arrival Time | 3.340
Data Required Time | 2.914
From | u_top/g_pt8211.u_pt8211/b_cnt_0_s1
To | u_top/g_pt8211.u_pt8211/b_cnt_0_s1
Launch Clk | clk_27m:[R]
Latch Clk | clk_27m:[R]

Data Arrival Path:

AT | DELAY | TYPE | RF | FANOUT | LOC | NODE
0.000 | 0.000 | | | | | active clock edge time
0.000 | 0.000 | | | | | clk_27m
0.000 | 0.000 | tCL | RR | 1 | IOT27[A] | clk_27m_ibuf/I
1.392 | 1.392 | tINS | RR | 3750 | IOT27[A] | clk_27m_ibuf/O
2.903 | 1.511 | tNET | RR | 1 | R25C40[1][A] | u_top/g_pt8211.u_pt8211/b_cnt_0_s1/CLK
3.105 | 0.202 | tC2Q | RR | 5 | R25C40[1][A] | u_top/g_pt8211.u_pt8211/b_cnt_0_s1/Q
3.108 | 0.002 | tNET | RR | 1 | R25C40[1][A] | u_top/g_pt8211.u_pt8211/n26_s5/I0
3.340 | 0.232 | tINS | RF | 1 | R25C40[1][A] | u_top/g_pt8211.u_pt8211/n26_s5/F
3.340 | 0.000 | tNET | FF | 1 | R25C40[1][A] | u_top/g_pt8211.u_pt8211/b_cnt_0_s1/D

Data Required Path:

AT | DELAY | TYPE | RF | FANOUT | LOC | NODE
0.000 | 0.000 | | | | | active clock edge time
0.000 | 0.000 | | | | | clk_27m
0.000 | 0.000 | tCL | RR | 1 | IOT27[A] | clk_27m_ibuf/I
1.392 | 1.392 | tINS | RR | 3750 | IOT27[A] | clk_27m_ibuf/O
2.903 | 1.511 | tNET | RR | 1 | R25C40[1][A] | u_top/g_pt8211.u_pt8211/b_cnt_0_s1/CLK
2.914 | 0.011 | tHld | | 1 | R25C40[1][A] | u_top/g_pt8211.u_pt8211/b_cnt_0_s1

Path Statistics:

Clock Skew | 0.000
Hold Relationship | 0.000
Logic Level | 2
Arrival Clock Path Delay | cell: 1.392, 47.946%; route: 1.511, 52.054%
Arrival Data Path Delay | cell: 0.232, 53.157%; route: 0.002, 0.560%; tC2Q: 0.202, 46.283%
Required Clock Path Delay | cell: 1.392, 47.946%; route: 1.511, 52.054%

### Path21

Path Summary:

Slack | 0.425
Data Arrival Time | 3.340
Data Required Time | 2.914
From | u_top/g_pt8211.u_pt8211/b_cnt_3_s0
To | u_top/g_pt8211.u_pt8211/b_cnt_3_s0
Launch Clk | clk_27m:[R]
Latch Clk | clk_27m:[R]

Data Arrival Path:

AT | DELAY | TYPE | RF | FANOUT | LOC | NODE
0.000 | 0.000 | | | | | active clock edge time
0.000 | 0.000 | | | | | clk_27m
0.000 | 0.000 | tCL | RR | 1 | IOT27[A] | clk_27m_ibuf/I
1.392 | 1.392 | tINS | RR | 3750 | IOT27[A] | clk_27m_ibuf/O
2.903 | 1.511 | tNET | RR | 1 | R24C36[1][A] | u_top/g_pt8211.u_pt8211/b_cnt_3_s0/CLK
3.105 | 0.202 | tC2Q | RR | 4 | R24C36[1][A] | u_top/g_pt8211.u_pt8211/b_cnt_3_s0/Q
3.108 | 0.002 | tNET | RR | 2 | R24C36[1][A] | u_top/g_pt8211.u_pt8211/n23_s/I1
3.340 | 0.232 | tINS | RF | 1 | R24C36[1][A] | u_top/g_pt8211.u_pt8211/n23_s/SUM
3.340 | 0.000 | tNET | FF | 1 | R24C36[1][A] | u_top/g_pt8211.u_pt8211/b_cnt_3_s0/D

Data Required Path:

AT | DELAY | TYPE | RF | FANOUT | LOC | NODE
0.000 | 0.000 | | | | | active clock edge time
0.000 | 0.000 | | | | | clk_27m
0.000 | 0.000 | tCL | RR | 1 | IOT27[A] | clk_27m_ibuf/I
1.392 | 1.392 | tINS | RR | 3750 | IOT27[A] | clk_27m_ibuf/O
2.903 | 1.511 | tNET | RR | 1 | R24C36[1][A] | u_top/g_pt8211.u_pt8211/b_cnt_3_s0/CLK
2.914 | 0.011 | tHld | | 1 | R24C36[1][A] | u_top/g_pt8211.u_pt8211/b_cnt_3_s0

Path Statistics:

Clock Skew | 0.000
Hold Relationship | 0.000
Logic Level | 2
Arrival Clock Path Delay | cell: 1.392, 47.946%; route: 1.511, 52.054%
Arrival Data Path Delay | cell: 0.232, 53.157%; route: 0.002, 0.560%; tC2Q: 0.202, 46.283%
Required Clock Path Delay | cell: 1.392, 47.946%; route: 1.511, 52.054%

### Path22

Path Summary:

Slack | 0.425
Data Arrival Time | 3.340
Data Required Time | 2.914
From | u_top/g_pt8211.u_pt8211/div_cnt_0_s0
To | u_top/g_pt8211.u_pt8211/div_cnt_0_s0
Launch Clk | clk_27m:[R]
Latch Clk | clk_27m:[R]

Data Arrival Path:

AT | DELAY | TYPE | RF | FANOUT | LOC | NODE
0.000 | 0.000 | | | | | active clock edge time
0.000 | 0.000 | | | | | clk_27m
0.000 | 0.000 | tCL | RR | 1 | IOT27[A] | clk_27m_ibuf/I
1.392 | 1.392 | tINS | RR | 3750 | IOT27[A] | clk_27m_ibuf/O
2.903 | 1.511 | tNET | RR | 1 | R26C40[0][A] | u_top/g_pt8211.u_pt8211/div_cnt_0_s0/CLK
3.105 | 0.202 | tC2Q | RR | 5 | R26C40[0][A] | u_top/g_pt8211.u_pt8211/div_cnt_0_s0/Q
3.108 | 0.002 | tNET | RR | 1 | R26C40[0][A] | u_top/g_pt8211.u_pt8211/n15_s2/I0
3.340 | 0.232 | tINS | RF | 1 | R26C40[0][A] | u_top/g_pt8211.u_pt8211/n15_s2/F
3.340 | 0.000 | tNET | FF | 1 | R26C40[0][A] | u_top/g_pt8211.u_pt8211/div_cnt_0_s0/D

Data Required Path:

AT | DELAY | TYPE | RF | FANOUT | LOC | NODE
0.000 | 0.000 | | | | | active clock edge time
0.000 | 0.000 | | | | | clk_27m
0.000 | 0.000 | tCL | RR | 1 | IOT27[A] | clk_27m_ibuf/I
1.392 | 1.392 | tINS | RR | 3750 | IOT27[A] | clk_27m_ibuf/O
2.903 | 1.511 | tNET | RR | 1 | R26C40[0][A] | u_top/g_pt8211.u_pt8211/div_cnt_0_s0/CLK
2.914 | 0.011 | tHld | | 1 | R26C40[0][A] | u_top/g_pt8211.u_pt8211/div_cnt_0_s0

Path Statistics:

Clock Skew | 0.000
Hold Relationship | 0.000
Logic Level | 2
Arrival Clock Path Delay | cell: 1.392, 47.946%; route: 1.511, 52.054%
Arrival Data Path Delay | cell: 0.232, 53.157%; route: 0.002, 0.560%; tC2Q: 0.202, 46.283%
Required Clock Path Delay | cell: 1.392, 47.946%; route: 1.511, 52.054%

### Path23

Path Summary:

Slack | 0.425
Data Arrival Time | 3.340
Data Required Time | 2.914
From | u_top/u_xf/clip_count_0_s0
To | u_top/u_xf/clip_count_0_s0
Launch Clk | clk_27m:[R]
Latch Clk | clk_27m:[R]

Data Arrival Path:

AT | DELAY | TYPE | RF | FANOUT | LOC | NODE
0.000 | 0.000 | | | | | active clock edge time
0.000 | 0.000 | | | | | clk_27m
0.000 | 0.000 | tCL | RR | 1 | IOT27[A] | clk_27m_ibuf/I
1.392 | 1.392 | tINS | RR | 3750 | IOT27[A] | clk_27m_ibuf/O
2.903 | 1.511 | tNET | RR | 1 | R2C4[0][A] | u_top/u_xf/clip_count_0_s0/CLK
3.105 | 0.202 | tC2Q | RR | 4 | R2C4[0][A] | u_top/u_xf/clip_count_0_s0/Q
3.108 | 0.002 | tNET | RR | 1 | R2C4[0][A] | u_top/u_xf/n2903_s2/I0
3.340 | 0.232 | tINS | RF | 1 | R2C4[0][A] | u_top/u_xf/n2903_s2/F
3.340 | 0.000 | tNET | FF | 1 | R2C4[0][A] | u_top/u_xf/clip_count_0_s0/D

Data Required Path:

AT | DELAY | TYPE | RF | FANOUT | LOC | NODE
0.000 | 0.000 | | | | | active clock edge time
0.000 | 0.000 | | | | | clk_27m
0.000 | 0.000 | tCL | RR | 1 | IOT27[A] | clk_27m_ibuf/I
1.392 | 1.392 | tINS | RR | 3750 | IOT27[A] | clk_27m_ibuf/O
2.903 | 1.511 | tNET | RR | 1 | R2C4[0][A] | u_top/u_xf/clip_count_0_s0/CLK
2.914 | 0.011 | tHld | | 1 | R2C4[0][A] | u_top/u_xf/clip_count_0_s0

Path Statistics:

Clock Skew | 0.000
Hold Relationship | 0.000
Logic Level | 2
Arrival Clock Path Delay | cell: 1.392, 47.946%; route: 1.511, 52.054%
Arrival Data Path Delay | cell: 0.232, 53.157%; route: 0.002, 0.560%; tC2Q: 0.202, 46.283%
Required Clock Path Delay | cell: 1.392, 47.946%; route: 1.511, 52.054%

### Path24

Path Summary:

Slack | 0.425
Data Arrival Time | 3.340
Data Required Time | 2.914
From | u_top/u_xf/clip_count_2_s0
To | u_top/u_xf/clip_count_2_s0
Launch Clk | clk_27m:[R]
Latch Clk | clk_27m:[R]

Data Arrival Path:

AT | DELAY | TYPE | RF | FANOUT | LOC | NODE
0.000 | 0.000 | | | | | active clock edge time
0.000 | 0.000 | | | | | clk_27m
0.000 | 0.000 | tCL | RR | 1 | IOT27[A] | clk_27m_ibuf/I
1.392 | 1.392 | tINS | RR | 3750 | IOT27[A] | clk_27m_ibuf/O
2.903 | 1.511 | tNET | RR | 1 | R2C5[1][A] | u_top/u_xf/clip_count_2_s0/CLK
3.105 | 0.202 | tC2Q | RR | 3 | R2C5[1][A] | u_top/u_xf/clip_count_2_s0/Q
3.108 | 0.002 | tNET | RR | 2 | R2C5[1][A] | u_top/u_xf/n2901_s/I1
3.340 | 0.232 | tINS | RF | 1 | R2C5[1][A] | u_top/u_xf/n2901_s/SUM
3.340 | 0.000 | tNET | FF | 1 | R2C5[1][A] | u_top/u_xf/clip_count_2_s0/D

Data Required Path:

AT | DELAY | TYPE | RF | FANOUT | LOC | NODE
0.000 | 0.000 | | | | | active clock edge time
0.000 | 0.000 | | | | | clk_27m
0.000 | 0.000 | tCL | RR | 1 | IOT27[A] | clk_27m_ibuf/I
1.392 | 1.392 | tINS | RR | 3750 | IOT27[A] | clk_27m_ibuf/O
2.903 | 1.511 | tNET | RR | 1 | R2C5[1][A] | u_top/u_xf/clip_count_2_s0/CLK
2.914 | 0.011 | tHld | | 1 | R2C5[1][A] | u_top/u_xf/clip_count_2_s0

Path Statistics:

Clock Skew | 0.000
Hold Relationship | 0.000
Logic Level | 2
Arrival Clock Path Delay | cell: 1.392, 47.946%; route: 1.511, 52.054%
Arrival Data Path Delay | cell: 0.232, 53.157%; route: 0.002, 0.560%; tC2Q: 0.202, 46.283%
Required Clock Path Delay | cell: 1.392, 47.946%; route: 1.511, 52.054%

### Path25

Path Summary:

Slack | 0.425
Data Arrival Time | 3.340
Data Required Time | 2.914
From | u_top/u_xf/clip_count_6_s0
To | u_top/u_xf/clip_count_6_s0
Launch Clk | clk_27m:[R]
Latch Clk | clk_27m:[R]

Data Arrival Path:

AT | DELAY | TYPE | RF | FANOUT | LOC | NODE
0.000 | 0.000 | | | | | active clock edge time
0.000 | 0.000 | | | | | clk_27m
0.000 | 0.000 | tCL | RR | 1 | IOT27[A] | clk_27m_ibuf/I
1.392 | 1.392 | tINS | RR | 3750 | IOT27[A] | clk_27m_ibuf/O
2.903 | 1.511 | tNET | RR | 1 | R2C6[0][A] | u_top/u_xf/clip_count_6_s0/CLK
3.105 | 0.202 | tC2Q | RR | 3 | R2C6[0][A] | u_top/u_xf/clip_count_6_s0/Q
3.108 | 0.002 | tNET | RR | 2 | R2C6[0][A] | u_top/u_xf/n2897_s/I1
3.340 | 0.232 | tINS | RF | 1 | R2C6[0][A] | u_top/u_xf/n2897_s/SUM
3.340 | 0.000 | tNET | FF | 1 | R2C6[0][A] | u_top/u_xf/clip_count_6_s0/D

Data Required Path:

AT | DELAY | TYPE | RF | FANOUT | LOC | NODE
0.000 | 0.000 | | | | | active clock edge time
0.000 | 0.000 | | | | | clk_27m
0.000 | 0.000 | tCL | RR | 1 | IOT27[A] | clk_27m_ibuf/I
1.392 | 1.392 | tINS | RR | 3750 | IOT27[A] | clk_27m_ibuf/O
2.903 | 1.511 | tNET | RR | 1 | R2C6[0][A] | u_top/u_xf/clip_count_6_s0/CLK
2.914 | 0.011 | tHld | | 1 | R2C6[0][A] | u_top/u_xf/clip_count_6_s0

Path Statistics:

Clock Skew | 0.000
Hold Relationship | 0.000
Logic Level | 2
Arrival Clock Path Delay | cell: 1.392, 47.946%; route: 1.511, 52.054%
Arrival Data Path Delay | cell: 0.232, 53.157%; route: 0.002, 0.560%; tC2Q: 0.202, 46.283%
Required Clock Path Delay | cell: 1.392, 47.946%; route: 1.511, 52.054%

### Recovery Analysis Report

#### Report Command:report_timing -recovery -max_paths 25 -max_common_paths 1

#### No recovery paths to report!

### Removal Analysis Report

#### Report Command:report_timing -removal -max_paths 25 -max_common_paths 1

#### No removal paths to report!

## Minimum Pulse Width Report:

#### Report Command:report_min_pulse_width -nworst 10 -detail

### MPW1

MPW Summary:

Slack: | 15.833
Actual Width: | 16.833
Required Width: | 1.000
Type: | Low Pulse Width
Clock: | clk_27m
Objects: | u_top/reset_cnt_14_s0

Late clock Path:

AT | DELAY | TYPE | RF | NODE
18.518 | 0.000 | | | active clock edge time
18.518 | 0.000 | | | clk_27m
18.518 | 0.000 | tCL | FF | clk_27m_ibuf/I
20.832 | 2.314 | tINS | FF | clk_27m_ibuf/O
23.107 | 2.274 | tNET | FF | u_top/reset_cnt_14_s0/CLK

Early clock Path:

AT | DELAY | TYPE | RF | NODE
37.037 | 0.000 | | | active clock edge time
37.037 | 0.000 | | | clk_27m
37.037 | 0.000 | tCL | RR | clk_27m_ibuf/I
38.429 | 1.392 | tINS | RR | clk_27m_ibuf/O
39.940 | 1.511 | tNET | RR | u_top/reset_cnt_14_s0/CLK

### MPW2

MPW Summary:

Slack: | 15.833
Actual Width: | 16.833
Required Width: | 1.000
Type: | Low Pulse Width
Clock: | clk_27m
Objects: | u_top/reset_cnt_12_s0

Late clock Path:

AT | DELAY | TYPE | RF | NODE
18.518 | 0.000 | | | active clock edge time
18.518 | 0.000 | | | clk_27m
18.518 | 0.000 | tCL | FF | clk_27m_ibuf/I
20.832 | 2.314 | tINS | FF | clk_27m_ibuf/O
23.107 | 2.274 | tNET | FF | u_top/reset_cnt_12_s0/CLK

Early clock Path:

AT | DELAY | TYPE | RF | NODE
37.037 | 0.000 | | | active clock edge time
37.037 | 0.000 | | | clk_27m
37.037 | 0.000 | tCL | RR | clk_27m_ibuf/I
38.429 | 1.392 | tINS | RR | clk_27m_ibuf/O
39.940 | 1.511 | tNET | RR | u_top/reset_cnt_12_s0/CLK

### MPW3

MPW Summary:

Slack: | 15.833
Actual Width: | 16.833
Required Width: | 1.000
Type: | Low Pulse Width
Clock: | clk_27m
Objects: | u_top/reset_cnt_8_s0

Late clock Path:

AT | DELAY | TYPE | RF | NODE
18.518 | 0.000 | | | active clock edge time
18.518 | 0.000 | | | clk_27m
18.518 | 0.000 | tCL | FF | clk_27m_ibuf/I
20.832 | 2.314 | tINS | FF | clk_27m_ibuf/O
23.107 | 2.274 | tNET | FF | u_top/reset_cnt_8_s0/CLK

Early clock Path:

AT | DELAY | TYPE | RF | NODE
37.037 | 0.000 | | | active clock edge time
37.037 | 0.000 | | | clk_27m
37.037 | 0.000 | tCL | RR | clk_27m_ibuf/I
38.429 | 1.392 | tINS | RR | clk_27m_ibuf/O
39.940 | 1.511 | tNET | RR | u_top/reset_cnt_8_s0/CLK

### MPW4

MPW Summary:

Slack: | 15.833
Actual Width: | 16.833
Required Width: | 1.000
Type: | Low Pulse Width
Clock: | clk_27m
Objects: | u_top/reset_cnt_0_s0

Late clock Path:

AT | DELAY | TYPE | RF | NODE
18.518 | 0.000 | | | active clock edge time
18.518 | 0.000 | | | clk_27m
18.518 | 0.000 | tCL | FF | clk_27m_ibuf/I
20.832 | 2.314 | tINS | FF | clk_27m_ibuf/O
23.107 | 2.274 | tNET | FF | u_top/reset_cnt_0_s0/CLK

Early clock Path:

AT | DELAY | TYPE | RF | NODE
37.037 | 0.000 | | | active clock edge time
37.037 | 0.000 | | | clk_27m
37.037 | 0.000 | tCL | RR | clk_27m_ibuf/I
38.429 | 1.392 | tINS | RR | clk_27m_ibuf/O
39.940 | 1.511 | tNET | RR | u_top/reset_cnt_0_s0/CLK

### MPW5

MPW Summary:

Slack: | 15.833
Actual Width: | 16.833
Required Width: | 1.000
Type: | Low Pulse Width
Clock: | clk_27m
Objects: | u_top/mel_idx_d_5_s0

Late clock Path:

AT | DELAY | TYPE | RF | NODE
18.518 | 0.000 | | | active clock edge time
18.518 | 0.000 | | | clk_27m
18.518 | 0.000 | tCL | FF | clk_27m_ibuf/I
20.832 | 2.314 | tINS | FF | clk_27m_ibuf/O
23.107 | 2.274 | tNET | FF | u_top/mel_idx_d_5_s0/CLK

Early clock Path:

AT | DELAY | TYPE | RF | NODE
37.037 | 0.000 | | | active clock edge time
37.037 | 0.000 | | | clk_27m
37.037 | 0.000 | tCL | RR | clk_27m_ibuf/I
38.429 | 1.392 | tINS | RR | clk_27m_ibuf/O
39.940 | 1.511 | tNET | RR | u_top/mel_idx_d_5_s0/CLK

### MPW6

MPW Summary:

Slack: | 15.833
Actual Width: | 16.833
Required Width: | 1.000
Type: | Low Pulse Width
Clock: | clk_27m
Objects: | u_top/adc_start_s0

Late clock Path:

AT | DELAY | TYPE | RF | NODE
18.518 | 0.000 | | | active clock edge time
18.518 | 0.000 | | | clk_27m
18.518 | 0.000 | tCL | FF | clk_27m_ibuf/I
20.832 | 2.314 | tINS | FF | clk_27m_ibuf/O
23.107 | 2.274 | tNET | FF | u_top/adc_start_s0/CLK

Early clock Path:

AT | DELAY | TYPE | RF | NODE
37.037 | 0.000 | | | active clock edge time
37.037 | 0.000 | | | clk_27m
37.037 | 0.000 | tCL | RR | clk_27m_ibuf/I
38.429 | 1.392 | tINS | RR | clk_27m_ibuf/O
39.940 | 1.511 | tNET | RR | u_top/adc_start_s0/CLK

### MPW7

MPW Summary:

Slack: | 15.833
Actual Width: | 16.833
Required Width: | 1.000
Type: | Low Pulse Width
Clock: | clk_27m
Objects: | u_top/mix_lp_y_4_s0

Late clock Path:

AT | DELAY | TYPE | RF | NODE
18.518 | 0.000 | | | active clock edge time
18.518 | 0.000 | | | clk_27m
18.518 | 0.000 | tCL | FF | clk_27m_ibuf/I
20.832 | 2.314 | tINS | FF | clk_27m_ibuf/O
23.107 | 2.274 | tNET | FF | u_top/mix_lp_y_4_s0/CLK

Early clock Path:

AT | DELAY | TYPE | RF | NODE
37.037 | 0.000 | | | active clock edge time
37.037 | 0.000 | | | clk_27m
37.037 | 0.000 | tCL | RR | clk_27m_ibuf/I
38.429 | 1.392 | tINS | RR | clk_27m_ibuf/O
39.940 | 1.511 | tNET | RR | u_top/mix_lp_y_4_s0/CLK

### MPW8

MPW Summary:

Slack: | 15.833
Actual Width: | 16.833
Required Width: | 1.000
Type: | Low Pulse Width
Clock: | clk_27m
Objects: | u_top/g_host_kbd.u_host_kbd/u_uart/cnt_11_s1

Late clock Path:

AT | DELAY | TYPE | RF | NODE
18.518 | 0.000 | | | active clock edge time
18.518 | 0.000 | | | clk_27m
18.518 | 0.000 | tCL | FF | clk_27m_ibuf/I
20.832 | 2.314 | tINS | FF | clk_27m_ibuf/O
23.107 | 2.274 | tNET | FF | u_top/g_host_kbd.u_host_kbd/u_uart/cnt_11_s1/CLK

Early clock Path:

AT | DELAY | TYPE | RF | NODE
37.037 | 0.000 | | | active clock edge time
37.037 | 0.000 | | | clk_27m
37.037 | 0.000 | tCL | RR | clk_27m_ibuf/I
38.429 | 1.392 | tINS | RR | clk_27m_ibuf/O
39.940 | 1.511 | tNET | RR | u_top/g_host_kbd.u_host_kbd/u_uart/cnt_11_s1/CLK

### MPW9

MPW Summary:

Slack: | 15.833
Actual Width: | 16.833
Required Width: | 1.000
Type: | Low Pulse Width
Clock: | clk_27m
Objects: | u_top/g_host_kbd.u_host_kbd/u_map/cur_key_cur_key_RAMREG_0_G[2]_s0

Late clock Path:

AT | DELAY | TYPE | RF | NODE
18.518 | 0.000 | | | active clock edge time
18.518 | 0.000 | | | clk_27m
18.518 | 0.000 | tCL | FF | clk_27m_ibuf/I
20.832 | 2.314 | tINS | FF | clk_27m_ibuf/O
23.107 | 2.274 | tNET | FF | u_top/g_host_kbd.u_host_kbd/u_map/cur_key_cur_key_RAMREG_0_G[2]_s0/CLK

Early clock Path:

AT | DELAY | TYPE | RF | NODE
37.037 | 0.000 | | | active clock edge time
37.037 | 0.000 | | | clk_27m
37.037 | 0.000 | tCL | RR | clk_27m_ibuf/I
38.429 | 1.392 | tINS | RR | clk_27m_ibuf/O
39.940 | 1.511 | tNET | RR | u_top/g_host_kbd.u_host_kbd/u_map/cur_key_cur_key_RAMREG_0_G[2]_s0/CLK

### MPW10

MPW Summary:

Slack: | 15.833
Actual Width: | 16.833
Required Width: | 1.000
Type: | Low Pulse Width
Clock: | clk_27m
Objects: | u_top/u_uart/reply_count_1_s1

Late clock Path:

AT | DELAY | TYPE | RF | NODE
18.518 | 0.000 | | | active clock edge time
18.518 | 0.000 | | | clk_27m
18.518 | 0.000 | tCL | FF | clk_27m_ibuf/I
20.832 | 2.314 | tINS | FF | clk_27m_ibuf/O
23.107 | 2.274 | tNET | FF | u_top/u_uart/reply_count_1_s1/CLK

Early clock Path:

AT | DELAY | TYPE | RF | NODE
37.037 | 0.000 | | | active clock edge time
37.037 | 0.000 | | | clk_27m
37.037 | 0.000 | tCL | RR | clk_27m_ibuf/I
38.429 | 1.392 | tINS | RR | clk_27m_ibuf/O
39.940 | 1.511 | tNET | RR | u_top/u_uart/reply_count_1_s1/CLK

## High Fanout Nets Report:

#### Report Command:report_high_fanout_nets -max_nets 10

FANOUT | NET NAME | WORST SLACK | MAX DELAY
3750 | clk_27m_d | 3.788 | 2.274
2175 | u_top/rst | 27.813 | 1.970
386 | u_top/u_engine/n5449_15 | 28.010 | 1.599
304 | u_top/u_engine/selected[0] | 26.021 | 2.516
228 | u_top/u_engine/vsel[0] | 23.663 | 3.189
207 | u_top/u_engine/vsel[1] | 23.819 | 2.596
188 | u_top/state_23[1] | 26.802 | 2.886
170 | u_top/u_engine/vsel[2] | 24.505 | 3.393
158 | u_top/n563_6 | 27.391 | 1.357
150 | u_top/ev_word[15] | 24.954 | 3.642

## Route Congestions Report:

#### Report Command:report_route_congestion -max_grids 10

GRID LOC | ROUTE CONGESTIONS
R2C2 | 100.00%
R2C3 | 100.00%
R2C29 | 100.00%
R5C54 | 100.00%
R6C2 | 100.00%
R6C7 | 100.00%
R20C9 | 100.00%
R20C10 | 100.00%
R38C45 | 100.00%
R38C47 | 100.00%

## Timing Exceptions Report:

### Setup Analysis Report

#### Report Command:report_exceptions -setup -max_paths 5 -max_common_paths 1

#### No timing exceptions to report!

### Hold Analysis Report

#### Report Command:report_exceptions -hold -max_paths 5 -max_common_paths 1

#### No timing exceptions to report!

### Recovery Analysis Report

#### Report Command:report_exceptions -recovery -max_paths 5 -max_common_paths 1

#### No timing exceptions to report!

### Removal Analysis Report

#### Report Command:report_exceptions -removal -max_paths 5 -max_common_paths 1

#### No timing exceptions to report!

## Timing Constraints Report:

SDC Command Type | State | Detail Command
TC_CLOCK | Actived | create_clock -name clk_27m -period 37.037 [get_ports {clk_27m}]
