Interstellar-530/PolyTouch-FPGA-Synth/evidence/2026/10/FPGA-优化03审核-20261021-v0.1/build_reports/instrument_tr_content.html

# Timing Messages

Report Title | Timing Analysis Report
Design File | E:\Working Space\FPGA\output\handoff_milestone2_20261008\source\build\gowin_top_dbg8usb\runs\20261021T121706344-24340247\instrument\impl\gwsynthesis\instrument.vg
Physical Constraints File | E:\Working Space\FPGA\output\handoff_milestone2_20261008\source\constraints\primer20k_dock3714_usb.cst
Timing Constraint File | E:\Working Space\FPGA\output\handoff_milestone2_20261008\source\constraints\primer20k.sdc
Tool Version | V1.9.11.03 Education
Part Number | GW2A-LV18PG256C8/I7
Device | GW2A-18
Device Version | C
Created Time | Wed Oct 21 12:18:38 2026
Legal Announcement | Copyright (C)2014-2025 Gowin Semiconductor Corporation. All rights reserved.

# Timing Summaries

## STA Tool Run Summary:

Setup Delay Model | Slow 0.95V 85C C8/I7
Hold Delay Model | Fast 1.05V 0C C8/I7
Numbers of Paths Analyzed | 11440
Numbers of Endpoints Analyzed | 11077
Numbers of Falling Endpoints | 0
Numbers of Setup Violated Endpoints | 0
Numbers of Hold Violated Endpoints | 0

## Clock Summary:

NO. | Clock Name | Type | Period | Frequency(MHz) | Rise | Fall | Source | Master | Objects
1 | clk_27m | Base | 37.037 | 27.000 | 0.000 | 18.518 | | | clk_27m

## Max Frequency Summary:

NO. | Clock Name | Constraint | Actual Fmax | Logic Level | Entity
1 | clk_27m | 27.000(MHz) | 31.938(MHz) | 23 | TOP

## Total Negative Slack Summary:

Clock Name | Analysis Type | Endpoints TNS | Number of Endpoints
clk_27m | Setup | 0.000 | 0
clk_27m | Hold | 0.000 | 0

# Timing Details

## Path Slacks Table:

### Setup Paths Table

#### Report Command:report_timing -setup -max_paths 25 -max_common_paths 1

Path Number | Path Slack | From Node | To Node | From Clock | To Clock | Relation | Clock Skew | Data Delay
1 | 5.727 | u_top/u_manual/rd_ptr_0_s0/Q | u_top/u_alloc/v_note_28_s0/CE | clk_27m:[R] | clk_27m:[R] | 37.037 | 0.000 | 31.275
2 | 5.727 | u_top/u_manual/rd_ptr_0_s0/Q | u_top/u_alloc/v_note_30_s0/CE | clk_27m:[R] | clk_27m:[R] | 37.037 | 0.000 | 31.275
3 | 5.727 | u_top/u_manual/rd_ptr_0_s0/Q | u_top/u_alloc/v_note_31_s0/CE | clk_27m:[R] | clk_27m:[R] | 37.037 | 0.000 | 31.275
4 | 5.855 | u_top/u_manual/rd_ptr_0_s0/Q | u_top/u_alloc/v_note_52_s0/CE | clk_27m:[R] | clk_27m:[R] | 37.037 | 0.000 | 31.147
5 | 5.917 | u_top/u_manual/rd_ptr_0_s0/Q | u_top/u_alloc/v_note_32_s0/CE | clk_27m:[R] | clk_27m:[R] | 37.037 | 0.000 | 31.085
6 | 5.917 | u_top/u_manual/rd_ptr_0_s0/Q | u_top/u_alloc/v_note_33_s0/CE | clk_27m:[R] | clk_27m:[R] | 37.037 | 0.000 | 31.085
7 | 5.917 | u_top/u_manual/rd_ptr_0_s0/Q | u_top/u_alloc/v_note_34_s0/CE | clk_27m:[R] | clk_27m:[R] | 37.037 | 0.000 | 31.085
8 | 6.016 | u_top/u_manual/rd_ptr_0_s0/Q | u_top/u_alloc/v_note_0_s0/CE | clk_27m:[R] | clk_27m:[R] | 37.037 | 0.000 | 30.986
9 | 6.016 | u_top/u_manual/rd_ptr_0_s0/Q | u_top/u_alloc/v_note_1_s0/CE | clk_27m:[R] | clk_27m:[R] | 37.037 | 0.000 | 30.986
10 | 6.016 | u_top/u_manual/rd_ptr_0_s0/Q | u_top/u_alloc/v_note_2_s0/CE | clk_27m:[R] | clk_27m:[R] | 37.037 | 0.000 | 30.986
11 | 6.016 | u_top/u_manual/rd_ptr_0_s0/Q | u_top/u_alloc/v_note_3_s0/CE | clk_27m:[R] | clk_27m:[R] | 37.037 | 0.000 | 30.986
12 | 6.016 | u_top/u_manual/rd_ptr_0_s0/Q | u_top/u_alloc/v_note_4_s0/CE | clk_27m:[R] | clk_27m:[R] | 37.037 | 0.000 | 30.986
13 | 6.016 | u_top/u_manual/rd_ptr_0_s0/Q | u_top/u_alloc/v_note_5_s0/CE | clk_27m:[R] | clk_27m:[R] | 37.037 | 0.000 | 30.986
14 | 6.016 | u_top/u_manual/rd_ptr_0_s0/Q | u_top/u_alloc/v_note_6_s0/CE | clk_27m:[R] | clk_27m:[R] | 37.037 | 0.000 | 30.986
15 | 6.032 | u_top/u_manual/rd_ptr_0_s0/Q | u_top/u_alloc/v_note_49_s0/CE | clk_27m:[R] | clk_27m:[R] | 37.037 | 0.000 | 30.970
16 | 6.032 | u_top/u_manual/rd_ptr_0_s0/Q | u_top/u_alloc/v_note_50_s0/CE | clk_27m:[R] | clk_27m:[R] | 37.037 | 0.000 | 30.970
17 | 6.032 | u_top/u_manual/rd_ptr_0_s0/Q | u_top/u_alloc/v_note_51_s0/CE | clk_27m:[R] | clk_27m:[R] | 37.037 | 0.000 | 30.970
18 | 6.032 | u_top/u_manual/rd_ptr_0_s0/Q | u_top/u_alloc/v_note_55_s0/CE | clk_27m:[R] | clk_27m:[R] | 37.037 | 0.000 | 30.970
19 | 6.062 | u_top/u_manual/rd_ptr_0_s0/Q | u_top/u_alloc/v_note_46_s0/CE | clk_27m:[R] | clk_27m:[R] | 37.037 | 0.000 | 30.940
20 | 6.062 | u_top/u_manual/rd_ptr_0_s0/Q | u_top/u_alloc/v_note_47_s0/CE | clk_27m:[R] | clk_27m:[R] | 37.037 | 0.000 | 30.940
21 | 6.062 | u_top/u_manual/rd_ptr_0_s0/Q | u_top/u_alloc/v_note_48_s0/CE | clk_27m:[R] | clk_27m:[R] | 37.037 | 0.000 | 30.940
22 | 6.100 | u_top/u_manual/rd_ptr_0_s0/Q | u_top/u_alloc/v_note_42_s0/CE | clk_27m:[R] | clk_27m:[R] | 37.037 | 0.000 | 30.902
23 | 6.100 | u_top/u_manual/rd_ptr_0_s0/Q | u_top/u_alloc/v_note_43_s0/CE | clk_27m:[R] | clk_27m:[R] | 37.037 | 0.000 | 30.902
24 | 6.100 | u_top/u_manual/rd_ptr_0_s0/Q | u_top/u_alloc/v_note_44_s0/CE | clk_27m:[R] | clk_27m:[R] | 37.037 | 0.000 | 30.902
25 | 6.100 | u_top/u_manual/rd_ptr_0_s0/Q | u_top/u_alloc/v_note_45_s0/CE | clk_27m:[R] | clk_27m:[R] | 37.037 | 0.000 | 30.902

### Hold Paths Table

#### Report Command:report_timing -hold -max_paths 25 -max_common_paths 1

Path Number | Path Slack | From Node | To Node | From Clock | To Clock | Relation | Clock Skew | Data Delay
1 | 0.319 | u_top/u_fifo/wr_ptr_2_s0/Q | u_top/u_fifo/mem_mem_0_3_s/WAD[2] | clk_27m:[R] | clk_27m:[R] | 0.000 | 0.000 | 0.329
2 | 0.319 | u_top/u_fifo/wr_ptr_1_s0/Q | u_top/u_fifo/mem_mem_0_3_s/WAD[1] | clk_27m:[R] | clk_27m:[R] | 0.000 | 0.000 | 0.329
3 | 0.322 | u_top/u_fifo/wr_ptr_3_s0/Q | u_top/u_fifo/mem_mem_0_3_s/WAD[3] | clk_27m:[R] | clk_27m:[R] | 0.000 | 0.000 | 0.332
4 | 0.325 | u_top/g_host_kbd.u_host_kbd/u_map/wptr_3_s0/Q | u_top/g_host_kbd.u_host_kbd/u_map/mem_mem_0_1_s/WAD[3] | clk_27m:[R] | clk_27m:[R] | 0.000 | 0.000 | 0.335
5 | 0.335 | u_top/u_engine/rom_addr_0_s0/Q | u_top/u_engine/g_banked.g_generic.u_bright_rom/u_bank2/AD[4] | clk_27m:[R] | clk_27m:[R] | 0.000 | 0.000 | 0.453
6 | 0.336 | u_top/u_engine/rom_addr_1_s0/Q | u_top/u_engine/g_banked.g_generic.u_bright_rom/u_bank2/AD[5] | clk_27m:[R] | clk_27m:[R] | 0.000 | 0.000 | 0.454
7 | 0.336 | u_top/u_engine/rom_addr_2_s0/Q | u_top/u_engine/u_sine_rom/u_prom/AD[6] | clk_27m:[R] | clk_27m:[R] | 0.000 | 0.000 | 0.454
8 | 0.342 | u_top/u_engine/rom_addr_3_s0/Q | u_top/u_engine/u_sine_rom/u_prom/AD[7] | clk_27m:[R] | clk_27m:[R] | 0.000 | 0.000 | 0.460
9 | 0.346 | u_top/u_engine/rom_addr_7_s0/Q | u_top/u_engine/u_sine_rom/u_prom/AD[11] | clk_27m:[R] | clk_27m:[R] | 0.000 | 0.000 | 0.464
10 | 0.349 | u_top/u_engine/rom_addr_8_s0/Q | u_top/u_engine/g_banked.g_generic.u_bright_rom/u_bank2/AD[12] | clk_27m:[R] | clk_27m:[R] | 0.000 | 0.000 | 0.467
11 | 0.349 | u_top/u_engine/rom_addr_4_s0/Q | u_top/u_engine/g_banked.g_generic.u_bright_rom/u_bank2/AD[8] | clk_27m:[R] | clk_27m:[R] | 0.000 | 0.000 | 0.467
12 | 0.349 | u_top/u_engine/rom_addr_4_s0/Q | u_top/u_engine/u_sine_rom/u_prom/AD[8] | clk_27m:[R] | clk_27m:[R] | 0.000 | 0.000 | 0.467
13 | 0.350 | u_top/u_engine/rom_addr_0_s0/Q | u_top/u_engine/u_sine_rom/u_prom/AD[4] | clk_27m:[R] | clk_27m:[R] | 0.000 | 0.000 | 0.468
14 | 0.350 | u_top/u_engine/rom_addr_5_s0/Q | u_top/u_engine/u_sine_rom/u_prom/AD[9] | clk_27m:[R] | clk_27m:[R] | 0.000 | 0.000 | 0.468
15 | 0.351 | u_top/u_engine/rom_addr_6_s0/Q | u_top/u_engine/u_sine_rom/u_prom/AD[10] | clk_27m:[R] | clk_27m:[R] | 0.000 | 0.000 | 0.469
16 | 0.352 | u_top/u_engine/rom_addr_8_s0/Q | u_top/u_engine/u_sine_rom/u_prom/AD[12] | clk_27m:[R] | clk_27m:[R] | 0.000 | 0.000 | 0.470
17 | 0.359 | u_top/u_engine/rom_addr_0_s0/Q | u_top/u_engine/g_banked.g_generic.g_guitar.u_guitar_rom/gg5/AD[4] | clk_27m:[R] | clk_27m:[R] | 0.000 | 0.000 | 0.477
18 | 0.425 | u_top/g_pt8211.u_pt8211/b_cnt_3_s0/Q | u_top/g_pt8211.u_pt8211/b_cnt_3_s0/D | clk_27m:[R] | clk_27m:[R] | 0.000 | 0.000 | 0.436
19 | 0.425 | u_top/g_pt8211.u_pt8211/div_cnt_0_s0/Q | u_top/g_pt8211.u_pt8211/div_cnt_0_s0/D | clk_27m:[R] | clk_27m:[R] | 0.000 | 0.000 | 0.436
20 | 0.425 | u_top/u_xf/shared_stage_1_s3/Q | u_top/u_xf/shared_stage_1_s3/D | clk_27m:[R] | clk_27m:[R] | 0.000 | 0.000 | 0.436
21 | 0.425 | u_top/u_xf/clip_count_2_s0/Q | u_top/u_xf/clip_count_2_s0/D | clk_27m:[R] | clk_27m:[R] | 0.000 | 0.000 | 0.436
22 | 0.425 | u_top/u_xf/clip_count_6_s0/Q | u_top/u_xf/clip_count_6_s0/D | clk_27m:[R] | clk_27m:[R] | 0.000 | 0.000 | 0.436
23 | 0.425 | u_top/u_xf/clip_count_8_s0/Q | u_top/u_xf/clip_count_8_s0/D | clk_27m:[R] | clk_27m:[R] | 0.000 | 0.000 | 0.436
24 | 0.425 | u_top/u_xf/clip_count_18_s0/Q | u_top/u_xf/clip_count_18_s0/D | clk_27m:[R] | clk_27m:[R] | 0.000 | 0.000 | 0.436
25 | 0.425 | u_top/u_xf/clip_count_20_s0/Q | u_top/u_xf/clip_count_20_s0/D | clk_27m:[R] | clk_27m:[R] | 0.000 | 0.000 | 0.436

### Recovery Paths Table

#### Report Command:report_timing -recovery -max_paths 25 -max_common_paths 1

#### Nothing to report!

### Removal Paths Table

#### Report Command:report_timing -removal -max_paths 25 -max_common_paths 1

#### Nothing to report!

## Minimum Pulse Width Table:

Number | Slack | Actual Width | Required Width | Type | Clock | Objects

#### Report Command:report_min_pulse_width -nworst 10 -detail

1 | 15.833 | 16.833 | 1.000 | Low Pulse Width | clk_27m | u_top/reset_cnt_14_s0
2 | 15.833 | 16.833 | 1.000 | Low Pulse Width | clk_27m | u_top/reset_cnt_12_s0
3 | 15.833 | 16.833 | 1.000 | Low Pulse Width | clk_27m | u_top/reset_cnt_8_s0
4 | 15.833 | 16.833 | 1.000 | Low Pulse Width | clk_27m | u_top/reset_cnt_0_s0
5 | 15.833 | 16.833 | 1.000 | Low Pulse Width | clk_27m | u_top/mel_idx_d_5_s0
6 | 15.833 | 16.833 | 1.000 | Low Pulse Width | clk_27m | u_top/ctrl_div_0_s0
7 | 15.833 | 16.833 | 1.000 | Low Pulse Width | clk_27m | u_top/mix_lp_y_7_s0
8 | 15.833 | 16.833 | 1.000 | Low Pulse Width | clk_27m | u_top/g_host_kbd.u_host_kbd/u_uart/cnt_11_s1
9 | 15.833 | 16.833 | 1.000 | Low Pulse Width | clk_27m | u_top/g_host_kbd.u_host_kbd/u_map/cur_key_cur_key_RAMREG_0_G[3]_s0
10 | 15.833 | 16.833 | 1.000 | Low Pulse Width | clk_27m | u_top/u_uart/reply_count_2_s1

## Timing Report By Analysis Type:

### Setup Analysis Report

#### Report Command:report_timing -setup -max_paths 25 -max_common_paths 1

### Path1

Path Summary:

Slack | 5.727
Data Arrival Time | 35.634
Data Required Time | 41.361
From | u_top/u_manual/rd_ptr_0_s0
To | u_top/u_alloc/v_note_28_s0
Launch Clk | clk_27m:[R]
Latch Clk | clk_27m:[R]

Data Arrival Path:

AT | DELAY | TYPE | RF | FANOUT | LOC | NODE
0.000 | 0.000 | | | | | active clock edge time
0.000 | 0.000 | | | | | clk_27m
0.000 | 0.000 | tCL | RR | 1 | IOT27[A] | clk_27m_ibuf/I
2.088 | 2.088 | tINS | RR | 3750 | IOT27[A] | clk_27m_ibuf/O
4.359 | 2.271 | tNET | RR | 1 | R22C42[0][A] | u_top/u_manual/rd_ptr_0_s0/CLK
4.591 | 0.232 | tC2Q | RF | 7 | R22C42[0][A] | u_top/u_manual/rd_ptr_0_s0/Q
5.488 | 0.897 | tNET | FF | 2 | R16C42[0][A] | u_top/u_manual/n4_s0/I1
6.058 | 0.570 | tINS | FR | 1 | R16C42[0][A] | u_top/u_manual/n4_s0/COUT
6.058 | 0.000 | tNET | RR | 2 | R16C42[0][B] | u_top/u_manual/n5_s0/CIN
6.093 | 0.035 | tINS | RF | 1 | R16C42[0][B] | u_top/u_manual/n5_s0/COUT
6.093 | 0.000 | tNET | FF | 2 | R16C42[1][A] | u_top/u_manual/n6_s0/CIN
6.129 | 0.035 | tINS | FF | 1 | R16C42[1][A] | u_top/u_manual/n6_s0/COUT
6.129 | 0.000 | tNET | FF | 2 | R16C42[1][B] | u_top/u_manual/n7_s0/CIN
6.164 | 0.035 | tINS | FF | 1 | R16C42[1][B] | u_top/u_manual/n7_s0/COUT
6.164 | 0.000 | tNET | FF | 2 | R16C42[2][A] | u_top/u_manual/n8_s0/CIN
6.199 | 0.035 | tINS | FF | 17 | R16C42[2][A] | u_top/u_manual/n8_s0/COUT
6.884 | 0.685 | tNET | FF | 1 | R15C42[3][A] | u_top/ev_word_10_s2/I2
7.401 | 0.517 | tINS | FF | 1 | R15C42[3][A] | u_top/ev_word_10_s2/F
7.891 | 0.490 | tNET | FF | 1 | R15C38[3][A] | u_top/ev_word_10_s1/I1
8.353 | 0.462 | tINS | FR | 6 | R15C38[3][A] | u_top/ev_word_10_s1/F
8.527 | 0.174 | tNET | RR | 1 | R15C37[3][B] | u_top/ev_word_10_s0/I0
8.898 | 0.371 | tINS | RF | 35 | R15C37[3][B] | u_top/ev_word_10_s0/F
13.607 | 4.709 | tNET | FF | 2 | R51C14[1][A] | u_top/u_alloc/n50_s0/I1
14.177 | 0.570 | tINS | FR | 1 | R51C14[1][A] | u_top/u_alloc/n50_s0/COUT
14.177 | 0.000 | tNET | RR | 2 | R51C14[1][B] | u_top/u_alloc/n51_s0/CIN
14.212 | 0.035 | tINS | RF | 1 | R51C14[1][B] | u_top/u_alloc/n51_s0/COUT
14.212 | 0.000 | tNET | FF | 2 | R51C14[2][A] | u_top/u_alloc/n52_s0/CIN
14.247 | 0.035 | tINS | FF | 1 | R51C14[2][A] | u_top/u_alloc/n52_s0/COUT
14.247 | 0.000 | tNET | FF | 2 | R51C14[2][B] | u_top/u_alloc/n53_s0/CIN
14.282 | 0.035 | tINS | FF | 1 | R51C14[2][B] | u_top/u_alloc/n53_s0/COUT
14.282 | 0.000 | tNET | FF | 2 | R51C15[0][A] | u_top/u_alloc/n54_s0/CIN
14.317 | 0.035 | tINS | FF | 3 | R51C15[0][A] | u_top/u_alloc/n54_s0/COUT
16.161 | 1.844 | tNET | FF | 1 | R48C10[3][B] | u_top/u_alloc/pick_0_s44/I0
16.532 | 0.371 | tINS | FF | 3 | R48C10[3][B] | u_top/u_alloc/pick_0_s44/F
16.545 | 0.013 | tNET | FF | 1 | R48C10[2][B] | u_top/u_alloc/pick_0_s21/I3
17.062 | 0.517 | tINS | FF | 2 | R48C10[2][B] | u_top/u_alloc/pick_0_s21/F
17.755 | 0.693 | tNET | FF | 1 | R41C9[3][A] | u_top/u_alloc/pick_0_s9/I3
18.310 | 0.555 | tINS | FF | 3 | R41C9[3][A] | u_top/u_alloc/pick_0_s9/F
19.156 | 0.845 | tNET | FF | 1 | R47C10[3][A] | u_top/u_alloc/pick_0_s23/I2
19.711 | 0.555 | tINS | FF | 7 | R47C10[3][A] | u_top/u_alloc/pick_0_s23/F
20.368 | 0.658 | tNET | FF | 1 | R47C7[0][A] | u_top/u_alloc/pick_0_s49/I1
20.739 | 0.371 | tINS | FF | 4 | R47C7[0][A] | u_top/u_alloc/pick_0_s49/F
21.974 | 1.235 | tNET | FF | 1 | R45C4[1][A] | u_top/u_alloc/pick_2_s100/I0
22.529 | 0.555 | tINS | FF | 1 | R45C4[1][A] | u_top/u_alloc/pick_2_s100/F
22.943 | 0.413 | tNET | FF | 1 | R44C6[3][A] | u_top/u_alloc/pick_2_s80/I3
23.396 | 0.453 | tINS | FF | 3 | R44C6[3][A] | u_top/u_alloc/pick_2_s80/F
23.651 | 0.256 | tNET | FF | 1 | R45C6[3][B] | u_top/u_alloc/pick_2_s43/I2
24.022 | 0.371 | tINS | FF | 2 | R45C6[3][B] | u_top/u_alloc/pick_2_s43/F
24.031 | 0.009 | tNET | FF | 1 | R45C6[3][A] | u_top/u_alloc/pick_2_s18/I1
24.548 | 0.517 | tINS | FF | 2 | R45C6[3][A] | u_top/u_alloc/pick_2_s18/F
25.436 | 0.888 | tNET | FF | 1 | R47C3[1][B] | u_top/u_alloc/pick_2_s9/I0
26.006 | 0.570 | tINS | FR | 2 | R47C3[1][B] | u_top/u_alloc/pick_2_s9/F
26.009 | 0.003 | tNET | RR | 1 | R47C3[1][A] | u_top/u_alloc/pick_2_s2/I3
26.564 | 0.555 | tINS | RF | 4 | R47C3[1][A] | u_top/u_alloc/pick_2_s2/F
26.811 | 0.247 | tNET | FF | 1 | R47C5[0][A] | u_top/u_alloc/pick_0_s0/I0
27.182 | 0.371 | tINS | FF | 29 | R47C5[0][A] | u_top/u_alloc/pick_0_s0/F
29.637 | 2.455 | tNET | FF | 18 | DSP_R37[1][A] | u_top/u_alloc/n453_s1/B[0]
33.277 | 3.640 | tINS | FF | 8 | DSP_R37[1][A] | u_top/u_alloc/n453_s1/DOUT[6]
34.540 | 1.263 | tNET | FF | 1 | R47C17[1][B] | u_top/u_alloc/n3434_s1/I0
35.110 | 0.570 | tINS | FR | 7 | R47C17[1][B] | u_top/u_alloc/n3434_s1/F
35.634 | 0.525 | tNET | RR | 1 | R48C18[2][B] | u_top/u_alloc/v_note_28_s0/CE

Data Required Path:

AT | DELAY | TYPE | RF | FANOUT | LOC | NODE
37.037 | 37.037 | | | | | active clock edge time
37.037 | 0.000 | | | | | clk_27m
37.037 | 0.000 | tCL | RR | 1 | IOT27[A] | clk_27m_ibuf/I
39.125 | 2.088 | tINS | RR | 3750 | IOT27[A] | clk_27m_ibuf/O
41.396 | 2.271 | tNET | RR | 1 | R48C18[2][B] | u_top/u_alloc/v_note_28_s0/CLK
41.361 | -0.035 | tSu | | 1 | R48C18[2][B] | u_top/u_alloc/v_note_28_s0

Path Statistics:

Clock Skew | 0.000
Setup Relationship | 37.037
Logic Level | 23
Arrival Clock Path Delay | cell: 2.088, 47.897%; route: 2.271, 52.103%
Arrival Data Path Delay | cell: 12.743, 40.744%; route: 18.300, 58.514%; tC2Q: 0.232, 0.742%
Required Clock Path Delay | cell: 2.088, 47.897%; route: 2.271, 52.103%

### Path2

Path Summary:

Slack | 5.727
Data Arrival Time | 35.634
Data Required Time | 41.361
From | u_top/u_manual/rd_ptr_0_s0
To | u_top/u_alloc/v_note_30_s0
Launch Clk | clk_27m:[R]
Latch Clk | clk_27m:[R]

Data Arrival Path:

AT | DELAY | TYPE | RF | FANOUT | LOC | NODE
0.000 | 0.000 | | | | | active clock edge time
0.000 | 0.000 | | | | | clk_27m
0.000 | 0.000 | tCL | RR | 1 | IOT27[A] | clk_27m_ibuf/I
2.088 | 2.088 | tINS | RR | 3750 | IOT27[A] | clk_27m_ibuf/O
4.359 | 2.271 | tNET | RR | 1 | R22C42[0][A] | u_top/u_manual/rd_ptr_0_s0/CLK
4.591 | 0.232 | tC2Q | RF | 7 | R22C42[0][A] | u_top/u_manual/rd_ptr_0_s0/Q
5.488 | 0.897 | tNET | FF | 2 | R16C42[0][A] | u_top/u_manual/n4_s0/I1
6.058 | 0.570 | tINS | FR | 1 | R16C42[0][A] | u_top/u_manual/n4_s0/COUT
6.058 | 0.000 | tNET | RR | 2 | R16C42[0][B] | u_top/u_manual/n5_s0/CIN
6.093 | 0.035 | tINS | RF | 1 | R16C42[0][B] | u_top/u_manual/n5_s0/COUT
6.093 | 0.000 | tNET | FF | 2 | R16C42[1][A] | u_top/u_manual/n6_s0/CIN
6.129 | 0.035 | tINS | FF | 1 | R16C42[1][A] | u_top/u_manual/n6_s0/COUT
6.129 | 0.000 | tNET | FF | 2 | R16C42[1][B] | u_top/u_manual/n7_s0/CIN
6.164 | 0.035 | tINS | FF | 1 | R16C42[1][B] | u_top/u_manual/n7_s0/COUT
6.164 | 0.000 | tNET | FF | 2 | R16C42[2][A] | u_top/u_manual/n8_s0/CIN
6.199 | 0.035 | tINS | FF | 17 | R16C42[2][A] | u_top/u_manual/n8_s0/COUT
6.884 | 0.685 | tNET | FF | 1 | R15C42[3][A] | u_top/ev_word_10_s2/I2
7.401 | 0.517 | tINS | FF | 1 | R15C42[3][A] | u_top/ev_word_10_s2/F
7.891 | 0.490 | tNET | FF | 1 | R15C38[3][A] | u_top/ev_word_10_s1/I1
8.353 | 0.462 | tINS | FR | 6 | R15C38[3][A] | u_top/ev_word_10_s1/F
8.527 | 0.174 | tNET | RR | 1 | R15C37[3][B] | u_top/ev_word_10_s0/I0
8.898 | 0.371 | tINS | RF | 35 | R15C37[3][B] | u_top/ev_word_10_s0/F
13.607 | 4.709 | tNET | FF | 2 | R51C14[1][A] | u_top/u_alloc/n50_s0/I1
14.177 | 0.570 | tINS | FR | 1 | R51C14[1][A] | u_top/u_alloc/n50_s0/COUT
14.177 | 0.000 | tNET | RR | 2 | R51C14[1][B] | u_top/u_alloc/n51_s0/CIN
14.212 | 0.035 | tINS | RF | 1 | R51C14[1][B] | u_top/u_alloc/n51_s0/COUT
14.212 | 0.000 | tNET | FF | 2 | R51C14[2][A] | u_top/u_alloc/n52_s0/CIN
14.247 | 0.035 | tINS | FF | 1 | R51C14[2][A] | u_top/u_alloc/n52_s0/COUT
14.247 | 0.000 | tNET | FF | 2 | R51C14[2][B] | u_top/u_alloc/n53_s0/CIN
14.282 | 0.035 | tINS | FF | 1 | R51C14[2][B] | u_top/u_alloc/n53_s0/COUT
14.282 | 0.000 | tNET | FF | 2 | R51C15[0][A] | u_top/u_alloc/n54_s0/CIN
14.317 | 0.035 | tINS | FF | 3 | R51C15[0][A] | u_top/u_alloc/n54_s0/COUT
16.161 | 1.844 | tNET | FF | 1 | R48C10[3][B] | u_top/u_alloc/pick_0_s44/I0
16.532 | 0.371 | tINS | FF | 3 | R48C10[3][B] | u_top/u_alloc/pick_0_s44/F
16.545 | 0.013 | tNET | FF | 1 | R48C10[2][B] | u_top/u_alloc/pick_0_s21/I3
17.062 | 0.517 | tINS | FF | 2 | R48C10[2][B] | u_top/u_alloc/pick_0_s21/F
17.755 | 0.693 | tNET | FF | 1 | R41C9[3][A] | u_top/u_alloc/pick_0_s9/I3
18.310 | 0.555 | tINS | FF | 3 | R41C9[3][A] | u_top/u_alloc/pick_0_s9/F
19.156 | 0.845 | tNET | FF | 1 | R47C10[3][A] | u_top/u_alloc/pick_0_s23/I2
19.711 | 0.555 | tINS | FF | 7 | R47C10[3][A] | u_top/u_alloc/pick_0_s23/F
20.368 | 0.658 | tNET | FF | 1 | R47C7[0][A] | u_top/u_alloc/pick_0_s49/I1
20.739 | 0.371 | tINS | FF | 4 | R47C7[0][A] | u_top/u_alloc/pick_0_s49/F
21.974 | 1.235 | tNET | FF | 1 | R45C4[1][A] | u_top/u_alloc/pick_2_s100/I0
22.529 | 0.555 | tINS | FF | 1 | R45C4[1][A] | u_top/u_alloc/pick_2_s100/F
22.943 | 0.413 | tNET | FF | 1 | R44C6[3][A] | u_top/u_alloc/pick_2_s80/I3
23.396 | 0.453 | tINS | FF | 3 | R44C6[3][A] | u_top/u_alloc/pick_2_s80/F
23.651 | 0.256 | tNET | FF | 1 | R45C6[3][B] | u_top/u_alloc/pick_2_s43/I2
24.022 | 0.371 | tINS | FF | 2 | R45C6[3][B] | u_top/u_alloc/pick_2_s43/F
24.031 | 0.009 | tNET | FF | 1 | R45C6[3][A] | u_top/u_alloc/pick_2_s18/I1
24.548 | 0.517 | tINS | FF | 2 | R45C6[3][A] | u_top/u_alloc/pick_2_s18/F
25.436 | 0.888 | tNET | FF | 1 | R47C3[1][B] | u_top/u_alloc/pick_2_s9/I0
26.006 | 0.570 | tINS | FR | 2 | R47C3[1][B] | u_top/u_alloc/pick_2_s9/F
26.009 | 0.003 | tNET | RR | 1 | R47C3[1][A] | u_top/u_alloc/pick_2_s2/I3
26.564 | 0.555 | tINS | RF | 4 | R47C3[1][A] | u_top/u_alloc/pick_2_s2/F
26.811 | 0.247 | tNET | FF | 1 | R47C5[0][A] | u_top/u_alloc/pick_0_s0/I0
27.182 | 0.371 | tINS | FF | 29 | R47C5[0][A] | u_top/u_alloc/pick_0_s0/F
29.637 | 2.455 | tNET | FF | 18 | DSP_R37[1][A] | u_top/u_alloc/n453_s1/B[0]
33.277 | 3.640 | tINS | FF | 8 | DSP_R37[1][A] | u_top/u_alloc/n453_s1/DOUT[6]
34.540 | 1.263 | tNET | FF | 1 | R47C17[1][B] | u_top/u_alloc/n3434_s1/I0
35.110 | 0.570 | tINS | FR | 7 | R47C17[1][B] | u_top/u_alloc/n3434_s1/F
35.634 | 0.525 | tNET | RR | 1 | R48C18[1][A] | u_top/u_alloc/v_note_30_s0/CE

Data Required Path:

AT | DELAY | TYPE | RF | FANOUT | LOC | NODE
37.037 | 37.037 | | | | | active clock edge time
37.037 | 0.000 | | | | | clk_27m
37.037 | 0.000 | tCL | RR | 1 | IOT27[A] | clk_27m_ibuf/I
39.125 | 2.088 | tINS | RR | 3750 | IOT27[A] | clk_27m_ibuf/O
41.396 | 2.271 | tNET | RR | 1 | R48C18[1][A] | u_top/u_alloc/v_note_30_s0/CLK
41.361 | -0.035 | tSu | | 1 | R48C18[1][A] | u_top/u_alloc/v_note_30_s0

Path Statistics:

Clock Skew | 0.000
Setup Relationship | 37.037
Logic Level | 23
Arrival Clock Path Delay | cell: 2.088, 47.897%; route: 2.271, 52.103%
Arrival Data Path Delay | cell: 12.743, 40.744%; route: 18.300, 58.514%; tC2Q: 0.232, 0.742%
Required Clock Path Delay | cell: 2.088, 47.897%; route: 2.271, 52.103%

### Path3

Path Summary:

Slack | 5.727
Data Arrival Time | 35.634
Data Required Time | 41.361
From | u_top/u_manual/rd_ptr_0_s0
To | u_top/u_alloc/v_note_31_s0
Launch Clk | clk_27m:[R]
Latch Clk | clk_27m:[R]

Data Arrival Path:

AT | DELAY | TYPE | RF | FANOUT | LOC | NODE
0.000 | 0.000 | | | | | active clock edge time
0.000 | 0.000 | | | | | clk_27m
0.000 | 0.000 | tCL | RR | 1 | IOT27[A] | clk_27m_ibuf/I
2.088 | 2.088 | tINS | RR | 3750 | IOT27[A] | clk_27m_ibuf/O
4.359 | 2.271 | tNET | RR | 1 | R22C42[0][A] | u_top/u_manual/rd_ptr_0_s0/CLK
4.591 | 0.232 | tC2Q | RF | 7 | R22C42[0][A] | u_top/u_manual/rd_ptr_0_s0/Q
5.488 | 0.897 | tNET | FF | 2 | R16C42[0][A] | u_top/u_manual/n4_s0/I1
6.058 | 0.570 | tINS | FR | 1 | R16C42[0][A] | u_top/u_manual/n4_s0/COUT
6.058 | 0.000 | tNET | RR | 2 | R16C42[0][B] | u_top/u_manual/n5_s0/CIN
6.093 | 0.035 | tINS | RF | 1 | R16C42[0][B] | u_top/u_manual/n5_s0/COUT
6.093 | 0.000 | tNET | FF | 2 | R16C42[1][A] | u_top/u_manual/n6_s0/CIN
6.129 | 0.035 | tINS | FF | 1 | R16C42[1][A] | u_top/u_manual/n6_s0/COUT
6.129 | 0.000 | tNET | FF | 2 | R16C42[1][B] | u_top/u_manual/n7_s0/CIN
6.164 | 0.035 | tINS | FF | 1 | R16C42[1][B] | u_top/u_manual/n7_s0/COUT
6.164 | 0.000 | tNET | FF | 2 | R16C42[2][A] | u_top/u_manual/n8_s0/CIN
6.199 | 0.035 | tINS | FF | 17 | R16C42[2][A] | u_top/u_manual/n8_s0/COUT
6.884 | 0.685 | tNET | FF | 1 | R15C42[3][A] | u_top/ev_word_10_s2/I2
7.401 | 0.517 | tINS | FF | 1 | R15C42[3][A] | u_top/ev_word_10_s2/F
7.891 | 0.490 | tNET | FF | 1 | R15C38[3][A] | u_top/ev_word_10_s1/I1
8.353 | 0.462 | tINS | FR | 6 | R15C38[3][A] | u_top/ev_word_10_s1/F
8.527 | 0.174 | tNET | RR | 1 | R15C37[3][B] | u_top/ev_word_10_s0/I0
8.898 | 0.371 | tINS | RF | 35 | R15C37[3][B] | u_top/ev_word_10_s0/F
13.607 | 4.709 | tNET | FF | 2 | R51C14[1][A] | u_top/u_alloc/n50_s0/I1
14.177 | 0.570 | tINS | FR | 1 | R51C14[1][A] | u_top/u_alloc/n50_s0/COUT
14.177 | 0.000 | tNET | RR | 2 | R51C14[1][B] | u_top/u_alloc/n51_s0/CIN
14.212 | 0.035 | tINS | RF | 1 | R51C14[1][B] | u_top/u_alloc/n51_s0/COUT
14.212 | 0.000 | tNET | FF | 2 | R51C14[2][A] | u_top/u_alloc/n52_s0/CIN
14.247 | 0.035 | tINS | FF | 1 | R51C14[2][A] | u_top/u_alloc/n52_s0/COUT
14.247 | 0.000 | tNET | FF | 2 | R51C14[2][B] | u_top/u_alloc/n53_s0/CIN
14.282 | 0.035 | tINS | FF | 1 | R51C14[2][B] | u_top/u_alloc/n53_s0/COUT
14.282 | 0.000 | tNET | FF | 2 | R51C15[0][A] | u_top/u_alloc/n54_s0/CIN
14.317 | 0.035 | tINS | FF | 3 | R51C15[0][A] | u_top/u_alloc/n54_s0/COUT
16.161 | 1.844 | tNET | FF | 1 | R48C10[3][B] | u_top/u_alloc/pick_0_s44/I0
16.532 | 0.371 | tINS | FF | 3 | R48C10[3][B] | u_top/u_alloc/pick_0_s44/F
16.545 | 0.013 | tNET | FF | 1 | R48C10[2][B] | u_top/u_alloc/pick_0_s21/I3
17.062 | 0.517 | tINS | FF | 2 | R48C10[2][B] | u_top/u_alloc/pick_0_s21/F
17.755 | 0.693 | tNET | FF | 1 | R41C9[3][A] | u_top/u_alloc/pick_0_s9/I3
18.310 | 0.555 | tINS | FF | 3 | R41C9[3][A] | u_top/u_alloc/pick_0_s9/F
19.156 | 0.845 | tNET | FF | 1 | R47C10[3][A] | u_top/u_alloc/pick_0_s23/I2
19.711 | 0.555 | tINS | FF | 7 | R47C10[3][A] | u_top/u_alloc/pick_0_s23/F
20.368 | 0.658 | tNET | FF | 1 | R47C7[0][A] | u_top/u_alloc/pick_0_s49/I1
20.739 | 0.371 | tINS | FF | 4 | R47C7[0][A] | u_top/u_alloc/pick_0_s49/F
21.974 | 1.235 | tNET | FF | 1 | R45C4[1][A] | u_top/u_alloc/pick_2_s100/I0
22.529 | 0.555 | tINS | FF | 1 | R45C4[1][A] | u_top/u_alloc/pick_2_s100/F
22.943 | 0.413 | tNET | FF | 1 | R44C6[3][A] | u_top/u_alloc/pick_2_s80/I3
23.396 | 0.453 | tINS | FF | 3 | R44C6[3][A] | u_top/u_alloc/pick_2_s80/F
23.651 | 0.256 | tNET | FF | 1 | R45C6[3][B] | u_top/u_alloc/pick_2_s43/I2
24.022 | 0.371 | tINS | FF | 2 | R45C6[3][B] | u_top/u_alloc/pick_2_s43/F
24.031 | 0.009 | tNET | FF | 1 | R45C6[3][A] | u_top/u_alloc/pick_2_s18/I1
24.548 | 0.517 | tINS | FF | 2 | R45C6[3][A] | u_top/u_alloc/pick_2_s18/F
25.436 | 0.888 | tNET | FF | 1 | R47C3[1][B] | u_top/u_alloc/pick_2_s9/I0
26.006 | 0.570 | tINS | FR | 2 | R47C3[1][B] | u_top/u_alloc/pick_2_s9/F
26.009 | 0.003 | tNET | RR | 1 | R47C3[1][A] | u_top/u_alloc/pick_2_s2/I3
26.564 | 0.555 | tINS | RF | 4 | R47C3[1][A] | u_top/u_alloc/pick_2_s2/F
26.811 | 0.247 | tNET | FF | 1 | R47C5[0][A] | u_top/u_alloc/pick_0_s0/I0
27.182 | 0.371 | tINS | FF | 29 | R47C5[0][A] | u_top/u_alloc/pick_0_s0/F
29.637 | 2.455 | tNET | FF | 18 | DSP_R37[1][A] | u_top/u_alloc/n453_s1/B[0]
33.277 | 3.640 | tINS | FF | 8 | DSP_R37[1][A] | u_top/u_alloc/n453_s1/DOUT[6]
34.540 | 1.263 | tNET | FF | 1 | R47C17[1][B] | u_top/u_alloc/n3434_s1/I0
35.110 | 0.570 | tINS | FR | 7 | R47C17[1][B] | u_top/u_alloc/n3434_s1/F
35.634 | 0.525 | tNET | RR | 1 | R48C18[0][A] | u_top/u_alloc/v_note_31_s0/CE

Data Required Path:

AT | DELAY | TYPE | RF | FANOUT | LOC | NODE
37.037 | 37.037 | | | | | active clock edge time
37.037 | 0.000 | | | | | clk_27m
37.037 | 0.000 | tCL | RR | 1 | IOT27[A] | clk_27m_ibuf/I
39.125 | 2.088 | tINS | RR | 3750 | IOT27[A] | clk_27m_ibuf/O
41.396 | 2.271 | tNET | RR | 1 | R48C18[0][A] | u_top/u_alloc/v_note_31_s0/CLK
41.361 | -0.035 | tSu | | 1 | R48C18[0][A] | u_top/u_alloc/v_note_31_s0

Path Statistics:

Clock Skew | 0.000
Setup Relationship | 37.037
Logic Level | 23
Arrival Clock Path Delay | cell: 2.088, 47.897%; route: 2.271, 52.103%
Arrival Data Path Delay | cell: 12.743, 40.744%; route: 18.300, 58.514%; tC2Q: 0.232, 0.742%
Required Clock Path Delay | cell: 2.088, 47.897%; route: 2.271, 52.103%

### Path4

Path Summary:

Slack | 5.855
Data Arrival Time | 35.507
Data Required Time | 41.361
From | u_top/u_manual/rd_ptr_0_s0
To | u_top/u_alloc/v_note_52_s0
Launch Clk | clk_27m:[R]
Latch Clk | clk_27m:[R]

Data Arrival Path:

AT | DELAY | TYPE | RF | FANOUT | LOC | NODE
0.000 | 0.000 | | | | | active clock edge time
0.000 | 0.000 | | | | | clk_27m
0.000 | 0.000 | tCL | RR | 1 | IOT27[A] | clk_27m_ibuf/I
2.088 | 2.088 | tINS | RR | 3750 | IOT27[A] | clk_27m_ibuf/O
4.359 | 2.271 | tNET | RR | 1 | R22C42[0][A] | u_top/u_manual/rd_ptr_0_s0/CLK
4.591 | 0.232 | tC2Q | RF | 7 | R22C42[0][A] | u_top/u_manual/rd_ptr_0_s0/Q
5.488 | 0.897 | tNET | FF | 2 | R16C42[0][A] | u_top/u_manual/n4_s0/I1
6.058 | 0.570 | tINS | FR | 1 | R16C42[0][A] | u_top/u_manual/n4_s0/COUT
6.058 | 0.000 | tNET | RR | 2 | R16C42[0][B] | u_top/u_manual/n5_s0/CIN
6.093 | 0.035 | tINS | RF | 1 | R16C42[0][B] | u_top/u_manual/n5_s0/COUT
6.093 | 0.000 | tNET | FF | 2 | R16C42[1][A] | u_top/u_manual/n6_s0/CIN
6.129 | 0.035 | tINS | FF | 1 | R16C42[1][A] | u_top/u_manual/n6_s0/COUT
6.129 | 0.000 | tNET | FF | 2 | R16C42[1][B] | u_top/u_manual/n7_s0/CIN
6.164 | 0.035 | tINS | FF | 1 | R16C42[1][B] | u_top/u_manual/n7_s0/COUT
6.164 | 0.000 | tNET | FF | 2 | R16C42[2][A] | u_top/u_manual/n8_s0/CIN
6.199 | 0.035 | tINS | FF | 17 | R16C42[2][A] | u_top/u_manual/n8_s0/COUT
6.884 | 0.685 | tNET | FF | 1 | R15C42[3][A] | u_top/ev_word_10_s2/I2
7.401 | 0.517 | tINS | FF | 1 | R15C42[3][A] | u_top/ev_word_10_s2/F
7.891 | 0.490 | tNET | FF | 1 | R15C38[3][A] | u_top/ev_word_10_s1/I1
8.353 | 0.462 | tINS | FR | 6 | R15C38[3][A] | u_top/ev_word_10_s1/F
8.527 | 0.174 | tNET | RR | 1 | R15C37[3][B] | u_top/ev_word_10_s0/I0
8.898 | 0.371 | tINS | RF | 35 | R15C37[3][B] | u_top/ev_word_10_s0/F
13.607 | 4.709 | tNET | FF | 2 | R51C14[1][A] | u_top/u_alloc/n50_s0/I1
14.177 | 0.570 | tINS | FR | 1 | R51C14[1][A] | u_top/u_alloc/n50_s0/COUT
14.177 | 0.000 | tNET | RR | 2 | R51C14[1][B] | u_top/u_alloc/n51_s0/CIN
14.212 | 0.035 | tINS | RF | 1 | R51C14[1][B] | u_top/u_alloc/n51_s0/COUT
14.212 | 0.000 | tNET | FF | 2 | R51C14[2][A] | u_top/u_alloc/n52_s0/CIN
14.247 | 0.035 | tINS | FF | 1 | R51C14[2][A] | u_top/u_alloc/n52_s0/COUT
14.247 | 0.000 | tNET | FF | 2 | R51C14[2][B] | u_top/u_alloc/n53_s0/CIN
14.282 | 0.035 | tINS | FF | 1 | R51C14[2][B] | u_top/u_alloc/n53_s0/COUT
14.282 | 0.000 | tNET | FF | 2 | R51C15[0][A] | u_top/u_alloc/n54_s0/CIN
14.317 | 0.035 | tINS | FF | 3 | R51C15[0][A] | u_top/u_alloc/n54_s0/COUT
16.161 | 1.844 | tNET | FF | 1 | R48C10[3][B] | u_top/u_alloc/pick_0_s44/I0
16.532 | 0.371 | tINS | FF | 3 | R48C10[3][B] | u_top/u_alloc/pick_0_s44/F
16.545 | 0.013 | tNET | FF | 1 | R48C10[2][B] | u_top/u_alloc/pick_0_s21/I3
17.062 | 0.517 | tINS | FF | 2 | R48C10[2][B] | u_top/u_alloc/pick_0_s21/F
17.755 | 0.693 | tNET | FF | 1 | R41C9[3][A] | u_top/u_alloc/pick_0_s9/I3
18.310 | 0.555 | tINS | FF | 3 | R41C9[3][A] | u_top/u_alloc/pick_0_s9/F
19.156 | 0.845 | tNET | FF | 1 | R47C10[3][A] | u_top/u_alloc/pick_0_s23/I2
19.711 | 0.555 | tINS | FF | 7 | R47C10[3][A] | u_top/u_alloc/pick_0_s23/F
20.368 | 0.658 | tNET | FF | 1 | R47C7[0][A] | u_top/u_alloc/pick_0_s49/I1
20.739 | 0.371 | tINS | FF | 4 | R47C7[0][A] | u_top/u_alloc/pick_0_s49/F
21.974 | 1.235 | tNET | FF | 1 | R45C4[1][A] | u_top/u_alloc/pick_2_s100/I0
22.529 | 0.555 | tINS | FF | 1 | R45C4[1][A] | u_top/u_alloc/pick_2_s100/F
22.943 | 0.413 | tNET | FF | 1 | R44C6[3][A] | u_top/u_alloc/pick_2_s80/I3
23.396 | 0.453 | tINS | FF | 3 | R44C6[3][A] | u_top/u_alloc/pick_2_s80/F
23.651 | 0.256 | tNET | FF | 1 | R45C6[3][B] | u_top/u_alloc/pick_2_s43/I2
24.022 | 0.371 | tINS | FF | 2 | R45C6[3][B] | u_top/u_alloc/pick_2_s43/F
24.031 | 0.009 | tNET | FF | 1 | R45C6[3][A] | u_top/u_alloc/pick_2_s18/I1
24.548 | 0.517 | tINS | FF | 2 | R45C6[3][A] | u_top/u_alloc/pick_2_s18/F
25.436 | 0.888 | tNET | FF | 1 | R47C3[1][B] | u_top/u_alloc/pick_2_s9/I0
26.006 | 0.570 | tINS | FR | 2 | R47C3[1][B] | u_top/u_alloc/pick_2_s9/F
26.009 | 0.003 | tNET | RR | 1 | R47C3[1][A] | u_top/u_alloc/pick_2_s2/I3
26.564 | 0.555 | tINS | RF | 4 | R47C3[1][A] | u_top/u_alloc/pick_2_s2/F
26.811 | 0.247 | tNET | FF | 1 | R47C5[0][A] | u_top/u_alloc/pick_0_s0/I0
27.182 | 0.371 | tINS | FF | 29 | R47C5[0][A] | u_top/u_alloc/pick_0_s0/F
29.637 | 2.455 | tNET | FF | 18 | DSP_R37[1][A] | u_top/u_alloc/n453_s1/B[0]
33.277 | 3.640 | tINS | FF | 8 | DSP_R37[1][A] | u_top/u_alloc/n453_s1/DOUT[6]
34.441 | 1.164 | tNET | FF | 1 | R47C15[3][A] | u_top/u_alloc/n3392_s2/I0
34.990 | 0.549 | tINS | FR | 7 | R47C15[3][A] | u_top/u_alloc/n3392_s2/F
35.507 | 0.517 | tNET | RR | 1 | R48C16[0][A] | u_top/u_alloc/v_note_52_s0/CE

Data Required Path:

AT | DELAY | TYPE | RF | FANOUT | LOC | NODE
37.037 | 37.037 | | | | | active clock edge time
37.037 | 0.000 | | | | | clk_27m
37.037 | 0.000 | tCL | RR | 1 | IOT27[A] | clk_27m_ibuf/I
39.125 | 2.088 | tINS | RR | 3750 | IOT27[A] | clk_27m_ibuf/O
41.396 | 2.271 | tNET | RR | 1 | R48C16[0][A] | u_top/u_alloc/v_note_52_s0/CLK
41.361 | -0.035 | tSu | | 1 | R48C16[0][A] | u_top/u_alloc/v_note_52_s0

Path Statistics:

Clock Skew | 0.000
Setup Relationship | 37.037
Logic Level | 23
Arrival Clock Path Delay | cell: 2.088, 47.897%; route: 2.271, 52.103%
Arrival Data Path Delay | cell: 12.722, 40.843%; route: 18.194, 58.412%; tC2Q: 0.232, 0.745%
Required Clock Path Delay | cell: 2.088, 47.897%; route: 2.271, 52.103%

### Path5

Path Summary:

Slack | 5.917
Data Arrival Time | 35.445
Data Required Time | 41.361
From | u_top/u_manual/rd_ptr_0_s0
To | u_top/u_alloc/v_note_32_s0
Launch Clk | clk_27m:[R]
Latch Clk | clk_27m:[R]

Data Arrival Path:

AT | DELAY | TYPE | RF | FANOUT | LOC | NODE
0.000 | 0.000 | | | | | active clock edge time
0.000 | 0.000 | | | | | clk_27m
0.000 | 0.000 | tCL | RR | 1 | IOT27[A] | clk_27m_ibuf/I
2.088 | 2.088 | tINS | RR | 3750 | IOT27[A] | clk_27m_ibuf/O
4.359 | 2.271 | tNET | RR | 1 | R22C42[0][A] | u_top/u_manual/rd_ptr_0_s0/CLK
4.591 | 0.232 | tC2Q | RF | 7 | R22C42[0][A] | u_top/u_manual/rd_ptr_0_s0/Q
5.488 | 0.897 | tNET | FF | 2 | R16C42[0][A] | u_top/u_manual/n4_s0/I1
6.058 | 0.570 | tINS | FR | 1 | R16C42[0][A] | u_top/u_manual/n4_s0/COUT
6.058 | 0.000 | tNET | RR | 2 | R16C42[0][B] | u_top/u_manual/n5_s0/CIN
6.093 | 0.035 | tINS | RF | 1 | R16C42[0][B] | u_top/u_manual/n5_s0/COUT
6.093 | 0.000 | tNET | FF | 2 | R16C42[1][A] | u_top/u_manual/n6_s0/CIN
6.129 | 0.035 | tINS | FF | 1 | R16C42[1][A] | u_top/u_manual/n6_s0/COUT
6.129 | 0.000 | tNET | FF | 2 | R16C42[1][B] | u_top/u_manual/n7_s0/CIN
6.164 | 0.035 | tINS | FF | 1 | R16C42[1][B] | u_top/u_manual/n7_s0/COUT
6.164 | 0.000 | tNET | FF | 2 | R16C42[2][A] | u_top/u_manual/n8_s0/CIN
6.199 | 0.035 | tINS | FF | 17 | R16C42[2][A] | u_top/u_manual/n8_s0/COUT
6.884 | 0.685 | tNET | FF | 1 | R15C42[3][A] | u_top/ev_word_10_s2/I2
7.401 | 0.517 | tINS | FF | 1 | R15C42[3][A] | u_top/ev_word_10_s2/F
7.891 | 0.490 | tNET | FF | 1 | R15C38[3][A] | u_top/ev_word_10_s1/I1
8.353 | 0.462 | tINS | FR | 6 | R15C38[3][A] | u_top/ev_word_10_s1/F
8.527 | 0.174 | tNET | RR | 1 | R15C37[3][B] | u_top/ev_word_10_s0/I0
8.898 | 0.371 | tINS | RF | 35 | R15C37[3][B] | u_top/ev_word_10_s0/F
13.607 | 4.709 | tNET | FF | 2 | R51C14[1][A] | u_top/u_alloc/n50_s0/I1
14.177 | 0.570 | tINS | FR | 1 | R51C14[1][A] | u_top/u_alloc/n50_s0/COUT
14.177 | 0.000 | tNET | RR | 2 | R51C14[1][B] | u_top/u_alloc/n51_s0/CIN
14.212 | 0.035 | tINS | RF | 1 | R51C14[1][B] | u_top/u_alloc/n51_s0/COUT
14.212 | 0.000 | tNET | FF | 2 | R51C14[2][A] | u_top/u_alloc/n52_s0/CIN
14.247 | 0.035 | tINS | FF | 1 | R51C14[2][A] | u_top/u_alloc/n52_s0/COUT
14.247 | 0.000 | tNET | FF | 2 | R51C14[2][B] | u_top/u_alloc/n53_s0/CIN
14.282 | 0.035 | tINS | FF | 1 | R51C14[2][B] | u_top/u_alloc/n53_s0/COUT
14.282 | 0.000 | tNET | FF | 2 | R51C15[0][A] | u_top/u_alloc/n54_s0/CIN
14.317 | 0.035 | tINS | FF | 3 | R51C15[0][A] | u_top/u_alloc/n54_s0/COUT
16.161 | 1.844 | tNET | FF | 1 | R48C10[3][B] | u_top/u_alloc/pick_0_s44/I0
16.532 | 0.371 | tINS | FF | 3 | R48C10[3][B] | u_top/u_alloc/pick_0_s44/F
16.545 | 0.013 | tNET | FF | 1 | R48C10[2][B] | u_top/u_alloc/pick_0_s21/I3
17.062 | 0.517 | tINS | FF | 2 | R48C10[2][B] | u_top/u_alloc/pick_0_s21/F
17.755 | 0.693 | tNET | FF | 1 | R41C9[3][A] | u_top/u_alloc/pick_0_s9/I3
18.310 | 0.555 | tINS | FF | 3 | R41C9[3][A] | u_top/u_alloc/pick_0_s9/F
19.156 | 0.845 | tNET | FF | 1 | R47C10[3][A] | u_top/u_alloc/pick_0_s23/I2
19.711 | 0.555 | tINS | FF | 7 | R47C10[3][A] | u_top/u_alloc/pick_0_s23/F
20.368 | 0.658 | tNET | FF | 1 | R47C7[0][A] | u_top/u_alloc/pick_0_s49/I1
20.739 | 0.371 | tINS | FF | 4 | R47C7[0][A] | u_top/u_alloc/pick_0_s49/F
21.974 | 1.235 | tNET | FF | 1 | R45C4[1][A] | u_top/u_alloc/pick_2_s100/I0
22.529 | 0.555 | tINS | FF | 1 | R45C4[1][A] | u_top/u_alloc/pick_2_s100/F
22.943 | 0.413 | tNET | FF | 1 | R44C6[3][A] | u_top/u_alloc/pick_2_s80/I3
23.396 | 0.453 | tINS | FF | 3 | R44C6[3][A] | u_top/u_alloc/pick_2_s80/F
23.651 | 0.256 | tNET | FF | 1 | R45C6[3][B] | u_top/u_alloc/pick_2_s43/I2
24.022 | 0.371 | tINS | FF | 2 | R45C6[3][B] | u_top/u_alloc/pick_2_s43/F
24.031 | 0.009 | tNET | FF | 1 | R45C6[3][A] | u_top/u_alloc/pick_2_s18/I1
24.548 | 0.517 | tINS | FF | 2 | R45C6[3][A] | u_top/u_alloc/pick_2_s18/F
25.436 | 0.888 | tNET | FF | 1 | R47C3[1][B] | u_top/u_alloc/pick_2_s9/I0
26.006 | 0.570 | tINS | FR | 2 | R47C3[1][B] | u_top/u_alloc/pick_2_s9/F
26.009 | 0.003 | tNET | RR | 1 | R47C3[1][A] | u_top/u_alloc/pick_2_s2/I3
26.564 | 0.555 | tINS | RF | 4 | R47C3[1][A] | u_top/u_alloc/pick_2_s2/F
26.811 | 0.247 | tNET | FF | 1 | R47C5[0][A] | u_top/u_alloc/pick_0_s0/I0
27.182 | 0.371 | tINS | FF | 29 | R47C5[0][A] | u_top/u_alloc/pick_0_s0/F
29.637 | 2.455 | tNET | FF | 18 | DSP_R37[1][A] | u_top/u_alloc/n453_s1/B[0]
33.277 | 3.640 | tINS | FF | 8 | DSP_R37[1][A] | u_top/u_alloc/n453_s1/DOUT[6]
34.540 | 1.263 | tNET | FF | 1 | R47C17[1][B] | u_top/u_alloc/n3434_s1/I0
35.110 | 0.570 | tINS | FR | 7 | R47C17[1][B] | u_top/u_alloc/n3434_s1/F
35.445 | 0.335 | tNET | RR | 1 | R47C19[2][B] | u_top/u_alloc/v_note_32_s0/CE

Data Required Path:

AT | DELAY | TYPE | RF | FANOUT | LOC | NODE
37.037 | 37.037 | | | | | active clock edge time
37.037 | 0.000 | | | | | clk_27m
37.037 | 0.000 | tCL | RR | 1 | IOT27[A] | clk_27m_ibuf/I
39.125 | 2.088 | tINS | RR | 3750 | IOT27[A] | clk_27m_ibuf/O
41.396 | 2.271 | tNET | RR | 1 | R47C19[2][B] | u_top/u_alloc/v_note_32_s0/CLK
41.361 | -0.035 | tSu | | 1 | R47C19[2][B] | u_top/u_alloc/v_note_32_s0

Path Statistics:

Clock Skew | 0.000
Setup Relationship | 37.037
Logic Level | 23
Arrival Clock Path Delay | cell: 2.088, 47.897%; route: 2.271, 52.103%
Arrival Data Path Delay | cell: 12.743, 40.992%; route: 18.111, 58.261%; tC2Q: 0.232, 0.746%
Required Clock Path Delay | cell: 2.088, 47.897%; route: 2.271, 52.103%

### Path6

Path Summary:

Slack | 5.917
Data Arrival Time | 35.445
Data Required Time | 41.361
From | u_top/u_manual/rd_ptr_0_s0
To | u_top/u_alloc/v_note_33_s0
Launch Clk | clk_27m:[R]
Latch Clk | clk_27m:[R]

Data Arrival Path:

AT | DELAY | TYPE | RF | FANOUT | LOC | NODE
0.000 | 0.000 | | | | | active clock edge time
0.000 | 0.000 | | | | | clk_27m
0.000 | 0.000 | tCL | RR | 1 | IOT27[A] | clk_27m_ibuf/I
2.088 | 2.088 | tINS | RR | 3750 | IOT27[A] | clk_27m_ibuf/O
4.359 | 2.271 | tNET | RR | 1 | R22C42[0][A] | u_top/u_manual/rd_ptr_0_s0/CLK
4.591 | 0.232 | tC2Q | RF | 7 | R22C42[0][A] | u_top/u_manual/rd_ptr_0_s0/Q
5.488 | 0.897 | tNET | FF | 2 | R16C42[0][A] | u_top/u_manual/n4_s0/I1
6.058 | 0.570 | tINS | FR | 1 | R16C42[0][A] | u_top/u_manual/n4_s0/COUT
6.058 | 0.000 | tNET | RR | 2 | R16C42[0][B] | u_top/u_manual/n5_s0/CIN
6.093 | 0.035 | tINS | RF | 1 | R16C42[0][B] | u_top/u_manual/n5_s0/COUT
6.093 | 0.000 | tNET | FF | 2 | R16C42[1][A] | u_top/u_manual/n6_s0/CIN
6.129 | 0.035 | tINS | FF | 1 | R16C42[1][A] | u_top/u_manual/n6_s0/COUT
6.129 | 0.000 | tNET | FF | 2 | R16C42[1][B] | u_top/u_manual/n7_s0/CIN
6.164 | 0.035 | tINS | FF | 1 | R16C42[1][B] | u_top/u_manual/n7_s0/COUT
6.164 | 0.000 | tNET | FF | 2 | R16C42[2][A] | u_top/u_manual/n8_s0/CIN
6.199 | 0.035 | tINS | FF | 17 | R16C42[2][A] | u_top/u_manual/n8_s0/COUT
6.884 | 0.685 | tNET | FF | 1 | R15C42[3][A] | u_top/ev_word_10_s2/I2
7.401 | 0.517 | tINS | FF | 1 | R15C42[3][A] | u_top/ev_word_10_s2/F
7.891 | 0.490 | tNET | FF | 1 | R15C38[3][A] | u_top/ev_word_10_s1/I1
8.353 | 0.462 | tINS | FR | 6 | R15C38[3][A] | u_top/ev_word_10_s1/F
8.527 | 0.174 | tNET | RR | 1 | R15C37[3][B] | u_top/ev_word_10_s0/I0
8.898 | 0.371 | tINS | RF | 35 | R15C37[3][B] | u_top/ev_word_10_s0/F
13.607 | 4.709 | tNET | FF | 2 | R51C14[1][A] | u_top/u_alloc/n50_s0/I1
14.177 | 0.570 | tINS | FR | 1 | R51C14[1][A] | u_top/u_alloc/n50_s0/COUT
14.177 | 0.000 | tNET | RR | 2 | R51C14[1][B] | u_top/u_alloc/n51_s0/CIN
14.212 | 0.035 | tINS | RF | 1 | R51C14[1][B] | u_top/u_alloc/n51_s0/COUT
14.212 | 0.000 | tNET | FF | 2 | R51C14[2][A] | u_top/u_alloc/n52_s0/CIN
14.247 | 0.035 | tINS | FF | 1 | R51C14[2][A] | u_top/u_alloc/n52_s0/COUT
14.247 | 0.000 | tNET | FF | 2 | R51C14[2][B] | u_top/u_alloc/n53_s0/CIN
14.282 | 0.035 | tINS | FF | 1 | R51C14[2][B] | u_top/u_alloc/n53_s0/COUT
14.282 | 0.000 | tNET | FF | 2 | R51C15[0][A] | u_top/u_alloc/n54_s0/CIN
14.317 | 0.035 | tINS | FF | 3 | R51C15[0][A] | u_top/u_alloc/n54_s0/COUT
16.161 | 1.844 | tNET | FF | 1 | R48C10[3][B] | u_top/u_alloc/pick_0_s44/I0
16.532 | 0.371 | tINS | FF | 3 | R48C10[3][B] | u_top/u_alloc/pick_0_s44/F
16.545 | 0.013 | tNET | FF | 1 | R48C10[2][B] | u_top/u_alloc/pick_0_s21/I3
17.062 | 0.517 | tINS | FF | 2 | R48C10[2][B] | u_top/u_alloc/pick_0_s21/F
17.755 | 0.693 | tNET | FF | 1 | R41C9[3][A] | u_top/u_alloc/pick_0_s9/I3
18.310 | 0.555 | tINS | FF | 3 | R41C9[3][A] | u_top/u_alloc/pick_0_s9/F
19.156 | 0.845 | tNET | FF | 1 | R47C10[3][A] | u_top/u_alloc/pick_0_s23/I2
19.711 | 0.555 | tINS | FF | 7 | R47C10[3][A] | u_top/u_alloc/pick_0_s23/F
20.368 | 0.658 | tNET | FF | 1 | R47C7[0][A] | u_top/u_alloc/pick_0_s49/I1
20.739 | 0.371 | tINS | FF | 4 | R47C7[0][A] | u_top/u_alloc/pick_0_s49/F
21.974 | 1.235 | tNET | FF | 1 | R45C4[1][A] | u_top/u_alloc/pick_2_s100/I0
22.529 | 0.555 | tINS | FF | 1 | R45C4[1][A] | u_top/u_alloc/pick_2_s100/F
22.943 | 0.413 | tNET | FF | 1 | R44C6[3][A] | u_top/u_alloc/pick_2_s80/I3
23.396 | 0.453 | tINS | FF | 3 | R44C6[3][A] | u_top/u_alloc/pick_2_s80/F
23.651 | 0.256 | tNET | FF | 1 | R45C6[3][B] | u_top/u_alloc/pick_2_s43/I2
24.022 | 0.371 | tINS | FF | 2 | R45C6[3][B] | u_top/u_alloc/pick_2_s43/F
24.031 | 0.009 | tNET | FF | 1 | R45C6[3][A] | u_top/u_alloc/pick_2_s18/I1
24.548 | 0.517 | tINS | FF | 2 | R45C6[3][A] | u_top/u_alloc/pick_2_s18/F
25.436 | 0.888 | tNET | FF | 1 | R47C3[1][B] | u_top/u_alloc/pick_2_s9/I0
26.006 | 0.570 | tINS | FR | 2 | R47C3[1][B] | u_top/u_alloc/pick_2_s9/F
26.009 | 0.003 | tNET | RR | 1 | R47C3[1][A] | u_top/u_alloc/pick_2_s2/I3
26.564 | 0.555 | tINS | RF | 4 | R47C3[1][A] | u_top/u_alloc/pick_2_s2/F
26.811 | 0.247 | tNET | FF | 1 | R47C5[0][A] | u_top/u_alloc/pick_0_s0/I0
27.182 | 0.371 | tINS | FF | 29 | R47C5[0][A] | u_top/u_alloc/pick_0_s0/F
29.637 | 2.455 | tNET | FF | 18 | DSP_R37[1][A] | u_top/u_alloc/n453_s1/B[0]
33.277 | 3.640 | tINS | FF | 8 | DSP_R37[1][A] | u_top/u_alloc/n453_s1/DOUT[6]
34.540 | 1.263 | tNET | FF | 1 | R47C17[1][B] | u_top/u_alloc/n3434_s1/I0
35.110 | 0.570 | tINS | FR | 7 | R47C17[1][B] | u_top/u_alloc/n3434_s1/F
35.445 | 0.335 | tNET | RR | 1 | R47C19[2][A] | u_top/u_alloc/v_note_33_s0/CE

Data Required Path:

AT | DELAY | TYPE | RF | FANOUT | LOC | NODE
37.037 | 37.037 | | | | | active clock edge time
37.037 | 0.000 | | | | | clk_27m
37.037 | 0.000 | tCL | RR | 1 | IOT27[A] | clk_27m_ibuf/I
39.125 | 2.088 | tINS | RR | 3750 | IOT27[A] | clk_27m_ibuf/O
41.396 | 2.271 | tNET | RR | 1 | R47C19[2][A] | u_top/u_alloc/v_note_33_s0/CLK
41.361 | -0.035 | tSu | | 1 | R47C19[2][A] | u_top/u_alloc/v_note_33_s0

Path Statistics:

Clock Skew | 0.000
Setup Relationship | 37.037
Logic Level | 23
Arrival Clock Path Delay | cell: 2.088, 47.897%; route: 2.271, 52.103%
Arrival Data Path Delay | cell: 12.743, 40.992%; route: 18.111, 58.261%; tC2Q: 0.232, 0.746%
Required Clock Path Delay | cell: 2.088, 47.897%; route: 2.271, 52.103%

### Path7

Path Summary:

Slack | 5.917
Data Arrival Time | 35.445
Data Required Time | 41.361
From | u_top/u_manual/rd_ptr_0_s0
To | u_top/u_alloc/v_note_34_s0
Launch Clk | clk_27m:[R]
Latch Clk | clk_27m:[R]

Data Arrival Path:

AT | DELAY | TYPE | RF | FANOUT | LOC | NODE
0.000 | 0.000 | | | | | active clock edge time
0.000 | 0.000 | | | | | clk_27m
0.000 | 0.000 | tCL | RR | 1 | IOT27[A] | clk_27m_ibuf/I
2.088 | 2.088 | tINS | RR | 3750 | IOT27[A] | clk_27m_ibuf/O
4.359 | 2.271 | tNET | RR | 1 | R22C42[0][A] | u_top/u_manual/rd_ptr_0_s0/CLK
4.591 | 0.232 | tC2Q | RF | 7 | R22C42[0][A] | u_top/u_manual/rd_ptr_0_s0/Q
5.488 | 0.897 | tNET | FF | 2 | R16C42[0][A] | u_top/u_manual/n4_s0/I1
6.058 | 0.570 | tINS | FR | 1 | R16C42[0][A] | u_top/u_manual/n4_s0/COUT
6.058 | 0.000 | tNET | RR | 2 | R16C42[0][B] | u_top/u_manual/n5_s0/CIN
6.093 | 0.035 | tINS | RF | 1 | R16C42[0][B] | u_top/u_manual/n5_s0/COUT
6.093 | 0.000 | tNET | FF | 2 | R16C42[1][A] | u_top/u_manual/n6_s0/CIN
6.129 | 0.035 | tINS | FF | 1 | R16C42[1][A] | u_top/u_manual/n6_s0/COUT
6.129 | 0.000 | tNET | FF | 2 | R16C42[1][B] | u_top/u_manual/n7_s0/CIN
6.164 | 0.035 | tINS | FF | 1 | R16C42[1][B] | u_top/u_manual/n7_s0/COUT
6.164 | 0.000 | tNET | FF | 2 | R16C42[2][A] | u_top/u_manual/n8_s0/CIN
6.199 | 0.035 | tINS | FF | 17 | R16C42[2][A] | u_top/u_manual/n8_s0/COUT
6.884 | 0.685 | tNET | FF | 1 | R15C42[3][A] | u_top/ev_word_10_s2/I2
7.401 | 0.517 | tINS | FF | 1 | R15C42[3][A] | u_top/ev_word_10_s2/F
7.891 | 0.490 | tNET | FF | 1 | R15C38[3][A] | u_top/ev_word_10_s1/I1
8.353 | 0.462 | tINS | FR | 6 | R15C38[3][A] | u_top/ev_word_10_s1/F
8.527 | 0.174 | tNET | RR | 1 | R15C37[3][B] | u_top/ev_word_10_s0/I0
8.898 | 0.371 | tINS | RF | 35 | R15C37[3][B] | u_top/ev_word_10_s0/F
13.607 | 4.709 | tNET | FF | 2 | R51C14[1][A] | u_top/u_alloc/n50_s0/I1
14.177 | 0.570 | tINS | FR | 1 | R51C14[1][A] | u_top/u_alloc/n50_s0/COUT
14.177 | 0.000 | tNET | RR | 2 | R51C14[1][B] | u_top/u_alloc/n51_s0/CIN
14.212 | 0.035 | tINS | RF | 1 | R51C14[1][B] | u_top/u_alloc/n51_s0/COUT
14.212 | 0.000 | tNET | FF | 2 | R51C14[2][A] | u_top/u_alloc/n52_s0/CIN
14.247 | 0.035 | tINS | FF | 1 | R51C14[2][A] | u_top/u_alloc/n52_s0/COUT
14.247 | 0.000 | tNET | FF | 2 | R51C14[2][B] | u_top/u_alloc/n53_s0/CIN
14.282 | 0.035 | tINS | FF | 1 | R51C14[2][B] | u_top/u_alloc/n53_s0/COUT
14.282 | 0.000 | tNET | FF | 2 | R51C15[0][A] | u_top/u_alloc/n54_s0/CIN
14.317 | 0.035 | tINS | FF | 3 | R51C15[0][A] | u_top/u_alloc/n54_s0/COUT
16.161 | 1.844 | tNET | FF | 1 | R48C10[3][B] | u_top/u_alloc/pick_0_s44/I0
16.532 | 0.371 | tINS | FF | 3 | R48C10[3][B] | u_top/u_alloc/pick_0_s44/F
16.545 | 0.013 | tNET | FF | 1 | R48C10[2][B] | u_top/u_alloc/pick_0_s21/I3
17.062 | 0.517 | tINS | FF | 2 | R48C10[2][B] | u_top/u_alloc/pick_0_s21/F
17.755 | 0.693 | tNET | FF | 1 | R41C9[3][A] | u_top/u_alloc/pick_0_s9/I3
18.310 | 0.555 | tINS | FF | 3 | R41C9[3][A] | u_top/u_alloc/pick_0_s9/F
19.156 | 0.845 | tNET | FF | 1 | R47C10[3][A] | u_top/u_alloc/pick_0_s23/I2
19.711 | 0.555 | tINS | FF | 7 | R47C10[3][A] | u_top/u_alloc/pick_0_s23/F
20.368 | 0.658 | tNET | FF | 1 | R47C7[0][A] | u_top/u_alloc/pick_0_s49/I1
20.739 | 0.371 | tINS | FF | 4 | R47C7[0][A] | u_top/u_alloc/pick_0_s49/F
21.974 | 1.235 | tNET | FF | 1 | R45C4[1][A] | u_top/u_alloc/pick_2_s100/I0
22.529 | 0.555 | tINS | FF | 1 | R45C4[1][A] | u_top/u_alloc/pick_2_s100/F
22.943 | 0.413 | tNET | FF | 1 | R44C6[3][A] | u_top/u_alloc/pick_2_s80/I3
23.396 | 0.453 | tINS | FF | 3 | R44C6[3][A] | u_top/u_alloc/pick_2_s80/F
23.651 | 0.256 | tNET | FF | 1 | R45C6[3][B] | u_top/u_alloc/pick_2_s43/I2
24.022 | 0.371 | tINS | FF | 2 | R45C6[3][B] | u_top/u_alloc/pick_2_s43/F
24.031 | 0.009 | tNET | FF | 1 | R45C6[3][A] | u_top/u_alloc/pick_2_s18/I1
24.548 | 0.517 | tINS | FF | 2 | R45C6[3][A] | u_top/u_alloc/pick_2_s18/F
25.436 | 0.888 | tNET | FF | 1 | R47C3[1][B] | u_top/u_alloc/pick_2_s9/I0
26.006 | 0.570 | tINS | FR | 2 | R47C3[1][B] | u_top/u_alloc/pick_2_s9/F
26.009 | 0.003 | tNET | RR | 1 | R47C3[1][A] | u_top/u_alloc/pick_2_s2/I3
26.564 | 0.555 | tINS | RF | 4 | R47C3[1][A] | u_top/u_alloc/pick_2_s2/F
26.811 | 0.247 | tNET | FF | 1 | R47C5[0][A] | u_top/u_alloc/pick_0_s0/I0
27.182 | 0.371 | tINS | FF | 29 | R47C5[0][A] | u_top/u_alloc/pick_0_s0/F
29.637 | 2.455 | tNET | FF | 18 | DSP_R37[1][A] | u_top/u_alloc/n453_s1/B[0]
33.277 | 3.640 | tINS | FF | 8 | DSP_R37[1][A] | u_top/u_alloc/n453_s1/DOUT[6]
34.540 | 1.263 | tNET | FF | 1 | R47C17[1][B] | u_top/u_alloc/n3434_s1/I0
35.110 | 0.570 | tINS | FR | 7 | R47C17[1][B] | u_top/u_alloc/n3434_s1/F
35.445 | 0.335 | tNET | RR | 1 | R47C19[1][B] | u_top/u_alloc/v_note_34_s0/CE

Data Required Path:

AT | DELAY | TYPE | RF | FANOUT | LOC | NODE
37.037 | 37.037 | | | | | active clock edge time
37.037 | 0.000 | | | | | clk_27m
37.037 | 0.000 | tCL | RR | 1 | IOT27[A] | clk_27m_ibuf/I
39.125 | 2.088 | tINS | RR | 3750 | IOT27[A] | clk_27m_ibuf/O
41.396 | 2.271 | tNET | RR | 1 | R47C19[1][B] | u_top/u_alloc/v_note_34_s0/CLK
41.361 | -0.035 | tSu | | 1 | R47C19[1][B] | u_top/u_alloc/v_note_34_s0

Path Statistics:

Clock Skew | 0.000
Setup Relationship | 37.037
Logic Level | 23
Arrival Clock Path Delay | cell: 2.088, 47.897%; route: 2.271, 52.103%
Arrival Data Path Delay | cell: 12.743, 40.992%; route: 18.111, 58.261%; tC2Q: 0.232, 0.746%
Required Clock Path Delay | cell: 2.088, 47.897%; route: 2.271, 52.103%

### Path8

Path Summary:

Slack | 6.016
Data Arrival Time | 35.346
Data Required Time | 41.361
From | u_top/u_manual/rd_ptr_0_s0
To | u_top/u_alloc/v_note_0_s0
Launch Clk | clk_27m:[R]
Latch Clk | clk_27m:[R]

Data Arrival Path:

AT | DELAY | TYPE | RF | FANOUT | LOC | NODE
0.000 | 0.000 | | | | | active clock edge time
0.000 | 0.000 | | | | | clk_27m
0.000 | 0.000 | tCL | RR | 1 | IOT27[A] | clk_27m_ibuf/I
2.088 | 2.088 | tINS | RR | 3750 | IOT27[A] | clk_27m_ibuf/O
4.359 | 2.271 | tNET | RR | 1 | R22C42[0][A] | u_top/u_manual/rd_ptr_0_s0/CLK
4.591 | 0.232 | tC2Q | RF | 7 | R22C42[0][A] | u_top/u_manual/rd_ptr_0_s0/Q
5.488 | 0.897 | tNET | FF | 2 | R16C42[0][A] | u_top/u_manual/n4_s0/I1
6.058 | 0.570 | tINS | FR | 1 | R16C42[0][A] | u_top/u_manual/n4_s0/COUT
6.058 | 0.000 | tNET | RR | 2 | R16C42[0][B] | u_top/u_manual/n5_s0/CIN
6.093 | 0.035 | tINS | RF | 1 | R16C42[0][B] | u_top/u_manual/n5_s0/COUT
6.093 | 0.000 | tNET | FF | 2 | R16C42[1][A] | u_top/u_manual/n6_s0/CIN
6.129 | 0.035 | tINS | FF | 1 | R16C42[1][A] | u_top/u_manual/n6_s0/COUT
6.129 | 0.000 | tNET | FF | 2 | R16C42[1][B] | u_top/u_manual/n7_s0/CIN
6.164 | 0.035 | tINS | FF | 1 | R16C42[1][B] | u_top/u_manual/n7_s0/COUT
6.164 | 0.000 | tNET | FF | 2 | R16C42[2][A] | u_top/u_manual/n8_s0/CIN
6.199 | 0.035 | tINS | FF | 17 | R16C42[2][A] | u_top/u_manual/n8_s0/COUT
6.884 | 0.685 | tNET | FF | 1 | R15C42[3][A] | u_top/ev_word_10_s2/I2
7.401 | 0.517 | tINS | FF | 1 | R15C42[3][A] | u_top/ev_word_10_s2/F
7.891 | 0.490 | tNET | FF | 1 | R15C38[3][A] | u_top/ev_word_10_s1/I1
8.353 | 0.462 | tINS | FR | 6 | R15C38[3][A] | u_top/ev_word_10_s1/F
8.527 | 0.174 | tNET | RR | 1 | R15C37[3][B] | u_top/ev_word_10_s0/I0
8.898 | 0.371 | tINS | RF | 35 | R15C37[3][B] | u_top/ev_word_10_s0/F
13.607 | 4.709 | tNET | FF | 2 | R51C14[1][A] | u_top/u_alloc/n50_s0/I1
14.177 | 0.570 | tINS | FR | 1 | R51C14[1][A] | u_top/u_alloc/n50_s0/COUT
14.177 | 0.000 | tNET | RR | 2 | R51C14[1][B] | u_top/u_alloc/n51_s0/CIN
14.212 | 0.035 | tINS | RF | 1 | R51C14[1][B] | u_top/u_alloc/n51_s0/COUT
14.212 | 0.000 | tNET | FF | 2 | R51C14[2][A] | u_top/u_alloc/n52_s0/CIN
14.247 | 0.035 | tINS | FF | 1 | R51C14[2][A] | u_top/u_alloc/n52_s0/COUT
14.247 | 0.000 | tNET | FF | 2 | R51C14[2][B] | u_top/u_alloc/n53_s0/CIN
14.282 | 0.035 | tINS | FF | 1 | R51C14[2][B] | u_top/u_alloc/n53_s0/COUT
14.282 | 0.000 | tNET | FF | 2 | R51C15[0][A] | u_top/u_alloc/n54_s0/CIN
14.317 | 0.035 | tINS | FF | 3 | R51C15[0][A] | u_top/u_alloc/n54_s0/COUT
16.161 | 1.844 | tNET | FF | 1 | R48C10[3][B] | u_top/u_alloc/pick_0_s44/I0
16.532 | 0.371 | tINS | FF | 3 | R48C10[3][B] | u_top/u_alloc/pick_0_s44/F
16.545 | 0.013 | tNET | FF | 1 | R48C10[2][B] | u_top/u_alloc/pick_0_s21/I3
17.062 | 0.517 | tINS | FF | 2 | R48C10[2][B] | u_top/u_alloc/pick_0_s21/F
17.755 | 0.693 | tNET | FF | 1 | R41C9[3][A] | u_top/u_alloc/pick_0_s9/I3
18.310 | 0.555 | tINS | FF | 3 | R41C9[3][A] | u_top/u_alloc/pick_0_s9/F
19.156 | 0.845 | tNET | FF | 1 | R47C10[3][A] | u_top/u_alloc/pick_0_s23/I2
19.711 | 0.555 | tINS | FF | 7 | R47C10[3][A] | u_top/u_alloc/pick_0_s23/F
20.368 | 0.658 | tNET | FF | 1 | R47C7[0][A] | u_top/u_alloc/pick_0_s49/I1
20.739 | 0.371 | tINS | FF | 4 | R47C7[0][A] | u_top/u_alloc/pick_0_s49/F
21.974 | 1.235 | tNET | FF | 1 | R45C4[1][A] | u_top/u_alloc/pick_2_s100/I0
22.529 | 0.555 | tINS | FF | 1 | R45C4[1][A] | u_top/u_alloc/pick_2_s100/F
22.943 | 0.413 | tNET | FF | 1 | R44C6[3][A] | u_top/u_alloc/pick_2_s80/I3
23.396 | 0.453 | tINS | FF | 3 | R44C6[3][A] | u_top/u_alloc/pick_2_s80/F
23.651 | 0.256 | tNET | FF | 1 | R45C6[3][B] | u_top/u_alloc/pick_2_s43/I2
24.022 | 0.371 | tINS | FF | 2 | R45C6[3][B] | u_top/u_alloc/pick_2_s43/F
24.031 | 0.009 | tNET | FF | 1 | R45C6[3][A] | u_top/u_alloc/pick_2_s18/I1
24.548 | 0.517 | tINS | FF | 2 | R45C6[3][A] | u_top/u_alloc/pick_2_s18/F
25.436 | 0.888 | tNET | FF | 1 | R47C3[1][B] | u_top/u_alloc/pick_2_s9/I0
26.006 | 0.570 | tINS | FR | 2 | R47C3[1][B] | u_top/u_alloc/pick_2_s9/F
26.009 | 0.003 | tNET | RR | 1 | R47C3[1][A] | u_top/u_alloc/pick_2_s2/I3
26.564 | 0.555 | tINS | RF | 4 | R47C3[1][A] | u_top/u_alloc/pick_2_s2/F
26.811 | 0.247 | tNET | FF | 1 | R47C5[0][A] | u_top/u_alloc/pick_0_s0/I0
27.182 | 0.371 | tINS | FF | 29 | R47C5[0][A] | u_top/u_alloc/pick_0_s0/F
29.637 | 2.455 | tNET | FF | 18 | DSP_R37[1][A] | u_top/u_alloc/n453_s1/B[0]
33.277 | 3.640 | tINS | FF | 8 | DSP_R37[1][A] | u_top/u_alloc/n453_s1/DOUT[6]
34.049 | 0.771 | tNET | FF | 1 | R47C13[3][B] | u_top/u_alloc/n3490_s1/I0
34.619 | 0.570 | tINS | FR | 7 | R47C13[3][B] | u_top/u_alloc/n3490_s1/F
35.346 | 0.727 | tNET | RR | 1 | R47C12[1][A] | u_top/u_alloc/v_note_0_s0/CE

Data Required Path:

AT | DELAY | TYPE | RF | FANOUT | LOC | NODE
37.037 | 37.037 | | | | | active clock edge time
37.037 | 0.000 | | | | | clk_27m
37.037 | 0.000 | tCL | RR | 1 | IOT27[A] | clk_27m_ibuf/I
39.125 | 2.088 | tINS | RR | 3750 | IOT27[A] | clk_27m_ibuf/O
41.396 | 2.271 | tNET | RR | 1 | R47C12[1][A] | u_top/u_alloc/v_note_0_s0/CLK
41.361 | -0.035 | tSu | | 1 | R47C12[1][A] | u_top/u_alloc/v_note_0_s0

Path Statistics:

Clock Skew | 0.000
Setup Relationship | 37.037
Logic Level | 23
Arrival Clock Path Delay | cell: 2.088, 47.897%; route: 2.271, 52.103%
Arrival Data Path Delay | cell: 12.743, 41.123%; route: 18.012, 58.128%; tC2Q: 0.232, 0.749%
Required Clock Path Delay | cell: 2.088, 47.897%; route: 2.271, 52.103%

### Path9

Path Summary:

Slack | 6.016
Data Arrival Time | 35.346
Data Required Time | 41.361
From | u_top/u_manual/rd_ptr_0_s0
To | u_top/u_alloc/v_note_1_s0
Launch Clk | clk_27m:[R]
Latch Clk | clk_27m:[R]

Data Arrival Path:

AT | DELAY | TYPE | RF | FANOUT | LOC | NODE
0.000 | 0.000 | | | | | active clock edge time
0.000 | 0.000 | | | | | clk_27m
0.000 | 0.000 | tCL | RR | 1 | IOT27[A] | clk_27m_ibuf/I
2.088 | 2.088 | tINS | RR | 3750 | IOT27[A] | clk_27m_ibuf/O
4.359 | 2.271 | tNET | RR | 1 | R22C42[0][A] | u_top/u_manual/rd_ptr_0_s0/CLK
4.591 | 0.232 | tC2Q | RF | 7 | R22C42[0][A] | u_top/u_manual/rd_ptr_0_s0/Q
5.488 | 0.897 | tNET | FF | 2 | R16C42[0][A] | u_top/u_manual/n4_s0/I1
6.058 | 0.570 | tINS | FR | 1 | R16C42[0][A] | u_top/u_manual/n4_s0/COUT
6.058 | 0.000 | tNET | RR | 2 | R16C42[0][B] | u_top/u_manual/n5_s0/CIN
6.093 | 0.035 | tINS | RF | 1 | R16C42[0][B] | u_top/u_manual/n5_s0/COUT
6.093 | 0.000 | tNET | FF | 2 | R16C42[1][A] | u_top/u_manual/n6_s0/CIN
6.129 | 0.035 | tINS | FF | 1 | R16C42[1][A] | u_top/u_manual/n6_s0/COUT
6.129 | 0.000 | tNET | FF | 2 | R16C42[1][B] | u_top/u_manual/n7_s0/CIN
6.164 | 0.035 | tINS | FF | 1 | R16C42[1][B] | u_top/u_manual/n7_s0/COUT
6.164 | 0.000 | tNET | FF | 2 | R16C42[2][A] | u_top/u_manual/n8_s0/CIN
6.199 | 0.035 | tINS | FF | 17 | R16C42[2][A] | u_top/u_manual/n8_s0/COUT
6.884 | 0.685 | tNET | FF | 1 | R15C42[3][A] | u_top/ev_word_10_s2/I2
7.401 | 0.517 | tINS | FF | 1 | R15C42[3][A] | u_top/ev_word_10_s2/F
7.891 | 0.490 | tNET | FF | 1 | R15C38[3][A] | u_top/ev_word_10_s1/I1
8.353 | 0.462 | tINS | FR | 6 | R15C38[3][A] | u_top/ev_word_10_s1/F
8.527 | 0.174 | tNET | RR | 1 | R15C37[3][B] | u_top/ev_word_10_s0/I0
8.898 | 0.371 | tINS | RF | 35 | R15C37[3][B] | u_top/ev_word_10_s0/F
13.607 | 4.709 | tNET | FF | 2 | R51C14[1][A] | u_top/u_alloc/n50_s0/I1
14.177 | 0.570 | tINS | FR | 1 | R51C14[1][A] | u_top/u_alloc/n50_s0/COUT
14.177 | 0.000 | tNET | RR | 2 | R51C14[1][B] | u_top/u_alloc/n51_s0/CIN
14.212 | 0.035 | tINS | RF | 1 | R51C14[1][B] | u_top/u_alloc/n51_s0/COUT
14.212 | 0.000 | tNET | FF | 2 | R51C14[2][A] | u_top/u_alloc/n52_s0/CIN
14.247 | 0.035 | tINS | FF | 1 | R51C14[2][A] | u_top/u_alloc/n52_s0/COUT
14.247 | 0.000 | tNET | FF | 2 | R51C14[2][B] | u_top/u_alloc/n53_s0/CIN
14.282 | 0.035 | tINS | FF | 1 | R51C14[2][B] | u_top/u_alloc/n53_s0/COUT
14.282 | 0.000 | tNET | FF | 2 | R51C15[0][A] | u_top/u_alloc/n54_s0/CIN
14.317 | 0.035 | tINS | FF | 3 | R51C15[0][A] | u_top/u_alloc/n54_s0/COUT
16.161 | 1.844 | tNET | FF | 1 | R48C10[3][B] | u_top/u_alloc/pick_0_s44/I0
16.532 | 0.371 | tINS | FF | 3 | R48C10[3][B] | u_top/u_alloc/pick_0_s44/F
16.545 | 0.013 | tNET | FF | 1 | R48C10[2][B] | u_top/u_alloc/pick_0_s21/I3
17.062 | 0.517 | tINS | FF | 2 | R48C10[2][B] | u_top/u_alloc/pick_0_s21/F
17.755 | 0.693 | tNET | FF | 1 | R41C9[3][A] | u_top/u_alloc/pick_0_s9/I3
18.310 | 0.555 | tINS | FF | 3 | R41C9[3][A] | u_top/u_alloc/pick_0_s9/F
19.156 | 0.845 | tNET | FF | 1 | R47C10[3][A] | u_top/u_alloc/pick_0_s23/I2
19.711 | 0.555 | tINS | FF | 7 | R47C10[3][A] | u_top/u_alloc/pick_0_s23/F
20.368 | 0.658 | tNET | FF | 1 | R47C7[0][A] | u_top/u_alloc/pick_0_s49/I1
20.739 | 0.371 | tINS | FF | 4 | R47C7[0][A] | u_top/u_alloc/pick_0_s49/F
21.974 | 1.235 | tNET | FF | 1 | R45C4[1][A] | u_top/u_alloc/pick_2_s100/I0
22.529 | 0.555 | tINS | FF | 1 | R45C4[1][A] | u_top/u_alloc/pick_2_s100/F
22.943 | 0.413 | tNET | FF | 1 | R44C6[3][A] | u_top/u_alloc/pick_2_s80/I3
23.396 | 0.453 | tINS | FF | 3 | R44C6[3][A] | u_top/u_alloc/pick_2_s80/F
23.651 | 0.256 | tNET | FF | 1 | R45C6[3][B] | u_top/u_alloc/pick_2_s43/I2
24.022 | 0.371 | tINS | FF | 2 | R45C6[3][B] | u_top/u_alloc/pick_2_s43/F
24.031 | 0.009 | tNET | FF | 1 | R45C6[3][A] | u_top/u_alloc/pick_2_s18/I1
24.548 | 0.517 | tINS | FF | 2 | R45C6[3][A] | u_top/u_alloc/pick_2_s18/F
25.436 | 0.888 | tNET | FF | 1 | R47C3[1][B] | u_top/u_alloc/pick_2_s9/I0
26.006 | 0.570 | tINS | FR | 2 | R47C3[1][B] | u_top/u_alloc/pick_2_s9/F
26.009 | 0.003 | tNET | RR | 1 | R47C3[1][A] | u_top/u_alloc/pick_2_s2/I3
26.564 | 0.555 | tINS | RF | 4 | R47C3[1][A] | u_top/u_alloc/pick_2_s2/F
26.811 | 0.247 | tNET | FF | 1 | R47C5[0][A] | u_top/u_alloc/pick_0_s0/I0
27.182 | 0.371 | tINS | FF | 29 | R47C5[0][A] | u_top/u_alloc/pick_0_s0/F
29.637 | 2.455 | tNET | FF | 18 | DSP_R37[1][A] | u_top/u_alloc/n453_s1/B[0]
33.277 | 3.640 | tINS | FF | 8 | DSP_R37[1][A] | u_top/u_alloc/n453_s1/DOUT[6]
34.049 | 0.771 | tNET | FF | 1 | R47C13[3][B] | u_top/u_alloc/n3490_s1/I0
34.619 | 0.570 | tINS | FR | 7 | R47C13[3][B] | u_top/u_alloc/n3490_s1/F
35.346 | 0.727 | tNET | RR | 1 | R47C13[0][A] | u_top/u_alloc/v_note_1_s0/CE

Data Required Path:

AT | DELAY | TYPE | RF | FANOUT | LOC | NODE
37.037 | 37.037 | | | | | active clock edge time
37.037 | 0.000 | | | | | clk_27m
37.037 | 0.000 | tCL | RR | 1 | IOT27[A] | clk_27m_ibuf/I
39.125 | 2.088 | tINS | RR | 3750 | IOT27[A] | clk_27m_ibuf/O
41.396 | 2.271 | tNET | RR | 1 | R47C13[0][A] | u_top/u_alloc/v_note_1_s0/CLK
41.361 | -0.035 | tSu | | 1 | R47C13[0][A] | u_top/u_alloc/v_note_1_s0

Path Statistics:

Clock Skew | 0.000
Setup Relationship | 37.037
Logic Level | 23
Arrival Clock Path Delay | cell: 2.088, 47.897%; route: 2.271, 52.103%
Arrival Data Path Delay | cell: 12.743, 41.123%; route: 18.012, 58.128%; tC2Q: 0.232, 0.749%
Required Clock Path Delay | cell: 2.088, 47.897%; route: 2.271, 52.103%

### Path10

Path Summary:

Slack | 6.016
Data Arrival Time | 35.346
Data Required Time | 41.361
From | u_top/u_manual/rd_ptr_0_s0
To | u_top/u_alloc/v_note_2_s0
Launch Clk | clk_27m:[R]
Latch Clk | clk_27m:[R]

Data Arrival Path:

AT | DELAY | TYPE | RF | FANOUT | LOC | NODE
0.000 | 0.000 | | | | | active clock edge time
0.000 | 0.000 | | | | | clk_27m
0.000 | 0.000 | tCL | RR | 1 | IOT27[A] | clk_27m_ibuf/I
2.088 | 2.088 | tINS | RR | 3750 | IOT27[A] | clk_27m_ibuf/O
4.359 | 2.271 | tNET | RR | 1 | R22C42[0][A] | u_top/u_manual/rd_ptr_0_s0/CLK
4.591 | 0.232 | tC2Q | RF | 7 | R22C42[0][A] | u_top/u_manual/rd_ptr_0_s0/Q
5.488 | 0.897 | tNET | FF | 2 | R16C42[0][A] | u_top/u_manual/n4_s0/I1
6.058 | 0.570 | tINS | FR | 1 | R16C42[0][A] | u_top/u_manual/n4_s0/COUT
6.058 | 0.000 | tNET | RR | 2 | R16C42[0][B] | u_top/u_manual/n5_s0/CIN
6.093 | 0.035 | tINS | RF | 1 | R16C42[0][B] | u_top/u_manual/n5_s0/COUT
6.093 | 0.000 | tNET | FF | 2 | R16C42[1][A] | u_top/u_manual/n6_s0/CIN
6.129 | 0.035 | tINS | FF | 1 | R16C42[1][A] | u_top/u_manual/n6_s0/COUT
6.129 | 0.000 | tNET | FF | 2 | R16C42[1][B] | u_top/u_manual/n7_s0/CIN
6.164 | 0.035 | tINS | FF | 1 | R16C42[1][B] | u_top/u_manual/n7_s0/COUT
6.164 | 0.000 | tNET | FF | 2 | R16C42[2][A] | u_top/u_manual/n8_s0/CIN
6.199 | 0.035 | tINS | FF | 17 | R16C42[2][A] | u_top/u_manual/n8_s0/COUT
6.884 | 0.685 | tNET | FF | 1 | R15C42[3][A] | u_top/ev_word_10_s2/I2
7.401 | 0.517 | tINS | FF | 1 | R15C42[3][A] | u_top/ev_word_10_s2/F
7.891 | 0.490 | tNET | FF | 1 | R15C38[3][A] | u_top/ev_word_10_s1/I1
8.353 | 0.462 | tINS | FR | 6 | R15C38[3][A] | u_top/ev_word_10_s1/F
8.527 | 0.174 | tNET | RR | 1 | R15C37[3][B] | u_top/ev_word_10_s0/I0
8.898 | 0.371 | tINS | RF | 35 | R15C37[3][B] | u_top/ev_word_10_s0/F
13.607 | 4.709 | tNET | FF | 2 | R51C14[1][A] | u_top/u_alloc/n50_s0/I1
14.177 | 0.570 | tINS | FR | 1 | R51C14[1][A] | u_top/u_alloc/n50_s0/COUT
14.177 | 0.000 | tNET | RR | 2 | R51C14[1][B] | u_top/u_alloc/n51_s0/CIN
14.212 | 0.035 | tINS | RF | 1 | R51C14[1][B] | u_top/u_alloc/n51_s0/COUT
14.212 | 0.000 | tNET | FF | 2 | R51C14[2][A] | u_top/u_alloc/n52_s0/CIN
14.247 | 0.035 | tINS | FF | 1 | R51C14[2][A] | u_top/u_alloc/n52_s0/COUT
14.247 | 0.000 | tNET | FF | 2 | R51C14[2][B] | u_top/u_alloc/n53_s0/CIN
14.282 | 0.035 | tINS | FF | 1 | R51C14[2][B] | u_top/u_alloc/n53_s0/COUT
14.282 | 0.000 | tNET | FF | 2 | R51C15[0][A] | u_top/u_alloc/n54_s0/CIN
14.317 | 0.035 | tINS | FF | 3 | R51C15[0][A] | u_top/u_alloc/n54_s0/COUT
16.161 | 1.844 | tNET | FF | 1 | R48C10[3][B] | u_top/u_alloc/pick_0_s44/I0
16.532 | 0.371 | tINS | FF | 3 | R48C10[3][B] | u_top/u_alloc/pick_0_s44/F
16.545 | 0.013 | tNET | FF | 1 | R48C10[2][B] | u_top/u_alloc/pick_0_s21/I3
17.062 | 0.517 | tINS | FF | 2 | R48C10[2][B] | u_top/u_alloc/pick_0_s21/F
17.755 | 0.693 | tNET | FF | 1 | R41C9[3][A] | u_top/u_alloc/pick_0_s9/I3
18.310 | 0.555 | tINS | FF | 3 | R41C9[3][A] | u_top/u_alloc/pick_0_s9/F
19.156 | 0.845 | tNET | FF | 1 | R47C10[3][A] | u_top/u_alloc/pick_0_s23/I2
19.711 | 0.555 | tINS | FF | 7 | R47C10[3][A] | u_top/u_alloc/pick_0_s23/F
20.368 | 0.658 | tNET | FF | 1 | R47C7[0][A] | u_top/u_alloc/pick_0_s49/I1
20.739 | 0.371 | tINS | FF | 4 | R47C7[0][A] | u_top/u_alloc/pick_0_s49/F
21.974 | 1.235 | tNET | FF | 1 | R45C4[1][A] | u_top/u_alloc/pick_2_s100/I0
22.529 | 0.555 | tINS | FF | 1 | R45C4[1][A] | u_top/u_alloc/pick_2_s100/F
22.943 | 0.413 | tNET | FF | 1 | R44C6[3][A] | u_top/u_alloc/pick_2_s80/I3
23.396 | 0.453 | tINS | FF | 3 | R44C6[3][A] | u_top/u_alloc/pick_2_s80/F
23.651 | 0.256 | tNET | FF | 1 | R45C6[3][B] | u_top/u_alloc/pick_2_s43/I2
24.022 | 0.371 | tINS | FF | 2 | R45C6[3][B] | u_top/u_alloc/pick_2_s43/F
24.031 | 0.009 | tNET | FF | 1 | R45C6[3][A] | u_top/u_alloc/pick_2_s18/I1
24.548 | 0.517 | tINS | FF | 2 | R45C6[3][A] | u_top/u_alloc/pick_2_s18/F
25.436 | 0.888 | tNET | FF | 1 | R47C3[1][B] | u_top/u_alloc/pick_2_s9/I0
26.006 | 0.570 | tINS | FR | 2 | R47C3[1][B] | u_top/u_alloc/pick_2_s9/F
26.009 | 0.003 | tNET | RR | 1 | R47C3[1][A] | u_top/u_alloc/pick_2_s2/I3
26.564 | 0.555 | tINS | RF | 4 | R47C3[1][A] | u_top/u_alloc/pick_2_s2/F
26.811 | 0.247 | tNET | FF | 1 | R47C5[0][A] | u_top/u_alloc/pick_0_s0/I0
27.182 | 0.371 | tINS | FF | 29 | R47C5[0][A] | u_top/u_alloc/pick_0_s0/F
29.637 | 2.455 | tNET | FF | 18 | DSP_R37[1][A] | u_top/u_alloc/n453_s1/B[0]
33.277 | 3.640 | tINS | FF | 8 | DSP_R37[1][A] | u_top/u_alloc/n453_s1/DOUT[6]
34.049 | 0.771 | tNET | FF | 1 | R47C13[3][B] | u_top/u_alloc/n3490_s1/I0
34.619 | 0.570 | tINS | FR | 7 | R47C13[3][B] | u_top/u_alloc/n3490_s1/F
35.346 | 0.727 | tNET | RR | 1 | R47C13[0][B] | u_top/u_alloc/v_note_2_s0/CE

Data Required Path:

AT | DELAY | TYPE | RF | FANOUT | LOC | NODE
37.037 | 37.037 | | | | | active clock edge time
37.037 | 0.000 | | | | | clk_27m
37.037 | 0.000 | tCL | RR | 1 | IOT27[A] | clk_27m_ibuf/I
39.125 | 2.088 | tINS | RR | 3750 | IOT27[A] | clk_27m_ibuf/O
41.396 | 2.271 | tNET | RR | 1 | R47C13[0][B] | u_top/u_alloc/v_note_2_s0/CLK
41.361 | -0.035 | tSu | | 1 | R47C13[0][B] | u_top/u_alloc/v_note_2_s0

Path Statistics:

Clock Skew | 0.000
Setup Relationship | 37.037
Logic Level | 23
Arrival Clock Path Delay | cell: 2.088, 47.897%; route: 2.271, 52.103%
Arrival Data Path Delay | cell: 12.743, 41.123%; route: 18.012, 58.128%; tC2Q: 0.232, 0.749%
Required Clock Path Delay | cell: 2.088, 47.897%; route: 2.271, 52.103%

### Path11

Path Summary:

Slack | 6.016
Data Arrival Time | 35.346
Data Required Time | 41.361
From | u_top/u_manual/rd_ptr_0_s0
To | u_top/u_alloc/v_note_3_s0
Launch Clk | clk_27m:[R]
Latch Clk | clk_27m:[R]

Data Arrival Path:

AT | DELAY | TYPE | RF | FANOUT | LOC | NODE
0.000 | 0.000 | | | | | active clock edge time
0.000 | 0.000 | | | | | clk_27m
0.000 | 0.000 | tCL | RR | 1 | IOT27[A] | clk_27m_ibuf/I
2.088 | 2.088 | tINS | RR | 3750 | IOT27[A] | clk_27m_ibuf/O
4.359 | 2.271 | tNET | RR | 1 | R22C42[0][A] | u_top/u_manual/rd_ptr_0_s0/CLK
4.591 | 0.232 | tC2Q | RF | 7 | R22C42[0][A] | u_top/u_manual/rd_ptr_0_s0/Q
5.488 | 0.897 | tNET | FF | 2 | R16C42[0][A] | u_top/u_manual/n4_s0/I1
6.058 | 0.570 | tINS | FR | 1 | R16C42[0][A] | u_top/u_manual/n4_s0/COUT
6.058 | 0.000 | tNET | RR | 2 | R16C42[0][B] | u_top/u_manual/n5_s0/CIN
6.093 | 0.035 | tINS | RF | 1 | R16C42[0][B] | u_top/u_manual/n5_s0/COUT
6.093 | 0.000 | tNET | FF | 2 | R16C42[1][A] | u_top/u_manual/n6_s0/CIN
6.129 | 0.035 | tINS | FF | 1 | R16C42[1][A] | u_top/u_manual/n6_s0/COUT
6.129 | 0.000 | tNET | FF | 2 | R16C42[1][B] | u_top/u_manual/n7_s0/CIN
6.164 | 0.035 | tINS | FF | 1 | R16C42[1][B] | u_top/u_manual/n7_s0/COUT
6.164 | 0.000 | tNET | FF | 2 | R16C42[2][A] | u_top/u_manual/n8_s0/CIN
6.199 | 0.035 | tINS | FF | 17 | R16C42[2][A] | u_top/u_manual/n8_s0/COUT
6.884 | 0.685 | tNET | FF | 1 | R15C42[3][A] | u_top/ev_word_10_s2/I2
7.401 | 0.517 | tINS | FF | 1 | R15C42[3][A] | u_top/ev_word_10_s2/F
7.891 | 0.490 | tNET | FF | 1 | R15C38[3][A] | u_top/ev_word_10_s1/I1
8.353 | 0.462 | tINS | FR | 6 | R15C38[3][A] | u_top/ev_word_10_s1/F
8.527 | 0.174 | tNET | RR | 1 | R15C37[3][B] | u_top/ev_word_10_s0/I0
8.898 | 0.371 | tINS | RF | 35 | R15C37[3][B] | u_top/ev_word_10_s0/F
13.607 | 4.709 | tNET | FF | 2 | R51C14[1][A] | u_top/u_alloc/n50_s0/I1
14.177 | 0.570 | tINS | FR | 1 | R51C14[1][A] | u_top/u_alloc/n50_s0/COUT
14.177 | 0.000 | tNET | RR | 2 | R51C14[1][B] | u_top/u_alloc/n51_s0/CIN
14.212 | 0.035 | tINS | RF | 1 | R51C14[1][B] | u_top/u_alloc/n51_s0/COUT
14.212 | 0.000 | tNET | FF | 2 | R51C14[2][A] | u_top/u_alloc/n52_s0/CIN
14.247 | 0.035 | tINS | FF | 1 | R51C14[2][A] | u_top/u_alloc/n52_s0/COUT
14.247 | 0.000 | tNET | FF | 2 | R51C14[2][B] | u_top/u_alloc/n53_s0/CIN
14.282 | 0.035 | tINS | FF | 1 | R51C14[2][B] | u_top/u_alloc/n53_s0/COUT
14.282 | 0.000 | tNET | FF | 2 | R51C15[0][A] | u_top/u_alloc/n54_s0/CIN
14.317 | 0.035 | tINS | FF | 3 | R51C15[0][A] | u_top/u_alloc/n54_s0/COUT
16.161 | 1.844 | tNET | FF | 1 | R48C10[3][B] | u_top/u_alloc/pick_0_s44/I0
16.532 | 0.371 | tINS | FF | 3 | R48C10[3][B] | u_top/u_alloc/pick_0_s44/F
16.545 | 0.013 | tNET | FF | 1 | R48C10[2][B] | u_top/u_alloc/pick_0_s21/I3
17.062 | 0.517 | tINS | FF | 2 | R48C10[2][B] | u_top/u_alloc/pick_0_s21/F
17.755 | 0.693 | tNET | FF | 1 | R41C9[3][A] | u_top/u_alloc/pick_0_s9/I3
18.310 | 0.555 | tINS | FF | 3 | R41C9[3][A] | u_top/u_alloc/pick_0_s9/F
19.156 | 0.845 | tNET | FF | 1 | R47C10[3][A] | u_top/u_alloc/pick_0_s23/I2
19.711 | 0.555 | tINS | FF | 7 | R47C10[3][A] | u_top/u_alloc/pick_0_s23/F
20.368 | 0.658 | tNET | FF | 1 | R47C7[0][A] | u_top/u_alloc/pick_0_s49/I1
20.739 | 0.371 | tINS | FF | 4 | R47C7[0][A] | u_top/u_alloc/pick_0_s49/F
21.974 | 1.235 | tNET | FF | 1 | R45C4[1][A] | u_top/u_alloc/pick_2_s100/I0
22.529 | 0.555 | tINS | FF | 1 | R45C4[1][A] | u_top/u_alloc/pick_2_s100/F
22.943 | 0.413 | tNET | FF | 1 | R44C6[3][A] | u_top/u_alloc/pick_2_s80/I3
23.396 | 0.453 | tINS | FF | 3 | R44C6[3][A] | u_top/u_alloc/pick_2_s80/F
23.651 | 0.256 | tNET | FF | 1 | R45C6[3][B] | u_top/u_alloc/pick_2_s43/I2
24.022 | 0.371 | tINS | FF | 2 | R45C6[3][B] | u_top/u_alloc/pick_2_s43/F
24.031 | 0.009 | tNET | FF | 1 | R45C6[3][A] | u_top/u_alloc/pick_2_s18/I1
24.548 | 0.517 | tINS | FF | 2 | R45C6[3][A] | u_top/u_alloc/pick_2_s18/F
25.436 | 0.888 | tNET | FF | 1 | R47C3[1][B] | u_top/u_alloc/pick_2_s9/I0
26.006 | 0.570 | tINS | FR | 2 | R47C3[1][B] | u_top/u_alloc/pick_2_s9/F
26.009 | 0.003 | tNET | RR | 1 | R47C3[1][A] | u_top/u_alloc/pick_2_s2/I3
26.564 | 0.555 | tINS | RF | 4 | R47C3[1][A] | u_top/u_alloc/pick_2_s2/F
26.811 | 0.247 | tNET | FF | 1 | R47C5[0][A] | u_top/u_alloc/pick_0_s0/I0
27.182 | 0.371 | tINS | FF | 29 | R47C5[0][A] | u_top/u_alloc/pick_0_s0/F
29.637 | 2.455 | tNET | FF | 18 | DSP_R37[1][A] | u_top/u_alloc/n453_s1/B[0]
33.277 | 3.640 | tINS | FF | 8 | DSP_R37[1][A] | u_top/u_alloc/n453_s1/DOUT[6]
34.049 | 0.771 | tNET | FF | 1 | R47C13[3][B] | u_top/u_alloc/n3490_s1/I0
34.619 | 0.570 | tINS | FR | 7 | R47C13[3][B] | u_top/u_alloc/n3490_s1/F
35.346 | 0.727 | tNET | RR | 1 | R47C13[1][A] | u_top/u_alloc/v_note_3_s0/CE

Data Required Path:

AT | DELAY | TYPE | RF | FANOUT | LOC | NODE
37.037 | 37.037 | | | | | active clock edge time
37.037 | 0.000 | | | | | clk_27m
37.037 | 0.000 | tCL | RR | 1 | IOT27[A] | clk_27m_ibuf/I
39.125 | 2.088 | tINS | RR | 3750 | IOT27[A] | clk_27m_ibuf/O
41.396 | 2.271 | tNET | RR | 1 | R47C13[1][A] | u_top/u_alloc/v_note_3_s0/CLK
41.361 | -0.035 | tSu | | 1 | R47C13[1][A] | u_top/u_alloc/v_note_3_s0

Path Statistics:

Clock Skew | 0.000
Setup Relationship | 37.037
Logic Level | 23
Arrival Clock Path Delay | cell: 2.088, 47.897%; route: 2.271, 52.103%
Arrival Data Path Delay | cell: 12.743, 41.123%; route: 18.012, 58.128%; tC2Q: 0.232, 0.749%
Required Clock Path Delay | cell: 2.088, 47.897%; route: 2.271, 52.103%

### Path12

Path Summary:

Slack | 6.016
Data Arrival Time | 35.346
Data Required Time | 41.361
From | u_top/u_manual/rd_ptr_0_s0
To | u_top/u_alloc/v_note_4_s0
Launch Clk | clk_27m:[R]
Latch Clk | clk_27m:[R]

Data Arrival Path:

AT | DELAY | TYPE | RF | FANOUT | LOC | NODE
0.000 | 0.000 | | | | | active clock edge time
0.000 | 0.000 | | | | | clk_27m
0.000 | 0.000 | tCL | RR | 1 | IOT27[A] | clk_27m_ibuf/I
2.088 | 2.088 | tINS | RR | 3750 | IOT27[A] | clk_27m_ibuf/O
4.359 | 2.271 | tNET | RR | 1 | R22C42[0][A] | u_top/u_manual/rd_ptr_0_s0/CLK
4.591 | 0.232 | tC2Q | RF | 7 | R22C42[0][A] | u_top/u_manual/rd_ptr_0_s0/Q
5.488 | 0.897 | tNET | FF | 2 | R16C42[0][A] | u_top/u_manual/n4_s0/I1
6.058 | 0.570 | tINS | FR | 1 | R16C42[0][A] | u_top/u_manual/n4_s0/COUT
6.058 | 0.000 | tNET | RR | 2 | R16C42[0][B] | u_top/u_manual/n5_s0/CIN
6.093 | 0.035 | tINS | RF | 1 | R16C42[0][B] | u_top/u_manual/n5_s0/COUT
6.093 | 0.000 | tNET | FF | 2 | R16C42[1][A] | u_top/u_manual/n6_s0/CIN
6.129 | 0.035 | tINS | FF | 1 | R16C42[1][A] | u_top/u_manual/n6_s0/COUT
6.129 | 0.000 | tNET | FF | 2 | R16C42[1][B] | u_top/u_manual/n7_s0/CIN
6.164 | 0.035 | tINS | FF | 1 | R16C42[1][B] | u_top/u_manual/n7_s0/COUT
6.164 | 0.000 | tNET | FF | 2 | R16C42[2][A] | u_top/u_manual/n8_s0/CIN
6.199 | 0.035 | tINS | FF | 17 | R16C42[2][A] | u_top/u_manual/n8_s0/COUT
6.884 | 0.685 | tNET | FF | 1 | R15C42[3][A] | u_top/ev_word_10_s2/I2
7.401 | 0.517 | tINS | FF | 1 | R15C42[3][A] | u_top/ev_word_10_s2/F
7.891 | 0.490 | tNET | FF | 1 | R15C38[3][A] | u_top/ev_word_10_s1/I1
8.353 | 0.462 | tINS | FR | 6 | R15C38[3][A] | u_top/ev_word_10_s1/F
8.527 | 0.174 | tNET | RR | 1 | R15C37[3][B] | u_top/ev_word_10_s0/I0
8.898 | 0.371 | tINS | RF | 35 | R15C37[3][B] | u_top/ev_word_10_s0/F
13.607 | 4.709 | tNET | FF | 2 | R51C14[1][A] | u_top/u_alloc/n50_s0/I1
14.177 | 0.570 | tINS | FR | 1 | R51C14[1][A] | u_top/u_alloc/n50_s0/COUT
14.177 | 0.000 | tNET | RR | 2 | R51C14[1][B] | u_top/u_alloc/n51_s0/CIN
14.212 | 0.035 | tINS | RF | 1 | R51C14[1][B] | u_top/u_alloc/n51_s0/COUT
14.212 | 0.000 | tNET | FF | 2 | R51C14[2][A] | u_top/u_alloc/n52_s0/CIN
14.247 | 0.035 | tINS | FF | 1 | R51C14[2][A] | u_top/u_alloc/n52_s0/COUT
14.247 | 0.000 | tNET | FF | 2 | R51C14[2][B] | u_top/u_alloc/n53_s0/CIN
14.282 | 0.035 | tINS | FF | 1 | R51C14[2][B] | u_top/u_alloc/n53_s0/COUT
14.282 | 0.000 | tNET | FF | 2 | R51C15[0][A] | u_top/u_alloc/n54_s0/CIN
14.317 | 0.035 | tINS | FF | 3 | R51C15[0][A] | u_top/u_alloc/n54_s0/COUT
16.161 | 1.844 | tNET | FF | 1 | R48C10[3][B] | u_top/u_alloc/pick_0_s44/I0
16.532 | 0.371 | tINS | FF | 3 | R48C10[3][B] | u_top/u_alloc/pick_0_s44/F
16.545 | 0.013 | tNET | FF | 1 | R48C10[2][B] | u_top/u_alloc/pick_0_s21/I3
17.062 | 0.517 | tINS | FF | 2 | R48C10[2][B] | u_top/u_alloc/pick_0_s21/F
17.755 | 0.693 | tNET | FF | 1 | R41C9[3][A] | u_top/u_alloc/pick_0_s9/I3
18.310 | 0.555 | tINS | FF | 3 | R41C9[3][A] | u_top/u_alloc/pick_0_s9/F
19.156 | 0.845 | tNET | FF | 1 | R47C10[3][A] | u_top/u_alloc/pick_0_s23/I2
19.711 | 0.555 | tINS | FF | 7 | R47C10[3][A] | u_top/u_alloc/pick_0_s23/F
20.368 | 0.658 | tNET | FF | 1 | R47C7[0][A] | u_top/u_alloc/pick_0_s49/I1
20.739 | 0.371 | tINS | FF | 4 | R47C7[0][A] | u_top/u_alloc/pick_0_s49/F
21.974 | 1.235 | tNET | FF | 1 | R45C4[1][A] | u_top/u_alloc/pick_2_s100/I0
22.529 | 0.555 | tINS | FF | 1 | R45C4[1][A] | u_top/u_alloc/pick_2_s100/F
22.943 | 0.413 | tNET | FF | 1 | R44C6[3][A] | u_top/u_alloc/pick_2_s80/I3
23.396 | 0.453 | tINS | FF | 3 | R44C6[3][A] | u_top/u_alloc/pick_2_s80/F
23.651 | 0.256 | tNET | FF | 1 | R45C6[3][B] | u_top/u_alloc/pick_2_s43/I2
24.022 | 0.371 | tINS | FF | 2 | R45C6[3][B] | u_top/u_alloc/pick_2_s43/F
24.031 | 0.009 | tNET | FF | 1 | R45C6[3][A] | u_top/u_alloc/pick_2_s18/I1
24.548 | 0.517 | tINS | FF | 2 | R45C6[3][A] | u_top/u_alloc/pick_2_s18/F
25.436 | 0.888 | tNET | FF | 1 | R47C3[1][B] | u_top/u_alloc/pick_2_s9/I0
26.006 | 0.570 | tINS | FR | 2 | R47C3[1][B] | u_top/u_alloc/pick_2_s9/F
26.009 | 0.003 | tNET | RR | 1 | R47C3[1][A] | u_top/u_alloc/pick_2_s2/I3
26.564 | 0.555 | tINS | RF | 4 | R47C3[1][A] | u_top/u_alloc/pick_2_s2/F
26.811 | 0.247 | tNET | FF | 1 | R47C5[0][A] | u_top/u_alloc/pick_0_s0/I0
27.182 | 0.371 | tINS | FF | 29 | R47C5[0][A] | u_top/u_alloc/pick_0_s0/F
29.637 | 2.455 | tNET | FF | 18 | DSP_R37[1][A] | u_top/u_alloc/n453_s1/B[0]
33.277 | 3.640 | tINS | FF | 8 | DSP_R37[1][A] | u_top/u_alloc/n453_s1/DOUT[6]
34.049 | 0.771 | tNET | FF | 1 | R47C13[3][B] | u_top/u_alloc/n3490_s1/I0
34.619 | 0.570 | tINS | FR | 7 | R47C13[3][B] | u_top/u_alloc/n3490_s1/F
35.346 | 0.727 | tNET | RR | 1 | R47C13[1][B] | u_top/u_alloc/v_note_4_s0/CE

Data Required Path:

AT | DELAY | TYPE | RF | FANOUT | LOC | NODE
37.037 | 37.037 | | | | | active clock edge time
37.037 | 0.000 | | | | | clk_27m
37.037 | 0.000 | tCL | RR | 1 | IOT27[A] | clk_27m_ibuf/I
39.125 | 2.088 | tINS | RR | 3750 | IOT27[A] | clk_27m_ibuf/O
41.396 | 2.271 | tNET | RR | 1 | R47C13[1][B] | u_top/u_alloc/v_note_4_s0/CLK
41.361 | -0.035 | tSu | | 1 | R47C13[1][B] | u_top/u_alloc/v_note_4_s0

Path Statistics:

Clock Skew | 0.000
Setup Relationship | 37.037
Logic Level | 23
Arrival Clock Path Delay | cell: 2.088, 47.897%; route: 2.271, 52.103%
Arrival Data Path Delay | cell: 12.743, 41.123%; route: 18.012, 58.128%; tC2Q: 0.232, 0.749%
Required Clock Path Delay | cell: 2.088, 47.897%; route: 2.271, 52.103%

### Path13

Path Summary:

Slack | 6.016
Data Arrival Time | 35.346
Data Required Time | 41.361
From | u_top/u_manual/rd_ptr_0_s0
To | u_top/u_alloc/v_note_5_s0
Launch Clk | clk_27m:[R]
Latch Clk | clk_27m:[R]

Data Arrival Path:

AT | DELAY | TYPE | RF | FANOUT | LOC | NODE
0.000 | 0.000 | | | | | active clock edge time
0.000 | 0.000 | | | | | clk_27m
0.000 | 0.000 | tCL | RR | 1 | IOT27[A] | clk_27m_ibuf/I
2.088 | 2.088 | tINS | RR | 3750 | IOT27[A] | clk_27m_ibuf/O
4.359 | 2.271 | tNET | RR | 1 | R22C42[0][A] | u_top/u_manual/rd_ptr_0_s0/CLK
4.591 | 0.232 | tC2Q | RF | 7 | R22C42[0][A] | u_top/u_manual/rd_ptr_0_s0/Q
5.488 | 0.897 | tNET | FF | 2 | R16C42[0][A] | u_top/u_manual/n4_s0/I1
6.058 | 0.570 | tINS | FR | 1 | R16C42[0][A] | u_top/u_manual/n4_s0/COUT
6.058 | 0.000 | tNET | RR | 2 | R16C42[0][B] | u_top/u_manual/n5_s0/CIN
6.093 | 0.035 | tINS | RF | 1 | R16C42[0][B] | u_top/u_manual/n5_s0/COUT
6.093 | 0.000 | tNET | FF | 2 | R16C42[1][A] | u_top/u_manual/n6_s0/CIN
6.129 | 0.035 | tINS | FF | 1 | R16C42[1][A] | u_top/u_manual/n6_s0/COUT
6.129 | 0.000 | tNET | FF | 2 | R16C42[1][B] | u_top/u_manual/n7_s0/CIN
6.164 | 0.035 | tINS | FF | 1 | R16C42[1][B] | u_top/u_manual/n7_s0/COUT
6.164 | 0.000 | tNET | FF | 2 | R16C42[2][A] | u_top/u_manual/n8_s0/CIN
6.199 | 0.035 | tINS | FF | 17 | R16C42[2][A] | u_top/u_manual/n8_s0/COUT
6.884 | 0.685 | tNET | FF | 1 | R15C42[3][A] | u_top/ev_word_10_s2/I2
7.401 | 0.517 | tINS | FF | 1 | R15C42[3][A] | u_top/ev_word_10_s2/F
7.891 | 0.490 | tNET | FF | 1 | R15C38[3][A] | u_top/ev_word_10_s1/I1
8.353 | 0.462 | tINS | FR | 6 | R15C38[3][A] | u_top/ev_word_10_s1/F
8.527 | 0.174 | tNET | RR | 1 | R15C37[3][B] | u_top/ev_word_10_s0/I0
8.898 | 0.371 | tINS | RF | 35 | R15C37[3][B] | u_top/ev_word_10_s0/F
13.607 | 4.709 | tNET | FF | 2 | R51C14[1][A] | u_top/u_alloc/n50_s0/I1
14.177 | 0.570 | tINS | FR | 1 | R51C14[1][A] | u_top/u_alloc/n50_s0/COUT
14.177 | 0.000 | tNET | RR | 2 | R51C14[1][B] | u_top/u_alloc/n51_s0/CIN
14.212 | 0.035 | tINS | RF | 1 | R51C14[1][B] | u_top/u_alloc/n51_s0/COUT
14.212 | 0.000 | tNET | FF | 2 | R51C14[2][A] | u_top/u_alloc/n52_s0/CIN
14.247 | 0.035 | tINS | FF | 1 | R51C14[2][A] | u_top/u_alloc/n52_s0/COUT
14.247 | 0.000 | tNET | FF | 2 | R51C14[2][B] | u_top/u_alloc/n53_s0/CIN
14.282 | 0.035 | tINS | FF | 1 | R51C14[2][B] | u_top/u_alloc/n53_s0/COUT
14.282 | 0.000 | tNET | FF | 2 | R51C15[0][A] | u_top/u_alloc/n54_s0/CIN
14.317 | 0.035 | tINS | FF | 3 | R51C15[0][A] | u_top/u_alloc/n54_s0/COUT
16.161 | 1.844 | tNET | FF | 1 | R48C10[3][B] | u_top/u_alloc/pick_0_s44/I0
16.532 | 0.371 | tINS | FF | 3 | R48C10[3][B] | u_top/u_alloc/pick_0_s44/F
16.545 | 0.013 | tNET | FF | 1 | R48C10[2][B] | u_top/u_alloc/pick_0_s21/I3
17.062 | 0.517 | tINS | FF | 2 | R48C10[2][B] | u_top/u_alloc/pick_0_s21/F
17.755 | 0.693 | tNET | FF | 1 | R41C9[3][A] | u_top/u_alloc/pick_0_s9/I3
18.310 | 0.555 | tINS | FF | 3 | R41C9[3][A] | u_top/u_alloc/pick_0_s9/F
19.156 | 0.845 | tNET | FF | 1 | R47C10[3][A] | u_top/u_alloc/pick_0_s23/I2
19.711 | 0.555 | tINS | FF | 7 | R47C10[3][A] | u_top/u_alloc/pick_0_s23/F
20.368 | 0.658 | tNET | FF | 1 | R47C7[0][A] | u_top/u_alloc/pick_0_s49/I1
20.739 | 0.371 | tINS | FF | 4 | R47C7[0][A] | u_top/u_alloc/pick_0_s49/F
21.974 | 1.235 | tNET | FF | 1 | R45C4[1][A] | u_top/u_alloc/pick_2_s100/I0
22.529 | 0.555 | tINS | FF | 1 | R45C4[1][A] | u_top/u_alloc/pick_2_s100/F
22.943 | 0.413 | tNET | FF | 1 | R44C6[3][A] | u_top/u_alloc/pick_2_s80/I3
23.396 | 0.453 | tINS | FF | 3 | R44C6[3][A] | u_top/u_alloc/pick_2_s80/F
23.651 | 0.256 | tNET | FF | 1 | R45C6[3][B] | u_top/u_alloc/pick_2_s43/I2
24.022 | 0.371 | tINS | FF | 2 | R45C6[3][B] | u_top/u_alloc/pick_2_s43/F
24.031 | 0.009 | tNET | FF | 1 | R45C6[3][A] | u_top/u_alloc/pick_2_s18/I1
24.548 | 0.517 | tINS | FF | 2 | R45C6[3][A] | u_top/u_alloc/pick_2_s18/F
25.436 | 0.888 | tNET | FF | 1 | R47C3[1][B] | u_top/u_alloc/pick_2_s9/I0
26.006 | 0.570 | tINS | FR | 2 | R47C3[1][B] | u_top/u_alloc/pick_2_s9/F
26.009 | 0.003 | tNET | RR | 1 | R47C3[1][A] | u_top/u_alloc/pick_2_s2/I3
26.564 | 0.555 | tINS | RF | 4 | R47C3[1][A] | u_top/u_alloc/pick_2_s2/F
26.811 | 0.247 | tNET | FF | 1 | R47C5[0][A] | u_top/u_alloc/pick_0_s0/I0
27.182 | 0.371 | tINS | FF | 29 | R47C5[0][A] | u_top/u_alloc/pick_0_s0/F
29.637 | 2.455 | tNET | FF | 18 | DSP_R37[1][A] | u_top/u_alloc/n453_s1/B[0]
33.277 | 3.640 | tINS | FF | 8 | DSP_R37[1][A] | u_top/u_alloc/n453_s1/DOUT[6]
34.049 | 0.771 | tNET | FF | 1 | R47C13[3][B] | u_top/u_alloc/n3490_s1/I0
34.619 | 0.570 | tINS | FR | 7 | R47C13[3][B] | u_top/u_alloc/n3490_s1/F
35.346 | 0.727 | tNET | RR | 1 | R47C12[2][A] | u_top/u_alloc/v_note_5_s0/CE

Data Required Path:

AT | DELAY | TYPE | RF | FANOUT | LOC | NODE
37.037 | 37.037 | | | | | active clock edge time
37.037 | 0.000 | | | | | clk_27m
37.037 | 0.000 | tCL | RR | 1 | IOT27[A] | clk_27m_ibuf/I
39.125 | 2.088 | tINS | RR | 3750 | IOT27[A] | clk_27m_ibuf/O
41.396 | 2.271 | tNET | RR | 1 | R47C12[2][A] | u_top/u_alloc/v_note_5_s0/CLK
41.361 | -0.035 | tSu | | 1 | R47C12[2][A] | u_top/u_alloc/v_note_5_s0

Path Statistics:

Clock Skew | 0.000
Setup Relationship | 37.037
Logic Level | 23
Arrival Clock Path Delay | cell: 2.088, 47.897%; route: 2.271, 52.103%
Arrival Data Path Delay | cell: 12.743, 41.123%; route: 18.012, 58.128%; tC2Q: 0.232, 0.749%
Required Clock Path Delay | cell: 2.088, 47.897%; route: 2.271, 52.103%

### Path14

Path Summary:

Slack | 6.016
Data Arrival Time | 35.346
Data Required Time | 41.361
From | u_top/u_manual/rd_ptr_0_s0
To | u_top/u_alloc/v_note_6_s0
Launch Clk | clk_27m:[R]
Latch Clk | clk_27m:[R]

Data Arrival Path:

AT | DELAY | TYPE | RF | FANOUT | LOC | NODE
0.000 | 0.000 | | | | | active clock edge time
0.000 | 0.000 | | | | | clk_27m
0.000 | 0.000 | tCL | RR | 1 | IOT27[A] | clk_27m_ibuf/I
2.088 | 2.088 | tINS | RR | 3750 | IOT27[A] | clk_27m_ibuf/O
4.359 | 2.271 | tNET | RR | 1 | R22C42[0][A] | u_top/u_manual/rd_ptr_0_s0/CLK
4.591 | 0.232 | tC2Q | RF | 7 | R22C42[0][A] | u_top/u_manual/rd_ptr_0_s0/Q
5.488 | 0.897 | tNET | FF | 2 | R16C42[0][A] | u_top/u_manual/n4_s0/I1
6.058 | 0.570 | tINS | FR | 1 | R16C42[0][A] | u_top/u_manual/n4_s0/COUT
6.058 | 0.000 | tNET | RR | 2 | R16C42[0][B] | u_top/u_manual/n5_s0/CIN
6.093 | 0.035 | tINS | RF | 1 | R16C42[0][B] | u_top/u_manual/n5_s0/COUT
6.093 | 0.000 | tNET | FF | 2 | R16C42[1][A] | u_top/u_manual/n6_s0/CIN
6.129 | 0.035 | tINS | FF | 1 | R16C42[1][A] | u_top/u_manual/n6_s0/COUT
6.129 | 0.000 | tNET | FF | 2 | R16C42[1][B] | u_top/u_manual/n7_s0/CIN
6.164 | 0.035 | tINS | FF | 1 | R16C42[1][B] | u_top/u_manual/n7_s0/COUT
6.164 | 0.000 | tNET | FF | 2 | R16C42[2][A] | u_top/u_manual/n8_s0/CIN
6.199 | 0.035 | tINS | FF | 17 | R16C42[2][A] | u_top/u_manual/n8_s0/COUT
6.884 | 0.685 | tNET | FF | 1 | R15C42[3][A] | u_top/ev_word_10_s2/I2
7.401 | 0.517 | tINS | FF | 1 | R15C42[3][A] | u_top/ev_word_10_s2/F
7.891 | 0.490 | tNET | FF | 1 | R15C38[3][A] | u_top/ev_word_10_s1/I1
8.353 | 0.462 | tINS | FR | 6 | R15C38[3][A] | u_top/ev_word_10_s1/F
8.527 | 0.174 | tNET | RR | 1 | R15C37[3][B] | u_top/ev_word_10_s0/I0
8.898 | 0.371 | tINS | RF | 35 | R15C37[3][B] | u_top/ev_word_10_s0/F
13.607 | 4.709 | tNET | FF | 2 | R51C14[1][A] | u_top/u_alloc/n50_s0/I1
14.177 | 0.570 | tINS | FR | 1 | R51C14[1][A] | u_top/u_alloc/n50_s0/COUT
14.177 | 0.000 | tNET | RR | 2 | R51C14[1][B] | u_top/u_alloc/n51_s0/CIN
14.212 | 0.035 | tINS | RF | 1 | R51C14[1][B] | u_top/u_alloc/n51_s0/COUT
14.212 | 0.000 | tNET | FF | 2 | R51C14[2][A] | u_top/u_alloc/n52_s0/CIN
14.247 | 0.035 | tINS | FF | 1 | R51C14[2][A] | u_top/u_alloc/n52_s0/COUT
14.247 | 0.000 | tNET | FF | 2 | R51C14[2][B] | u_top/u_alloc/n53_s0/CIN
14.282 | 0.035 | tINS | FF | 1 | R51C14[2][B] | u_top/u_alloc/n53_s0/COUT
14.282 | 0.000 | tNET | FF | 2 | R51C15[0][A] | u_top/u_alloc/n54_s0/CIN
14.317 | 0.035 | tINS | FF | 3 | R51C15[0][A] | u_top/u_alloc/n54_s0/COUT
16.161 | 1.844 | tNET | FF | 1 | R48C10[3][B] | u_top/u_alloc/pick_0_s44/I0
16.532 | 0.371 | tINS | FF | 3 | R48C10[3][B] | u_top/u_alloc/pick_0_s44/F
16.545 | 0.013 | tNET | FF | 1 | R48C10[2][B] | u_top/u_alloc/pick_0_s21/I3
17.062 | 0.517 | tINS | FF | 2 | R48C10[2][B] | u_top/u_alloc/pick_0_s21/F
17.755 | 0.693 | tNET | FF | 1 | R41C9[3][A] | u_top/u_alloc/pick_0_s9/I3
18.310 | 0.555 | tINS | FF | 3 | R41C9[3][A] | u_top/u_alloc/pick_0_s9/F
19.156 | 0.845 | tNET | FF | 1 | R47C10[3][A] | u_top/u_alloc/pick_0_s23/I2
19.711 | 0.555 | tINS | FF | 7 | R47C10[3][A] | u_top/u_alloc/pick_0_s23/F
20.368 | 0.658 | tNET | FF | 1 | R47C7[0][A] | u_top/u_alloc/pick_0_s49/I1
20.739 | 0.371 | tINS | FF | 4 | R47C7[0][A] | u_top/u_alloc/pick_0_s49/F
21.974 | 1.235 | tNET | FF | 1 | R45C4[1][A] | u_top/u_alloc/pick_2_s100/I0
22.529 | 0.555 | tINS | FF | 1 | R45C4[1][A] | u_top/u_alloc/pick_2_s100/F
22.943 | 0.413 | tNET | FF | 1 | R44C6[3][A] | u_top/u_alloc/pick_2_s80/I3
23.396 | 0.453 | tINS | FF | 3 | R44C6[3][A] | u_top/u_alloc/pick_2_s80/F
23.651 | 0.256 | tNET | FF | 1 | R45C6[3][B] | u_top/u_alloc/pick_2_s43/I2
24.022 | 0.371 | tINS | FF | 2 | R45C6[3][B] | u_top/u_alloc/pick_2_s43/F
24.031 | 0.009 | tNET | FF | 1 | R45C6[3][A] | u_top/u_alloc/pick_2_s18/I1
24.548 | 0.517 | tINS | FF | 2 | R45C6[3][A] | u_top/u_alloc/pick_2_s18/F
25.436 | 0.888 | tNET | FF | 1 | R47C3[1][B] | u_top/u_alloc/pick_2_s9/I0
26.006 | 0.570 | tINS | FR | 2 | R47C3[1][B] | u_top/u_alloc/pick_2_s9/F
26.009 | 0.003 | tNET | RR | 1 | R47C3[1][A] | u_top/u_alloc/pick_2_s2/I3
26.564 | 0.555 | tINS | RF | 4 | R47C3[1][A] | u_top/u_alloc/pick_2_s2/F
26.811 | 0.247 | tNET | FF | 1 | R47C5[0][A] | u_top/u_alloc/pick_0_s0/I0
27.182 | 0.371 | tINS | FF | 29 | R47C5[0][A] | u_top/u_alloc/pick_0_s0/F
29.637 | 2.455 | tNET | FF | 18 | DSP_R37[1][A] | u_top/u_alloc/n453_s1/B[0]
33.277 | 3.640 | tINS | FF | 8 | DSP_R37[1][A] | u_top/u_alloc/n453_s1/DOUT[6]
34.049 | 0.771 | tNET | FF | 1 | R47C13[3][B] | u_top/u_alloc/n3490_s1/I0
34.619 | 0.570 | tINS | FR | 7 | R47C13[3][B] | u_top/u_alloc/n3490_s1/F
35.346 | 0.727 | tNET | RR | 1 | R47C12[1][B] | u_top/u_alloc/v_note_6_s0/CE

Data Required Path:

AT | DELAY | TYPE | RF | FANOUT | LOC | NODE
37.037 | 37.037 | | | | | active clock edge time
37.037 | 0.000 | | | | | clk_27m
37.037 | 0.000 | tCL | RR | 1 | IOT27[A] | clk_27m_ibuf/I
39.125 | 2.088 | tINS | RR | 3750 | IOT27[A] | clk_27m_ibuf/O
41.396 | 2.271 | tNET | RR | 1 | R47C12[1][B] | u_top/u_alloc/v_note_6_s0/CLK
41.361 | -0.035 | tSu | | 1 | R47C12[1][B] | u_top/u_alloc/v_note_6_s0

Path Statistics:

Clock Skew | 0.000
Setup Relationship | 37.037
Logic Level | 23
Arrival Clock Path Delay | cell: 2.088, 47.897%; route: 2.271, 52.103%
Arrival Data Path Delay | cell: 12.743, 41.123%; route: 18.012, 58.128%; tC2Q: 0.232, 0.749%
Required Clock Path Delay | cell: 2.088, 47.897%; route: 2.271, 52.103%

### Path15

Path Summary:

Slack | 6.032
Data Arrival Time | 35.329
Data Required Time | 41.361
From | u_top/u_manual/rd_ptr_0_s0
To | u_top/u_alloc/v_note_49_s0
Launch Clk | clk_27m:[R]
Latch Clk | clk_27m:[R]

Data Arrival Path:

AT | DELAY | TYPE | RF | FANOUT | LOC | NODE
0.000 | 0.000 | | | | | active clock edge time
0.000 | 0.000 | | | | | clk_27m
0.000 | 0.000 | tCL | RR | 1 | IOT27[A] | clk_27m_ibuf/I
2.088 | 2.088 | tINS | RR | 3750 | IOT27[A] | clk_27m_ibuf/O
4.359 | 2.271 | tNET | RR | 1 | R22C42[0][A] | u_top/u_manual/rd_ptr_0_s0/CLK
4.591 | 0.232 | tC2Q | RF | 7 | R22C42[0][A] | u_top/u_manual/rd_ptr_0_s0/Q
5.488 | 0.897 | tNET | FF | 2 | R16C42[0][A] | u_top/u_manual/n4_s0/I1
6.058 | 0.570 | tINS | FR | 1 | R16C42[0][A] | u_top/u_manual/n4_s0/COUT
6.058 | 0.000 | tNET | RR | 2 | R16C42[0][B] | u_top/u_manual/n5_s0/CIN
6.093 | 0.035 | tINS | RF | 1 | R16C42[0][B] | u_top/u_manual/n5_s0/COUT
6.093 | 0.000 | tNET | FF | 2 | R16C42[1][A] | u_top/u_manual/n6_s0/CIN
6.129 | 0.035 | tINS | FF | 1 | R16C42[1][A] | u_top/u_manual/n6_s0/COUT
6.129 | 0.000 | tNET | FF | 2 | R16C42[1][B] | u_top/u_manual/n7_s0/CIN
6.164 | 0.035 | tINS | FF | 1 | R16C42[1][B] | u_top/u_manual/n7_s0/COUT
6.164 | 0.000 | tNET | FF | 2 | R16C42[2][A] | u_top/u_manual/n8_s0/CIN
6.199 | 0.035 | tINS | FF | 17 | R16C42[2][A] | u_top/u_manual/n8_s0/COUT
6.884 | 0.685 | tNET | FF | 1 | R15C42[3][A] | u_top/ev_word_10_s2/I2
7.401 | 0.517 | tINS | FF | 1 | R15C42[3][A] | u_top/ev_word_10_s2/F
7.891 | 0.490 | tNET | FF | 1 | R15C38[3][A] | u_top/ev_word_10_s1/I1
8.353 | 0.462 | tINS | FR | 6 | R15C38[3][A] | u_top/ev_word_10_s1/F
8.527 | 0.174 | tNET | RR | 1 | R15C37[3][B] | u_top/ev_word_10_s0/I0
8.898 | 0.371 | tINS | RF | 35 | R15C37[3][B] | u_top/ev_word_10_s0/F
13.607 | 4.709 | tNET | FF | 2 | R51C14[1][A] | u_top/u_alloc/n50_s0/I1
14.177 | 0.570 | tINS | FR | 1 | R51C14[1][A] | u_top/u_alloc/n50_s0/COUT
14.177 | 0.000 | tNET | RR | 2 | R51C14[1][B] | u_top/u_alloc/n51_s0/CIN
14.212 | 0.035 | tINS | RF | 1 | R51C14[1][B] | u_top/u_alloc/n51_s0/COUT
14.212 | 0.000 | tNET | FF | 2 | R51C14[2][A] | u_top/u_alloc/n52_s0/CIN
14.247 | 0.035 | tINS | FF | 1 | R51C14[2][A] | u_top/u_alloc/n52_s0/COUT
14.247 | 0.000 | tNET | FF | 2 | R51C14[2][B] | u_top/u_alloc/n53_s0/CIN
14.282 | 0.035 | tINS | FF | 1 | R51C14[2][B] | u_top/u_alloc/n53_s0/COUT
14.282 | 0.000 | tNET | FF | 2 | R51C15[0][A] | u_top/u_alloc/n54_s0/CIN
14.317 | 0.035 | tINS | FF | 3 | R51C15[0][A] | u_top/u_alloc/n54_s0/COUT
16.161 | 1.844 | tNET | FF | 1 | R48C10[3][B] | u_top/u_alloc/pick_0_s44/I0
16.532 | 0.371 | tINS | FF | 3 | R48C10[3][B] | u_top/u_alloc/pick_0_s44/F
16.545 | 0.013 | tNET | FF | 1 | R48C10[2][B] | u_top/u_alloc/pick_0_s21/I3
17.062 | 0.517 | tINS | FF | 2 | R48C10[2][B] | u_top/u_alloc/pick_0_s21/F
17.755 | 0.693 | tNET | FF | 1 | R41C9[3][A] | u_top/u_alloc/pick_0_s9/I3
18.310 | 0.555 | tINS | FF | 3 | R41C9[3][A] | u_top/u_alloc/pick_0_s9/F
19.156 | 0.845 | tNET | FF | 1 | R47C10[3][A] | u_top/u_alloc/pick_0_s23/I2
19.711 | 0.555 | tINS | FF | 7 | R47C10[3][A] | u_top/u_alloc/pick_0_s23/F
20.368 | 0.658 | tNET | FF | 1 | R47C7[0][A] | u_top/u_alloc/pick_0_s49/I1
20.739 | 0.371 | tINS | FF | 4 | R47C7[0][A] | u_top/u_alloc/pick_0_s49/F
21.974 | 1.235 | tNET | FF | 1 | R45C4[1][A] | u_top/u_alloc/pick_2_s100/I0
22.529 | 0.555 | tINS | FF | 1 | R45C4[1][A] | u_top/u_alloc/pick_2_s100/F
22.943 | 0.413 | tNET | FF | 1 | R44C6[3][A] | u_top/u_alloc/pick_2_s80/I3
23.396 | 0.453 | tINS | FF | 3 | R44C6[3][A] | u_top/u_alloc/pick_2_s80/F
23.651 | 0.256 | tNET | FF | 1 | R45C6[3][B] | u_top/u_alloc/pick_2_s43/I2
24.022 | 0.371 | tINS | FF | 2 | R45C6[3][B] | u_top/u_alloc/pick_2_s43/F
24.031 | 0.009 | tNET | FF | 1 | R45C6[3][A] | u_top/u_alloc/pick_2_s18/I1
24.548 | 0.517 | tINS | FF | 2 | R45C6[3][A] | u_top/u_alloc/pick_2_s18/F
25.436 | 0.888 | tNET | FF | 1 | R47C3[1][B] | u_top/u_alloc/pick_2_s9/I0
26.006 | 0.570 | tINS | FR | 2 | R47C3[1][B] | u_top/u_alloc/pick_2_s9/F
26.009 | 0.003 | tNET | RR | 1 | R47C3[1][A] | u_top/u_alloc/pick_2_s2/I3
26.564 | 0.555 | tINS | RF | 4 | R47C3[1][A] | u_top/u_alloc/pick_2_s2/F
26.811 | 0.247 | tNET | FF | 1 | R47C5[0][A] | u_top/u_alloc/pick_0_s0/I0
27.182 | 0.371 | tINS | FF | 29 | R47C5[0][A] | u_top/u_alloc/pick_0_s0/F
29.637 | 2.455 | tNET | FF | 18 | DSP_R37[1][A] | u_top/u_alloc/n453_s1/B[0]
33.277 | 3.640 | tINS | FF | 8 | DSP_R37[1][A] | u_top/u_alloc/n453_s1/DOUT[6]
34.441 | 1.164 | tNET | FF | 1 | R47C15[3][A] | u_top/u_alloc/n3392_s2/I0
34.990 | 0.549 | tINS | FR | 7 | R47C15[3][A] | u_top/u_alloc/n3392_s2/F
35.329 | 0.339 | tNET | RR | 1 | R48C15[1][B] | u_top/u_alloc/v_note_49_s0/CE

Data Required Path:

AT | DELAY | TYPE | RF | FANOUT | LOC | NODE
37.037 | 37.037 | | | | | active clock edge time
37.037 | 0.000 | | | | | clk_27m
37.037 | 0.000 | tCL | RR | 1 | IOT27[A] | clk_27m_ibuf/I
39.125 | 2.088 | tINS | RR | 3750 | IOT27[A] | clk_27m_ibuf/O
41.396 | 2.271 | tNET | RR | 1 | R48C15[1][B] | u_top/u_alloc/v_note_49_s0/CLK
41.361 | -0.035 | tSu | | 1 | R48C15[1][B] | u_top/u_alloc/v_note_49_s0

Path Statistics:

Clock Skew | 0.000
Setup Relationship | 37.037
Logic Level | 23
Arrival Clock Path Delay | cell: 2.088, 47.897%; route: 2.271, 52.103%
Arrival Data Path Delay | cell: 12.722, 41.078%; route: 18.016, 58.173%; tC2Q: 0.232, 0.749%
Required Clock Path Delay | cell: 2.088, 47.897%; route: 2.271, 52.103%

### Path16

Path Summary:

Slack | 6.032
Data Arrival Time | 35.329
Data Required Time | 41.361
From | u_top/u_manual/rd_ptr_0_s0
To | u_top/u_alloc/v_note_50_s0
Launch Clk | clk_27m:[R]
Latch Clk | clk_27m:[R]

Data Arrival Path:

AT | DELAY | TYPE | RF | FANOUT | LOC | NODE
0.000 | 0.000 | | | | | active clock edge time
0.000 | 0.000 | | | | | clk_27m
0.000 | 0.000 | tCL | RR | 1 | IOT27[A] | clk_27m_ibuf/I
2.088 | 2.088 | tINS | RR | 3750 | IOT27[A] | clk_27m_ibuf/O
4.359 | 2.271 | tNET | RR | 1 | R22C42[0][A] | u_top/u_manual/rd_ptr_0_s0/CLK
4.591 | 0.232 | tC2Q | RF | 7 | R22C42[0][A] | u_top/u_manual/rd_ptr_0_s0/Q
5.488 | 0.897 | tNET | FF | 2 | R16C42[0][A] | u_top/u_manual/n4_s0/I1
6.058 | 0.570 | tINS | FR | 1 | R16C42[0][A] | u_top/u_manual/n4_s0/COUT
6.058 | 0.000 | tNET | RR | 2 | R16C42[0][B] | u_top/u_manual/n5_s0/CIN
6.093 | 0.035 | tINS | RF | 1 | R16C42[0][B] | u_top/u_manual/n5_s0/COUT
6.093 | 0.000 | tNET | FF | 2 | R16C42[1][A] | u_top/u_manual/n6_s0/CIN
6.129 | 0.035 | tINS | FF | 1 | R16C42[1][A] | u_top/u_manual/n6_s0/COUT
6.129 | 0.000 | tNET | FF | 2 | R16C42[1][B] | u_top/u_manual/n7_s0/CIN
6.164 | 0.035 | tINS | FF | 1 | R16C42[1][B] | u_top/u_manual/n7_s0/COUT
6.164 | 0.000 | tNET | FF | 2 | R16C42[2][A] | u_top/u_manual/n8_s0/CIN
6.199 | 0.035 | tINS | FF | 17 | R16C42[2][A] | u_top/u_manual/n8_s0/COUT
6.884 | 0.685 | tNET | FF | 1 | R15C42[3][A] | u_top/ev_word_10_s2/I2
7.401 | 0.517 | tINS | FF | 1 | R15C42[3][A] | u_top/ev_word_10_s2/F
7.891 | 0.490 | tNET | FF | 1 | R15C38[3][A] | u_top/ev_word_10_s1/I1
8.353 | 0.462 | tINS | FR | 6 | R15C38[3][A] | u_top/ev_word_10_s1/F
8.527 | 0.174 | tNET | RR | 1 | R15C37[3][B] | u_top/ev_word_10_s0/I0
8.898 | 0.371 | tINS | RF | 35 | R15C37[3][B] | u_top/ev_word_10_s0/F
13.607 | 4.709 | tNET | FF | 2 | R51C14[1][A] | u_top/u_alloc/n50_s0/I1
14.177 | 0.570 | tINS | FR | 1 | R51C14[1][A] | u_top/u_alloc/n50_s0/COUT
14.177 | 0.000 | tNET | RR | 2 | R51C14[1][B] | u_top/u_alloc/n51_s0/CIN
14.212 | 0.035 | tINS | RF | 1 | R51C14[1][B] | u_top/u_alloc/n51_s0/COUT
14.212 | 0.000 | tNET | FF | 2 | R51C14[2][A] | u_top/u_alloc/n52_s0/CIN
14.247 | 0.035 | tINS | FF | 1 | R51C14[2][A] | u_top/u_alloc/n52_s0/COUT
14.247 | 0.000 | tNET | FF | 2 | R51C14[2][B] | u_top/u_alloc/n53_s0/CIN
14.282 | 0.035 | tINS | FF | 1 | R51C14[2][B] | u_top/u_alloc/n53_s0/COUT
14.282 | 0.000 | tNET | FF | 2 | R51C15[0][A] | u_top/u_alloc/n54_s0/CIN
14.317 | 0.035 | tINS | FF | 3 | R51C15[0][A] | u_top/u_alloc/n54_s0/COUT
16.161 | 1.844 | tNET | FF | 1 | R48C10[3][B] | u_top/u_alloc/pick_0_s44/I0
16.532 | 0.371 | tINS | FF | 3 | R48C10[3][B] | u_top/u_alloc/pick_0_s44/F
16.545 | 0.013 | tNET | FF | 1 | R48C10[2][B] | u_top/u_alloc/pick_0_s21/I3
17.062 | 0.517 | tINS | FF | 2 | R48C10[2][B] | u_top/u_alloc/pick_0_s21/F
17.755 | 0.693 | tNET | FF | 1 | R41C9[3][A] | u_top/u_alloc/pick_0_s9/I3
18.310 | 0.555 | tINS | FF | 3 | R41C9[3][A] | u_top/u_alloc/pick_0_s9/F
19.156 | 0.845 | tNET | FF | 1 | R47C10[3][A] | u_top/u_alloc/pick_0_s23/I2
19.711 | 0.555 | tINS | FF | 7 | R47C10[3][A] | u_top/u_alloc/pick_0_s23/F
20.368 | 0.658 | tNET | FF | 1 | R47C7[0][A] | u_top/u_alloc/pick_0_s49/I1
20.739 | 0.371 | tINS | FF | 4 | R47C7[0][A] | u_top/u_alloc/pick_0_s49/F
21.974 | 1.235 | tNET | FF | 1 | R45C4[1][A] | u_top/u_alloc/pick_2_s100/I0
22.529 | 0.555 | tINS | FF | 1 | R45C4[1][A] | u_top/u_alloc/pick_2_s100/F
22.943 | 0.413 | tNET | FF | 1 | R44C6[3][A] | u_top/u_alloc/pick_2_s80/I3
23.396 | 0.453 | tINS | FF | 3 | R44C6[3][A] | u_top/u_alloc/pick_2_s80/F
23.651 | 0.256 | tNET | FF | 1 | R45C6[3][B] | u_top/u_alloc/pick_2_s43/I2
24.022 | 0.371 | tINS | FF | 2 | R45C6[3][B] | u_top/u_alloc/pick_2_s43/F
24.031 | 0.009 | tNET | FF | 1 | R45C6[3][A] | u_top/u_alloc/pick_2_s18/I1
24.548 | 0.517 | tINS | FF | 2 | R45C6[3][A] | u_top/u_alloc/pick_2_s18/F
25.436 | 0.888 | tNET | FF | 1 | R47C3[1][B] | u_top/u_alloc/pick_2_s9/I0
26.006 | 0.570 | tINS | FR | 2 | R47C3[1][B] | u_top/u_alloc/pick_2_s9/F
26.009 | 0.003 | tNET | RR | 1 | R47C3[1][A] | u_top/u_alloc/pick_2_s2/I3
26.564 | 0.555 | tINS | RF | 4 | R47C3[1][A] | u_top/u_alloc/pick_2_s2/F
26.811 | 0.247 | tNET | FF | 1 | R47C5[0][A] | u_top/u_alloc/pick_0_s0/I0
27.182 | 0.371 | tINS | FF | 29 | R47C5[0][A] | u_top/u_alloc/pick_0_s0/F
29.637 | 2.455 | tNET | FF | 18 | DSP_R37[1][A] | u_top/u_alloc/n453_s1/B[0]
33.277 | 3.640 | tINS | FF | 8 | DSP_R37[1][A] | u_top/u_alloc/n453_s1/DOUT[6]
34.441 | 1.164 | tNET | FF | 1 | R47C15[3][A] | u_top/u_alloc/n3392_s2/I0
34.990 | 0.549 | tINS | FR | 7 | R47C15[3][A] | u_top/u_alloc/n3392_s2/F
35.329 | 0.339 | tNET | RR | 1 | R48C15[2][A] | u_top/u_alloc/v_note_50_s0/CE

Data Required Path:

AT | DELAY | TYPE | RF | FANOUT | LOC | NODE
37.037 | 37.037 | | | | | active clock edge time
37.037 | 0.000 | | | | | clk_27m
37.037 | 0.000 | tCL | RR | 1 | IOT27[A] | clk_27m_ibuf/I
39.125 | 2.088 | tINS | RR | 3750 | IOT27[A] | clk_27m_ibuf/O
41.396 | 2.271 | tNET | RR | 1 | R48C15[2][A] | u_top/u_alloc/v_note_50_s0/CLK
41.361 | -0.035 | tSu | | 1 | R48C15[2][A] | u_top/u_alloc/v_note_50_s0

Path Statistics:

Clock Skew | 0.000
Setup Relationship | 37.037
Logic Level | 23
Arrival Clock Path Delay | cell: 2.088, 47.897%; route: 2.271, 52.103%
Arrival Data Path Delay | cell: 12.722, 41.078%; route: 18.016, 58.173%; tC2Q: 0.232, 0.749%
Required Clock Path Delay | cell: 2.088, 47.897%; route: 2.271, 52.103%

### Path17

Path Summary:

Slack | 6.032
Data Arrival Time | 35.329
Data Required Time | 41.361
From | u_top/u_manual/rd_ptr_0_s0
To | u_top/u_alloc/v_note_51_s0
Launch Clk | clk_27m:[R]
Latch Clk | clk_27m:[R]

Data Arrival Path:

AT | DELAY | TYPE | RF | FANOUT | LOC | NODE
0.000 | 0.000 | | | | | active clock edge time
0.000 | 0.000 | | | | | clk_27m
0.000 | 0.000 | tCL | RR | 1 | IOT27[A] | clk_27m_ibuf/I
2.088 | 2.088 | tINS | RR | 3750 | IOT27[A] | clk_27m_ibuf/O
4.359 | 2.271 | tNET | RR | 1 | R22C42[0][A] | u_top/u_manual/rd_ptr_0_s0/CLK
4.591 | 0.232 | tC2Q | RF | 7 | R22C42[0][A] | u_top/u_manual/rd_ptr_0_s0/Q
5.488 | 0.897 | tNET | FF | 2 | R16C42[0][A] | u_top/u_manual/n4_s0/I1
6.058 | 0.570 | tINS | FR | 1 | R16C42[0][A] | u_top/u_manual/n4_s0/COUT
6.058 | 0.000 | tNET | RR | 2 | R16C42[0][B] | u_top/u_manual/n5_s0/CIN
6.093 | 0.035 | tINS | RF | 1 | R16C42[0][B] | u_top/u_manual/n5_s0/COUT
6.093 | 0.000 | tNET | FF | 2 | R16C42[1][A] | u_top/u_manual/n6_s0/CIN
6.129 | 0.035 | tINS | FF | 1 | R16C42[1][A] | u_top/u_manual/n6_s0/COUT
6.129 | 0.000 | tNET | FF | 2 | R16C42[1][B] | u_top/u_manual/n7_s0/CIN
6.164 | 0.035 | tINS | FF | 1 | R16C42[1][B] | u_top/u_manual/n7_s0/COUT
6.164 | 0.000 | tNET | FF | 2 | R16C42[2][A] | u_top/u_manual/n8_s0/CIN
6.199 | 0.035 | tINS | FF | 17 | R16C42[2][A] | u_top/u_manual/n8_s0/COUT
6.884 | 0.685 | tNET | FF | 1 | R15C42[3][A] | u_top/ev_word_10_s2/I2
7.401 | 0.517 | tINS | FF | 1 | R15C42[3][A] | u_top/ev_word_10_s2/F
7.891 | 0.490 | tNET | FF | 1 | R15C38[3][A] | u_top/ev_word_10_s1/I1
8.353 | 0.462 | tINS | FR | 6 | R15C38[3][A] | u_top/ev_word_10_s1/F
8.527 | 0.174 | tNET | RR | 1 | R15C37[3][B] | u_top/ev_word_10_s0/I0
8.898 | 0.371 | tINS | RF | 35 | R15C37[3][B] | u_top/ev_word_10_s0/F
13.607 | 4.709 | tNET | FF | 2 | R51C14[1][A] | u_top/u_alloc/n50_s0/I1
14.177 | 0.570 | tINS | FR | 1 | R51C14[1][A] | u_top/u_alloc/n50_s0/COUT
14.177 | 0.000 | tNET | RR | 2 | R51C14[1][B] | u_top/u_alloc/n51_s0/CIN
14.212 | 0.035 | tINS | RF | 1 | R51C14[1][B] | u_top/u_alloc/n51_s0/COUT
14.212 | 0.000 | tNET | FF | 2 | R51C14[2][A] | u_top/u_alloc/n52_s0/CIN
14.247 | 0.035 | tINS | FF | 1 | R51C14[2][A] | u_top/u_alloc/n52_s0/COUT
14.247 | 0.000 | tNET | FF | 2 | R51C14[2][B] | u_top/u_alloc/n53_s0/CIN
14.282 | 0.035 | tINS | FF | 1 | R51C14[2][B] | u_top/u_alloc/n53_s0/COUT
14.282 | 0.000 | tNET | FF | 2 | R51C15[0][A] | u_top/u_alloc/n54_s0/CIN
14.317 | 0.035 | tINS | FF | 3 | R51C15[0][A] | u_top/u_alloc/n54_s0/COUT
16.161 | 1.844 | tNET | FF | 1 | R48C10[3][B] | u_top/u_alloc/pick_0_s44/I0
16.532 | 0.371 | tINS | FF | 3 | R48C10[3][B] | u_top/u_alloc/pick_0_s44/F
16.545 | 0.013 | tNET | FF | 1 | R48C10[2][B] | u_top/u_alloc/pick_0_s21/I3
17.062 | 0.517 | tINS | FF | 2 | R48C10[2][B] | u_top/u_alloc/pick_0_s21/F
17.755 | 0.693 | tNET | FF | 1 | R41C9[3][A] | u_top/u_alloc/pick_0_s9/I3
18.310 | 0.555 | tINS | FF | 3 | R41C9[3][A] | u_top/u_alloc/pick_0_s9/F
19.156 | 0.845 | tNET | FF | 1 | R47C10[3][A] | u_top/u_alloc/pick_0_s23/I2
19.711 | 0.555 | tINS | FF | 7 | R47C10[3][A] | u_top/u_alloc/pick_0_s23/F
20.368 | 0.658 | tNET | FF | 1 | R47C7[0][A] | u_top/u_alloc/pick_0_s49/I1
20.739 | 0.371 | tINS | FF | 4 | R47C7[0][A] | u_top/u_alloc/pick_0_s49/F
21.974 | 1.235 | tNET | FF | 1 | R45C4[1][A] | u_top/u_alloc/pick_2_s100/I0
22.529 | 0.555 | tINS | FF | 1 | R45C4[1][A] | u_top/u_alloc/pick_2_s100/F
22.943 | 0.413 | tNET | FF | 1 | R44C6[3][A] | u_top/u_alloc/pick_2_s80/I3
23.396 | 0.453 | tINS | FF | 3 | R44C6[3][A] | u_top/u_alloc/pick_2_s80/F
23.651 | 0.256 | tNET | FF | 1 | R45C6[3][B] | u_top/u_alloc/pick_2_s43/I2
24.022 | 0.371 | tINS | FF | 2 | R45C6[3][B] | u_top/u_alloc/pick_2_s43/F
24.031 | 0.009 | tNET | FF | 1 | R45C6[3][A] | u_top/u_alloc/pick_2_s18/I1
24.548 | 0.517 | tINS | FF | 2 | R45C6[3][A] | u_top/u_alloc/pick_2_s18/F
25.436 | 0.888 | tNET | FF | 1 | R47C3[1][B] | u_top/u_alloc/pick_2_s9/I0
26.006 | 0.570 | tINS | FR | 2 | R47C3[1][B] | u_top/u_alloc/pick_2_s9/F
26.009 | 0.003 | tNET | RR | 1 | R47C3[1][A] | u_top/u_alloc/pick_2_s2/I3
26.564 | 0.555 | tINS | RF | 4 | R47C3[1][A] | u_top/u_alloc/pick_2_s2/F
26.811 | 0.247 | tNET | FF | 1 | R47C5[0][A] | u_top/u_alloc/pick_0_s0/I0
27.182 | 0.371 | tINS | FF | 29 | R47C5[0][A] | u_top/u_alloc/pick_0_s0/F
29.637 | 2.455 | tNET | FF | 18 | DSP_R37[1][A] | u_top/u_alloc/n453_s1/B[0]
33.277 | 3.640 | tINS | FF | 8 | DSP_R37[1][A] | u_top/u_alloc/n453_s1/DOUT[6]
34.441 | 1.164 | tNET | FF | 1 | R47C15[3][A] | u_top/u_alloc/n3392_s2/I0
34.990 | 0.549 | tINS | FR | 7 | R47C15[3][A] | u_top/u_alloc/n3392_s2/F
35.329 | 0.339 | tNET | RR | 1 | R48C15[2][B] | u_top/u_alloc/v_note_51_s0/CE

Data Required Path:

AT | DELAY | TYPE | RF | FANOUT | LOC | NODE
37.037 | 37.037 | | | | | active clock edge time
37.037 | 0.000 | | | | | clk_27m
37.037 | 0.000 | tCL | RR | 1 | IOT27[A] | clk_27m_ibuf/I
39.125 | 2.088 | tINS | RR | 3750 | IOT27[A] | clk_27m_ibuf/O
41.396 | 2.271 | tNET | RR | 1 | R48C15[2][B] | u_top/u_alloc/v_note_51_s0/CLK
41.361 | -0.035 | tSu | | 1 | R48C15[2][B] | u_top/u_alloc/v_note_51_s0

Path Statistics:

Clock Skew | 0.000
Setup Relationship | 37.037
Logic Level | 23
Arrival Clock Path Delay | cell: 2.088, 47.897%; route: 2.271, 52.103%
Arrival Data Path Delay | cell: 12.722, 41.078%; route: 18.016, 58.173%; tC2Q: 0.232, 0.749%
Required Clock Path Delay | cell: 2.088, 47.897%; route: 2.271, 52.103%
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
