Interstellar-530/PolyTouch-FPGA-Synth/evidence/2026/10/FPGA-优化04-仲裁路径-20261021/build_reports/instrument_tr_content.html

# Timing Messages

Report Title | Timing Analysis Report
Design File | E:\Working Space\FPGA\output\handoff_milestone2_20261008\source\build\gowin_top_dbg8usb\runs\20261021T163802630-2bf3ab3a\instrument\impl\gwsynthesis\instrument.vg
Physical Constraints File | E:\Working Space\FPGA\output\handoff_milestone2_20261008\source\constraints\primer20k_dock3714_usb.cst
Timing Constraint File | E:\Working Space\FPGA\output\handoff_milestone2_20261008\source\constraints\primer20k.sdc
Tool Version | V1.9.11.03 Education
Part Number | GW2A-LV18PG256C8/I7
Device | GW2A-18
Device Version | C
Created Time | Wed Oct 21 16:39:26 2026
Legal Announcement | Copyright (C)2014-2025 Gowin Semiconductor Corporation. All rights reserved.

# Timing Summaries

## STA Tool Run Summary:

Setup Delay Model | Slow 0.95V 85C C8/I7
Hold Delay Model | Fast 1.05V 0C C8/I7
Numbers of Paths Analyzed | 11478
Numbers of Endpoints Analyzed | 11118
Numbers of Falling Endpoints | 0
Numbers of Setup Violated Endpoints | 0
Numbers of Hold Violated Endpoints | 0

## Clock Summary:

NO. | Clock Name | Type | Period | Frequency(MHz) | Rise | Fall | Source | Master | Objects
1 | clk_27m | Base | 37.037 | 27.000 | 0.000 | 18.518 | | | clk_27m
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
