Interstellar-530/PolyTouch-FPGA-Synth/evidence/2026/10/FPGA-S4-S6-本机审查-20261016-v0.1/wiring-layout-preview.jpg

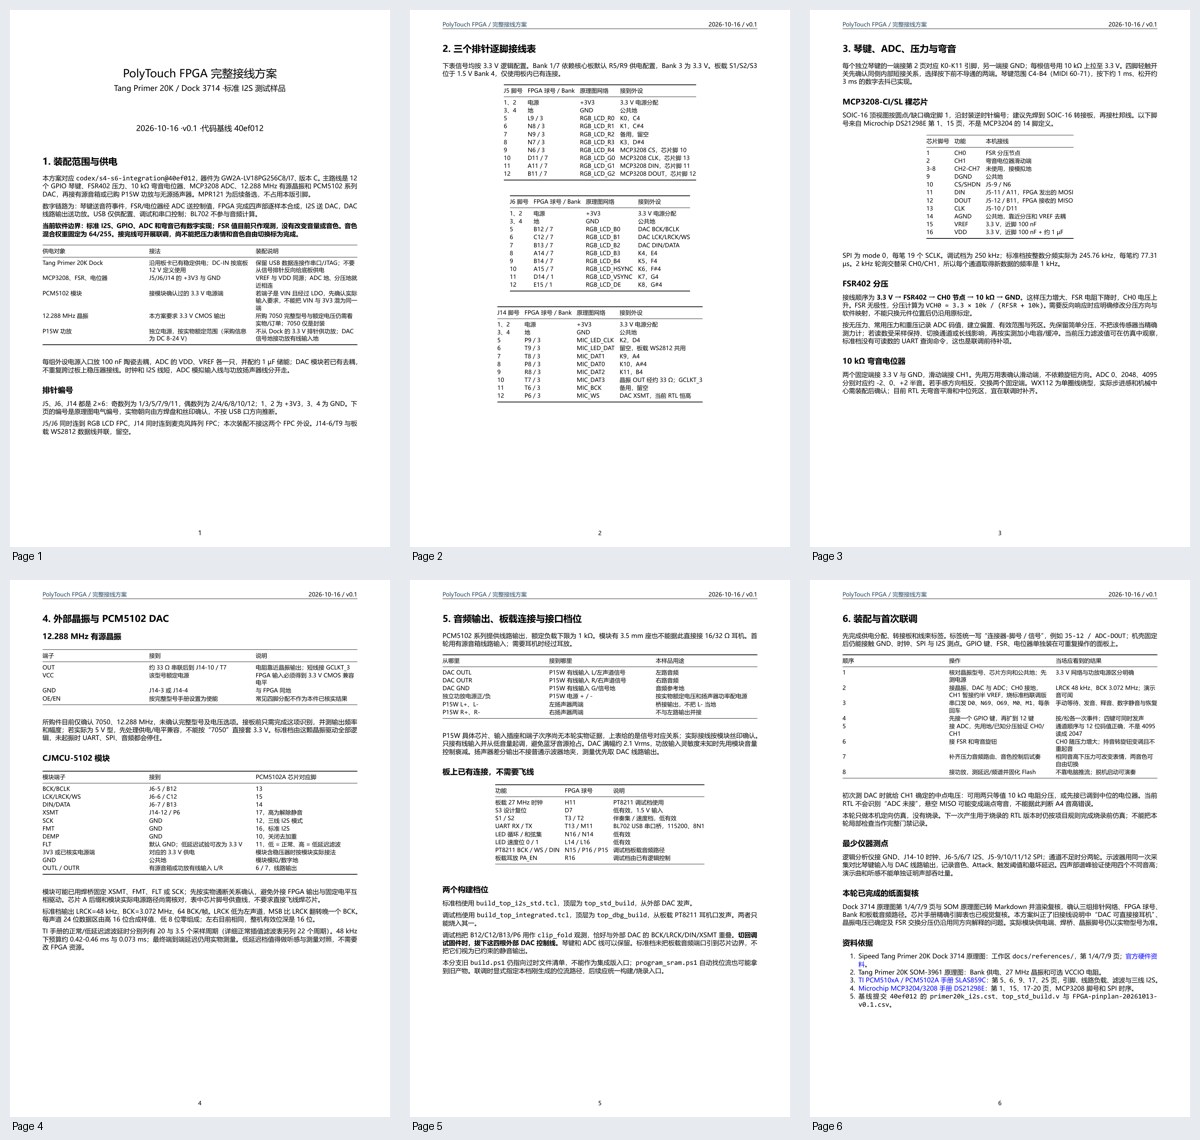
evidence/2026/10/FPGA-S4-S6-本机审查-20261016-v0.1/wiring-layout-preview.jpg
