Interstellar-530/PolyTouch-FPGA-Synth/experiments/2026/10/FPGA-20261027-hid-review-v0.1/evidence/validation.txt

Validation date: 2026-10-27 (Asia/Shanghai)

PASS: keyboard.ps1 -SelfTest
  PASS keyboard: press/release, chord, panic, range, octave, piano keys and dashboard parser

PASS: render_preview.ps1
  PASS: GUI compiled and rendered without opening a serial connection.

PASS: F7 debounce and HDMI fallback source build
  Covered by the same Windows PowerShell GUI compile and keyboard self-test after the f7Held latch and SerialTransport disposal changes.

PASS: RTL regression, serial run
  80 positive benches and 6 I2S parameter negative cases passed with -SkipAudioCapture; the earlier Icarus access violation did not recur.

PASS: long audio capture
  tb_audio_capture: 58880 frames, native tick, independent PT8211 decode, UART/ADSR/mute/chord.

LIMITATION: the two regression invocations were aggregated: the short run covered 80+6, then the no-skip run was stopped after the independently passing tb_audio_capture before repeating the remaining benches. There is no single no-skip process exit record.
LIMITATION: Gowin PnR/programming was not run because gw_sh.exe was unavailable. No v0.3 bitstream is approved for programming.
