Interstellar-530/PolyTouch-FPGA-Synth/evidence/2026/10/FPGA-优化05审核-20261021-v0.1/audio/guitar/null_test.txt

kind            : guitar
notes           : [40, 52, 64, 71, 80, 88]
velocity        : 100   tone=0
seconds/note    : 0.7
before tables   : 36
after tables    : 30
diff RMS        :  -400.00 dB re before
diff peak       :  -400.00 dB re before peak
audibility      : not tested; relative dB is not a hearing threshold or dBFS
model           : approximate table playback, integer interpolation, synthetic envelope
stage samples   : 5859

ab.wav   : before (0.7 s x 6 notes) -> silence -> after, same phrase
diff.wav : (after - before) boosted +40 dB, same length as one phrase
before.wav / after.wav : individual phrases
