Interstellar-530/PolyTouch-FPGA-Synth/experiments/README.md

# 独立实验和候选

按年、月和版本日期保存。目录日期是该快照对应提交的日期；原分支名只用于来源追溯。这里的工程不直接替代根目录 source。

2026-10-27 的 hdmi-import 保留了旧根目录独立副本，hid-review 保留了原已入库审核归档，均保持原字节。其他独有候选保存 source.zip、changes.patch、来源提交及校验记录；完整复现使用原提交的独立工作树。

| 日期 | 候选来源 | 独有提交数 |
|---|---|---|
| 2026-10-08 | `origin/fix/m2-build-issues` | 1 |
| 2026-10-15 | `origin/codex/s4-s6-review` | 6 |
| 2026-10-22 | `origin/codex/optimization07-watchdog-20261022` | 2 |
| 2026-10-22 | `origin/codex/guitar-preview-ddr3-20261020` | 2 |

详细提交列表见[分支清单](../evidence/2026/11/FPGA-20261101-reorganization-v0.1/branch-inventory.json)。已合并阶段快照另见[版本时间线](../docs/history/VERSIONS.md)。
