Interstellar-530/PolyTouch-FPGA-Synth/experiments/2026/10/FPGA-20261015-s4-s6-review-v0.1/README.md

# 20261015 / s4-s6-review

来源 `origin/codex/s4-s6-review`，提交 `36ea1e4a72bd9d9c18a5f04e790b3564a3456616`。相对最终基线有 6 个独有提交；属于历史分支候选，未按日期机械合入当前工程。

完整版本可运行 `git worktree add --detach <独立目录> 36ea1e4a72bd9d9c18a5f04e790b3564a3456616`。`source.zip` 保留该提交的源码快照（含原路径）。`changes.patch` 仅展示独有提交相对最终基线的共同祖先以来差异。
