Interstellar-530/PolyTouch-FPGA-Synth/experiments/2026/10/FPGA-20261022-guitar-preview-ddr3-20261020-v0.1/README.md

# 20261022 / guitar-preview-ddr3-20261020

来源 `origin/codex/guitar-preview-ddr3-20261020`，提交 `881a11cc1e2024e297c343e2345173613e0339f5`。相对最终基线有 2 个独有提交；属于历史分支候选，未按日期机械合入当前工程。

完整版本可运行 `git worktree add --detach <独立目录> 881a11cc1e2024e297c343e2345173613e0339f5`。`source.zip` 保留该提交的源码快照（含原路径）。`changes.patch` 仅展示独有提交相对最终基线的共同祖先以来差异。
