Interstellar-530/PolyTouch-FPGA-Synth/experiments/2026/10/FPGA-20261022-optimization07-watchdog-20261022-v0.1/README.md

# 20261022 / optimization07-watchdog-20261022

来源 `origin/codex/optimization07-watchdog-20261022`，提交 `8e77ddebd23a8586a29acc5eaf006b943d49bdbf`。相对最终基线有 2 个独有提交；属于历史分支候选，未按日期机械合入当前工程。

完整版本可运行 `git worktree add --detach <独立目录> 8e77ddebd23a8586a29acc5eaf006b943d49bdbf`。`source.zip` 保留该提交的源码快照（含原路径）。`changes.patch` 仅展示独有提交相对最终基线的共同祖先以来差异。
