Interstellar-530/PolyTouch-FPGA-Synth/experiments/2026/10/FPGA-20261027-hid-review-v0.1/output/README.md

# Output status

This archive contains source and verification evidence for the HDMI/PC dashboard route. It intentionally contains no generated bitstream. Run the `hdmi` profile after installing Gowin tools and review timing/resource reports before SRAM or Flash programming.
