Interstellar-530/PolyTouch-FPGA-Synth/evidence/2026/10/FPGA-板载联调-20261018-v0.1/capture-test-sha256.txt

DC70197D44C45158A1EBD0BA9DD30E3D2CCB36A92BAFD7F95AA2EA374CC660D2
