Interstellar-530/PolyTouch-FPGA-Synth/docs/history/FPGA-32声部控制接口-20261023-v0.1.md

# 32 声部完整演奏控制：接口表与实施方案（待确认）

日期：2026-10-23。对象：`rtl/prototypes/ram32_clocked_top.v`、`ram32_top.v`、`voice_sched32.v`、`instrument_ram_audio_compute.v`、`wide_master.v`；控制侧复用 `rtl/audio/pressure_bend.v`、`instrument_controls.v`、`top.v` 的既有算法。
状态：**历史实施方案，核心已实现并于2026-10-23完成修复验收**。最终实现的控制快照为51位（包含已派生的音量增益和弯音比率），音高/弯音及主增益使用内部流水。本文下方保留原方案与估算；实际接口、资源、时序和验证结论以[核心修复报告](../reviews/FPGA-32声部核心修复-20261023-v0.1.md)及v0.8归档为准。32声部板级档和灯光仍待办。

## 1. 现状与缺口

| 位置 | 现状 | 缺口 |
|---|---|---|
| `ram32_clocked_top` / `ram32_top` | `instrument_ram_audio_*` 的 `mix_weight=8'hff`、`pressure_enable=0`、`pressure_level=0`、`mute=0` 全部硬接 | 主音量、静音、持续压力都接不进去 |
| `voice_sched32` | `piano_tone[1:0]`；`start_stage=(tone>=3)?4:3` | 5 档若截成 2 位，tone=4 会变成 0，第 5 档直接丢失 |
| `voice_sched32` | `cfg_increment = note_phase_inc(note)` 原值 | 弯音没有施加点 |
| 慢控制跨域 | 只有 3 位 `{instrument,piano_tone}` 的"两拍一致"滤波 | 41 位控制束不能按位同步后声称原子；需要快照握手 |
| `wide_master` | 已有 `mix_weight`/`pressure_enable`/`pressure_level`/`mute`，压力 Q12 增益 1024..4096、每帧 ±32 平滑、`mute` 强制 0 | 接口已存在，不需要新算法，只需要接上 |

## 2. 接口表（新增/变更）

时钟域：`ref` = 12.288 MHz（`ram32_clocked_top`）或唯一 49.152 MHz（`ram32_top`）；`cmp` = PLL 计算域。生产侧所有控制量都在音频域（生产 `top.v` 的 `clk_audio`），跨到 `ref` 由顶层再做一次 2FF（准静态量，无需握手）。

| 编号 | 信号 | 位宽 | 单位/取值 | 默认 | 更新时机 | 目标域 | 一致性 |
|---|---|---|---|---|---|---|---|
| C1 | `instrument` | 1 | 0=钢琴，1=吉他 | 0 | F6 / 串口 I0、I1 | cmp | 控制快照握手 |
| C2 | `piano_tone` | **3**（原 2） | 0..4 = 生产 F1..F5（`timbre_target-250`） | 0 | F1..F5 | cmp | 快照；**禁止截位** |
| C3 | `volume_target` | 7 | 0..100，生产主音量 | 100 | Up/Down、串口 V | cmp | 快照 |
| C4 | `mute` | 1 | 1=数字静音 | 0 | Esc/串口 M/切换拍 | cmp | 快照 |
| C5 | `pressure_enable` | 1 | 1=压力增益生效 | 1 | 构建参数（准静态） | cmp | 快照 |
| C6 | `pressure_level` | 12 | ADC 码 0..4095；`wide_master` 内部把 128..3200 映到 Q12 增益 1024..4096 | 3200 | `control_tick` 2 kHz | cmp | 快照；慢变化 |
| C7 | `bend_q8` | 16 signed | -512..512 = ±2 半音（Q8） | 0 | `control_tick` 2 kHz | cmp | 快照 |
| C8 | `bend_ratio_q16` | 17 | ≈58363..73555（±2 半音的 Q16 比率） | 65536 | 随 C7 重算 | cmp（内部） | 派生量 |
| C9 | `ev_on/note/vel` | 1+7+8 | MIDI 音高、力度 | — | 按键 | ref→cmp | **已有 4 相握手**，不改 |

### 2.1 控制束的原子性（取代按位滤波）

- 打包：`{instrument, piano_tone[2:0], volume[6:0], mute, pressure_enable, pressure_level[11:0], bend_q8[15:0]}`，共 **41 位**。
- `ref` 域寄存整束，翻转 `cfg_req`（toggle）；`cmp` 域 2FF 同步 `cfg_req`，检测到翻转后**整束一次性锁存**，再翻转 `cfg_ack` 回 `ref`。
- `ref` 侧在收到 `cfg_ack` 前保持整束不变，因此 `cmp` 锁存时 41 位同时有效——这提供真正的多位原子性，而不是"每根线两次采样一致"。
- 代价：`ref` 侧最多多保持 1 个 `ref` 周期；`cmp` 侧新增 41 个锁存寄存器（约 41 FF）+ 4 个同步 FF。
- 更新率：2 kHz 控制节拍下最多 1 束/500 µs，握手往返约 0.2 µs，余量充足。

### 2.2 弯音施加点

`voice_sched32` 在提交 `cfg_increment` 时做一次 `cfg_increment = base_inc × bend_ratio_q16 >> 16`：

| 项目 | 方案 |
|---|---|
| 乘法 | 1 个 `MULTALU36X18`（32 位增量 × 17 位比率），只在配置事务里用，不逐样本 |
| 舍入 | `+0x8000` 后 `>>16`（半上位取整），与生产 `phase_inc_out` 口径一致 |
| 饱和 | 结果限制在 `1..32'hFFFF_FFFF`；比率下限 0.891，不会到 0 |
| 刷新 | 弯音值变化且 `|Δratio| ≥ 32`（≈0.05 音分）时，把全部活动声部标脏，一帧内刷完（32 声部 × ~3 拍 ≈ 96 拍） |
| 不动的东西 | 弯音**不重触发**包络、不改 `cfg_mask` 的 retrigger 位；只改增量 |
| 起音分离 | 起音参数（attack/decay/velocity/bank）仍只在 Note On 时提交；持续表情（压力、音量、弯音）走独立路径 |

## 3. 五档音色的处理（需要选一个）

生产 `shared_wavetable_engine.v` 里同样是 `start_stage=(piano_tone>=3)?4:3`，所以**生产今天也只有两种起始阶段**，F1–F5 名义五档、听感两档。

| 选项 | 做法 | 影响 |
|---|---|---|
| **A（保真，推荐默认）** | `piano_tone` 全链路改 3 位直通，`start_stage=(tone>=3)?4:3` 原样保留 | 第 5 档作为数值完整保留、可测（0..4 都进引擎），但 tone=4 与 tone=3 同音——与生产完全一致，不是原型退步 |
| B（增强） | 5 档映射到 5 个钢琴 bank（bank 基址 0/1/2/3/5），听感真正五档 | 偏离生产语义；`note>=78` 组基址 +6 会与吉他 bank 12+ 冲突，要额外限制 |

选 A 时验收写"0..4 五档全部到达引擎且不截位，3 与 4 同 `start_stage` 属生产既有语义"；选 B 需要先确认可以偏离生产音色。

## 4. 主音量与静音的落点（需要选一个）

| 选项 | 做法 | 资源 | 保真度 |
|---|---|---|---|
| **A（推荐）** | 复用 `wide_master` 的 Q12 `frame_gain`：`combined_q12 = (pressure_gain_q12 × volume_gain_q8) >> 8`，音量仍按 ±1/帧 斜坡（生产 `volume` 同款），`mute` 直接给 0 | 1 个 13×9 乘（每帧一次），不占额外 DSP（走 ALU/LUT） | 与生产"压力增益 × 主音量"级联等价，差 ≤1 LSB |
| B | 生产式后置：24 位 × 9 位 `>>8` 再饱和 | 需 1–2 个额外 18×18 | 与生产逐位更接近，但 32 声部下 DSP 更紧 |

A 与 B 都满足"0 音量/静音收敛到精确 0"：`volume=0 → gain=0`，乘法结果严格 0，且增益本身已有 ±32/帧斜坡，不会爆音。

## 5. 资源与帧预算（改前估算，实施后必须重测）

| 项 | 现状（`ram32c` 报告） | 改后估算 |
|---|---|---|
| BSRAM | 26/46 | **26/46 不变**（不新增波表、不加帧缓存） |
| 18×18 等效 | 1–2 / 24 | +1 `MULTALU36X18`（弯音）≈ 3 / 24；主音量按选项 A 不加 DSP |
| Logic | 5 361 / 20 736 | +400~700（41 位控制锁存、快照握手、弯音乘法外围） |
| 寄存器 | 2 627 / 16 173 | +约 120 |
| 帧预算（48 kHz，73.728 MHz 下 1 536 拍） | 渲染末周期 672，含配置最坏 702 | 702 + 弯音刷新 32×3 ≈ **800 拍**，余量 ~48%（目标 ≥25%） |

> 19 拍/声部是修正后调度，不套用早期 16 拍/576 拍数据；以上数字实施后以新的 PnR/仿真实测为准。

## 6. 延迟目标（分开记录）

| 路径 | 目标 | 估算 |
|---|---|---|
| 单事件 → 对应 I2S 帧 | ≤4 个采样周期（≈83 µs） | 事件握手 ~10 个 ref 拍 + 调度扫描 32 拍 + 下一帧渲染，约 2 帧 |
| 32 事件突发全部响应 | ≤1 ms（48 帧） | 32 × (握手 ~10 ref 拍 ≈ 0.8 µs) + 32 × 扫描 ≈ 30 µs |
| 队列等待 / UART / Attack | 分开统计 | 仿真里分别打点，不合并成一个数 |

## 7. 实施顺序（确认后执行）

1. 新增 `ram32_control_front.v`：41 位控制束快照 + toggle 握手 + `volume` 斜坡 + `volume_gain` 表（复用生产表）。
2. `voice_sched32`：`piano_tone` 扩到 3 位；新增 `bend_ratio_q16` 输入、`cfg_increment` 乘法与饱和；弯音变化时整帧刷脏。
3. `wide_master`：新增 `volume_gain_q8` 输入，与压力增益合成（选项 A）。
4. 两个顶层各接一个新参数 `CONTROL_ENABLE`（默认 1），旧行为用参数 0 保留；端口只增不改。
5. 补测试台：`tb_ram32_controls`（新）+ 复用 `tb_voice_sched32_review`、`tb_ram32_complete`、`tb_ram32_clocked`。
6. 门禁：`-Tests` 定向跑，再按新规范跑 `-Suite Quick`。

## 8. 验收对照（实施后逐条给证据）

| 验收项 | 检查方式 |
|---|---|
| 32 个不同音高同时激活 | 32 个 Note On，检查 `active_count==32` 且 32 个音高都在 |
| 重按/释放/窃声/背压 | 复用 `tb_voice_sched32_review` + 新增满声部用例 |
| 五档 + 钢琴/吉他映射可测 | 逐档注入 tone 0..4，检查 `cfg_param` 的 bank/stage 与 `start_stage` |
| 持音期间压力/音量/弯音持续有效 | 按住音符，改三项，检查输出增益与增量变化，且 `cfg_retrigger` 不被置起 |
| 0 音量/静音收敛到精确 0 | 输出逐样本等于 0，且增益单调收敛无过冲 |
| 满量程多音混音不回绕 | 32 音最大力度，检查 `clip_count` 只随真实削波增加、无符号翻转 |
| 无控制变化时逐样本一致 | 与改动前参考片段逐样本比对；若有意变化（弯音路径舍入）先给误差限 |
| 同时变化/复位/PLL 锁定/跨域 | 控制束与事件同拍更新、复位中途、PLL 未锁定期间不得半帧生效，不撕裂不丢帧 |

## 9. 回退

- `CONTROL_ENABLE=0` 回到今天的接线（`mix_weight=0xff`、压力/静音/弯音为 0），旧测试台 `tb_ram32_complete`、`tb_ram32_clocked` 不需要改动即可通过。
- 不删 `ram32_top.v`；新逻辑走新增模块与参数，端口只增不改。
- 不引入合唱、FFT、64 声部；BSRAM 不新增。
