Interstellar-530/PolyTouch-FPGA-Synth/docs/planning/需外部仪器的调试任务清单-20261010.md

# 需外部仪器的调试任务清单

日期：2026-10-10

说明：本清单只列必须借助示波器、逻辑分析仪、独立电源、音频分析仪这几类难以自备的设备才能可靠完成的调试项目。凡是能在电脑上用免费软件、在板内用 GAO，或用可自购的低成本仪表替代的，都在"替代方案"一列注明。优先级按赛题硬指标和对当前进度的阻塞程度排。

| 编号 | 调试项目 | 目的与判据 | 必需仪器 | 优先级 | 替代方案 | 备注 |
| --- | --- | --- | --- | --- | --- | --- |
| D-01 | 底噪与地环路溯源 | 换成独立供电后底噪明显下降或消失，判定噪声来自地环路或板级耦合 | 独立可调直流电源、示波器（测 +5 V/+3V3 纹波与地噪声） | 高 | 用充电宝或 12 V 电源适配器直接做 A/B 对比即可定性，定量纹波才需要示波器 | 已用 S3 保持复位确认与数字信号无关 |
| D-02 | 电源纹波与上电时序 | +5 V、+3V3、2V5、1V5、1V2 各轨的纹波和上电顺序在规格内 | 两通道以上示波器 | 中 | 无，属板级可靠性验证 | 加外设前做一次即可 |
| D-03 | PT8211 BCK/WS/DIN 引脚级时序与建立保持裕量 | 三位数据相对 BCK 上升沿的建立时间足够，字对齐正确 | 100 MHz 以上示波器或高速逻辑分析仪 | 高 | 24 MHz 八通道 USB 逻辑分析仪可覆盖 1.5 MHz 的 BCK，属可自购件；内部时序可用 GAO | 正式切到标准 I2S 之前必须做 |
| D-04 | UART 波形与握手验证（M11/T13） | 电脑发出的字节在 FPGA 端被正确解出，`OK` 能回读 | 逻辑分析仪 | 中 | 同上，低成本 USB 逻辑分析仪够用；串口助手加回读也能间接判断 | 引脚刚更正，需要用波形确认一次 |
| D-05 | MPR121 I2C 总线验证 | 400 kHz 下读写正确，上拉电阻与总线负载合适，无误触发 | 逻辑分析仪，示波器（看边沿与上拉） | 高 | 24 MHz 逻辑分析仪可解码 I2C，属可自购件 | 接上触摸模块后立即做 |
| D-06 | MCP3208 SPI 时序 | mode 0 采样正确，12 位读数稳定，噪声小于一个 LSB | 逻辑分析仪 | 中 | 同上 | 接上压力传感器后做 |
| D-07 | 端到端延迟（触摸到出声） | 从触摸事件到音频输出变化不超过 10 ms，扩展目标 5 ms | 双通道示波器或逻辑分析仪加声卡输入 | 高 | 数字侧预算可用 FPGA 内部时间戳加 GAO 估算，但绝对延迟仍要外部测量 | 赛题硬指标，必须留证据 |
| D-08 | 音频指标 THD+N、SNR、频响 | 相对理想正弦的带内失真和底噪满足 16 位系统要求 | 音频分析仪（APx、QA403 一类） | 中 | 电脑声卡加 REW、ARTA 等免费软件可测频响和大致失真 | 没有分析仪时用声卡方案出图 |
| D-09 | 12.288 MHz 有源晶振波形 | 起振正常，3.3 V CMOS 电平，占空比接近 50%，无过冲 | 示波器 | 中 | 无 | 外接 DAC 到货后做 |
| D-10 | 时钟抖动与相位噪声 | 12.288 MHz 时钟抖动在 I2S 可接受范围 | 抖动分析或相位噪声分析仪 | 低 | 示波器抖动测量精度有限，只能粗略判断 | 非阻塞项 |
| D-11 | 多电压轨上电时序 | 各轨建立顺序和延迟符合器件要求 | 多通道示波器 | 低 | 无 | 稳定运行后再复核 |
| D-12 | 扩展口信号完整性 | PMOD 引出线的过冲、串扰、回流在可接受范围 | 高带宽示波器 | 低 | 时钟线串 22 到 100 Ω 电阻可缓解，不必先测 | 高频线走远时才需要 |

使用这类仪器时，每次测量都要记录条件并保存截图或数据，包括供电方式、探头位置、带宽限制、耦合方式和触发电平，否则数据无法复现。建议向学校实验室借用示波器和逻辑分析仪，一次借齐 D-01、D-03、D-07 三项所需的设备，因为这三项相互关联，集中一天做完效率最高。D-04 到 D-06 属于数字总线解码，用一台可自购的 24 MHz 八通道 USB 逻辑分析仪就能覆盖，不必占用实验室设备。
