Interstellar-530/PolyTouch-FPGA-Synth/evidence/2026/10/FPGA-standard27-board-20261024-v0.1/debug8-header-before.txt

//Copyright (C)2014-2025 Gowin Semiconductor Corporation.
//All rights reserved.
//File Title: Bitstream file
//Tool Version: V1.9.11.03 Education (81398)
//Device: GW2A-18
//Device Version: C
//Part Number: GW2A-LV18PG256C8/I7
//Device-package: GW2A-18C-PBGA256
//BackgroundProgramming: OFF
//CheckSum: 0x3F62
//UserCode: 0x00003F62
//LoadingRate: 2.500MHz
//CRCCheck: ON
//Compress: OFF
