Interstellar-530/PolyTouch-FPGA-Synth/releases/2026/10/FPGA-20261016-v0.1/catalog/CHANGES.md

# 归档变更

2026-11-01：按日期保存阶段源码。原提交说明：Add the wiring and pin correspondence table for the purchased hardware
