Interstellar-530/PolyTouch-FPGA-Synth/docs/history/logs/2026/10/FPGA_DAILY_20261010.md

# 2026-10-10 工作日志

## 一、今天做了什么

今天一共 24 次提交、7 个回退标签，分两个阶段。

上午从 09:36 到 11:34 是单声部链路的打通与排障，共 13 次提交，把上电、时钟、按键、板载 DAC 到发声这条最小链路跑通，并逐项查清了噪声与烧录问题。这一段属于修订一到修订十一。

下午从 16:35 到 17:58 是本次会话的工作，共 11 次提交，内容依次是：零外设条件下的实施规划与三份清单、Git 通信与回退基线、四声部复音与测试曲、速度与气口调整、按原谱重划节奏并加入现场调速、歌曲表改为常量逻辑、用 RTL 仿真定位并修复循环飞快、把仿真写成强制门禁、按谱优化节奏与和弦并提升音量。

## 二、上午：单声部链路（修订一到修订十一）

这一段解决的是"能不能出声、出得对不对"。

时钟与复位方面，确认核心板 27 MHz 晶振经 R20 送到 H11，并把 S1、S2 用作音高切换、S3 用作同步复位。烧录方面确认命令行读到 `ID Code 0x0000081B`，图形界面失败多半是电缆或器件没选对、两个编程器抢线、或用了会报读回校验错误的操作四类原因。码流后来写进板载外部 SPI Flash，掉电与按 S4 重配置都会自动加载。

噪声方面分出三条线索并逐条处理。先是配置格式：PT8211 用日式右对齐格式，原先 WS 相位差一个位，DAC 按错位的符号位重组字，听感是叠加在音调上的严重失真，按官方例程改写帧结构后正常。再是算法本身：查表时丢掉相位小数带来阶梯误差，加线性插值并补一级 (1,4,6,4,1)/16 平滑后，带内误差降到 -94.8 dBFS。最后是底噪：按住 S3 保持复位时"虫鸣"仍在，说明它不来自数字信号，后续只查供电与板级。

控制方面加入 115200 的 UART 频率控制接口，并发现先前把串口引脚记成 N6/N7 是读原理图读错的，正确的是 M11（TX）与 T13（RX），属于 Bank 2 的 3.3 V 调试串口。

## 三、下午：从单声部到可演奏的复音测试链路

### 1. 零外设条件下的规划

先盘点物料边界：手头只有核心板、底板和一根耳机线。Dock 3714 自带 PT8211、耳机功放和 3.5 毫米耳机座，所以"算声音并听结果"这条链路的硬件全在板上。据此写出三份清单：零外设可实施的功能与设计、需要示波器或逻辑分析仪或独立电源的调试任务、可以自行采购的外设与耗材；另外把 Git 通信检查与回退办法也写成一份文档。同时核实本机与 GitHub 的读写通道正常，并在当时可用的固件状态上打了 `v0.4-20261010` 回退标签。

### 2. 四声部复音与测试曲

把单声部扩成四声部：每声部独立的相位累加器、ADSR 与力度，四路求和后统一做饱和、平滑与主音量。新增歌词事件总线，事件字是 `{on, note[6:0], velocity[7:0]}`，播放器与 UART 都往这条总线写，将来 MPR121 触摸键盘只要驱动同样的信号即可接入。测试曲选《兰花草》，依据两份公开简谱转写成 G 多利亚调，并配两套和弦。

### 3. 三轮听感反馈带来的调整

第一轮反馈"太快、听不出旋律、音符之间没有间隔"。于是降速、加入气口（每个音提前释放）、拉开旋律与和弦的力度差。第二轮反馈"依然很快"，于是改按原谱重划节奏并加入 1 到 4 倍的现场调速档位。第三轮反馈"播一小段就重复、闪烁灯间隔只有零点几秒"，这一次没有再改参数，而是装了仿真器直接跑 RTL。

### 4. 三个由工具发现而不是由推理发现的问题

第一个是混音削波。四路相加后先做饱和再乘主音量，和弦被削平，峰值卡在 8192；改成先求和、再乘音量、最后饱和后恢复正常。这个问题是 Python 金模型先暴露的。

第二个是歌曲表被综合成内部存储器，初始化是否完整无法确认。改成由脚本生成常量 `case` 函数，彻底绕开存储器推断。

第三个，也是今天最关键的，是 `tick_pulse` 电平当脉冲用。`tick_cnt` 只在 `sample_tick` 到来时更新，到达顶值后会保持整整一个采样节拍（576 个 27 MHz 时钟），所以该信号是电平而非单周期脉冲；播放器按脉冲使用它，在一次事件突发后的约 570 个时钟里把音符时值计数器连减数百次，旋律一口气跑完整圈。这解释了前面两轮"降速无效"的原因。用 `sample_tick` 限定后恢复正常，仿真复验两圈间隔正好等于标称值。

### 5. 仿真成为强制环节

把"任何 Verilog 改动烧录前必须先过 RTL 仿真"写进项目 `AGENTS.md`，并由 `sim/run_simulation.ps1` 执行、`build/program_sram.ps1` 拦截。门禁上线当天就抓到两个问题：`reset_cnt` 缺上电初值导致仿真里上电复位永不完成；以及文档里的档位指示灯表写反了。

### 6. 收尾优化

按谱把每句统一为 14 个十六分音符，保留原谱三类句型；和弦由每句一个改为每句两个，A 套自然小调力度 30、B 套多利亚明亮色彩力度 46，进行与响度一起变；主音量提升约 6 分贝。现场认定合适的速度是 L14 亮、L16 灭，按真实逻辑即 2 倍档，已设为上电默认。

## 四、当前状态

| 项目 | 值 |
| --- | --- |
| 板内码流 User Code | `0x00006DD1`（写在 SRAM） |
| 码流 SHA256 | `640c892480bb7de376d57fbbf5048dac3c91271e96b0d0a34e4df492113bd1ce` |
| 外部 Flash | 仍是修订十一的单声部基线 `0x000059D1`，按 S4 或断电即可回退 |
| 资源 | 4573 逻辑单元、789 寄存器、4 块 BSRAM、6 个 DSP |
| 时序 | 约束 27 MHz，零建立与保持违规，无综合警告 |
| 已实现 | 四声部复音、音符事件总线与声部分配器、两套和弦、内置测试曲、四档调速、气口与力度、UART 音符控制、循环标记灯 |
| 尚未实现 | MPR121 触摸、FSR 力度、标准 I2S 到 PCM5102A、每声部独立 ADSR 参数、效果器 |

## 五、验证方式汇总

三种手段互相补位。Python 金模型按 RTL 逐模块等价重写，可以渲染出可试听的 WAV，并用 Goertzel 逐音比对音高与气口残留；RTL 仿真用 Icarus Verilog 直接跑源码，三个测试台分别量采样节拍、曲子长度与音符事件数、顶层连线与按键；Gowin 构建报告提供资源与时序数据，器件回读确认码流真的写进去了。

今天靠这套组合确认过的关键数字：采样节拍 576 个 27 MHz 时钟即 46875 Hz；默认档一遍 3300908 个采样节拍折合 70.4 秒；一遍 95 个开音事件等于 41 个旋律音加 54 个和弦音；41 个旋律音的音高与气口检查全部通过；两套和弦渲染的峰值分别是 -3.4 与 -1.7 dBFS，未削波。

## 六、版本与回退

今天建立的回退标签依次是 `v0.4-20261010`（单声部基线）、`v0.5-20261010`（四声部与测试曲首次可用）、`v0.5.1`（66 BPM 与气口）、`v0.5.2`（按谱重划节奏与现场调速）、`v0.5.3`（歌曲表改常量逻辑与循环标记）、`v0.5.4`（修复 tick_pulse 根因）、`v0.5.5`（仿真门禁与节奏和弦音量优化）。归档目录从 `FPGA-20261010-v0.2` 到 `FPGA-20261010-v0.10`，每个都带 MANIFEST、复现命令与 SHA256 校验。

## 七、遗留项与下一步

需要人耳确认的有三件：新节奏的听感、S1 切换两套和弦是否已经足够明显、提升后的音量是否合意。

需要外部条件的有两件：底板 USB-JTAG 口还没有在电脑上枚举成功，所以串口音符控制暂时发不进去；底噪的供电侧定位需要独立电源与示波器。

工作区有一条历史遗留：根目录的 `.git_owner_bak2_20261010` 是先前修复 `.git` 属主时留下的副本，普通权限删不掉，需要在管理员 PowerShell 里执行 `takeown` 后再删除；除此之外 `tmp` 已经清空，工作区干净。

下一步按规划顺序是先把四声部架构固定下来并补每声部独立 ADSR 参数，再等外设到货后接 MPR121 触摸与 FSR 力度，最后切到外部 PCM5102A 与标准 48 kHz。所有 RTL 改动都会先过仿真门禁再烧录。

## 八、环境变更

本机通过 winget 安装了 Icarus Verilog 12.2022.06.11（`C:\iverilog`），只用于开发期 RTL 仿真，不参与硬件运行，仿真产物 `*.vvp` 已加入 `.gitignore`。另外两个门禁脚本按本项目既有约定存成带 UTF-8 BOM 的 `.ps1`，因为 Windows PowerShell 5.1 会以 ANSI 读取无 BOM 的脚本。
