Interstellar-530/PolyTouch-FPGA-Synth/evidence/2026/10/FPGA-debug8usb-20261020-v0.1/evidence/audio_capture_manifest.csv

key | value
sample_rate | 46875
clk_hz | 27000000
uart_baud | 115200
clock_half_period_ns | 18.5185
bits_per_word | 16
bck_period_clocks | 18
frame_period_clocks | 576
settle_frames | 2000
release_settle_frames | 1600
muting_flush_frames | 140
A4_hz | 440
channel_format | PT8211_16bit_right_aligned
decoder_uses_serializer_bit_counter | false
sample_tick_forced | false
stage_count_initial_silence | 512
expected_notes_initial_silence | none
stage_count_a4_steady | 32768
expected_notes_a4_steady | 69
stage_count_release_a4 | 4096
expected_notes_release_a4 | none
stage_count_chord4 | 4096
expected_notes_chord4 | 60;63;66;69
stage_count_after_off60 | 4096
expected_notes_after_off60 | 63;66;69
stage_count_after_off63 | 4096
expected_notes_after_off63 | 66;69
stage_count_after_off66 | 4096
expected_notes_after_off66 | 69
stage_count_all_released | 512
expected_notes_all_released | none
stage_count_muted_active | 512
expected_notes_muted_active | 60;63;66;69
stage_count_unmuted_active | 4096
expected_notes_unmuted_active | 60;63;66;69
captured_frames | 58880
decoded_frames | 73421
checked_sample_ticks | 73422
checked_bck_rises | 2349509
uart_commands_accepted | 17
result | PASS
