Interstellar-530/PolyTouch-FPGA-Synth/docs/history/VERSIONS.md

# 版本时间线

按北京时间排序，同日 v0.N 是归档编号，原版本名保留。阶段快照只表示保存当时源码，不等同于正式发布。

| 日期 | 原版本或阶段 | 归档 | 来源提交 |
|---|---|---|---|
| 20261010 | v0.4-20261010 | [FPGA-20261010-v0.1](../../releases/2026/10/FPGA-20261010-v0.1/catalog/README.md) | `39a07325045b` |
| 20261010 | v0.5-20261010 | [FPGA-20261010-v0.2](../../releases/2026/10/FPGA-20261010-v0.2/catalog/README.md) | `b9676299f0cb` |
| 20261010 | v0.5.1-20261010 | [FPGA-20261010-v0.3](../../releases/2026/10/FPGA-20261010-v0.3/catalog/README.md) | `1c4843b6d08a` |
| 20261010 | v0.5.2-20261010 | [FPGA-20261010-v0.4](../../releases/2026/10/FPGA-20261010-v0.4/catalog/README.md) | `95148192062d` |
| 20261010 | v0.5.3-20261010 | [FPGA-20261010-v0.5](../../releases/2026/10/FPGA-20261010-v0.5/catalog/README.md) | `80b3c23b1345` |
| 20261010 | v0.5.4-20261010 | [FPGA-20261010-v0.6](../../releases/2026/10/FPGA-20261010-v0.6/catalog/README.md) | `f8b9cec137e2` |
| 20261010 | v0.5.5-20261010 | [FPGA-20261010-v0.7](../../releases/2026/10/FPGA-20261010-v0.7/catalog/README.md) | `b9a52e44c48c` |
| 20261013 | v1.0.0 | [FPGA-20261013-v0.1](../../releases/2026/10/FPGA-20261013-v0.1/catalog/README.md) | `df66250ad5a4` |
| 20261014 | v1.01 | [FPGA-20261014-v0.1](../../releases/2026/10/FPGA-20261014-v0.1/catalog/README.md) | `b559237c37d8` |
| 20261014 | origin/codex/s2-gpio-keyboard | [FPGA-20261014-v0.2](../../releases/2026/10/FPGA-20261014-v0.2/catalog/README.md) | `dd43257888d9` |
| 20261014 | origin/codex/s3-i2s-tx | [FPGA-20261014-v0.3](../../releases/2026/10/FPGA-20261014-v0.3/catalog/README.md) | `17aff2da4a0b` |
| 20261016 | origin/codex/s4-s6-integration | [FPGA-20261016-v0.1](../../releases/2026/10/FPGA-20261016-v0.1/catalog/README.md) | `40ef0128dadf` |
| 20261021 | v2.0.0 | [FPGA-20261021-v0.1](../../releases/2026/10/FPGA-20261021-v0.1/catalog/README.md) | `2d3db6c1700e` |
| 20261021 | v2.1.0 | [FPGA-20261021-v0.2](../../releases/2026/10/FPGA-20261021-v0.2/catalog/README.md) | `6751f6dc65c5` |
| 20261021 | origin/codex/v2-gate-fix-20261021 | [FPGA-20261021-v0.3](../../releases/2026/10/FPGA-20261021-v0.3/catalog/README.md) | `f7052fbe951e` |
| 20261027 | origin/codex/hdmi-dashboard-20261025 | [FPGA-20261027-v0.1](../../releases/2026/10/FPGA-20261027-v0.1/catalog/README.md) | `a234c70c9a80` |
| 20261029 | v1.0-final-20261029 | [FPGA-20261029-v0.1](../../releases/2026/10/FPGA-20261029-v0.1/catalog/README.md) | `e8450a5b4db3` |
| 20261030 | final-20261030 | [FPGA-20261030-v0.1](../../releases/2026/10/FPGA-20261030-v0.1/catalog/README.md) | `efd76ea14bab` |

未合并候选见 [实验目录](../../experiments/README.md)，普通提交保留在 Git 历史中。本机过程归档见 [归档清单](../../evidence/2026/11/FPGA-20261101-reorganization-v0.1/local-archives.json)。
