Interstellar-530/PolyTouch-FPGA-Synth/docs/history/WORK_STATUS-20261023-32声部控制.md

# 工作路标：32 声部完整演奏控制（2026-10-23）

> 给并行的其他智能体看的本地状态文件。**请先读本文件再动这块代码，不要重复已完成的改动。**

```
status: IN_PROGRESS          # 不是 complete
core_status: COMPLETE        # 仅32声部核心；任务4板级档和任务5灯光仍待办
updated: 2026-10-23T19:47+08:00
owner_line: codex/v2.1.1-integration-20261022
head_commit: 67a9aaf
```

## 已提交、已验证（可以直接依赖）

| 提交 | 内容 | 证据 |
|---|---|---|
| `e3f2388` | CH9350L 长按策略合流（strict / idle-only，默认 idle-only） | `tb_host_kbd_timeout`、`tb_host_kbd`、`tb_top_host_ctrl` 全 PASS；强制 strict 的变异体退出 1；归档 `archive/FPGA-20261023-v0.3`、`v0.4` |
| `67a9aaf` | 32 声部完整控制：`ram32_control_front`（51 位控制束整束快照）、`piano_tone` 2→3 位、弯音 Q16 比率施加、主音量并入 Q12 增益、`gowin_rpll_model` | `tb_ram32_controls` PASS（11 s，7 项）；`-Suite Ram32` 4/4；`-Suite Quick` 18/18 |

接口表（改这块之前必读）：`docs/history/FPGA-32声部控制接口-20261023-v0.1.md`。

## 正在被另一条线修改（**不要碰**，会冲突）

工作区当前 dirty，正在同时改构建/板级：

```
 M AGENTS.md
 M README.md
 M build/README.md
 M build/build.ps1
 M build/build_profile.tcl
 M build/isolated/top_dbg8usb_build.v
 M build/isolated/top_std27_build.v
 M build/program_sram.ps1
 M constraints/primer20k_i2s_27m.sdc
 M sim/run_simulation.ps1
 M sim/tb_host_kbd_timeout.v
 M sim/tb_ram32_clocked.v
 M tools/run_audio_verification.ps1
?? docs/hardware/standard27-interface-budget-20261023.md
?? sim/README.md
?? sim/gate_process.ps1
```

（路径相对 `source/`，前 4 个文件在仓库根。）

## 尚未完成（**这些还不能算做完**）

| 项 | 缺口 | 完成判据 |
|---|---|---|
| 引擎级音频验证 | 已完成：真实波表、2135帧独立定点参考、32音、精确静音、压力/音量/弯音、I2S、复位 | `tb_ram32_engine_audio` PASS，归档 v0.8 |
| PnR 资源/时序重测 | 已完成：BSRAM 26/46，3个MULT18X18＋1个MULTALU36X18，Logic6243，Register2929 | Fmax75.564MHz，setup+0.330ns、hold+0.337ns，违例0；归档 v0.8 |
| 延迟实测 | 已完成核心RTL仿真打点：接受到调度0.042至0.283µs，首个非零I2S83.293µs，32事件分配15.543µs | 快速Attack测试参数65535/帧；核心不含UART和外部队列，不等同实物演奏延迟 |
| 提示词4 32 声部板级档 | 未开始；前置是"已验收的完整 32 声部核心" | CST/SDC + 73.728 MHz PnR + 帧桥自检 |
| 提示词5 灯光 | 未开始，文档写明前 3 项未收口不强行合入 | 独立模块通过后再说 |

## 完成路标的写法（给下一位）

全部做完后，把本文件顶部的 `status:` 改成 `complete`，并在下面追加一段：

```markdown
## 完成记录
- 引擎级音频：<测试台> PASS，日志 <路径>
- PnR：BSRAM x/46，DSP x/24，Fmax x MHz，setup/hold 违例 0，报告 <路径>
- 延迟：单事件 x 帧，32 事件突发 x µs
- 归档：archive/FPGA-20261023-vX.Y（MANIFEST + checksums 通过）
```

**在此之前不要写 `status: complete`。** 本文件是状态声明，不是验收证书；写错会让后续智能体跳过真实工作。

## 32声部核心修复记录（2026-10-23）

用户授权继续修复核心剩余工作。修复Gowin数字常量与问号粘连的解析错误、头文件引入路径，以及旧RAM音频实验遗漏主音量输入的问题；为音高查表/弯音乘法/舍入、控制增益和包络脏标记加入内部流水寄存。真实实现从40.657MHz提高到75.564MHz，保持73.728MHz约束，未增加多周期或假路径。

核心5项Ram32专项、18项Quick及4项兼容专项通过。宽混音8192帧包含3589次饱和削波核对；完整引擎2135帧含197帧精确零、1938帧非零，最大帧尾617/1536拍。归档 `archive/FPGA-20261023-v0.8` 保存最终源码、实现报告、原始门禁指纹和SHA256。没有烧录，未执行板级档或灯光；因此总状态继续保留IN_PROGRESS。

## 回退

`git revert 67a9aaf` 会退回到旧原型接线（`mix_weight=0xff`、压力/静音/弯音为 0、`piano_tone` 2 位）。
`ram32_top` 新旧并存，`ram32_clocked_top` 端口只增不改，旧测试台加一行常量即可编译。
