Interstellar-530/PolyTouch-FPGA-Synth/docs/history/版本索引与文件地图-20261014-v0.1.md

# 版本索引与文件地图（2026-10-14 v0.1）

维护人：deepseek（Codex 会话）。用途是让每一版代码、每一次验收和每一份资料都能按类别与版本直接定位，避免源码埋在带日期的交接目录名里却找不到对应证据。每次交付都要更新本文件。2026-10-22 更新：当前后续开发分支为 `codex/v2.1.1-integration-20261022`，v2.1.1 本地合流基线尚未发布，已发布版本为 v2.1.0；生产源码为 8 声部，32 声部少表音色原型独立保留。历史已烧录信息以当日烧录日志为准。

## 一、四类内容的存放位置

| 类别 | 路径 | 说明 |
| --- | --- | --- |
| 核心功能代码 | `source/rtl`、`sim`、`constraints`、`build` | 唯一的 RTL、测试台、约束与构建脚本；目录名来自旧交接包，版本以 Git 标签与本文件为准 |
| 调试日志 | `docs/logs/` | 按日期记录的调试与复现过程，含沙箱与 Icarus 兼容问题的完整排查 |
| 工作计划 | `docs/planning/`（当前计划与任务书）、`docs/reviews/`（历史评审快照） | S0–S6 主计划是 `docs/planning/FPGA-缺件期间仿真与算法任务-20261013-v0.1.md`，其上有设计分册 `docs/design/minimum_design/` |
| 参考资料 | `docs/references/`（原理图与厂商手册 PDF，按现有规则不入库）、`docs/references/boards/`（Sipeed 板卡文档）、`docs/hardware/`（引脚表与到货流程）、`docs/design/minimum_design/`（设计分册） | 外部资料只作参考，不复制进生产源码 |
| 验收证据 | `docs/evidence/` | 每个里程碑一个目录或文件，含门禁日志、指标 JSON、源码哈希与图表 |
| 发布与位流 | `docs/history/release-notes/`、`releases/` | 发布说明与已验证位流 `releases/2026/10/FPGA-20261013-v0.1/target/instrument_sram_0x5633.fs` |
| 本地归档 | `archive/FPGA-日期-vX.Y/` | 不入库的完整交付快照（源码、证据、位流、MANIFEST、校验表） |
| 待清理区 | `legacy/pending_removal/` | 见第三节，是否删除等用户核对 |

## 二、版本索引

| 版本或任务 | Git 位置 | 核心源码 | 验收证据 | 本地归档 | 位流 |
| --- | --- | --- | --- | --- | --- |
| v2.1.1 本地合流基线 | 分支 `codex/v2.1.1-integration-20261022`，双亲 v2.1.0 + f7052fb | 原唯一 source，四个测试台修正 | `docs/history/release-notes/v2.1.1.md`、`evidence/2026/10/FPGA-版本合流-20261022-v0.1/` | `archive/FPGA-20261022-v0.1` | 沿用 v2.1.0，未生成新位流 |
| v2.1.0 六项优化及审核修正 | 标签 `v2.1.0` | 唯一 source 入口，生产 8 声部及独立 32 声部原型 | `docs/history/release-notes/v2.1.0.md`、当日 reviews/evidence | `archive/FPGA-20261021-v0.9` | `releases/2026/10/FPGA-20261021-v0.2/original-delivery/debug8usb.fs`（未烧录） |
| v1.0.0 四声部基线 | 标签 `v1.0.0`，提交 `df66250` | 当时的源码快照 | `docs/history/release-notes/v1.0.0-validation.json` | `archive/FPGA-20261013-v0.8` | `releases/2026/10/FPGA-20261013-v0.1/target/instrument_sram_0x5633.fs` |
| v1.01 音频验收与 Flash | 标签 `v1.01`，提交 `b559237`（历史基线） | `source` | `evidence/2026/10/FPGA-S1-音频验收-20261014-v0.1.md`、`docs/history/release-notes/v1.01-validation.json` | `archive/FPGA-20261014-v0.1`、`v0.2` | 与 v1.0.0 同一 0x5633 位流 |
| S2 GPIO 琴键与手动仲裁 | 分支 `codex/s2-gpio-keyboard`，提交 `8d0fa2f`（首交付）、`dd43257`（复核） | 同上，新增 `rtl/audio/gpio_keyboard.v` | `evidence/2026/10/FPGA-S2-GPIO琴键与手动仲裁-20261014-v0.1.md`、`evidence/2026/10/FPGA-S2-复核-20261014-v0.1.md` 及目录 | `archive/FPGA-20261014-v0.3`、`v0.4` | 候选位流未烧录 |
| S3 方案评审（Codex产出） | 已随37bdb62入库 | 无 | 方案核算与资料复核 | `archive/FPGA-20261014-v0.5` | 无 |
| S3 标准 I2S 与统一时钟参数 | 分支 `codex/s3-i2s-tx`（本次交付） | 同上，新增 `rtl/audio/clk_params.vh`、`rtl/audio/i2s_tx.v`、`sim/i2s_rx_model.v`、`sim/i2s_tx_checker.v`、`sim/tb_i2s_tx.v`、`sim/tb_i2s_tx_params.v`、`build/isolated/i2s_tx_top.v`、`build/synth_i2s_tx.tcl`、`build/build_i2s_tx.ps1` | `evidence/2026/10/FPGA-S3-i2s-tx-20261014-v0.1/` | `archive/FPGA-20261014-v0.6` | 无（本轮不烧录） |

当前计划与任务书：`docs/planning/FPGA-缺件期间仿真与算法任务-20261013-v0.1.md` 是 S0–S6 与验收口径；`docs/planning/FPGA-S3-标准I2S与统一时钟参数方案-20261014-v0.2.md` 是 S3 编码任务书，正文以该版为准，v0.1 是评审前原方案。

## 三、过时交接包待清理清单

已集中到 `legacy/pending_removal/`，尚未删除，等核对后再处理；内容没有改动。

| 现位置 | 原位置 | 大小 | 为什么过时 |
| --- | --- | --- | --- |
| `legacy/pending_removal/minimum_algorithm_design_v1.zip` | `output/minimum_algorithm_design_v1.zip` | 13,538 B | 10/07 设计第 1 稿，已被 `docs/design/minimum_design/` 第三稿取代，全仓库无引用 |
| `legacy/pending_removal/minimum_algorithm_design_v2.zip` | `output/minimum_algorithm_design_v2.zip` | 20,064 B | 同上，第 2 稿 |
| `legacy/pending_removal/minimum_algorithm_design_v3.zip` | `output/minimum_algorithm_design_v3.zip` | 46,985 B | 同上，第 3 稿已解包为 `docs/design/minimum_design/` |
| `legacy/pending_removal/FPGA-20261013-v0.5/` | `docs/reviews/FPGA-20261013-v0.5/` | 29,024 B | 竞赛差距与执行计划 v0.1 的评审快照，已被 `-v0.6` 的 v0.2 取代 |
| `legacy/pending_removal/untracked/handoff_milestone1_20261007/` | `work/handoff_milestone1_20261007/` | 51,106,560 B（119 文件） | 里程碑 1（10/07）交接包，已被里程碑 2 取代；原本不在版本库内 |
| `legacy/pending_removal/untracked/handoff_milestone2_20261008.zip` | `docs/history/handoff-20261008.zip` | 12,585,813 B | 里程碑 2 交接压缩包，内容已解包到 `docs/history/handoff-20261008/` 并在持续使用，压缩包本身无人引用 |

核对通过后再执行的删除命令：

```powershell
cd "E:\Working Space\FPGA"
git rm -r legacy/pending_removal/minimum_algorithm_design_v1.zip legacy/pending_removal/minimum_algorithm_design_v2.zip legacy/pending_removal/minimum_algorithm_design_v3.zip legacy/pending_removal/FPGA-20261013-v0.5
Remove-Item -LiteralPath "legacy\pending_removal\untracked\handoff_milestone1_20261007" -Recurse -Force
Remove-Item -LiteralPath "legacy\pending_removal\untracked\handoff_milestone2_20261008.zip" -Force
```

恢复方式：`git mv` 移动过的四项用 `git mv <现路径> <原路径>` 复原；两个未入库项用 `Move-Item` 移回原路径。`legacy/pending_removal/untracked/` 已加入 `.gitignore`，其内容不会进入版本库。

## 四、建议但尚未执行的改动

第二批“看起来过时但没有动”的路径，列出来供你判定（它们与在用源码同目录，或有引用在身，贸然移动会打断引用）：

| 路径 | 判断 |
| --- | --- |
| `docs/history/handoff-20261008/` 根目录下的交接文档：`AI_RESUME_PROMPT.txt`、`CURRENT_STATUS.md`、`DESIGN_DECISIONS.md`、`FILE_MANIFEST.json`、`NEXT_TASKS.json`、`PROJECT_MANIFEST.json`、`README_FOR_HUMAN.md`、`START_HERE_FOR_AI.md`、`CHANGELOG.md` | 里程碑 2 交接包自己的说明文件，内容停在 v1.0.0 时代，与 `docs/` 下的发布说明重复；但和 `source/` 同目录，且 `COMPETITION_REQUIREMENTS.md`、`SONG_LANHUACAO.md`（历史）和 `SONG_WANYE_WEIYU.md`（2026-10-24 起的测试曲）仍被引用（前者在 S3 方案里作为赛题依据，后者描述测试曲目），建议等源码目录结构调整时一起处理 |
| `docs/references/boards/Tang_Primer_20K_Dock_3714/` 下与 `docs/references/` 重复的三份原理图 PDF | 内容重复，但 `.gitignore` 只忽略 `docs/references/*.pdf`，`docs/references/boards` 里的是入库文件，删掉会改变仓库内容，需要你确认保留哪一份 |
| `docs/exports/pdf/`、`tmp/pdfs/` | 已交付的 PDF 与渲染中间件；`tmp/` 本就是临时区，`docs/exports/pdf` 是交付成品，建议保留 |
| `docs/history/CLEANUP_REPORT-20261007.md`（仓库根） | 10/07 的清理报告，只记录当时删了什么，可归入 `docs/logs/` 或在下次整理时移除 |

把核心源码从带日期的交接目录提到顶层（`source/{rtl,sim,constraints,build}` 变为 `{rtl,sim,constraints,build}`）能让首页一眼看出代码位置，但这属于结构性改动，会波及约 30 个已入库引用（`README.md`、`AGENTS.md`、`docs/evidence/*`、`docs/history/release-notes/*`、`docs/logs/*`、`docs/planning/*`、`docs/handoff/*`、`docs/reviews/*`、`tools/run_audio_verification.ps1`、`tools/build_release_package.py`、`tools/verify_release_rtl.py`、`tools/serial_console/serial_console.ps1`、`.gitignore`），并会让既有证据文档里的复现命令失效。本轮不执行；确认后单独做一次只改路径、不改行为的提交，并在同一次提交里更新全部引用与复现命令。

## 五、两条维护规则

证据目录与构建输出目录一律使用 ASCII 名称。10/14 首次跑 S3 验收时用了中文目录名，`vvp +CAPTURE_DIR=` 传参被破坏，原 PT8211 捕获台在开头就 `$fatal`；改用 `evidence/2026/10/FPGA-S3-i2s-tx-20261014-v0.1/` 后正常，那次失败的门禁日志保留在该目录的 `reference/attempt1-utf8-path/`。

归档继续用 `archive/FPGA-日期-vX.Y/`，保持 `MANIFEST.md`、`CHANGES.md`、`REPRODUCE.md`、`checksums.sha256` 四件套；同一天已被占用的版本号不覆盖。

## 2026-10-14 S3复核更新
S3经Codex独立复核修正，最终证据为 evidence/2026/10/FPGA-S3-review-20261014-v0.1.md，复核归档 archive/FPGA-20261014-v0.7。最新任务清单为 docs/planning/FPGA-缺件期间仿真与算法任务-20261014-v0.2.md，原10/13清单入口同步更新。S3数字交付划去，T04正式时钟/顶层/DAC和S4–S6继续待验收；当前生产发布与板内位流没有改变。
