Interstellar-530/PolyTouch-FPGA-Synth/docs/history/handoff-20261008/SONG_LANHUACAO.md

> 已被替换：2026-10-24 起测试曲改为《晚夜微雨问海棠》副歌，见 [SONG_WANYE_WEIYU.md](SONG_WANYE_WEIYU.md)。本文只保留历史转写依据。

# 测试曲《兰花草》的转写与用法

日期：2026-10-10

## 为什么用这首曲子

四声部复音功能需要一个同时用到旋律和多个和弦音、长度适中、听一遍就知道对不对的测试信号。《兰花草》（词：胡适《希望》）旋律简单、乐句规整，适合当硬件测试曲。它只是用来验证音高、节奏和和弦，FPGA 里存的是音高与节拍数字，运行时逐采样算出波形，不播任何录音。

## 曲谱来源

旋律转写自网络上的公开简谱，主要依据下面两份，互相核对后一致：

| 来源 | 网址 | 说明 |
| --- | --- | --- |
| 苍强曲谱《兰花草简谱》 | https://www.cangqiang.com.cn/d/49102.html | 1=♭B，2/4，四分音符 72，字迹清楚，作为主依据 |
| 简谱网《刘文正 兰花草简谱》 | https://www.21qupu.com/jianpu/54111.html | 1=E，2/4，用于交叉核对旋律走向与句尾落音 |

## 调式判断

两份简谱的记谱主音都不是 1。旋律反复落在 6 上，乐句以 6 开始、以 6 结束，因此实际调性中心是 6。以 1=♭B 记谱时，6 就是 G，整首曲子在 G 多利亚调上（G A ♭B C D E F），简谱里的 #4 正好对应多利亚的第六级 E。转写到绝对音高时把旋律提高一个八度，落在 G4 到 F5 之间。

## 音级与频率对照

| 简谱级数 | 音名 | MIDI | 频率（Hz） |
| --- | --- | --- | --- |
| 6 | G4 | 67 | 392.00 |
| 7 | A4 | 69 | 440.00 |
| 1 | ♭B4 | 70 | 466.16 |
| 2 | C5 | 72 | 523.25 |
| 3 | D5 | 74 | 587.33 |
| 4 | ♭E5 | 75 | 622.25 |
| #4 | E5 | 76 | 659.26 |
| 5 | F5 | 77 | 698.46 |

## 节奏

时间单位取十六分音符，四个单位一拍。每句歌词都唱 14 个十六分音符，句长一致，和弦因此能落在固定的格子上。节奏按原谱自己的写法安排：谱面记作"6 3 3 3"的句子是四个八分音符，记作"1. 2 1 7"的句子句首是附点八分加十六分，记作"6 -"起句的句子开头是一个四分音符。

| 句 | 歌词 | 音级 | 时值（十六分音符） |
| --- | --- | --- | --- |
| 1 | 我从山中来 | 6 3 3 3 3 | 2 2 2 2 6 |
| 2 | 带着兰花草 | 2 1 2 1 7 | 3 1 2 2 6 |
| 3 | 种在小院中 | 6 6 6 6 6 | 4 2 2 2 4 |
| 4 | 希望花开早 | 5 3 5 5 #4 | 2 2 2 2 6 |
| 5 | 一日看三回 | 3 6 6 5 3 | 2 2 2 2 6 |
| 6 | 看得花时过 | 2 1 2 1 7 | 3 1 2 2 6 |
| 7 | 兰花却依然 | 6 3 3 1 1 | 3 1 2 2 6 |
| 8 | 苞也无一个 | 7 6 3 2 1 | 4 2 2 2 4 |
| 9 | 尾声 | 6 | 14 |

全曲 169 个槽位单位（每句 14 个发声单位加五个气口单位，尾声稍短），发声占七成五。

## 气口

每个音发声之外再留一段静音，长度取它自身时值的四分之一，最少一个单位。播放器在这段时间之前就把声部放掉，所以连十六分音符也能听出断点。

## 速度和现场调速

原谱标四分音符 72。按这个速度一个十六分音符是 9766 个采样点，约 208 毫秒。板子上用 S2 在四档之间循环，每按一次曲子从头重播；L14 与 L16 用二进制显示档位。两只指示灯都是低电平点亮，所以**灯亮表示那一位是 1**。

| 档位 | L14 | L16 | 八分音符 | 整曲 |
| --- | --- | --- | --- | --- |
| 1 倍 | 灭 | 灭 | 417 毫秒 | 35.2 秒 |
| 2 倍（默认） | 亮 | 灭 | 833 毫秒 | 70.4 秒 |
| 3 倍 | 灭 | 亮 | 1250 毫秒 | 105.6 秒 |
| 4 倍 | 亮 | 亮 | 1667 毫秒 | 140.8 秒 |

现场认定合适的是 L14 亮、L16 灭，也就是 2 倍档，已经设为上电默认值。

## 两个演奏维度：强弱与和弦

每句第一个音取力度 127 作重音，其余旋律音取 104，旋律与伴奏因此拉开约 8 到 10 分贝。

和弦改成一整句两个，用两套进行拉开差别。A 套留在自然小调范围（i–iv–VII），B 套偏向多利亚的明亮色彩（III–VII–iv–v），并且 B 套整体抬到力度 46、A 套压到 30，切换时音区和响度一起变，按 S1 两下就能听出来。

| 句 | A 套（两个和弦） | B 套（两个和弦） |
| --- | --- | --- |
| 1 | Gm Gm | ♭B F |
| 2 | Cm Cm | Gm Dm |
| 3 | Gm F | Cm ♭B |
| 4 | Cm Cm | F Gm |
| 5 | Gm Gm | ♭B F |
| 6 | Cm Cm | Gm Dm |
| 7 | ♭B F | Cm ♭B |
| 8 | Cm Gm | F Gm |
| 9 | Gm Gm | Gm Gm |

## 音量

主音量从右移两位改成右移一位，也就是从 -12 分贝提到 -6 分贝。金模型在默认 2 倍档实测峰值 A 套 -3.4 dBFS、B 套 -1.7 dBFS，其余档位在 -3 到 -2 dBFS 之间，都没有触到饱和。

## 循环标记与自查

N16 指示灯每走完一圈曲子闪一次，约 110 毫秒。标称间隔就是上表的整曲长度。用秒表量两次闪烁的间隔，就能判断音序和时间基准是否正确。

另外要知道，这首曲子本身就有反复：原谱里"带着兰花草"和"看得花时过"两句旋律完全相同。听到熟悉的句子回来属于原曲结构。

## 生成、仿真与校验

旋律与和弦写在 `source/tools/song_data.py` 里，RTL 用的常量表和仿真用的期望值都由脚本生成，两边不会漂：

```powershell
cd source
python tools/gen_song_rom.py          # 生成 rtl/audio/song_roms.vh 与 song_expect.vh
powershell -File sim/run_simulation.ps1
python tools/render_preview.py ..\artifacts\lanhuacao_chordA.wav A 2
python tools/verify_preview.py ..\artifacts\lanhuacao_chordA.wav 2
```

`run_simulation.ps1` 是强制门禁，三个测试台全部通过才允许烧录，细节见项目 `AGENTS.md` 的"仿真与烧录门禁"一节。`render_preview.py` 是按 RTL 逐模块等价的 Python 金模型，输出可试听的 WAV；`verify_preview.py` 用 Goertzel 逐音比对音高并检查气口残留。
