Interstellar-530/PolyTouch-FPGA-Synth/docs/history/release-notes/FINAL-20261030.md

# PolyTouch 最终大版本冻结

冻结日：2026-10-30。Git标签：**final-20261030**。功能实现提交：**ede17ffc8d8a889c27b346a60cc88da295be19b6**；随后冻结提交只调整交付文档和发布包校验记录，不修改RTL、曲目或位流。

最终源码主入口为 `source`，交付包为 [FPGA-20261030-v0.1](../../../releases/2026/10/FPGA-20261030-v0.1/original-delivery/README.md)。该目录的v0.1表示归档编号；取代码、图稿、位流或证据时应以本标签为固定入口。仓库仍通过现有集成分支维护，本次没有改写main或覆盖旧标签。

最终版本为32声部HDMI乐器：共享波表流水线、独立声部状态、实时变调、ADSR、混音和PCM5102A标准I2S输出；键盘选音、FSR延音与旋钮弯音。当天增加快速踏板中值判定和2/6连续确认，修复IdleOnly空闲误清延音与面板文字裁切。演示曲保存按下/松开、音高、力度和等待事件，声音仍在FPGA内逐声部逐样本生成。流程图、源快照、复现脚本和证据随包交付。

最终Flash位流为 `releases/2026/10/FPGA-20261030-v0.1/original-delivery/target/instrument.fs`，SHA256为 **b4dd1b5d1a5d89ba871e34f4e230a85fbe3c92c486934f57dcc811bdb2edf003**。Flash擦写与工具内置校验成功，重载稳定后独立读得User Code **0x00002626**、Status **0x00006020**。原始源码快照与位流由成功构建收据绑定，发布包全部文件另有SHA256。

已完成8项定向RTL自检；24组真实2kHz节拍测试最长按下约1.5ms、松开约3.5ms，真实MCP3208模型与生产顶层的5ms踏板状态截止断言通过。实现报告Setup/Hold违例端点均为0，BSRAM31/46。UI文字像素复核与全部流程图布局复核通过。完整Quick/Full未重新通过，彻底断电冷启动、实物踏板稳定性与听感、整机模拟音频延迟尚未新增实测结论。

冻结表示确定本次交付内容与证据，不是主办方合规认证。竞赛基础10ms与拓展5ms指标指完整演奏到音频输出，不能用局部踏板状态结果替代。2ms短掉压保持与持续5ms低值按松开处理的稳定性取舍已记录。提交材料与现场展示应据此表述，避免扩大已验证范围。

本次Git整理没有创建临时脚本、构建或渲染目录；先前临时仿真产物已清理。源文件、复现命令、图稿、位流及关键证据保留，本机完整archive和工具环境不整体纳入Git。回退需选择旧版位流重新写入Flash，断电不自动恢复旧版。
