Interstellar-530/PolyTouch-FPGA-Synth/docs/history/release-notes/v2.1.1.md

# PolyTouch v2.1.1 本地合流基线

2026-10-22，未发布。开发分支 `codex/v2.1.1-integration-20261022`。基于已发布 v2.1.0 合入队友 `f7052fb`，作为后续工作统一入口。GitHub main 和 v2.1.0 标签保持原状。

本版保留 v2.1.0 全部生产功能、少表音色及 32 声部独立原型。新增的是队友四个测试台的输入接线、相位推进和实际计算预算修正；钢琴表编号适配当前 12 表布局，明确声部读取阶段再记录选表命中。生产源码与音频数据没有改变，未生成新位流。

四个相关测试及力度全量边界测试通过，生产 192 输入/位流与原型 21 输入哈希仍匹配 v2.1.0 已审核证据。完整长门禁和实机验收本轮未重复；正式烧录前仍执行项目门禁。详细取舍见 [合流评审](../../reviews/FPGA-队友版本合流评审-20261022-v0.1.md)，复现日志见 [证据](../../../evidence/2026/10/FPGA-版本合流-20261022-v0.1/README.md)。

交付归档 `archive/FPGA-20261022-v0.1` 包含源码快照、沿用的生产位流、测试证据、复现命令、变更说明、MANIFEST 和 SHA256。已清理本轮临时仿真目录，既有历史产物与工具环境保留。
