Interstellar-530/PolyTouch-FPGA-Synth/docs/history/handoff-20261008/SONG_KUANGGU_HUIXIANG.md

# 第二首测试曲：《旷古回响》bridge

## 来源

- 曲谱：用户提供的简谱截图（1/3、2/3、3/3 三页），标注 **1=♭A、4/4、♩=100**，带歌词。
- 谱面出处水印：Bilibili“被遗忘者的哀伤”、微信公众号“ACG简谱姬 被遗忘者的哀伤 记谱整理”。
- 只采用谱面数字，不再使用音频提取的旋律。

## 段落

bridge：“巍峨西山古 浩瀚大河雄 / 兴亡陈迹今只余 冢上青柏葱葱 / 摄衣瞻拜太史公 / 千载斯文在此中”。对应简谱 13 小节，100 BPM 下 **31.2 秒**。

高潮“草木心……今迎后来者”尚未录入。

## 旋律（1=♭A：1=A♭4，2=B♭4，3=C5，5=E♭5，6=F5，7=G5）

| 歌词 | 简谱 | 音高 |
| --- | --- | --- |
| 巍峨西山 | 6. 5 3 2 | F5 E♭5 C5 B♭4 |
| 古 | 3 5 3 – | C5 E♭5 C5（连音，拖长） |
| 浩瀚大河 | 6. 7 6 5 | F5 G5 F5 E♭5 |
| 雄 | 3 5 3 – | C5 E♭5 C5（连音） |
| 兴亡陈迹 | 6. 5 3 5 | F5 E♭5 C5 E♭5 |
| 今只余 | 2 3 6̣ 1 | B♭4 C5 F4 A♭4（6̣→1 连音） |
| 冢上青柏葱 | 2 2 1 5 3 1 3 | B♭4 B♭4 A♭4 E♭5 C5 A♭4 C5 |
| 葱 | 3 – | C5 保持 |
| 摄衣瞻拜 | 6. 5 3 2 | F5 E♭5 C5 B♭4 |
| 太史公 | 3. 5 3 | C5 E♭5 C5（连音，公=4 格） |
| 千载 | 2 1 | B♭4 A♭4（载为短音） |
| 斯文在此 | 6̣ 1 2 3 | F4 A♭4 B♭4 C5 |
| 中 | 5 → 6 – | E♭5 → F5（连音收尾，6 保持 8 格） |

## 连音线

以下组按“单次起音、组内换音不重触发”渲染，并在组尾加 50 ms 重叠：

- 古 / 雄：3 5 3
- 余：6̣ 1
- 太史公：3. 5 3
- 中：5 → 6

## 和弦

按 F 小调（1=♭A）循环 **B♭m–G♭–E♭m–F**，每小节一个和弦；后续接高潮时可换 E♭–A♭–F–B♭m。

## 文件

- 数据：`source/tools/song_kuanggu.py`
- 试听：`artifacts/kuanggu_bridge.wav`（31.2 秒，48 kHz，32 声部分层 mock）
- 生成脚本：`tmp/kuanggu/mock_jianpu.py`（临时）

## 状态

- 2026-10-28 已接入 RTL 第二套事件表，与《晚夜》共用生产音频引擎。板载 S1 短按切换曲目，长按仍选音色；切换时清旧事件并从头播放。
- 生成器为 `source/tools/gen_second_song.py`，生成 `source/rtl/audio/song_second_roms.vh`。新增曲目切换和顶层按键自检已注册到 Quick 门禁。
- RTL 沿用逐音符 Note Off/On，尚未复制试听脚本的连续换音与 50 ms 重叠。Flash 最终结果见 `archive/FPGA-20261028-v0.2`。
- 高潮段待补。
