Interstellar-530/PolyTouch-FPGA-Synth/docs/reviews/FPGA-20261012-v0.1/CHANGELOG.md

# 变更说明

2026-10-12 v0.1：将项目进展审查、外设 Excel 和必要验证证据整理为 GitHub 共享副本；新增“零外设可执行任务”，在 10 月 10 日旧规划首页标注状态更新。没有修改生产 RTL、CST、SDC、程序或板上 Flash。

验证：本地 `main` 与 `origin/main` 的审查基线一致；原 RTL 门禁通过，新增 ADSR 回归按预期失败并定位缺陷；隔离 Gowin PnR 报告 4/46 BSRAM、12/48 乘法器、6/24 DSP 宏块；COM13 实测收到错误指令回执；Excel 保存后独立复开检查通过。回退方式为对本次文档提交执行 `git revert`，本地完整归档和桌面表格不受影响。
