Interstellar-530/PolyTouch-FPGA-Synth/evidence/2026/10/FPGA-debug8usb-20261020-v0.1/gate_summary.txt

# RTL 门禁与构建状态（2026-10-20 v0.2）

## 构建

- `debug8usb`：PASS，已生成 `instrument.fs`。
- 资源：Logic 11202/20736，Register 3596/16173，BSRAM 40/46，DSP 0.75/24。
- 时序：Setup 最差裕量 +5.893 ns，Hold +0.211 ns，0 条负裕量。
- 引脚：CH9350L RX=L9、TX=N8；MCP3208 与 PT8211 均按 USB 档约束落位。

## 本轮要求的两项

- `tb_gpio_top`：PASS。修复了演示模式下 GPIO Note Off 未被消费、阻塞下一次 Note On 的问题。
- `tb_audio_capture`：PASS，完整捕获 58,880 个原生 PT8211 帧，覆盖 UART、ADSR、四音和弦、松键、M0/M1 与数字静音。

## 其余门禁

跳过已单独完成的长时捕获后，门禁仍有 13 个失败：

- `tb_shared_engine`（编译）
- `tb_pressure_top`（编译）
- `tb_timbre_top`（编译）
- `tb_architecture_equivalence`
- `tb_shared_bend_equivalence`
- `tb_voice_transition`
- `tb_voice_transition_audio`
- `tb_voice_transition_top`（编译）
- `tb_bright_banks`
- `tb_bandlimit_engine`
- `tb_precision_audio`（编译）
- `tb_bandlimit_engine_wide`
- `tb_ram_wavetable_engine`

缺失并被明确跳过：`tb_piano_engine`、`tb_piano_morph`、`tb_piano_envelope`、`tb_top_i2s_27m`、`tb_generic_bright`。

## 结论

`debug8usb` 位流已包含 GPIO/HID 修复，USB 键盘链路、FSR/弯音、GPIO 演示切换和长时 PT8211 捕获均通过。剩余 13 个失败属于旧层次测试或原型期望问题，仍需逐项处理或确认过时；在此之前不应把该位流标记为最终比赛固件。
