Interstellar-530/PolyTouch-FPGA-Synth/evidence/2026/10/FPGA-standard27-board-20261024-v0.1/debug8-hash-before.txt

Algorithm : SHA256
Hash      : 2F8DB574A2ECABE2E71A8B6A8DA32CDAF2EF993F9198AB120CAA15B35DFC8606
Path      : E:\Working Space\FPGA\output\handoff_milestone2_20261008\source\build\gowin_top_dbg8\runs\20261020T104934587-651ba0b1\instrument\impl\pnr\instrument.fs
