Interstellar-530/PolyTouch-FPGA-Synth/releases/2026/10/FPGA-20261010-v0.7/CHANGES.md

# 变更

见 [归档变更](catalog/CHANGES.md)。2026-11-01 仅重新分类，不改写原提交历史。
