Interstellar-530/PolyTouch-FPGA-Synth/docs/history/release-notes/FPGA-final-20261029-v1.0/CHANGES.md

# FPGA-20261029-v0.9

波形画面更新从45.776Hz降至11.444Hz，约每87.38ms发布一幅完整波形，速度为v0.8的四分之一。实现是在原16倍抽样、64点捕获窗口之后保持四个窗口再发布；声音、曲目速度和声部状态刷新保持原配置。增加小计数器，无新增BSRAM或音频乘法器。同步更新自检台，但延续用户跳过所有验证的要求未执行。

Gowin构建完成。Flash首次默认2.5MHz写入在扇区124擦除失败；改1MHz后operation37擦除、写入和内置校验成功，再执行operation1从Flash重载成功。详细日志见evidence。未独立读回、未冷断电、未仿真或观察实屏，不能将内置Flash校验当作视觉验收。

回退：恢复v0.8的ui_audio_visual_export.v、ram32_board_engine.v后重建并写入Flash。保留现有成功构建以供收据引用；本轮没有一次性临时脚本或仿真缓存需要删除。
