Interstellar-530/PolyTouch-FPGA-Synth/evidence/2026/10/FPGA-PLL时钟-20261017-v0.1/build-profiles/debug-sources.txt

E:/Working Space/FPGA/output/handoff_milestone2_20261008/source/build/isolated/top_dbg_build.v
E:/Working Space/FPGA/output/handoff_milestone2_20261008/source/rtl/top.v
E:/Working Space/FPGA/output/handoff_milestone2_20261008/source/rtl/audio/dds_osc.v
E:/Working Space/FPGA/output/handoff_milestone2_20261008/source/rtl/audio/adsr.v
E:/Working Space/FPGA/output/handoff_milestone2_20261008/source/rtl/audio/poly_voice.v
E:/Working Space/FPGA/output/handoff_milestone2_20261008/source/rtl/audio/poly_voice_s6.v
E:/Working Space/FPGA/output/handoff_milestone2_20261008/source/rtl/audio/wavetable_osc_dual_s6.v
E:/Working Space/FPGA/output/handoff_milestone2_20261008/source/rtl/audio/note_phase_inc.v
E:/Working Space/FPGA/output/handoff_milestone2_20261008/source/rtl/audio/event_fifo.v
E:/Working Space/FPGA/output/handoff_milestone2_20261008/source/rtl/audio/voice_alloc.v
E:/Working Space/FPGA/output/handoff_milestone2_20261008/source/rtl/audio/song_player.v
E:/Working Space/FPGA/output/handoff_milestone2_20261008/source/rtl/audio/mixer_s6.v
E:/Working Space/FPGA/output/handoff_milestone2_20261008/source/rtl/audio/pt8211_tx.v
E:/Working Space/FPGA/output/handoff_milestone2_20261008/source/rtl/audio/i2s_tx.v
E:/Working Space/FPGA/output/handoff_milestone2_20261008/source/rtl/audio/uart_ctrl.v
E:/Working Space/FPGA/output/handoff_milestone2_20261008/source/rtl/audio/gpio_keyboard.v
E:/Working Space/FPGA/output/handoff_milestone2_20261008/source/rtl/audio/mcp3208_spi.v
E:/Working Space/FPGA/output/handoff_milestone2_20261008/source/rtl/audio/pressure_bend.v
E:/Working Space/FPGA/output/handoff_milestone2_20261008/source/rtl/audio/shared_wavetable_engine.v
E:/Working Space/FPGA/output/handoff_milestone2_20261008/source/rtl/audio/global_crossfade.v
E:/Working Space/FPGA/output/handoff_milestone2_20261008/source/rtl/audio/gowin_prom_wave_sine.v
E:/Working Space/FPGA/output/handoff_milestone2_20261008/source/rtl/audio/gowin_prom_wave_bright.v
E:/Working Space/FPGA/output/handoff_milestone2_20261008/source/rtl/audio/gowin_prom_bright_bank.v
E:/Working Space/FPGA/output/handoff_milestone2_20261008/source/rtl/audio/wavetable_rom_dual.v
E:/Working Space/FPGA/output/handoff_milestone2_20261008/source/rtl/audio/clk_params.vh
E:/Working Space/FPGA/output/handoff_milestone2_20261008/source/rtl/audio/instrument_controls.v
E:/Working Space/FPGA/output/handoff_milestone2_20261008/source/rtl/audio/bend_coefficients.vh
E:/Working Space/FPGA/output/handoff_milestone2_20261008/source/rtl/audio/bend_ratio_pipeline.v
E:/Working Space/FPGA/output/handoff_milestone2_20261008/source/rtl/audio/split_audio_multiplier.v
E:/Working Space/FPGA/output/handoff_milestone2_20261008/source/rtl/audio/voice_state_ram.v
E:/Working Space/FPGA/output/handoff_milestone2_20261008/source/rtl/audio/ram_wavetable_engine.v
E:/Working Space/FPGA/output/handoff_milestone2_20261008/source/rtl/audio/wide_master.v
E:/Working Space/FPGA/output/handoff_milestone2_20261008/source/rtl/audio/ram_audio_datapath.v
E:/Working Space/FPGA/output/handoff_milestone2_20261008/source/rtl/audio/ram_audio_compute.v
E:/Working Space/FPGA/output/handoff_milestone2_20261008/source/rtl/audio/audio_pll_clock.v
E:/Working Space/FPGA/output/handoff_milestone2_20261008/source/rtl/audio/audio_frame_bridge.v
E:/Working Space/FPGA/output/handoff_milestone2_20261008/source/rtl/audio/ram_audio_clocked.v
E:/Working Space/FPGA/output/handoff_milestone2_20261008/source/rtl/audio/voice_transition.v
E:/Working Space/FPGA/output/handoff_milestone2_20261008/source/rtl/audio/note_ownership.v
E:/Working Space/FPGA/output/handoff_milestone2_20261008/source/constraints/primer20k_dock3714.cst
E:/Working Space/FPGA/output/handoff_milestone2_20261008/source/constraints/primer20k.sdc
