Interstellar-530/PolyTouch-FPGA-Synth/evidence/2026/11/FPGA-20261101-reorganization-v0.1/build-setup/debug-sources.txt

E:/Working Space/FPGA/source/build/isolated/top_dbg_build.v
E:/Working Space/FPGA/source/rtl/top.v
E:/Working Space/FPGA/source/rtl/audio/dds_osc.v
E:/Working Space/FPGA/source/rtl/audio/adsr.v
E:/Working Space/FPGA/source/rtl/audio/poly_voice.v
E:/Working Space/FPGA/source/rtl/audio/poly_voice_s6.v
E:/Working Space/FPGA/source/rtl/audio/wavetable_osc_dual_s6.v
E:/Working Space/FPGA/source/rtl/audio/note_phase_inc.v
E:/Working Space/FPGA/source/rtl/audio/event_fifo.v
E:/Working Space/FPGA/source/rtl/audio/voice_alloc.v
E:/Working Space/FPGA/source/rtl/audio/song_player.v
E:/Working Space/FPGA/source/rtl/audio/mixer_s6.v
E:/Working Space/FPGA/source/rtl/audio/pt8211_tx.v
E:/Working Space/FPGA/source/rtl/audio/i2s_tx.v
E:/Working Space/FPGA/source/rtl/audio/uart_ctrl.v
E:/Working Space/FPGA/source/rtl/audio/gpio_keyboard.v
E:/Working Space/FPGA/source/rtl/audio/mcp3208_spi.v
E:/Working Space/FPGA/source/rtl/audio/pressure_bend.v
E:/Working Space/FPGA/source/rtl/audio/fsr_mute.v
E:/Working Space/FPGA/source/rtl/audio/shared_wavetable_engine.v
E:/Working Space/FPGA/source/rtl/audio/global_crossfade.v
E:/Working Space/FPGA/source/rtl/audio/gowin_prom_wave_sine.v
E:/Working Space/FPGA/source/rtl/audio/gowin_prom_wave_bright.v
E:/Working Space/FPGA/source/rtl/audio/gowin_prom_bright_bank.v
E:/Working Space/FPGA/source/rtl/audio/gowin_prom_guitar_bank.v
E:/Working Space/FPGA/source/rtl/audio/gowin_prom_piano_bank.v
E:/Working Space/FPGA/source/rtl/audio/wavetable_rom_dual.v
E:/Working Space/FPGA/source/rtl/audio/clk_params.vh
E:/Working Space/FPGA/source/rtl/audio/instrument_controls.v
E:/Working Space/FPGA/source/rtl/audio/bend_coefficients.vh
E:/Working Space/FPGA/source/rtl/audio/bend_ratio_pipeline.v
E:/Working Space/FPGA/source/rtl/audio/split_audio_multiplier.v
E:/Working Space/FPGA/source/rtl/audio/voice_state_ram.v
E:/Working Space/FPGA/source/rtl/audio/ram_wavetable_engine.v
E:/Working Space/FPGA/source/rtl/audio/wide_master.v
E:/Working Space/FPGA/source/rtl/audio/ram_audio_datapath.v
E:/Working Space/FPGA/source/rtl/audio/ram_audio_compute.v
E:/Working Space/FPGA/source/rtl/audio/audio_pll_clock.v
E:/Working Space/FPGA/source/rtl/audio/audio_frame_bridge.v
E:/Working Space/FPGA/source/rtl/audio/ram_audio_clocked.v
E:/Working Space/FPGA/source/rtl/audio/voice_transition.v
E:/Working Space/FPGA/source/rtl/audio/note_ownership.v
E:/Working Space/FPGA/source/rtl/audio/kbd_uart_rx.v
E:/Working Space/FPGA/source/rtl/audio/ch9350_rx.v
E:/Working Space/FPGA/source/rtl/audio/hid_keymap.v
E:/Working Space/FPGA/source/rtl/audio/host_kbd_input.v
E:/Working Space/FPGA/source/rtl/video/ui_status_export.v
E:/Working Space/FPGA/source/rtl/video/ui_audio_visual_export.v
E:/Working Space/FPGA/source/constraints/primer20k_dock3714.cst
E:/Working Space/FPGA/source/constraints/primer20k.sdc
