Interstellar-530/PolyTouch-FPGA-Synth/releases/2026/10/FPGA-20261010-v0.7/catalog/CHANGES.md

# 归档变更

2026-11-01：按日期重新分类，原标签 `v0.5.5-20261010` 保留，未重写历史。

原提交说明：Make RTL simulation a mandatory gate before programming; refine rhythm, chords and level
