Interstellar-530/PolyTouch-FPGA-Synth/releases/2026/10/FPGA-20261013-v0.1/catalog/CHANGES.md

# 归档变更

2026-11-01：按日期重新分类，原标签 `v1.0.0` 保留，未重写历史。

原提交说明：release: v1.0.0 annotated SRAM performance baseline
