Interstellar-530/PolyTouch-FPGA-Synth/releases/2026/10/FPGA-20261021-v0.3/catalog/CHANGES.md

# 归档变更

2026-11-01：按日期保存阶段源码。原提交说明：test: rebaseline v2.0.0 piano and timing benches
