Interstellar-530/PolyTouch-FPGA-Synth/releases/2026/10/FPGA-20261030-v0.1/original-delivery/CHANGES.md

# 今日变更

按用户“最终大版本”的要求，以final-20261030标签冻结。该冻结标记保留已有验证范围，不将尚未进行的实物验收转写成通过，也不修改已经烧录的位流。

键盘IdleOnly空闲超时不再复位正在延音的音乐状态；真正断开、Panic、Strict超时保护保留。FSR增加连续样本确认，最终优化为独立三点中值与2/6确认，减少显示IIR对踏板状态的延迟。新增四个自检台，扩展真实生产链的掉压保持与5ms状态截止断言，均以$fatal自检并登记到门禁。

修复HDMI面板长文字裁切，补全踏板、力度、压力、状态和46.875kHz标签，改正底部实际键盘输入标识。补充演示曲事件构建、音色波表与板上实时合成的区分，以及当天踏板稳定处理的五款图稿。

最终8项定向RTL验证、零setup/hold违例实现、SRAM标识核对、Flash写入内置校验和重载后的稳定标识核对通过。完整Quick/Full、实物冷启动与听感未新增通过结论。小于5ms是踏板状态要求，不能把自然余音结束或整机模拟音频延迟混为同一结论。

本次Git整理没有再修改RTL或重新烧录，只整理结果、更新首页和历史文档入口，并给发布包设置原始字节保留规则。临时仿真目录已于算法任务结束清理；打包未创建临时目录。工具环境、本机archive和其他日期的未跟踪文件未删除、未整体纳入提交。
