Interstellar-530/PolyTouch-FPGA-Synth/docs/history/logs/2026/10/FPGA_DEBUG_LOG_20261010_r7_rhythm_and_tempo.md

# 调试日志：节拍划分与现场调速（2026-10-10 修订十四）

## 反馈

两条：曲谱的节拍划分有问题；板上听感仍然偏快，怀疑参考的时钟频率过快。

## 先把时钟这条查清楚

播放器的时基来自 `pt8211_tx` 产生的 `sample_tick`。这个模块用 27 MHz 输入，`div_cnt` 数到 8 翻转一次 BCK，因此 BCK 周期是 18 个时钟，也就是 1.5 MHz；帧计数器 `b_cnt` 数满 32 个 BCK 才在 `b_cnt` 等于 31 时给出一次 `sample_tick`，所以采样节拍是 46875 Hz。逐行核对过这三处，没有发现分频比写错的地方。

播放器里的节拍计数器按 `UNIT_SAMPLES` 个采样节拍产生一次节拍脉冲，上一版是 5327，对应每个音占 6 个节拍单位约 0.68 秒。ROM 内容也逐项解开核对过：第一项力度码 7、音号 67、时值 6，后面几项符合预期。综合日志显示三个 ROM 都被识别为 RAM 并读入，不存在表没加载的情况。

也就是说，设计内部的时间关系和金模型一致。真要把板上速度和文档对上，最省事的办法是用现成的 N16 指示灯：它直接由 27 MHz 计数，半秒翻转一次，秒表量十次约 10 秒就说明 27 MHz 成立。这个检查不需要任何额外设备。

## 节拍划分

原来每个旋律音都是同一个时值，这确实不符合原谱。改用十六分音符作为最小单位，四个单位一拍，按谱面把每句拆成不等长的时值，具体见 `SONG_LANHUACAO.md` 的表格。原谱里"6 3 3 3 | 3. 2"这一小节读成四个八分音符加一个附点四分音符，"1. 2 1 7"读成附点八分加十六分再两个八分，"6 - | 6 6 6 6"读成四分音符起句。

## 气口

原来固定提前两个节拍单位关音，对长音合适、对短音太粗暴。改成由音符自身长度决定：静音取发声时值的四分之一，最少一个单位。播放器在 ROM 里只存发声长度，这个气口值由移位算出，和 Python 里的 `gap_units()` 完全一致，两边不会漂。

## 现场调速

与其再来回猜速度，不如把速度做成可调的。播放器的时基加了 `tempo_sel`，把每个单位拉伸 1 到 4 倍；`top.v` 里 S2 按一下加一档并重播，L14 与 L16 用二进制显示当前档位。默认放在 2 倍，也就是比原谱慢一倍，整曲 65 秒。这样只要按几下键就能确定合适的速度，不需要重新构建。

## 验证

构建无警告，资源 4568 逻辑单元、784 寄存器、4 块 BSRAM、6 个 DSP，Fmax 36.441 MHz，零建立与保持违规。码流 SHA256 `c2a349375877bfb5a6a487bcd7745612b83eaf07416738d18264957955b9869a`，User Code `0x000069DC`，已写入 SRAM 并回读确认。金模型按默认档渲染两套和弦，A 套峰值 -9.2 dBFS、B 套 -8.6 dBFS，41 个音的音高与气口检查全部通过。

## 下一步

需要人耳确认两件事：哪一个速度档位合适（看 L14/L16 的灯），以及板上实际速度是否与文档接近。如果板上速度和文档差得远，请用 N16 的每秒一闪做一次秒表核对，把结果告诉我，我据此换算修正系数。
