Interstellar-530/PolyTouch-FPGA-Synth/evidence/2026/10/FPGA-debug8usb-20261020-v0.1/evidence/audio_capture.csv

frame | left | right | stage | gate_mask | idle_mask | note0 | note1 | note2 | note3 | final_sample_reference
1612 | 0 | 0 | initial_silence | 0 | 15 | 0 | 0 | 0 | 0 | 0
1613 | 0 | 0 | initial_silence | 0 | 15 | 0 | 0 | 0 | 0 | 0
1614 | 0 | 0 | initial_silence | 0 | 15 | 0 | 0 | 0 | 0 | 0
1615 | 0 | 0 | initial_silence | 0 | 15 | 0 | 0 | 0 | 0 | 0
1616 | 0 | 0 | initial_silence | 0 | 15 | 0 | 0 | 0 | 0 | 0
1617 | 0 | 0 | initial_silence | 0 | 15 | 0 | 0 | 0 | 0 | 0
1618 | 0 | 0 | initial_silence | 0 | 15 | 0 | 0 | 0 | 0 | 0
1619 | 0 | 0 | initial_silence | 0 | 15 | 0 | 0 | 0 | 0 | 0
1620 | 0 | 0 | initial_silence | 0 | 15 | 0 | 0 | 0 | 0 | 0
1621 | 0 | 0 | initial_silence | 0 | 15 | 0 | 0 | 0 | 0 | 0
1622 | 0 | 0 | initial_silence | 0 | 15 | 0 | 0 | 0 | 0 | 0
1623 | 0 | 0 | initial_silence | 0 | 15 | 0 | 0 | 0 | 0 | 0
1624 | 0 | 0 | initial_silence | 0 | 15 | 0 | 0 | 0 | 0 | 0
1625 | 0 | 0 | initial_silence | 0 | 15 | 0 | 0 | 0 | 0 | 0
1626 | 0 | 0 | initial_silence | 0 | 15 | 0 | 0 | 0 | 0 | 0
1627 | 0 | 0 | initial_silence | 0 | 15 | 0 | 0 | 0 | 0 | 0
1628 | 0 | 0 | initial_silence | 0 | 15 | 0 | 0 | 0 | 0 | 0
1629 | 0 | 0 | initial_silence | 0 | 15 | 0 | 0 | 0 | 0 | 0
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
