Interstellar-530/PolyTouch-FPGA-Synth/docs/hardware/wiring-20261023-v0.1-assets/01-system.pdf

### 普通 USB 键盘

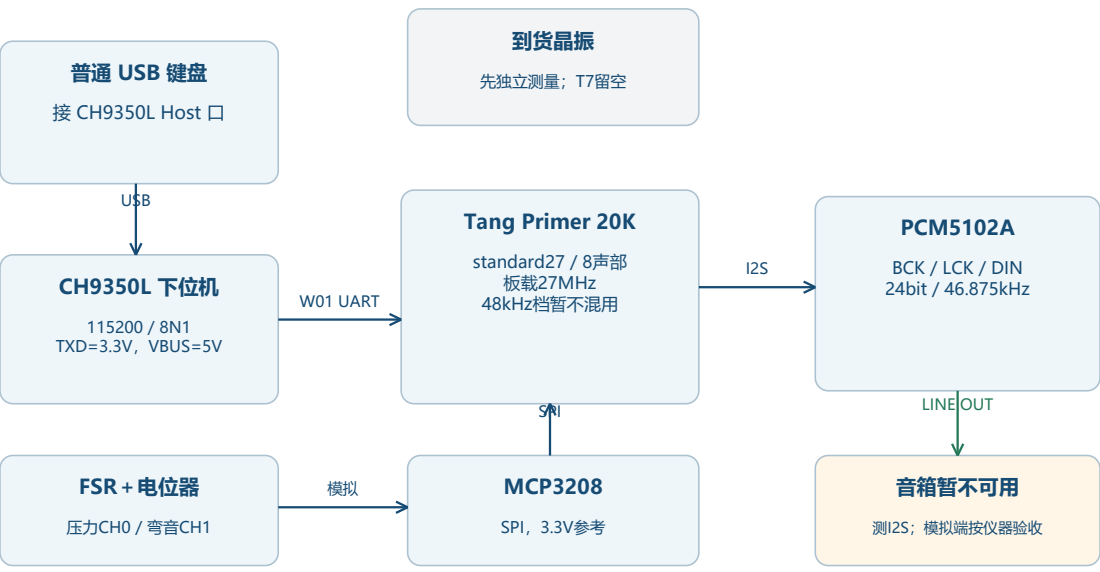
[picture p63: page 1]
接 CH9350L Host 口; CH9350L 下位机; 115200 / 8N1 TXD=3.3V，VBUS=5V; USB; Tang Primer 20K; standard27 / 8声部 板载27MHz; W01 UART; 48kHz档暂不混用; PCM5102A; 到货晶振; 先独立测量；T7留空; FSR＋电位器; 压力CH0 / 弯音CH1; MCP3208; SPI，3.3V参考; SPI; 音箱暂不可用; 测I2S；模拟端按仪器验收; LINE OUT

BCK / LCK / DIN
24bit / 46.875kHz
