Interstellar-530/PolyTouch-FPGA-Synth/docs/hardware/wiring-20261023-v0.1-assets/02-dock-j5j6.pdf

+3V3 +3V3

12 +3V3 +3V3

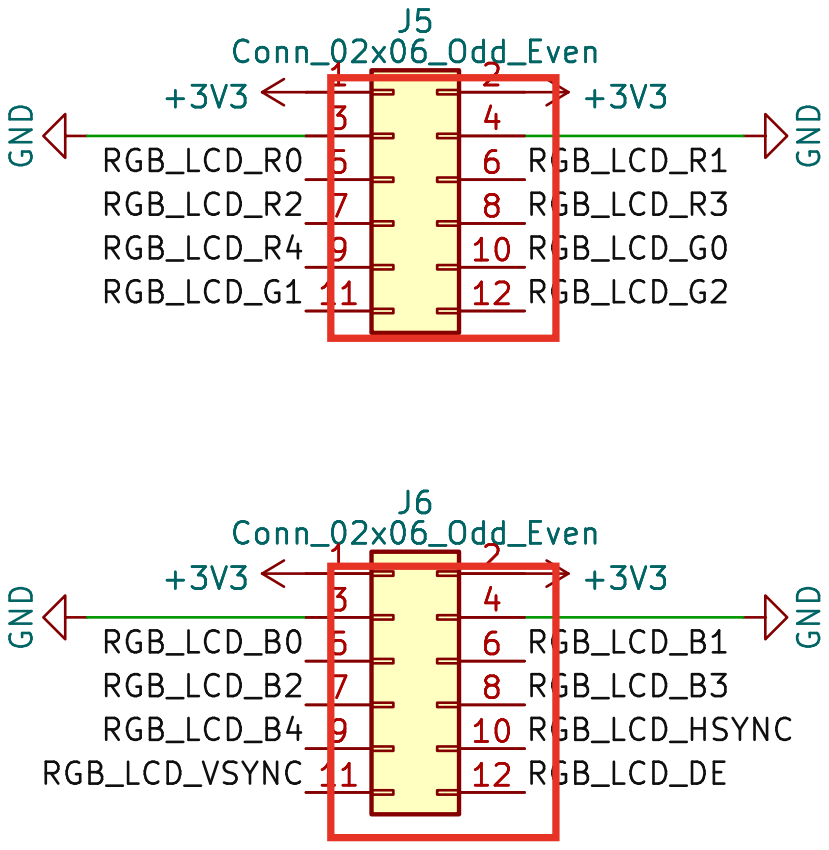
[picture p64: page 1]
GND; +3V3 GND; GND GND GND; J5 Conn_02x06_Odd_Even GND; +3V3 +3V3 GND; J6 Conn_02x06_Odd_Even; GND GND; TP_SDA; RGB_LCD_B4 TP_INT; RGB_LCD_CLK RGB_LCD_HSYNC; RGB_LCD_R2 RGB_LCD_DE RGB_LCD_R0 RGB_LCD_BL; TP_RST; RGB_LCD_B1 TP_SCK; RGB_LCD_B0 RGB_LCD_R3 RGB_LCD_B3 RGB_LCD_B1 RGB_LCD_DE; RGB_LCD_B2 RGB_LCD_G2; RGB_LCD_CLK RGB_LCD_G0; RGB_LCD_B4 RGB_LCD_R1; RGB_LCD_B1 RGB_LCD_B3 RGB_LCD_B0 TP_RST RGB_LCD_BL; RGB_LCD_R2 RGB_LCD_B0; RGB_LCD_R0 RGB_LCD_R1 RGB_LCD_B2 RGB_LCD_B4 RGB_LCD_VSYNC; TP_SCK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
