Interstellar-530/PolyTouch-FPGA-Synth/docs/hardware/wiring-20261023-v0.1-assets/04-headers.pdf

## PMOD3 / 照片右下

## PMOD2 / 照片中下

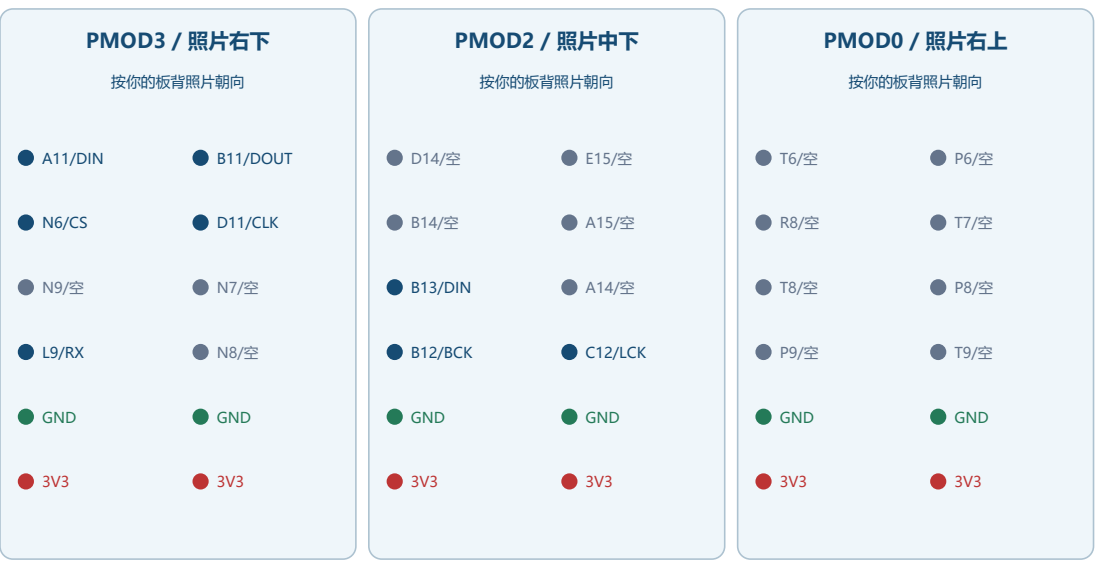
[picture p65: page 1]
按你的板背照片朝向; A11/DIN; B11/DOUT; D11/CLK; GND; B13/DIN; B12/BCK; C12/LCK; PMOD0 / 照片右上
