Interstellar-530/PolyTouch-FPGA-Synth/docs/hardware/wiring-20261023-v0.1-assets/03-dock-j14.pdf

R96 | 1.5K R95 | 1.5K R91
SW3 | WS2812-DAT MIC_DAT1 MIC_DAT0 MIC_DAT2

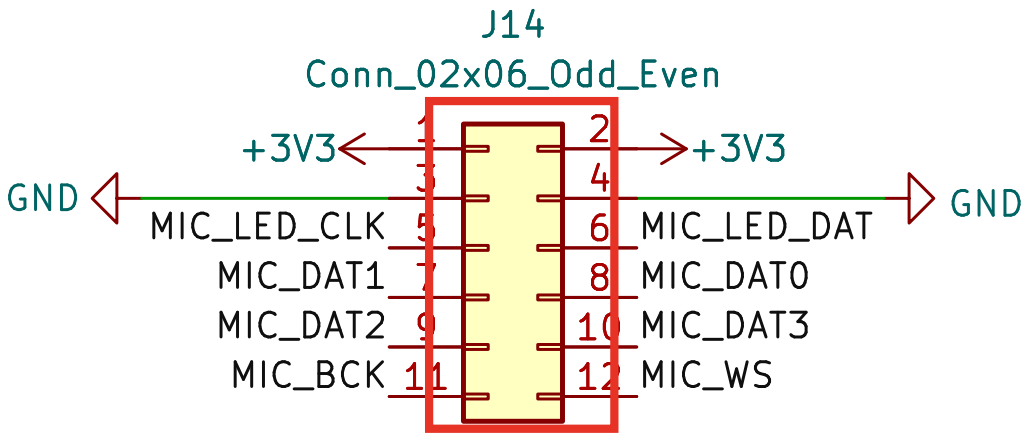
[picture p66: page 1]
