Interstellar-530/PolyTouch-FPGA-Synth/source/sim/tb_ram32_clocked.v

`timescale 1ns/1ps
// Dual-clock shell test: 12.288 MHz reference + rPLL compute domain, stereo
// frame bridge, event handshake, I2S output. Checks PLL lock, event delivery,
// 32-voice allocation, mono-consistent I2S output and frame ids.
module tb_ram32_clocked #(parameter integer MULT=4);
 reg clk_ref=0;
 always #40.690104 clk_ref=~clk_ref;   // 12.288 MHz
 reg reset=1;
 reg ev_valid=0,ev_on=0;
 reg [6:0] ev_note=0;
 reg [7:0] ev_vel=8'd120;
 reg instrument=0;
 reg [1:0] piano_tone=0;
 wire ev_ready,bck,lrck,din,locked,initialized;
 wire signed [23:0] audio;
 wire [5:0] active;
 wire [31:0] clips;
 wire [7:0] frame_id;
 wire sample_valid;
 wire signed [23:0] dl,dr;
 wire decoded;
 integer frames=0,i,ev_count=0,request_count=0,result_count=0,capture_count=0;
 reg frame_seen=0;
 reg [7:0] previous_frame_id=0;
 realtime t_first,t_last,period;
 real expected_period;

 ram32_clocked_top #(.MULT(MULT),.ATTACK_STEP(16'd8192),.DECAY_STEP(16'd4096),
                     .RELEASE_STEP(16'd4096),.SUSTAIN_LEVEL(16'd32768)) dut(
  .clk_ref(clk_ref),.reset(reset),
  .instrument(instrument),.piano_tone({1'b0,piano_tone}),
  .volume_target(7'd100),.mute(1'b0),.pressure_enable(1'b0),
  .pressure_adc(12'd3200),.bend_adc(12'd2048),
  .ev_valid(ev_valid),.ev_on(ev_on),.ev_note(ev_note),.ev_vel(ev_vel),
  .ev_ready(ev_ready),
  .i2s_bck(bck),.i2s_lrck(lrck),.i2s_din(din),
  .audio_sample(audio),.sample_valid(sample_valid),
  .active_count(active),.clip_count(clips),.locked(locked),.initialized(initialized),
  .frame_id(frame_id));
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
