Interstellar-530/PolyTouch-FPGA-Synth/(commit log)

2026-10-08 Add milestone 2 handoff and debugging logs
    [FPGA选题汇总.xlsx]
2026-10-10 Add key tone switching and volume attenuation
2026-10-10 Fix continuous tone and PT8211 word alignment
    [top.v]
2026-10-10 Add UART pitch control, S3 sync reset, stronger smoothing, plan v0.5..v1.0
    [top.v]
2026-10-10 Fix FIR tap coefficients and refresh v0.4 bitstream records
    [top.v]
2026-10-10 Add serial console, peripheral BOM xlsx, TDM review and plain-language plan
    [tmp3_xlsx_dump.txt, 外设采购清单-20261010.xlsx]
2026-10-10 Remove stray temporary scripts committed by mistake
    [tmp3_xlsx_dump.txt]
2026-10-10 Program bitstream to external flash, confirm DC-IN supply, narrow noise source
    [外设采购清单-20261010.xlsx]
2026-10-10 Record board disconnection state after reconnecting power
2026-10-10 Document that the 702-EN 3-pin header shuts down the BL702
2026-10-10 Fix UART pins to M11/T13 and reprogram SRAM plus external flash
2026-10-10 Add four-voice polyphony, Lan Hua Cao test tune and chord-set switching
2026-10-10 Rework the test tune rhythm from the score and add runtime tempo presets
    [top.v]
2026-10-10 Replace song ROM arrays with constant case tables and add a loop-marker LED
    [top.v]
2026-10-10 Fix tick_pulse level-vs-pulse bug that made the tune race; verify by RTL simulation
    [tb_song_timing.v, tb_tick_rate.v]
2026-10-12 Archive October 12 review and no-peripherals work plan
    [FPGA外设复查清单-20261012-v0.1.xlsx]
2026-10-12 Fix ADSR release and retrigger allocated voices
    [adsr.v, dds_osc.v, tb_adsr.v, tb_voice_order.v, tb_voice_retrigger.v, top.v]
2026-10-12 Record SRAM board verification of ADSR fix
2026-10-13 Add PC keydown performance and verified peripheral wiring proposal
    [FPGA-pinplan-20261013-v0.1.csv]
2026-10-14 feat(s2): 12-key GPIO input layer, manual event FIFO and top-level arbitration
    Adds rtl/audio/gpio_keyboard.v: two-stage sync, per-key debounce (1 ms press / 3 ms release at 27 MHz), edge detection, per-key 2-deep event queue, ready handshake, and release-before-press submission within one commit round. Wires the 12 manual keys through a dedicated 16-entry event FIFO into the existing top-level arbitration, adds the gpio_key_n[11:0] port and its CST pins, and drops manual Note Off events while the demo runs. Gate grows from 10 to 12 self-checking testbenches: tb_gpio_keyboard and tb_gpio_top are new; tb_poly, tb_mode_uart and tb_audio_capture only gained the new port. All 12 pass with exit c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
2026-10-14 fix(s2): verify GPIO panic and full-queue behavior
    [capture_manifest.csv]
2026-10-14 feat(s3): 标准 I2S 发送器、独立接收模型与统一时钟参数
    [deepseek] 新增 rtl/audio/i2s_tx.v 与 clk_params.vh，sim/i2s_rx_model.v、
    sim/i2s_tx_checker.v、tb_i2s_tx.v、tb_i2s_tx_params.v，隔离综合入口
    build/build_i2s_tx.ps1 与 build/synth_i2s_tx.tcl。门禁扩为十三台正向测试台
    加五个参数负例，原 PT8211 音频回归退出 0；隔离综合 16/24 位在 81.38 ns
    约束下 setup/hold 违例均为 0（Fmax 224.93 MHz）。
    i2s_tx 未接入顶层、未改 CST/SDC、未烧录；验收记录见
    docs/evidence/FPGA-S3-i2s-tx-20261014-v0.1.md，归档 archive/FPGA-20261014-v0.6。
    同时把过时交接包集中到 legacy/pending_removal/（未删除，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
2026-10-14 fix(s3): verify actual bit widths, reset recovery and I2S gate
    [i2s_rx_model.v, i2s_tx_checker.v, tb_i2s_tx.v, tb_i2s_tx_params.v]
2026-10-15 Integrate the S4-S6 deliverables into the S1-S3 line and measure them in Gowin
    Base: codex/s3-i2s-tx@17aff2d, the line that already carries the S2 GPIO keyboard
    and the standalone S3 i2s_tx. This increment prepares the Gowin primitive and
    top-level integration work without changing top.v behaviour yet.
    - Merge the reviewed S4-S6 sources, tests, vectors, reference tools and review
    records into this line and extend the gate to 18 positive testbenches plus the
    six S3 parameter negatives. The integrated gate passes end to end (exit 0),
    covering S1 audio capture, S2 keyboard/top, S3 I2S, and the S4/S5/S6 tests.
    - Fix two portability problems found while merging: move the demo_mode /
    pe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
    [mcp3208_model.v, synth_s4s6_harness.v, tb_mcp3208_i2s_coexist.v, tb_mcp3208_params.v, tb_mcp3208_spi.v, tb_pressure_bend.v, tb_s6_audio.v]
2026-10-15 Wire the S4/S5/S6 datapaths into the instrument top
    - Add rtl/audio/poly_voice_s6.v: dual-wavetable voice (32 bit phase accumulator,
    wavetable_osc_dual_s6, ADSR, velocity) that leaves the verified poly_voice
    untouched.
    - top.v: add the MCP3208 SPI ports and a 2 kHz control tick, poll CH0 (pressure)
    and CH1 (bend) alternately, take the bend ratio from pressure_bend, use
    poly_voice_s6 for all four voices (voice 0 consumes the module output, voices
    1..3 use explicitly widened 32x17 multiplies), replace mixer with mixer_s6
    (VOLUME_SHIFT=1 keeps the old sum/halve gain, FIR bypassed) and expose the
    folded clip/pressure/bend observable.
    - Bring the MCP3208 device model into the four e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
    [tb_audio_capture.v, tb_gpio_top.v, tb_mode_uart.v, tb_poly.v, tb_top_s4s6.v, top.v]
2026-10-15 Add the explicit Gowin pROM path for the wavetables (synthesis side proven)
    - tools/gen_gowin_prom_init.py turns the two hex tables into explicit pROM
    wrappers following UG285 section 3.4: BIT_WIDTH=16 gives a 1024-deep address
    space, the 512 samples live in INIT_RAM_00..1F (16 samples per 256-bit word,
    sample i in slot i%16), and the source hex SHA256 plus the initialisation
    digest are recorded in gowin_prom_meta.json.
    - rtl/audio/wavetable_osc_dual_prom.v mirrors the wavetable_osc_dual_s6
    contract on top of the generated primitives (the pROM bypass read already
    registers one stage, so the extra a/b registers of the behavioural version
    are dropped and the interpolation and ble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
2026-10-15 Fix the pROM address convention, prove wavetable equivalence and gate it
    The vendor prim_sim.v pROM implementation shows that with BIT_WIDTH=16 the word
    address occupies AD[13:4] and AD[3:0] is ignored, i.e. AD has to be driven as
    {addr, 4'b0000}. The generator had the word address in the low bits, so the
    primitive always read word 0; the sine table's first sample is 0, which is why
    the first probes looked like a broken vendor model.
    - tools/gen_gowin_prom_init.py now drives AD = {1'b0, addr, 4'b0000} and the
    wrappers were regenerated.
    - sim/gowin_prom_model.v: a pROM model whose semantics are taken from the vendor
    model (word address in AD[13:4], INIT_RAM_3F..00 packing, sample k in s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
    [gowin_prom_model.v]
2026-10-15 Add the shared wavetable engine prototype (not yet passing its equivalence test)
    Working towards the shared-engine prototype rather than finishing it: the
    architecture, the verification harness and the debugging probes are in place,
    but the engine still fails its own equivalence test, so it is committed as an
    explicitly unfinished prototype and is deliberately not part of the gate.
    - rtl/audio/shared_wavetable_engine.v: four voices share one sine and one bright
    pROM; one FSM (15 states per voice, 60 of the 576 available clocks per sample)
    performs adjacent-entry reads, 9-bit interpolation, envelope scaling and
    velocity scaling by time multiplexing, writing only one multiply expression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
    [global_crossfade.v, tb_shared_engine.v]
2026-10-15 Finish the shared wavetable engine and measure it against the per-voice design
    Three timing defects were found and fixed in the engine:
    - rom_ce was a registered output, so the address lagged the enable by one cycle
    and the first read captured zero;
    - the read window did not include ST_ADDR_B, so the b capture held the a value;
    - the shared multiplier registers its product every clock, so operands loaded in
    state X are only available in state X+2. Six wait states were added for that
    discipline (the earlier version read the product one state too early).
    sim/tb_shared_engine.v now passes: 15 cases (5 weights x 3 phase/envelope/
    velocity groups, the third group using non-zero fraction b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
    [dbg_shared_engine.v, synth_voices_per_voice_harness.v, synth_voices_shared_harness.v, tb_shared_engine.v]
2026-10-15 Integrate the shared wavetable engine into the product top
    top.v now drives four adsr envelopes plus shared_wavetable_engine and
    global_crossfade; mixer_s6 leaves the product top because its four-way sum,
    master gain and sample-frame register all live in global_crossfade now
    (global_crossfade takes over the master-boundary clip statistics, closing
    the gap recorded in the previous increment).
    Reviewing that integration turned up a real defect: the engine zero-extended
    the signed per-voice components into its 19-bit accumulators
    ({13'd0, scaled_s} is unsigned and $signed() cannot restore the sign), so
    -20840 wrapped to +44744 and the output carried roughly half-scale DC. The
    enclosed capture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
2026-10-15 Bring the standard I2S transmitter into the product top
    top.v gains a compile-time AUDIO_IF parameter: 0 keeps the onboard PT8211 path
    byte-for-byte (27 MHz / 46.875 kHz), 1 drives the external PCM5102A over
    standard I2S (12.288 MHz / 48 kHz, BCK 3.072 MHz, 64 BCK per frame). The choice
    folds to a direct clock connection, so there is no runtime clock switching and
    no CDC.
    Every clock-derived constant from the clk_params.vh migration list is handled
    rather than left stale: uart_ctrl, mcp3208_spi and gpio_keyboard take CLK_HZ,
    note_phase_inc gains an FS_HZ profile (48 kHz derived from the same twelve
    constants by the exact 46875/48000 = 125/128 scaling, worst case 0.0018 cent),
    the 2 kHz cont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
2026-10-15 Add a push retry helper with link diagnosis
    Pushing to github.com from this machine fails intermittently with
    "Recv failure: Connection was reset" or a 21 s connect timeout, while DNS,
    TCP, stored credentials and repository permissions are all fine. The commit
    still lands a few minutes later, so the useful remedy is an automatic retry
    rather than a configuration change.
    tools/git_push_retry.ps1 pushes with exponential backoff, prints a read-only
    link diagnosis (TCP 443, an HTTPS GET and the git info/refs endpoint) if it
    has to retry, and stops early with an explicit verdict when the failure is a
    credential, permission or non-fast-forward problem instead of a flaky link.
    It touches no files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
2026-10-15 Add the wiring and pin correspondence table for the purchased hardware
    The pins were re-extracted from the Dock schematic rather than copied from the
    planning documents: page 1 carries the <bank>/<IO site>/<ball> pin table, page 4
    is J5/J6, page 9 is J14 and page 7 is the audio sheet, so every connector
    position now has its schematic net name, FPGA ball, bank and use. All
    twenty-four signal pins agree with docs/hardware/FPGA-pinplan-20261013-v0.1.csv
    and with the CST/SDC that already pass PnR, and the two spare pins are now
    resolved as well: J5-7 is N9 and J14-11 is T6, both in bank 3.
    The document lists the onboard connections that need no wiring, the wiring for
    the 12.288 MHz oscillator,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
    [FPGA-接线表-20261016-v0.1.csv]
2026-10-16 feat: add FSR-controlled master gain with frame smoothing
2026-10-16 fix: bind build and programming to explicit audio profiles
    [profiles.tsv]
2026-10-16 feat: add hardware-free timbre control and reduce crossfade DSP usage
    [presets.csv]
2026-10-17 fix: preserve four-voice headroom and refine bend accuracy
    [bend-precision.csv]
2026-10-17 docs: audit synthesis ceiling and reproduce control filtering gaps
    [ceiling.csv]
2026-10-17 fix: consume fresh paired ADC samples for pressure filtering
    [tb_adc_reset_top.v, tb_control_sampling.v, top.v]
2026-10-17 fix: snapshot voice velocity at audio frame boundaries
    [tb_frame_velocity.v]
2026-10-17 fix: ramp digital mute through the shared master VCA
    [tb_mute_slew.csv]
2026-10-17 fix: fade reused voices before atomically restarting pitch
    [tb_voice_transition_audio.csv]
2026-10-17 fix: retain note ownership across GPIO and UART sources
    [tb_note_ownership.v, tb_note_ownership_top.v, top.v]
2026-10-17 feat: suppress high-note aliasing with shared band-limited wavetables
    [audio.csv]
2026-10-17 feat: preserve fractional audio precision through the master VCA
    [audio.csv, tb_precision_audio.csv]
2026-10-17 perf: pipeline pitch-bend coefficient interpolation
    [bend-precision.csv]
2026-10-17 feat: validate RAM-backed 24-bit 8/32/64 oscillator cores
    [32-portable.csv, 64-portable.csv, 64-vendor.csv, 8-portable.csv]
2026-10-17 perf: stop inactive voice DSP and wavetable activity
    [32-portable.csv, 64-portable.csv, 64-vendor.csv, 8-portable.csv]
2026-10-17 feat: validate PLL 64-voice prototype and record quantified optimization results
2026-10-19 feat: 8-voice e-piano/guitar, runtime switch and PC UI
    - 8-voice shared engine, HID FIFO P1 fixes, soft limiter
    - AKWF e-piano + Karoryfer guitar banks, 36:36 tables / 18:18 BSRAM
    - I0/I1 runtime switch, PC button/F6, unified debug8
    - low-note guitar harmonic cleanup, 5.2 kHz post-mix low-pass
    - docs: daily summary, flash log, key-loudness mixing design v0.2
    [profiles.tsv]
2026-10-20 docs: add guitar timbre previews and DDR3 smoke evidence
    [device.cfg]
2026-10-20 feat: publish latest 8-voice audio fixes and weekend work plan
    Include key-loudness compensation, volume control, unified 24-bit filtering, missing ROM/HID/build inputs, targeted verification, workspace provenance, and the hardware/software weekend plans. Preserve the previously published guitar-preview and DDR3 experiment commit in branch history.
    [presets.csv, tb_precision_audio.csv, tb_voice_transition_audio.csv]
2026-10-20 feat: add USB keyboard and FSR debug build
    [profiles.tsv]
2026-10-20 fix: consume demo-mode note-offs and complete capture gate
    [audio_capture.csv, audio_capture_manifest.csv]
2026-10-20 fix: converge audio gates and exact mute
    Latch shared-path mute state with the frame gain so delayed multiplier results cannot be retroactively zeroed. Flush final low-pass mute residue, restore bright-bank table ordering, regenerate smoke vectors, and repair self-checking benches for the current RTL hierarchy.
    Verified: tb_mute_slew and tb_wide_master targeted regressions pass. Full gate was paused and is not claimed complete in this commit.
    [global_crossfade.v, tb_architecture_equivalence.v, tb_bandlimit_engine.v, tb_bright_banks.v, tb_precision_audio.v, tb_pressure_top.v, tb_shared_bend_equivalence.v]
2026-10-21 release: v2.1.0 audited optimizations and 32-voice instrument prototype
    [rtl_pairs.csv]
2026-10-21 test: rebaseline v2.0.0 piano and timing benches
    Update the 36-table piano bank expectations from 42/46 to 18/22, tie off guitar mode in focused benches, constrain generic bright velocity to the supported 0..127 range, and advance phase before checking bank selection. Rebaseline the key-gain engine deadline to 120 clocks and 44 products.
2026-10-22 perf(proto): pipeline 32-voice engine to 16 clocks/voice; frame end 992->576, Fmax 60.1 MHz
2026-10-22 feat(clock): 12.288MHz dual-clock shell, 4x/6x/8x PLL profiles, stereo frame bridge; 73.728MHz PnR closes
2026-10-22 fix(clock): correct audio pipeline and close 73.728MHz timing
    [audio_frame_bridge_stereo.v, audio_pll_clock.v, tb_ram32_clocked.v]
2026-10-22 docs(hardware): approve USB assembly baseline and correct wiring guidance
2026-10-23 feat(hid): merge optimization 07 long-press timeout policy
    把 4536e07 的长按策略定向合入集成分支，不整体覆盖分支，也不重做已有功能：
    - host_kbd_input 新增 TIMEOUT_POLICY：0=strict（旧行为，硬件排查用），
    1=idle-only（默认，持键静默不误清音）；0x86 拔出通知始终立即清键。
    - top 透传 HOST_KBD_TIMEOUT_POLICY，默认 1；需要旧行为时用
    -Ptop.HOST_KBD_TIMEOUT_POLICY=0 回退，无需改 RTL。
    - 新增 tb_host_kbd_timeout：idle-only 等效 5 s 无心跳长按保持、strict 仍清音、
    心跳续期、0x86 拔出后重新起音。
    - tb_top_host_ctrl 补 0x86 顶层用例：清按键状态、清声部、重新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
2026-10-23 feat(ram32): 32-voice performance controls with atomic bundle
    把生产控制能力接到 ram32_clocked_top 的数据通路，接口表见
    docs/FPGA-32声部控制接口-20261023-v0.1.md：
    - 新增 ram32_control_front：51 位控制束整束快照 + 四相握手（数据先寄存一拍再翻 req），
    取代原先 3 位的"按位两拍一致"；压力/弯音复用生产 pressure_bend，音量斜坡与曲线
    自 top.v 原样抽取为 ram32_volume_curve.vh。
    - voice_sched32：piano_tone 2 位 -> 3 位（第 5 档不再被截断）；新增 bend_ratio，
    cfg_increment = base*ratio 半上位取整并饱和；比率变化只刷新增量、不重触发包络。
    - wide_master：新增 volum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
2026-10-26 chore: sync FPGA source with verified CH9350L support
    Record the current standard27 source, FSR mute, tune changes, build policy and prototype work with their supporting tools and evidence.
    Audit CH9350L UART/state-2 parsing, note/control mapping, long-hold policy and production wiring. Host 3 checks, Quick 19 checks and tune 2 checks pass; Host is included in Quick. All simulation input hashes still match at submission.
    Keep hardware keyboard compatibility and silent held-key disconnect as open validation items. The existing Flash image remains 0x63DC; three current tune files have not been rebuilt or flashed.
    Preserve PDF bytes using binary Git attributes. Runtime dependencies, duplicat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
2026-10-26 feat(hid): pause and resume demo playback with F8
    Preserve score position and pending events, fade audio while paused, and keep I2S running. Reset pause on mode changes. Per user request, run only one short check; skip Quick/Full. Leave unrelated tune edits unstaged; no firmware programming.
    [hid_keymap.v, host_kbd_input.v, tb_top_host_pause.v, top.v]
2026-10-26 feat(hid): publish full keyboard and latency results
    Extend CH9350L mapping to 88 physical keys including modifier bits, retain
    8-voice output, and improve report deduplication and event backpressure.
    Include the unprogrammed +6 dB mix candidate and F7/F8 flash record.
    Add default-envelope 8/32-voice latency comparison, low-latency and arranging
    plans, plus portable evidence. Three focused checks pass on an isolated
    baseline snapshot without unrelated uncommitted song work. No programming.
    [host_eight_i2s.csv]
2026-10-26 feat(display): add HDMI live audio dashboard
    [profiles.tsv]
2026-10-27 feat: add HDMI and PC dashboard switching
    [profiles.tsv]
2026-10-30 fix: stabilize sustain pedal and publish 2026-10-30 results
    [profiles.tsv]
2026-11-01 chore: organize project files and historical versions by date
    [32-portable.csv, 64-portable.csv, 64-vendor.csv, 8-portable.csv, FPGA选题汇总.xlsx, audio.csv, audio_capture.csv, audio_capture_manifest.csv]
